pilot443/avad-s0/sim/physical-data-v26-k1.md

Стадия: **концепция (FEL-1), уровень У6 «Симулятор» — подготовка**. Физические данные для MuJoCo по модели деталей v2; не рабочая документация.

# Краб S-0 v2: физические данные тел для симулятора (30.10.2026)

Таблица строится инструментом `инструменты/универсал_сим_модель.py` (команда `всё`) из тех же деталей, по которым посчитаны масса, центр масс и У5. Метки: [Р] — расчёт по модели, [Д] — допущение, [И] — источник. Система координат — как в модели: X вперёд, Y влево, Z вверх, земля Z = 0, мм; оси тел параллельны мировым; инерция — относительно центра масс тела, в осях мира, кг·м².

## 1. Тела

Тело — это группа деталей, которые движутся вместе. Масса детали взята из модели вместе с крепежом (серво +5,6 г, листовые и печатные детали +5 %), поэтому сумма равна массе модели 6664 г [Р]. Центр масс и тензор инерции каждой детали — по настоящей форме (объём и момент инерции тела в CadQuery при постоянной плотности внутри детали), складываются по теореме Штейнера [Р]: это точнее, чем «брусок той же массы».

| Тело | Родитель | Сустав | Серво | Масса, г | Центр масс x; y; z, мм | Ixx | Iyy | Izz | Ixy | Ixz | Iyz |
|---|---|---|---:|---:|---|---:|---:|---:|---:|---:|---:|
| trunk | — | свободный (7) | 0 | 3774.1 | -3.2; -0.2; 132.6 | 4.035e-02 | 4.021e-02 | 3.028e-02 | -4.905e-05 | 3.270e-03 | 2.838e-06 |
| head_pan | trunk | head_pan | 1 | 90.1 | 146.0; -0.0; 200.8 | 2.119e-05 | 2.693e-05 | 2.363e-05 | -2.343e-08 | 1.786e-08 | 1.480e-08 |
| head_tilt | head_pan | head_tilt | 1 | 172.5 | 156.0; 3.2; 211.7 | 5.920e-04 | 1.913e-04 | 5.935e-04 | 1.217e-05 | 1.330e-05 | -4.383e-05 |
| leg1_yaw | trunk | leg1_yaw | 1 | 202.8 | 109.0; 62.9; 128.8 | 1.189e-04 | 7.754e-05 | 1.114e-04 | 3.580e-05 | 6.906e-07 | 3.987e-07 |
| leg1_hip | leg1_yaw | leg1_hip | 2 | 140.5 | 159.9; 82.3; 117.7 | 1.047e-04 | 1.062e-04 | 1.661e-04 | -3.659e-06 | 2.477e-05 | 1.942e-05 |
| leg1_knee | leg1_hip | leg1_knee | 1 | 42.3 | 173.6; 117.5; 49.9 | 5.155e-05 | 5.090e-05 | 6.035e-06 | 1.699e-06 | 7.259e-06 | -6.629e-06 |
| leg2_yaw | trunk | leg2_yaw | 1 | 202.8 | 0.0; 125.8; 128.8 | 5.687e-05 | 1.396e-04 | 1.114e-04 | 3.361e-18 | -1.910e-19 | 7.974e-07 |
| leg2_hip | leg2_yaw | leg2_hip | 2 | 170.2 | 0.0; 179.4; 118.3 | 1.321e-04 | 1.676e-04 | 2.445e-04 | -6.731e-08 | 1.733e-08 | 3.753e-05 |
| leg2_knee | leg2_hip | leg2_knee | 1 | 42.3 | -15.0; 209.1; 49.9 | 4.959e-05 | 5.286e-05 | 6.035e-06 | -5.661e-07 | 9.371e-06 | 2.972e-06 |
| leg3_yaw | trunk | leg3_yaw | 1 | 202.8 | -109.0; 62.9; 128.8 | 1.189e-04 | 7.754e-05 | 1.114e-04 | -3.580e-05 | -6.906e-07 | 3.987e-07 |
| leg3_hip | leg3_yaw | leg3_hip | 2 | 170.2 | -155.4; 89.7; 118.3 | 1.588e-04 | 1.409e-04 | 2.445e-04 | -1.531e-05 | -3.250e-05 | 1.878e-05 |
| leg3_knee | leg3_hip | leg3_knee | 1 | 42.3 | -188.6; 91.5; 49.9 | 5.253e-05 | 4.992e-05 | 6.035e-06 | -1.133e-06 | 2.112e-06 | 9.602e-06 |
| leg4_yaw | trunk | leg4_yaw | 1 | 202.8 | -109.0; -62.9; 128.8 | 1.189e-04 | 7.754e-05 | 1.114e-04 | 3.580e-05 | -6.906e-07 | -3.987e-07 |
| leg4_hip | leg4_yaw | leg4_hip | 2 | 170.2 | -155.4; -89.7; 118.3 | 1.587e-04 | 1.411e-04 | 2.445e-04 | 1.538e-05 | -3.251e-05 | -1.875e-05 |
| leg4_knee | leg4_hip | leg4_knee | 1 | 42.3 | -173.6; -117.5; 49.9 | 5.155e-05 | 5.090e-05 | 6.035e-06 | 1.699e-06 | -7.259e-06 | 6.629e-06 |
| leg5_yaw | trunk | leg5_yaw | 1 | 202.8 | 0.0; -125.8; 128.8 | 5.687e-05 | 1.396e-04 | 1.114e-04 | -3.943e-18 | -2.756e-19 | -7.974e-07 |
| leg5_hip | leg5_yaw | leg5_hip | 2 | 170.2 | -0.0; -179.4; 118.3 | 1.321e-04 | 1.676e-04 | 2.445e-04 | -6.731e-08 | -1.733e-08 | -3.753e-05 |
| leg5_knee | leg5_hip | leg5_knee | 1 | 42.3 | 15.0; -209.1; 49.9 | 4.959e-05 | 5.286e-05 | 6.035e-06 | -5.661e-07 | -9.371e-06 | -2.972e-06 |
| leg6_yaw | trunk | leg6_yaw | 1 | 202.8 | 109.0; -62.9; 128.8 | 1.189e-04 | 7.754e-05 | 1.114e-04 | -3.580e-05 | 6.906e-07 | -3.987e-07 |
| leg6_hip | leg6_yaw | leg6_hip | 2 | 140.5 | 159.8; -82.3; 117.7 | 1.049e-04 | 1.062e-04 | 1.662e-04 | 3.685e-06 | 2.475e-05 | -1.945e-05 |
| leg6_knee | leg6_hip | leg6_knee | 1 | 42.3 | 188.6; -91.5; 49.9 | 5.253e-05 | 4.992e-05 | 6.035e-06 | -1.133e-06 | -2.112e-06 | -9.602e-06 |
| armL1 | trunk | armL_sh_yaw | 1 | 66.2 | 120.9; 119.8; 178.5 | 1.104e-05 | 1.873e-05 | 2.095e-05 | 1.002e-07 | -2.087e-06 | 6.629e-08 |
| armL2 | armL1 | armL_sh_pitch | 1 | 88.8 | 185.5; 128.6; 171.2 | 2.890e-05 | 8.737e-05 | 8.691e-05 | 1.784e-05 | 1.239e-05 | -4.119e-06 |
| armL3 | armL2 | armL_elbow | 1 | 89.0 | 284.6; 113.8; 189.2 | 2.663e-05 | 9.856e-05 | 9.572e-05 | -1.590e-05 | -1.315e-05 | -3.281e-06 |
| armL4 | armL3 | armL_wr_tilt | 1 | 74.9 | 339.9; 129.8; 169.0 | 1.807e-05 | 2.964e-05 | 2.193e-05 | 2.584e-06 | 3.051e-06 | -9.094e-07 |
| armL5 | armL4 | armL_wr_roll | 1 | 105.7 | 389.6; 126.8; 170.3 | 3.075e-05 | 5.011e-05 | 4.298e-05 | 6.339e-09 | 8.465e-06 | 5.903e-08 |
| gripL | armL5 | armL_grip | 1 | 27.2 | 409.0; 126.4; 182.0 | 9.430e-06 | 8.115e-06 | 1.585e-05 | -2.017e-08 | -2.120e-07 | 1.650e-08 |
| armR1 | trunk | armR_sh_yaw | 1 | 66.2 | 120.9; -119.8; 178.5 | 1.104e-05 | 1.873e-05 | 2.095e-05 | -1.002e-07 | -2.087e-06 | -6.629e-08 |
| armR2 | armR1 | armR_sh_pitch | 1 | 88.8 | 185.5; -128.6; 171.2 | 2.890e-05 | 8.737e-05 | 8.691e-05 | -1.784e-05 | 1.239e-05 | 4.119e-06 |
| armR3 | armR2 | armR_elbow | 1 | 89.0 | 284.6; -113.8; 189.2 | 2.663e-05 | 9.856e-05 | 9.572e-05 | 1.590e-05 | -1.315e-05 | 3.281e-06 |
| armR4 | armR3 | armR_wr_tilt | 1 | 74.9 | 339.9; -129.8; 169.0 | 1.807e-05 | 2.964e-05 | 2.193e-05 | -2.584e-06 | 3.051e-06 | 9.094e-07 |
| armR5 | armR4 | armR_wr_roll | 1 | 105.7 | 389.6; -126.8; 170.3 | 3.075e-05 | 5.011e-05 | 4.298e-05 | -6.339e-09 | 8.465e-06 | -5.903e-08 |
| gripR | armR5 | armR_grip | 1 | 27.2 | 409.0; -126.4; 182.0 | 9.430e-06 | 8.115e-06 | 1.585e-05 | 2.017e-08 | -2.120e-07 | -1.650e-08 |

Сумма масс тел: **7373.1 г** (модель У4-v2.6: 7264 г).

## 2. Суставы

Пределы ног — из `пределы_ноги_по_модели` v2 (подъём бедра вверх: передние ноги 40°, боковые 80°, задние 68°; колено вниз 48–49°, вверх 150°; поворот бедра ±17°), знак — правило правого винта относительно оси сустава [Р]. Пределы рук **программные**, шире записанных в У3 (`узлы-S-0.md`), чтобы вошли все позы У4–У5 (стойка рук: плечо вверх на 90°): реальные пределы по столкновениям звеньев в симуляторе не проверяются, самопересечения проверены в CadQuery для поз У4 и У5 [Д].

| Сустав | Тело | Точка оси x; y; z, мм | Ось | Предел, ° | Серво на оси |
|---|---|---|---|---|---:|
| head_pan | head_pan | 146.0; 0.0; 160.0 | (0.000; 0.000; 1.000) | -21 … 21 | 1 |
| head_tilt | head_tilt | 146.0; 0.0; 208.0 | (0.000; 1.000; 0.000) | -21 … 21 | 1 |
| leg1_yaw | leg1_yaw | 110.4; 63.7; 0.0 | (0.000; 0.000; 1.000) | -17 … 17 | 1 |
| leg1_hip | leg1_hip | 110.4; 63.7; 144.0 | (-0.500; 0.866; 0.000) | -45 … 31 | 2 |
| leg1_knee | leg1_knee | 177.5; 102.5; 112.0 | (-0.500; 0.866; 0.000) | -150 … 44 | 1 |
| leg2_yaw | leg2_yaw | 0.0; 127.5; 0.0 | (0.000; 0.000; 1.000) | -17 … 17 | 1 |
| leg2_hip | leg2_hip | 0.0; 127.5; 144.0 | (-1.000; 0.000; 0.000) | -88 … 31 | 2 |
| leg2_knee | leg2_knee | 0.0; 205.0; 112.0 | (-1.000; 0.000; 0.000) | -150 … 44 | 1 |
| leg3_yaw | leg3_yaw | -110.4; 63.7; 0.0 | (0.000; 0.000; 1.000) | -17 … 17 | 1 |
| leg3_hip | leg3_hip | -110.4; 63.7; 144.0 | (-0.500; -0.866; 0.000) | -71 … 31 | 2 |
| leg3_knee | leg3_knee | -177.5; 102.5; 112.0 | (-0.500; -0.866; 0.000) | -150 … 44 | 1 |
| leg4_yaw | leg4_yaw | -110.4; -63.8; 0.0 | (0.000; 0.000; 1.000) | -17 … 17 | 1 |
| leg4_hip | leg4_hip | -110.4; -63.8; 144.0 | (0.500; -0.866; 0.000) | -71 … 31 | 2 |
| leg4_knee | leg4_knee | -177.5; -102.5; 112.0 | (0.500; -0.866; 0.000) | -150 … 44 | 1 |
| leg5_yaw | leg5_yaw | -0.0; -127.5; 0.0 | (0.000; 0.000; 1.000) | -17 … 17 | 1 |
| leg5_hip | leg5_hip | -0.0; -127.5; 144.0 | (1.000; -0.000; 0.000) | -88 … 31 | 2 |
| leg5_knee | leg5_knee | -0.0; -205.0; 112.0 | (1.000; -0.000; 0.000) | -150 … 44 | 1 |
| leg6_yaw | leg6_yaw | 110.4; -63.8; 0.0 | (0.000; 0.000; 1.000) | -17 … 17 | 1 |
| leg6_hip | leg6_hip | 110.4; -63.8; 144.0 | (0.500; 0.866; 0.000) | -45 … 31 | 2 |
| leg6_knee | leg6_knee | 177.5; -102.5; 112.0 | (0.500; 0.866; 0.000) | -150 … 44 | 1 |
| armL_sh_yaw | armL1 | 111.0; 119.7; 0.0 | (0.000; 0.000; 1.000) | -30 … 130 | 1 |
| armL_sh_pitch | armL2 | 111.0; 119.7; 180.2 | (0.000; 1.000; 0.000) | -160 … 30 | 1 |
| armL_elbow | armL3 | 201.0; 119.7; 180.2 | (0.000; 1.000; 0.000) | -140 … 140 | 1 |
| armL_wr_tilt | armL4 | 301.0; 119.7; 180.2 | (0.000; 1.000; 0.000) | -100 … 100 | 1 |
| armL_wr_roll | armL5 | 301.0; 126.8; 180.2 | (1.000; 0.000; 0.000) | -150 … 150 | 1 |
| armL_grip | gripL | 394.5; 145.3; 180.2 | (0.000; -1.000; 0.000) | 0 … 45 | 1 |
| armR_sh_yaw | armR1 | 111.0; -119.7; 0.0 | (0.000; 0.000; -1.000) | -30 … 130 | 1 |
| armR_sh_pitch | armR2 | 111.0; -119.7; 180.2 | (0.000; 1.000; 0.000) | -160 … 30 | 1 |
| armR_elbow | armR3 | 201.0; -119.7; 180.2 | (0.000; 1.000; 0.000) | -140 … 140 | 1 |
| armR_wr_tilt | armR4 | 301.0; -119.7; 180.2 | (0.000; 1.000; 0.000) | -100 … 100 | 1 |
| armR_wr_roll | armR5 | 301.0; -126.8; 180.2 | (-1.000; 0.000; 0.000) | -150 … 150 | 1 |
| armR_grip | gripR | 394.5; -145.3; 180.2 | (0.000; -1.000; 0.000) | 0 … 45 | 1 |

Шарнирных суставов **32** (6 ног × 3, 2 руки × 5, 2 пальца захвата, 2 сустава головы) плюс свободный сустав корпуса; серво — **38** (38 по модели: двойное бедро — по два на ось).

**Двойное бедро.** Два серво стоят спина к спине на одной оси и держат одну щёку-раму: в симуляторе — **один сустав с двойным моментом** (предел 5,88 Н·м, номинал 1,96 Н·м) [Д]. Причина: два серво на одной оси жёстко связаны через раму, и в MuJoCo пришлось бы вводить связь «равенство углов», а она делает расчёт жёстче и хуже сходится; а делить нагрузку между двумя серво можно при разборе результатов (параметр «доля нагруженного серво», по умолчанию 0,5; для худшего случая 0,6). Что теряем: рассогласование двух серво (одно «ленивое», второе берёт больше) — оно оценивается отдельным опытом после замеров образца.

## 3. Контакт, пол, шаг времени, привод

| Параметр | Значение | Метка и основание |
|---|---|---|
| Контакт | только подошва — пол (шар радиусом 9 мм, низ в точке опоры) | [Р] из модели v2.1: стопа PETG + полусфера TPU R9 (v2 — плоская накладка 18 × 18 × 3 мм); остальные звенья не сталкиваются (проверено в CadQuery для поз У4–У5) |
| Трение подошвы о пол | 0.5 (опыт E3: 0,3–1,0) | [Д] резина или TPU по сухому полу 0,5–1,0 |
| Пол | плоскость, неровность и порог — вариантами опытов | [Д] |
| Шаг времени | 1 мс (частота управления 100 Гц, задержка команды 10 мс) | [Д] |
| Привод | позиционный регулятор PD на стороне Python; момент ограничен 2,94 Н·м (бедро: 5,88), на скорости — по линейной кривой «момент — скорость» от 2,94 Н·м при 0 до 0 при 4,72 рад/с; 0,98 Н·м — порог перегрева | [И] STS3215 (данные продавцов); кривая — [Д] |
| Разрешение датчика угла | 4096 шагов на оборот (0,088°) | [И] |
| Трение и вязкость в суставе | 0.03 Н·м и 0.02 Н·м·с/рад | [Д] до измерений на образце |
| Инерция ротора, приведённая к валу | 0.005 кг·м² | [Д] до измерений на образце |
| Падение напряжения батареи | не моделируется | [Д] |
