pilot443/avad-s0/electrical/EL-01_electronics-layout.png

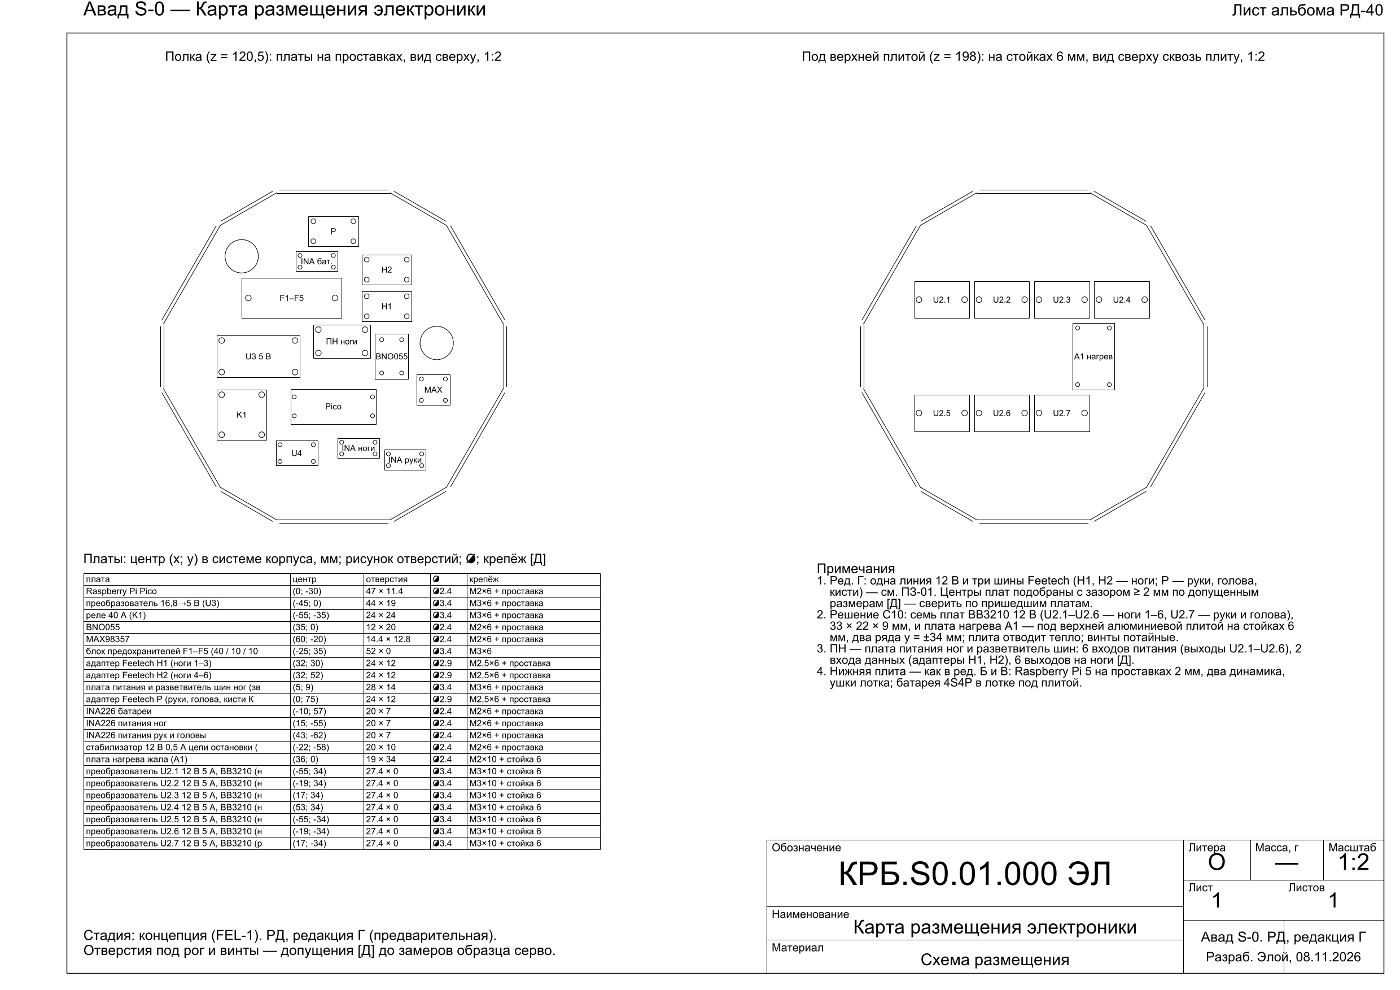
electrical/EL-01_electronics-layout.png
