pilot443/avad-s0/electrical/PZ-01_schematic.png

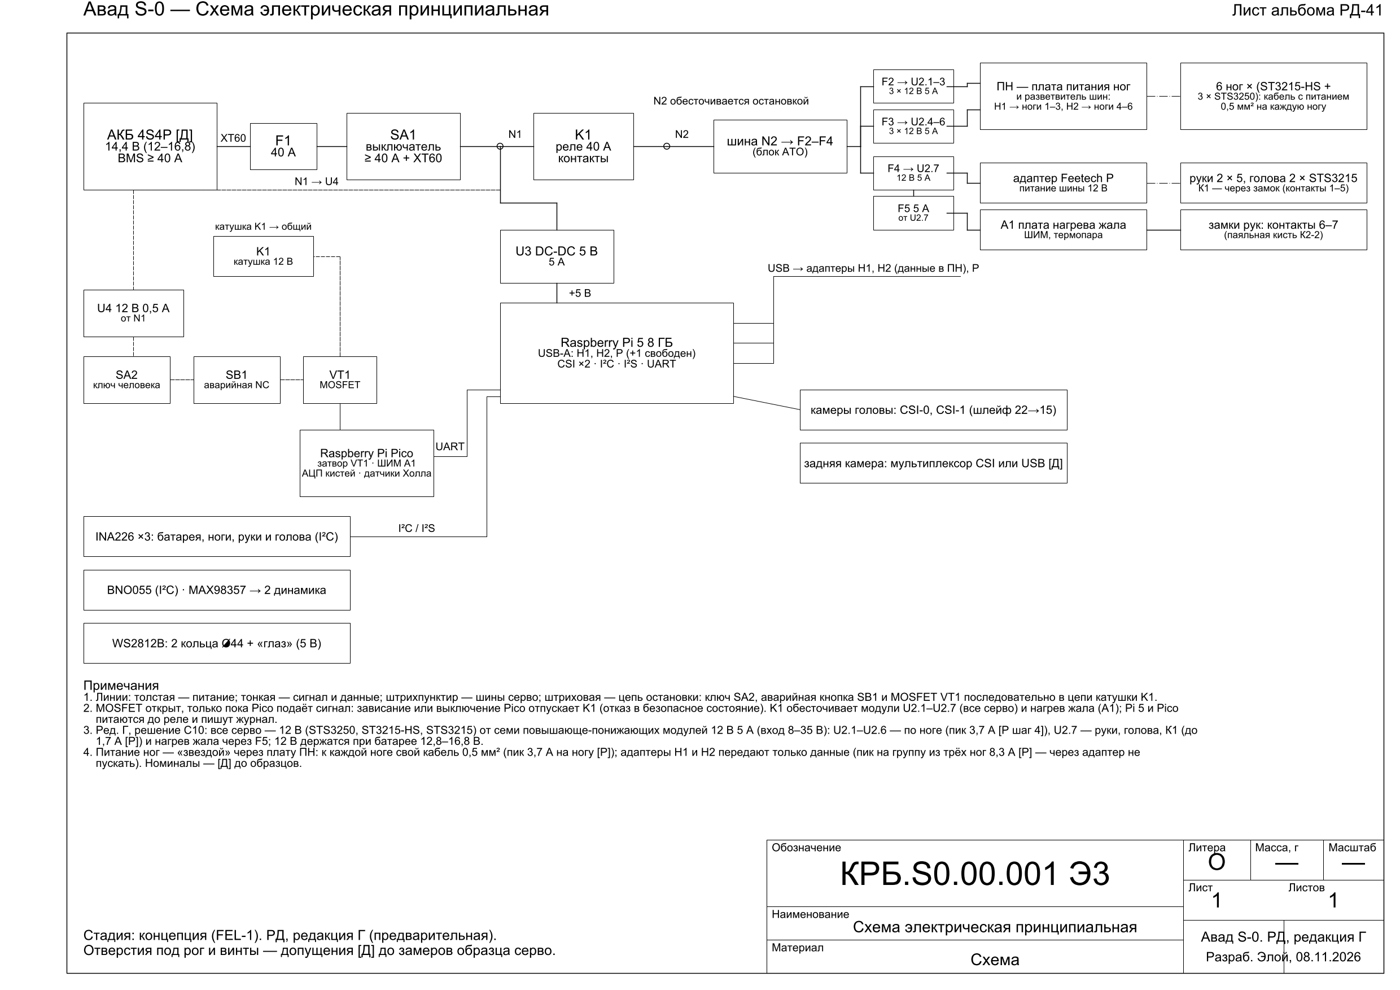
electrical/PZ-01_schematic.png
