pilot443/avad-s0/electrical/TB-01_servo-ids-and-buses.png

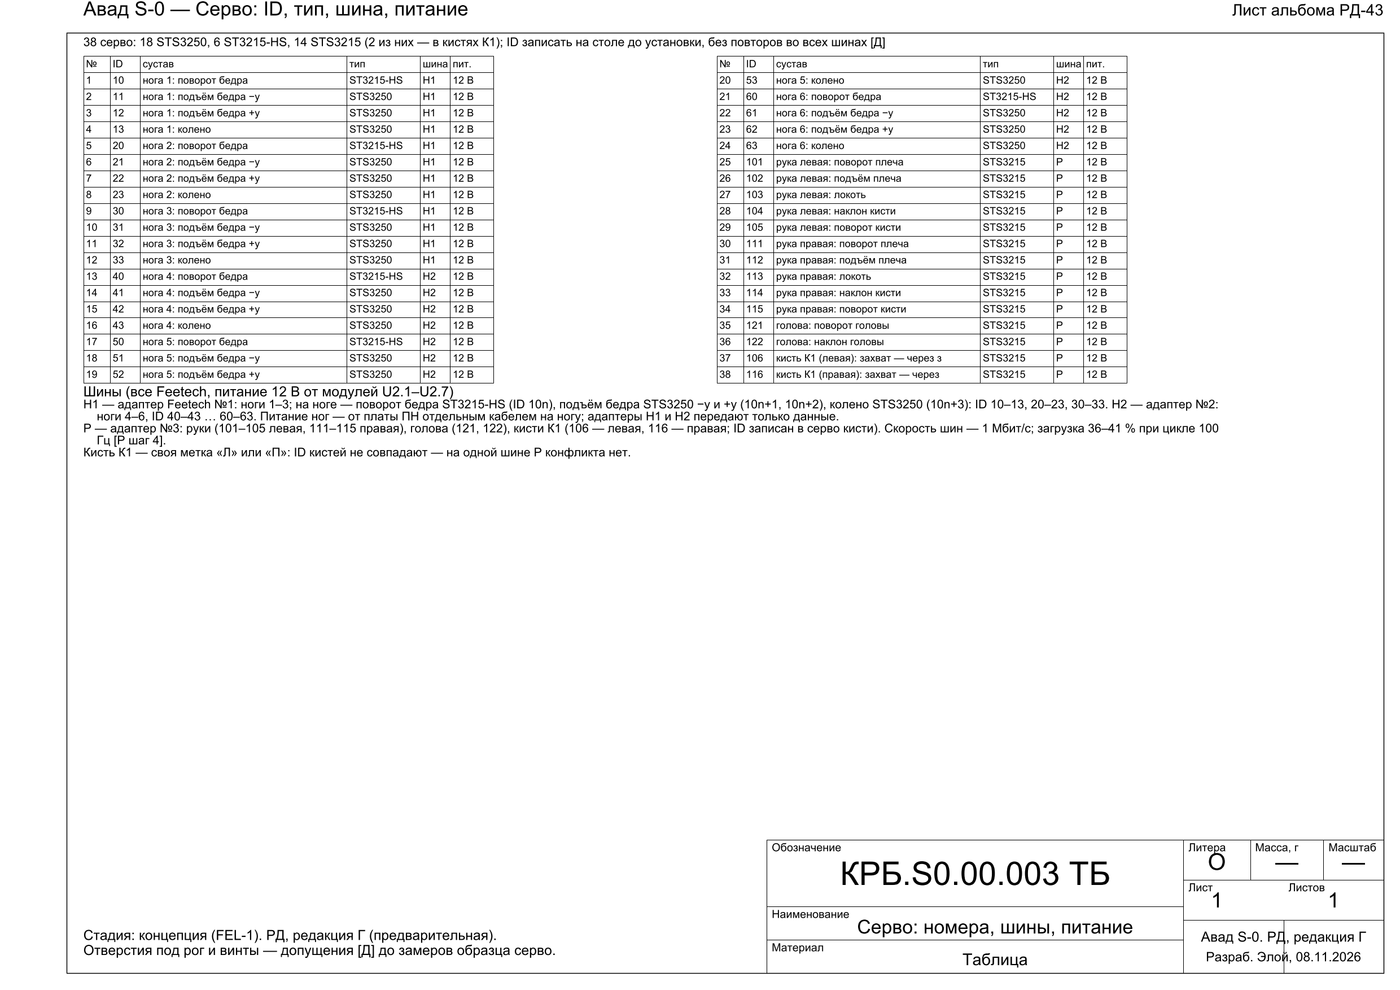
electrical/TB-01_servo-ids-and-buses.png
