pilot443/avad-s0/electrical/TB-02_harnesses.png

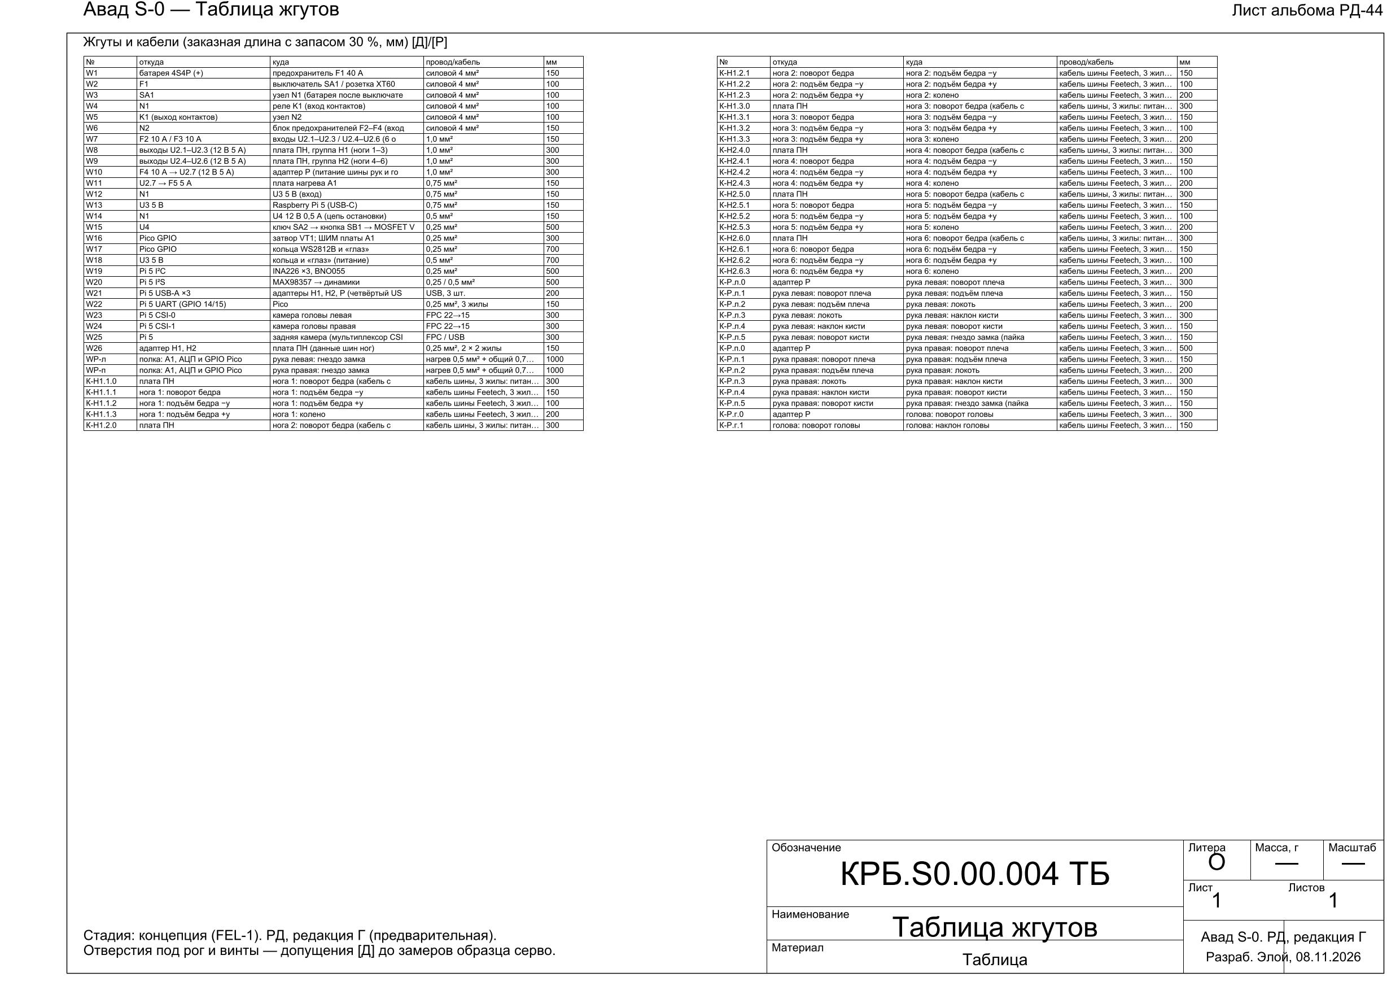
electrical/TB-02_harnesses.png
