pilot443/avad-s0/electrical/TB-03_wrist-lock-contacts.png

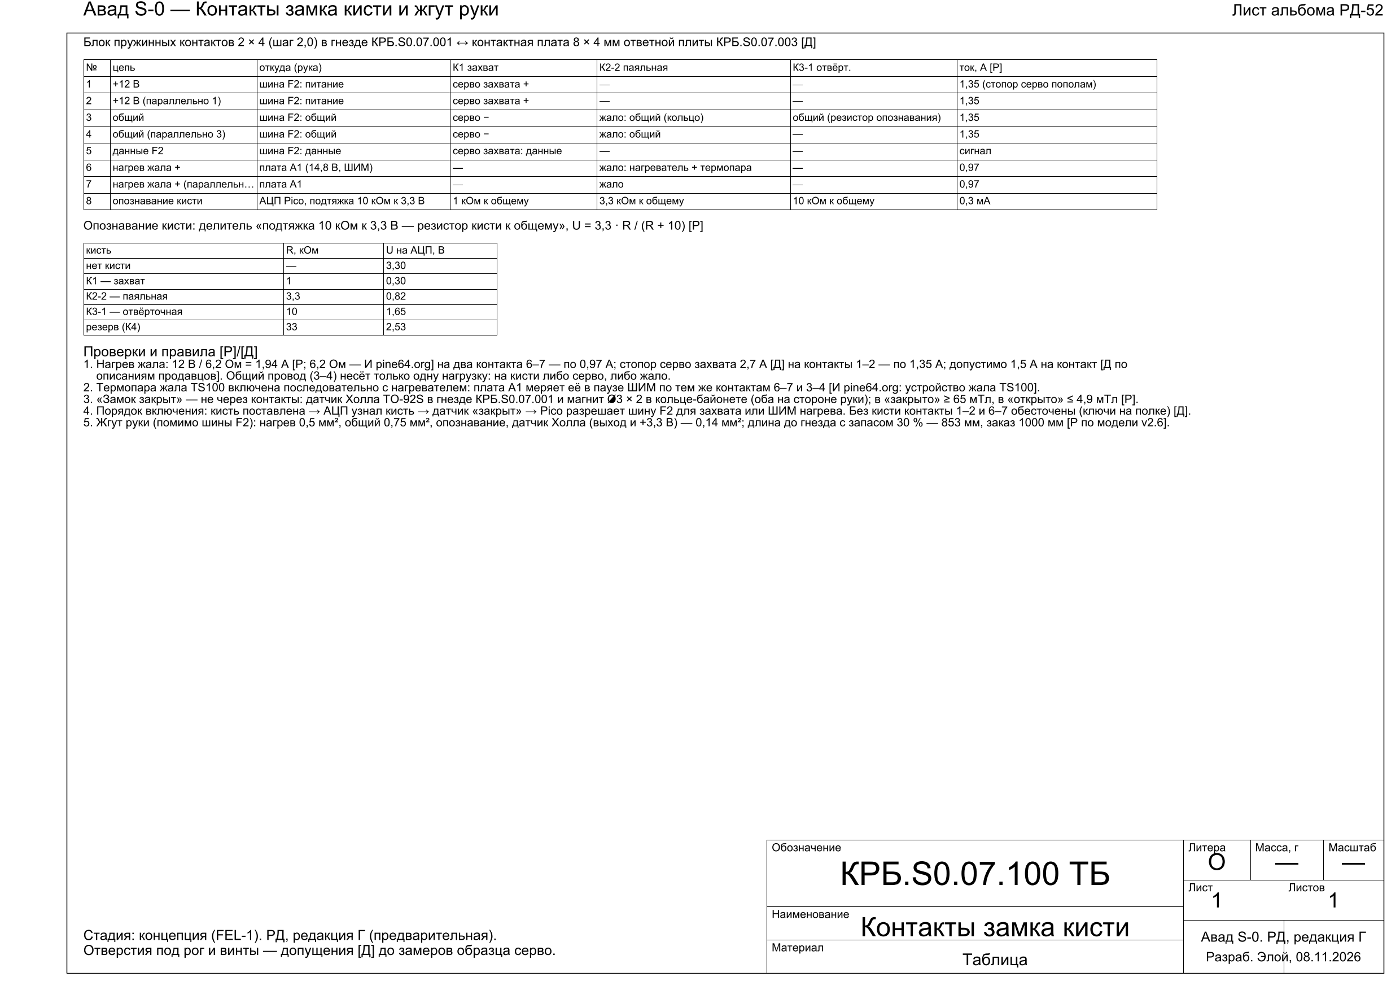
electrical/TB-03_wrist-lock-contacts.png
