pilot443/avad-s0/media/general-arrangement-drawing.png

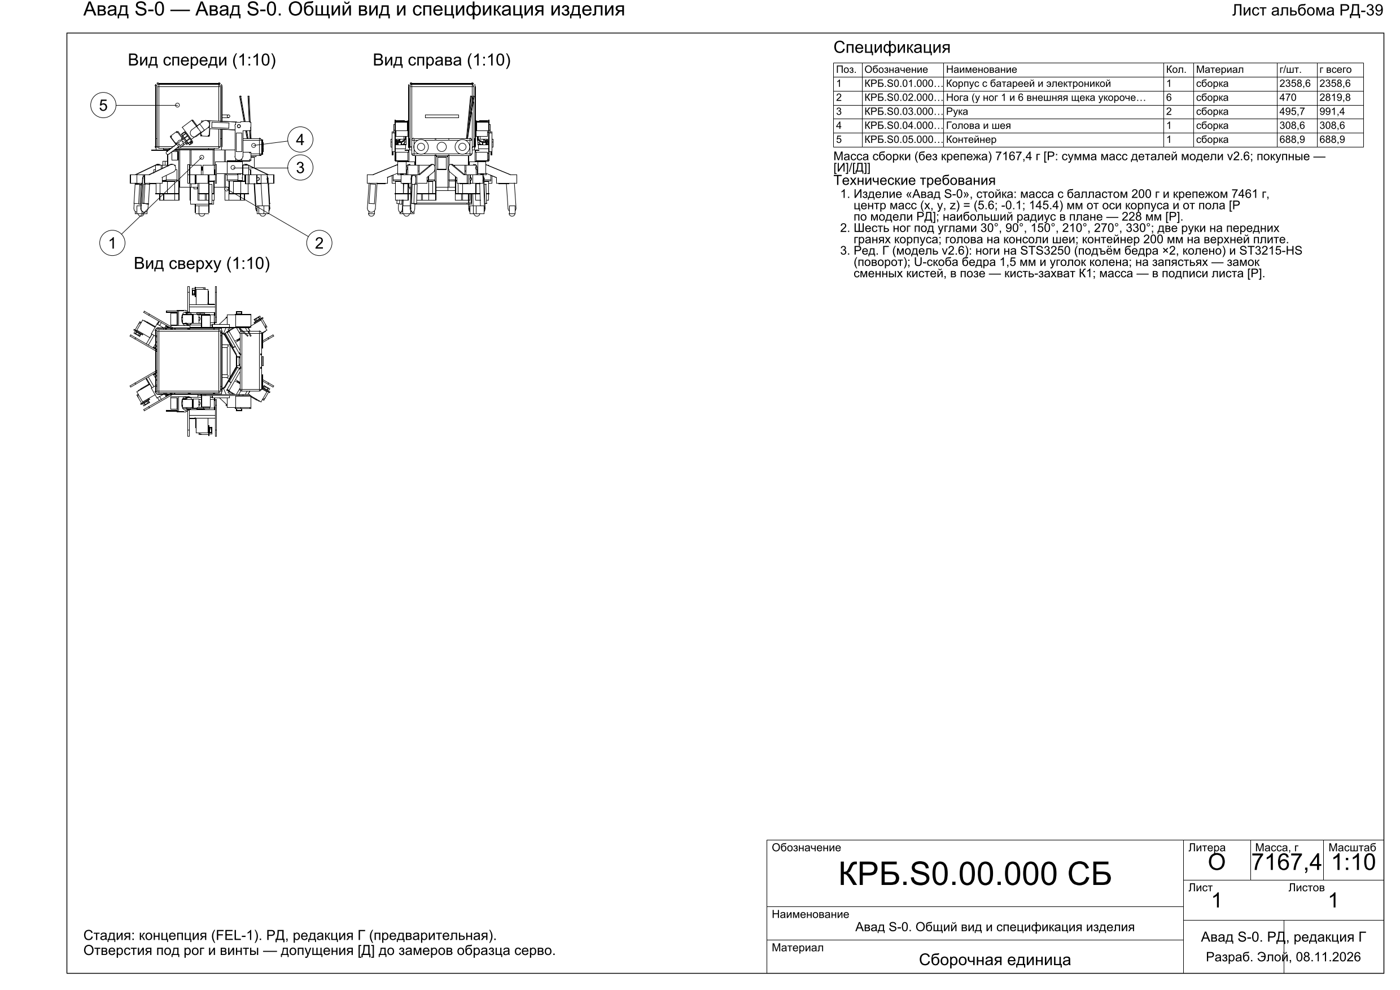
media/general-arrangement-drawing.png
