pilot443/avad-s0/media/sim-arms-lift-container.gif

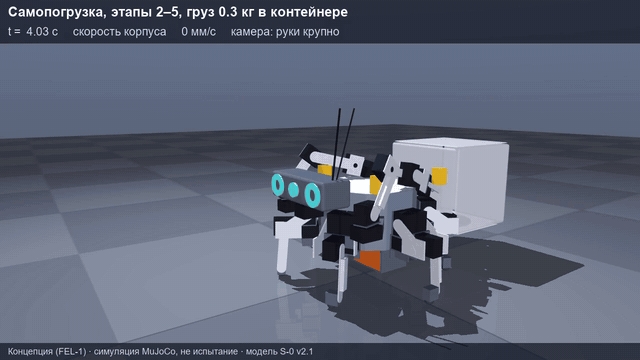
media/sim-arms-lift-container.gif
