pilot443/avad-s0/media/sim-arms.png

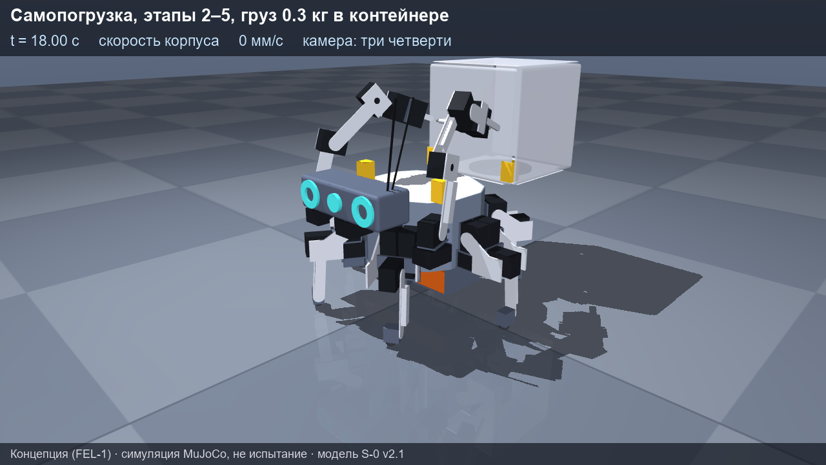
media/sim-arms.png
