pilot443/avad-s0/media/sim-emergency-stop.gif

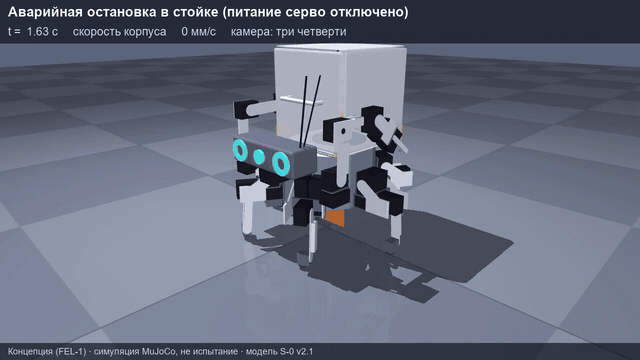
media/sim-emergency-stop.gif
