pilot443/avad-s0/media/sim-emergency-stop.png

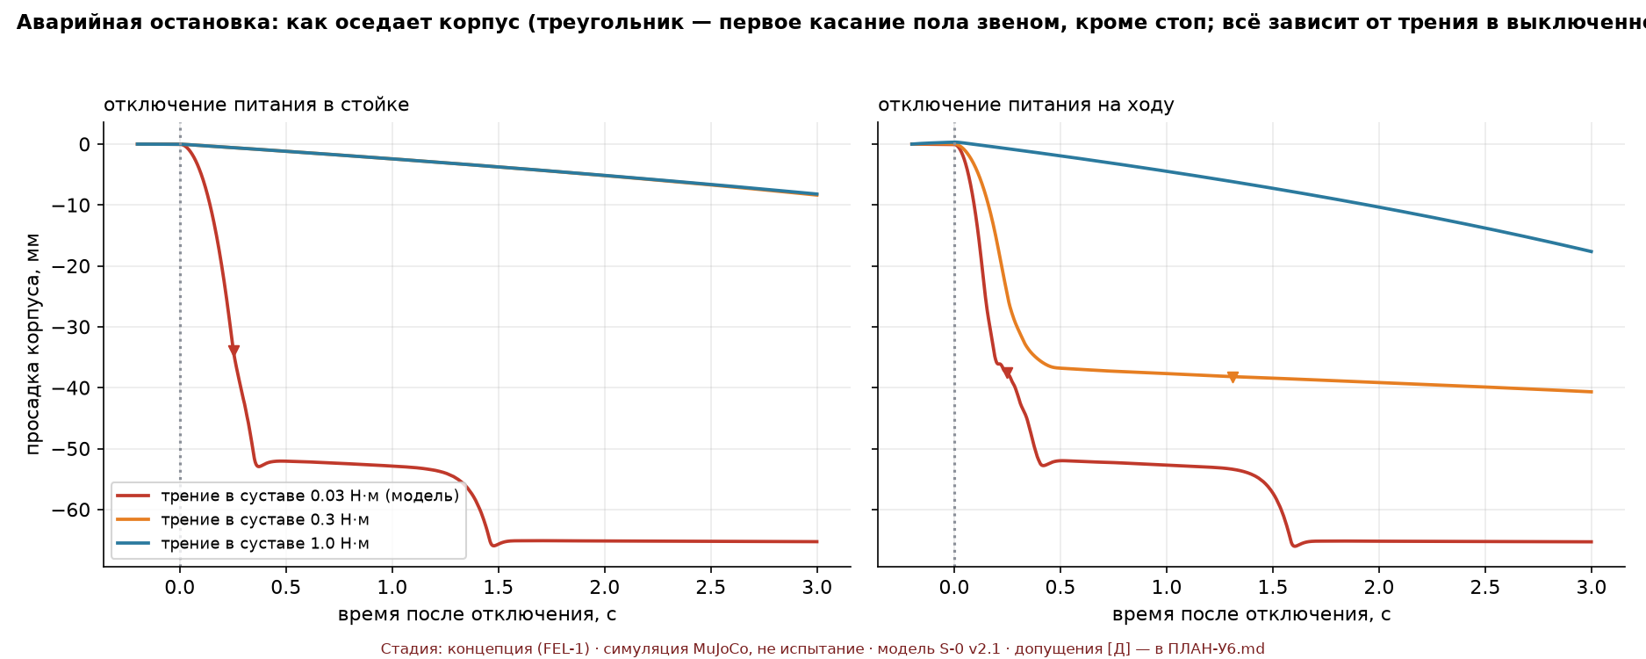
media/sim-emergency-stop.png
