pilot443/avad-s0/wrist-tools/KRB.S0.07.001_gnezdo-zamka.png

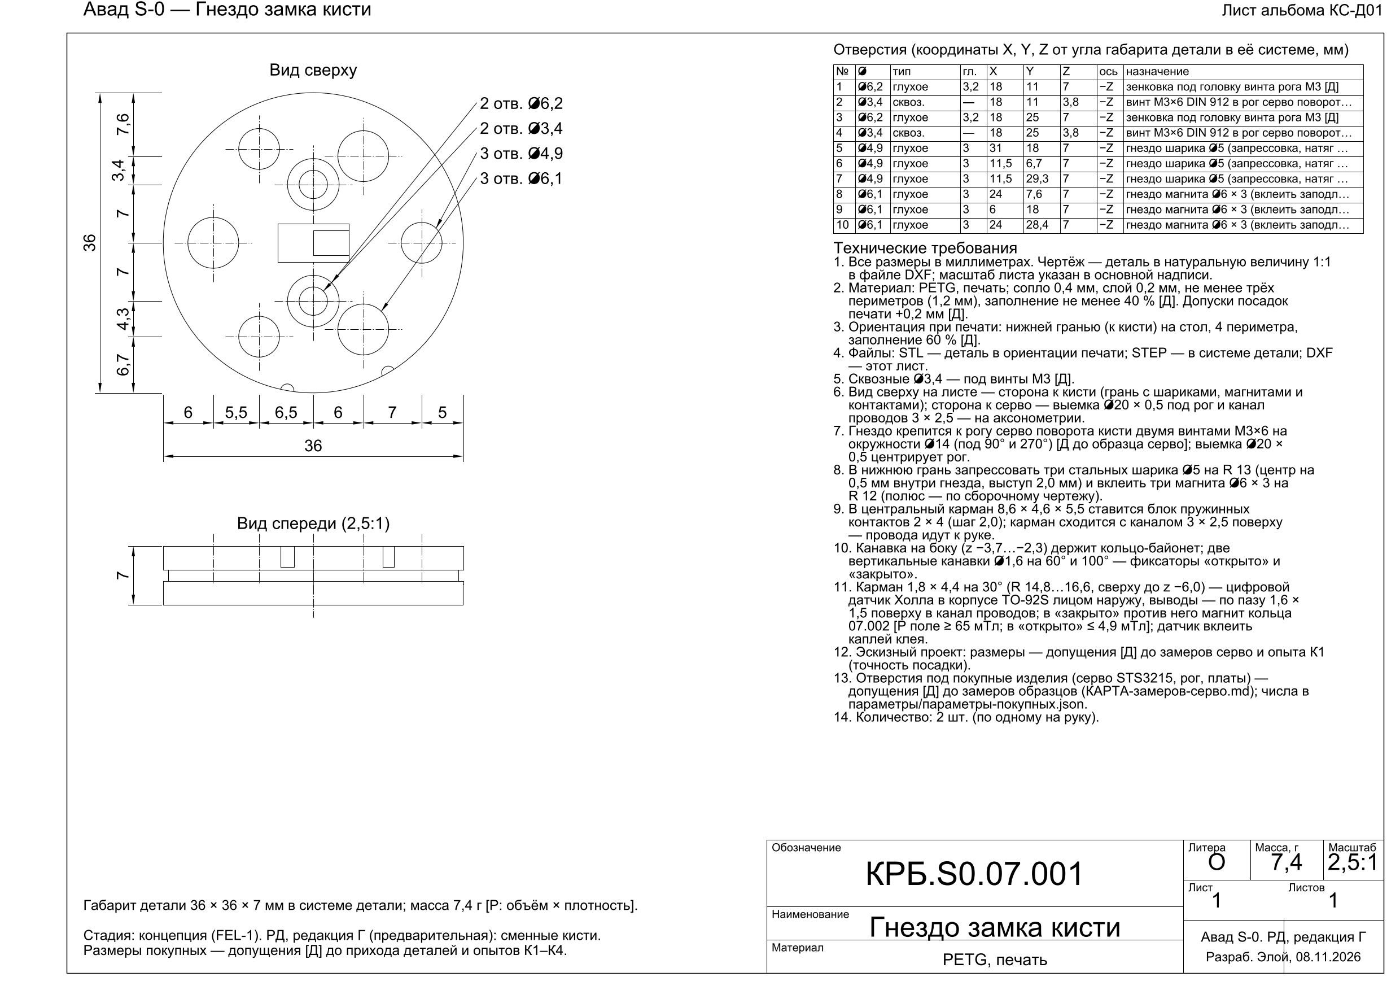
wrist-tools/KRB.S0.07.001_gnezdo-zamka.png
