pilot443/avad-s0/wrist-tools/KRB.S0.07.002_koltso-baioneta.png

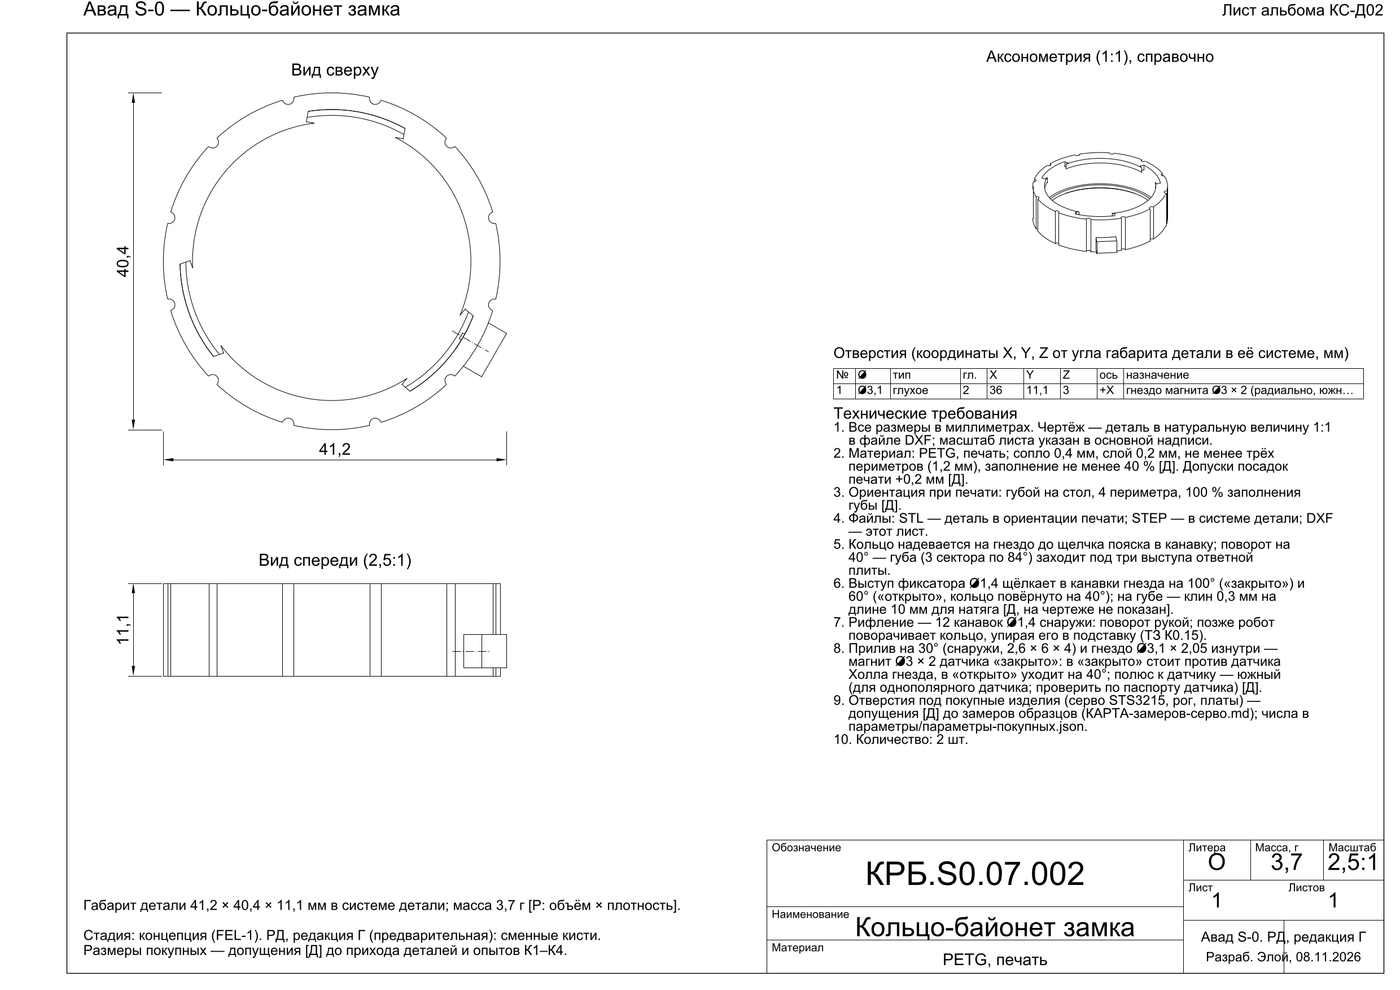
wrist-tools/KRB.S0.07.002_koltso-baioneta.png
