pilot443/avad-s0/wrist-tools/KRB.S0.07.003_otvetnaya-plita.png

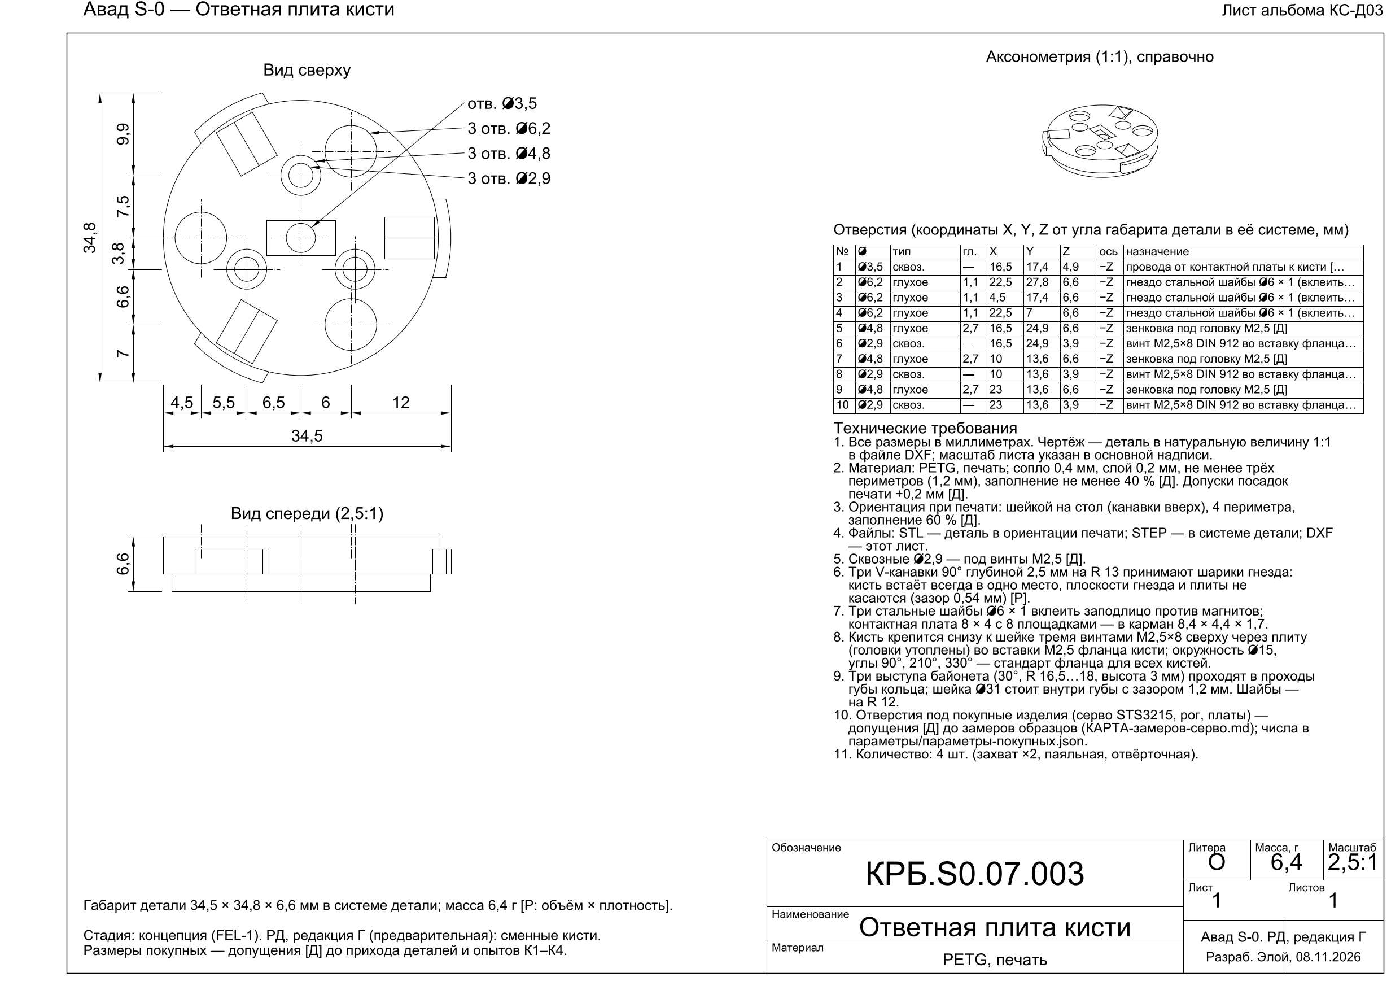
wrist-tools/KRB.S0.07.003_otvetnaya-plita.png
