pilot443/avad-s0/wrist-tools/KRB.S0.07.011_osnovanie-zahvata.png

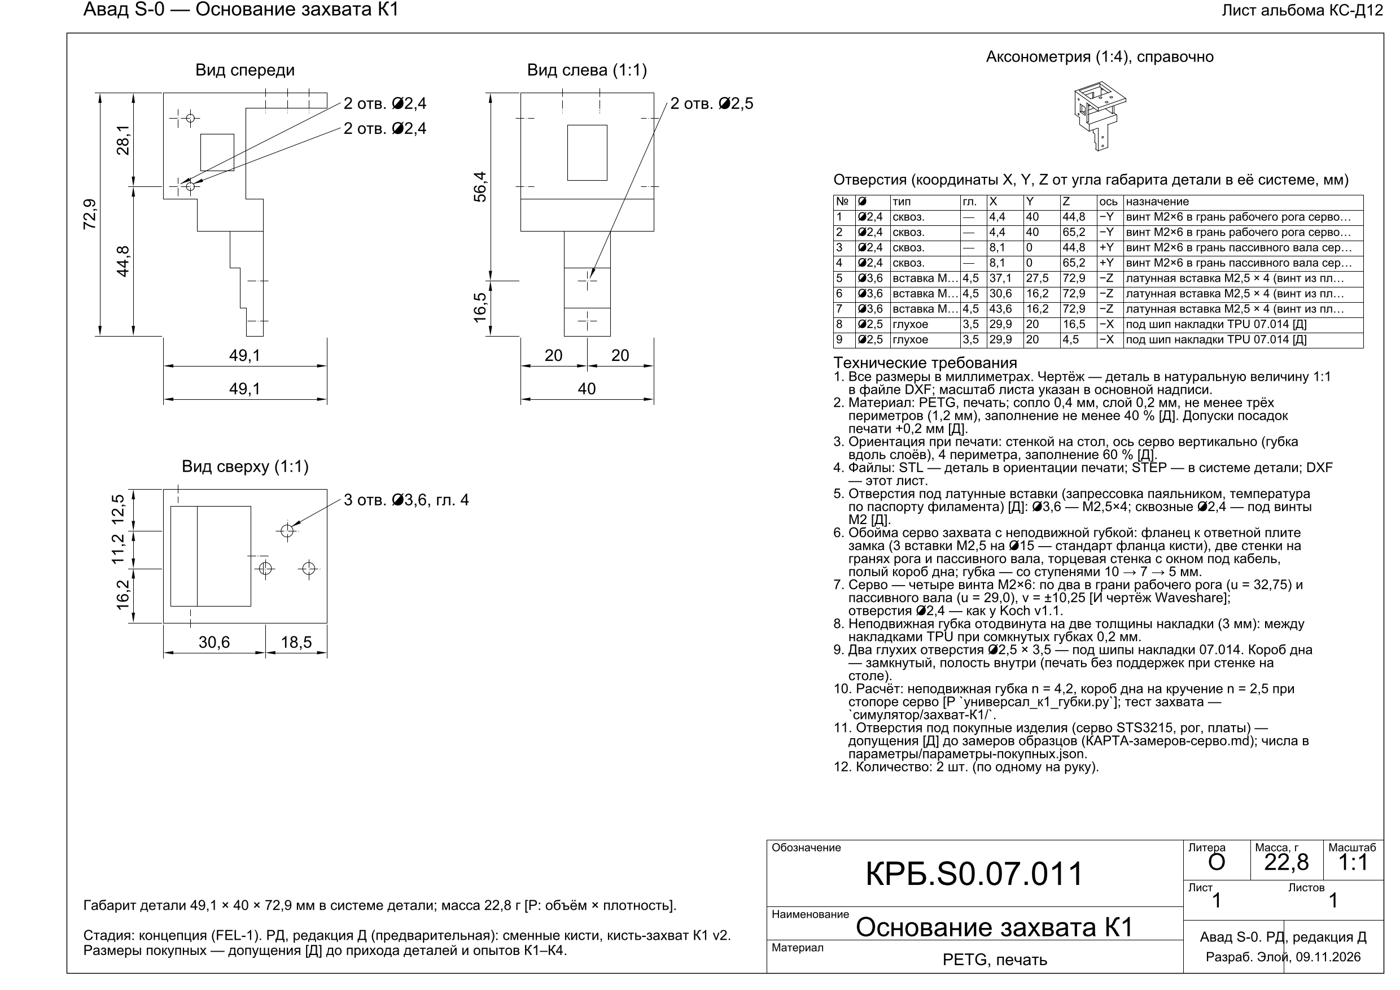
wrist-tools/KRB.S0.07.011_osnovanie-zahvata.png
