pilot443/avad-s0/wrist-tools/KRB.S0.07.012_gubka-podvizhnaya.png

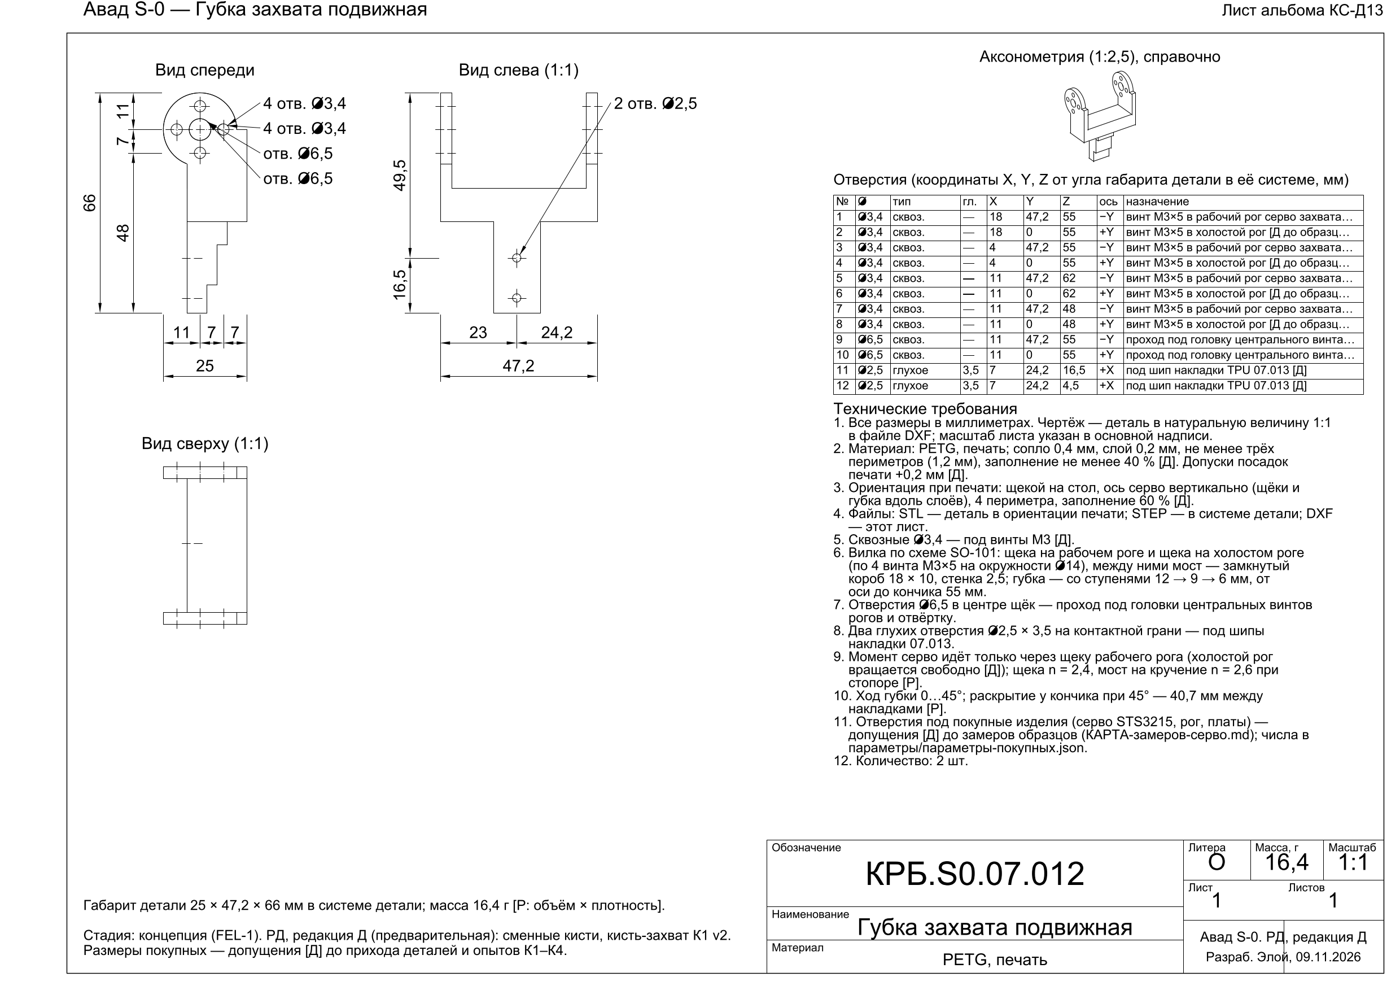
wrist-tools/KRB.S0.07.012_gubka-podvizhnaya.png
