pilot443/avad-s0/wrist-tools/KRB.S0.07.013_nakladka-podvizhnoi.png

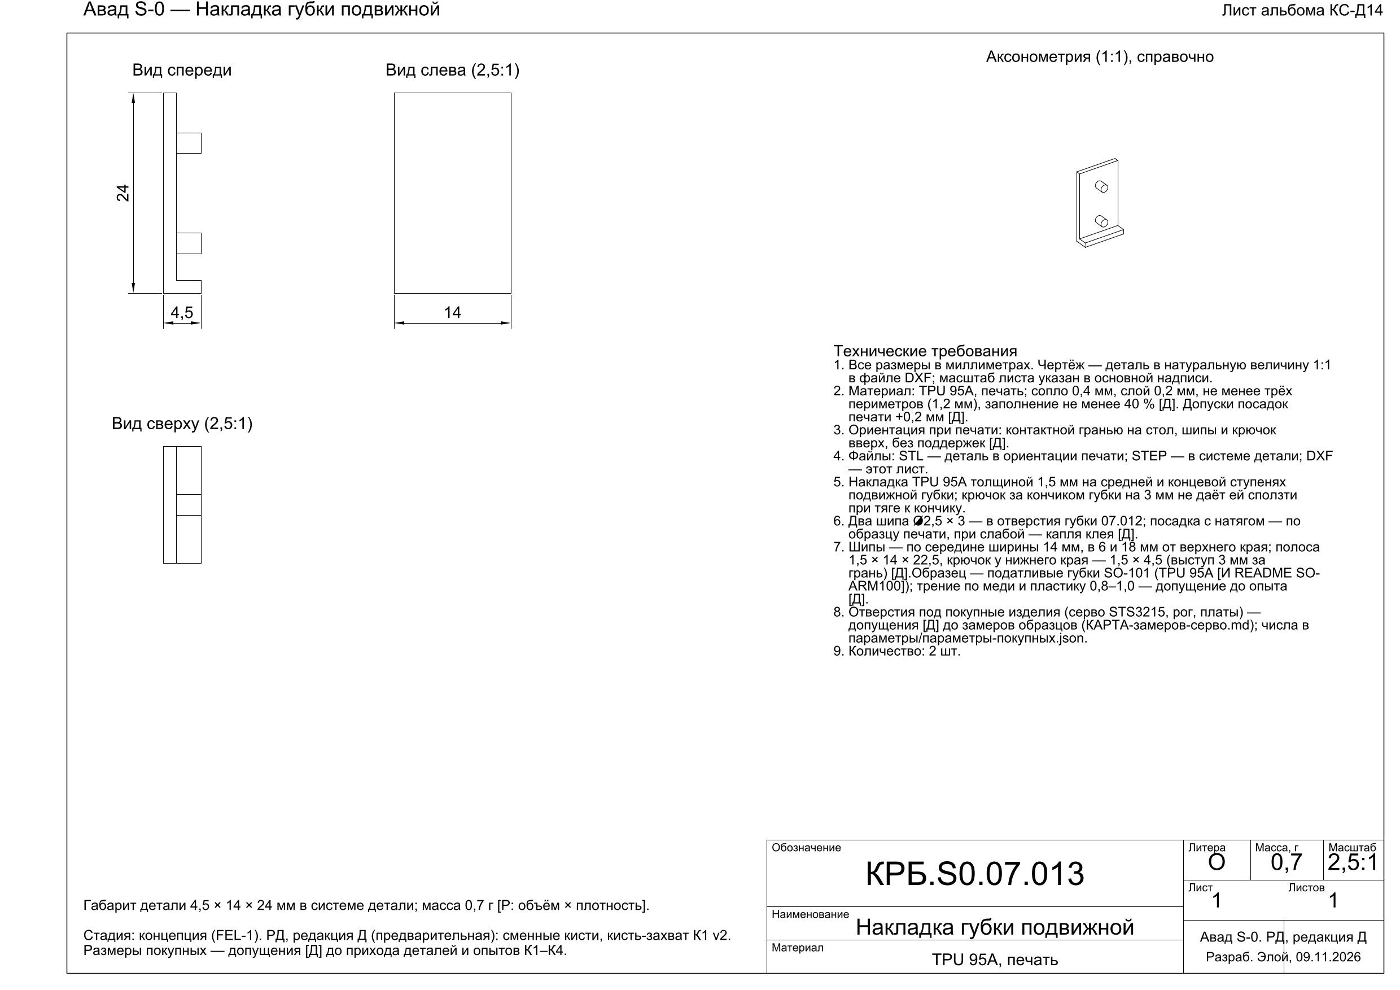
wrist-tools/KRB.S0.07.013_nakladka-podvizhnoi.png
