pilot443/avad-s0/wrist-tools/KRB.S0.07.014_nakladka-nepodvizhnoi.png

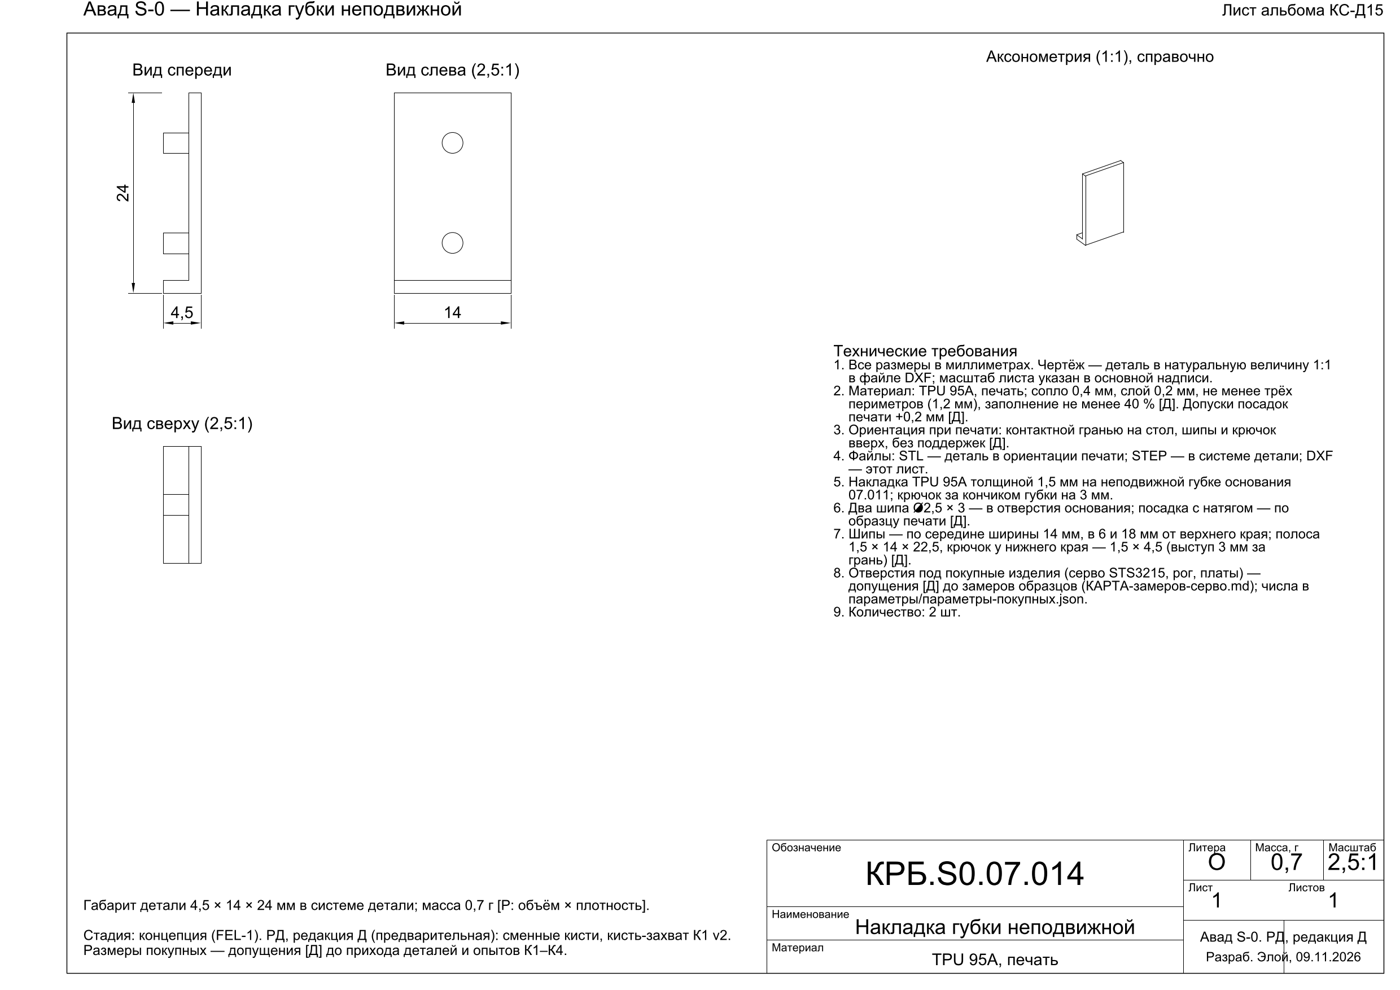
wrist-tools/KRB.S0.07.014_nakladka-nepodvizhnoi.png
