pilot443/avad-s0/wrist-tools/KRB.S0.07.020_derzhatel-zhala.png

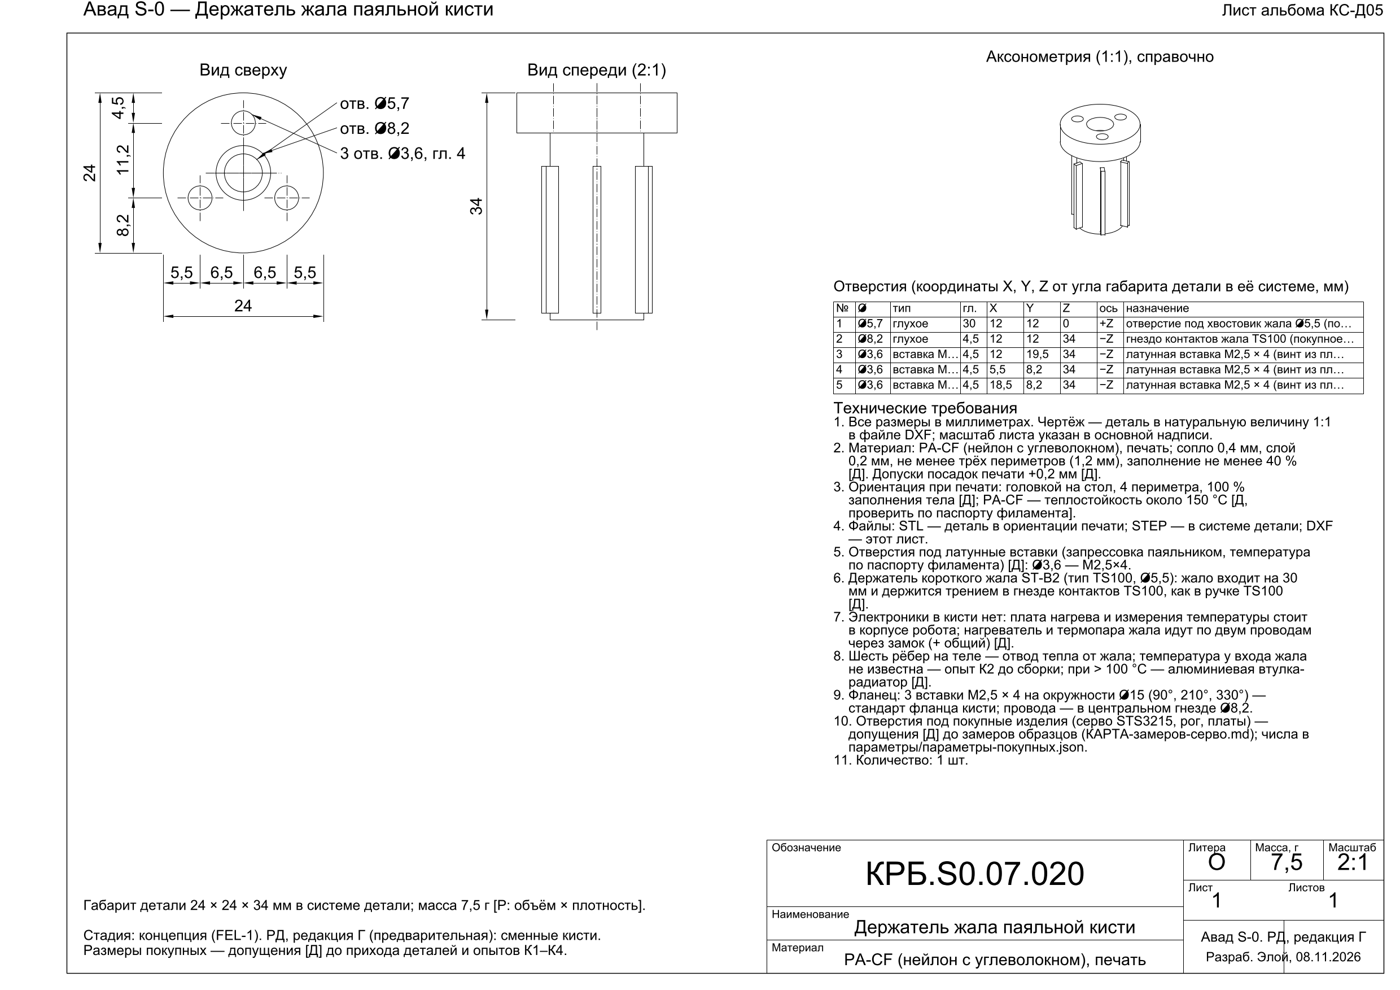
wrist-tools/KRB.S0.07.020_derzhatel-zhala.png
