pilot443/avad-s0/wrist-tools/KRB.S0.07.031_val-treshchotki.png

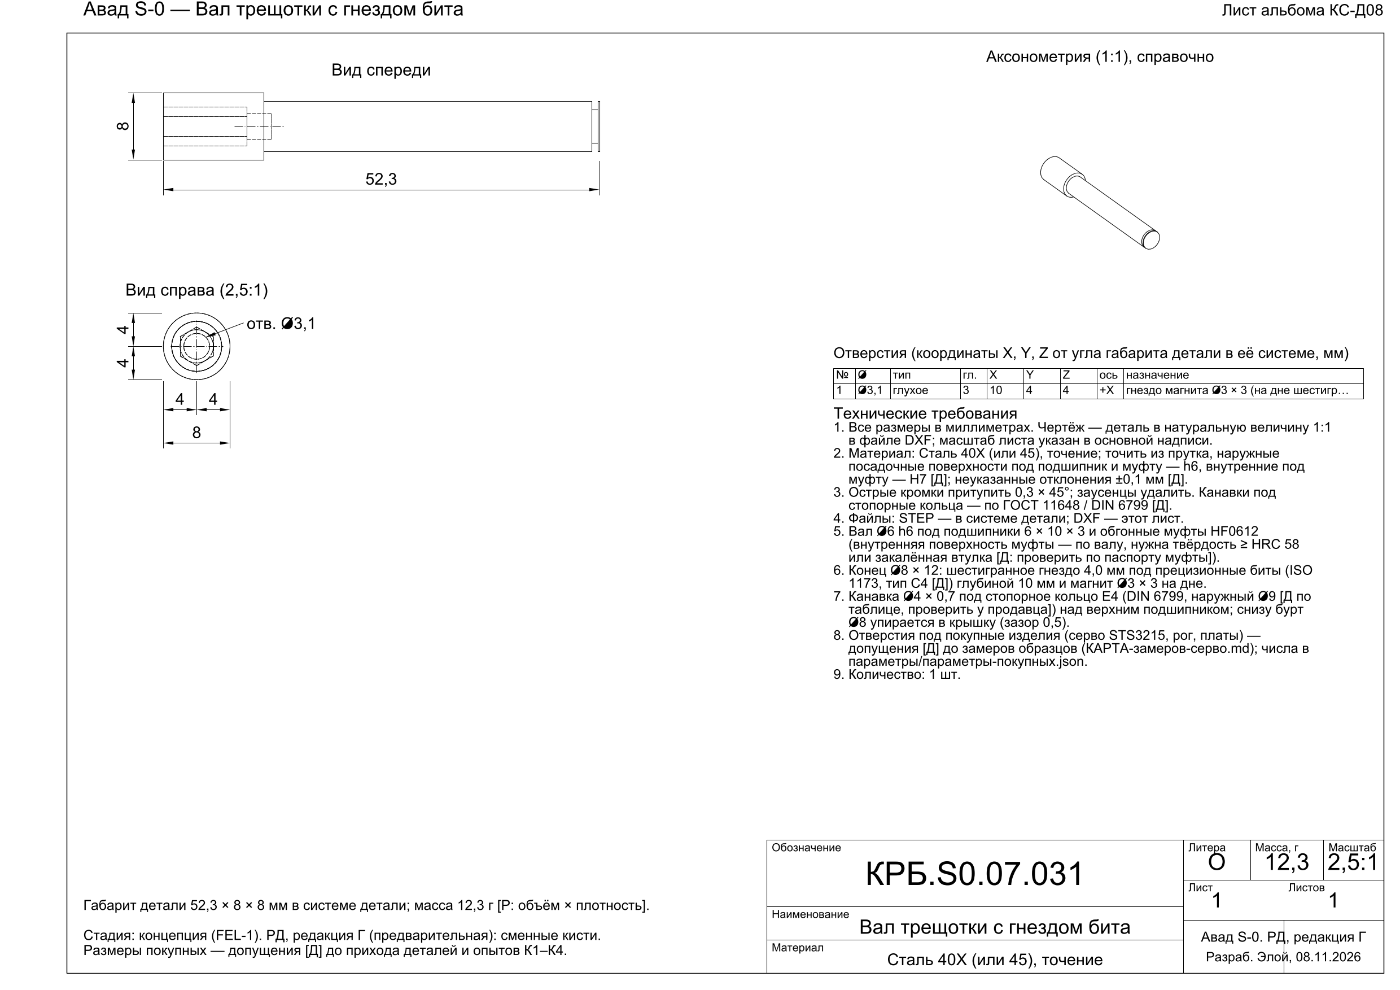
wrist-tools/KRB.S0.07.031_val-treshchotki.png
