pilot443/avad-s0/wrist-tools/KRB.S0.07.032_vtulka-mufty.png

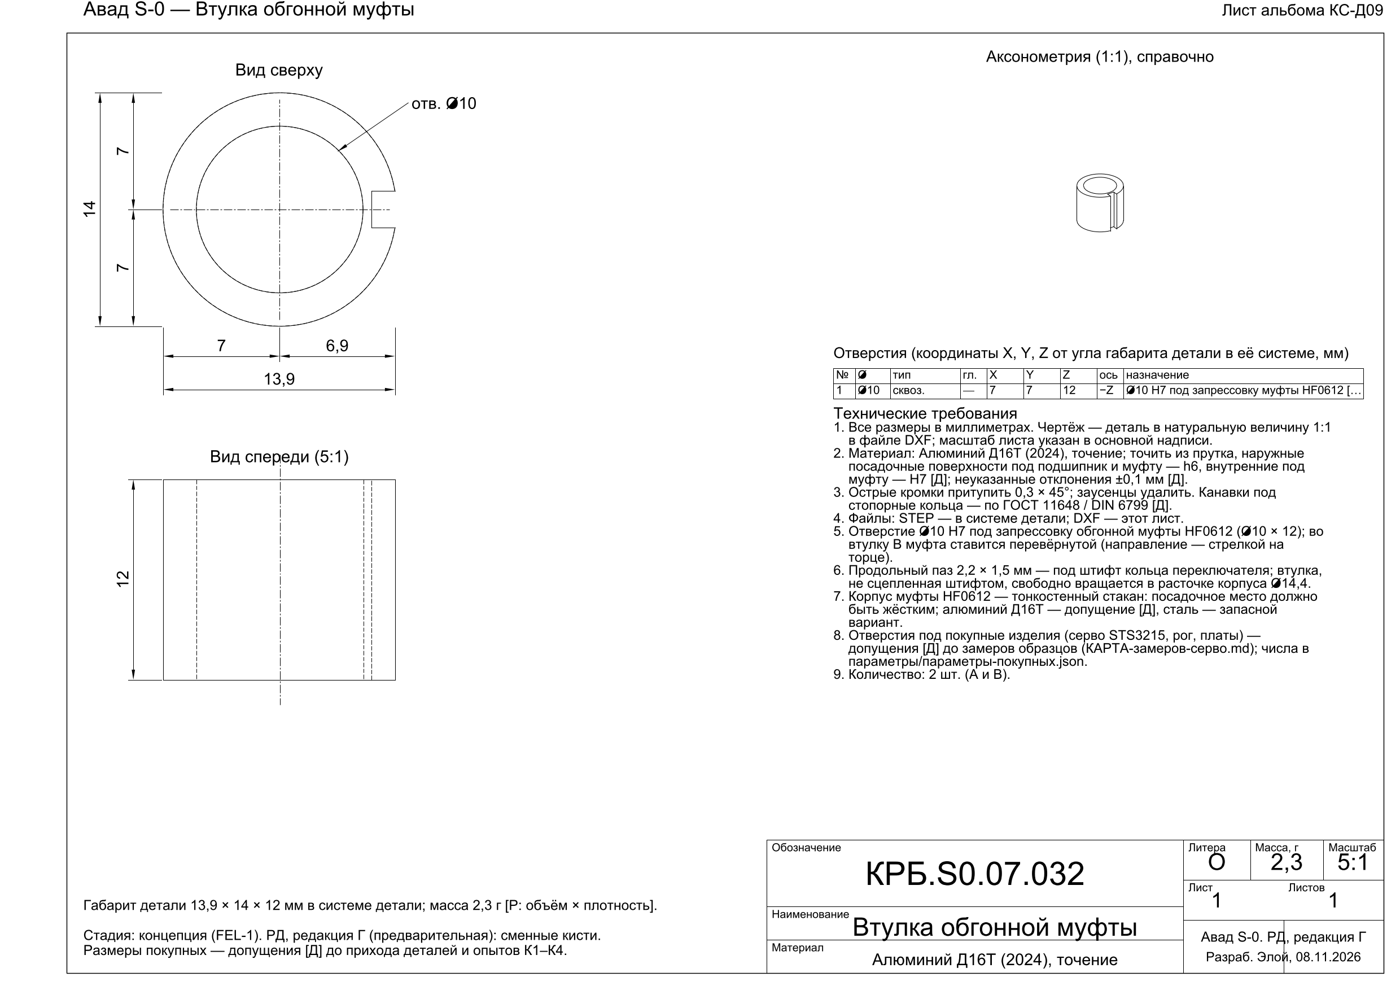
wrist-tools/KRB.S0.07.032_vtulka-mufty.png
