pilot443/avad-s0/wrist-tools/KRB.S0.07.033_koltso-pereklyuchatelya.png

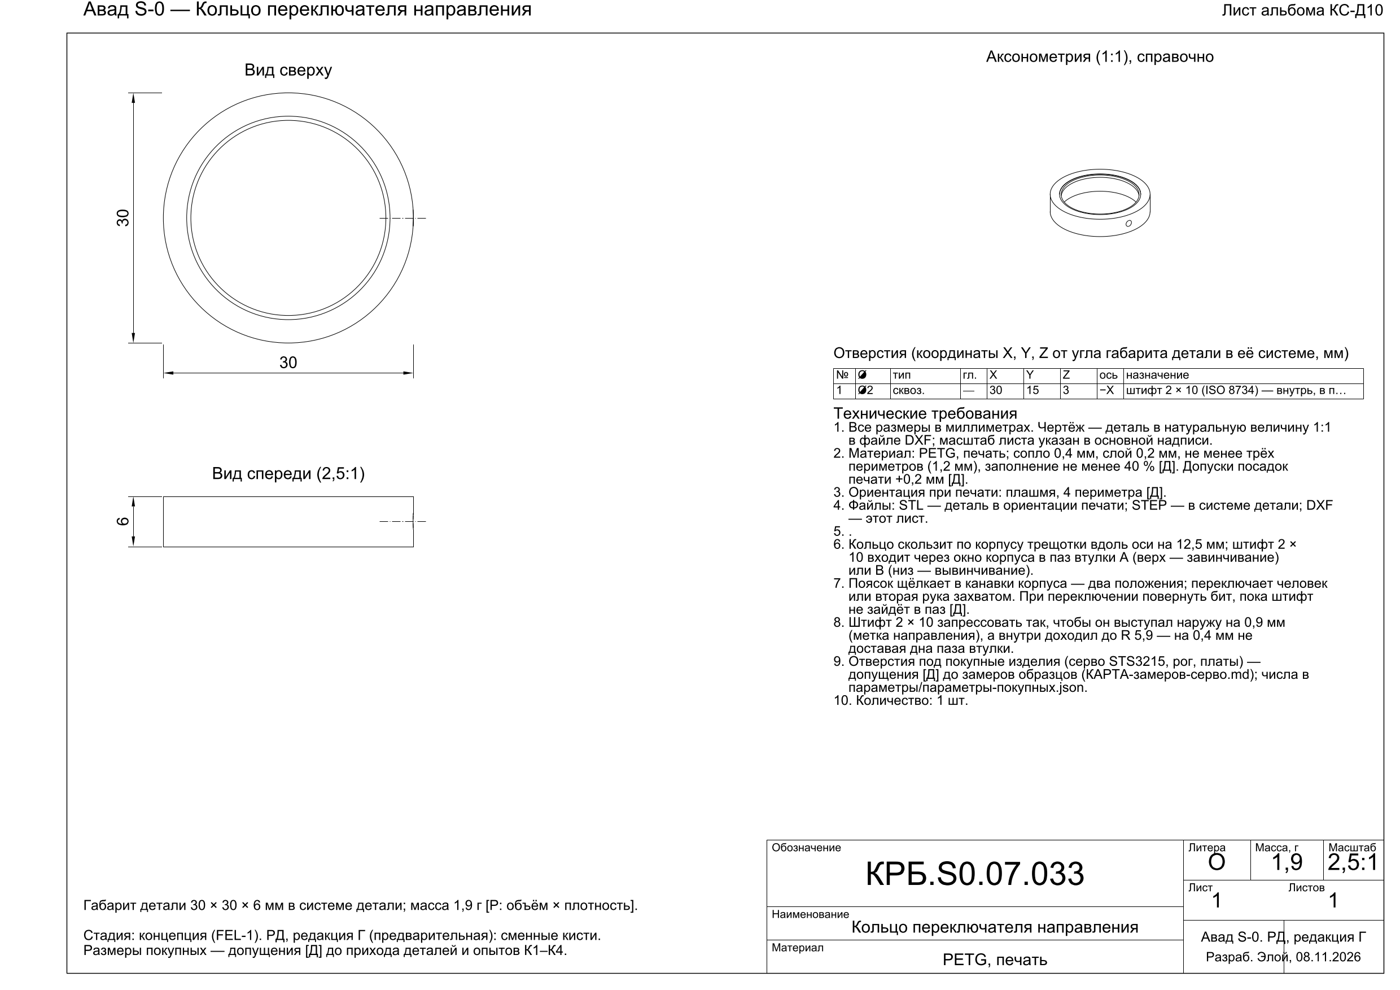
wrist-tools/KRB.S0.07.033_koltso-pereklyuchatelya.png
