pilot443/avad-s0/wrist-tools/KRB.S0.07.034_kryshka-treshchotki.png

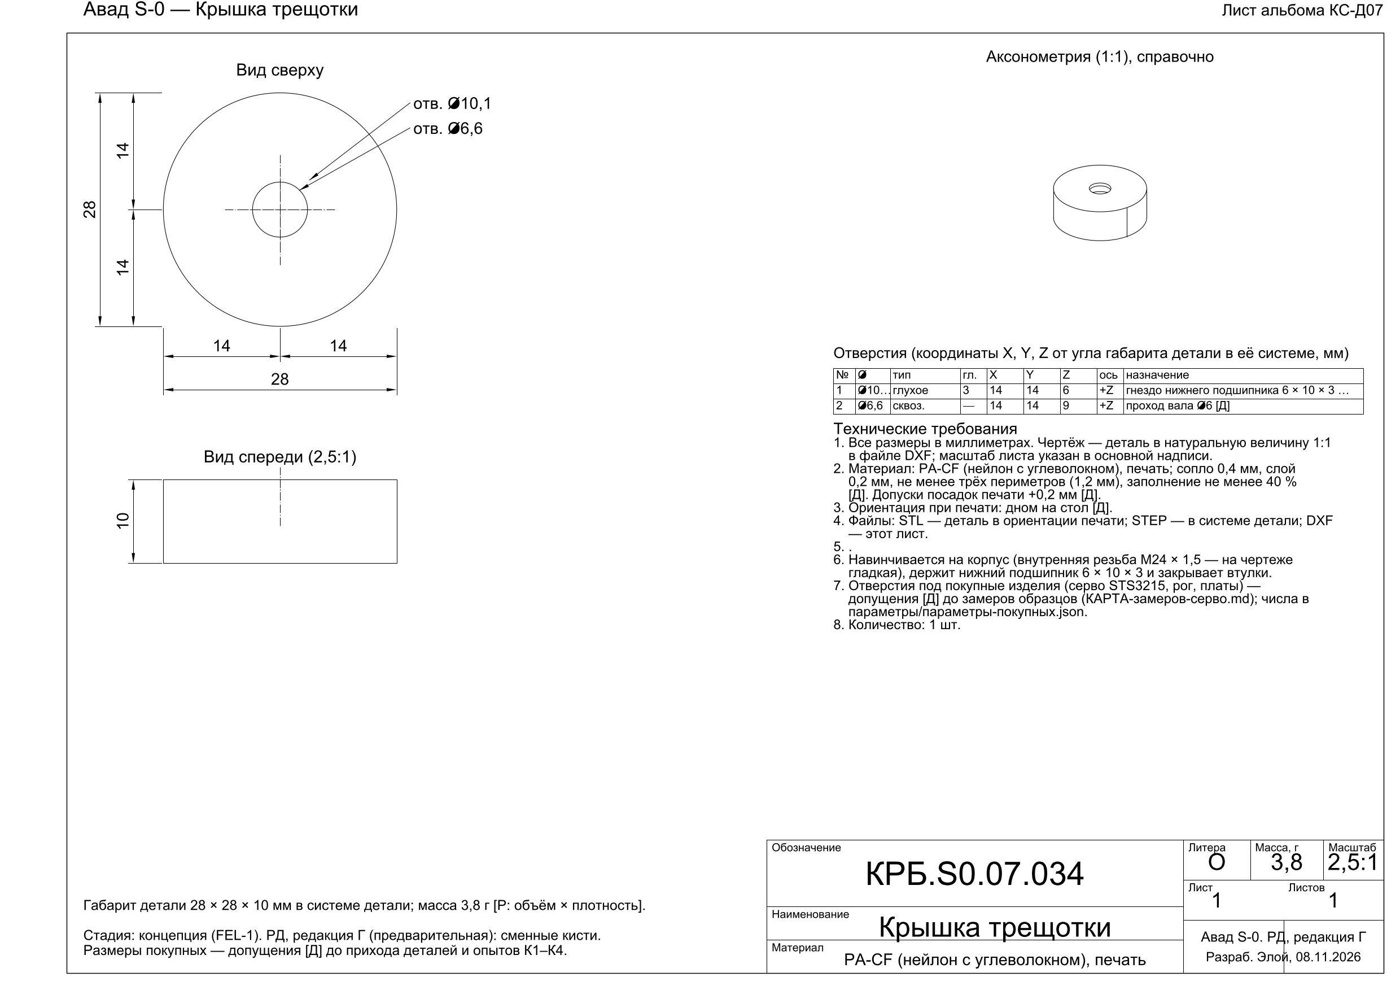
wrist-tools/KRB.S0.07.034_kryshka-treshchotki.png
