pilot443/avad-s0/wrist-tools/KRB.S0.07.035_raspornaya-vtulka.png

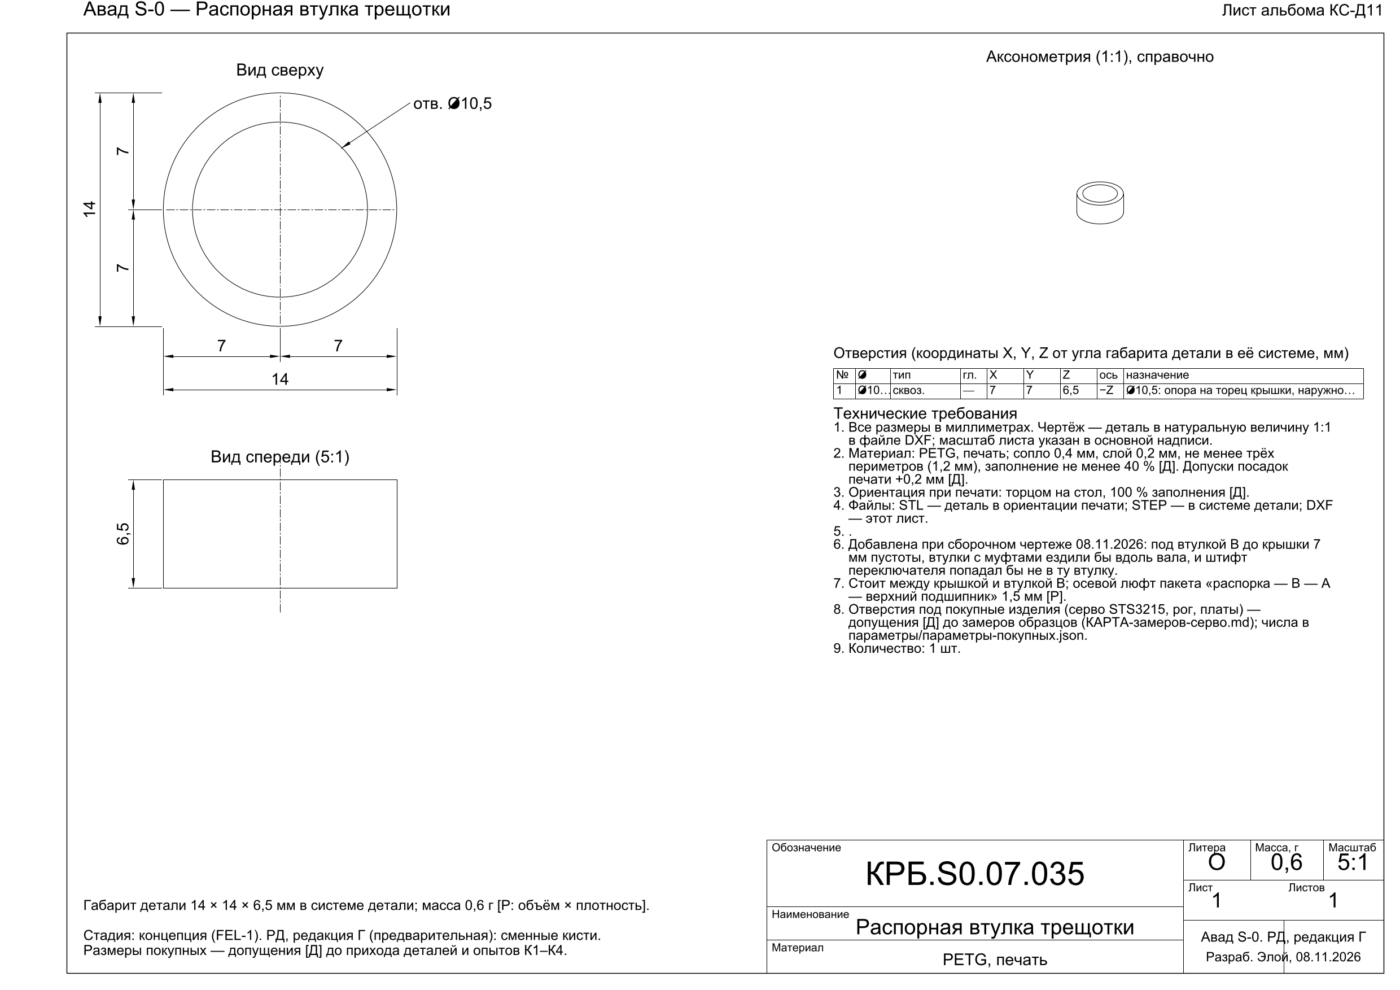
wrist-tools/KRB.S0.07.035_raspornaya-vtulka.png
