pilot443/avad-s0/docs/bom/purchase-list.md

Стадия: **концепция (FEL-1), РД ред. В (предварительная) и эскиз кистей (литера «Э»)**. Учебный прототип S-0, не опытный образец. Сгенерировано `инструменты/универсал_рд_закупки_в.py`, 08.11.2026. Цены не обсуждаются (том 15) — только состав и количество.

# Авад S-0: ведомость закупки (редакция Г)

**Что входит:** робот по модели v2.6 (ноги на STS3250 и ST3215-HS, одна линия 12 В, три шины Feetech, питание ног «звездой»), замок кисти на обеих руках, две кисти-захвата К1, паяльная К2-2 и отвёрточная К3-1. Источники чисел — файлы РД и кистей; ведомость пересобирается одной командой после любой правки чертежей.

**Два заказа** (порядок Ивана: ведомость → проверка в симуляторе → инструкция → закупка → опыты К1–К4 → правка чертежей → сборка):

- **Заказ 1 — покупные** (разделы 1–7, 9): после инструкции сборки (шаг 5). **Литий — только после проверки у карго.**
- **Заказ 2 — изготовление по чертежам** (резка листа, гибка, точение; раздел 8 и таблица «Изготовление»): после замеров пришедших серво и правки чертежей — отверстия под XM430 сейчас допущения [Д]. Печать — тоже на заказ по STL (принтера нет — решение Ивана 08.11.2026), после правки.

**Главные числа [Р]:** серво 18 STS3250 + 6 ST3215-HS + 14 STS3215 (с запасом 20 % — 47 шт.); видов крепежа — 31, всего 783 шт. без запаса; видов деталей своего изготовления — 44, всего 116 шт.

Запас: серво, разъёмы и кабели шин +20 % [И `../../S0-ведомость-узлов-v0.md`, правило покупки]; крепёж +10 %; материалы +30 %; дорогие модули — без запаса [Д: решает Иван]. Метки: [И] источник, [Р] расчёт, [Д] допущение.

**Ссылки Pinduoduo.** В колонке Pinduoduo — поиск по точному китайскому запросу (Pinduoduo показывает выдачу только после входа в аккаунт). Ссылки на проверенные карточки появятся в колонке, когда карточки будут сверены с требованиями. Страница для телефона с теми же ссылками и отметками «куплено» — `закупка-S0-В.html` (собирает `инструменты/универсал_рд_закупки_страница.py`).

## 1. Приводы и шины

| № | Позиция | На робота | Запас | Заказать | Назначение — откуда число | Pinduoduo (поиск по запросу; англ. — для других площадок) | Замена | Проверить в карточке и при получении | Заказ |
|---|---|---|---|---|---|---|---|---|---|
| 1 | Серво Feetech STS3250 (12 В, 50 кг·см) [И] | 18 шт. | 4 | **22** | подъём бедра ×2 и колено на каждой ноге (модель v2.6, решение С9) — таблица-серво.csv: 18 строк | **[карточка](https://mobile.yangkeduo.com/goods.html?goods_id=927358986228)** — ST-3250-C002 (без кронштейна, 12V 50KG), ¥320 в карточке; поиск: [飞特 STS3250 12V 50KG 总线舵机](https://mobile.yangkeduo.com/search_result.html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) · Feetech STS3250 12V 50kg serial bus servo | STS3235 (30 кг·см — пересчёт нагрузки) | вариант ST-3250-C002 (без кронштейна) или C001; 12 В; корпус 45,22 × 24,72 × 35 мм как у STS3215 (замер); магнитный энкодер, двойной вал; рог и винты в комплекте | 1 |
| 2 | Серво Feetech ST3215-HS (12 В) [И] | 6 шт. | 2 | **8** | поворот бедра на каждой ноге — таблица-серво.csv: 6 строк | **[карточка](https://mobile.yangkeduo.com/goods.html?goods_id=953674639171)** — ST3215-HS Servo Motor (единственный), ¥110 в карточке; поиск: [飞特 ST3215-HS 高速 总线舵机 12V](https://mobile.yangkeduo.com/search_result.html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) · Feetech ST3215-HS high speed serial bus servo 12V | STS3215 12 В — медленнее: ходьба до 14,9 см/с только с HS (опыт E2 v2.2) | 12 В, габарит 45,2 × 24,7 × 35 мм как у STS3215, двойной вал, рог и винты в комплекте; ID по умолчанию 1 | 1 |
| 3 | Серво Feetech STS3215 (12 В) [И] | 14 шт. | 3 | **17** | руки 2 × 5, голова 2, захваты кистей К1 2 — таблица-серво.csv: 14 строк | **[карточка](https://mobile.yangkeduo.com/goods.html?goods_id=982575404315)** — ST-3215-C018 (1:345, 12V, 30KG), ¥110 в карточке; поиск: [总线舵机 12V 30KG 磁编码 飞特 STS3215 ST-3215-C018](https://mobile.yangkeduo.com/search_result.html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) · Feetech STS3215 12V serial bus servo 30kg magnetic encoder | Feetech ST3215 того же габарита 45,2 × 24,7 × 35 мм | напряжение 12 В (не 6–7,4 В), двойной вал, комплект рогов и винтов; резьба M2 на гранях рога и пассивного вала (замер) | 1 |
| 4 | Адаптер шины Feetech (USB) [Д] | 3 шт. | 1 | **4** | шины Н1 (ноги 1–3), Н2 (ноги 4–6), Р (руки, голова, К1) — ПЗ-01, раскладка: Н1, Н2, Р | **[карточка](https://mobile.yangkeduo.com/goods.html?goods_id=601036887735)** — URT-2 debugging board (with Type-C data cable), ¥50 в карточке; поиск: [总线舵机 USB 调试板 FE-URT-1 / 微雪 总线舵机驱动板](https://mobile.yangkeduo.com/search_result.html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) · Feetech FE-URT-1 USB bus servo adapter / Waveshare bus servo adapter | Waveshare Bus Servo Adapter (A) | 3-контактный порт, питание 6–12 В, размеры и отверстия (замер) | 1 |
| 5 | Плата питания и разветвитель шин ног (ПН) [Д] | 1 шт. | 0 | **1** | питание ног «звездой»: 6 выходов (кабель с питанием 0,5 мм² на ногу), данные от Н1 и Н2 — ПЗ-01, раскладка: ПН; шаг 4 | [总线舵机 分线板 6路 带电源输入](https://mobile.yangkeduo.com/search_result.html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) · bus servo hub board with power input, 6 ports 3-pin | своя плата на макетке: клеммы питания + 2 × 3 разъёма | ток на выход ≥ 4 А (пик ноги 3,7 А [Р]), вход питания отдельно от адаптера, две группы данных (Н1, Н2) или две платы | 1 |
| 6 | Кабель USB к адаптеру шины, 20 см [Д] | 3 шт. | 0 | **3** | Pi 5 USB-A ×3 → Н1, Н2, Р (четвёртый USB свободен) — таблица-жгутов: W21 | [短 USB 数据线 20cm](https://mobile.yangkeduo.com/search_result.html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) · short USB cable 20cm (USB-A to micro-USB / USB-C) | кабель из комплекта адаптера | разъём со стороны адаптера (micro-USB или USB-C — по пришедшему адаптеру) | 1 |

## 2. Вычислитель, камеры и связь

| № | Позиция | На робота | Запас | Заказать | Назначение — откуда число | Pinduoduo (поиск по запросу; англ. — для других площадок) | Замена | Проверить в карточке и при получении | Заказ |
|---|---|---|---|---|---|---|---|---|---|
| 7 | Raspberry Pi 5 8 ГБ + активное охлаждение [И] | 1 шт. | 0 | **1** | бортовой компьютер — ЭЛ-01 | **[карточка](https://mobile.yangkeduo.com/goods.html?goods_id=697484512180)** — Motherboard (только плата) + 8G, ¥1519 в карточке; поиск: [树莓派5 8G 主动散热器](https://mobile.yangkeduo.com/search_result.html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) · Raspberry Pi 5 8GB + official Active Cooler | Orange Pi 5 (другие отверстия — пересчёт) | версия 8 ГБ, отверстия 58 × 49 мм, высота кулера; без питания 5 В 5 А по PD Pi 5 ограничивает ток USB — в config.txt параметр usb_max_current_enable [Д: сверить с документацией Raspberry Pi] | 1 |
| 8 | microSD 64 ГБ A2 [Д] | 1 шт. | 1 | **2** | система + запасная с копией — — | [存储卡 A2 64G](https://mobile.yangkeduo.com/search_result.html?search_key=%E5%AD%98%E5%82%A8%E5%8D%A1%20A2%2064G) · microSD 64GB A2 | 128 ГБ A2 | скорость A2, подлинность | 1 |
| 9 | Raspberry Pi Pico [И] | 1 шт. | 1 | **2** | плата ввода-вывода: цепь остановки, ШИМ нагрева, АЦП опознавания кистей, датчики Холла — раскладка: Pico | **[карточка](https://mobile.yangkeduo.com/goods.html?goods_id=1011355278811)** — RP2040 development board (или с впаянными штырями — ¥50), ¥38 в карточке; поиск: [树莓派 Pico](https://mobile.yangkeduo.com/search_result.html?search_key=%E6%A0%91%E8%8E%93%E6%B4%BE%20Pico) · Raspberry Pi Pico (RP2040) | Pico H / Pico 2 | размеры 51 × 21 мм, отверстия 47 × 11,4 мм; три входа АЦП (опознавание двух кистей) | 1 |
| 10 | Камера Raspberry Pi Camera Module 3 Wide [И] | 3 шт. | 0 | **3** | две на голове, одна сзади — ПЗ-01: W23–W25 | **[карточка](https://mobile.yangkeduo.com/goods.html?goods_id=493013940854)** — Module 3 wide, ¥269 в карточке; поиск: [树莓派 摄像头 Module 3 广角](https://mobile.yangkeduo.com/search_result.html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) · Raspberry Pi Camera Module 3 Wide | Module 3 стандартная (другой угол) | вариант Wide, отверстия 21 × 12,5 | 1 |
| 11 | Шлейф-переходник 22→15 контактов, 300 мм [И] | 3 шт. | 0 | **3** | Pi 5 — 22 контакта 0,5 мм, камера — 15 контактов 1 мм — таблица-жгутов: W23–W25 | **[карточка](https://mobile.yangkeduo.com/goods.html?goods_id=846031170691)** — 300mm, ¥22 в карточке; поиск: [树莓派5 摄像头 转接线 22转15 300mm](https://mobile.yangkeduo.com/search_result.html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) · Raspberry Pi 5 camera adapter cable 22-pin to 15-pin 300mm | 200 мм (если трасса короче) | 22 контакта 0,5 мм со стороны Pi, 15 контактов 1 мм со стороны камеры | 1 |
| 12 | Мультиплексор камер CSI для Pi 5 [Д] | 1 шт. | 0 | **1** | третья (задняя) камера при двух разъёмах CSI — W25 [Д: вопрос Ивану с ред. А] | [Arducam 多路 摄像头 扩展板 树莓派5](https://mobile.yangkeduo.com/search_result.html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) · Arducam camera multiplexer CSI Raspberry Pi 5 | USB-камера сзади (другая посадка) | совместимость с Pi 5 (22 контакта), питание, размер платы | 1 |
| 13 | Антенна 2,4 ГГц SMA [Д] | 2 шт. | 0 | **2** | на голове — ред. А | [2.4G 天线 SMA 全向](https://mobile.yangkeduo.com/search_result.html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) · 2.4GHz antenna SMA 2dBi | любая 2,4 ГГц | разъём совпадает с радиомодулем | 1 |
| 14 | Радиомодуль mesh 2,4 ГГц [Д] | 1 шт. | 0 | **1** | к антеннам на голове — модуль не выбран — находка ред. А | [2.4G mesh 无线 模块 双天线](https://mobile.yangkeduo.com/search_result.html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) · 2.4GHz mesh radio module dual antenna (ESP32/nRF) | Wi-Fi Pi 5 (без mesh) | модуль не выбран (находка ред. А): до решения Ивана можно не брать | 1 |

## 3. Питание и безопасность

| № | Позиция | На робота | Запас | Заказать | Назначение — откуда число | Pinduoduo (поиск по запросу; англ. — для других площадок) | Замена | Проверить в карточке и при получении | Заказ |
|---|---|---|---|---|---|---|---|---|---|
| 15 | Батарея Li-ion 4S4P 18650 с BMS 40 А и XT60 [Д] | 1 шт. | 0 | **1** | ≈ 164 Вт·ч [Р], 68 × 160 × 38 мм; ЛИТИЙ — только после проверки у карго — параметры: батарея_4S4P | [14.8V 18650 锂电池组 4串4并 带保护板 40A XT60](https://mobile.yangkeduo.com/search_result.html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) · 4S4P 18650 Li-ion battery pack 14.8V with BMS 40A XT60 | собрать из 16 ячеек 18650 + BMS 4S 40 А (только с точечной сваркой) | ЗАКАЗ ТОЛЬКО ПОСЛЕ ПРОВЕРКИ У КАРГО; габарит ≤ 68 × 160 × 38 мм (лоток 06.001); ток BMS ≥ 40 А; балансировочный разъём; ёмкость по факту | 1 |
| 16 | Зарядное устройство 4S 16,8 В 2 А [Д] | 1 шт. | 0 | **1** | заряд под присмотром, в мешке — — | **[карточка](https://mobile.yangkeduo.com/goods.html?goods_id=1004903975829)** — 16.8V2A [5.5mm interface, 1-meter cable], ¥26.8 в карточке; поиск: [16.8V 锂电池 充电器 4串 2A XT60](https://mobile.yangkeduo.com/search_result.html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) · 4S Li-ion 16.8V 2A charger XT60 | балансное зарядное (B6 и подобные) | 16,8 В (не 12,6 В!), заряд только под присмотром | 1 |
| 17 | Огнеупорный мешок для литиевых батарей [Д] | 1 шт. | 0 | **1** | хранение и заряд — — | [锂电池 防火防爆袋](https://mobile.yangkeduo.com/search_result.html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) · LiPo fireproof bag | металлический ящик | размер под пакет 68 × 160 × 38 | 1 |
| 18 | Преобразователи U2.1–U2.7: 12 В 5 А, повышающе-понижающие [Р] | 7 шт. | 1 | **8** | питание серво: U2.1–U2.6 — по ноге (пик 3,7 А), U2.7 — руки, голова, К1 (до 1,7 А) [Р шаг 4] — решение С10; раскладка: U2.1, U2.2, U2.3, U2.4, U2.5, U2.6, U2.7 — платы BB3210 33 × 22 × 9 мм под верхней плитой | **[карточка](https://mobile.yangkeduo.com/goods.html?goods_id=1027174841859)** — 黑BB3210升降压8A 5-26V转【12V】 (чёрная BB3210, вход 5–26 В → 12 В), ¥59.4 в карточке; поиск: [BB3210 升降压 8A 5-26V转12V 模块](https://mobile.yangkeduo.com/search_result.html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) · BB3210 buck-boost module 8A, 5-26V to 12V | повышающе-понижающий 12 В | вход 5–26 В (батарея 12,8–16,8 В), выход 12 В, до 8 А (без радиатора — до 6 А); плата 33 × 22 × 9 мм, 2 отв. Ø3 через 27,4 мм [И карточка BB3210] | 1 |
| 19 | Преобразователь U3: 5 В 5 А с USB-C (Pi 5) [Д] | 1 шт. | 0 | **1** | преобразователь 16,8→5 В (U3) — раскладка: U3 (50 × 25 мм) | **[карточка](https://mobile.yangkeduo.com/goods.html?goods_id=974154056910)** — 5V5A output step-down power module, ¥46 в карточке; поиск: [12V转5V 5A 降压模块 树莓派5 USB-C](https://mobile.yangkeduo.com/search_result.html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) · 12V-24V to 5V 5A buck converter USB-C for Raspberry Pi 5 | любой DC-DC 5 В ≥ 5 А | 5,1 В на выходе под нагрузкой, вход до 17 В, размеры 50 × 25 мм | 1 |
| 20 | Преобразователь U4: 12 В 0,5 А (цепь остановки) [Д] | 1 шт. | 0 | **1** | стабилизатор 12 В 0,5 А цепи остановки (U4) — раскладка: U4 (25 × 15 мм) | **[карточка](https://mobile.yangkeduo.com/goods.html?goods_id=989083061766)** — 6-35V to 12V2A, white shell, ¥25.88 в карточке; поиск: [迷你 降压模块 12V 1A](https://mobile.yangkeduo.com/search_result.html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) · mini buck converter 12V 1A | линейный стабилизатор 7812 на радиаторе | катушка реле 12 В срабатывает и при 9–10 В [Д: паспорт реле], поэтому подходит любой мини-модуль | 1 |
| 21 | Реле 12 В 40 А с колодкой (K1) [Д] | 1 шт. | 0 | **1** | силовой разрыв обеих линий серво и нагрева при остановке — раскладка: K1 | **[карточка](https://mobile.yangkeduo.com/goods.html?goods_id=983237928761)** — 40A12V 4-pin relay + base with cable, ¥27 в карточке; поиск: [汽车继电器 12V 40A 带底座](https://mobile.yangkeduo.com/search_result.html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) · automotive relay 12V 40A with socket | твердотельное реле ≥ 40 А DC | катушка 12 В, ток контактов ≥ 40 А | 1 |
| 22 | Блок предохранителей ATO на 6 мест [Д] | 1 шт. | 0 | **1** | F1–F5 — раскладка: предохранители | [6路 汽车 保险丝盒 ATO](https://mobile.yangkeduo.com/search_result.html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) · 6-way ATO/ATC blade fuse block | отдельные держатели | 5 мест заняты (F1–F5), 1 — резерв | 1 |
| 23 | Предохранители ATO: 40 А ×1, 10 А ×3, 5 А ×1 [Р] | 5 шт. | 5 | **10** | F1 батарея, F2 ноги 1–3, F3 ноги 4–6, F4 руки и голова, F5 нагрев жала — ПЗ-01, таблица-жгутов: W1, W8–W11; шаг 4 | [汽车 插片 保险丝 40A 20A 10A 5A](https://mobile.yangkeduo.com/search_result.html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) · ATO blade fuses 40A 20A 10A 5A | мини-ножевые | номиналы по схеме ПЗ-01 | 1 |
| 24 | Выключатель SA1 ≥ 40 А + розетка XT60 на панель [Д] | 1 компл. | 0 | **1** | главный выключатель и зарядный разъём — W2–W3 | [大电流 开关 40A 直流 · XT60 母座 面板](https://mobile.yangkeduo.com/search_result.html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) · panel switch 40A DC + XT60 female panel mount | выключатель батареи (кнопка-ключ) | ток не меньше предохранителя F1 40 А [Р]; отверстие под панель | 1 |
| 25 | Ключ-выключатель SA2 Ø19 [Д] | 1 шт. | 0 | **1** | ключ у человека: замыкает цепь катушки K1 — ПЗ-01 | [钥匙开关 19mm 两档](https://mobile.yangkeduo.com/search_result.html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) · key switch 19mm panel mount 2 position | тумблер с фиксатором (хуже) | ключ вынимается в положении «выкл» | 1 |
| 26 | Аварийная кнопка-гриб SB1 Ø22, NC, с фиксацией [Д] | 1 шт. | 0 | **1** | рвёт цепь катушки K1 независимо от компьютера — ПЗ-01 | **[карточка](https://mobile.yangkeduo.com/goods.html?goods_id=1023586860024)** — 1 normally open, 1 normally closed (используется NC), ¥28.38 в карточке; поиск: [急停开关 蘑菇头 22mm 自锁 常闭](https://mobile.yangkeduo.com/search_result.html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) · emergency stop mushroom button 22mm latching NC | любая NC 22 мм | нормально замкнутая цепь, шляпка Ø30 | 1 |
| 27 | Модуль MOSFET-ключа VT1 для катушки реле [Д] | 1 шт. | 1 | **2** | программный разрыв по сигналу Pico (сам включить цепь не может) — ПЗ-01 | **[карточка](https://mobile.yangkeduo.com/goods.html?goods_id=999275542071)** — YYNMOS-1 Single-channel 3-5V signal trigger, ¥18 в карточке; поиск: [MOS 管 驱动 模块 3.3V 逻辑](https://mobile.yangkeduo.com/search_result.html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) · MOSFET switch module logic level 3.3V | оптопара + транзистор | ключ разрывает цепь катушки при пропадании сигнала Pico (отказ в безопасное состояние) | 1 |
| 28 | Модуль INA226 [Д] | 3 шт. | 1 | **4** | батарея, ноги, руки и голова — раскладка: INA1–INA3 | **[карточка](https://mobile.yangkeduo.com/goods.html?goods_id=882129380400)** — INA226 module with straight-pin terminals already soldered, ¥19.18 в карточке; поиск: [INA226 电流电压功率监测模块](https://mobile.yangkeduo.com/search_result.html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) · INA226 current voltage power monitor module | INA228 | шунт на плате обычно 10 мОм — до 8 А; для линий до 40 А — внешний шунт (строка ниже) | 1 |
| 29 | Шунт 75 мВ 50 А [Р] | 3 шт. | 0 | **3** | к INA226: токи линий до 40 А (шунт платы 10 мОм — только до 8 А) — находка шага 3 [Р] | [分流器 75mV 50A](https://mobile.yangkeduo.com/search_result.html?search_key=%E5%88%86%E6%B5%81%E5%99%A8%2075mV%2050A) · DC shunt 75mV 50A | шунт 2 мОм 3 Вт | 75 мВ / 50 А = 1,5 мОм: при 50 А на входе INA226 75 мВ — в пределах 81,9 мВ [Р] | 1 |
| 30 | Плата нагрева жала A1 (MOSFET + усилитель термопары) [Д] | 1 шт. | 0 | **1** | паяльная кисть К2-2; питание 12 В через F5 (23 Вт) — раскладка: A1 | [TS100 烙铁头 驱动板 热电偶 放大](https://mobile.yangkeduo.com/search_result.html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) · TS100 tip driver board MOSFET + thermocouple amplifier | своя на макетке: MOSFET logic-level ≥ 5 А + ОУ | питание 12 В (ред. Г), ШИМ 3,3 В от Pico; нагреватель и термопара жала на одних проводах — мерить в паузе ШИМ [Д] | 1 |
| 31 | Набор резисторов 0,25 Вт [Р] | 1 компл. | 0 | **1** | опознавание кистей 1 / 3,3 / 10 кОм, подтяжки 10 кОм (АЦП, датчики Холла) — ТБ-03 | [1/4W 电阻 套装](https://mobile.yangkeduo.com/search_result.html?search_key=1/4W%20%E7%94%B5%E9%98%BB%20%E5%A5%97%E8%A3%85) · 1/4W resistor kit | SMD 0805 | есть 1 кОм, 3,3 кОм, 10 кОм, 33 кОм (опознавание кистей, подтяжки) | 1 |

## 4. Датчики, индикация, звук

| № | Позиция | На робота | Запас | Заказать | Назначение — откуда число | Pinduoduo (поиск по запросу; англ. — для других площадок) | Замена | Проверить в карточке и при получении | Заказ |
|---|---|---|---|---|---|---|---|---|---|
| 32 | Инерциальный датчик BNO055 [И] | 1 шт. | 0 | **1** | ориентация корпуса — раскладка: BNO | **[карточка](https://mobile.yangkeduo.com/goods.html?goods_id=952718708433)** — Adafruit ID 2472, ¥358 в карточке; поиск: [BNO055 九轴 姿态传感器](https://mobile.yangkeduo.com/search_result.html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) · Adafruit BNO055 9-DOF orientation sensor | BNO085 | 20 × 27 мм, отверстия 20 × 12 мм | 1 |
| 33 | Светодиодное кольцо WS2812B Ø44 (16 LED) [Д] | 2 шт. | 0 | **2** | вокруг камер головы — ред. А | **[карточка](https://mobile.yangkeduo.com/goods.html?goods_id=822989556007)** — 16-bit (white round), ¥12.35 в карточке; поиск: [WS2812B 灯环 16位 外径44mm](https://mobile.yangkeduo.com/search_result.html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) · WS2812B 16 LED ring 44mm | кольцо 12 LED | наружный диаметр 44 мм, 5 В | 1 |
| 34 | Центральный «глаз» Ø28 (RGB-модуль) [Д] | 1 шт. | 0 | **1** | по решению Ивана Б5 — ред. А | [WS2812B 圆形 灯板 28mm](https://mobile.yangkeduo.com/search_result.html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) · 28mm round RGB LED module WS2812B | кольцо 24 LED | диаметр, 5 В — состав модуля не утверждён (вопрос Ивану Б5) | 1 |
| 35 | Усилитель MAX98357A [И] | 1 шт. | 0 | **1** | звук — раскладка: усилитель | **[карточка](https://mobile.yangkeduo.com/goods.html?goods_id=1027332218929)** — MAX98357（焊接好排针）— с впаянными штырями, ¥26.31 в карточке; поиск: [MAX98357 功放 模块](https://mobile.yangkeduo.com/search_result.html?search_key=MAX98357%20%E5%8A%9F%E6%94%BE%20%E6%A8%A1%E5%9D%97) · Adafruit MAX98357A I2S class-D amp | аналог на том же чипе | 19,4 × 17,8 мм | 1 |
| 36 | Динамик 3 Вт 4 Ом 30 × 30 × 10 [Д] | 2 шт. | 0 | **2** | на нижней плите, звук вниз — ред. А | **[карточка](https://mobile.yangkeduo.com/goods.html?goods_id=1015465630540)** — 30MM-4Ω 3W-1.25 plug, ¥6.8 в карточке; поиск: [3W 4欧 扬声器 30mm 方形](https://mobile.yangkeduo.com/search_result.html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) · 3W 4 ohm speaker 30mm | любой 3 Вт 4 Ом ≤ 30 × 30 × 10 мм | размеры, крепёжные отверстия | 1 |

## 5. Замок и сменные кисти (покупные)

| № | Позиция | На робота | Запас | Заказать | Назначение — откуда число | Pinduoduo (поиск по запросу; англ. — для других площадок) | Замена | Проверить в карточке и при получении | Заказ |
|---|---|---|---|---|---|---|---|---|---|
| 37 | Шарик стальной Ø5 (подшипниковый) [Д] | 6 шт. | 2 | **8** | К0: кинематическая посадка, 3 на гнездо — ведомость-кисти-S0.json | [5mm 钢珠 轴承钢](https://mobile.yangkeduo.com/search_result.html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) · 5mm steel bearing balls G10 | — | размеры по чертежам кистей (РД ред. Г); опыты К1–К4 до сборки | 1 |
| 38 | Магнит NdFeB Ø6 × 3, N42 [Д] | 6 шт. | 2 | **8** | К0: прижим кисти, 3 на гнездо — ведомость-кисти-S0.json | [钕铁硼 强磁 圆片 6x3 N42](https://mobile.yangkeduo.com/search_result.html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) · neodymium magnet 6x3mm N42 | — | размеры по чертежам кистей (РД ред. Г); опыты К1–К4 до сборки | 1 |
| 39 | Шайба стальная Ø6 × 1 (или вырубка из листа 1 мм) [Д] | 12 шт. | 3 | **15** | К0: против магнитов, 3 на плиту — ведомость-кисти-S0.json | [铁片 圆片 6x1mm](https://mobile.yangkeduo.com/search_result.html?search_key=%E9%93%81%E7%89%87%20%E5%9C%86%E7%89%87%206x1mm) · steel disc 6x1mm | — | размеры по чертежам кистей (РД ред. Г); опыты К1–К4 до сборки | 1 |
| 40 | Пружинный контакт (pogo) Ø1,0, ход 1 мм, шаг 2,0 — блок 2 × 4 на плате [Д] | 2 шт. | 1 | **3** | К0: 8 контактов на гнездо — ведомость-кисти-S0.json | **[карточка](https://mobile.yangkeduo.com/goods.html?goods_id=958319293280)** — SW03874C-8P-Double row-2.0-10.0MM (5 шт. в упаковке), ¥19.6 в карточке; поиск: [弹簧顶针 连接器 2x4 2.0mm 间距](https://mobile.yangkeduo.com/search_result.html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) · pogo pin connector 2x4 2.0mm pitch | — | размеры по чертежам кистей (РД ред. Г); опыты К1–К4 до сборки | 1 |
| 41 | Контактная плата 8 × 4 мм, 8 площадок (своя, FR4 0,8–1,0) [Д] | 4 шт. | 0 | **4** | К0: на каждую ответную плиту — ведомость-кисти-S0.json | [双面 覆铜板 1.0mm / PCB 打样](https://mobile.yangkeduo.com/search_result.html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) · double sided FR4 copper clad 1.0mm / PCB order | — | размеры по чертежам кистей (РД ред. Г); опыты К1–К4 до сборки | 1 |
| 42 | Датчик Холла цифровой, 3,3 В, TO-92S (порог 7–40 мТл) [Р]/[Д] | 2 шт. | 1 | **3** | К0: «замок закрыт», 1 на гнездо; поле в «закрыто» ≥ 65 мТл, в «открыто» ≤ 4,9 мТл — ведомость-кисти-S0.json | [霍尔开关 3.3V TO-92 单极 DRV5023](https://mobile.yangkeduo.com/search_result.html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) · digital Hall effect switch 3.3V TO-92 unipolar (e.g. TI DRV5023) | всеполярный (omnipolar) — тогда полюс магнита не важен | питание от 3,3 В (A3144 и SS441 требуют 4,5 В — не подходят); порог 7–40 мТл [Р: в «закрыто» ≥ 65, в «открыто» ≤ 4,9 мТл]; выход открытый сток — подтяжка 10 кОм | 1 |
| 43 | Магнит NdFeB Ø3 × 2, намагничен по оси [Д] | 2 шт. | 1 | **3** | К0: в кольцо-байонет против датчика Холла — ведомость-кисти-S0.json | [钕铁硼 强磁 圆片 3x2mm](https://mobile.yangkeduo.com/search_result.html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) · neodymium magnet 3x2mm axially magnetized | Ø3 × 3 (гнездо углубить) | диаметр 3,0 ± 0,1 (гнездо Ø3,1) | 1 |
| 44 | Жало короткое TS100/Pinecil ST-B2 (≈ 6,2 Ом) [И pine64.org Tips] | 1 шт. | 0 | **1** | К2-2: нагреватель с термопарой — ведомость-кисти-S0.json | **[карточка](https://mobile.yangkeduo.com/goods.html?goods_id=1024003519696)** — TS-B2, ¥50 в карточке; поиск: [TS100 烙铁头 短 ST-B2](https://mobile.yangkeduo.com/search_result.html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) · TS100 / Pinecil short tip ST-B2 | — | размеры по чертежам кистей (РД ред. Г); опыты К1–К4 до сборки | 1 |
| 45 | Гнездо контактов жала TS100 (запчасть ручки, 3 контакта) [Д] | 1 шт. | 0 | **1** | К2-2: в держатель жала — ведомость-кисти-S0.json | [TS100 烙铁头 插座 配件](https://mobile.yangkeduo.com/search_result.html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) · TS100 tip socket connector spare | — | размеры по чертежам кистей (РД ред. Г); опыты К1–К4 до сборки | 1 |
| 46 | Обгонная игольчатая муфта HF0612 (6 × 10 × 12) [И rs-online] | 2 шт. | 1 | **3** | К3-1: трещотка, два направления — ведомость-кисти-S0.json | **[карточка](https://mobile.yangkeduo.com/goods.html?goods_id=478939385402)** — HF0612 Inner 6 Outer 10 Thick 12, ¥10.8 в карточке; поиск: [单向 滚针 轴承 HF0612](https://mobile.yangkeduo.com/search_result.html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) · HF0612 one-way needle bearing clutch 6x10x12 | — | размеры по чертежам кистей (РД ред. Г); опыты К1–К4 до сборки | 1 |
| 47 | Подшипник 6 × 10 × 3 (MR106ZZ) [Д] | 2 шт. | 1 | **3** | К3-1: вал трещотки — ведомость-кисти-S0.json | [MR106ZZ 轴承 6x10x3](https://mobile.yangkeduo.com/search_result.html?search_key=MR106ZZ%20%E8%BD%B4%E6%89%BF%206x10x3) · MR106ZZ bearing 6x10x3 | — | размеры по чертежам кистей (РД ред. Г); опыты К1–К4 до сборки | 1 |
| 48 | Кольцо стопорное E4 (DIN 6799, канавка Ø4, наружный Ø9) [Д] | 1 шт. | 1 | **2** | К3-1: вал — ведомость-кисти-S0.json | [E型 卡簧 E4 DIN6799](https://mobile.yangkeduo.com/search_result.html?search_key=E%E5%9E%8B%20%E5%8D%A1%E7%B0%A7%20E4%20DIN6799) · E-clip DIN 6799 E4 (for 4mm groove) | — | размеры по чертежам кистей (РД ред. Г); опыты К1–К4 до сборки | 1 |
| 49 | Магнит Ø3 × 3 [Д] | 1 шт. | 1 | **2** | К3-1: держит бит — ведомость-кисти-S0.json | [钕铁硼 强磁 圆片 3x3](https://mobile.yangkeduo.com/search_result.html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) · neodymium magnet 3x3mm | — | размеры по чертежам кистей (РД ред. Г); опыты К1–К4 до сборки | 1 |
| 50 | Набор прецизионных бит 4 мм (шлиц, PH0–PH1, шестигранник 1,5–2,5) [Д] | 1 шт. | 0 | **1** | К3-1: сменные биты — ведомость-кисти-S0.json | [4mm 精密 螺丝刀 批头 套装](https://mobile.yangkeduo.com/search_result.html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) · 4mm precision screwdriver bit set C4 | — | размеры по чертежам кистей (РД ред. Г); опыты К1–К4 до сборки | 1 |
| 51 | Рог холостой STS3215 (Ø19,2 × 2, 4 × M3 на Ø14) — проверить, есть ли в комплекте серво [Д] | 2 шт. | 1 | **3** | К1: вторая опора губки-вилки, 1 на кисть — ведомость-кисти-S0.json | — | — | размеры по чертежам кистей (РД ред. Г); опыты К1–К4 до сборки | 1 |

## 6. Контейнер

| № | Позиция | На робота | Запас | Заказать | Назначение — откуда число | Pinduoduo (поиск по запросу; англ. — для других площадок) | Замена | Проверить в карточке и при получении | Заказ |
|---|---|---|---|---|---|---|---|---|---|
| 52 | Магнит неодимовый Ø8 × 3 N35 [Д] | 4 шт. | 4 | **8** | по одному в торец держателя 05.003 — ред. А (замок контейнера вчерне) | [钕铁硼 强磁 圆片 8x3](https://mobile.yangkeduo.com/search_result.html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) · neodymium magnet 8x3mm N35 | Ø10 × 3 (другая лунка) | диаметр 8,0 ± 0,1, лунка Ø8,2 | 1 |
| 53 | Балласт — стальные шайбы [Д] | 1 компл. | 0 | **1** | в расчёте массы 200 г — модель РД ред. В | [钢垫片 M10](https://mobile.yangkeduo.com/search_result.html?search_key=%E9%92%A2%E5%9E%AB%E7%89%87%20M10) · steel washers M10 | свинцовые пластины в оболочке | 100, 200, 300 г шагами; в расчёте 200 г | 1 |

## 7. Крепёж (по таблицам отверстий деталей робота и кистей, +10 %)

| № | Позиция | На робота | Запас | Заказать | Назначение — откуда число | Pinduoduo (поиск по запросу; англ. — для других площадок) | Замена | Проверить в карточке и при получении | Заказ |
|---|---|---|---|---|---|---|---|---|---|
| 54 | Винт M2×5 DIN 7991 (потайной) [Р] | 48 шт. | 5 | **53** | детали: 02.002 — таблицы отверстий × количество деталей | [M2*5 沉头内六角螺丝 DIN7991](https://mobile.yangkeduo.com/search_result.html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) · M2x5 DIN7991 countersunk socket screw | эквивалент ISO/ГОСТ той же длины | стандарт и длина; нержавеющая сталь A2 (304) или сталь 8.8–12.9 — по наличию; продают пакетами по 50–100 шт. — брать пакет не меньше «Заказать» | 1 |
| 55 | Винт M2×5 DIN 912 (цилиндрическая головка) [Р] | 32 шт. | 4 | **36** | детали: 01.003, 01.004 — таблицы отверстий × количество деталей | [M2*5 内六角圆柱头螺丝 DIN912](https://mobile.yangkeduo.com/search_result.html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) · M2x5 DIN912 socket head cap screw | эквивалент ISO/ГОСТ той же длины | стандарт и длина; нержавеющая сталь A2 (304) или сталь 8.8–12.9 — по наличию; продают пакетами по 50–100 шт. — брать пакет не меньше «Заказать» | 1 |
| 56 | Винт M2×6 DIN 912 (цилиндрическая головка) [Р] | 132 шт. | 14 | **146** | детали: 01.004, 02.001, 02.010, 03.001, 03.002, 03.004, 03.010, 03.011, 04.002, 04.003, 07.011 — таблицы отверстий × количество деталей | [M2*6 内六角圆柱头螺丝 DIN912](https://mobile.yangkeduo.com/search_result.html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) · M2x6 DIN912 socket head cap screw | эквивалент ISO/ГОСТ той же длины | стандарт и длина; нержавеющая сталь A2 (304) или сталь 8.8–12.9 — по наличию; продают пакетами по 50–100 шт. — брать пакет не меньше «Заказать» | 1 |
| 57 | Винт M2×8 ISO 7380 (полукруглая головка) [Р] | 12 шт. | 2 | **14** | детали: 01.001, 04.001 — таблицы отверстий × количество деталей | [M2*8 半圆头内六角螺丝 ISO7380](https://mobile.yangkeduo.com/search_result.html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) · M2x8 ISO7380 button head socket screw | эквивалент ISO/ГОСТ той же длины | стандарт и длина; нержавеющая сталь A2 (304) или сталь 8.8–12.9 — по наличию; продают пакетами по 50–100 шт. — брать пакет не меньше «Заказать» | 1 |
| 58 | Винт M2×10 DIN 912 (цилиндрическая головка) [Р] | 4 шт. | 1 | **5** | детали: 01.003 — таблицы отверстий × количество деталей | [M2*10 内六角圆柱头螺丝 DIN912](https://mobile.yangkeduo.com/search_result.html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) · M2x10 DIN912 socket head cap screw | эквивалент ISO/ГОСТ той же длины | стандарт и длина; нержавеющая сталь A2 (304) или сталь 8.8–12.9 — по наличию; продают пакетами по 50–100 шт. — брать пакет не меньше «Заказать» | 1 |
| 59 | Винт M2,5×5 DIN 912 (цилиндрическая головка) [Р] | 12 шт. | 2 | **14** | детали: 01.004 — таблицы отверстий × количество деталей | [M2.5*5 内六角圆柱头螺丝 DIN912](https://mobile.yangkeduo.com/search_result.html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) · M2.5x5 DIN912 socket head cap screw | эквивалент ISO/ГОСТ той же длины | стандарт и длина; нержавеющая сталь A2 (304) или сталь 8.8–12.9 — по наличию; продают пакетами по 50–100 шт. — брать пакет не меньше «Заказать» | 1 |
| 60 | Винт M2,5×6 DIN 912 (цилиндрическая головка) [Р] | 16 шт. | 2 | **18** | детали: 01.002, 01.004 — таблицы отверстий × количество деталей | [M2.5*6 内六角圆柱头螺丝 DIN912](https://mobile.yangkeduo.com/search_result.html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) · M2.5x6 DIN912 socket head cap screw | эквивалент ISO/ГОСТ той же длины | стандарт и длина; нержавеющая сталь A2 (304) или сталь 8.8–12.9 — по наличию; продают пакетами по 50–100 шт. — брать пакет не меньше «Заказать» | 1 |
| 61 | Винт M2,5×8 DIN 912 (цилиндрическая головка) [Р] | 20 шт. | 2 | **22** | детали: 01.002, 07.003 — таблицы отверстий × количество деталей | [M2.5*8 内六角圆柱头螺丝 DIN912](https://mobile.yangkeduo.com/search_result.html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) · M2.5x8 DIN912 socket head cap screw | эквивалент ISO/ГОСТ той же длины | стандарт и длина; нержавеющая сталь A2 (304) или сталь 8.8–12.9 — по наличию; продают пакетами по 50–100 шт. — брать пакет не меньше «Заказать» | 1 |
| 62 | Винт M2,5×10 DIN 912 (цилиндрическая головка) [Р] | 20 шт. | 2 | **22** | детали: 02.003 — таблицы отверстий × количество деталей | [M2.5*10 内六角圆柱头螺丝 DIN912](https://mobile.yangkeduo.com/search_result.html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) · M2.5x10 DIN912 socket head cap screw | эквивалент ISO/ГОСТ той же длины | стандарт и длина; нержавеющая сталь A2 (304) или сталь 8.8–12.9 — по наличию; продают пакетами по 50–100 шт. — брать пакет не меньше «Заказать» | 1 |
| 63 | Винт M3×4 DIN 912 (цилиндрическая головка) [Р] | 48 шт. | 5 | **53** | детали: 02.002, 02.006 — таблицы отверстий × количество деталей | [M3*4 内六角圆柱头螺丝 DIN912](https://mobile.yangkeduo.com/search_result.html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) · M3x4 DIN912 socket head cap screw | эквивалент ISO/ГОСТ той же длины | стандарт и длина; нержавеющая сталь A2 (304) или сталь 8.8–12.9 — по наличию; продают пакетами по 50–100 шт. — брать пакет не меньше «Заказать» | 1 |
| 64 | Винт M3×5 DIN 912 (цилиндрическая головка) [Р] | 66 шт. | 7 | **73** | детали: 01.003, 01.004, 03.002, 03.004, 03.006, 07.012 — таблицы отверстий × количество деталей | [M3*5 内六角圆柱头螺丝 DIN912](https://mobile.yangkeduo.com/search_result.html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) · M3x5 DIN912 socket head cap screw | эквивалент ISO/ГОСТ той же длины | стандарт и длина; нержавеющая сталь A2 (304) или сталь 8.8–12.9 — по наличию; продают пакетами по 50–100 шт. — брать пакет не меньше «Заказать» | 1 |
| 65 | Винт M3×5 ISO 7380 (полукруглая головка) [Р] | 4 шт. | 1 | **5** | детали: 03.011 — таблицы отверстий × количество деталей | [M3*5 半圆头内六角螺丝 ISO7380](https://mobile.yangkeduo.com/search_result.html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) · M3x5 ISO7380 button head socket screw | эквивалент ISO/ГОСТ той же длины | стандарт и длина; нержавеющая сталь A2 (304) или сталь 8.8–12.9 — по наличию; продают пакетами по 50–100 шт. — брать пакет не меньше «Заказать» | 1 |
| 66 | Винт M3×6 DIN 7991 (потайной) [Р] | 3 шт. | 1 | **4** | детали: 01.003 — таблицы отверстий × количество деталей | [M3*6 沉头内六角螺丝 DIN7991](https://mobile.yangkeduo.com/search_result.html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) · M3x6 DIN7991 countersunk socket screw | эквивалент ISO/ГОСТ той же длины | стандарт и длина; нержавеющая сталь A2 (304) или сталь 8.8–12.9 — по наличию; продают пакетами по 50–100 шт. — брать пакет не меньше «Заказать» | 1 |
| 67 | Винт M3×6 DIN 912 (цилиндрическая головка) [Р] | 94 шт. | 10 | **104** | детали: 01.004, 02.003, 02.004, 02.010, 03.001, 04.001, 04.002, 07.001 — таблицы отверстий × количество деталей | [M3*6 内六角圆柱头螺丝 DIN912](https://mobile.yangkeduo.com/search_result.html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) · M3x6 DIN912 socket head cap screw | эквивалент ISO/ГОСТ той же длины | стандарт и длина; нержавеющая сталь A2 (304) или сталь 8.8–12.9 — по наличию; продают пакетами по 50–100 шт. — брать пакет не меньше «Заказать» | 1 |
| 68 | Винт M3×6 ISO 7380 (полукруглая головка) [Р] | 14 шт. | 2 | **16** | детали: 01.002, 01.004 — таблицы отверстий × количество деталей | [M3*6 半圆头内六角螺丝 ISO7380](https://mobile.yangkeduo.com/search_result.html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) · M3x6 ISO7380 button head socket screw | эквивалент ISO/ГОСТ той же длины | стандарт и длина; нержавеющая сталь A2 (304) или сталь 8.8–12.9 — по наличию; продают пакетами по 50–100 шт. — брать пакет не меньше «Заказать» | 1 |
| 69 | Винт M3×8 DIN 912 (цилиндрическая головка) [Р] | 14 шт. | 2 | **16** | детали: 02.006, 07.012 — таблицы отверстий × количество деталей | [M3*8 内六角圆柱头螺丝 DIN912](https://mobile.yangkeduo.com/search_result.html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) · M3x8 DIN912 socket head cap screw | эквивалент ISO/ГОСТ той же длины | стандарт и длина; нержавеющая сталь A2 (304) или сталь 8.8–12.9 — по наличию; продают пакетами по 50–100 шт. — брать пакет не меньше «Заказать» | 1 |
| 70 | Винт M3×8 ISO 7380 (полукруглая головка) [Р] | 8 шт. | 1 | **9** | детали: 01.003, 01.005 — таблицы отверстий × количество деталей | [M3*8 半圆头内六角螺丝 ISO7380](https://mobile.yangkeduo.com/search_result.html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) · M3x8 ISO7380 button head socket screw | эквивалент ISO/ГОСТ той же длины | стандарт и длина; нержавеющая сталь A2 (304) или сталь 8.8–12.9 — по наличию; продают пакетами по 50–100 шт. — брать пакет не меньше «Заказать» | 1 |
| 71 | Винт M3×10 DIN 912 (цилиндрическая головка) [Р] | 22 шт. | 3 | **25** | детали: 01.003, 01.005 — таблицы отверстий × количество деталей | [M3*10 内六角圆柱头螺丝 DIN912](https://mobile.yangkeduo.com/search_result.html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) · M3x10 DIN912 socket head cap screw | эквивалент ISO/ГОСТ той же длины | стандарт и длина; нержавеющая сталь A2 (304) или сталь 8.8–12.9 — по наличию; продают пакетами по 50–100 шт. — брать пакет не меньше «Заказать» | 1 |
| 72 | Винт M3×12 DIN 912 (цилиндрическая головка) [Р] | 10 шт. | 1 | **11** | детали: 01.001 — таблицы отверстий × количество деталей | [M3*12 内六角圆柱头螺丝 DIN912](https://mobile.yangkeduo.com/search_result.html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) · M3x12 DIN912 socket head cap screw | эквивалент ISO/ГОСТ той же длины | стандарт и длина; нержавеющая сталь A2 (304) или сталь 8.8–12.9 — по наличию; продают пакетами по 50–100 шт. — брать пакет не меньше «Заказать» | 1 |
| 73 | Гайка M2 DIN 985 (самоконтрящаяся, с нейлоновым кольцом) [Р] | 12 шт. | 2 | **14** | детали: 01.001, 04.001 — таблицы отверстий × количество деталей | [M2 尼龙防松螺母 DIN985](https://mobile.yangkeduo.com/search_result.html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) · M2 DIN985 nylon lock nut | эквивалент ISO/ГОСТ той же длины | стандарт и длина; нержавеющая сталь A2 (304) или сталь 8.8–12.9 — по наличию; продают пакетами по 50–100 шт. — брать пакет не меньше «Заказать» | 1 |
| 74 | Гайка M2,5 DIN 934 [Р] | 12 шт. | 2 | **14** | детали: 01.002 — таблицы отверстий × количество деталей | [M2.5 六角螺母 DIN934](https://mobile.yangkeduo.com/search_result.html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) · M2.5 DIN934 hex nut | эквивалент ISO/ГОСТ той же длины | стандарт и длина; нержавеющая сталь A2 (304) или сталь 8.8–12.9 — по наличию; продают пакетами по 50–100 шт. — брать пакет не меньше «Заказать» | 1 |
| 75 | Гайка M3 DIN 985 (самоконтрящаяся, с нейлоновым кольцом) [Р] | 8 шт. | 1 | **9** | детали: 01.005 — таблицы отверстий × количество деталей | [M3 尼龙防松螺母 DIN985](https://mobile.yangkeduo.com/search_result.html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) · M3 DIN985 nylon lock nut | эквивалент ISO/ГОСТ той же длины | стандарт и длина; нержавеющая сталь A2 (304) или сталь 8.8–12.9 — по наличию; продают пакетами по 50–100 шт. — брать пакет не меньше «Заказать» | 1 |
| 76 | Шайба M3 DIN 9021 (увеличенная) [Р] | 18 шт. | 2 | **20** | детали: 01.001, 01.005 — таблицы отверстий × количество деталей | [M3 加大平垫片 DIN9021](https://mobile.yangkeduo.com/search_result.html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) · M3 DIN9021 large flat washer | эквивалент ISO/ГОСТ той же длины | стандарт и длина; нержавеющая сталь A2 (304) или сталь 8.8–12.9 — по наличию; продают пакетами по 50–100 шт. — брать пакет не меньше «Заказать» | 1 |
| 77 | Стойка латунная M2 × 6 мм, мама–мама [Р] | 32 шт. | 4 | **36** | детали: 01.003, 01.004 — таблицы отверстий × количество деталей | [M2*6 双通铜柱 内内 六角铜柱](https://mobile.yangkeduo.com/search_result.html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) · M2x6 brass standoff female-female | эквивалент ISO/ГОСТ той же длины | мама–мама (双通, резьба с обеих сторон), высота 6 мм; проще — набор латунных стоек M2/M2,5/M3 с винтами | 1 |
| 78 | Втулка-проставка M2,5 × 2 мм (нейлон или латунь, гладкая) [Р] | 4 шт. | 1 | **5** | детали: 01.002 — таблицы отверстий × количество деталей | [M2.5*2 尼龙垫柱 光孔 隔离柱](https://mobile.yangkeduo.com/search_result.html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) · M2.5 2mm nylon spacer round unthreaded | эквивалент ISO/ГОСТ той же длины | гладкая (光孔), внутренний Ø под винт, высота 2 мм | 1 |
| 79 | Стойка латунная M2,5 × 6 мм, мама–мама [Р] | 12 шт. | 2 | **14** | детали: 01.004 — таблицы отверстий × количество деталей | [M2.5*6 双通铜柱 内内 六角铜柱](https://mobile.yangkeduo.com/search_result.html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) · M2.5x6 brass standoff female-female | эквивалент ISO/ГОСТ той же длины | мама–мама (双通, резьба с обеих сторон), высота 6 мм; проще — набор латунных стоек M2/M2,5/M3 с винтами | 1 |
| 80 | Стойка латунная M3 × 6 мм, мама–мама [Р] | 26 шт. | 3 | **29** | детали: 01.003, 01.004 — таблицы отверстий × количество деталей | [M3*6 双通铜柱 内内 六角铜柱](https://mobile.yangkeduo.com/search_result.html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) · M3x6 brass standoff female-female | эквивалент ISO/ГОСТ той же длины | мама–мама (双通, резьба с обеих сторон), высота 6 мм; проще — набор латунных стоек M2/M2,5/M3 с винтами | 1 |
| 81 | Вставка латунная резьбовая (вплавляемая) M2,5×4 [Р] | 12 шт. | 2 | **14** | детали: 07.011, 07.020, 07.030 — таблицы отверстий × количество деталей | [M2.5*4 热熔铜螺母 滚花 注塑](https://mobile.yangkeduo.com/search_result.html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) · M2.5x4 heat set threaded insert brass | эквивалент ISO/ГОСТ той же длины | наружный диаметр и длина: M3×5,7 — Ø4,6 под отверстие Ø4,2 в печати [Д параметры-покупных.json]; M2,5×4 — под отверстие Ø3,6; латунь, накатка | 1 |
| 82 | Вставка латунная резьбовая (вплавляемая) M3×5,7 [Р] | 47 шт. | 5 | **52** | детали: 01.001, 02.008, 03.010, 04.003, 05.003, 06.001 — таблицы отверстий × количество деталей | [M3*5.7 热熔铜螺母 滚花 注塑](https://mobile.yangkeduo.com/search_result.html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) · M3x5.7 heat set threaded insert brass | эквивалент ISO/ГОСТ той же длины | наружный диаметр и длина: M3×5,7 — Ø4,6 под отверстие Ø4,2 в печати [Д параметры-покупных.json]; M2,5×4 — под отверстие Ø3,6; латунь, накатка | 1 |
| 83 | Заклёпка вытяжная алюминиевая 3×8 [Р] | 20 шт. | 2 | **22** | детали: 02.006, 03.002, 03.004 — таблицы отверстий × количество деталей | [铝抽芯铆钉 3*8 开口型](https://mobile.yangkeduo.com/search_result.html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) · aluminum blind rivet 3x8 | эквивалент ISO/ГОСТ той же длины | стандарт и длина; нержавеющая сталь A2 (304) или сталь 8.8–12.9 — по наличию; продают пакетами по 50–100 шт. — брать пакет не меньше «Заказать» | 1 |
| 84 | Штифт цилиндрический 2×10 ISO 8734 [Р] | 1 шт. | 1 | **2** | детали: 07.033 — таблицы отверстий × количество деталей | [圆柱销 2*10 定位销 不锈钢](https://mobile.yangkeduo.com/search_result.html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) · dowel pin 2x10 ISO8734 | эквивалент ISO/ГОСТ той же длины | стандарт и длина; нержавеющая сталь A2 (304) или сталь 8.8–12.9 — по наличию; продают пакетами по 50–100 шт. — брать пакет не меньше «Заказать» | 1 |

## 8. Материалы и печать на заказ (заказ 2)

| № | Позиция | На робота | Запас | Заказать | Назначение — откуда число | Pinduoduo (поиск по запросу; англ. — для других площадок) | Замена | Проверить в карточке и при получении | Заказ |
|---|---|---|---|---|---|---|---|---|---|
| 85 | Лист алюминиевый 5052-H32 (АМг3), 1,5 мм [Р] | 0,03 м² | 0,009 | **0,039** | площадь деталей 300 см² (02.002); резка по «_раскрой.dxf» — вместе с заказом резки — масса деталей ÷ (ρ·t) | [5052 铝板 1.5mm 激光切割 定制 DXF](https://mobile.yangkeduo.com/search_result.html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) · 5052-H32 aluminum sheet 1.5mm laser cutting service from DXF | АМг3/АМг2 той же толщины | толщина ±0,15 мм, марка | 2 |
| 86 | Лист алюминиевый 5052-H32 (АМг3), 2 мм [Р] | 0,132 м² | 0,04 | **0,171** | площадь деталей 1319 см² (01.002, 01.003, 01.004, 02.006, 02.010, 03.002, 03.004, 03.006); резка по «_раскрой.dxf» — вместе с заказом резки — масса деталей ÷ (ρ·t) | [5052 铝板 2mm 激光切割 定制 DXF](https://mobile.yangkeduo.com/search_result.html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) · 5052-H32 aluminum sheet 2mm laser cutting service from DXF | АМг3/АМг2 той же толщины | толщина ±0,15 мм, марка | 2 |
| 87 | Лист алюминиевый 5052-H32 (АМг3), 2,5 мм [Р] | 0,006 м² | 0,002 | **0,009** | площадь деталей 65 см² (01.005); резка по «_раскрой.dxf» — вместе с заказом резки — масса деталей ÷ (ρ·t) | [5052 铝板 2.5mm 激光切割 定制 DXF](https://mobile.yangkeduo.com/search_result.html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) · 5052-H32 aluminum sheet 2.5mm laser cutting service from DXF | АМг3/АМг2 той же толщины | толщина ±0,15 мм, марка | 2 |
| 88 | Лист алюминиевый 5052-H32 (АМг3), 4 мм [Р] | 0,03 м² | 0,009 | **0,039** | площадь деталей 303 см² (02.003, 02.004); резка по «_раскрой.dxf» — вместе с заказом резки — масса деталей ÷ (ρ·t) | [5052 铝板 4mm 激光切割 定制 DXF](https://mobile.yangkeduo.com/search_result.html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) · 5052-H32 aluminum sheet 4mm laser cutting service from DXF | АМг3/АМг2 той же толщины | толщина ±0,15 мм, марка | 2 |
| 89 | Плита алюминиевая 5052/6061, 7 мм [Р] | 0,008 м² | 0,002 | **0,01** | площадь деталей 80 см² (02.005); резка по «_раскрой.dxf» — вместе с заказом резки — масса деталей ÷ (ρ·t) | [5052 铝板 7mm 激光切割 定制 DXF](https://mobile.yangkeduo.com/search_result.html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) · 5052-H32 aluminum sheet 7mm laser cutting service from DXF | АМг3/АМг2 той же толщины | толщина ±0,15 мм, марка | 2 |
| 90 | Труба алюминиевая 16 × 8 × 1,5 (6063) [Р] | 0,565 м | 0,057 | **0,622** | рёбра ног и рук 02.007, 03.003, 03.005 — габарит × количество | [铝方管 16x8x1.5](https://mobile.yangkeduo.com/search_result.html?search_key=%E9%93%9D%E6%96%B9%E7%AE%A1%2016x8x1.5) · aluminum rectangular tube 16x8x1.5 | 16 × 10 × 1,5 | наружный 16 × 8 мм, стенка 1,5 мм | 2 |
| 91 | Печать на заказ: PETG, деталей — 43 [Р] | 1311 г | 0 | **1311** | печатные детали робота и кистей; масса сплошным телом — с заполнением выйдет меньше — масса деталей × количество | [3D打印服务 PETG 定制 打印](https://mobile.yangkeduo.com/search_result.html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) · 3D printing service PETG custom STL | своя печать (если появится принтер) | печать по STL из папок деталей; PETG, стенки 4 периметра, заполнение 40–60 % [Д]; цена обычно за грамм или за деталь — прислать продавцу STL и таблицу «Изготовление» | 2 |
| 92 | Печать на заказ: PA-CF, деталей — 3 [Р] | 26 г | 0 | **26** | держатель жала, корпус и крышка трещотки (кисти); масса сплошным телом — с заполнением выйдет меньше — масса деталей × количество | [3D打印 碳纤维尼龙 PA-CF 定制](https://mobile.yangkeduo.com/search_result.html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) · 3D printing service PA-CF nylon carbon fiber | своя печать (если появится принтер) | PA-CF или PA12-CF; держатель жала греется — теплостойкость ≥ 150 °C [Д] | 2 |
| 93 | Печать на заказ: TPU 95A, деталей — 10 [Р] | 14 г | 0 | **14** | подошвы стоп 02.009; масса сплошным телом — с заполнением выйдет меньше — масса деталей × количество | [3D打印 TPU 软胶 定制 打印](https://mobile.yangkeduo.com/search_result.html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) · 3D printing service TPU 95A | своя печать (если появится принтер) | твёрдость 95A (или 90A) | 2 |
| 94 | Пруток стальной 40Х (или 45) Ø10 × 100 мм [Р] | 1 шт. | 0 | **1** | вал трещотки 07.031 (длина 52 мм + зажим) — чертёж 07.031 | [40Cr 圆钢 10mm](https://mobile.yangkeduo.com/search_result.html?search_key=40Cr%20%E5%9C%86%E9%92%A2%2010mm) · steel rod 40Cr / C45 10mm | заказать вал у токаря целиком | закалка до HRC ≥ 58 под муфты или закалённая втулка [Д] | 2 |
| 95 | Пруток алюминиевый Д16Т (2024) Ø16 × 60 мм [Р] | 1 шт. | 0 | **1** | втулки муфт 07.032 ×2 — чертёж 07.032 | [2024 铝棒 16mm](https://mobile.yangkeduo.com/search_result.html?search_key=2024%20%E9%93%9D%E6%A3%92%2016mm) · 2024 aluminum round bar 16mm | сталь | марка, диаметр | 2 |

## 9. Провода, кабели шин, разъёмы и расходники

| № | Позиция | На робота | Запас | Заказать | Назначение — откуда число | Pinduoduo (поиск по запросу; англ. — для других площадок) | Замена | Проверить в карточке и при получении | Заказ |
|---|---|---|---|---|---|---|---|---|---|
| 96 | Провод силиконовый 4 мм² (11–12 AWG) [Р] | 1,4 м | 0,6 | **2** | по таблице жгутов; у силовых — с обратным проводом «−» [Д] — таблица-жгутов.csv | [耐高温 硅胶线 4平方](https://mobile.yangkeduo.com/search_result.html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) · silicone wire 11–12 AWG | ПВА/МГТФ того же сечения | сечение по меди (в карточке «平方» — мм²), силикон, лужёная медь; продают метрами — выбрать длину | 1 |
| 97 | Провод силиконовый 1,0 мм² (17–18 AWG) [Р] | 2,1 м | 0,9 | **3** | по таблице жгутов; у силовых — с обратным проводом «−» [Д] — таблица-жгутов.csv | [耐高温 硅胶线 1平方](https://mobile.yangkeduo.com/search_result.html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) · silicone wire 17–18 AWG | ПВА/МГТФ того же сечения | сечение по меди (в карточке «平方» — мм²), силикон, лужёная медь; продают метрами — выбрать длину | 1 |
| 98 | Провод силиконовый 0,75 мм² (18 AWG) [Р] | 2,9 м | 1,1 | **4** | по таблице жгутов; у силовых — с обратным проводом «−» [Д] — таблица-жгутов.csv | [耐高温 硅胶线 0.75平方](https://mobile.yangkeduo.com/search_result.html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) · silicone wire 18 AWG | ПВА/МГТФ того же сечения | сечение по меди (в карточке «平方» — мм²), силикон, лужёная медь; продают метрами — выбрать длину | 1 |
| 99 | Провод силиконовый 0,5 мм² (20 AWG) [Р] | 4,2 м | 1,3 | **5,5** | по таблице жгутов; у силовых — с обратным проводом «−» [Д] — таблица-жгутов.csv | [耐高温 硅胶线 0.5平方](https://mobile.yangkeduo.com/search_result.html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) · silicone wire 20 AWG | ПВА/МГТФ того же сечения | сечение по меди (в карточке «平方» — мм²), силикон, лужёная медь; продают метрами — выбрать длину | 1 |
| 100 | Провод силиконовый 0,25 мм² (23–24 AWG) [Р] | 3,25 м | 1,25 | **4,5** | по таблице жгутов; у силовых — с обратным проводом «−» [Д] — таблица-жгутов.csv | [硅胶线 24AWG](https://mobile.yangkeduo.com/search_result.html?search_key=%E7%A1%85%E8%83%B6%E7%BA%BF%2024AWG) · silicone wire 23–24 AWG | ПВА/МГТФ того же сечения | сечение по меди (в карточке «平方» — мм²), силикон, лужёная медь; продают метрами — выбрать длину | 1 |
| 101 | Провод силиконовый 0,14 мм² (26 AWG) [Р] | 6 м | 2 | **8** | по таблице жгутов; у силовых — с обратным проводом «−» [Д] — таблица-жгутов.csv | [硅胶线 26AWG](https://mobile.yangkeduo.com/search_result.html?search_key=%E7%A1%85%E8%83%B6%E7%BA%BF%2026AWG) · silicone wire 26 AWG | ПВА/МГТФ того же сечения | сечение по меди (в карточке «平方» — мм²), силикон, лужёная медь; продают метрами — выбрать длину | 1 |
| 102 | Кабель шины Feetech, 3 жилы, 100 мм [Р] | 6 шт. | 2 | **8** | сегменты шин по таблице жгутов (К-…) — таблица-жгутов.csv | [总线舵机 3P 连接线 100mm](https://mobile.yangkeduo.com/search_result.html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) · Feetech bus servo cable 3pin 100mm | самому: провод 0,25 мм² + корпуса и контакты | разъём как у серво STS3215 (замер); у каждого серво в коробке кабель [Д] | 1 |
| 103 | Кабель шины Feetech, 3 жилы, 150 мм [Р] | 13 шт. | 3 | **16** | сегменты шин по таблице жгутов (К-…) — таблица-жгутов.csv | [总线舵机 3P 连接线 150mm](https://mobile.yangkeduo.com/search_result.html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) · Feetech bus servo cable 3pin 150mm | самому: провод 0,25 мм² + корпуса и контакты | разъём как у серво STS3215 (замер); у каждого серво в коробке кабель [Д] | 1 |
| 104 | Кабель шины Feetech, 3 жилы, 200 мм [Р] | 8 шт. | 2 | **10** | сегменты шин по таблице жгутов (К-…) — таблица-жгутов.csv | [总线舵机 3P 连接线 200mm](https://mobile.yangkeduo.com/search_result.html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) · Feetech bus servo cable 3pin 200mm | самому: провод 0,25 мм² + корпуса и контакты | разъём как у серво STS3215 (замер); у каждого серво в коробке кабель [Д] | 1 |
| 105 | Кабель шины Feetech, 3 жилы, 300 мм [Р] | 10 шт. | 2 | **12** | сегменты шин по таблице жгутов (К-…) — таблица-жгутов.csv | [总线舵机 3P 连接线 300mm](https://mobile.yangkeduo.com/search_result.html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) · Feetech bus servo cable 3pin 300mm | самому: провод 0,25 мм² + корпуса и контакты | разъём как у серво STS3215 (замер); у каждого серво в коробке кабель [Д] | 1 |
| 106 | Кабель шины Feetech, 3 жилы, 500 мм [Р] | 1 шт. | 1 | **2** | сегменты шин по таблице жгутов (К-…) — таблица-жгутов.csv | [总线舵机 3P 连接线 500mm](https://mobile.yangkeduo.com/search_result.html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) · Feetech bus servo cable 3pin 500mm | самому: провод 0,25 мм² + корпуса и контакты | разъём как у серво STS3215 (замер); у каждого серво в коробке кабель [Д] | 1 |
| 107 | Разъём XT60 (пара «папа–мама») [Д] | 3 пар | 1 | **4** | батарея, зарядка, вход силовой цепи — таблица-жгутов, детали | [XT60 插头 公母](https://mobile.yangkeduo.com/search_result.html?search_key=XT60%20%E6%8F%92%E5%A4%B4%20%E5%85%AC%E6%AF%8D) · XT60 connector pair | аналог | размер и количество | 1 |
| 108 | Клемма ножевая 6,3 мм изолированная (мама) [Д] | 10 шт. | 4 | **14** | реле K1, выключатель SA1 (W2, W4, W5 и обратные) — таблица-жгутов, детали | [6.3mm 插簧 绝缘](https://mobile.yangkeduo.com/search_result.html?search_key=6.3mm%20%E6%8F%92%E7%B0%A7%20%E7%BB%9D%E7%BC%98) · 6.3mm female spade terminal insulated | аналог | размер и количество | 1 |
| 109 | Набор разъёмов Dupont 2,54 с контактами [Д] | 1 компл. | 0 | **1** | W16, W19, W20, W22 — таблица-жгутов, детали | [杜邦 端子 套装 2.54](https://mobile.yangkeduo.com/search_result.html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) · Dupont connector kit 2.54mm | аналог | размер и количество | 1 |
| 110 | Набор разъёмов JST PH/XH 3 pin с проводами [Д] | 1 компл. | 0 | **1** | кольца и «глаз» (W17, W18), датчики — таблица-жгутов, детали | [JST XH 3P 带线 端子](https://mobile.yangkeduo.com/search_result.html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) · JST XH 3pin connector with wire kit | аналог | размер и количество | 1 |
| 111 | Корпуса JST EH 3 pin + контакты (на замену кабелям Dynamixel) [Д] | 20 шт. | 0 | **20** | если кабели X3P делать самому — таблица-жгутов, детали | [JST EH 3P 胶壳 端子](https://mobile.yangkeduo.com/search_result.html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) · JST EHR-03 housing + SEH crimp contacts | аналог | размер и количество | 1 |
| 112 | Припой с флюсом 0,8 мм + флюс [Д] | 1 компл. | 0 | **1** | пайка жгутов, блока контактов замка — таблица-жгутов, детали | [焊锡丝 0.8mm](https://mobile.yangkeduo.com/search_result.html?search_key=%E7%84%8A%E9%94%A1%E4%B8%9D%200.8mm) · solder wire 0.8mm rosin core | аналог | размер и количество | 1 |
| 113 | Эпоксидный клей двухкомпонентный [Д] | 1 шт. | 0 | **1** | рёбра, магниты, шарики, датчики Холла, балласт — таблица-жгутов, детали | [环氧树脂 AB胶](https://mobile.yangkeduo.com/search_result.html?search_key=%E7%8E%AF%E6%B0%A7%E6%A0%91%E8%84%82%20AB%E8%83%B6) · 2-part epoxy 5 min | аналог | размер и количество | 1 |
| 114 | Фиксатор резьбы средней прочности [Д] | 1 шт. | 0 | **1** | винты рогов и корпусов серво — таблица-жгутов, детали | [螺纹胶 中强度 蓝色](https://mobile.yangkeduo.com/search_result.html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) · threadlocker medium (blue) | аналог | размер и количество | 1 |
| 115 | Стяжки нейлоновые 2,5 × 100 [Д] | 100 шт. | 0 | **100** | кабели ног и рук — таблица-жгутов, детали | [尼龙扎带 2.5x100](https://mobile.yangkeduo.com/search_result.html?search_key=%E5%B0%BC%E9%BE%99%E6%89%8E%E5%B8%A6%202.5x100) · cable ties 2.5x100 | аналог | размер и количество | 1 |
| 116 | Термоусадка, набор [Д] | 1 компл. | 0 | **1** | разъёмы, пайка — таблица-жгутов, детали | [热缩管 套装](https://mobile.yangkeduo.com/search_result.html?search_key=%E7%83%AD%E7%BC%A9%E7%AE%A1%20%E5%A5%97%E8%A3%85) · heat shrink tubing kit | аналог | размер и количество | 1 |
| 117 | Липучка-ремень 20 мм × 300 мм [Д] | 2 шт. | 0 | **2** | фиксация батареи в лотке — таблица-жгутов, детали | [魔术贴 绑带 20mm](https://mobile.yangkeduo.com/search_result.html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) · velcro strap 20mm | аналог | размер и количество | 1 |
| 118 | Пенорезина самоклеящаяся 3 мм [Д] | 1 лист | 0 | **1** | прокладки, виброизоляция плат — таблица-жгутов, детали | [自粘 泡棉 3mm](https://mobile.yangkeduo.com/search_result.html?search_key=%E8%87%AA%E7%B2%98%20%E6%B3%A1%E6%A3%89%203mm) · adhesive foam 3mm | аналог | размер и количество | 1 |
| 119 | Защитная гофра / кромочная лента для кабельных проходов [Д] | 1 компл. | 0 | **1** | 9 кабельных проходов оболочки (таблица отверстий 01.001) — таблица-жгутов, детали | [波纹管 开口 保护](https://mobile.yangkeduo.com/search_result.html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) · split loom tubing / edge grommet | аналог | размер и количество | 1 |

## Изготовление по чертежам (заказ 2)

Файлы для заказа резки — `«_раскрой.dxf»` (1:1, слои КОНТУР и ОТВЕРСТИЯ), для печати — `.stl` в ориентации печати; папки: робот — `рабочая-документация/детали/`, кисти — `модули/чертежи/`.

| Обозначение | Деталь | Процесс | Материал | Шт. на робота | Масса 1 шт., г [Р] | Файл для заказа |
|---|---|---|---|---|---|---|
| КРБ.S0.01.001 | Боковая оболочка корпуса | печать | PETG, печать | 1 | 191,4 | `KRB.S0.01.001_obolochka.stl` |
| КРБ.S0.01.002 | Нижняя плита корпуса | лист | Лист алюминиевый 2 мм (S2) | 1 | 171 | `KRB.S0.01.002_plita-nizhnyaya_раскрой.dxf` |
| КРБ.S0.01.003 | Верхняя плита корпуса | лист | Лист алюминиевый 2 мм (S2) | 1 | 171,4 | `KRB.S0.01.003_plita-verhnyaya_раскрой.dxf` |
| КРБ.S0.01.004 | Полка электроники | лист | Лист алюминиевый 2 мм (S2) | 1 | 155,4 | `KRB.S0.01.004_polka-elektroniki_раскрой.dxf` |
| КРБ.S0.01.005 | Кронштейн заднего держателя контейнера (гнутый) | гнутая | Лист алюминиевый 2,5 мм, гнутый | 2 | 22,1 | `KRB.S0.01.005_razvertka_раскрой.dxf + гиб по чертежу` |
| КРБ.S0.02.001 | Уголок поворота бедра | печать | PETG, печать | 6 | 19,1 | `KRB.S0.02.001_ugolok-povorota-bedra.stl` |
| КРБ.S0.02.002 | Скоба бедра (гнутая, U) | гнутая | Лист алюминиевый 1,5 мм, гнутый | 6 | 20,2 | `KRB.S0.02.002_razvertka_раскрой.dxf + гиб по чертежу` |
| КРБ.S0.02.003 | Щека бедра | лист | Лист алюминиевый 4 мм (S4) | 10 | 32 | `KRB.S0.02.003_shcheka-bedra_раскрой.dxf` |
| КРБ.S0.02.004 | Щека бедра укороченная (передние ноги) | лист | Лист алюминиевый 4 мм (S4) | 2 | 3,6 | `KRB.S0.02.004_shcheka-bedra-korotkaya_раскрой.dxf` |
| КРБ.S0.02.005 | Перемычка колена | плита | Плита алюминиевая 7 мм (S7) | 6 | 25,1 | `KRB.S0.02.005_peremychka-kolena_раскрой.dxf` |
| КРБ.S0.02.006 | Голень | лист | Лист алюминиевый 2 мм (S2) | 6 | 13,3 | `KRB.S0.02.006_golen_раскрой.dxf` |
| КРБ.S0.02.007 | Ребро жёсткости голени (труба 16×8×1,5) | труба | Труба алюминиевая 16×8×1,5 | 6 | 9,8 | `KRB.S0.02.007_rebro-goleni.pdf (резать в размер, сверлить)` |
| КРБ.S0.02.008 | Стопа | печать | PETG, печать | 6 | 14,8 | `KRB.S0.02.008_stopa.stl` |
| КРБ.S0.02.009 | Подошва стопы (полусфера R9) | печать-TPU | TPU 95A, печать | 6 | 1,8 | `KRB.S0.02.009_podoshva.stl` |
| КРБ.S0.02.010 | Уголок колена (гнутый) | гнутая | Лист алюминиевый 2 мм, гнутый | 6 | 6,4 | `KRB.S0.02.010_razvertka_раскрой.dxf + гиб по чертежу` |
| КРБ.S0.03.001 | Площадка плеча | печать | PETG, печать | 2 | 10,1 | `KRB.S0.03.001_ploshchadka-plecha.stl` |
| КРБ.S0.03.002 | Звено плеча | лист | Лист алюминиевый 2 мм (S2) | 2 | 16,9 | `KRB.S0.03.002_zveno-plecha_раскрой.dxf` |
| КРБ.S0.03.003 | Ребро жёсткости звена плеча (труба 16×8×1,5) | труба | Труба алюминиевая 16×8×1,5 | 2 | 9,6 | `KRB.S0.03.003_rebro-plecha.pdf (резать в размер, сверлить)` |
| КРБ.S0.03.004 | Звено предплечья | лист | Лист алюминиевый 2 мм (S2) | 2 | 18,2 | `KRB.S0.03.004_zveno-predplechya_раскрой.dxf` |
| КРБ.S0.03.005 | Ребро жёсткости звена предплечья (труба 16×8×1,5) | труба | Труба алюминиевая 16×8×1,5 | 2 | 8,6 | `KRB.S0.03.005_rebro-predplechya.pdf (резать в размер, сверлить)` |
| КРБ.S0.03.006 | Пластина кисти | лист | Лист алюминиевый 2 мм (S2) | 2 | 12,9 | `KRB.S0.03.006_plastina-kisti_раскрой.dxf` |
| КРБ.S0.03.010 | Стойка плеча (кронштейн к корпусу) | печать | PETG, печать | 2 | 40,6 | `KRB.S0.03.010_stoika-plecha.stl` |
| КРБ.S0.03.011 | Уголок поворота кисти | печать | PETG, печать | 2 | 3,3 | `KRB.S0.03.011_ugolok-povorota-kisti.stl` |
| КРБ.S0.04.001 | Кожух головы | печать | PETG, печать | 1 | 89,5 | `KRB.S0.04.001_kozhuh-golovy.stl` |
| КРБ.S0.04.002 | Стойка шеи | печать | PETG, печать | 1 | 30,9 | `KRB.S0.04.002_stoika-shei.stl` |
| КРБ.S0.04.003 | Консоль шеи | печать | PETG, печать | 1 | 9,8 | `KRB.S0.04.003_konsol-shei.stl` |
| КРБ.S0.05.001 | Сменный контейнер (куб 200 мм) | печать | PETG, печать | 1 | 397,6 | `KRB.S0.05.001_konteiner.stl` |
| КРБ.S0.05.002 | Ручка-перекладина контейнера | печать | PETG, печать | 1 | 8,5 | `KRB.S0.05.002_ruchka.stl` |
| КРБ.S0.05.003 | Угловой держатель контейнера (замок вчерне) | печать | PETG, печать | 4 | 20,3 | `KRB.S0.05.003_derzhatel.stl` |
| КРБ.S0.06.001 | Лоток батареи | печать | PETG, печать | 1 | 62,9 | `KRB.S0.06.001_lotok-batarei.stl` |
| КРБ.S0.07.001 | Гнездо замка кисти | печать | PETG, печать | 2 | 7,4 | `KRB.S0.07.001_gnezdo-zamka.stl` |
| КРБ.S0.07.002 | Кольцо-байонет замка | печать | PETG, печать | 2 | 3,7 | `KRB.S0.07.002_koltso-baioneta.stl` |
| КРБ.S0.07.003 | Ответная плита кисти | печать | PETG, печать | 4 | 6,4 | `KRB.S0.07.003_otvetnaya-plita.stl` |
| КРБ.S0.07.020 | Держатель жала паяльной кисти | печать | PA-CF (нейлон с углеволокном), печать | 1 | 7,5 | `KRB.S0.07.020_derzhatel-zhala.stl` |
| КРБ.S0.07.030 | Корпус трещотки отвёрточной кисти | печать | PA-CF (нейлон с углеволокном), печать | 1 | 14,6 | `KRB.S0.07.030_korpus-treshchotki.stl` |
| КРБ.S0.07.034 | Крышка трещотки | печать | PA-CF (нейлон с углеволокном), печать | 1 | 3,8 | `KRB.S0.07.034_kryshka-treshchotki.stl` |
| КРБ.S0.07.031 | Вал трещотки с гнездом бита | точение | Сталь 40Х (или 45), точение | 1 | 12,3 | `KRB.S0.07.031_val-treshchotki.step + .pdf` |
| КРБ.S0.07.032 | Втулка обгонной муфты | точение | Алюминий Д16Т (2024), точение | 2 | 2,3 | `KRB.S0.07.032_vtulka-mufty.step + .pdf` |
| КРБ.S0.07.033 | Кольцо переключателя направления | печать | PETG, печать | 1 | 1,9 | `KRB.S0.07.033_koltso-pereklyuchatelya.stl` |
| КРБ.S0.07.035 | Распорная втулка трещотки | печать | PETG, печать | 1 | 0,6 | `KRB.S0.07.035_raspornaya-vtulka.stl` |
| КРБ.S0.07.011 | Основание захвата К1 | печать | PETG, печать | 2 | 22,8 | `KRB.S0.07.011_osnovanie-zahvata.stl` |
| КРБ.S0.07.012 | Губка захвата подвижная | печать | PETG, печать | 2 | 16,4 | `KRB.S0.07.012_gubka-podvizhnaya.stl` |
| КРБ.S0.07.013 | Накладка губки подвижной | печать-TPU | TPU 95A, печать | 2 | 0,7 | `KRB.S0.07.013_nakladka-podvizhnoi.stl` |
| КРБ.S0.07.014 | Накладка губки неподвижной | печать-TPU | TPU 95A, печать | 2 | 0,7 | `KRB.S0.07.014_nakladka-nepodvizhnoi.stl` |

## Как раскрыты строки крепежа плат [Д]

В таблицах отверстий плат записано «винт + проставка» или «винт + стойка 6». В ведомости это стойка латунная мама–мама 6 мм и второй винт M…×5 с другой стороны; «+ проставка 2 мм» — гладкая втулка 2 мм и гайка. Проще всего купить набор латунных стоек M2 / M2,5 / M3 с винтами и гайками — счёт выше показывает, сколько нужно.

## Что нашлось при сборке ведомости

1. **U2 (12 В) при разряженной батарее.** У 4S при 3,2 В на ячейку остаётся 12,8 В [Р]: понижающему преобразователю на 12 В остаётся 0,8 В. Многие модули теряют 1–2 В — тогда серво рук и поворотов бедра увидят меньше 12 В. Нужен модуль с малым падением или повышающе-понижающий (как U1). Записала в «Проверить» строки U2.
2. **INA226 с шунтом платы меряют только до 8 А** (10 мОм, предел входа 81,9 мВ), а батарея и линии серво — до 40 А. Добавлены три шунта 75 мВ / 50 А [Р].
3. **Выключатель SA1** в ред. А и Б был на 20 А при предохранителе F1 40 А: взят не меньше 40 А [Р].
4. **Датчики Холла** питаются от 3,3 В: распространённые A3144 и SS441 требуют не меньше 4,5 В и не подходят [Д: по паспортам]; выбран класс 2,5–38 В (например, DRV5023).
5. **Кисть К1 и неподвижный палец** (исправлено в этом шаге): серво захвата держалось за гладкий бок, палец 03.009 ничем не крепился — теперь лапка 4 × M2×6 и полка с 2 потайными M3×8 и гайками.
6. **Raspberry Pi 5:** все четыре USB заняты адаптерами шин (находка ред. В); если U3 не договаривается с Pi о 5 А, Pi ограничивает ток USB — проверить настройку в config.txt [Д].

## Чего нет в ведомости и что остаётся допущением

- цены и продавцы — том 15; все модули питания, батарея и разъёмы — допущения [Д] до шага 4 (токи и нагрев в симуляторе): **после шага 4 ведомость пересобрать**;
- радиомодуль mesh и задняя камера (мультиплексор или USB) — не выбраны (вопросы с ред. А); можно не брать до решения;
- комплект поставки XM430-W210-T (кабель, рог, винты) — сверить по коробке; рог и винты рогов STS3215 и ST3215-HS — в коробке серво [Д];
- инструмент — `../../S0-ведомость-узлов-v0.md`, раздел 2; дополнительно: обжимка JST EH, зенковка 90° под M3 (пальцы 03.009), ключи-шестигранники 1,5 и 2,0 мм (M2, M2,5), жало для вплавления вставок, метчики M2,5 и M3 (перемычка колена, пластина кисти), заклёпочник Ø3.
