pilot443/avad-s0/docs/bom/fasteners-and-materials.csv

раздел | позиция | на_робота | запас | заказать | ед | назначение | откуда | метка | запрос_ru | запрос_en | запрос_zh | pdd_поиск | pdd_карточка | pdd_вариант | pdd_цена | pdd_сверено | замена | проверить | заказ
7. Крепёж (по таблицам отверстий деталей робота и кистей, +10 %) | Винт M2×5 DIN 7991 (потайной) | 48 | 5 | 53 | шт. | детали: 02.002 | таблицы отверстий × количество деталей | [Р] | винт потайной DIN 7991 M2x5 | M2x5 DIN7991 countersunk socket screw | M2*5 沉头内六角螺丝 DIN7991 | https://mobile.yangkeduo.com/search_result.html |  |  |  |  | эквивалент ISO/ГОСТ той же длины | стандарт и длина; нержавеющая сталь A2 (304) или сталь 8.8–12.9 — по наличию; продают пакетами по 50–100 шт. — брать пакет не меньше «Заказать» | 1
7. Крепёж (по таблицам отверстий деталей робота и кистей, +10 %) | Винт M2×5 DIN 912 (цилиндрическая головка) | 32 | 4 | 36 | шт. | детали: 01.003, 01.004 | таблицы отверстий × количество деталей | [Р] | винт DIN 912 M2x5 | M2x5 DIN912 socket head cap screw | M2*5 内六角圆柱头螺丝 DIN912 | https://mobile.yangkeduo.com/search_result.html |  |  |  |  | эквивалент ISO/ГОСТ той же длины | стандарт и длина; нержавеющая сталь A2 (304) или сталь 8.8–12.9 — по наличию; продают пакетами по 50–100 шт. — брать пакет не меньше «Заказать» | 1
7. Крепёж (по таблицам отверстий деталей робота и кистей, +10 %) | Винт M2×6 DIN 912 (цилиндрическая головка) | 132 | 14 | 146 | шт. | детали: 01.004, 02.001, 02.010, 03.001, 03.002, 03.004, 03.010, 03.011, 04.002, 04.003, 07.011 | таблицы отверстий × количество деталей | [Р] | винт DIN 912 M2x6 | M2x6 DIN912 socket head cap screw | M2*6 内六角圆柱头螺丝 DIN912 | https://mobile.yangkeduo.com/search_result.html |  |  |  |  | эквивалент ISO/ГОСТ той же длины | стандарт и длина; нержавеющая сталь A2 (304) или сталь 8.8–12.9 — по наличию; продают пакетами по 50–100 шт. — брать пакет не меньше «Заказать» | 1
7. Крепёж (по таблицам отверстий деталей робота и кистей, +10 %) | Винт M2×8 ISO 7380 (полукруглая головка) | 12 | 2 | 14 | шт. | детали: 01.001, 04.001 | таблицы отверстий × количество деталей | [Р] | винт ISO 7380 M2x8 | M2x8 ISO7380 button head socket screw | M2*8 半圆头内六角螺丝 ISO7380 | https://mobile.yangkeduo.com/search_result.html |  |  |  |  | эквивалент ISO/ГОСТ той же длины | стандарт и длина; нержавеющая сталь A2 (304) или сталь 8.8–12.9 — по наличию; продают пакетами по 50–100 шт. — брать пакет не меньше «Заказать» | 1
7. Крепёж (по таблицам отверстий деталей робота и кистей, +10 %) | Винт M2×10 DIN 912 (цилиндрическая головка) | 4 | 1 | 5 | шт. | детали: 01.003 | таблицы отверстий × количество деталей | [Р] | винт DIN 912 M2x10 | M2x10 DIN912 socket head cap screw | M2*10 内六角圆柱头螺丝 DIN912 | https://mobile.yangkeduo.com/search_result.html |  |  |  |  | эквивалент ISO/ГОСТ той же длины | стандарт и длина; нержавеющая сталь A2 (304) или сталь 8.8–12.9 — по наличию; продают пакетами по 50–100 шт. — брать пакет не меньше «Заказать» | 1
7. Крепёж (по таблицам отверстий деталей робота и кистей, +10 %) | Винт M2,5×5 DIN 912 (цилиндрическая головка) | 12 | 2 | 14 | шт. | детали: 01.004 | таблицы отверстий × количество деталей | [Р] | винт DIN 912 M2.5x5 | M2.5x5 DIN912 socket head cap screw | M2.5*5 内六角圆柱头螺丝 DIN912 | https://mobile.yangkeduo.com/search_result.html |  |  |  |  | эквивалент ISO/ГОСТ той же длины | стандарт и длина; нержавеющая сталь A2 (304) или сталь 8.8–12.9 — по наличию; продают пакетами по 50–100 шт. — брать пакет не меньше «Заказать» | 1
7. Крепёж (по таблицам отверстий деталей робота и кистей, +10 %) | Винт M2,5×6 DIN 912 (цилиндрическая головка) | 16 | 2 | 18 | шт. | детали: 01.002, 01.004 | таблицы отверстий × количество деталей | [Р] | винт DIN 912 M2.5x6 | M2.5x6 DIN912 socket head cap screw | M2.5*6 内六角圆柱头螺丝 DIN912 | https://mobile.yangkeduo.com/search_result.html |  |  |  |  | эквивалент ISO/ГОСТ той же длины | стандарт и длина; нержавеющая сталь A2 (304) или сталь 8.8–12.9 — по наличию; продают пакетами по 50–100 шт. — брать пакет не меньше «Заказать» | 1
7. Крепёж (по таблицам отверстий деталей робота и кистей, +10 %) | Винт M2,5×8 DIN 912 (цилиндрическая головка) | 20 | 2 | 22 | шт. | детали: 01.002, 07.003 | таблицы отверстий × количество деталей | [Р] | винт DIN 912 M2.5x8 | M2.5x8 DIN912 socket head cap screw | M2.5*8 内六角圆柱头螺丝 DIN912 | https://mobile.yangkeduo.com/search_result.html |  |  |  |  | эквивалент ISO/ГОСТ той же длины | стандарт и длина; нержавеющая сталь A2 (304) или сталь 8.8–12.9 — по наличию; продают пакетами по 50–100 шт. — брать пакет не меньше «Заказать» | 1
7. Крепёж (по таблицам отверстий деталей робота и кистей, +10 %) | Винт M2,5×10 DIN 912 (цилиндрическая головка) | 20 | 2 | 22 | шт. | детали: 02.003 | таблицы отверстий × количество деталей | [Р] | винт DIN 912 M2.5x10 | M2.5x10 DIN912 socket head cap screw | M2.5*10 内六角圆柱头螺丝 DIN912 | https://mobile.yangkeduo.com/search_result.html |  |  |  |  | эквивалент ISO/ГОСТ той же длины | стандарт и длина; нержавеющая сталь A2 (304) или сталь 8.8–12.9 — по наличию; продают пакетами по 50–100 шт. — брать пакет не меньше «Заказать» | 1
7. Крепёж (по таблицам отверстий деталей робота и кистей, +10 %) | Винт M3×4 DIN 912 (цилиндрическая головка) | 48 | 5 | 53 | шт. | детали: 02.002, 02.006 | таблицы отверстий × количество деталей | [Р] | винт DIN 912 M3x4 | M3x4 DIN912 socket head cap screw | M3*4 内六角圆柱头螺丝 DIN912 | https://mobile.yangkeduo.com/search_result.html |  |  |  |  | эквивалент ISO/ГОСТ той же длины | стандарт и длина; нержавеющая сталь A2 (304) или сталь 8.8–12.9 — по наличию; продают пакетами по 50–100 шт. — брать пакет не меньше «Заказать» | 1
7. Крепёж (по таблицам отверстий деталей робота и кистей, +10 %) | Винт M3×5 DIN 912 (цилиндрическая головка) | 66 | 7 | 73 | шт. | детали: 01.003, 01.004, 03.002, 03.004, 03.006, 07.012 | таблицы отверстий × количество деталей | [Р] | винт DIN 912 M3x5 | M3x5 DIN912 socket head cap screw | M3*5 内六角圆柱头螺丝 DIN912 | https://mobile.yangkeduo.com/search_result.html |  |  |  |  | эквивалент ISO/ГОСТ той же длины | стандарт и длина; нержавеющая сталь A2 (304) или сталь 8.8–12.9 — по наличию; продают пакетами по 50–100 шт. — брать пакет не меньше «Заказать» | 1
7. Крепёж (по таблицам отверстий деталей робота и кистей, +10 %) | Винт M3×5 ISO 7380 (полукруглая головка) | 4 | 1 | 5 | шт. | детали: 03.011 | таблицы отверстий × количество деталей | [Р] | винт ISO 7380 M3x5 | M3x5 ISO7380 button head socket screw | M3*5 半圆头内六角螺丝 ISO7380 | https://mobile.yangkeduo.com/search_result.html |  |  |  |  | эквивалент ISO/ГОСТ той же длины | стандарт и длина; нержавеющая сталь A2 (304) или сталь 8.8–12.9 — по наличию; продают пакетами по 50–100 шт. — брать пакет не меньше «Заказать» | 1
7. Крепёж (по таблицам отверстий деталей робота и кистей, +10 %) | Винт M3×6 DIN 7991 (потайной) | 3 | 1 | 4 | шт. | детали: 01.003 | таблицы отверстий × количество деталей | [Р] | винт потайной DIN 7991 M3x6 | M3x6 DIN7991 countersunk socket screw | M3*6 沉头内六角螺丝 DIN7991 | https://mobile.yangkeduo.com/search_result.html |  |  |  |  | эквивалент ISO/ГОСТ той же длины | стандарт и длина; нержавеющая сталь A2 (304) или сталь 8.8–12.9 — по наличию; продают пакетами по 50–100 шт. — брать пакет не меньше «Заказать» | 1
7. Крепёж (по таблицам отверстий деталей робота и кистей, +10 %) | Винт M3×6 DIN 912 (цилиндрическая головка) | 94 | 10 | 104 | шт. | детали: 01.004, 02.003, 02.004, 02.010, 03.001, 04.001, 04.002, 07.001 | таблицы отверстий × количество деталей | [Р] | винт DIN 912 M3x6 | M3x6 DIN912 socket head cap screw | M3*6 内六角圆柱头螺丝 DIN912 | https://mobile.yangkeduo.com/search_result.html |  |  |  |  | эквивалент ISO/ГОСТ той же длины | стандарт и длина; нержавеющая сталь A2 (304) или сталь 8.8–12.9 — по наличию; продают пакетами по 50–100 шт. — брать пакет не меньше «Заказать» | 1
7. Крепёж (по таблицам отверстий деталей робота и кистей, +10 %) | Винт M3×6 ISO 7380 (полукруглая головка) | 14 | 2 | 16 | шт. | детали: 01.002, 01.004 | таблицы отверстий × количество деталей | [Р] | винт ISO 7380 M3x6 | M3x6 ISO7380 button head socket screw | M3*6 半圆头内六角螺丝 ISO7380 | https://mobile.yangkeduo.com/search_result.html |  |  |  |  | эквивалент ISO/ГОСТ той же длины | стандарт и длина; нержавеющая сталь A2 (304) или сталь 8.8–12.9 — по наличию; продают пакетами по 50–100 шт. — брать пакет не меньше «Заказать» | 1
7. Крепёж (по таблицам отверстий деталей робота и кистей, +10 %) | Винт M3×8 DIN 912 (цилиндрическая головка) | 14 | 2 | 16 | шт. | детали: 02.006, 07.012 | таблицы отверстий × количество деталей | [Р] | винт DIN 912 M3x8 | M3x8 DIN912 socket head cap screw | M3*8 内六角圆柱头螺丝 DIN912 | https://mobile.yangkeduo.com/search_result.html |  |  |  |  | эквивалент ISO/ГОСТ той же длины | стандарт и длина; нержавеющая сталь A2 (304) или сталь 8.8–12.9 — по наличию; продают пакетами по 50–100 шт. — брать пакет не меньше «Заказать» | 1
7. Крепёж (по таблицам отверстий деталей робота и кистей, +10 %) | Винт M3×8 ISO 7380 (полукруглая головка) | 8 | 1 | 9 | шт. | детали: 01.003, 01.005 | таблицы отверстий × количество деталей | [Р] | винт ISO 7380 M3x8 | M3x8 ISO7380 button head socket screw | M3*8 半圆头内六角螺丝 ISO7380 | https://mobile.yangkeduo.com/search_result.html |  |  |  |  | эквивалент ISO/ГОСТ той же длины | стандарт и длина; нержавеющая сталь A2 (304) или сталь 8.8–12.9 — по наличию; продают пакетами по 50–100 шт. — брать пакет не меньше «Заказать» | 1
7. Крепёж (по таблицам отверстий деталей робота и кистей, +10 %) | Винт M3×10 DIN 912 (цилиндрическая головка) | 22 | 3 | 25 | шт. | детали: 01.003, 01.005 | таблицы отверстий × количество деталей | [Р] | винт DIN 912 M3x10 | M3x10 DIN912 socket head cap screw | M3*10 内六角圆柱头螺丝 DIN912 | https://mobile.yangkeduo.com/search_result.html |  |  |  |  | эквивалент ISO/ГОСТ той же длины | стандарт и длина; нержавеющая сталь A2 (304) или сталь 8.8–12.9 — по наличию; продают пакетами по 50–100 шт. — брать пакет не меньше «Заказать» | 1
7. Крепёж (по таблицам отверстий деталей робота и кистей, +10 %) | Винт M3×12 DIN 912 (цилиндрическая головка) | 10 | 1 | 11 | шт. | детали: 01.001 | таблицы отверстий × количество деталей | [Р] | винт DIN 912 M3x12 | M3x12 DIN912 socket head cap screw | M3*12 内六角圆柱头螺丝 DIN912 | https://mobile.yangkeduo.com/search_result.html |  |  |  |  | эквивалент ISO/ГОСТ той же длины | стандарт и длина; нержавеющая сталь A2 (304) или сталь 8.8–12.9 — по наличию; продают пакетами по 50–100 шт. — брать пакет не меньше «Заказать» | 1
7. Крепёж (по таблицам отверстий деталей робота и кистей, +10 %) | Гайка M2 DIN 985 (самоконтрящаяся, с нейлоновым кольцом) | 12 | 2 | 14 | шт. | детали: 01.001, 04.001 | таблицы отверстий × количество деталей | [Р] | гайка самоконтрящаяся DIN 985 M2 | M2 DIN985 nylon lock nut | M2 尼龙防松螺母 DIN985 | https://mobile.yangkeduo.com/search_result.html |  |  |  |  | эквивалент ISO/ГОСТ той же длины | стандарт и длина; нержавеющая сталь A2 (304) или сталь 8.8–12.9 — по наличию; продают пакетами по 50–100 шт. — брать пакет не меньше «Заказать» | 1
7. Крепёж (по таблицам отверстий деталей робота и кистей, +10 %) | Гайка M2,5 DIN 934 | 12 | 2 | 14 | шт. | детали: 01.002 | таблицы отверстий × количество деталей | [Р] | гайка DIN 934 M2.5 | M2.5 DIN934 hex nut | M2.5 六角螺母 DIN934 | https://mobile.yangkeduo.com/search_result.html |  |  |  |  | эквивалент ISO/ГОСТ той же длины | стандарт и длина; нержавеющая сталь A2 (304) или сталь 8.8–12.9 — по наличию; продают пакетами по 50–100 шт. — брать пакет не меньше «Заказать» | 1
7. Крепёж (по таблицам отверстий деталей робота и кистей, +10 %) | Гайка M3 DIN 985 (самоконтрящаяся, с нейлоновым кольцом) | 8 | 1 | 9 | шт. | детали: 01.005 | таблицы отверстий × количество деталей | [Р] | гайка самоконтрящаяся DIN 985 M3 | M3 DIN985 nylon lock nut | M3 尼龙防松螺母 DIN985 | https://mobile.yangkeduo.com/search_result.html |  |  |  |  | эквивалент ISO/ГОСТ той же длины | стандарт и длина; нержавеющая сталь A2 (304) или сталь 8.8–12.9 — по наличию; продают пакетами по 50–100 шт. — брать пакет не меньше «Заказать» | 1
7. Крепёж (по таблицам отверстий деталей робота и кистей, +10 %) | Шайба M3 DIN 9021 (увеличенная) | 18 | 2 | 20 | шт. | детали: 01.001, 01.005 | таблицы отверстий × количество деталей | [Р] | шайба увеличенная DIN 9021 M3 | M3 DIN9021 large flat washer | M3 加大平垫片 DIN9021 | https://mobile.yangkeduo.com/search_result.html |  |  |  |  | эквивалент ISO/ГОСТ той же длины | стандарт и длина; нержавеющая сталь A2 (304) или сталь 8.8–12.9 — по наличию; продают пакетами по 50–100 шт. — брать пакет не меньше «Заказать» | 1
7. Крепёж (по таблицам отверстий деталей робота и кистей, +10 %) | Стойка латунная M2 × 6 мм, мама–мама | 32 | 4 | 36 | шт. | детали: 01.003, 01.004 | таблицы отверстий × количество деталей | [Р] | стойка латунная мама-мама M2x6 | M2x6 brass standoff female-female | M2*6 双通铜柱 内内 六角铜柱 | https://mobile.yangkeduo.com/search_result.html |  |  |  |  | эквивалент ISO/ГОСТ той же длины | мама–мама (双通, резьба с обеих сторон), высота 6 мм; проще — набор латунных стоек M2/M2,5/M3 с винтами | 1
7. Крепёж (по таблицам отверстий деталей робота и кистей, +10 %) | Втулка-проставка M2,5 × 2 мм (нейлон или латунь, гладкая) | 4 | 1 | 5 | шт. | детали: 01.002 | таблицы отверстий × количество деталей | [Р] | проставка нейлоновая M2.5x2 гладкая | M2.5 2mm nylon spacer round unthreaded | M2.5*2 尼龙垫柱 光孔 隔离柱 | https://mobile.yangkeduo.com/search_result.html |  |  |  |  | эквивалент ISO/ГОСТ той же длины | гладкая (光孔), внутренний Ø под винт, высота 2 мм | 1
7. Крепёж (по таблицам отверстий деталей робота и кистей, +10 %) | Стойка латунная M2,5 × 6 мм, мама–мама | 12 | 2 | 14 | шт. | детали: 01.004 | таблицы отверстий × количество деталей | [Р] | стойка латунная мама-мама M2.5x6 | M2.5x6 brass standoff female-female | M2.5*6 双通铜柱 内内 六角铜柱 | https://mobile.yangkeduo.com/search_result.html |  |  |  |  | эквивалент ISO/ГОСТ той же длины | мама–мама (双通, резьба с обеих сторон), высота 6 мм; проще — набор латунных стоек M2/M2,5/M3 с винтами | 1
7. Крепёж (по таблицам отверстий деталей робота и кистей, +10 %) | Стойка латунная M3 × 6 мм, мама–мама | 26 | 3 | 29 | шт. | детали: 01.003, 01.004 | таблицы отверстий × количество деталей | [Р] | стойка латунная мама-мама M3x6 | M3x6 brass standoff female-female | M3*6 双通铜柱 内内 六角铜柱 | https://mobile.yangkeduo.com/search_result.html |  |  |  |  | эквивалент ISO/ГОСТ той же длины | мама–мама (双通, резьба с обеих сторон), высота 6 мм; проще — набор латунных стоек M2/M2,5/M3 с винтами | 1
7. Крепёж (по таблицам отверстий деталей робота и кистей, +10 %) | Вставка латунная резьбовая (вплавляемая) M2,5×4 | 12 | 2 | 14 | шт. | детали: 07.011, 07.020, 07.030 | таблицы отверстий × количество деталей | [Р] | вставка латунная вплавляемая M2.5x4 | M2.5x4 heat set threaded insert brass | M2.5*4 热熔铜螺母 滚花 注塑 | https://mobile.yangkeduo.com/search_result.html |  |  |  |  | эквивалент ISO/ГОСТ той же длины | наружный диаметр и длина: M3×5,7 — Ø4,6 под отверстие Ø4,2 в печати [Д параметры-покупных.json]; M2,5×4 — под отверстие Ø3,6; латунь, накатка | 1
7. Крепёж (по таблицам отверстий деталей робота и кистей, +10 %) | Вставка латунная резьбовая (вплавляемая) M3×5,7 | 47 | 5 | 52 | шт. | детали: 01.001, 02.008, 03.010, 04.003, 05.003, 06.001 | таблицы отверстий × количество деталей | [Р] | вставка латунная вплавляемая M3x5.7 | M3x5.7 heat set threaded insert brass | M3*5.7 热熔铜螺母 滚花 注塑 | https://mobile.yangkeduo.com/search_result.html |  |  |  |  | эквивалент ISO/ГОСТ той же длины | наружный диаметр и длина: M3×5,7 — Ø4,6 под отверстие Ø4,2 в печати [Д параметры-покупных.json]; M2,5×4 — под отверстие Ø3,6; латунь, накатка | 1
7. Крепёж (по таблицам отверстий деталей робота и кистей, +10 %) | Заклёпка вытяжная алюминиевая 3×8 | 20 | 2 | 22 | шт. | детали: 02.006, 03.002, 03.004 | таблицы отверстий × количество деталей | [Р] | заклёпка вытяжная алюминиевая 3x8 | aluminum blind rivet 3x8 | 铝抽芯铆钉 3*8 开口型 | https://mobile.yangkeduo.com/search_result.html |  |  |  |  | эквивалент ISO/ГОСТ той же длины | стандарт и длина; нержавеющая сталь A2 (304) или сталь 8.8–12.9 — по наличию; продают пакетами по 50–100 шт. — брать пакет не меньше «Заказать» | 1
7. Крепёж (по таблицам отверстий деталей робота и кистей, +10 %) | Штифт цилиндрический 2×10 ISO 8734 | 1 | 1 | 2 | шт. | детали: 07.033 | таблицы отверстий × количество деталей | [Р] | штифт цилиндрический 2x10 ISO 8734 | dowel pin 2x10 ISO8734 | 圆柱销 2*10 定位销 不锈钢 | https://mobile.yangkeduo.com/search_result.html |  |  |  |  | эквивалент ISO/ГОСТ той же длины | стандарт и длина; нержавеющая сталь A2 (304) или сталь 8.8–12.9 — по наличию; продают пакетами по 50–100 шт. — брать пакет не меньше «Заказать» | 1
8. Материалы и печать на заказ (заказ 2) | Лист алюминиевый 5052-H32 (АМг3), 1,5 мм | 0,03 | 0,009 | 0,039 | м² | площадь деталей 300 см² (02.002); резка по «_раскрой.dxf» — вместе с заказом резки | масса деталей ÷ (ρ·t) | [Р] | лист алюминий 5052 1,5 мм лазерная резка по DXF | 5052-H32 aluminum sheet 1.5mm laser cutting service from DXF | 5052 铝板 1.5mm 激光切割 定制 DXF | https://mobile.yangkeduo.com/search_result.html |  |  |  |  | АМг3/АМг2 той же толщины | толщина ±0,15 мм, марка | 2
8. Материалы и печать на заказ (заказ 2) | Лист алюминиевый 5052-H32 (АМг3), 2 мм | 0,1319 | 0,0396 | 0,1715 | м² | площадь деталей 1319 см² (01.002, 01.003, 01.004, 02.006, 02.010, 03.002, 03.004, 03.006); резка по «_раскрой.dxf» — вместе с заказом резки | масса деталей ÷ (ρ·t) | [Р] | лист алюминий 5052 2 мм лазерная резка по DXF | 5052-H32 aluminum sheet 2mm laser cutting service from DXF | 5052 铝板 2mm 激光切割 定制 DXF | https://mobile.yangkeduo.com/search_result.html |  |  |  |  | АМг3/АМг2 той же толщины | толщина ±0,15 мм, марка | 2
8. Материалы и печать на заказ (заказ 2) | Лист алюминиевый 5052-H32 (АМг3), 2,5 мм | 0,0065 | 0,002 | 0,0085 | м² | площадь деталей 65 см² (01.005); резка по «_раскрой.dxf» — вместе с заказом резки | масса деталей ÷ (ρ·t) | [Р] | лист алюминий 5052 2,5 мм лазерная резка по DXF | 5052-H32 aluminum sheet 2.5mm laser cutting service from DXF | 5052 铝板 2.5mm 激光切割 定制 DXF | https://mobile.yangkeduo.com/search_result.html |  |  |  |  | АМг3/АМг2 той же толщины | толщина ±0,15 мм, марка | 2
8. Материалы и печать на заказ (заказ 2) | Лист алюминиевый 5052-H32 (АМг3), 4 мм | 0,0303 | 0,0091 | 0,0394 | м² | площадь деталей 303 см² (02.003, 02.004); резка по «_раскрой.dxf» — вместе с заказом резки | масса деталей ÷ (ρ·t) | [Р] | лист алюминий 5052 4 мм лазерная резка по DXF | 5052-H32 aluminum sheet 4mm laser cutting service from DXF | 5052 铝板 4mm 激光切割 定制 DXF | https://mobile.yangkeduo.com/search_result.html |  |  |  |  | АМг3/АМг2 той же толщины | толщина ±0,15 мм, марка | 2
8. Материалы и печать на заказ (заказ 2) | Плита алюминиевая 5052/6061, 7 мм | 0,008 | 0,0024 | 0,0104 | м² | площадь деталей 80 см² (02.005); резка по «_раскрой.dxf» — вместе с заказом резки | масса деталей ÷ (ρ·t) | [Р] | лист алюминий 5052 7 мм лазерная резка по DXF | 5052-H32 aluminum sheet 7mm laser cutting service from DXF | 5052 铝板 7mm 激光切割 定制 DXF | https://mobile.yangkeduo.com/search_result.html |  |  |  |  | АМг3/АМг2 той же толщины | толщина ±0,15 мм, марка | 2
8. Материалы и печать на заказ (заказ 2) | Труба алюминиевая 16 × 8 × 1,5 (6063) | 0,565 | 0,057 | 0,622 | м | рёбра ног и рук 02.007, 03.003, 03.005 | габарит × количество | [Р] | труба алюминиевая прямоугольная 16х8х1,5 | aluminum rectangular tube 16x8x1.5 | 铝方管 16x8x1.5 | https://mobile.yangkeduo.com/search_result.html?search_key=%E9%93%9D%E6%96%B9%E7%AE%A1%2016x8x1.5 |  |  |  |  | 16 × 10 × 1,5 | наружный 16 × 8 мм, стенка 1,5 мм | 2
8. Материалы и печать на заказ (заказ 2) | Печать на заказ: PETG, деталей — 43 | 1311 | 0 | 1311 | г | печатные детали робота и кистей; масса сплошным телом — с заполнением выйдет меньше | масса деталей × количество | [Р] | 3D печать на заказ PETG по STL | 3D printing service PETG custom STL | 3D打印服务 PETG 定制 打印 | https://mobile.yangkeduo.com/search_result.html |  |  |  |  | своя печать (если появится принтер) | печать по STL из папок деталей; PETG, стенки 4 периметра, заполнение 40–60 % [Д]; цена обычно за грамм или за деталь — прислать продавцу STL и таблицу «Изготовление» | 2
8. Материалы и печать на заказ (заказ 2) | Печать на заказ: PA-CF, деталей — 3 | 26 | 0 | 26 | г | держатель жала, корпус и крышка трещотки (кисти); масса сплошным телом — с заполнением выйдет меньше | масса деталей × количество | [Р] | 3D печать на заказ PA-CF нейлон углеволокно | 3D printing service PA-CF nylon carbon fiber | 3D打印 碳纤维尼龙 PA-CF 定制 | https://mobile.yangkeduo.com/search_result.html |  |  |  |  | своя печать (если появится принтер) | PA-CF или PA12-CF; держатель жала греется — теплостойкость ≥ 150 °C [Д] | 2
8. Материалы и печать на заказ (заказ 2) | Печать на заказ: TPU 95A, деталей — 10 | 14 | 0 | 14 | г | подошвы стоп 02.009; масса сплошным телом — с заполнением выйдет меньше | масса деталей × количество | [Р] | 3D печать на заказ TPU | 3D printing service TPU 95A | 3D打印 TPU 软胶 定制 打印 | https://mobile.yangkeduo.com/search_result.html |  |  |  |  | своя печать (если появится принтер) | твёрдость 95A (или 90A) | 2
8. Материалы и печать на заказ (заказ 2) | Пруток стальной 40Х (или 45) Ø10 × 100 мм | 1 | 0 | 1 | шт. | вал трещотки 07.031 (длина 52 мм + зажим) | чертёж 07.031 | [Р] | пруток сталь 40Х 10 мм | steel rod 40Cr / C45 10mm | 40Cr 圆钢 10mm | https://mobile.yangkeduo.com/search_result.html?search_key=40Cr%20%E5%9C%86%E9%92%A2%2010mm |  |  |  |  | заказать вал у токаря целиком | закалка до HRC ≥ 58 под муфты или закалённая втулка [Д] | 2
8. Материалы и печать на заказ (заказ 2) | Пруток алюминиевый Д16Т (2024) Ø16 × 60 мм | 1 | 0 | 1 | шт. | втулки муфт 07.032 ×2 | чертёж 07.032 | [Р] | пруток Д16Т 16 мм | 2024 aluminum round bar 16mm | 2024 铝棒 16mm | https://mobile.yangkeduo.com/search_result.html?search_key=2024%20%E9%93%9D%E6%A3%92%2016mm |  |  |  |  | сталь | марка, диаметр | 2
9. Провода, кабели шин, разъёмы и расходники | Провод силиконовый 4 мм² (11–12 AWG) | 1,4 | 0,6 | 2 | м | по таблице жгутов; у силовых — с обратным проводом «−» [Д] | таблица-жгутов.csv | [Р] | провод силиконовый 4 мм² | silicone wire 11–12 AWG | 耐高温 硅胶线 4平方 | https://mobile.yangkeduo.com/search_result.html |  |  |  |  | ПВА/МГТФ того же сечения | сечение по меди (в карточке «平方» — мм²), силикон, лужёная медь; продают метрами — выбрать длину | 1
9. Провода, кабели шин, разъёмы и расходники | Провод силиконовый 1,0 мм² (17–18 AWG) | 2,1 | 0,9 | 3 | м | по таблице жгутов; у силовых — с обратным проводом «−» [Д] | таблица-жгутов.csv | [Р] | провод силиконовый 1,0 мм² | silicone wire 17–18 AWG | 耐高温 硅胶线 1平方 | https://mobile.yangkeduo.com/search_result.html |  |  |  |  | ПВА/МГТФ того же сечения | сечение по меди (в карточке «平方» — мм²), силикон, лужёная медь; продают метрами — выбрать длину | 1
9. Провода, кабели шин, разъёмы и расходники | Провод силиконовый 0,75 мм² (18 AWG) | 2,9 | 1,1 | 4 | м | по таблице жгутов; у силовых — с обратным проводом «−» [Д] | таблица-жгутов.csv | [Р] | провод силиконовый 0,75 мм² | silicone wire 18 AWG | 耐高温 硅胶线 0.75平方 | https://mobile.yangkeduo.com/search_result.html |  |  |  |  | ПВА/МГТФ того же сечения | сечение по меди (в карточке «平方» — мм²), силикон, лужёная медь; продают метрами — выбрать длину | 1
9. Провода, кабели шин, разъёмы и расходники | Провод силиконовый 0,5 мм² (20 AWG) | 4,2 | 1,3 | 5,5 | м | по таблице жгутов; у силовых — с обратным проводом «−» [Д] | таблица-жгутов.csv | [Р] | провод силиконовый 0,5 мм² | silicone wire 20 AWG | 耐高温 硅胶线 0.5平方 | https://mobile.yangkeduo.com/search_result.html |  |  |  |  | ПВА/МГТФ того же сечения | сечение по меди (в карточке «平方» — мм²), силикон, лужёная медь; продают метрами — выбрать длину | 1
9. Провода, кабели шин, разъёмы и расходники | Провод силиконовый 0,25 мм² (23–24 AWG) | 3,25 | 1,25 | 4,5 | м | по таблице жгутов; у силовых — с обратным проводом «−» [Д] | таблица-жгутов.csv | [Р] | провод силиконовый 0,25 мм² | silicone wire 23–24 AWG | 硅胶线 24AWG | https://mobile.yangkeduo.com/search_result.html?search_key=%E7%A1%85%E8%83%B6%E7%BA%BF%2024AWG |  |  |  |  | ПВА/МГТФ того же сечения | сечение по меди (в карточке «平方» — мм²), силикон, лужёная медь; продают метрами — выбрать длину | 1
9. Провода, кабели шин, разъёмы и расходники | Провод силиконовый 0,14 мм² (26 AWG) | 6 | 2 | 8 | м | по таблице жгутов; у силовых — с обратным проводом «−» [Д] | таблица-жгутов.csv | [Р] | провод силиконовый 0,14 мм² | silicone wire 26 AWG | 硅胶线 26AWG | https://mobile.yangkeduo.com/search_result.html?search_key=%E7%A1%85%E8%83%B6%E7%BA%BF%2026AWG |  |  |  |  | ПВА/МГТФ того же сечения | сечение по меди (в карточке «平方» — мм²), силикон, лужёная медь; продают метрами — выбрать длину | 1
9. Провода, кабели шин, разъёмы и расходники | Кабель шины Feetech, 3 жилы, 100 мм | 6 | 2 | 8 | шт. | сегменты шин по таблице жгутов (К-…) | таблица-жгутов.csv | [Р] | кабель шины Feetech 3 pin 100 мм | Feetech bus servo cable 3pin 100mm | 总线舵机 3P 连接线 100mm | https://mobile.yangkeduo.com/search_result.html |  |  |  |  | самому: провод 0,25 мм² + корпуса и контакты | разъём как у серво STS3215 (замер); у каждого серво в коробке кабель [Д] | 1
9. Провода, кабели шин, разъёмы и расходники | Кабель шины Feetech, 3 жилы, 150 мм | 13 | 3 | 16 | шт. | сегменты шин по таблице жгутов (К-…) | таблица-жгутов.csv | [Р] | кабель шины Feetech 3 pin 150 мм | Feetech bus servo cable 3pin 150mm | 总线舵机 3P 连接线 150mm | https://mobile.yangkeduo.com/search_result.html |  |  |  |  | самому: провод 0,25 мм² + корпуса и контакты | разъём как у серво STS3215 (замер); у каждого серво в коробке кабель [Д] | 1
9. Провода, кабели шин, разъёмы и расходники | Кабель шины Feetech, 3 жилы, 200 мм | 8 | 2 | 10 | шт. | сегменты шин по таблице жгутов (К-…) | таблица-жгутов.csv | [Р] | кабель шины Feetech 3 pin 200 мм | Feetech bus servo cable 3pin 200mm | 总线舵机 3P 连接线 200mm | https://mobile.yangkeduo.com/search_result.html |  |  |  |  | самому: провод 0,25 мм² + корпуса и контакты | разъём как у серво STS3215 (замер); у каждого серво в коробке кабель [Д] | 1
9. Провода, кабели шин, разъёмы и расходники | Кабель шины Feetech, 3 жилы, 300 мм | 10 | 2 | 12 | шт. | сегменты шин по таблице жгутов (К-…) | таблица-жгутов.csv | [Р] | кабель шины Feetech 3 pin 300 мм | Feetech bus servo cable 3pin 300mm | 总线舵机 3P 连接线 300mm | https://mobile.yangkeduo.com/search_result.html |  |  |  |  | самому: провод 0,25 мм² + корпуса и контакты | разъём как у серво STS3215 (замер); у каждого серво в коробке кабель [Д] | 1
9. Провода, кабели шин, разъёмы и расходники | Кабель шины Feetech, 3 жилы, 500 мм | 1 | 1 | 2 | шт. | сегменты шин по таблице жгутов (К-…) | таблица-жгутов.csv | [Р] | кабель шины Feetech 3 pin 500 мм | Feetech bus servo cable 3pin 500mm | 总线舵机 3P 连接线 500mm | https://mobile.yangkeduo.com/search_result.html |  |  |  |  | самому: провод 0,25 мм² + корпуса и контакты | разъём как у серво STS3215 (замер); у каждого серво в коробке кабель [Д] | 1
9. Провода, кабели шин, разъёмы и расходники | Разъём XT60 (пара «папа–мама») | 3 | 1 | 4 | пар | батарея, зарядка, вход силовой цепи | таблица-жгутов, детали | [Д] | разъём XT60 пара | XT60 connector pair | XT60 插头 公母 | https://mobile.yangkeduo.com/search_result.html |  |  |  |  | аналог | размер и количество | 1
9. Провода, кабели шин, разъёмы и расходники | Клемма ножевая 6,3 мм изолированная (мама) | 10 | 4 | 14 | шт. | реле K1, выключатель SA1 (W2, W4, W5 и обратные) | таблица-жгутов, детали | [Д] | клемма ножевая 6,3 мм | 6.3mm female spade terminal insulated | 6.3mm 插簧 绝缘 | https://mobile.yangkeduo.com/search_result.html |  |  |  |  | аналог | размер и количество | 1
9. Провода, кабели шин, разъёмы и расходники | Набор разъёмов Dupont 2,54 с контактами | 1 | 0 | 1 | компл. | W16, W19, W20, W22 | таблица-жгутов, детали | [Д] | набор Dupont разъёмов | Dupont connector kit 2.54mm | 杜邦 端子 套装 2.54 | https://mobile.yangkeduo.com/search_result.html |  |  |  |  | аналог | размер и количество | 1
9. Провода, кабели шин, разъёмы и расходники | Набор разъёмов JST PH/XH 3 pin с проводами | 1 | 0 | 1 | компл. | кольца и «глаз» (W17, W18), датчики | таблица-жгутов, детали | [Д] | разъёмы JST XH 3 pin с проводом | JST XH 3pin connector with wire kit | JST XH 3P 带线 端子 | https://mobile.yangkeduo.com/search_result.html |  |  |  |  | аналог | размер и количество | 1
9. Провода, кабели шин, разъёмы и расходники | Корпуса JST EH 3 pin + контакты (на замену кабелям Dynamixel) | 20 | 0 | 20 | шт. | если кабели X3P делать самому | таблица-жгутов, детали | [Д] | разъём JST EH 3 pin корпус и контакты | JST EHR-03 housing + SEH crimp contacts | JST EH 3P 胶壳 端子 | https://mobile.yangkeduo.com/search_result.html |  |  |  |  | аналог | размер и количество | 1
9. Провода, кабели шин, разъёмы и расходники | Припой с флюсом 0,8 мм + флюс | 1 | 0 | 1 | компл. | пайка жгутов, блока контактов замка | таблица-жгутов, детали | [Д] | припой 0,8 мм с флюсом | solder wire 0.8mm rosin core | 焊锡丝 0.8mm | https://mobile.yangkeduo.com/search_result.html?search_key=%E7%84%8A%E9%94%A1%E4%B8%9D%200.8mm |  |  |  |  | аналог | размер и количество | 1
9. Провода, кабели шин, разъёмы и расходники | Эпоксидный клей двухкомпонентный | 1 | 0 | 1 | шт. | рёбра, магниты, шарики, датчики Холла, балласт | таблица-жгутов, детали | [Д] | эпоксидный клей 5 мин | 2-part epoxy 5 min | 环氧树脂 AB胶 | https://mobile.yangkeduo.com/search_result.html |  |  |  |  | аналог | размер и количество | 1
9. Провода, кабели шин, разъёмы и расходники | Фиксатор резьбы средней прочности | 1 | 0 | 1 | шт. | винты рогов и корпусов серво | таблица-жгутов, детали | [Д] | фиксатор резьбы средней прочности | threadlocker medium (blue) | 螺纹胶 中强度 蓝色 | https://mobile.yangkeduo.com/search_result.html |  |  |  |  | аналог | размер и количество | 1
9. Провода, кабели шин, разъёмы и расходники | Стяжки нейлоновые 2,5 × 100 | 100 | 0 | 100 | шт. | кабели ног и рук | таблица-жгутов, детали | [Д] | стяжки 2,5х100 | cable ties 2.5x100 | 尼龙扎带 2.5x100 | https://mobile.yangkeduo.com/search_result.html |  |  |  |  | аналог | размер и количество | 1
9. Провода, кабели шин, разъёмы и расходники | Термоусадка, набор | 1 | 0 | 1 | компл. | разъёмы, пайка | таблица-жгутов, детали | [Д] | термоусадка набор | heat shrink tubing kit | 热缩管 套装 | https://mobile.yangkeduo.com/search_result.html |  |  |  |  | аналог | размер и количество | 1
9. Провода, кабели шин, разъёмы и расходники | Липучка-ремень 20 мм × 300 мм | 2 | 0 | 2 | шт. | фиксация батареи в лотке | таблица-жгутов, детали | [Д] | липучка ремень 20 мм | velcro strap 20mm | 魔术贴 绑带 20mm | https://mobile.yangkeduo.com/search_result.html |  |  |  |  | аналог | размер и количество | 1
9. Провода, кабели шин, разъёмы и расходники | Пенорезина самоклеящаяся 3 мм | 1 | 0 | 1 | лист | прокладки, виброизоляция плат | таблица-жгутов, детали | [Д] | резина самоклеящаяся 3 мм | adhesive foam 3mm | 自粘 泡棉 3mm | https://mobile.yangkeduo.com/search_result.html |  |  |  |  | аналог | размер и количество | 1
9. Провода, кабели шин, разъёмы и расходники | Защитная гофра / кромочная лента для кабельных проходов | 1 | 0 | 1 | компл. | 9 кабельных проходов оболочки (таблица отверстий 01.001) | таблица-жгутов, детали | [Д] | гофра для кабеля | split loom tubing / edge grommet | 波纹管 开口 保护 | https://mobile.yangkeduo.com/search_result.html |  |  |  |  | аналог | размер и количество | 1
