pilot443/avad-s0/docs/bom/purchase-list.csv

раздел | позиция | на_робота | запас | заказать | ед | назначение | откуда | метка | запрос_ru | запрос_en | запрос_zh | pdd_поиск | pdd_карточка | pdd_вариант | pdd_цена | pdd_сверено | замена | проверить | заказ
1. Приводы и шины | Серво Feetech STS3250 (12 В, 50 кг·см) | 18 | 4 | 22 | шт. | подъём бедра ×2 и колено на каждой ноге (модель v2.6, решение С9) | таблица-серво.csv: 18 строк | [И] | серво Feetech STS3250 12 В 50 кг·см | Feetech STS3250 12V 50kg serial bus servo | 飞特 STS3250 12V 50KG 总线舵机 | https://mobile.yangkeduo.com/search_result.html | https://mobile.yangkeduo.com/goods.html?goods_id=927358986228 | ST-3250-C002 (без кронштейна, 12V 50KG) | 320 | 鸿翊电子飞特舵机工厂店 (заводской магазин Feetech); 12 В, 50 кг·см, вариант без кронштейна; цена — за серво, не за аксессуар (варианты карточки) (08.11.2026) | STS3235 (30 кг·см — пересчёт нагрузки) | вариант ST-3250-C002 (без кронштейна) или C001; 12 В; корпус 45,22 × 24,72 × 35 мм как у STS3215 (замер); магнитный энкодер, двойной вал; рог и винты в комплекте | 1
1. Приводы и шины | Серво Feetech ST3215-HS (12 В) | 6 | 2 | 8 | шт. | поворот бедра на каждой ноге | таблица-серво.csv: 6 строк | [И] | сервопривод Feetech ST3215-HS высокоскоростной 12 В | Feetech ST3215-HS high speed serial bus servo 12V | 飞特 ST3215-HS 高速 总线舵机 12V | https://mobile.yangkeduo.com/search_result.html | https://mobile.yangkeduo.com/goods.html?goods_id=953674639171 | ST3215-HS Servo Motor (единственный) | 110 | 漳州李记护具 (перепродавец Waveshare, не профильный магазин); окно вариантов в приложении: один вариант «ST3215-HS Servo Motor», ¥110 со скидкой магазина 8 ¥, «почти распродано» — нужно 8 шт., остаток проверить при заказе; запасная карточка 843868789563 — ¥121, осталось 10 шт. (09.11.2026) | STS3215 12 В — медленнее: ходьба до 14,9 см/с только с HS (опыт E2 v2.2) | 12 В, габарит 45,2 × 24,7 × 35 мм как у STS3215, двойной вал, рог и винты в комплекте; ID по умолчанию 1 | 1
1. Приводы и шины | Серво Feetech STS3215 (12 В) | 14 | 3 | 17 | шт. | руки 2 × 5, голова 2, захваты кистей К1 2 | таблица-серво.csv: 14 строк | [И] | серво шинное Feetech STS3215 12 В 30 кг·см | Feetech STS3215 12V serial bus servo 30kg magnetic encoder | 总线舵机 12V 30KG 磁编码 飞特 STS3215 ST-3215-C018 | https://mobile.yangkeduo.com/search_result.html | https://mobile.yangkeduo.com/goods.html?goods_id=982575404315 | ST-3215-C018 (1:345, 12V, 30KG) | 110 | 云驱者飞特舵机工厂店 (заводской магазин Feetech); окно вариантов в приложении: C018 12 В 30 кг — ¥110; 7,4-вольтовые C001/C044/C046 — ¥99; ¥50 на витрине — «virtual servo» (муляж), НЕ брать. Две другие карточки (1023129336070, 1024778022095) — C018 по ¥220 (09.11.2026) | Feetech ST3215 того же габарита 45,2 × 24,7 × 35 мм | напряжение 12 В (не 6–7,4 В), двойной вал, комплект рогов и винтов; резьба M2 на гранях рога и пассивного вала (замер) | 1
1. Приводы и шины | Адаптер шины Feetech (USB) | 3 | 1 | 4 | шт. | шины Н1 (ноги 1–3), Н2 (ноги 4–6), Р (руки, голова, К1) | ПЗ-01, раскладка: Н1, Н2, Р | [Д] | адаптер шины серво USB Feetech FE-URT-1 | Feetech FE-URT-1 USB bus servo adapter / Waveshare bus servo adapter | 总线舵机 USB 调试板 FE-URT-1 / 微雪 总线舵机驱动板 | https://mobile.yangkeduo.com/search_result.html | https://mobile.yangkeduo.com/goods.html?goods_id=601036887735 | URT-2 debugging board (with Type-C data cable) | 50 | 鸿翊电子商行 (магазин Feetech); окно вариантов в приложении: нужный вариант — плата URT-2 с кабелем Type-C, ¥50; второй вариант — с лишним кабелем DC5521; доставка в Казахстан бесплатная; URT-1 снят с производства (09.11.2026) | Waveshare Bus Servo Adapter (A) | 3-контактный порт, питание 6–12 В, размеры и отверстия (замер) | 1
1. Приводы и шины | Плата питания и разветвитель шин ног (ПН) | 1 | 0 | 1 | шт. | питание ног «звездой»: 6 выходов (кабель с питанием 0,5 мм² на ногу), данные от Н1 и Н2 | ПЗ-01, раскладка: ПН; шаг 4 | [Д] | плата распределения питания и разветвитель шины серво: вход 12 В, 6 выходов 3 pin | bus servo hub board with power input, 6 ports 3-pin | 总线舵机 分线板 6路 带电源输入 | https://mobile.yangkeduo.com/search_result.html |  |  |  |  | своя плата на макетке: клеммы питания + 2 × 3 разъёма | ток на выход ≥ 4 А (пик ноги 3,7 А [Р]), вход питания отдельно от адаптера, две группы данных (Н1, Н2) или две платы | 1
1. Приводы и шины | Кабель USB к адаптеру шины, 20 см | 3 | 0 | 3 | шт. | Pi 5 USB-A ×3 → Н1, Н2, Р (четвёртый USB свободен) | таблица-жгутов: W21 | [Д] | кабель USB-A на разъём адаптера, 20 см | short USB cable 20cm (USB-A to micro-USB / USB-C) | 短 USB 数据线 20cm | https://mobile.yangkeduo.com/search_result.html |  |  |  |  | кабель из комплекта адаптера | разъём со стороны адаптера (micro-USB или USB-C — по пришедшему адаптеру) | 1
2. Вычислитель, камеры и связь | Raspberry Pi 5 8 ГБ + активное охлаждение | 1 | 0 | 1 | шт. | бортовой компьютер | ЭЛ-01 | [И] | Raspberry Pi 5 8 ГБ с активным охлаждением | Raspberry Pi 5 8GB + official Active Cooler | 树莓派5 8G 主动散热器 | https://mobile.yangkeduo.com/search_result.html | https://mobile.yangkeduo.com/goods.html?goods_id=697484512180 | Motherboard (только плата) + 8G | 1519 | продавец с 830 продажами (имя магазина не считано); окно вариантов в приложении: плата 8 ГБ — ¥1519, осталось 3 шт.; в карточке 567534895316 «Pi5/8GB Motherboard only» — ¥1739. Кулер (Active Cooler) в вариант не входит — отдельной позицией. Цены Pi 5 в 2026 г. высокие [Д: рост цен на память]; 4 ГБ — от ¥1289 (567534895316) (09.11.2026) | Orange Pi 5 (другие отверстия — пересчёт) | версия 8 ГБ, отверстия 58 × 49 мм, высота кулера; без питания 5 В 5 А по PD Pi 5 ограничивает ток USB — в config.txt параметр usb_max_current_enable [Д: сверить с документацией Raspberry Pi] | 1
2. Вычислитель, камеры и связь | microSD 64 ГБ A2 | 1 | 1 | 2 | шт. | система + запасная с копией | — | [Д] | microSD 64 ГБ A2 | microSD 64GB A2 | 存储卡 A2 64G | https://mobile.yangkeduo.com/search_result.html?search_key=%E5%AD%98%E5%82%A8%E5%8D%A1%20A2%2064G |  |  |  |  | 128 ГБ A2 | скорость A2, подлинность | 1
2. Вычислитель, камеры и связь | Raspberry Pi Pico | 1 | 1 | 2 | шт. | плата ввода-вывода: цепь остановки, ШИМ нагрева, АЦП опознавания кистей, датчики Холла | раскладка: Pico | [И] | Raspberry Pi Pico | Raspberry Pi Pico (RP2040) | 树莓派 Pico | https://mobile.yangkeduo.com/search_result.html?search_key=%E6%A0%91%E8%8E%93%E6%B4%BE%20Pico | https://mobile.yangkeduo.com/goods.html?goods_id=1011355278811 | RP2040 development board (или с впаянными штырями — ¥50) | 38 | —; Raspberry Pi Pico с оригинальным RP2040, без Type-C (не клон Pico2040); по фото сверить micro-USB и размер 51 × 21 мм; нужно 2 шт. [окно вариантов в приложении, пакет 4, 09.11.2026] (09.11.2026) | Pico H / Pico 2 | размеры 51 × 21 мм, отверстия 47 × 11,4 мм; три входа АЦП (опознавание двух кистей) | 1
2. Вычислитель, камеры и связь | Камера Raspberry Pi Camera Module 3 Wide | 3 | 0 | 3 | шт. | две на голове, одна сзади | ПЗ-01: W23–W25 | [И] | камера Raspberry Pi Camera Module 3 Wide | Raspberry Pi Camera Module 3 Wide | 树莓派 摄像头 Module 3 广角 | https://mobile.yangkeduo.com/search_result.html | https://mobile.yangkeduo.com/goods.html?goods_id=493013940854 | Module 3 wide | 269 | —; окно вариантов: Camera Module 3 / NoIR / wide / NoIR wide — у всех ¥269; брать «Module 3 wide» (не NoIR); нужно 3 шт.; «почти распродано» [окно вариантов в приложении, пакет 09.11.2026] (09.11.2026) | Module 3 стандартная (другой угол) | вариант Wide, отверстия 21 × 12,5 | 1
2. Вычислитель, камеры и связь | Шлейф-переходник 22→15 контактов, 300 мм | 3 | 0 | 3 | шт. | Pi 5 — 22 контакта 0,5 мм, камера — 15 контактов 1 мм | таблица-жгутов: W23–W25 | [И] | шлейф-переходник 22→15 контактов для Raspberry Pi 5 (300 мм) | Raspberry Pi 5 camera adapter cable 22-pin to 15-pin 300mm | 树莓派5 摄像头 转接线 22转15 300mm | https://mobile.yangkeduo.com/search_result.html | https://mobile.yangkeduo.com/goods.html?goods_id=846031170691 | 300mm | 22 | —; 22 → 15 контактов для Pi 5, варианты 200/300/500 мм по ¥22; в заголовке «DSI» — по фото проверить, что шлейф для камеры (CSI), контакты как у штатного камерного [окно вариантов в приложении, пакет 2, 09.11.2026] (09.11.2026) | 200 мм (если трасса короче) | 22 контакта 0,5 мм со стороны Pi, 15 контактов 1 мм со стороны камеры | 1
2. Вычислитель, камеры и связь | Мультиплексор камер CSI для Pi 5 | 1 | 0 | 1 | шт. | третья (задняя) камера при двух разъёмах CSI | W25 [Д: вопрос Ивану с ред. А] | [Д] | мультиплексор камер CSI для Raspberry Pi 5 (Arducam) | Arducam camera multiplexer CSI Raspberry Pi 5 | Arducam 多路 摄像头 扩展板 树莓派5 | https://mobile.yangkeduo.com/search_result.html |  |  |  |  | USB-камера сзади (другая посадка) | совместимость с Pi 5 (22 контакта), питание, размер платы | 1
2. Вычислитель, камеры и связь | Антенна 2,4 ГГц SMA | 2 | 0 | 2 | шт. | на голове | ред. А | [Д] | антенна 2,4 ГГц SMA/IPEX хлыст | 2.4GHz antenna SMA 2dBi | 2.4G 天线 SMA 全向 | https://mobile.yangkeduo.com/search_result.html |  |  |  |  | любая 2,4 ГГц | разъём совпадает с радиомодулем | 1
2. Вычислитель, камеры и связь | Радиомодуль mesh 2,4 ГГц | 1 | 0 | 1 | шт. | к антеннам на голове — модуль не выбран | находка ред. А | [Д] | радиомодуль 2,4 ГГц для mesh-связи с двумя антеннами | 2.4GHz mesh radio module dual antenna (ESP32/nRF) | 2.4G mesh 无线 模块 双天线 | https://mobile.yangkeduo.com/search_result.html |  |  |  |  | Wi-Fi Pi 5 (без mesh) | модуль не выбран (находка ред. А): до решения Ивана можно не брать | 1
3. Питание и безопасность | Батарея Li-ion 4S4P 18650 с BMS 40 А и XT60 | 1 | 0 | 1 | шт. | ≈ 164 Вт·ч [Р], 68 × 160 × 38 мм; ЛИТИЙ — только после проверки у карго | параметры: батарея_4S4P | [Д] | аккумуляторная сборка Li-ion 4S4P 18650 14,8 В с BMS 40 А и XT60 | 4S4P 18650 Li-ion battery pack 14.8V with BMS 40A XT60 | 14.8V 18650 锂电池组 4串4并 带保护板 40A XT60 | https://mobile.yangkeduo.com/search_result.html |  |  |  |  | собрать из 16 ячеек 18650 + BMS 4S 40 А (только с точечной сваркой) | ЗАКАЗ ТОЛЬКО ПОСЛЕ ПРОВЕРКИ У КАРГО; габарит ≤ 68 × 160 × 38 мм (лоток 06.001); ток BMS ≥ 40 А; балансировочный разъём; ёмкость по факту | 1
3. Питание и безопасность | Зарядное устройство 4S 16,8 В 2 А | 1 | 0 | 1 | шт. | заряд под присмотром, в мешке | — | [Д] | зарядное устройство Li-ion 4S 16,8 В 2 А с XT60 | 4S Li-ion 16.8V 2A charger XT60 | 16.8V 锂电池 充电器 4串 2A XT60 | https://mobile.yangkeduo.com/search_result.html | https://mobile.yangkeduo.com/goods.html?goods_id=1004903975829 | 16.8V2A [5.5mm interface, 1-meter cable] | 26,8 | —; 16,8 В 2 А (не 12,6 В); выход — штекер 5,5 мм: нужен переходник на разъём зарядки батареи (XT60) [Д] [окно вариантов в приложении, пакет 2, 09.11.2026] (09.11.2026) | балансное зарядное (B6 и подобные) | 16,8 В (не 12,6 В!), заряд только под присмотром | 1
3. Питание и безопасность | Огнеупорный мешок для литиевых батарей | 1 | 0 | 1 | шт. | хранение и заряд | — | [Д] | огнеупорный мешок для литиевых батарей | LiPo fireproof bag | 锂电池 防火防爆袋 | https://mobile.yangkeduo.com/search_result.html |  |  |  |  | металлический ящик | размер под пакет 68 × 160 × 38 | 1
3. Питание и безопасность | Преобразователи U2.1–U2.7: 12 В 5 А, повышающе-понижающие | 7 | 1 | 8 | шт. | питание серво: U2.1–U2.6 — по ноге (пик 3,7 А), U2.7 — руки, голова, К1 (до 1,7 А) [Р шаг 4] | решение С10; раскладка: U2.1, U2.2, U2.3, U2.4, U2.5, U2.6, U2.7 — платы BB3210 33 × 22 × 9 мм под верхней плитой | [Р] | повышающе-понижающая плата BB3210, 12 В, до 8 А | BB3210 buck-boost module 8A, 5-26V to 12V | BB3210 升降压 8A 5-26V转12V 模块 | https://mobile.yangkeduo.com/search_result.html | https://mobile.yangkeduo.com/goods.html?goods_id=1027174841859 | 黑BB3210升降压8A 5-26V转【12V】 (чёрная BB3210, вход 5–26 В → 12 В) | 59,4 | —; окно вариантов в приложении: плата BB3210 без корпуса, автоматический повышающе-понижающий, вход 5–26 В (батарея 12,8–16,8 В — в пределах), выход фиксированный 12 В, до 8 А (нужно 3,7 А пик на ногу [Р шаг 4]) — ¥59,4 за шт., нужно 7 + 1. Размер платы в карточке не прочитан [Д] — нужен для раскладки. Запасной: ZK-5KX 891252918281 ¥63,8 (с дисплеем, крупнее); модуль в алюминиевом корпусе 995827236394 ¥78 — отвергнут по размеру (09.11.2026) | повышающе-понижающий 12 В | вход 5–26 В (батарея 12,8–16,8 В), выход 12 В, до 8 А (без радиатора — до 6 А); плата 33 × 22 × 9 мм, 2 отв. Ø3 через 27,4 мм [И карточка BB3210] | 1
3. Питание и безопасность | Преобразователь U3: 5 В 5 А с USB-C (Pi 5) | 1 | 0 | 1 | шт. | преобразователь 16,8→5 В (U3) | раскладка: U3 (50 × 25 мм) | [Д] | понижающий DC-DC 5 В 5 А с USB-C для Raspberry Pi 5 (вход до 17 В) | 12V-24V to 5V 5A buck converter USB-C for Raspberry Pi 5 | 12V转5V 5A 降压模块 树莓派5 USB-C | https://mobile.yangkeduo.com/search_result.html | https://mobile.yangkeduo.com/goods.html?goods_id=974154056910 | 5V5A output step-down power module | 46 | —; понижающий 5 В 5 А, вход широкий (до 60 В) — подходит под 12,8–16,8 В; выхода USB-C нет — питание Pi 5 через контакты 5V GPIO или короткий провод с USB-C [Д] [окно вариантов в приложении, пакет 2, 09.11.2026] (09.11.2026) | любой DC-DC 5 В ≥ 5 А | 5,1 В на выходе под нагрузкой, вход до 17 В, размеры 50 × 25 мм | 1
3. Питание и безопасность | Преобразователь U4: 12 В 0,5 А (цепь остановки) | 1 | 0 | 1 | шт. | стабилизатор 12 В 0,5 А цепи остановки (U4) | раскладка: U4 (25 × 15 мм) | [Д] | понижающий модуль 12 В 0,5–1 А (мини) | mini buck converter 12V 1A | 迷你 降压模块 12V 1A | https://mobile.yangkeduo.com/search_result.html | https://mobile.yangkeduo.com/goods.html?goods_id=989083061766 | 6-35V to 12V2A, white shell | 25,88 | —; стабилизатор «12 В → 12 В»: вход 6–35 В, выход 12 В 2 А — держит 12 В и при 12,8 В батареи, и при 16,8 В; ток с запасом (нужно 0,5 А) [окно вариантов в приложении, пакет 3, 09.11.2026] (09.11.2026) | линейный стабилизатор 7812 на радиаторе | катушка реле 12 В срабатывает и при 9–10 В [Д: паспорт реле], поэтому подходит любой мини-модуль | 1
3. Питание и безопасность | Реле 12 В 40 А с колодкой (K1) | 1 | 0 | 1 | шт. | силовой разрыв обеих линий серво и нагрева при остановке | раскладка: K1 | [Д] | автомобильное реле 12 В 40 А с колодкой | automotive relay 12V 40A with socket | 汽车继电器 12V 40A 带底座 | https://mobile.yangkeduo.com/search_result.html | https://mobile.yangkeduo.com/goods.html?goods_id=983237928761 | 40A12V 4-pin relay + base with cable | 27 | —; окно вариантов: 12 В 40 А, 4 вывода, с колодкой и проводами — ¥27; не путать с 24 В и 80 А [окно вариантов в приложении, пакет 09.11.2026] (09.11.2026) | твердотельное реле ≥ 40 А DC | катушка 12 В, ток контактов ≥ 40 А | 1
3. Питание и безопасность | Блок предохранителей ATO на 6 мест | 1 | 0 | 1 | шт. | F1–F5 | раскладка: предохранители | [Д] | блок предохранителей на 6 мест ATO/ATC | 6-way ATO/ATC blade fuse block | 6路 汽车 保险丝盒 ATO | https://mobile.yangkeduo.com/search_result.html |  |  |  |  | отдельные держатели | 5 мест заняты (F1–F5), 1 — резерв | 1
3. Питание и безопасность | Предохранители ATO: 40 А ×1, 10 А ×3, 5 А ×1 | 5 | 5 | 10 | шт. | F1 батарея, F2 ноги 1–3, F3 ноги 4–6, F4 руки и голова, F5 нагрев жала | ПЗ-01, таблица-жгутов: W1, W8–W11; шаг 4 | [Р] | предохранители ATO 40, 20, 10, 5 А | ATO blade fuses 40A 20A 10A 5A | 汽车 插片 保险丝 40A 20A 10A 5A | https://mobile.yangkeduo.com/search_result.html |  |  |  |  | мини-ножевые | номиналы по схеме ПЗ-01 | 1
3. Питание и безопасность | Выключатель SA1 ≥ 40 А + розетка XT60 на панель | 1 | 0 | 1 | компл. | главный выключатель и зарядный разъём | W2–W3 | [Д] | выключатель 40 А на панель + розетка XT60 на панель | panel switch 40A DC + XT60 female panel mount | 大电流 开关 40A 直流 · XT60 母座 面板 | https://mobile.yangkeduo.com/search_result.html |  |  |  |  | выключатель батареи (кнопка-ключ) | ток не меньше предохранителя F1 40 А [Р]; отверстие под панель | 1
3. Питание и безопасность | Ключ-выключатель SA2 Ø19 | 1 | 0 | 1 | шт. | ключ у человека: замыкает цепь катушки K1 | ПЗ-01 | [Д] | ключ-выключатель Ø19 (замок) | key switch 19mm panel mount 2 position | 钥匙开关 19mm 两档 | https://mobile.yangkeduo.com/search_result.html |  |  |  |  | тумблер с фиксатором (хуже) | ключ вынимается в положении «выкл» | 1
3. Питание и безопасность | Аварийная кнопка-гриб SB1 Ø22, NC, с фиксацией | 1 | 0 | 1 | шт. | рвёт цепь катушки K1 независимо от компьютера | ПЗ-01 | [Д] | кнопка аварийной остановки грибок Ø22 с фиксацией NC | emergency stop mushroom button 22mm latching NC | 急停开关 蘑菇头 22mm 自锁 常闭 | https://mobile.yangkeduo.com/search_result.html | https://mobile.yangkeduo.com/goods.html?goods_id=1023586860024 | 1 normally open, 1 normally closed (используется NC) | 28,38 | —; LA38, металл, отверстие 22 мм, 10 А; варианты контактов: 1NO+1NC или 2NC — подходят оба (в схеме нужен NC); фиксация — проверить на фото карточки [окно вариантов в приложении, пакет 09.11.2026] (09.11.2026) | любая NC 22 мм | нормально замкнутая цепь, шляпка Ø30 | 1
3. Питание и безопасность | Модуль MOSFET-ключа VT1 для катушки реле | 1 | 1 | 2 | шт. | программный разрыв по сигналу Pico (сам включить цепь не может) | ПЗ-01 | [Д] | модуль MOSFET-ключа для катушки реле (логика 3,3 В) | MOSFET switch module logic level 3.3V | MOS 管 驱动 模块 3.3V 逻辑 | https://mobile.yangkeduo.com/search_result.html | https://mobile.yangkeduo.com/goods.html?goods_id=999275542071 | YYNMOS-1 Single-channel 3-5V signal trigger | 18 | —; одноканальный, управление 3–5 В — подходит к 3,3 В Pico; ¥18 [окно вариантов в приложении, пакет 2, 09.11.2026] (09.11.2026) | оптопара + транзистор | ключ разрывает цепь катушки при пропадании сигнала Pico (отказ в безопасное состояние) | 1
3. Питание и безопасность | Модуль INA226 | 3 | 1 | 4 | шт. | батарея, ноги, руки и голова | раскладка: INA1–INA3 | [Д] | модуль INA226 ток/напряжение (I²C) | INA226 current voltage power monitor module | INA226 电流电压功率监测模块 | https://mobile.yangkeduo.com/search_result.html | https://mobile.yangkeduo.com/goods.html?goods_id=882129380400 | INA226 module with straight-pin terminals already soldered | 19,18 | —; окно вариантов: INA226 (не INA228), с впаянными штырями — ¥19,18; нужно 4 шт.; шунт платы — проверить номинал (внешний шунт 75 мВ — отдельной позицией) [окно вариантов в приложении, пакет 09.11.2026] (09.11.2026) | INA228 | шунт на плате обычно 10 мОм — до 8 А; для линий до 40 А — внешний шунт (строка ниже) | 1
3. Питание и безопасность | Шунт 75 мВ 50 А | 3 | 0 | 3 | шт. | к INA226: токи линий до 40 А (шунт платы 10 мОм — только до 8 А) | находка шага 3 [Р] | [Р] | шунт 75 мВ 50 А | DC shunt 75mV 50A | 分流器 75mV 50A | https://mobile.yangkeduo.com/search_result.html?search_key=%E5%88%86%E6%B5%81%E5%99%A8%2075mV%2050A |  |  |  |  | шунт 2 мОм 3 Вт | 75 мВ / 50 А = 1,5 мОм: при 50 А на входе INA226 75 мВ — в пределах 81,9 мВ [Р] | 1
3. Питание и безопасность | Плата нагрева жала A1 (MOSFET + усилитель термопары) | 1 | 0 | 1 | шт. | паяльная кисть К2-2; питание 12 В через F5 (23 Вт) | раскладка: A1 | [Д] | плата управления жалом TS100 (MOSFET + усилитель термопары), своя или готовая | TS100 tip driver board MOSFET + thermocouple amplifier | TS100 烙铁头 驱动板 热电偶 放大 | https://mobile.yangkeduo.com/search_result.html |  |  |  |  | своя на макетке: MOSFET logic-level ≥ 5 А + ОУ | питание 12 В (ред. Г), ШИМ 3,3 В от Pico; нагреватель и термопара жала на одних проводах — мерить в паузе ШИМ [Д] | 1
3. Питание и безопасность | Набор резисторов 0,25 Вт | 1 | 0 | 1 | компл. | опознавание кистей 1 / 3,3 / 10 кОм, подтяжки 10 кОм (АЦП, датчики Холла) | ТБ-03 | [Р] | набор резисторов 0,25 Вт | 1/4W resistor kit | 1/4W 电阻 套装 | https://mobile.yangkeduo.com/search_result.html |  |  |  |  | SMD 0805 | есть 1 кОм, 3,3 кОм, 10 кОм, 33 кОм (опознавание кистей, подтяжки) | 1
4. Датчики, индикация, звук | Инерциальный датчик BNO055 | 1 | 0 | 1 | шт. | ориентация корпуса | раскладка: BNO | [И] | датчик BNO055 | Adafruit BNO055 9-DOF orientation sensor | BNO055 九轴 姿态传感器 | https://mobile.yangkeduo.com/search_result.html | https://mobile.yangkeduo.com/goods.html?goods_id=952718708433 | Adafruit ID 2472 | 358 | —; оригинал Adafruit 2472 — плата 20 × 27 мм, как в чертеже; дорого и осталась 1 шт.; дешёвые клоны другого размера — не проверены [окно вариантов в приложении, пакет 2, 09.11.2026] (09.11.2026) | BNO085 | 20 × 27 мм, отверстия 20 × 12 мм | 1
4. Датчики, индикация, звук | Светодиодное кольцо WS2812B Ø44 (16 LED) | 2 | 0 | 2 | шт. | вокруг камер головы | ред. А | [Д] | светодиодное кольцо WS2812B 16 диодов Ø44 | WS2812B 16 LED ring 44mm | WS2812B 灯环 16位 外径44mm | https://mobile.yangkeduo.com/search_result.html | https://mobile.yangkeduo.com/goods.html?goods_id=822989556007 | 16-bit (white round) | 12,35 | —; окно вариантов: кольцо 16 светодиодов WS2812B 5050 — ¥12,35; наружный диаметр в карточке не указан — стандарт для 16 LED ≈ 44 мм [Д], проверить на фото [окно вариантов в приложении, пакет 09.11.2026] (09.11.2026) | кольцо 12 LED | наружный диаметр 44 мм, 5 В | 1
4. Датчики, индикация, звук | Центральный «глаз» Ø28 (RGB-модуль) | 1 | 0 | 1 | шт. | по решению Ивана Б5 | ред. А | [Д] | круглая LED-матрица Ø28 (центральный «глаз») | 28mm round RGB LED module WS2812B | WS2812B 圆形 灯板 28mm | https://mobile.yangkeduo.com/search_result.html |  |  |  |  | кольцо 24 LED | диаметр, 5 В — состав модуля не утверждён (вопрос Ивану Б5) | 1
4. Датчики, индикация, звук | Усилитель MAX98357A | 1 | 0 | 1 | шт. | звук | раскладка: усилитель | [И] | усилитель I2S MAX98357A | Adafruit MAX98357A I2S class-D amp | MAX98357 功放 模块 | https://mobile.yangkeduo.com/search_result.html | https://mobile.yangkeduo.com/goods.html?goods_id=1027332218929 | MAX98357（焊接好排针）— с впаянными штырями | 26,31 | —; окно вариантов: модуль MAX98357 I2S — ¥26,31; осталось 2 шт. (нужен 1) [окно вариантов в приложении, пакет 09.11.2026] (09.11.2026) | аналог на том же чипе | 19,4 × 17,8 мм | 1
4. Датчики, индикация, звук | Динамик 3 Вт 4 Ом 30 × 30 × 10 | 2 | 0 | 2 | шт. | на нижней плите, звук вниз | ред. А | [Д] | динамик 3 Вт 4 Ом квадратный 30 мм | 3W 4 ohm speaker 30mm | 3W 4欧 扬声器 30mm 方形 | https://mobile.yangkeduo.com/search_result.html | https://mobile.yangkeduo.com/goods.html?goods_id=1015465630540 | 30MM-4Ω 3W-1.25 plug | 6,8 | —; круглый динамик в корпусе Ø30 мм, 4 Ом 3 Вт, разъём 1,25 мм; ¥6,8 со скидкой 3,2 ¥; крепления 24 × 24 в чертеже нет — крепить на клей или скобу [Д] [окно вариантов в приложении, пакет 4, 09.11.2026] (09.11.2026) | любой 3 Вт 4 Ом ≤ 30 × 30 × 10 мм | размеры, крепёжные отверстия | 1
5. Замок и сменные кисти (покупные) | Шарик стальной Ø5 (подшипниковый) | 6 | 2 | 8 | шт. | К0: кинематическая посадка, 3 на гнездо | ведомость-кисти-S0.json | [Д] | шарик стальной Ø5 (подшипниковый, G10) | 5mm steel bearing balls G10 | 5mm 钢珠 轴承钢 | https://mobile.yangkeduo.com/search_result.html |  |  |  |  | — | размеры по чертежам кистей (РД ред. Г); опыты К1–К4 до сборки | 1
5. Замок и сменные кисти (покупные) | Магнит NdFeB Ø6 × 3, N42 | 6 | 2 | 8 | шт. | К0: прижим кисти, 3 на гнездо | ведомость-кисти-S0.json | [Д] | магнит неодимовый Ø6 × 3 N42 | neodymium magnet 6x3mm N42 | 钕铁硼 强磁 圆片 6x3 N42 | https://mobile.yangkeduo.com/search_result.html |  |  |  |  | — | размеры по чертежам кистей (РД ред. Г); опыты К1–К4 до сборки | 1
5. Замок и сменные кисти (покупные) | Шайба стальная Ø6 × 1 (или вырубка из листа 1 мм) | 12 | 3 | 15 | шт. | К0: против магнитов, 3 на плиту | ведомость-кисти-S0.json | [Д] | шайба стальная Ø6 × 1 (или вырубка из листа 1 мм) | steel disc 6x1mm | 铁片 圆片 6x1mm | https://mobile.yangkeduo.com/search_result.html |  |  |  |  | — | размеры по чертежам кистей (РД ред. Г); опыты К1–К4 до сборки | 1
5. Замок и сменные кисти (покупные) | Пружинный контакт (pogo) Ø1,0, ход 1 мм, шаг 2,0 — блок 2 × 4 на плате | 2 | 1 | 3 | шт. | К0: 8 контактов на гнездо | ведомость-кисти-S0.json | [Д] | пружинные контакты pogo 2 × 4, шаг 2,0 мм | pogo pin connector 2x4 2.0mm pitch | 弹簧顶针 连接器 2x4 2.0mm 间距 | https://mobile.yangkeduo.com/search_result.html | https://mobile.yangkeduo.com/goods.html?goods_id=958319293280 | SW03874C-8P-Double row-2.0-10.0MM (5 шт. в упаковке) | 19,6 | —; двухрядный блок 8 контактов, шаг 2,0 мм — как в чертеже замка; высота 10 мм и ход — сверить с гнездом 07.001 по фото карточки [Д]; ¥19,6 за 5 блоков (нужно 3) [окно вариантов в приложении, пакет 3, 09.11.2026] (09.11.2026) | — | размеры по чертежам кистей (РД ред. Г); опыты К1–К4 до сборки | 1
5. Замок и сменные кисти (покупные) | Контактная плата 8 × 4 мм, 8 площадок (своя, FR4 0,8–1,0) | 4 | 0 | 4 | шт. | К0: на каждую ответную плиту | ведомость-кисти-S0.json | [Д] | стеклотекстолит двусторонний 1,0 мм (или заказ платы 8 × 4 мм) | double sided FR4 copper clad 1.0mm / PCB order | 双面 覆铜板 1.0mm / PCB 打样 | https://mobile.yangkeduo.com/search_result.html |  |  |  |  | — | размеры по чертежам кистей (РД ред. Г); опыты К1–К4 до сборки | 1
5. Замок и сменные кисти (покупные) | Датчик Холла цифровой, 3,3 В, TO-92S (порог 7–40 мТл) | 2 | 1 | 3 | шт. | К0: «замок закрыт», 1 на гнездо; поле в «закрыто» ≥ 65 мТл, в «открыто» ≤ 4,9 мТл | ведомость-кисти-S0.json | [Р]/[Д] | датчик Холла цифровой 3,3 В TO-92 однополярный (например, TI DRV5023) | digital Hall effect switch 3.3V TO-92 unipolar (e.g. TI DRV5023) | 霍尔开关 3.3V TO-92 单极 DRV5023 | https://mobile.yangkeduo.com/search_result.html |  |  |  |  | всеполярный (omnipolar) — тогда полюс магнита не важен | питание от 3,3 В (A3144 и SS441 требуют 4,5 В — не подходят); порог 7–40 мТл [Р: в «закрыто» ≥ 65, в «открыто» ≤ 4,9 мТл]; выход открытый сток — подтяжка 10 кОм | 1
5. Замок и сменные кисти (покупные) | Магнит NdFeB Ø3 × 2, намагничен по оси | 2 | 1 | 3 | шт. | К0: в кольцо-байонет против датчика Холла | ведомость-кисти-S0.json | [Д] | магнит неодимовый Ø3 × 2 мм, намагничен по оси | neodymium magnet 3x2mm axially magnetized | 钕铁硼 强磁 圆片 3x2mm | https://mobile.yangkeduo.com/search_result.html |  |  |  |  | Ø3 × 3 (гнездо углубить) | диаметр 3,0 ± 0,1 (гнездо Ø3,1) | 1
5. Замок и сменные кисти (покупные) | Жало короткое TS100/Pinecil ST-B2 (≈ 6,2 Ом) | 1 | 0 | 1 | шт. | К2-2: нагреватель с термопарой | ведомость-кисти-S0.json | [И pine64.org Tips] | жало TS100 ST-B2 короткое | TS100 / Pinecil short tip ST-B2 | TS100 烙铁头 短 ST-B2 | https://mobile.yangkeduo.com/search_result.html | https://mobile.yangkeduo.com/goods.html?goods_id=1024003519696 | TS-B2 | 50 | —; оригинальное жало TS100 с нагревателем, вариант TS-B2 — ¥50; сопротивление в карточке не указано (≈ 6,2 Ом [Д]) [окно вариантов в приложении, пакет 3, 09.11.2026] (09.11.2026) | — | размеры по чертежам кистей (РД ред. Г); опыты К1–К4 до сборки | 1
5. Замок и сменные кисти (покупные) | Гнездо контактов жала TS100 (запчасть ручки, 3 контакта) | 1 | 0 | 1 | шт. | К2-2: в держатель жала | ведомость-кисти-S0.json | [Д] | гнездо (разъём) жала TS100, запчасть ручки | TS100 tip socket connector spare | TS100 烙铁头 插座 配件 | https://mobile.yangkeduo.com/search_result.html |  |  |  |  | — | размеры по чертежам кистей (РД ред. Г); опыты К1–К4 до сборки | 1
5. Замок и сменные кисти (покупные) | Обгонная игольчатая муфта HF0612 (6 × 10 × 12) | 2 | 1 | 3 | шт. | К3-1: трещотка, два направления | ведомость-кисти-S0.json | [И rs-online] | обгонная игольчатая муфта HF0612 | HF0612 one-way needle bearing clutch 6x10x12 | 单向 滚针 轴承 HF0612 | https://mobile.yangkeduo.com/search_result.html | https://mobile.yangkeduo.com/goods.html?goods_id=478939385402 | HF0612 Inner 6 Outer 10 Thick 12 | 10,8 | —; размер 6 × 10 × 12 — как в чертеже трещотки; «German INA» в названии — скорее всего не оригинал INA [Д]; нужно 3 шт. [окно вариантов в приложении, пакет 3, 09.11.2026] (09.11.2026) | — | размеры по чертежам кистей (РД ред. Г); опыты К1–К4 до сборки | 1
5. Замок и сменные кисти (покупные) | Подшипник 6 × 10 × 3 (MR106ZZ) | 2 | 1 | 3 | шт. | К3-1: вал трещотки | ведомость-кисти-S0.json | [Д] | подшипник 6 × 10 × 3 MR106ZZ | MR106ZZ bearing 6x10x3 | MR106ZZ 轴承 6x10x3 | https://mobile.yangkeduo.com/search_result.html?search_key=MR106ZZ%20%E8%BD%B4%E6%89%BF%206x10x3 |  |  |  |  | — | размеры по чертежам кистей (РД ред. Г); опыты К1–К4 до сборки | 1
5. Замок и сменные кисти (покупные) | Кольцо стопорное E4 (DIN 6799, канавка Ø4, наружный Ø9) | 1 | 1 | 2 | шт. | К3-1: вал | ведомость-кисти-S0.json | [Д] | кольцо стопорное E4 DIN 6799 | E-clip DIN 6799 E4 (for 4mm groove) | E型 卡簧 E4 DIN6799 | https://mobile.yangkeduo.com/search_result.html |  |  |  |  | — | размеры по чертежам кистей (РД ред. Г); опыты К1–К4 до сборки | 1
5. Замок и сменные кисти (покупные) | Магнит Ø3 × 3 | 1 | 1 | 2 | шт. | К3-1: держит бит | ведомость-кисти-S0.json | [Д] | магнит неодимовый Ø3 × 3 | neodymium magnet 3x3mm | 钕铁硼 强磁 圆片 3x3 | https://mobile.yangkeduo.com/search_result.html |  |  |  |  | — | размеры по чертежам кистей (РД ред. Г); опыты К1–К4 до сборки | 1
5. Замок и сменные кисти (покупные) | Набор прецизионных бит 4 мм (шлиц, PH0–PH1, шестигранник 1,5–2,5) | 1 | 0 | 1 | шт. | К3-1: сменные биты | ведомость-кисти-S0.json | [Д] | набор прецизионных бит 4 мм (шлиц, PH0–PH1, шестигранник 1,5–2,5) | 4mm precision screwdriver bit set C4 | 4mm 精密 螺丝刀 批头 套装 | https://mobile.yangkeduo.com/search_result.html |  |  |  |  | — | размеры по чертежам кистей (РД ред. Г); опыты К1–К4 до сборки | 1
5. Замок и сменные кисти (покупные) | Рог холостой STS3215 (Ø19,2 × 2, 4 × M3 на Ø14) — проверить, есть ли в комплекте серво | 2 | 1 | 3 | шт. | К1: вторая опора губки-вилки, 1 на кисть | ведомость-кисти-S0.json | [Д] |  |  |  |  |  |  |  |  | — | размеры по чертежам кистей (РД ред. Г); опыты К1–К4 до сборки | 1
6. Контейнер | Магнит неодимовый Ø8 × 3 N35 | 4 | 4 | 8 | шт. | по одному в торец держателя 05.003 | ред. А (замок контейнера вчерне) | [Д] | магнит неодимовый Ø8 × 3 N35 | neodymium magnet 8x3mm N35 | 钕铁硼 强磁 圆片 8x3 | https://mobile.yangkeduo.com/search_result.html |  |  |  |  | Ø10 × 3 (другая лунка) | диаметр 8,0 ± 0,1, лунка Ø8,2 | 1
6. Контейнер | Балласт — стальные шайбы | 1 | 0 | 1 | компл. | в расчёте массы 200 г | модель РД ред. В | [Д] | стальные шайбы M10 (балласт) | steel washers M10 | 钢垫片 M10 | https://mobile.yangkeduo.com/search_result.html?search_key=%E9%92%A2%E5%9E%AB%E7%89%87%20M10 |  |  |  |  | свинцовые пластины в оболочке | 100, 200, 300 г шагами; в расчёте 200 г | 1
7. Крепёж (по таблицам отверстий деталей робота и кистей, +10 %) | Винт M2×5 DIN 7991 (потайной) | 48 | 5 | 53 | шт. | детали: 02.002 | таблицы отверстий × количество деталей | [Р] | винт потайной DIN 7991 M2x5 | M2x5 DIN7991 countersunk socket screw | M2*5 沉头内六角螺丝 DIN7991 | https://mobile.yangkeduo.com/search_result.html |  |  |  |  | эквивалент ISO/ГОСТ той же длины | стандарт и длина; нержавеющая сталь A2 (304) или сталь 8.8–12.9 — по наличию; продают пакетами по 50–100 шт. — брать пакет не меньше «Заказать» | 1
7. Крепёж (по таблицам отверстий деталей робота и кистей, +10 %) | Винт M2×5 DIN 912 (цилиндрическая головка) | 32 | 4 | 36 | шт. | детали: 01.003, 01.004 | таблицы отверстий × количество деталей | [Р] | винт DIN 912 M2x5 | M2x5 DIN912 socket head cap screw | M2*5 内六角圆柱头螺丝 DIN912 | https://mobile.yangkeduo.com/search_result.html |  |  |  |  | эквивалент ISO/ГОСТ той же длины | стандарт и длина; нержавеющая сталь A2 (304) или сталь 8.8–12.9 — по наличию; продают пакетами по 50–100 шт. — брать пакет не меньше «Заказать» | 1
7. Крепёж (по таблицам отверстий деталей робота и кистей, +10 %) | Винт M2×6 DIN 912 (цилиндрическая головка) | 132 | 14 | 146 | шт. | детали: 01.004, 02.001, 02.010, 03.001, 03.002, 03.004, 03.010, 03.011, 04.002, 04.003, 07.011 | таблицы отверстий × количество деталей | [Р] | винт DIN 912 M2x6 | M2x6 DIN912 socket head cap screw | M2*6 内六角圆柱头螺丝 DIN912 | https://mobile.yangkeduo.com/search_result.html |  |  |  |  | эквивалент ISO/ГОСТ той же длины | стандарт и длина; нержавеющая сталь A2 (304) или сталь 8.8–12.9 — по наличию; продают пакетами по 50–100 шт. — брать пакет не меньше «Заказать» | 1
7. Крепёж (по таблицам отверстий деталей робота и кистей, +10 %) | Винт M2×8 ISO 7380 (полукруглая головка) | 12 | 2 | 14 | шт. | детали: 01.001, 04.001 | таблицы отверстий × количество деталей | [Р] | винт ISO 7380 M2x8 | M2x8 ISO7380 button head socket screw | M2*8 半圆头内六角螺丝 ISO7380 | https://mobile.yangkeduo.com/search_result.html |  |  |  |  | эквивалент ISO/ГОСТ той же длины | стандарт и длина; нержавеющая сталь A2 (304) или сталь 8.8–12.9 — по наличию; продают пакетами по 50–100 шт. — брать пакет не меньше «Заказать» | 1
7. Крепёж (по таблицам отверстий деталей робота и кистей, +10 %) | Винт M2×10 DIN 912 (цилиндрическая головка) | 4 | 1 | 5 | шт. | детали: 01.003 | таблицы отверстий × количество деталей | [Р] | винт DIN 912 M2x10 | M2x10 DIN912 socket head cap screw | M2*10 内六角圆柱头螺丝 DIN912 | https://mobile.yangkeduo.com/search_result.html |  |  |  |  | эквивалент ISO/ГОСТ той же длины | стандарт и длина; нержавеющая сталь A2 (304) или сталь 8.8–12.9 — по наличию; продают пакетами по 50–100 шт. — брать пакет не меньше «Заказать» | 1
7. Крепёж (по таблицам отверстий деталей робота и кистей, +10 %) | Винт M2,5×5 DIN 912 (цилиндрическая головка) | 12 | 2 | 14 | шт. | детали: 01.004 | таблицы отверстий × количество деталей | [Р] | винт DIN 912 M2.5x5 | M2.5x5 DIN912 socket head cap screw | M2.5*5 内六角圆柱头螺丝 DIN912 | https://mobile.yangkeduo.com/search_result.html |  |  |  |  | эквивалент ISO/ГОСТ той же длины | стандарт и длина; нержавеющая сталь A2 (304) или сталь 8.8–12.9 — по наличию; продают пакетами по 50–100 шт. — брать пакет не меньше «Заказать» | 1
7. Крепёж (по таблицам отверстий деталей робота и кистей, +10 %) | Винт M2,5×6 DIN 912 (цилиндрическая головка) | 16 | 2 | 18 | шт. | детали: 01.002, 01.004 | таблицы отверстий × количество деталей | [Р] | винт DIN 912 M2.5x6 | M2.5x6 DIN912 socket head cap screw | M2.5*6 内六角圆柱头螺丝 DIN912 | https://mobile.yangkeduo.com/search_result.html |  |  |  |  | эквивалент ISO/ГОСТ той же длины | стандарт и длина; нержавеющая сталь A2 (304) или сталь 8.8–12.9 — по наличию; продают пакетами по 50–100 шт. — брать пакет не меньше «Заказать» | 1
7. Крепёж (по таблицам отверстий деталей робота и кистей, +10 %) | Винт M2,5×8 DIN 912 (цилиндрическая головка) | 20 | 2 | 22 | шт. | детали: 01.002, 07.003 | таблицы отверстий × количество деталей | [Р] | винт DIN 912 M2.5x8 | M2.5x8 DIN912 socket head cap screw | M2.5*8 内六角圆柱头螺丝 DIN912 | https://mobile.yangkeduo.com/search_result.html |  |  |  |  | эквивалент ISO/ГОСТ той же длины | стандарт и длина; нержавеющая сталь A2 (304) или сталь 8.8–12.9 — по наличию; продают пакетами по 50–100 шт. — брать пакет не меньше «Заказать» | 1
7. Крепёж (по таблицам отверстий деталей робота и кистей, +10 %) | Винт M2,5×10 DIN 912 (цилиндрическая головка) | 20 | 2 | 22 | шт. | детали: 02.003 | таблицы отверстий × количество деталей | [Р] | винт DIN 912 M2.5x10 | M2.5x10 DIN912 socket head cap screw | M2.5*10 内六角圆柱头螺丝 DIN912 | https://mobile.yangkeduo.com/search_result.html |  |  |  |  | эквивалент ISO/ГОСТ той же длины | стандарт и длина; нержавеющая сталь A2 (304) или сталь 8.8–12.9 — по наличию; продают пакетами по 50–100 шт. — брать пакет не меньше «Заказать» | 1
7. Крепёж (по таблицам отверстий деталей робота и кистей, +10 %) | Винт M3×4 DIN 912 (цилиндрическая головка) | 48 | 5 | 53 | шт. | детали: 02.002, 02.006 | таблицы отверстий × количество деталей | [Р] | винт DIN 912 M3x4 | M3x4 DIN912 socket head cap screw | M3*4 内六角圆柱头螺丝 DIN912 | https://mobile.yangkeduo.com/search_result.html |  |  |  |  | эквивалент ISO/ГОСТ той же длины | стандарт и длина; нержавеющая сталь A2 (304) или сталь 8.8–12.9 — по наличию; продают пакетами по 50–100 шт. — брать пакет не меньше «Заказать» | 1
7. Крепёж (по таблицам отверстий деталей робота и кистей, +10 %) | Винт M3×5 DIN 912 (цилиндрическая головка) | 66 | 7 | 73 | шт. | детали: 01.003, 01.004, 03.002, 03.004, 03.006, 07.012 | таблицы отверстий × количество деталей | [Р] | винт DIN 912 M3x5 | M3x5 DIN912 socket head cap screw | M3*5 内六角圆柱头螺丝 DIN912 | https://mobile.yangkeduo.com/search_result.html |  |  |  |  | эквивалент ISO/ГОСТ той же длины | стандарт и длина; нержавеющая сталь A2 (304) или сталь 8.8–12.9 — по наличию; продают пакетами по 50–100 шт. — брать пакет не меньше «Заказать» | 1
7. Крепёж (по таблицам отверстий деталей робота и кистей, +10 %) | Винт M3×5 ISO 7380 (полукруглая головка) | 4 | 1 | 5 | шт. | детали: 03.011 | таблицы отверстий × количество деталей | [Р] | винт ISO 7380 M3x5 | M3x5 ISO7380 button head socket screw | M3*5 半圆头内六角螺丝 ISO7380 | https://mobile.yangkeduo.com/search_result.html |  |  |  |  | эквивалент ISO/ГОСТ той же длины | стандарт и длина; нержавеющая сталь A2 (304) или сталь 8.8–12.9 — по наличию; продают пакетами по 50–100 шт. — брать пакет не меньше «Заказать» | 1
7. Крепёж (по таблицам отверстий деталей робота и кистей, +10 %) | Винт M3×6 DIN 7991 (потайной) | 3 | 1 | 4 | шт. | детали: 01.003 | таблицы отверстий × количество деталей | [Р] | винт потайной DIN 7991 M3x6 | M3x6 DIN7991 countersunk socket screw | M3*6 沉头内六角螺丝 DIN7991 | https://mobile.yangkeduo.com/search_result.html |  |  |  |  | эквивалент ISO/ГОСТ той же длины | стандарт и длина; нержавеющая сталь A2 (304) или сталь 8.8–12.9 — по наличию; продают пакетами по 50–100 шт. — брать пакет не меньше «Заказать» | 1
7. Крепёж (по таблицам отверстий деталей робота и кистей, +10 %) | Винт M3×6 DIN 912 (цилиндрическая головка) | 94 | 10 | 104 | шт. | детали: 01.004, 02.003, 02.004, 02.010, 03.001, 04.001, 04.002, 07.001 | таблицы отверстий × количество деталей | [Р] | винт DIN 912 M3x6 | M3x6 DIN912 socket head cap screw | M3*6 内六角圆柱头螺丝 DIN912 | https://mobile.yangkeduo.com/search_result.html |  |  |  |  | эквивалент ISO/ГОСТ той же длины | стандарт и длина; нержавеющая сталь A2 (304) или сталь 8.8–12.9 — по наличию; продают пакетами по 50–100 шт. — брать пакет не меньше «Заказать» | 1
7. Крепёж (по таблицам отверстий деталей робота и кистей, +10 %) | Винт M3×6 ISO 7380 (полукруглая головка) | 14 | 2 | 16 | шт. | детали: 01.002, 01.004 | таблицы отверстий × количество деталей | [Р] | винт ISO 7380 M3x6 | M3x6 ISO7380 button head socket screw | M3*6 半圆头内六角螺丝 ISO7380 | https://mobile.yangkeduo.com/search_result.html |  |  |  |  | эквивалент ISO/ГОСТ той же длины | стандарт и длина; нержавеющая сталь A2 (304) или сталь 8.8–12.9 — по наличию; продают пакетами по 50–100 шт. — брать пакет не меньше «Заказать» | 1
7. Крепёж (по таблицам отверстий деталей робота и кистей, +10 %) | Винт M3×8 DIN 912 (цилиндрическая головка) | 14 | 2 | 16 | шт. | детали: 02.006, 07.012 | таблицы отверстий × количество деталей | [Р] | винт DIN 912 M3x8 | M3x8 DIN912 socket head cap screw | M3*8 内六角圆柱头螺丝 DIN912 | https://mobile.yangkeduo.com/search_result.html |  |  |  |  | эквивалент ISO/ГОСТ той же длины | стандарт и длина; нержавеющая сталь A2 (304) или сталь 8.8–12.9 — по наличию; продают пакетами по 50–100 шт. — брать пакет не меньше «Заказать» | 1
7. Крепёж (по таблицам отверстий деталей робота и кистей, +10 %) | Винт M3×8 ISO 7380 (полукруглая головка) | 8 | 1 | 9 | шт. | детали: 01.003, 01.005 | таблицы отверстий × количество деталей | [Р] | винт ISO 7380 M3x8 | M3x8 ISO7380 button head socket screw | M3*8 半圆头内六角螺丝 ISO7380 | https://mobile.yangkeduo.com/search_result.html |  |  |  |  | эквивалент ISO/ГОСТ той же длины | стандарт и длина; нержавеющая сталь A2 (304) или сталь 8.8–12.9 — по наличию; продают пакетами по 50–100 шт. — брать пакет не меньше «Заказать» | 1
7. Крепёж (по таблицам отверстий деталей робота и кистей, +10 %) | Винт M3×10 DIN 912 (цилиндрическая головка) | 22 | 3 | 25 | шт. | детали: 01.003, 01.005 | таблицы отверстий × количество деталей | [Р] | винт DIN 912 M3x10 | M3x10 DIN912 socket head cap screw | M3*10 内六角圆柱头螺丝 DIN912 | https://mobile.yangkeduo.com/search_result.html |  |  |  |  | эквивалент ISO/ГОСТ той же длины | стандарт и длина; нержавеющая сталь A2 (304) или сталь 8.8–12.9 — по наличию; продают пакетами по 50–100 шт. — брать пакет не меньше «Заказать» | 1
7. Крепёж (по таблицам отверстий деталей робота и кистей, +10 %) | Винт M3×12 DIN 912 (цилиндрическая головка) | 10 | 1 | 11 | шт. | детали: 01.001 | таблицы отверстий × количество деталей | [Р] | винт DIN 912 M3x12 | M3x12 DIN912 socket head cap screw | M3*12 内六角圆柱头螺丝 DIN912 | https://mobile.yangkeduo.com/search_result.html |  |  |  |  | эквивалент ISO/ГОСТ той же длины | стандарт и длина; нержавеющая сталь A2 (304) или сталь 8.8–12.9 — по наличию; продают пакетами по 50–100 шт. — брать пакет не меньше «Заказать» | 1
7. Крепёж (по таблицам отверстий деталей робота и кистей, +10 %) | Гайка M2 DIN 985 (самоконтрящаяся, с нейлоновым кольцом) | 12 | 2 | 14 | шт. | детали: 01.001, 04.001 | таблицы отверстий × количество деталей | [Р] | гайка самоконтрящаяся DIN 985 M2 | M2 DIN985 nylon lock nut | M2 尼龙防松螺母 DIN985 | https://mobile.yangkeduo.com/search_result.html |  |  |  |  | эквивалент ISO/ГОСТ той же длины | стандарт и длина; нержавеющая сталь A2 (304) или сталь 8.8–12.9 — по наличию; продают пакетами по 50–100 шт. — брать пакет не меньше «Заказать» | 1
7. Крепёж (по таблицам отверстий деталей робота и кистей, +10 %) | Гайка M2,5 DIN 934 | 12 | 2 | 14 | шт. | детали: 01.002 | таблицы отверстий × количество деталей | [Р] | гайка DIN 934 M2.5 | M2.5 DIN934 hex nut | M2.5 六角螺母 DIN934 | https://mobile.yangkeduo.com/search_result.html |  |  |  |  | эквивалент ISO/ГОСТ той же длины | стандарт и длина; нержавеющая сталь A2 (304) или сталь 8.8–12.9 — по наличию; продают пакетами по 50–100 шт. — брать пакет не меньше «Заказать» | 1
7. Крепёж (по таблицам отверстий деталей робота и кистей, +10 %) | Гайка M3 DIN 985 (самоконтрящаяся, с нейлоновым кольцом) | 8 | 1 | 9 | шт. | детали: 01.005 | таблицы отверстий × количество деталей | [Р] | гайка самоконтрящаяся DIN 985 M3 | M3 DIN985 nylon lock nut | M3 尼龙防松螺母 DIN985 | https://mobile.yangkeduo.com/search_result.html |  |  |  |  | эквивалент ISO/ГОСТ той же длины | стандарт и длина; нержавеющая сталь A2 (304) или сталь 8.8–12.9 — по наличию; продают пакетами по 50–100 шт. — брать пакет не меньше «Заказать» | 1
7. Крепёж (по таблицам отверстий деталей робота и кистей, +10 %) | Шайба M3 DIN 9021 (увеличенная) | 18 | 2 | 20 | шт. | детали: 01.001, 01.005 | таблицы отверстий × количество деталей | [Р] | шайба увеличенная DIN 9021 M3 | M3 DIN9021 large flat washer | M3 加大平垫片 DIN9021 | https://mobile.yangkeduo.com/search_result.html |  |  |  |  | эквивалент ISO/ГОСТ той же длины | стандарт и длина; нержавеющая сталь A2 (304) или сталь 8.8–12.9 — по наличию; продают пакетами по 50–100 шт. — брать пакет не меньше «Заказать» | 1
7. Крепёж (по таблицам отверстий деталей робота и кистей, +10 %) | Стойка латунная M2 × 6 мм, мама–мама | 32 | 4 | 36 | шт. | детали: 01.003, 01.004 | таблицы отверстий × количество деталей | [Р] | стойка латунная мама-мама M2x6 | M2x6 brass standoff female-female | M2*6 双通铜柱 内内 六角铜柱 | https://mobile.yangkeduo.com/search_result.html |  |  |  |  | эквивалент ISO/ГОСТ той же длины | мама–мама (双通, резьба с обеих сторон), высота 6 мм; проще — набор латунных стоек M2/M2,5/M3 с винтами | 1
7. Крепёж (по таблицам отверстий деталей робота и кистей, +10 %) | Втулка-проставка M2,5 × 2 мм (нейлон или латунь, гладкая) | 4 | 1 | 5 | шт. | детали: 01.002 | таблицы отверстий × количество деталей | [Р] | проставка нейлоновая M2.5x2 гладкая | M2.5 2mm nylon spacer round unthreaded | M2.5*2 尼龙垫柱 光孔 隔离柱 | https://mobile.yangkeduo.com/search_result.html |  |  |  |  | эквивалент ISO/ГОСТ той же длины | гладкая (光孔), внутренний Ø под винт, высота 2 мм | 1
7. Крепёж (по таблицам отверстий деталей робота и кистей, +10 %) | Стойка латунная M2,5 × 6 мм, мама–мама | 12 | 2 | 14 | шт. | детали: 01.004 | таблицы отверстий × количество деталей | [Р] | стойка латунная мама-мама M2.5x6 | M2.5x6 brass standoff female-female | M2.5*6 双通铜柱 内内 六角铜柱 | https://mobile.yangkeduo.com/search_result.html |  |  |  |  | эквивалент ISO/ГОСТ той же длины | мама–мама (双通, резьба с обеих сторон), высота 6 мм; проще — набор латунных стоек M2/M2,5/M3 с винтами | 1
7. Крепёж (по таблицам отверстий деталей робота и кистей, +10 %) | Стойка латунная M3 × 6 мм, мама–мама | 26 | 3 | 29 | шт. | детали: 01.003, 01.004 | таблицы отверстий × количество деталей | [Р] | стойка латунная мама-мама M3x6 | M3x6 brass standoff female-female | M3*6 双通铜柱 内内 六角铜柱 | https://mobile.yangkeduo.com/search_result.html |  |  |  |  | эквивалент ISO/ГОСТ той же длины | мама–мама (双通, резьба с обеих сторон), высота 6 мм; проще — набор латунных стоек M2/M2,5/M3 с винтами | 1
7. Крепёж (по таблицам отверстий деталей робота и кистей, +10 %) | Вставка латунная резьбовая (вплавляемая) M2,5×4 | 12 | 2 | 14 | шт. | детали: 07.011, 07.020, 07.030 | таблицы отверстий × количество деталей | [Р] | вставка латунная вплавляемая M2.5x4 | M2.5x4 heat set threaded insert brass | M2.5*4 热熔铜螺母 滚花 注塑 | https://mobile.yangkeduo.com/search_result.html |  |  |  |  | эквивалент ISO/ГОСТ той же длины | наружный диаметр и длина: M3×5,7 — Ø4,6 под отверстие Ø4,2 в печати [Д параметры-покупных.json]; M2,5×4 — под отверстие Ø3,6; латунь, накатка | 1
7. Крепёж (по таблицам отверстий деталей робота и кистей, +10 %) | Вставка латунная резьбовая (вплавляемая) M3×5,7 | 47 | 5 | 52 | шт. | детали: 01.001, 02.008, 03.010, 04.003, 05.003, 06.001 | таблицы отверстий × количество деталей | [Р] | вставка латунная вплавляемая M3x5.7 | M3x5.7 heat set threaded insert brass | M3*5.7 热熔铜螺母 滚花 注塑 | https://mobile.yangkeduo.com/search_result.html |  |  |  |  | эквивалент ISO/ГОСТ той же длины | наружный диаметр и длина: M3×5,7 — Ø4,6 под отверстие Ø4,2 в печати [Д параметры-покупных.json]; M2,5×4 — под отверстие Ø3,6; латунь, накатка | 1
7. Крепёж (по таблицам отверстий деталей робота и кистей, +10 %) | Заклёпка вытяжная алюминиевая 3×8 | 20 | 2 | 22 | шт. | детали: 02.006, 03.002, 03.004 | таблицы отверстий × количество деталей | [Р] | заклёпка вытяжная алюминиевая 3x8 | aluminum blind rivet 3x8 | 铝抽芯铆钉 3*8 开口型 | https://mobile.yangkeduo.com/search_result.html |  |  |  |  | эквивалент ISO/ГОСТ той же длины | стандарт и длина; нержавеющая сталь A2 (304) или сталь 8.8–12.9 — по наличию; продают пакетами по 50–100 шт. — брать пакет не меньше «Заказать» | 1
7. Крепёж (по таблицам отверстий деталей робота и кистей, +10 %) | Штифт цилиндрический 2×10 ISO 8734 | 1 | 1 | 2 | шт. | детали: 07.033 | таблицы отверстий × количество деталей | [Р] | штифт цилиндрический 2x10 ISO 8734 | dowel pin 2x10 ISO8734 | 圆柱销 2*10 定位销 不锈钢 | https://mobile.yangkeduo.com/search_result.html |  |  |  |  | эквивалент ISO/ГОСТ той же длины | стандарт и длина; нержавеющая сталь A2 (304) или сталь 8.8–12.9 — по наличию; продают пакетами по 50–100 шт. — брать пакет не меньше «Заказать» | 1
8. Материалы и печать на заказ (заказ 2) | Лист алюминиевый 5052-H32 (АМг3), 1,5 мм | 0,03 | 0,009 | 0,039 | м² | площадь деталей 300 см² (02.002); резка по «_раскрой.dxf» — вместе с заказом резки | масса деталей ÷ (ρ·t) | [Р] | лист алюминий 5052 1,5 мм лазерная резка по DXF | 5052-H32 aluminum sheet 1.5mm laser cutting service from DXF | 5052 铝板 1.5mm 激光切割 定制 DXF | https://mobile.yangkeduo.com/search_result.html |  |  |  |  | АМг3/АМг2 той же толщины | толщина ±0,15 мм, марка | 2
8. Материалы и печать на заказ (заказ 2) | Лист алюминиевый 5052-H32 (АМг3), 2 мм | 0,1319 | 0,0396 | 0,1715 | м² | площадь деталей 1319 см² (01.002, 01.003, 01.004, 02.006, 02.010, 03.002, 03.004, 03.006); резка по «_раскрой.dxf» — вместе с заказом резки | масса деталей ÷ (ρ·t) | [Р] | лист алюминий 5052 2 мм лазерная резка по DXF | 5052-H32 aluminum sheet 2mm laser cutting service from DXF | 5052 铝板 2mm 激光切割 定制 DXF | https://mobile.yangkeduo.com/search_result.html |  |  |  |  | АМг3/АМг2 той же толщины | толщина ±0,15 мм, марка | 2
8. Материалы и печать на заказ (заказ 2) | Лист алюминиевый 5052-H32 (АМг3), 2,5 мм | 0,0065 | 0,002 | 0,0085 | м² | площадь деталей 65 см² (01.005); резка по «_раскрой.dxf» — вместе с заказом резки | масса деталей ÷ (ρ·t) | [Р] | лист алюминий 5052 2,5 мм лазерная резка по DXF | 5052-H32 aluminum sheet 2.5mm laser cutting service from DXF | 5052 铝板 2.5mm 激光切割 定制 DXF | https://mobile.yangkeduo.com/search_result.html |  |  |  |  | АМг3/АМг2 той же толщины | толщина ±0,15 мм, марка | 2
8. Материалы и печать на заказ (заказ 2) | Лист алюминиевый 5052-H32 (АМг3), 4 мм | 0,0303 | 0,0091 | 0,0394 | м² | площадь деталей 303 см² (02.003, 02.004); резка по «_раскрой.dxf» — вместе с заказом резки | масса деталей ÷ (ρ·t) | [Р] | лист алюминий 5052 4 мм лазерная резка по DXF | 5052-H32 aluminum sheet 4mm laser cutting service from DXF | 5052 铝板 4mm 激光切割 定制 DXF | https://mobile.yangkeduo.com/search_result.html |  |  |  |  | АМг3/АМг2 той же толщины | толщина ±0,15 мм, марка | 2
8. Материалы и печать на заказ (заказ 2) | Плита алюминиевая 5052/6061, 7 мм | 0,008 | 0,0024 | 0,0104 | м² | площадь деталей 80 см² (02.005); резка по «_раскрой.dxf» — вместе с заказом резки | масса деталей ÷ (ρ·t) | [Р] | лист алюминий 5052 7 мм лазерная резка по DXF | 5052-H32 aluminum sheet 7mm laser cutting service from DXF | 5052 铝板 7mm 激光切割 定制 DXF | https://mobile.yangkeduo.com/search_result.html |  |  |  |  | АМг3/АМг2 той же толщины | толщина ±0,15 мм, марка | 2
8. Материалы и печать на заказ (заказ 2) | Труба алюминиевая 16 × 8 × 1,5 (6063) | 0,565 | 0,057 | 0,622 | м | рёбра ног и рук 02.007, 03.003, 03.005 | габарит × количество | [Р] | труба алюминиевая прямоугольная 16х8х1,5 | aluminum rectangular tube 16x8x1.5 | 铝方管 16x8x1.5 | https://mobile.yangkeduo.com/search_result.html?search_key=%E9%93%9D%E6%96%B9%E7%AE%A1%2016x8x1.5 |  |  |  |  | 16 × 10 × 1,5 | наружный 16 × 8 мм, стенка 1,5 мм | 2
8. Материалы и печать на заказ (заказ 2) | Печать на заказ: PETG, деталей — 43 | 1311 | 0 | 1311 | г | печатные детали робота и кистей; масса сплошным телом — с заполнением выйдет меньше | масса деталей × количество | [Р] | 3D печать на заказ PETG по STL | 3D printing service PETG custom STL | 3D打印服务 PETG 定制 打印 | https://mobile.yangkeduo.com/search_result.html |  |  |  |  | своя печать (если появится принтер) | печать по STL из папок деталей; PETG, стенки 4 периметра, заполнение 40–60 % [Д]; цена обычно за грамм или за деталь — прислать продавцу STL и таблицу «Изготовление» | 2
8. Материалы и печать на заказ (заказ 2) | Печать на заказ: PA-CF, деталей — 3 | 26 | 0 | 26 | г | держатель жала, корпус и крышка трещотки (кисти); масса сплошным телом — с заполнением выйдет меньше | масса деталей × количество | [Р] | 3D печать на заказ PA-CF нейлон углеволокно | 3D printing service PA-CF nylon carbon fiber | 3D打印 碳纤维尼龙 PA-CF 定制 | https://mobile.yangkeduo.com/search_result.html |  |  |  |  | своя печать (если появится принтер) | PA-CF или PA12-CF; держатель жала греется — теплостойкость ≥ 150 °C [Д] | 2
8. Материалы и печать на заказ (заказ 2) | Печать на заказ: TPU 95A, деталей — 10 | 14 | 0 | 14 | г | подошвы стоп 02.009; масса сплошным телом — с заполнением выйдет меньше | масса деталей × количество | [Р] | 3D печать на заказ TPU | 3D printing service TPU 95A | 3D打印 TPU 软胶 定制 打印 | https://mobile.yangkeduo.com/search_result.html |  |  |  |  | своя печать (если появится принтер) | твёрдость 95A (или 90A) | 2
8. Материалы и печать на заказ (заказ 2) | Пруток стальной 40Х (или 45) Ø10 × 100 мм | 1 | 0 | 1 | шт. | вал трещотки 07.031 (длина 52 мм + зажим) | чертёж 07.031 | [Р] | пруток сталь 40Х 10 мм | steel rod 40Cr / C45 10mm | 40Cr 圆钢 10mm | https://mobile.yangkeduo.com/search_result.html?search_key=40Cr%20%E5%9C%86%E9%92%A2%2010mm |  |  |  |  | заказать вал у токаря целиком | закалка до HRC ≥ 58 под муфты или закалённая втулка [Д] | 2
8. Материалы и печать на заказ (заказ 2) | Пруток алюминиевый Д16Т (2024) Ø16 × 60 мм | 1 | 0 | 1 | шт. | втулки муфт 07.032 ×2 | чертёж 07.032 | [Р] | пруток Д16Т 16 мм | 2024 aluminum round bar 16mm | 2024 铝棒 16mm | https://mobile.yangkeduo.com/search_result.html?search_key=2024%20%E9%93%9D%E6%A3%92%2016mm |  |  |  |  | сталь | марка, диаметр | 2
9. Провода, кабели шин, разъёмы и расходники | Провод силиконовый 4 мм² (11–12 AWG) | 1,4 | 0,6 | 2 | м | по таблице жгутов; у силовых — с обратным проводом «−» [Д] | таблица-жгутов.csv | [Р] | провод силиконовый 4 мм² | silicone wire 11–12 AWG | 耐高温 硅胶线 4平方 | https://mobile.yangkeduo.com/search_result.html |  |  |  |  | ПВА/МГТФ того же сечения | сечение по меди (в карточке «平方» — мм²), силикон, лужёная медь; продают метрами — выбрать длину | 1
9. Провода, кабели шин, разъёмы и расходники | Провод силиконовый 1,0 мм² (17–18 AWG) | 2,1 | 0,9 | 3 | м | по таблице жгутов; у силовых — с обратным проводом «−» [Д] | таблица-жгутов.csv | [Р] | провод силиконовый 1,0 мм² | silicone wire 17–18 AWG | 耐高温 硅胶线 1平方 | https://mobile.yangkeduo.com/search_result.html |  |  |  |  | ПВА/МГТФ того же сечения | сечение по меди (в карточке «平方» — мм²), силикон, лужёная медь; продают метрами — выбрать длину | 1
9. Провода, кабели шин, разъёмы и расходники | Провод силиконовый 0,75 мм² (18 AWG) | 2,9 | 1,1 | 4 | м | по таблице жгутов; у силовых — с обратным проводом «−» [Д] | таблица-жгутов.csv | [Р] | провод силиконовый 0,75 мм² | silicone wire 18 AWG | 耐高温 硅胶线 0.75平方 | https://mobile.yangkeduo.com/search_result.html |  |  |  |  | ПВА/МГТФ того же сечения | сечение по меди (в карточке «平方» — мм²), силикон, лужёная медь; продают метрами — выбрать длину | 1
9. Провода, кабели шин, разъёмы и расходники | Провод силиконовый 0,5 мм² (20 AWG) | 4,2 | 1,3 | 5,5 | м | по таблице жгутов; у силовых — с обратным проводом «−» [Д] | таблица-жгутов.csv | [Р] | провод силиконовый 0,5 мм² | silicone wire 20 AWG | 耐高温 硅胶线 0.5平方 | https://mobile.yangkeduo.com/search_result.html |  |  |  |  | ПВА/МГТФ того же сечения | сечение по меди (в карточке «平方» — мм²), силикон, лужёная медь; продают метрами — выбрать длину | 1
9. Провода, кабели шин, разъёмы и расходники | Провод силиконовый 0,25 мм² (23–24 AWG) | 3,25 | 1,25 | 4,5 | м | по таблице жгутов; у силовых — с обратным проводом «−» [Д] | таблица-жгутов.csv | [Р] | провод силиконовый 0,25 мм² | silicone wire 23–24 AWG | 硅胶线 24AWG | https://mobile.yangkeduo.com/search_result.html?search_key=%E7%A1%85%E8%83%B6%E7%BA%BF%2024AWG |  |  |  |  | ПВА/МГТФ того же сечения | сечение по меди (в карточке «平方» — мм²), силикон, лужёная медь; продают метрами — выбрать длину | 1
9. Провода, кабели шин, разъёмы и расходники | Провод силиконовый 0,14 мм² (26 AWG) | 6 | 2 | 8 | м | по таблице жгутов; у силовых — с обратным проводом «−» [Д] | таблица-жгутов.csv | [Р] | провод силиконовый 0,14 мм² | silicone wire 26 AWG | 硅胶线 26AWG | https://mobile.yangkeduo.com/search_result.html?search_key=%E7%A1%85%E8%83%B6%E7%BA%BF%2026AWG |  |  |  |  | ПВА/МГТФ того же сечения | сечение по меди (в карточке «平方» — мм²), силикон, лужёная медь; продают метрами — выбрать длину | 1
9. Провода, кабели шин, разъёмы и расходники | Кабель шины Feetech, 3 жилы, 100 мм | 6 | 2 | 8 | шт. | сегменты шин по таблице жгутов (К-…) | таблица-жгутов.csv | [Р] | кабель шины Feetech 3 pin 100 мм | Feetech bus servo cable 3pin 100mm | 总线舵机 3P 连接线 100mm | https://mobile.yangkeduo.com/search_result.html |  |  |  |  | самому: провод 0,25 мм² + корпуса и контакты | разъём как у серво STS3215 (замер); у каждого серво в коробке кабель [Д] | 1
9. Провода, кабели шин, разъёмы и расходники | Кабель шины Feetech, 3 жилы, 150 мм | 13 | 3 | 16 | шт. | сегменты шин по таблице жгутов (К-…) | таблица-жгутов.csv | [Р] | кабель шины Feetech 3 pin 150 мм | Feetech bus servo cable 3pin 150mm | 总线舵机 3P 连接线 150mm | https://mobile.yangkeduo.com/search_result.html |  |  |  |  | самому: провод 0,25 мм² + корпуса и контакты | разъём как у серво STS3215 (замер); у каждого серво в коробке кабель [Д] | 1
9. Провода, кабели шин, разъёмы и расходники | Кабель шины Feetech, 3 жилы, 200 мм | 8 | 2 | 10 | шт. | сегменты шин по таблице жгутов (К-…) | таблица-жгутов.csv | [Р] | кабель шины Feetech 3 pin 200 мм | Feetech bus servo cable 3pin 200mm | 总线舵机 3P 连接线 200mm | https://mobile.yangkeduo.com/search_result.html |  |  |  |  | самому: провод 0,25 мм² + корпуса и контакты | разъём как у серво STS3215 (замер); у каждого серво в коробке кабель [Д] | 1
9. Провода, кабели шин, разъёмы и расходники | Кабель шины Feetech, 3 жилы, 300 мм | 10 | 2 | 12 | шт. | сегменты шин по таблице жгутов (К-…) | таблица-жгутов.csv | [Р] | кабель шины Feetech 3 pin 300 мм | Feetech bus servo cable 3pin 300mm | 总线舵机 3P 连接线 300mm | https://mobile.yangkeduo.com/search_result.html |  |  |  |  | самому: провод 0,25 мм² + корпуса и контакты | разъём как у серво STS3215 (замер); у каждого серво в коробке кабель [Д] | 1
9. Провода, кабели шин, разъёмы и расходники | Кабель шины Feetech, 3 жилы, 500 мм | 1 | 1 | 2 | шт. | сегменты шин по таблице жгутов (К-…) | таблица-жгутов.csv | [Р] | кабель шины Feetech 3 pin 500 мм | Feetech bus servo cable 3pin 500mm | 总线舵机 3P 连接线 500mm | https://mobile.yangkeduo.com/search_result.html |  |  |  |  | самому: провод 0,25 мм² + корпуса и контакты | разъём как у серво STS3215 (замер); у каждого серво в коробке кабель [Д] | 1
9. Провода, кабели шин, разъёмы и расходники | Разъём XT60 (пара «папа–мама») | 3 | 1 | 4 | пар | батарея, зарядка, вход силовой цепи | таблица-жгутов, детали | [Д] | разъём XT60 пара | XT60 connector pair | XT60 插头 公母 | https://mobile.yangkeduo.com/search_result.html |  |  |  |  | аналог | размер и количество | 1
9. Провода, кабели шин, разъёмы и расходники | Клемма ножевая 6,3 мм изолированная (мама) | 10 | 4 | 14 | шт. | реле K1, выключатель SA1 (W2, W4, W5 и обратные) | таблица-жгутов, детали | [Д] | клемма ножевая 6,3 мм | 6.3mm female spade terminal insulated | 6.3mm 插簧 绝缘 | https://mobile.yangkeduo.com/search_result.html |  |  |  |  | аналог | размер и количество | 1
9. Провода, кабели шин, разъёмы и расходники | Набор разъёмов Dupont 2,54 с контактами | 1 | 0 | 1 | компл. | W16, W19, W20, W22 | таблица-жгутов, детали | [Д] | набор Dupont разъёмов | Dupont connector kit 2.54mm | 杜邦 端子 套装 2.54 | https://mobile.yangkeduo.com/search_result.html |  |  |  |  | аналог | размер и количество | 1
9. Провода, кабели шин, разъёмы и расходники | Набор разъёмов JST PH/XH 3 pin с проводами | 1 | 0 | 1 | компл. | кольца и «глаз» (W17, W18), датчики | таблица-жгутов, детали | [Д] | разъёмы JST XH 3 pin с проводом | JST XH 3pin connector with wire kit | JST XH 3P 带线 端子 | https://mobile.yangkeduo.com/search_result.html |  |  |  |  | аналог | размер и количество | 1
9. Провода, кабели шин, разъёмы и расходники | Корпуса JST EH 3 pin + контакты (на замену кабелям Dynamixel) | 20 | 0 | 20 | шт. | если кабели X3P делать самому | таблица-жгутов, детали | [Д] | разъём JST EH 3 pin корпус и контакты | JST EHR-03 housing + SEH crimp contacts | JST EH 3P 胶壳 端子 | https://mobile.yangkeduo.com/search_result.html |  |  |  |  | аналог | размер и количество | 1
9. Провода, кабели шин, разъёмы и расходники | Припой с флюсом 0,8 мм + флюс | 1 | 0 | 1 | компл. | пайка жгутов, блока контактов замка | таблица-жгутов, детали | [Д] | припой 0,8 мм с флюсом | solder wire 0.8mm rosin core | 焊锡丝 0.8mm | https://mobile.yangkeduo.com/search_result.html?search_key=%E7%84%8A%E9%94%A1%E4%B8%9D%200.8mm |  |  |  |  | аналог | размер и количество | 1
9. Провода, кабели шин, разъёмы и расходники | Эпоксидный клей двухкомпонентный | 1 | 0 | 1 | шт. | рёбра, магниты, шарики, датчики Холла, балласт | таблица-жгутов, детали | [Д] | эпоксидный клей 5 мин | 2-part epoxy 5 min | 环氧树脂 AB胶 | https://mobile.yangkeduo.com/search_result.html |  |  |  |  | аналог | размер и количество | 1
9. Провода, кабели шин, разъёмы и расходники | Фиксатор резьбы средней прочности | 1 | 0 | 1 | шт. | винты рогов и корпусов серво | таблица-жгутов, детали | [Д] | фиксатор резьбы средней прочности | threadlocker medium (blue) | 螺纹胶 中强度 蓝色 | https://mobile.yangkeduo.com/search_result.html |  |  |  |  | аналог | размер и количество | 1
9. Провода, кабели шин, разъёмы и расходники | Стяжки нейлоновые 2,5 × 100 | 100 | 0 | 100 | шт. | кабели ног и рук | таблица-жгутов, детали | [Д] | стяжки 2,5х100 | cable ties 2.5x100 | 尼龙扎带 2.5x100 | https://mobile.yangkeduo.com/search_result.html |  |  |  |  | аналог | размер и количество | 1
9. Провода, кабели шин, разъёмы и расходники | Термоусадка, набор | 1 | 0 | 1 | компл. | разъёмы, пайка | таблица-жгутов, детали | [Д] | термоусадка набор | heat shrink tubing kit | 热缩管 套装 | https://mobile.yangkeduo.com/search_result.html |  |  |  |  | аналог | размер и количество | 1
9. Провода, кабели шин, разъёмы и расходники | Липучка-ремень 20 мм × 300 мм | 2 | 0 | 2 | шт. | фиксация батареи в лотке | таблица-жгутов, детали | [Д] | липучка ремень 20 мм | velcro strap 20mm | 魔术贴 绑带 20mm | https://mobile.yangkeduo.com/search_result.html |  |  |  |  | аналог | размер и количество | 1
9. Провода, кабели шин, разъёмы и расходники | Пенорезина самоклеящаяся 3 мм | 1 | 0 | 1 | лист | прокладки, виброизоляция плат | таблица-жгутов, детали | [Д] | резина самоклеящаяся 3 мм | adhesive foam 3mm | 自粘 泡棉 3mm | https://mobile.yangkeduo.com/search_result.html |  |  |  |  | аналог | размер и количество | 1
9. Провода, кабели шин, разъёмы и расходники | Защитная гофра / кромочная лента для кабельных проходов | 1 | 0 | 1 | компл. | 9 кабельных проходов оболочки (таблица отверстий 01.001) | таблица-жгутов, детали | [Д] | гофра для кабеля | split loom tubing / edge grommet | 波纹管 开口 保护 | https://mobile.yangkeduo.com/search_result.html |  |  |  |  | аналог | размер и количество | 1
