pilot443/avad-s0/parts/KRB.S0.01.001_obolochka.png

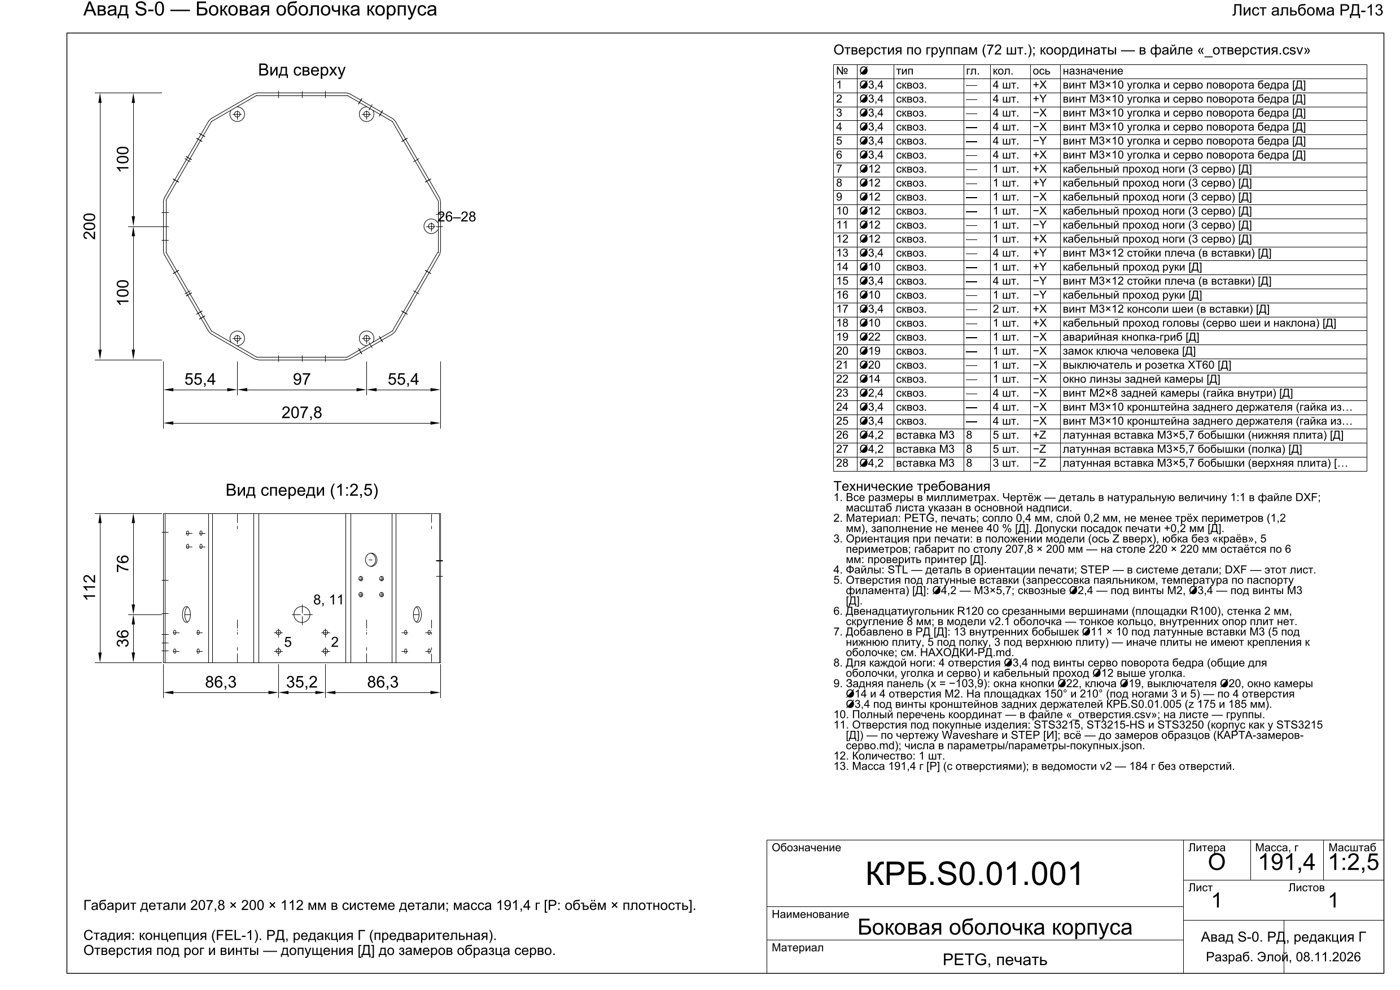
parts/KRB.S0.01.001_obolochka.png
