pilot443/avad-s0/parts/KRB.S0.01.002_plita-nizhnyaya.png

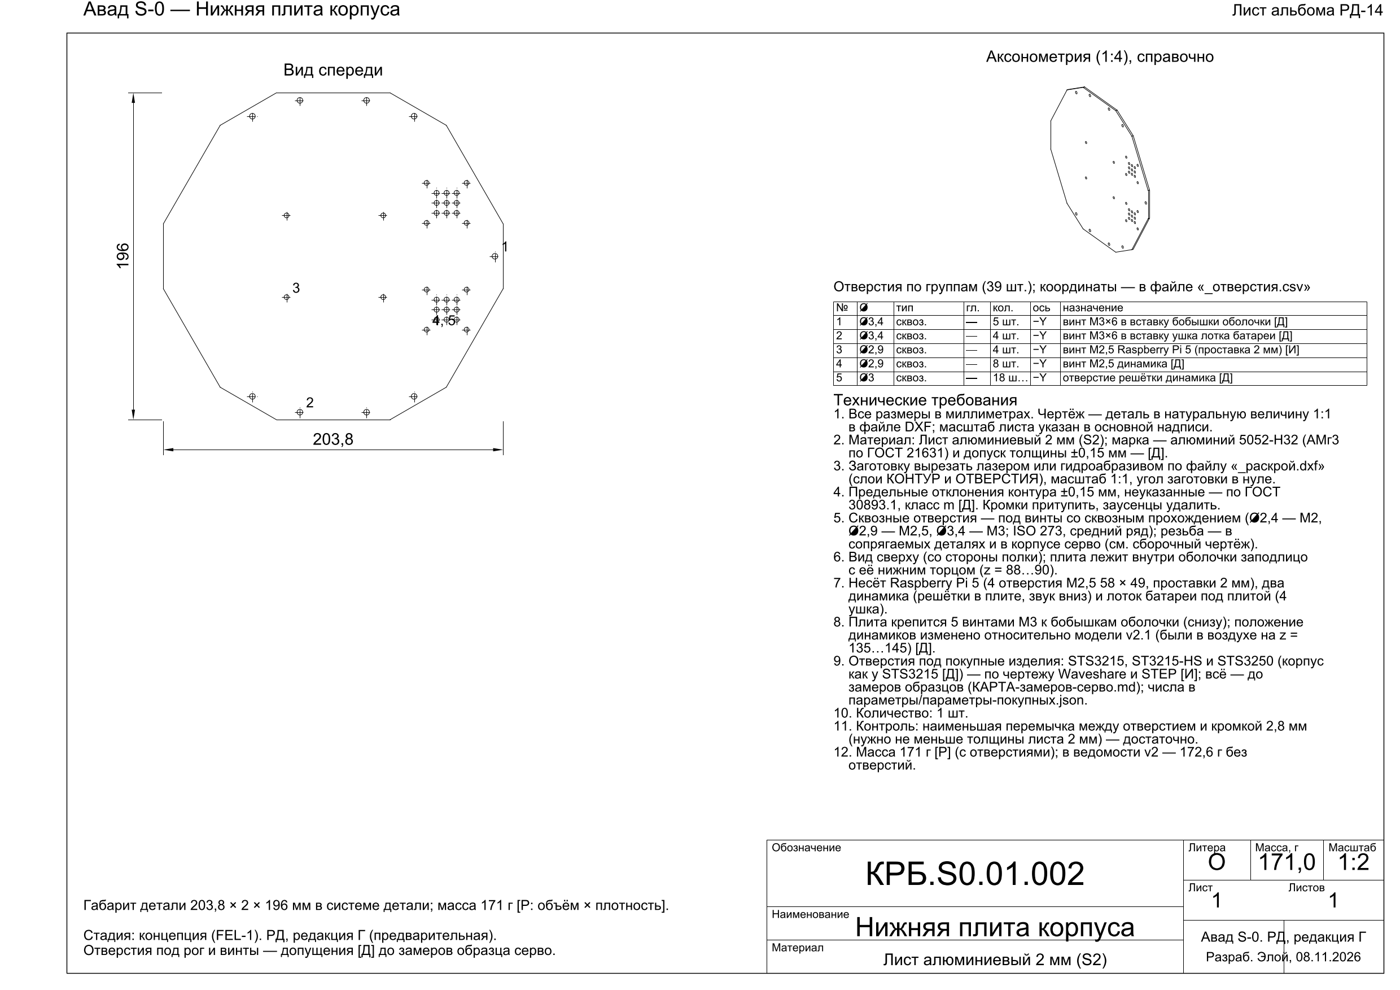
parts/KRB.S0.01.002_plita-nizhnyaya.png
