pilot443/avad-s0/parts/KRB.S0.01.003_plita-verhnyaya.png

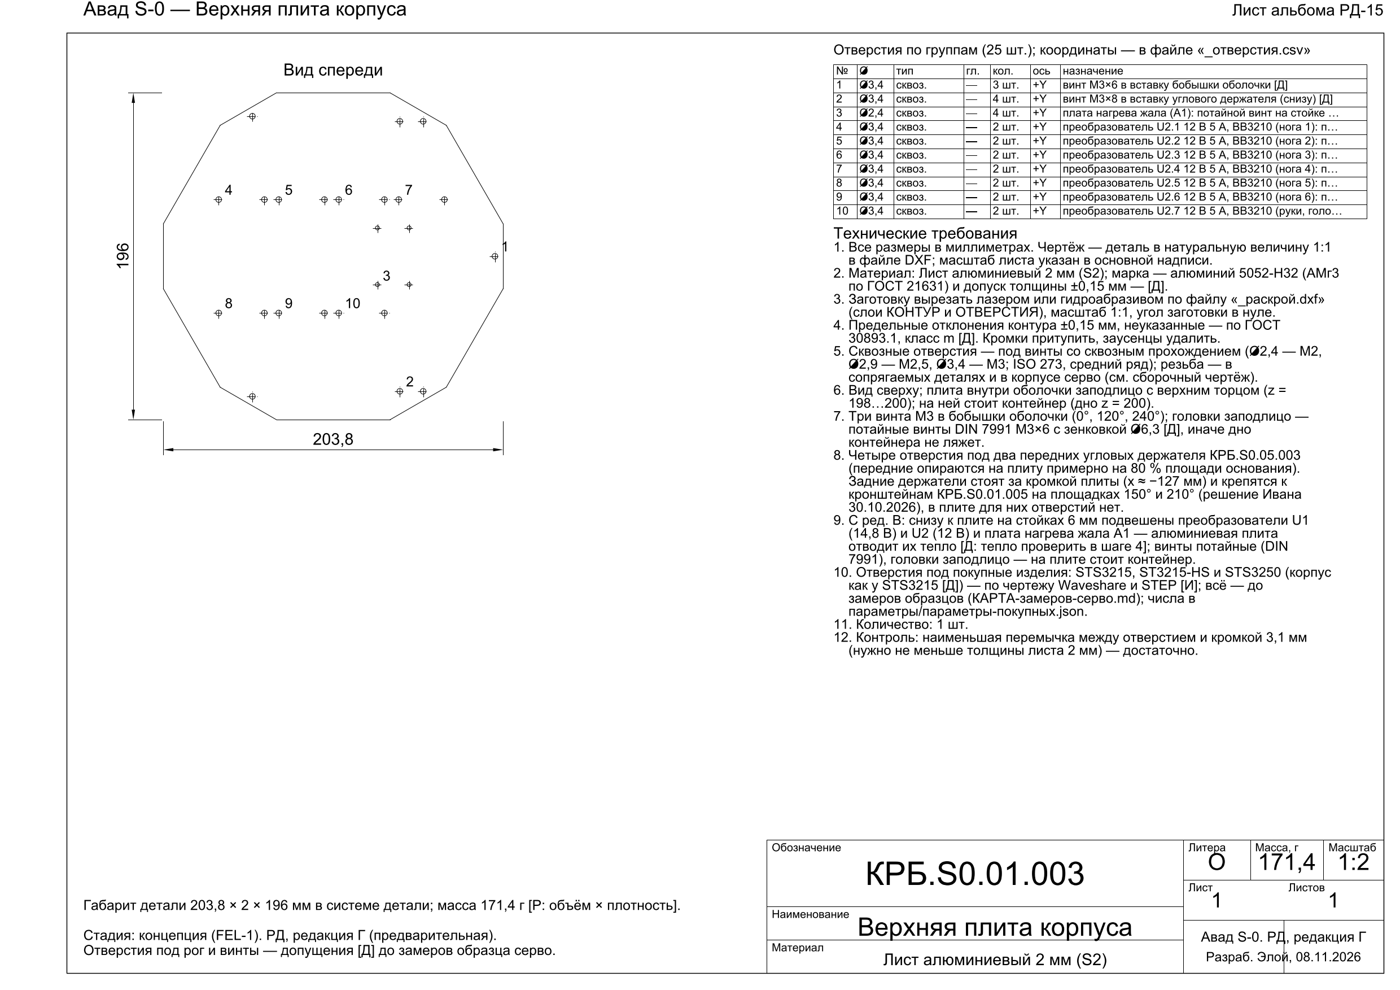
parts/KRB.S0.01.003_plita-verhnyaya.png
