pilot443/avad-s0/parts/KRB.S0.01.005_kronshtein-derzhatelya.png

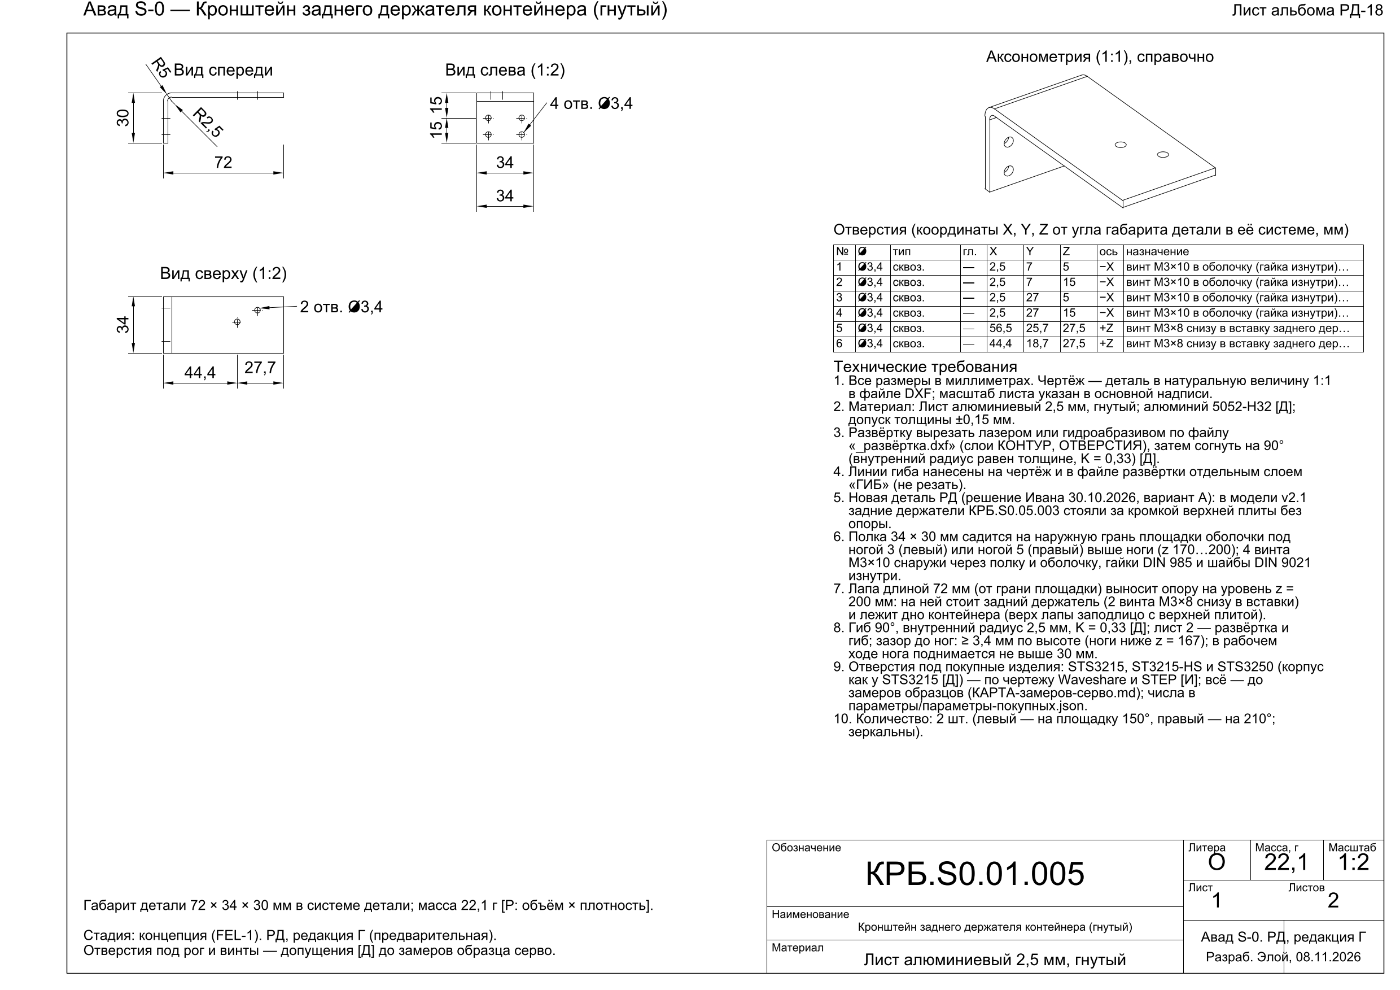
parts/KRB.S0.01.005_kronshtein-derzhatelya.png
