pilot443/avad-s0/parts/KRB.S0.01.005_razvertka.png

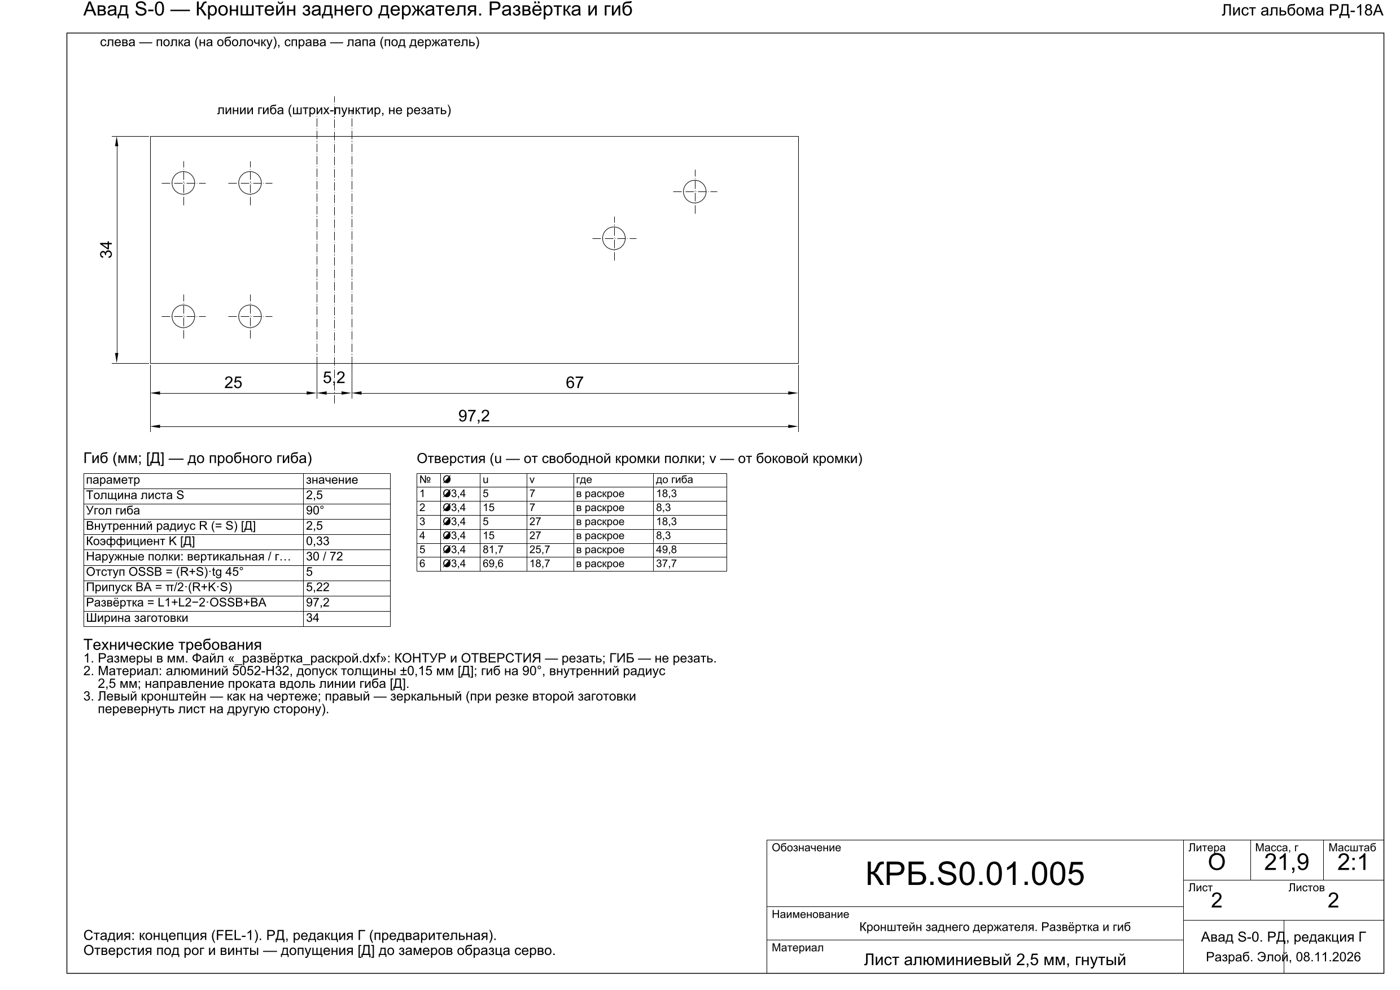
parts/KRB.S0.01.005_razvertka.png
