pilot443/avad-s0/parts/KRB.S0.02.001_ugolok-povorota-bedra.png

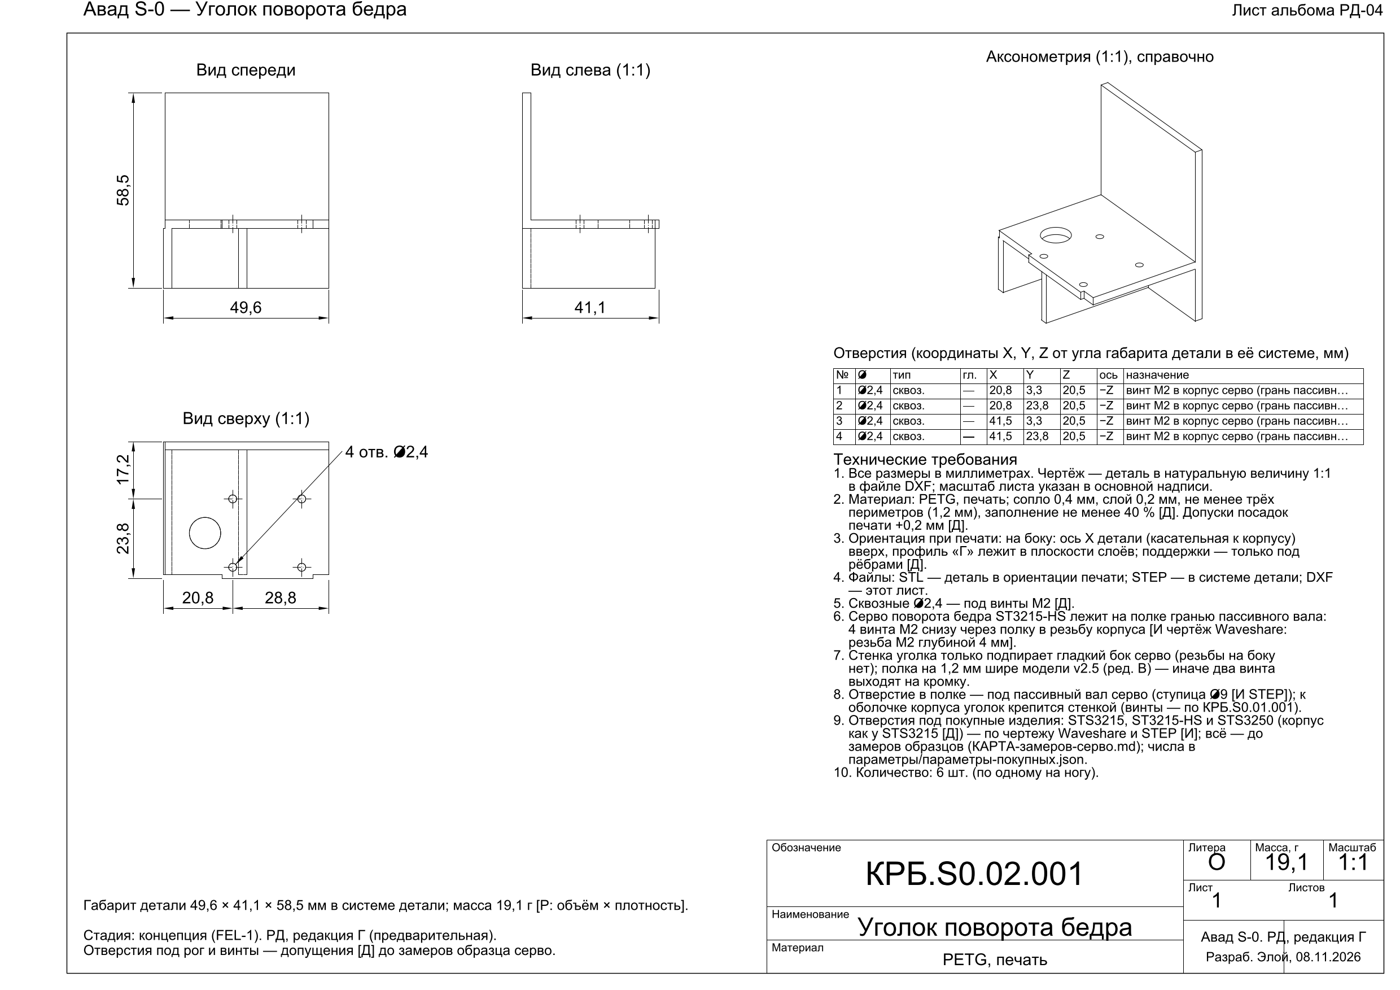
parts/KRB.S0.02.001_ugolok-povorota-bedra.png
