pilot443/avad-s0/parts/KRB.S0.02.002_razvertka.png

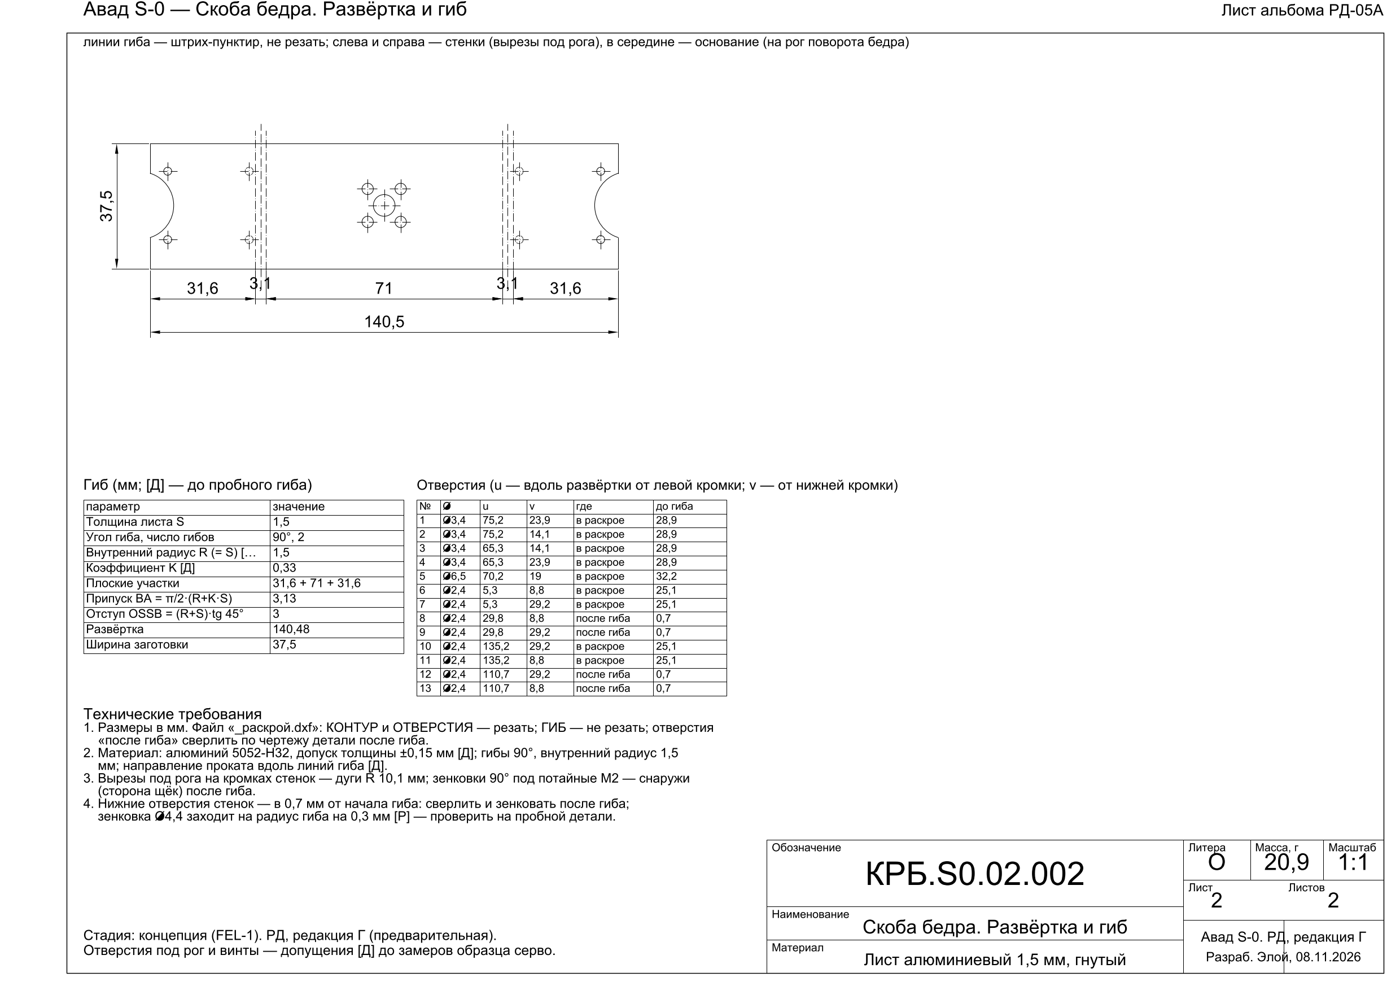
parts/KRB.S0.02.002_razvertka.png
