pilot443/avad-s0/parts/KRB.S0.02.002_skoba-bedra.png

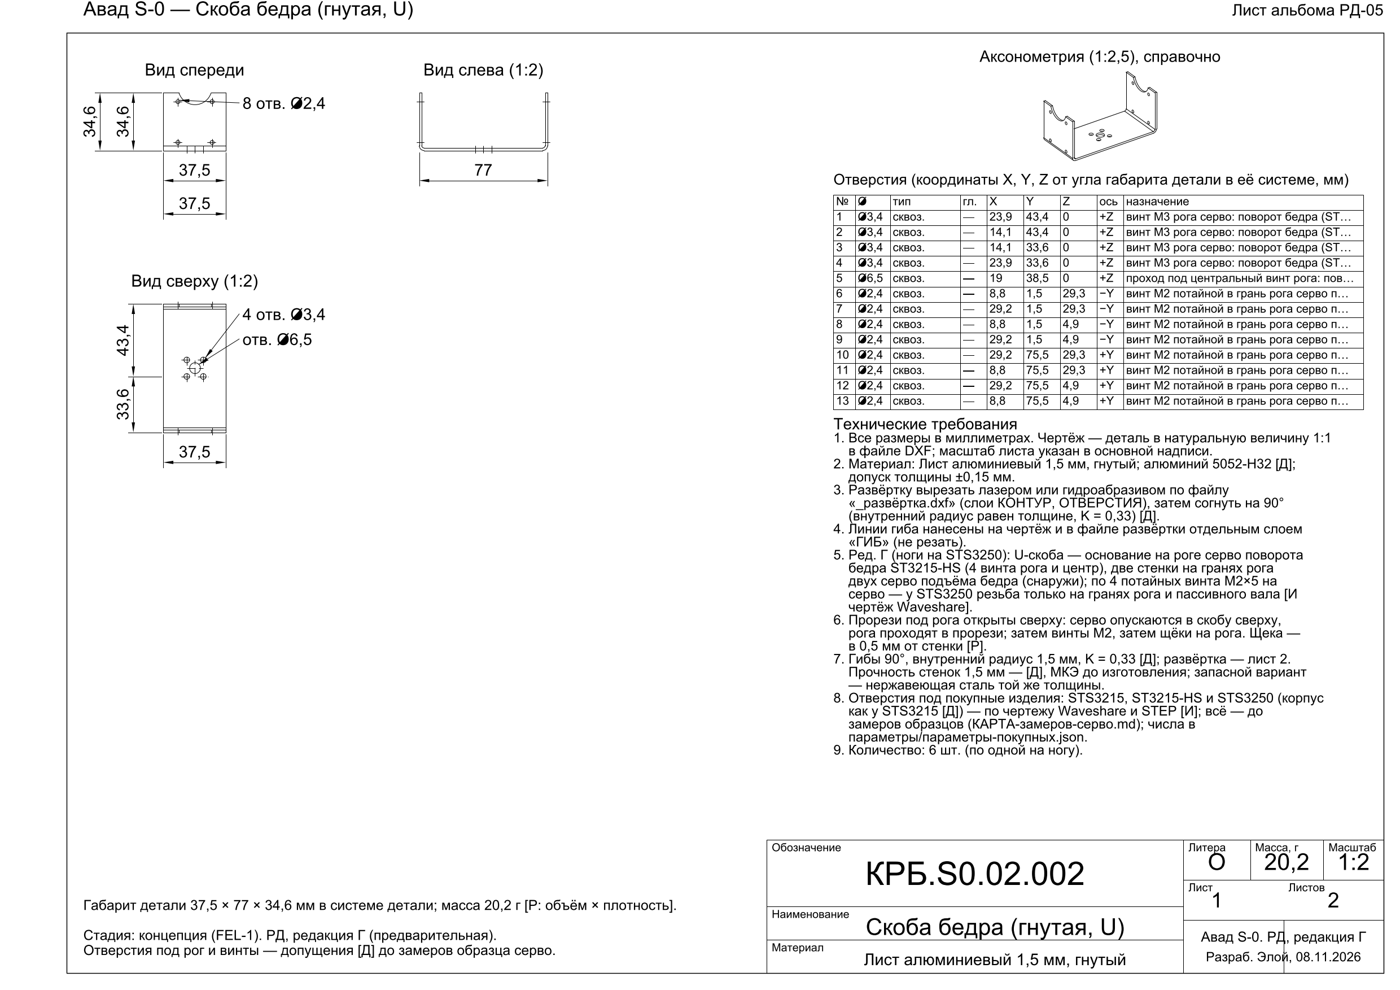
parts/KRB.S0.02.002_skoba-bedra.png
