pilot443/avad-s0/parts/KRB.S0.02.006_golen.png

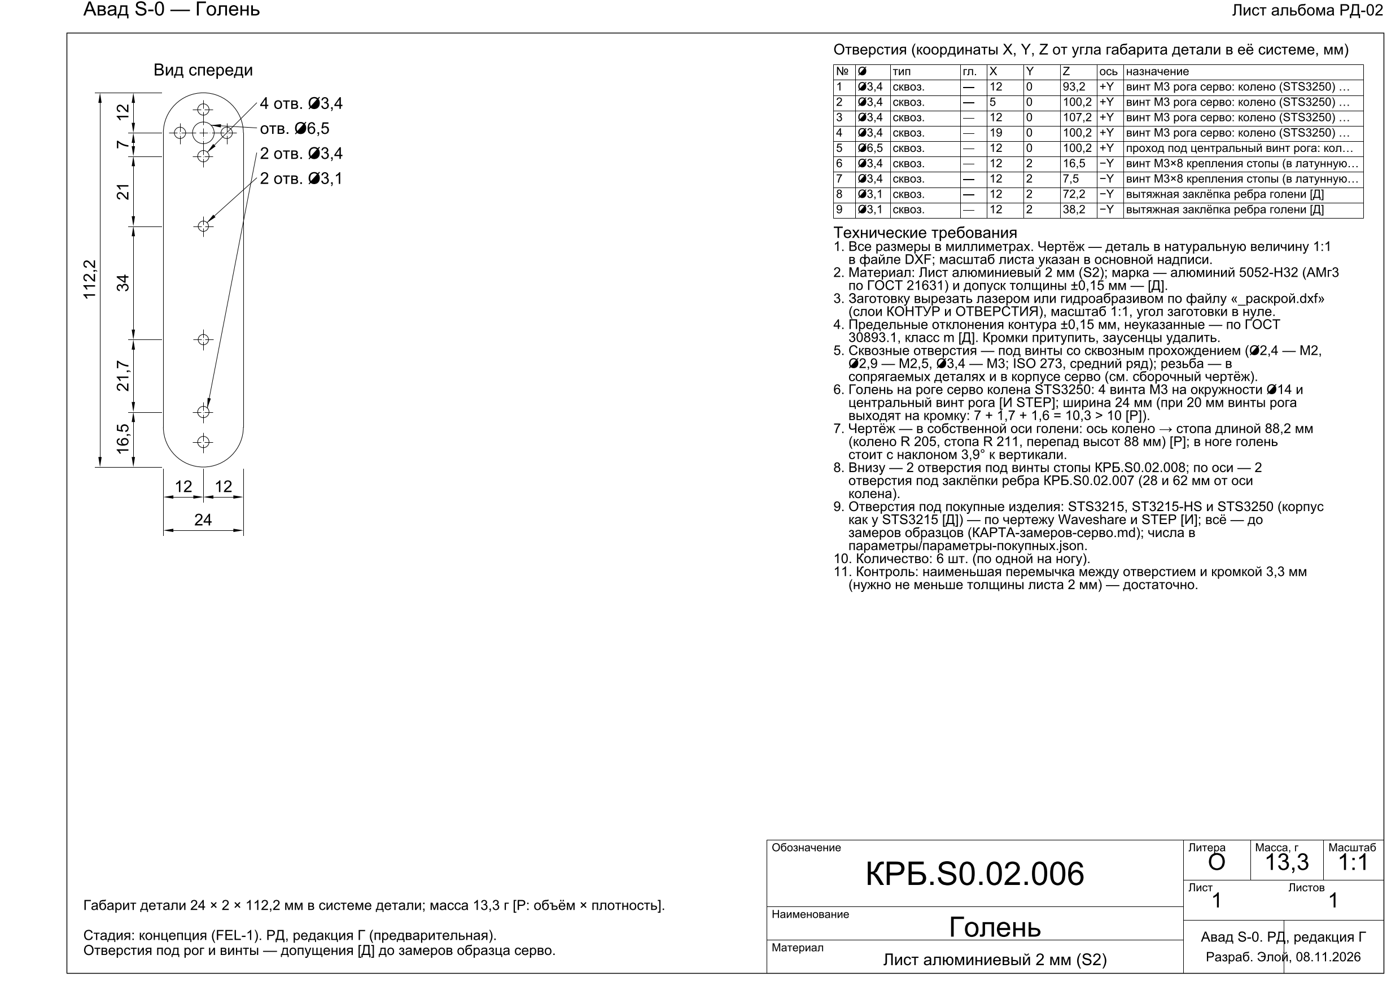
parts/KRB.S0.02.006_golen.png
