pilot443/avad-s0/parts/KRB.S0.02.008_stopa.png

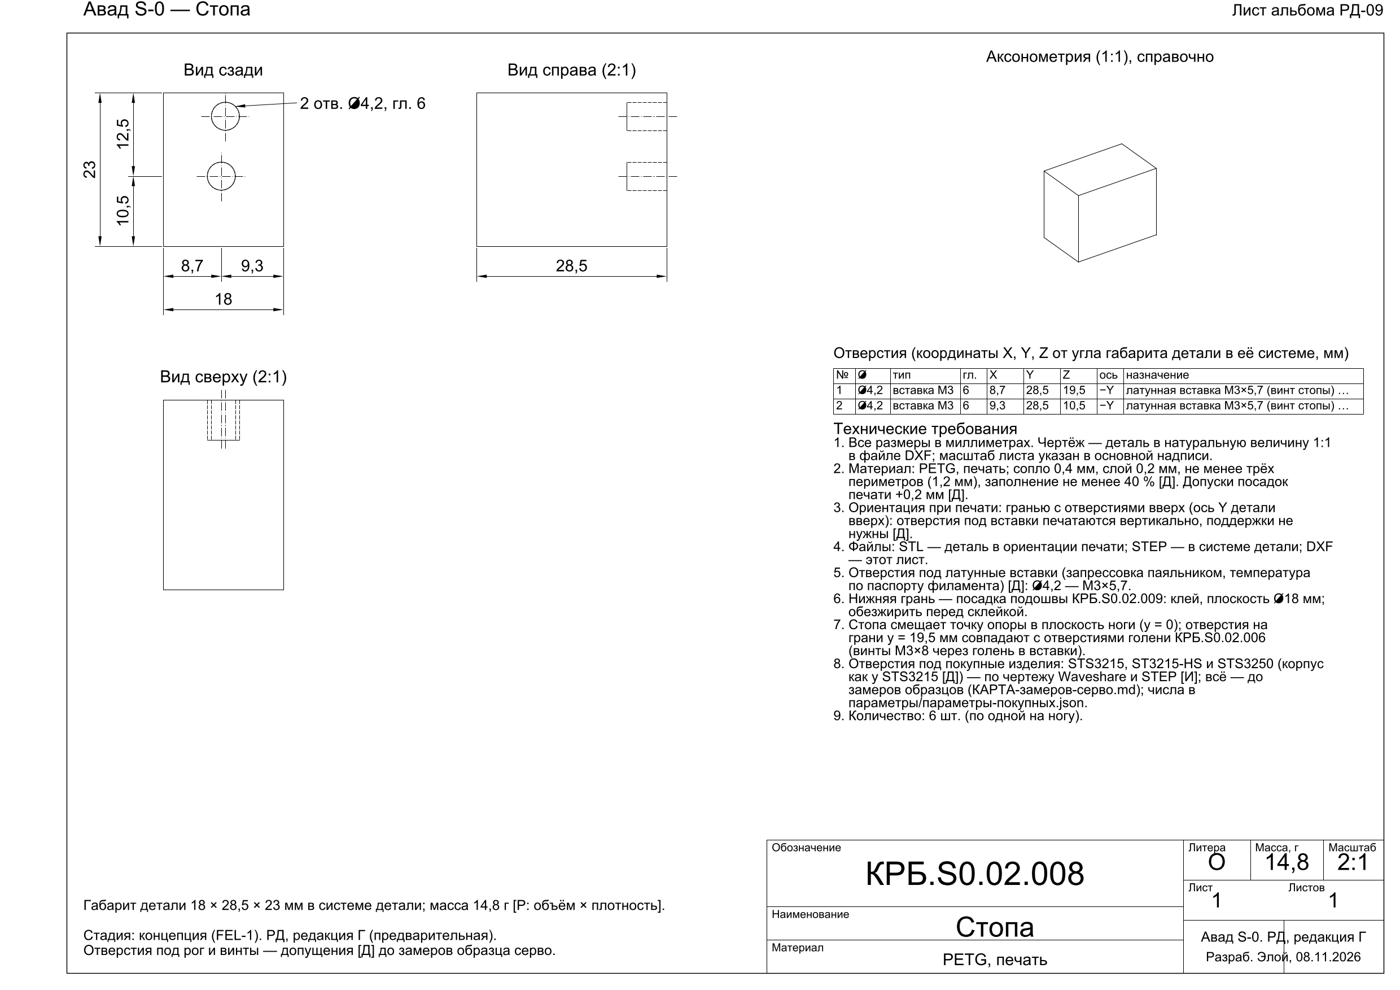
parts/KRB.S0.02.008_stopa.png
