pilot443/avad-s0/parts/KRB.S0.02.009_podoshva.png

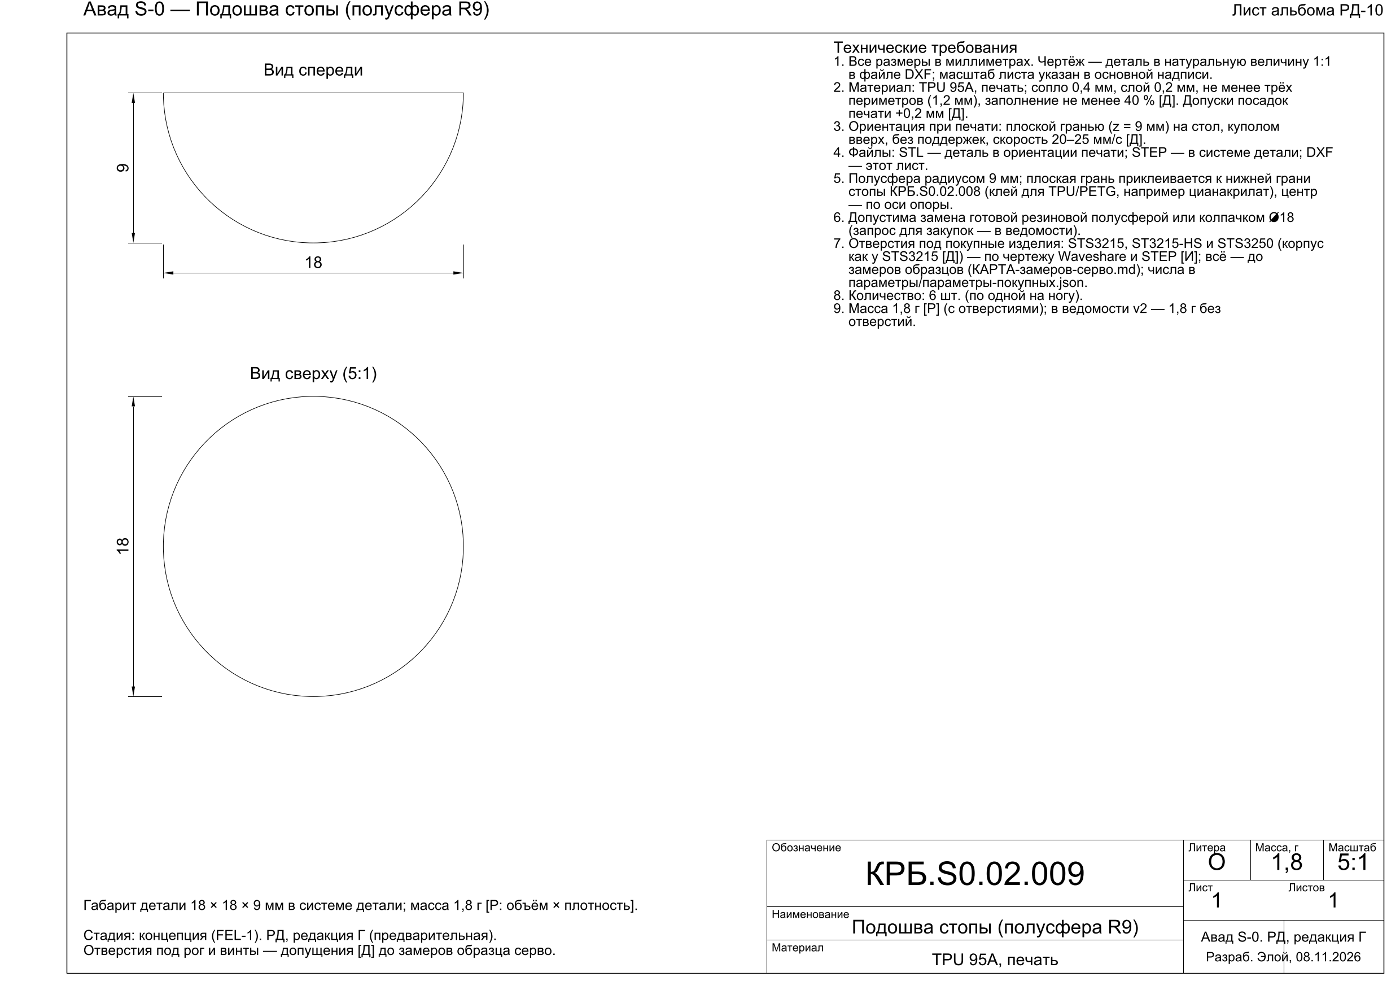
parts/KRB.S0.02.009_podoshva.png
