pilot443/avad-s0/parts/KRB.S0.02.010_ugolok-kolena.png

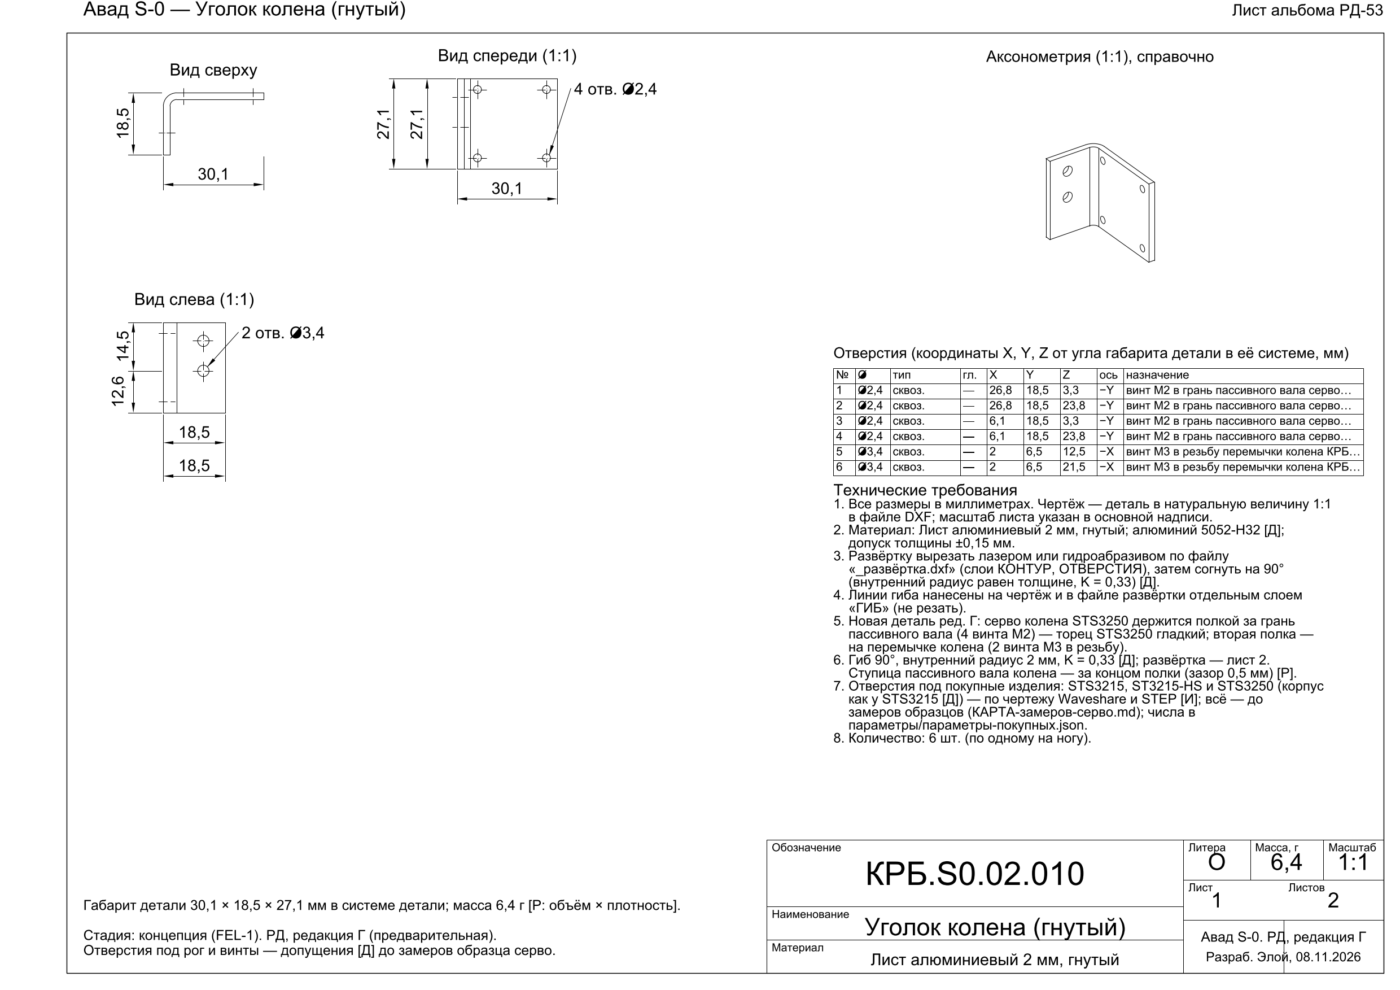
parts/KRB.S0.02.010_ugolok-kolena.png
