pilot443/avad-s0/parts/KRB.S0.03.001_ploshchadka-plecha.png

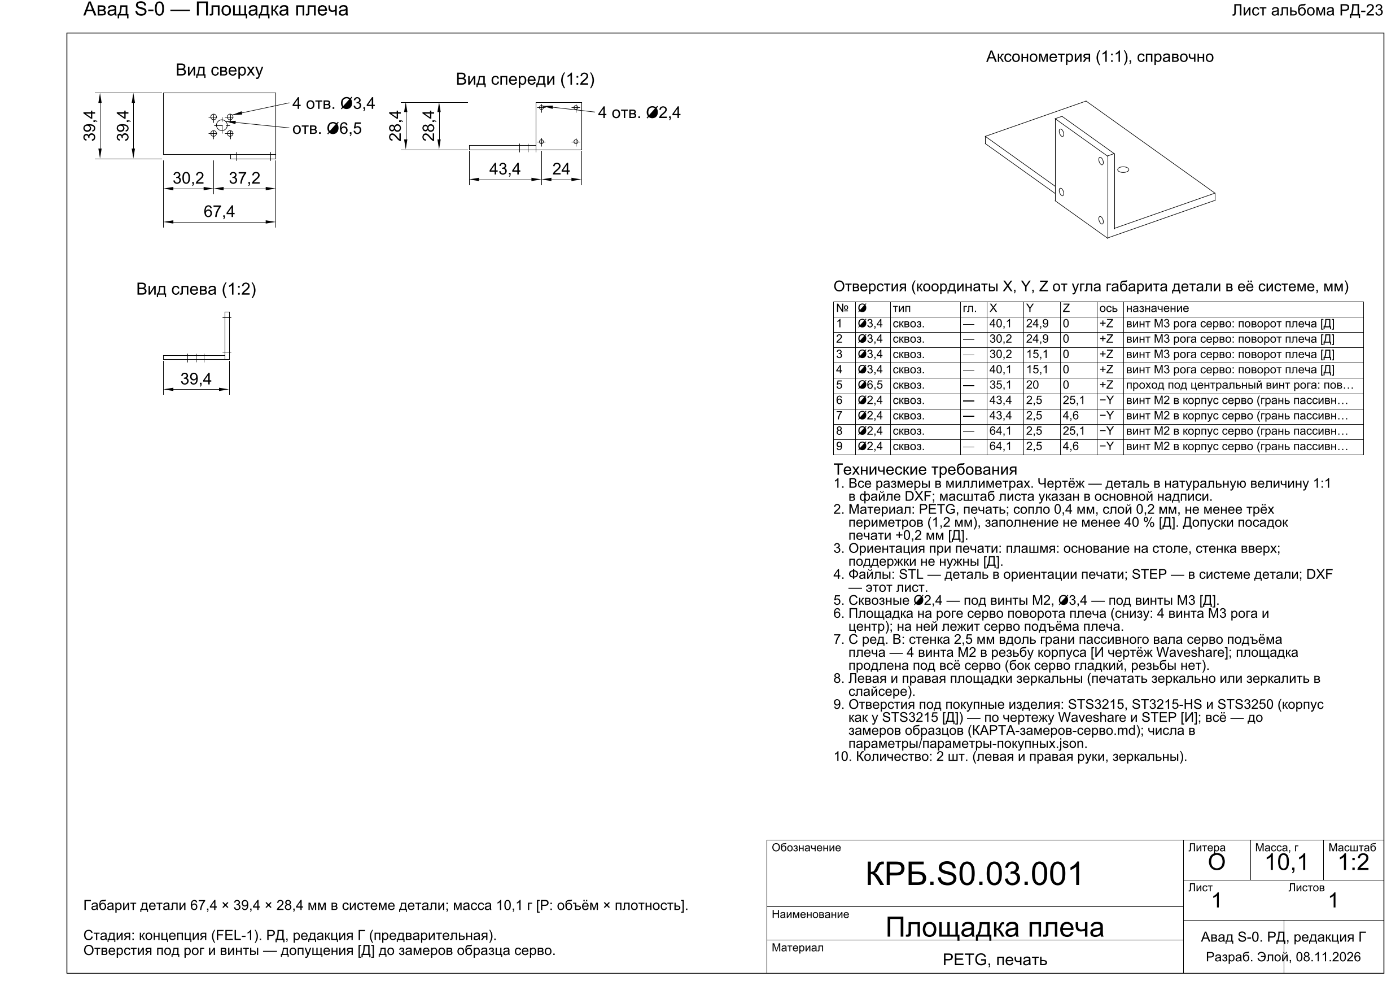
parts/KRB.S0.03.001_ploshchadka-plecha.png
