pilot443/avad-s0/parts/KRB.S0.03.004_zveno-predplechya.png

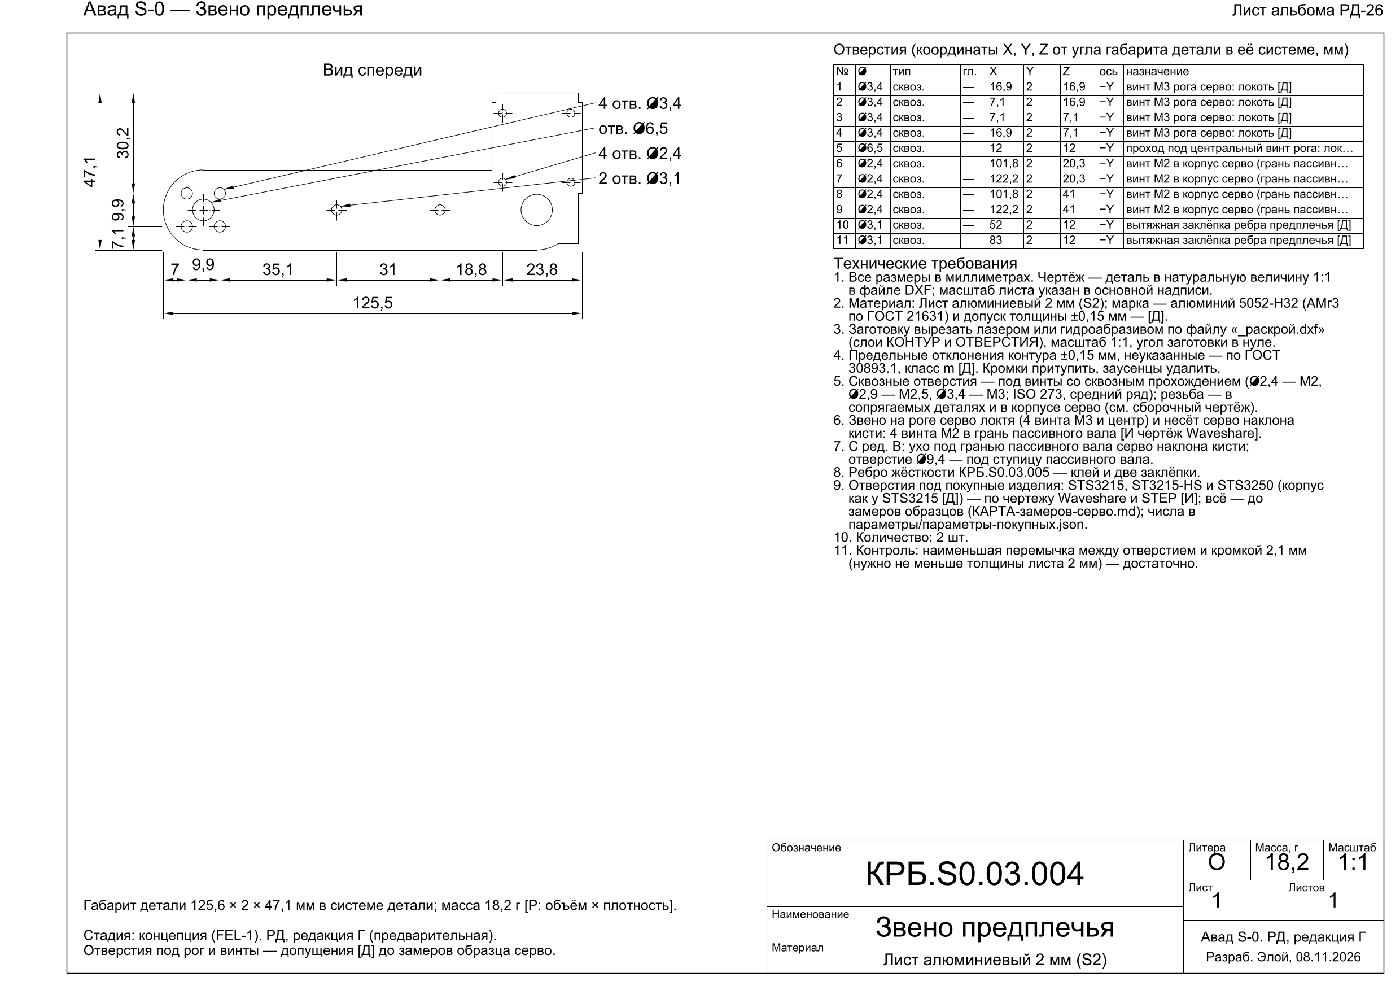
parts/KRB.S0.03.004_zveno-predplechya.png
