pilot443/avad-s0/parts/KRB.S0.03.005_rebro-predplechya.png

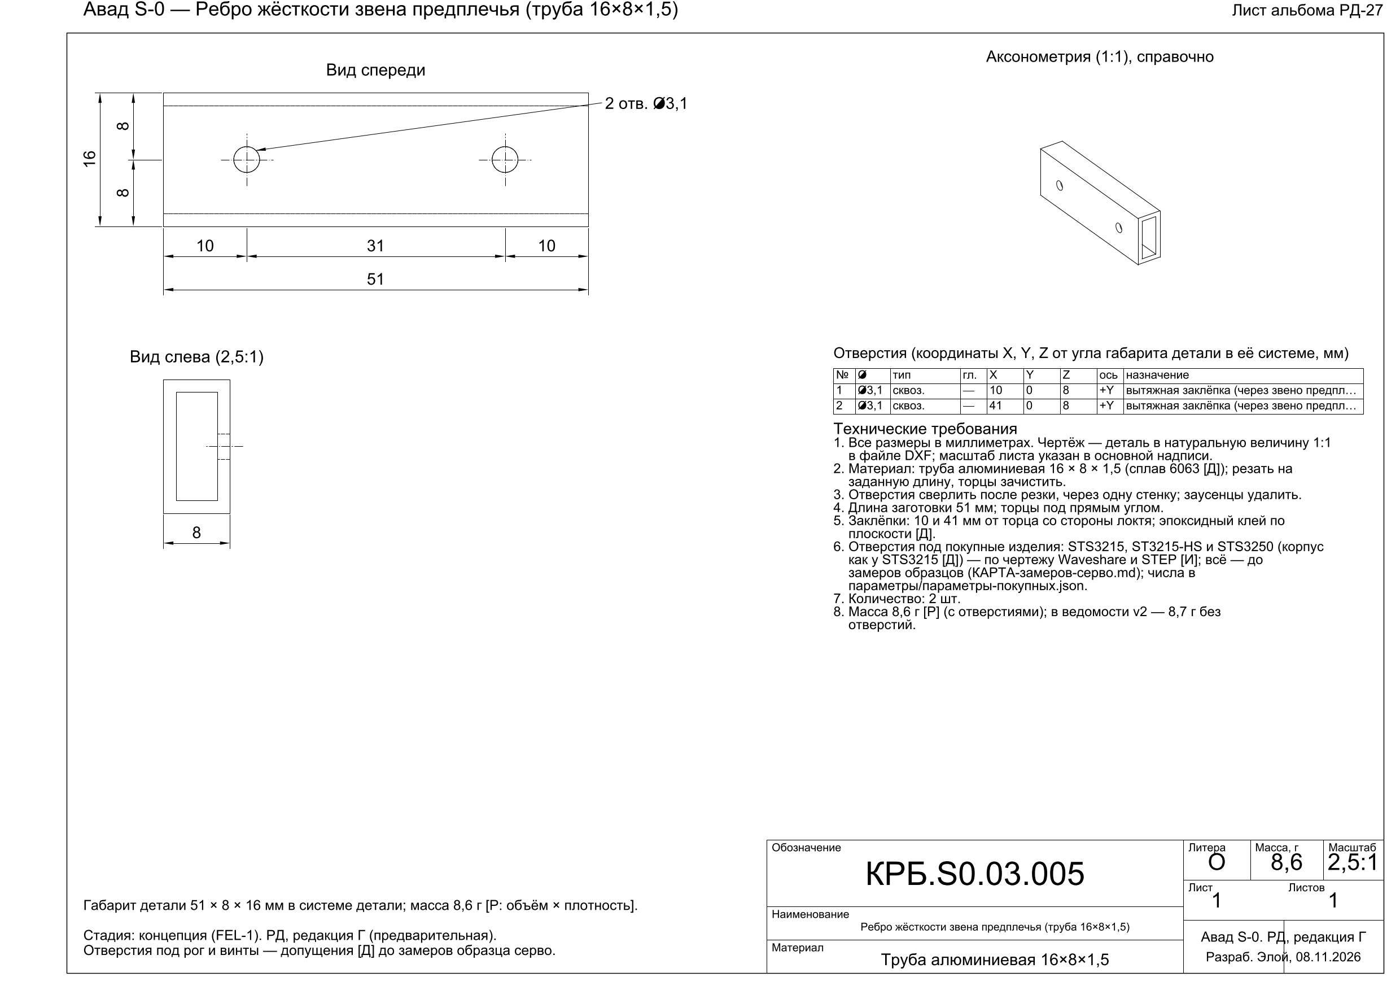
parts/KRB.S0.03.005_rebro-predplechya.png
