pilot443/avad-s0/parts/KRB.S0.03.006_plastina-kisti.png

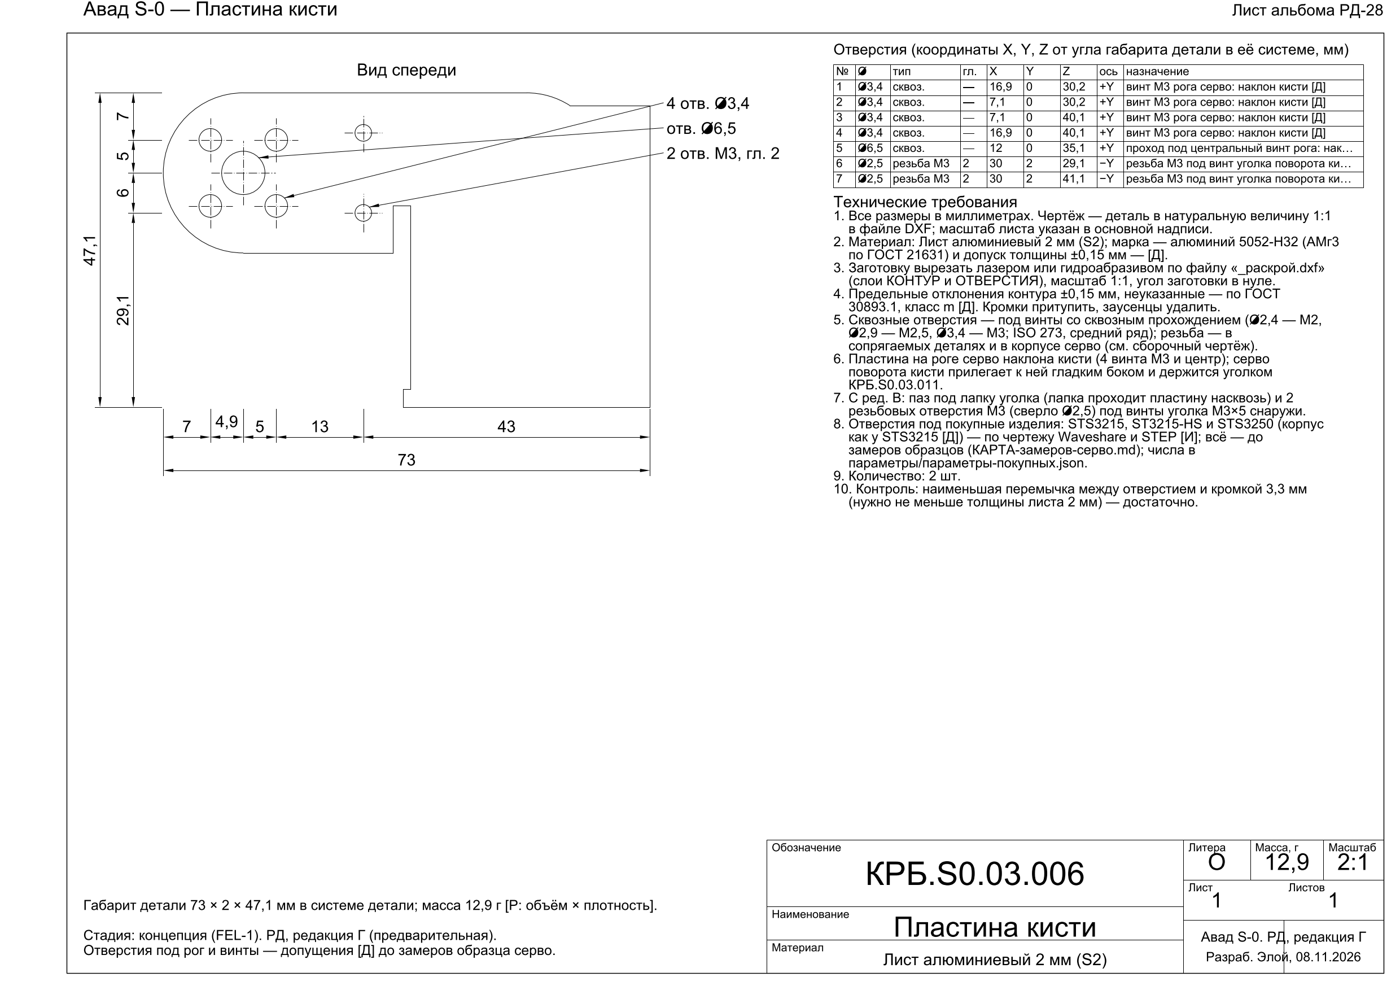
parts/KRB.S0.03.006_plastina-kisti.png
