pilot443/avad-s0/parts/KRB.S0.03.010_stoika-plecha.png

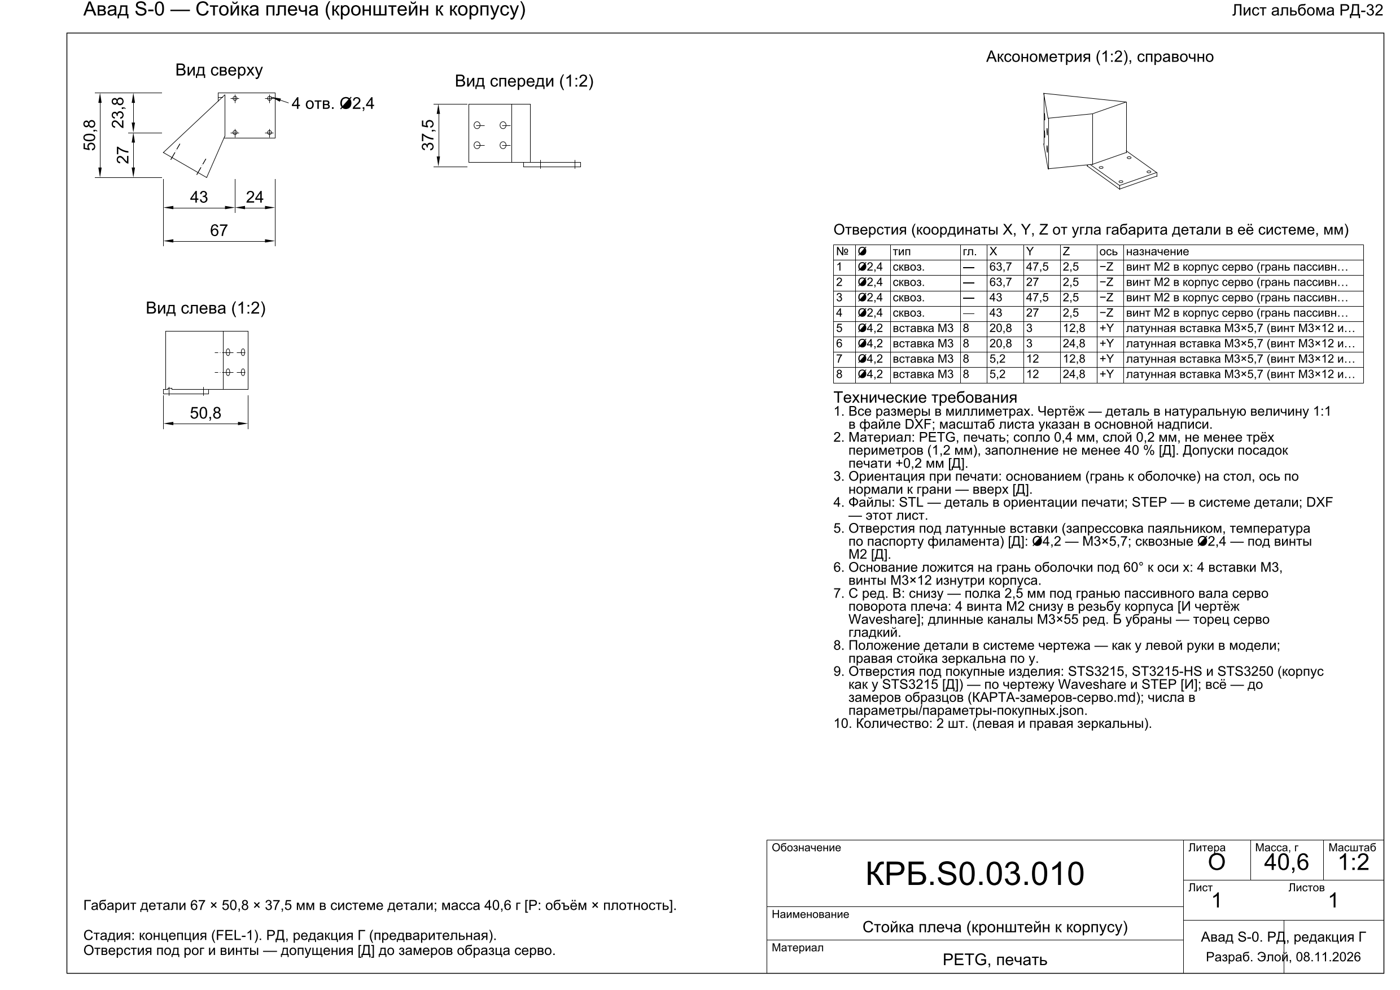
parts/KRB.S0.03.010_stoika-plecha.png
