pilot443/avad-s0/parts/KRB.S0.03.011_ugolok-povorota-kisti.png

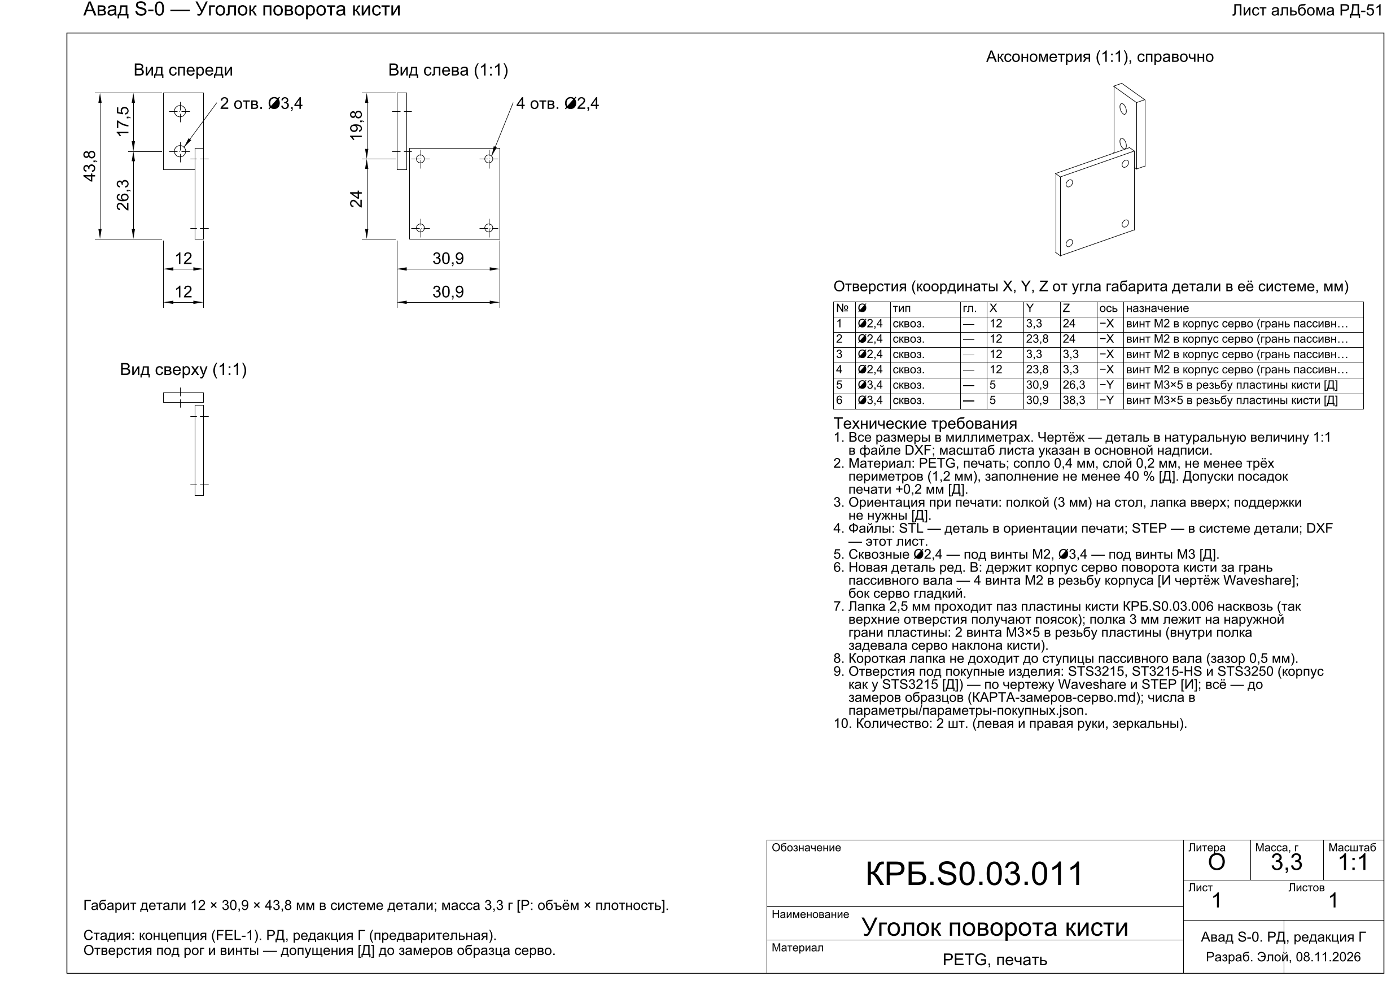
parts/KRB.S0.03.011_ugolok-povorota-kisti.png
