pilot443/avad-s0/parts/KRB.S0.04.003_konsol-shei.png

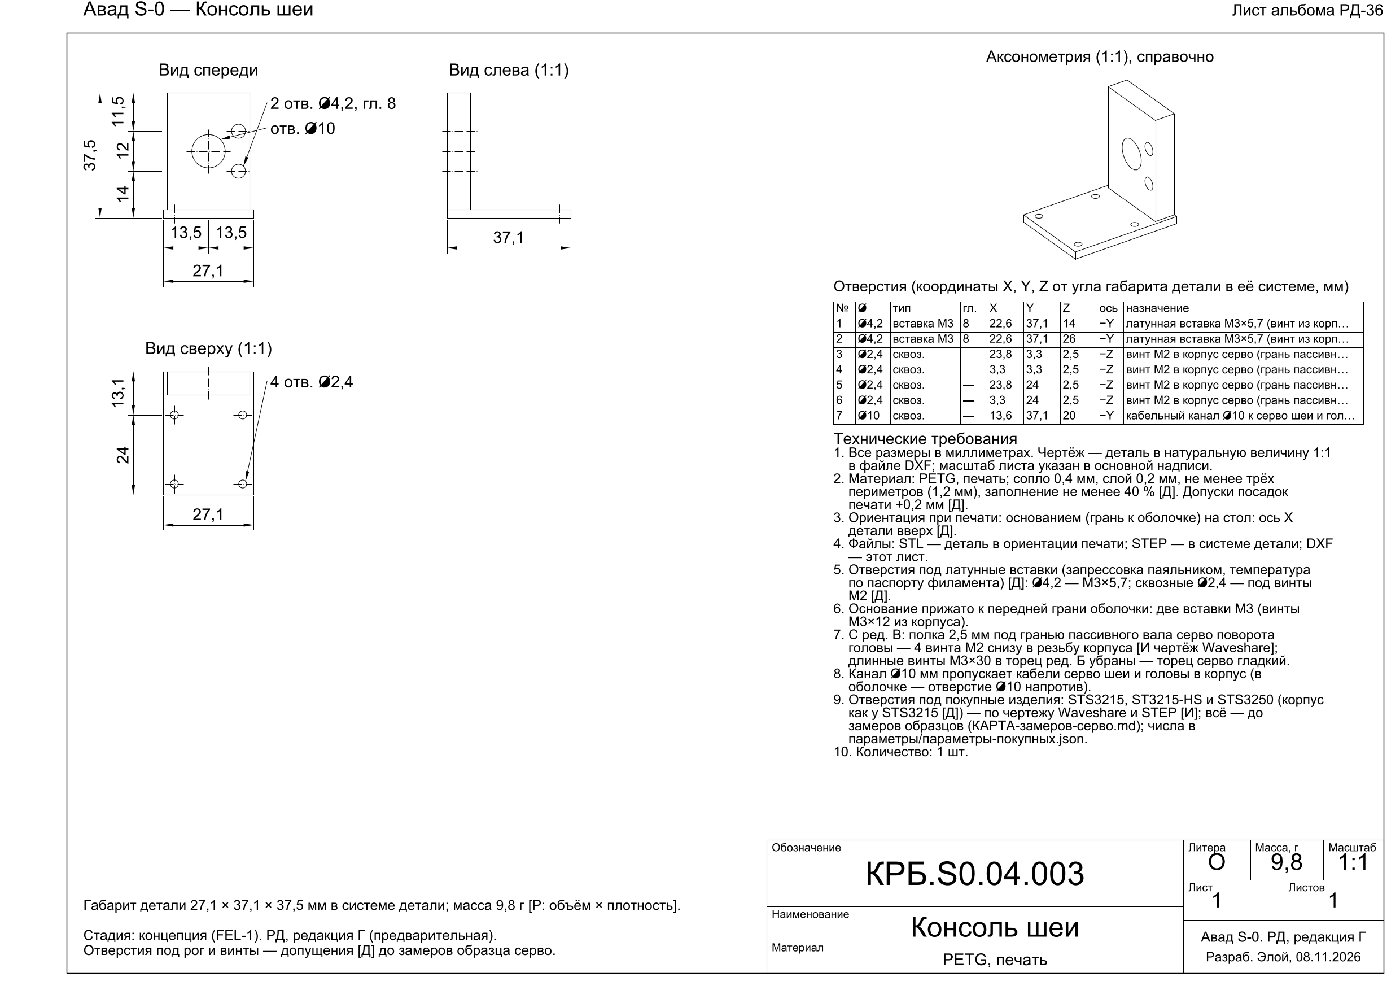
parts/KRB.S0.04.003_konsol-shei.png
