pilot443/avad-s0/parts/KRB.S0.05.001_konteiner.png

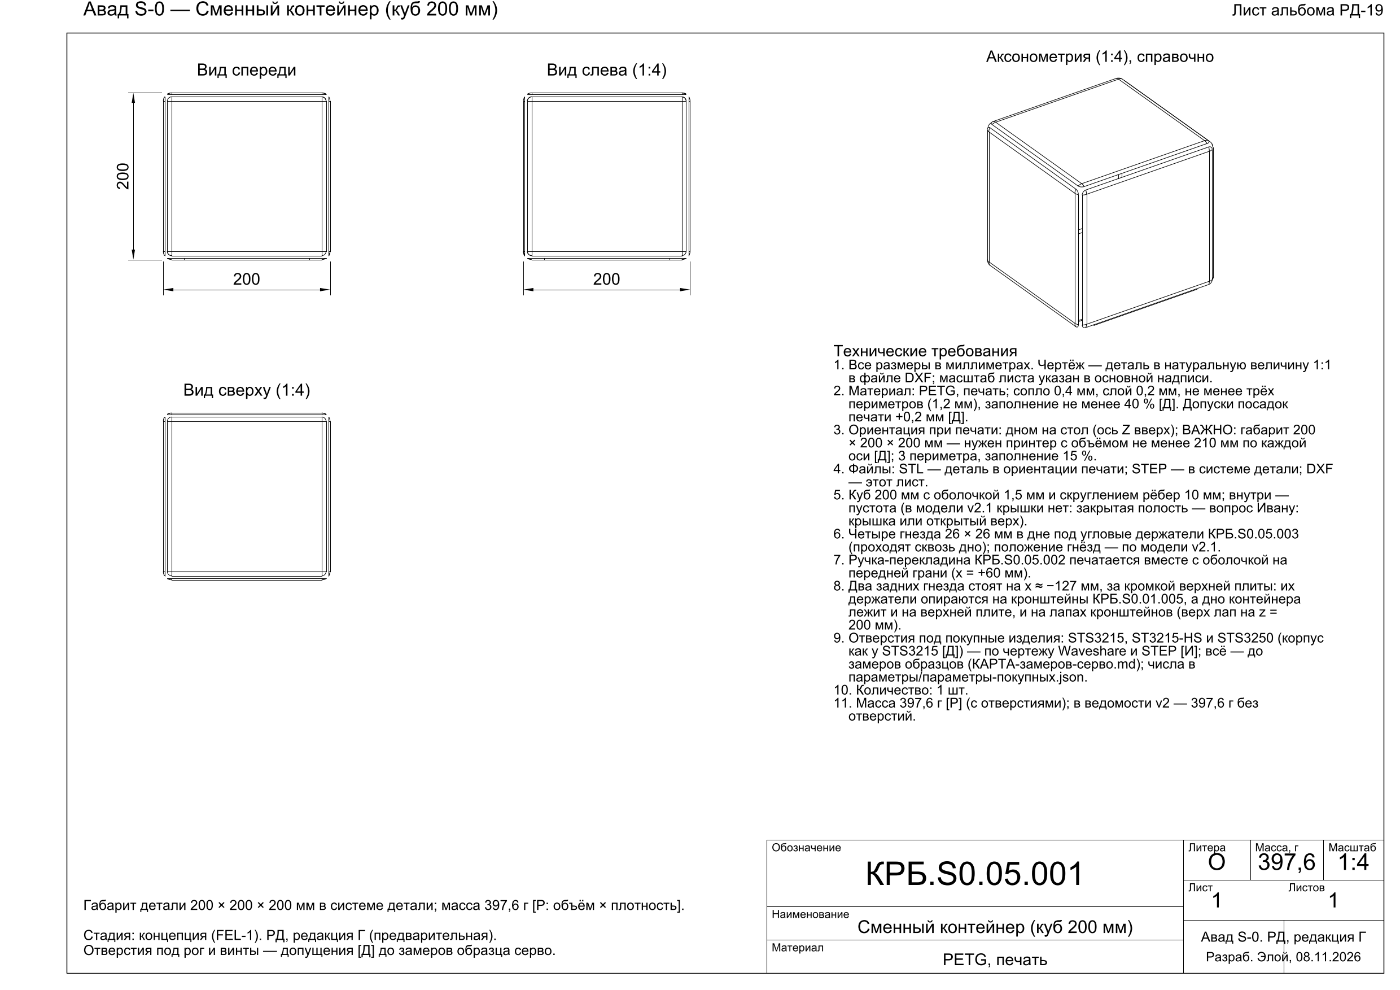
parts/KRB.S0.05.001_konteiner.png
