pilot443/avad-s0/parts/KRB.S0.05.002_ruchka.png

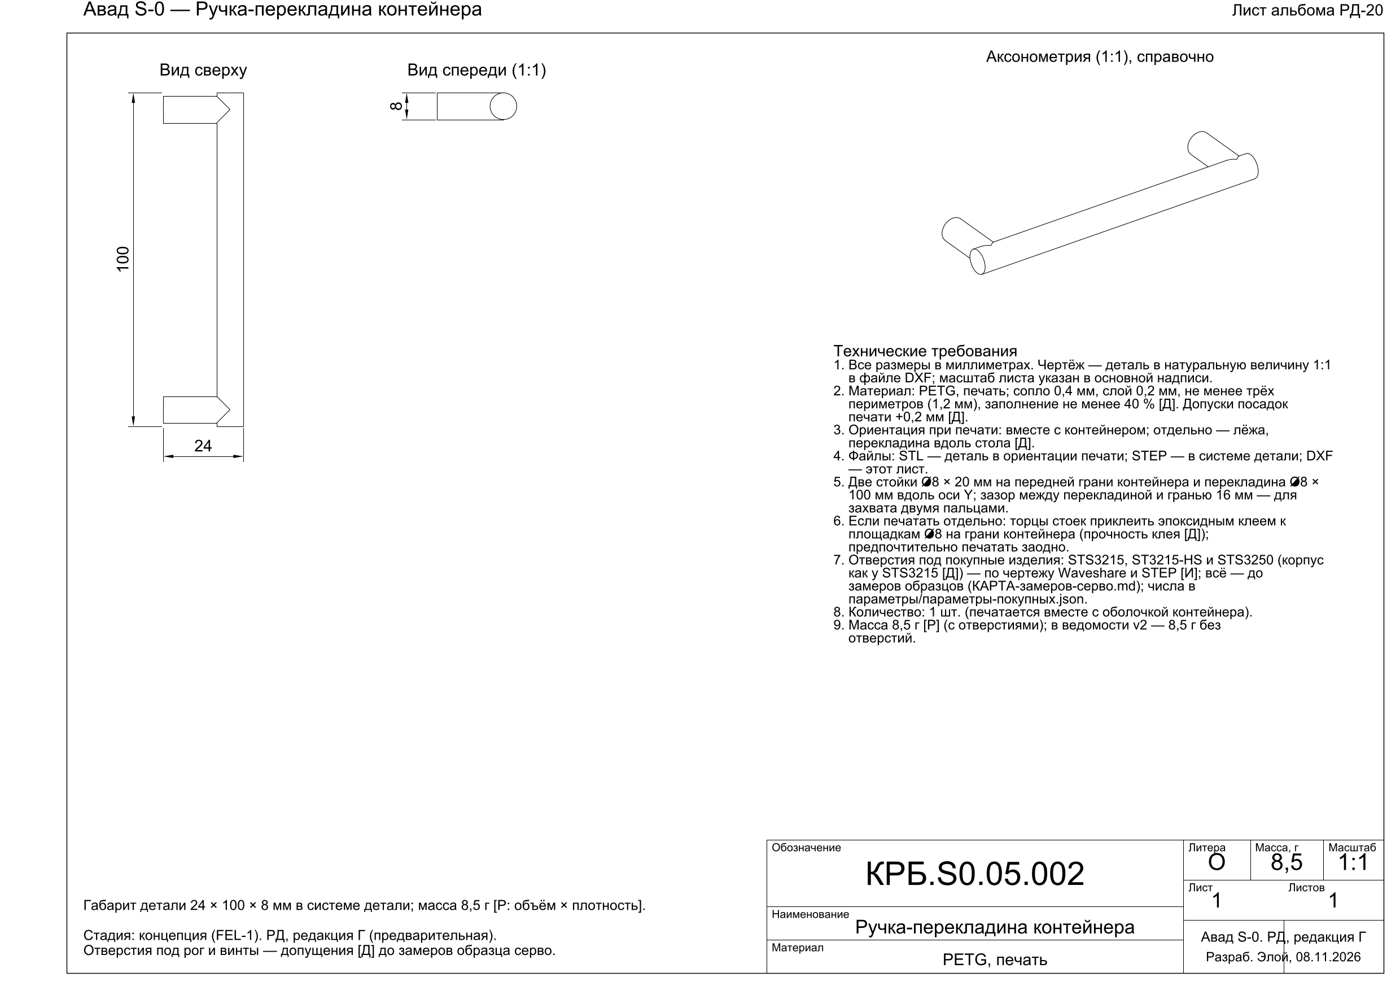
parts/KRB.S0.05.002_ruchka.png
