pilot443/avad-s0/parts/KRB.S0.05.003_derzhatel.png

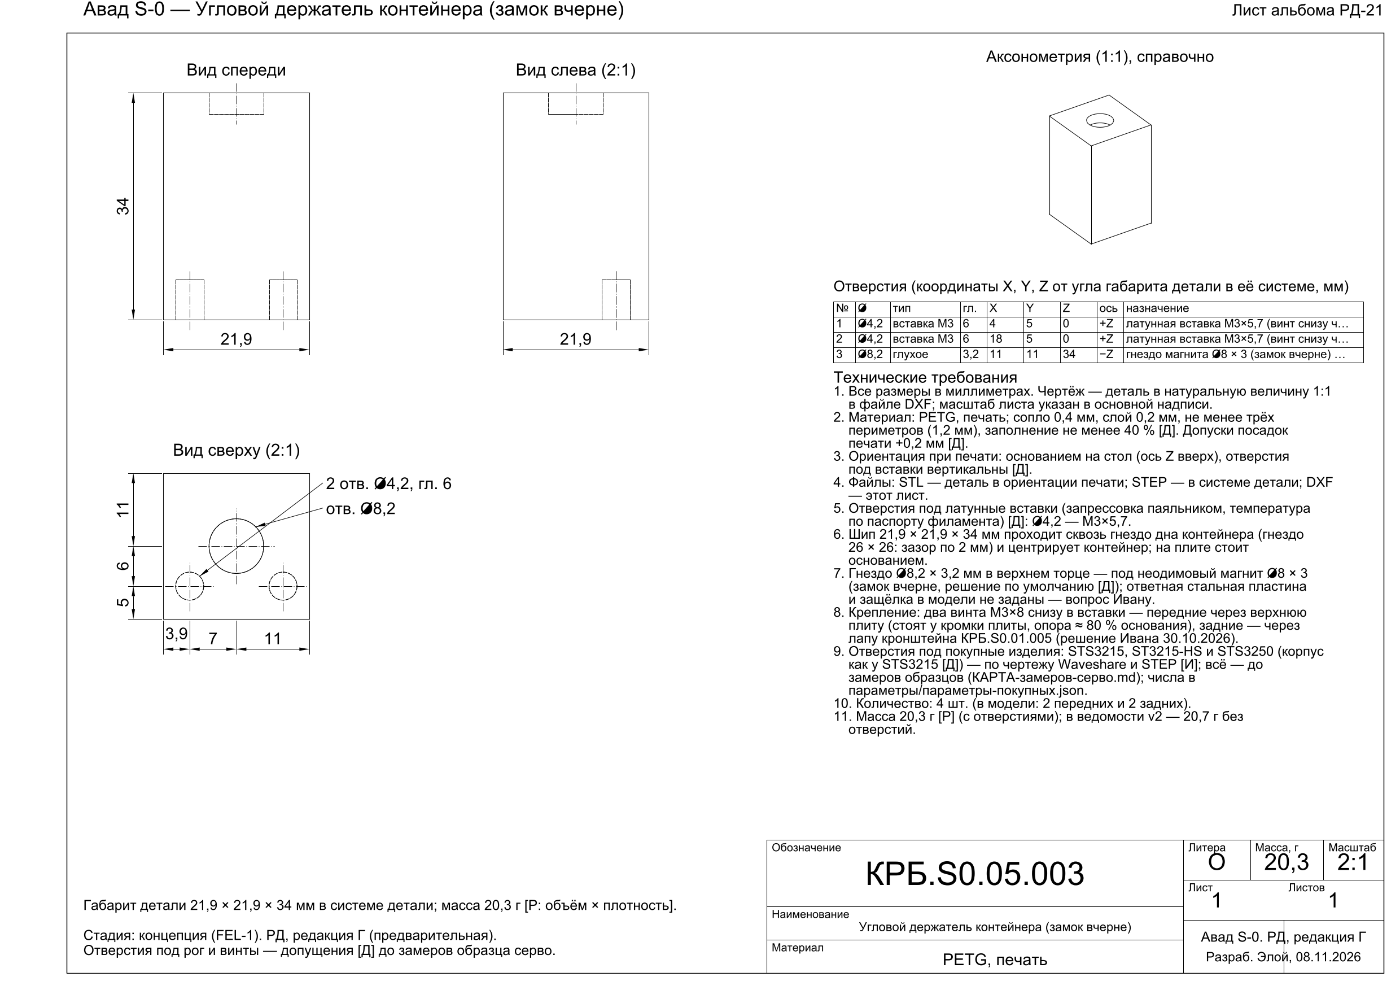
parts/KRB.S0.05.003_derzhatel.png
