pilot443/avad-s0/parts/KRB.S0.06.001_lotok-batarei.png

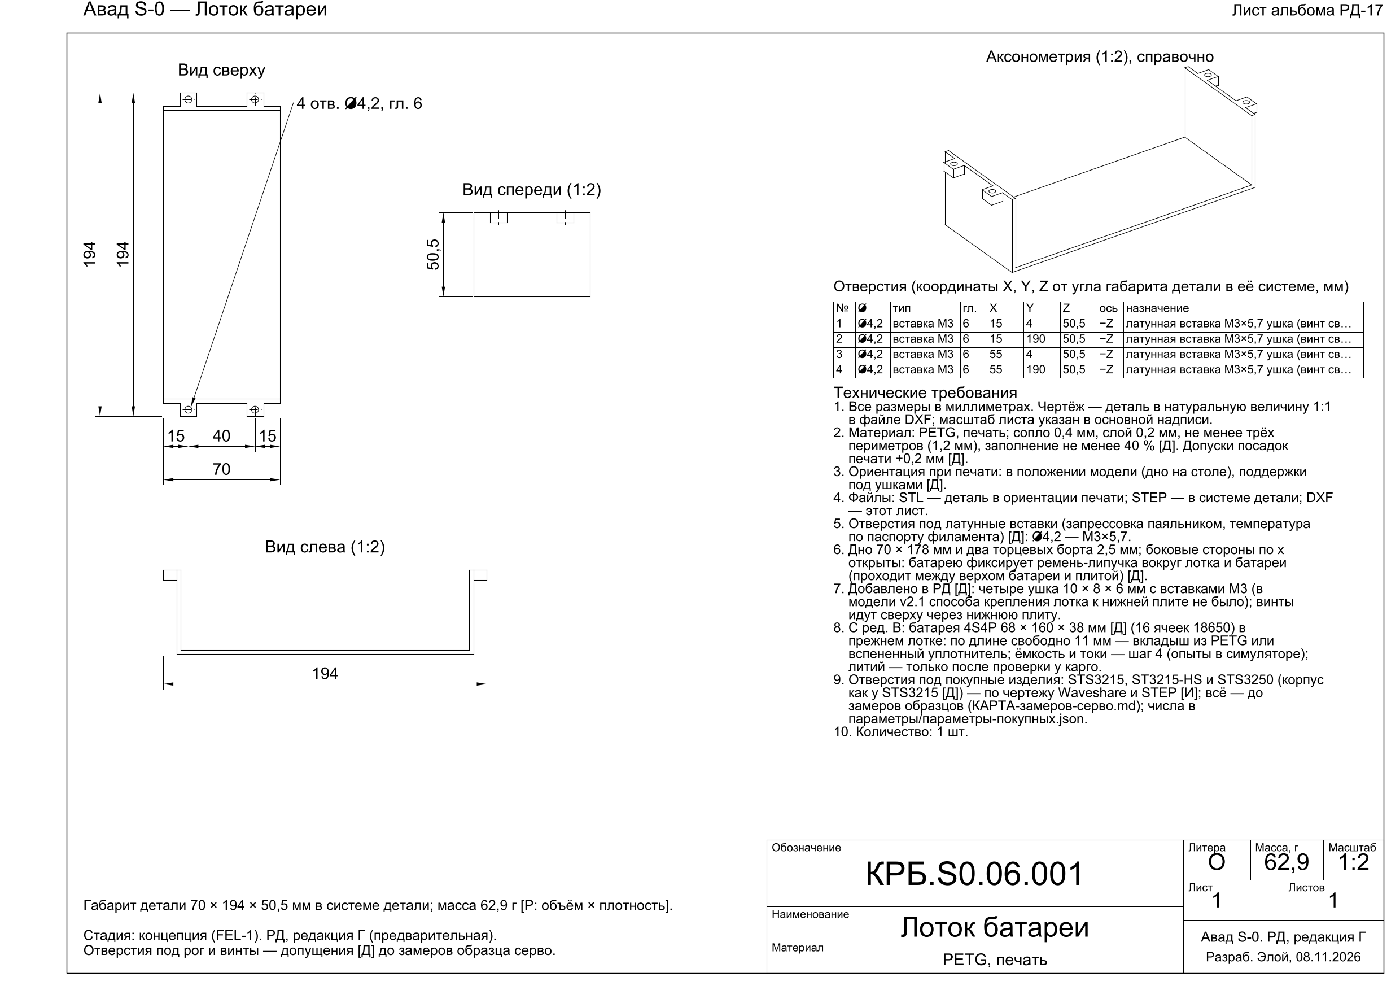
parts/KRB.S0.06.001_lotok-batarei.png
