pilot443/avad-s0/purchased-parts/KRB.S0.90.002_batareya-lotok.png

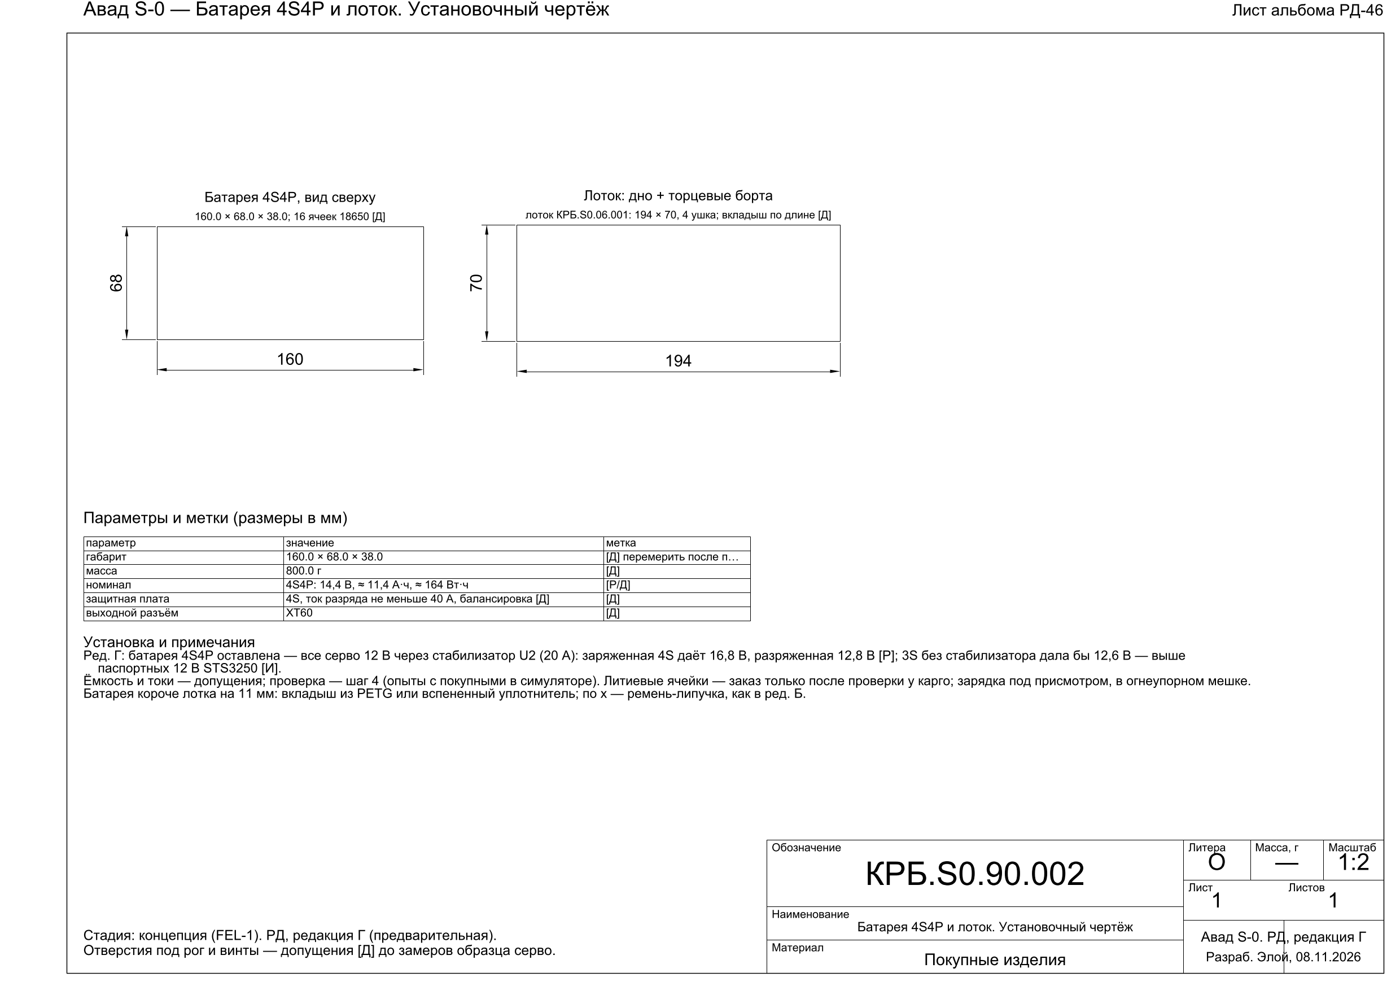
purchased-parts/KRB.S0.90.002_batareya-lotok.png
