pilot443/avad-s0/purchased-parts/KRB.S0.90.003_pi5-pico.png

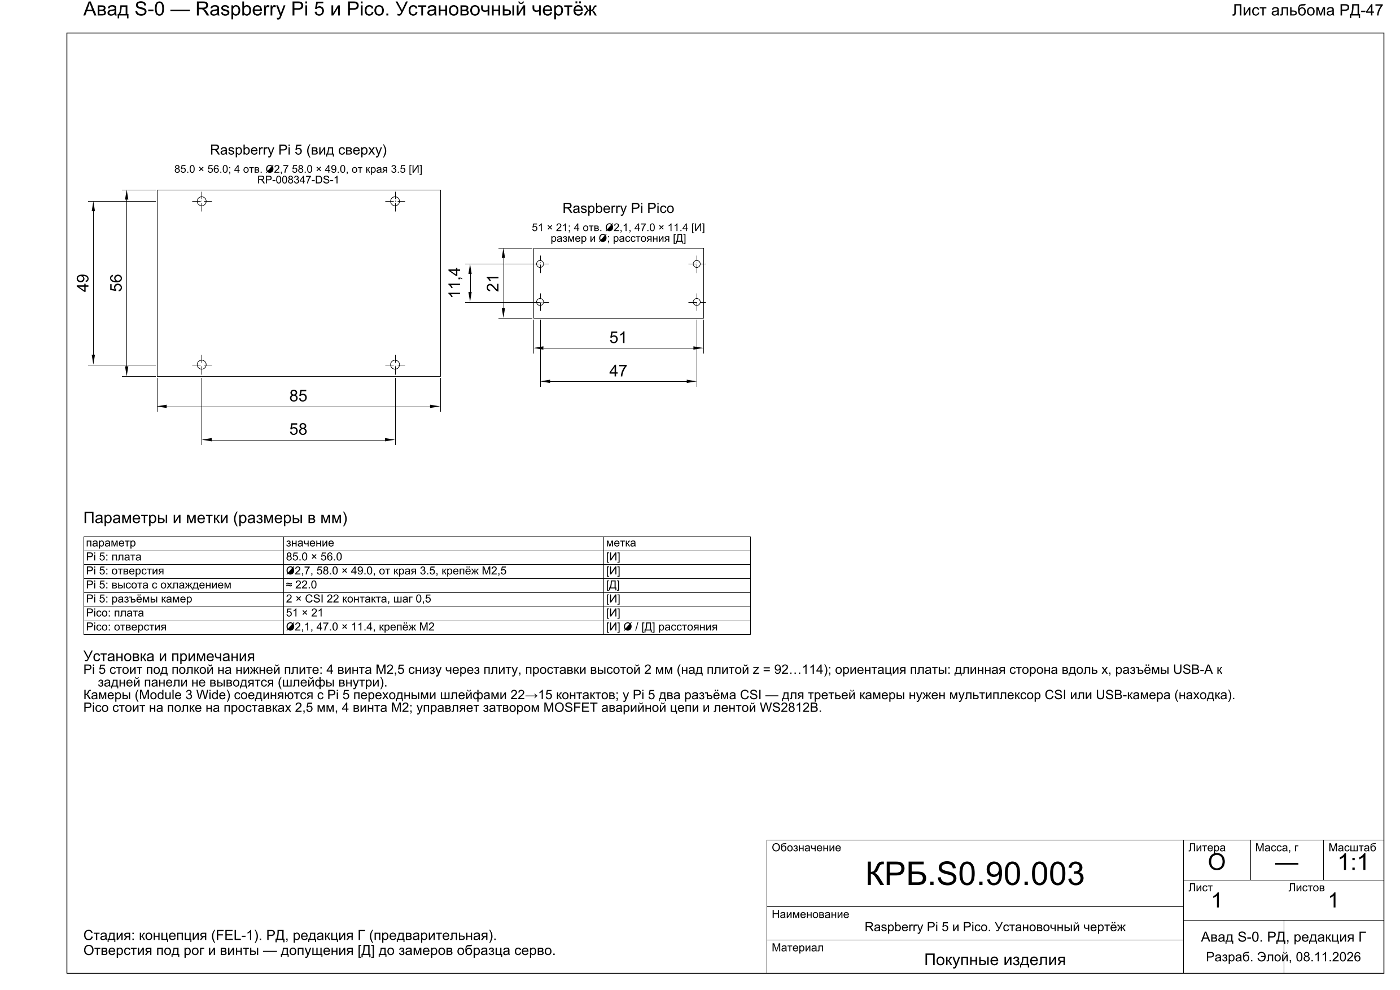
purchased-parts/KRB.S0.90.003_pi5-pico.png
