pilot443/avad-s0/purchased-parts/KRB.S0.90.004_kamera-koltsa.png

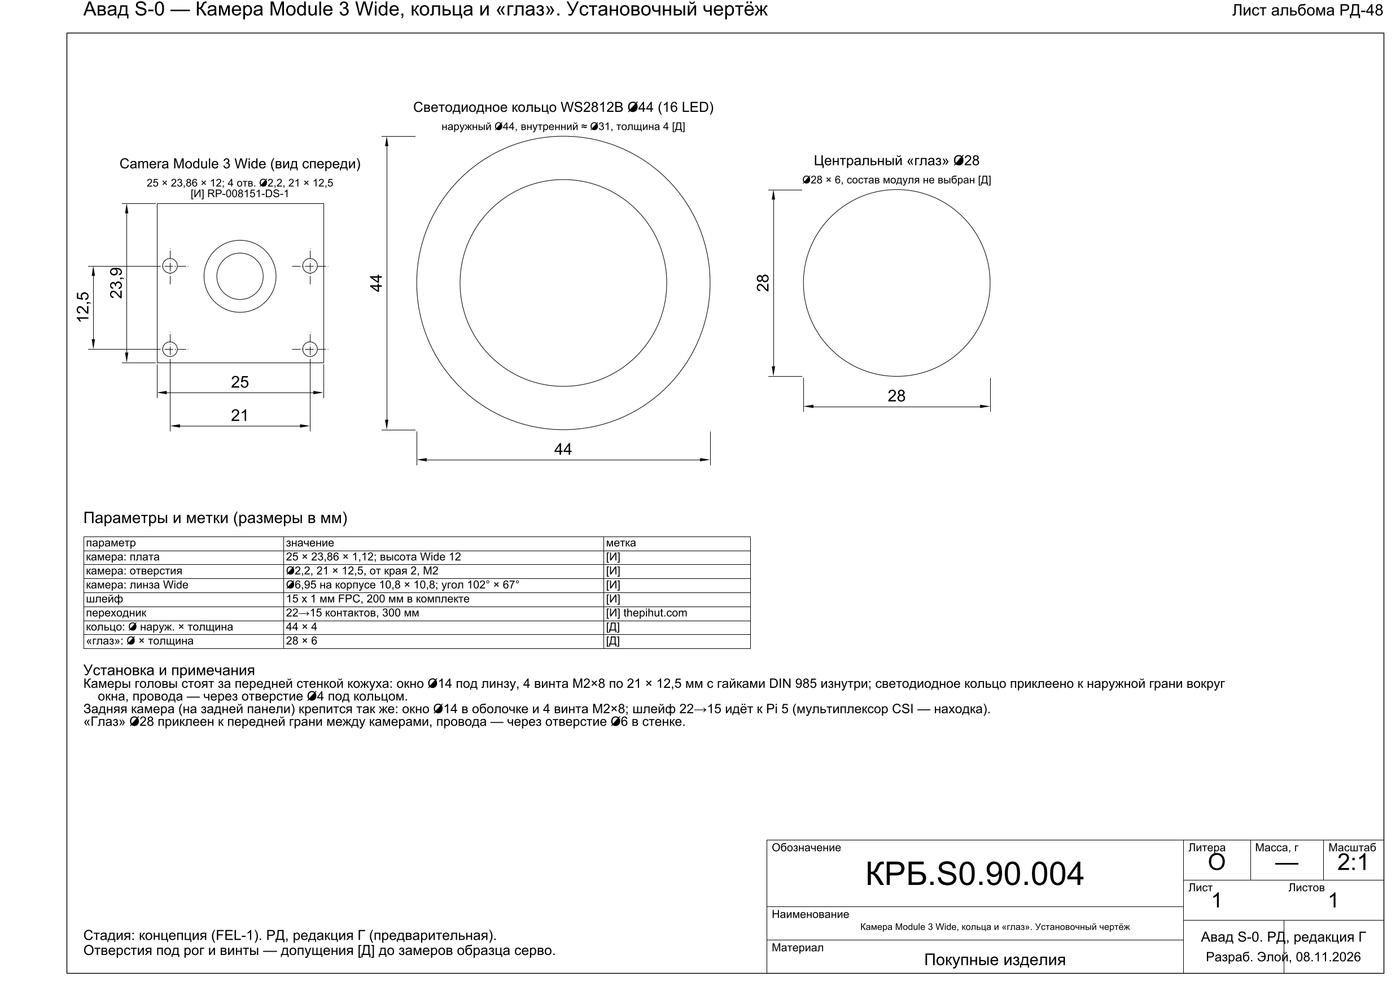
purchased-parts/KRB.S0.90.004_kamera-koltsa.png
