pilot443/avad-s0/assemblies/KRB.S0.03.000_SB.step

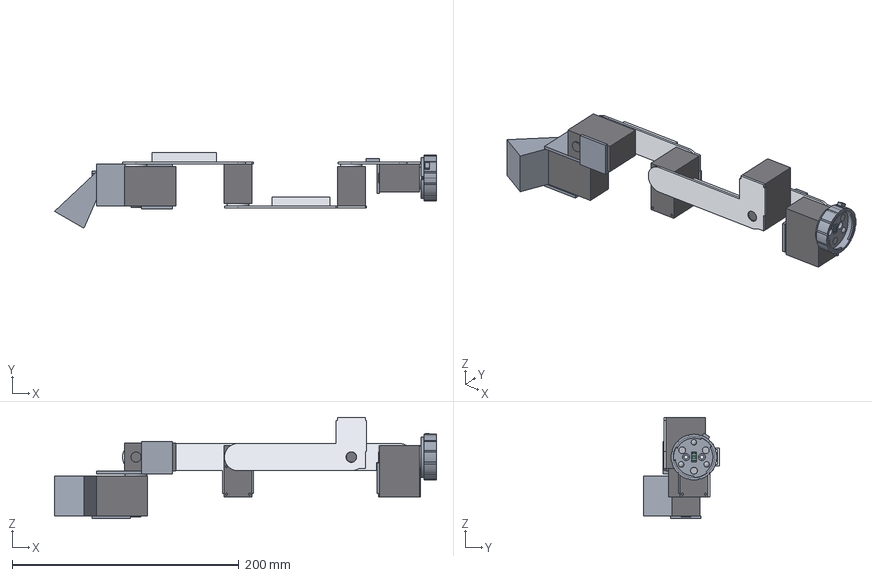
[picture p61: CAD file, 2026-11-09]
assemblies/KRB.S0.03.000_SB.step
337.1 x 66.7 x 89.5 mm
01-Ð¿Ð»Ð¾ÑÐ°Ð´ÐºÐ°-1
02-Ð¿Ð»ÐµÑÐ¾-1
03-ÑÐµÐ±ÑÐ¾_Ð¿Ð»ÐµÑÐ°-1
04-Ð¿ÑÐµÐ´Ð¿Ð»ÐµÑÑÐµ-1
05-ÑÐµÐ±ÑÐ¾_Ð¿ÑÐµÐ´Ð¿Ð»ÐµÑÑÑ-1
06-ÐºÐ¸ÑÑÑ-1
07-ÑÐ³Ð¾Ð»Ð¾Ðº_ÐºÐ¸ÑÑÐ¸-1
08-ÑÑÐ¾Ð¹ÐºÐ°-1
09-Ð³Ð½ÐµÐ·Ð´Ð¾-1
10-ÐºÐ¾Ð»ÑÑÐ¾-1
11-ÑÐµÑÐ²Ð¾-1
11-ÑÐµÑÐ²Ð¾-2
11-ÑÐµÑÐ²Ð¾-3
11-ÑÐµÑÐ²Ð¾-4
11-ÑÐµÑÐ²Ð¾-5
12-ÑÐ¾Ð³-1
12-ÑÐ¾Ð³-2
12-ÑÐ¾Ð³-3
12-ÑÐ¾Ð³-4
12-ÑÐ¾Ð³-5
13-ÑÐ°ÑÐ¸Ðº-1
13-ÑÐ°ÑÐ¸Ðº-2
13-ÑÐ°ÑÐ¸Ðº-3
14-Ð¼Ð°Ð³Ð½Ð¸Ñ-1
14-Ð¼Ð°Ð³Ð½Ð¸Ñ-2
14-Ð¼Ð°Ð³Ð½Ð¸Ñ-3
15-Ð±Ð»Ð¾Ðº-1
