pilot443/avad-s0/parts/KRB.S0.03.004_zveno-predplechya_cut.dxf

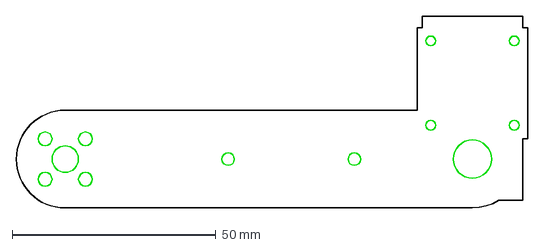
[picture p62: CAD file, 2026-11-09]
parts/KRB.S0.03.004_zveno-predplechya_cut.dxf
125.6 x 47.1 mm
