pilot443/avad-s0/purchased-parts/KRB.S0.90.005_datchiki-zvuk.dxf

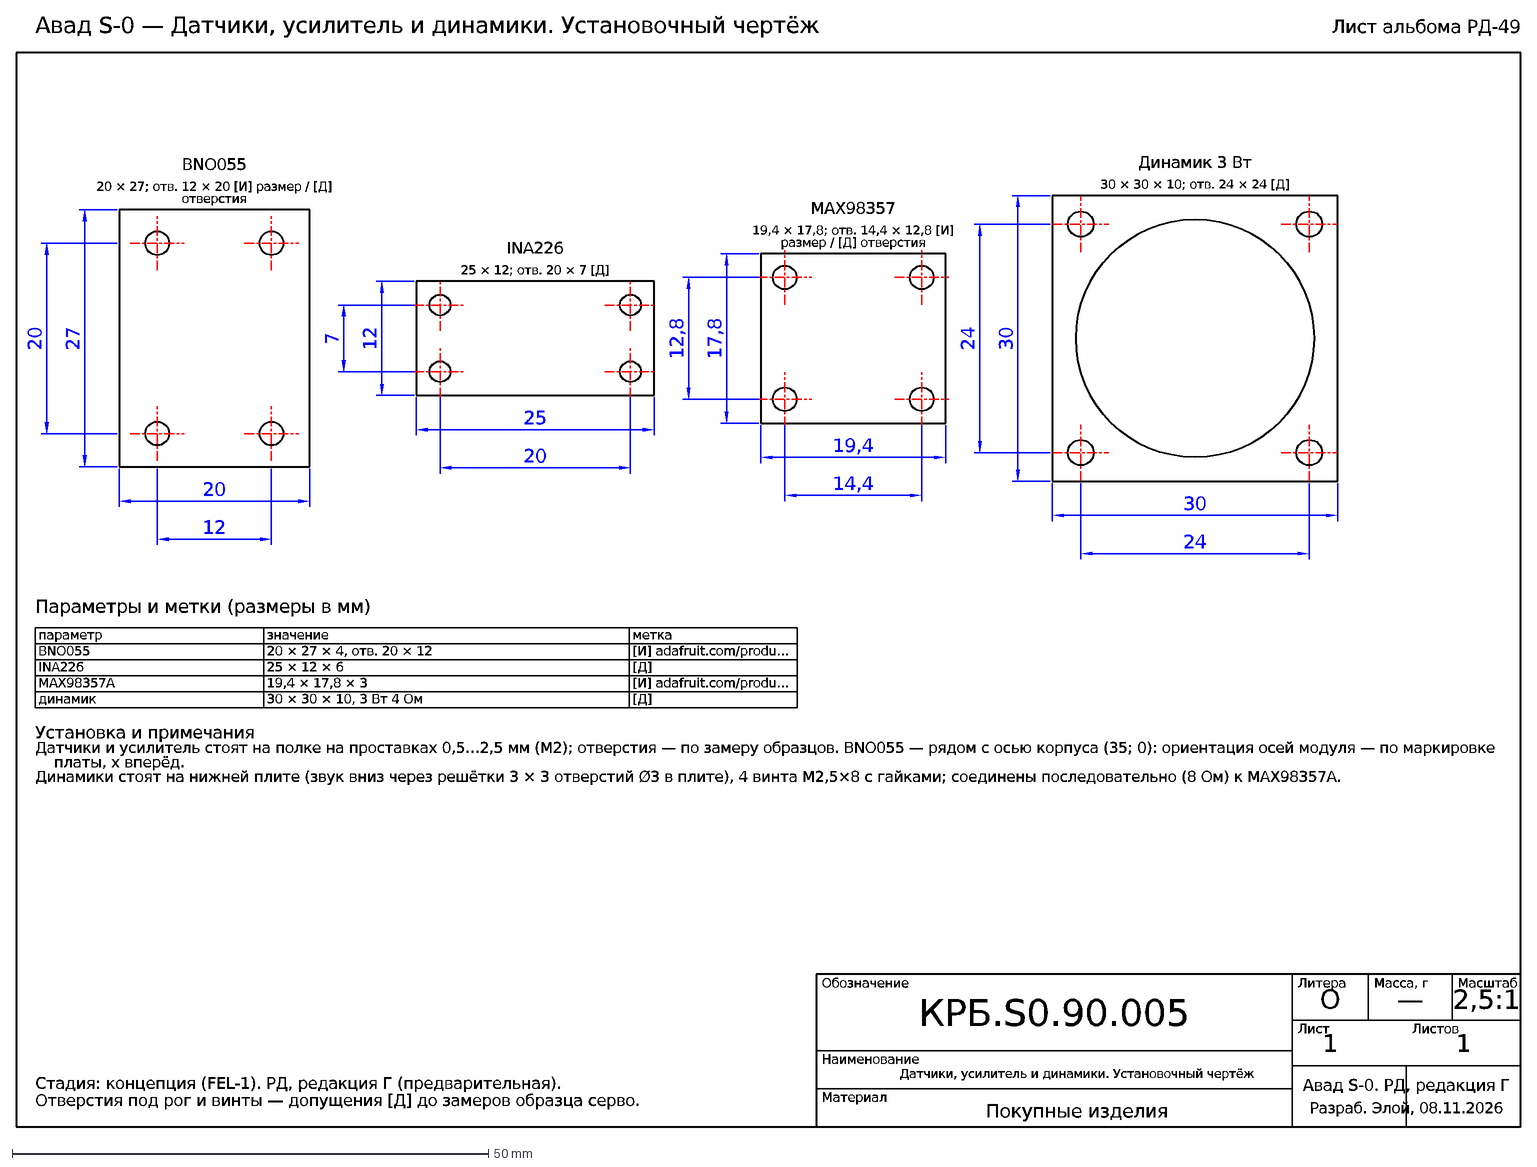
[picture p63: CAD file, 2026-11-09]
purchased-parts/KRB.S0.90.005_datchiki-zvuk.dxf
Стадия: концепция (FEL-1). РД, редакция Г (предварительная).
Отверстия под рог и винты — допущения [Д] до замеров образца серво.
Обозначение
Наименование
Материал
Литера
Масса, г
Масштаб
Лист
Листов
КРБ.S0.90.005
О
—
2,5:1
1
Авад S-0. РД, редакция Г
Разраб. Элой, 08.11.2026
Датчики, усилитель и динамики. Установочный чертёж
Покупные изделия
Авад S-0 — Датчики, усилитель и динамики. Установочный чертёж
Лист альбома РД-49
20
27
12
20 × 27; отв. 12 × 20 [И] размер / [Д]
отверстия
BNO055
25
7
25 × 12; отв. 20 × 7 [Д]
INA226
19,4
17,8
14,4
12,8
19,4 × 17,8; отв. 14,4 × 12,8 [И]
размер / [Д] отверстия
MAX98357
30
24
30 × 30 × 10; отв. 24 × 24 [Д]
Динамик 3 Вт
Параметры и метки (размеры в мм)
параметр
значение
метка
20 × 27 × 4, отв. 20 × 12
[И] adafruit.com/produ…
25 × 12 × 6
[Д]
MAX98357A
19,4 × 17,8 × 3
динамик
30 × 30 × 10, 3 Вт 4 Ом
Установка и примечания
Датчики и усилитель стоят на полке на проставках 0,5…2,5 мм (М2); отверстия — по замеру образцов. BNO055 — рядом с осью корпуса (35; 0): ориентация осей модуля 
платы, x вперёд.
Динамики стоят на нижней плите (звук вниз через решётки 3 × 3 отверстий Ø3 в плите), 4 винта M2,5×8 с гайками; соединены последовательно (8 Ом) к MAX98357A.
