pilot443/avad-s0/sim/meshes-v26-k1/m232.stl

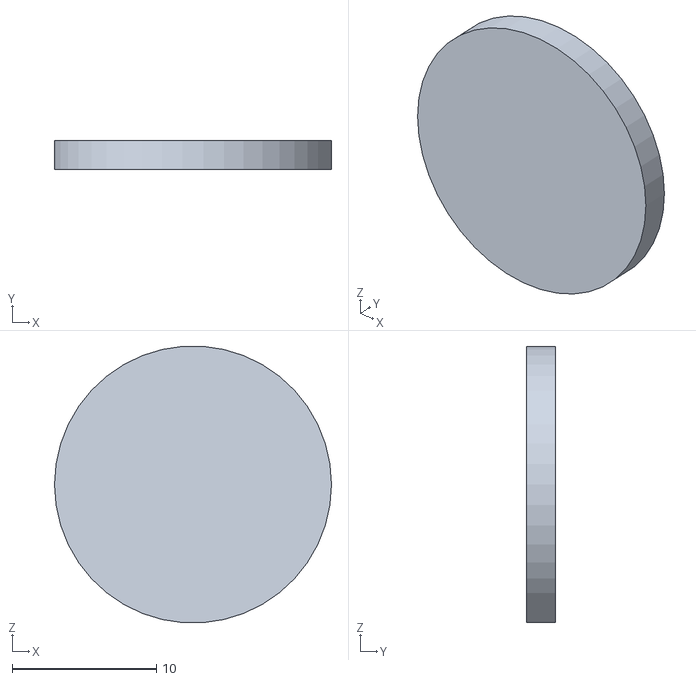
[picture p64: CAD file, 2026-11-09]
sim/meshes-v26-k1/m232.stl
19.2 x 2.00 x 19.1
