pilot443/avad-s0/wrist-tools/assemblies/KRB.S0.07.100_SB.step

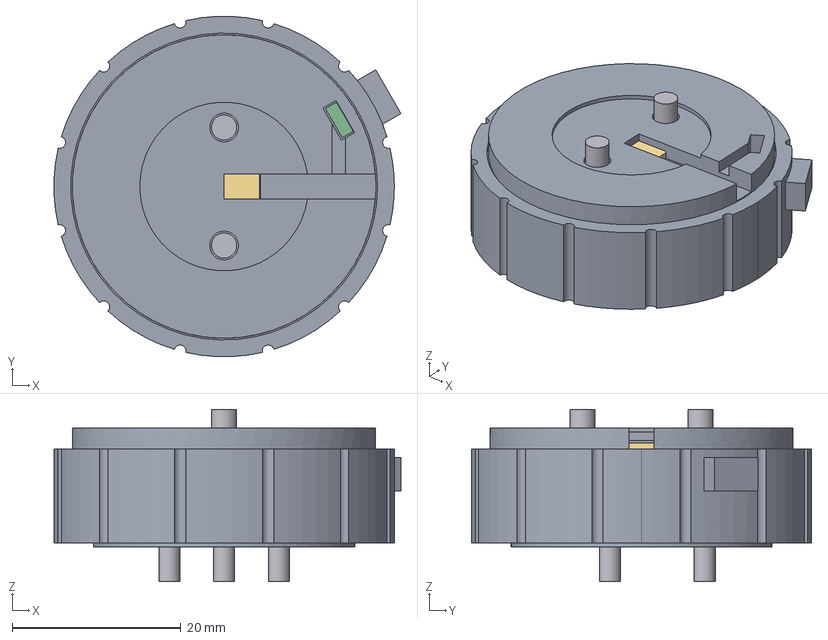
[picture p65: CAD file, 2026-11-09]
wrist-tools/assemblies/KRB.S0.07.100_SB.step
41.2 x 40.4 x 20.4 mm
01-Ð³Ð½ÐµÐ·Ð´Ð¾-1
02-ÐºÐ¾Ð»ÑÑÐ¾-1
03-ÑÐ°ÑÐ¸Ðº-1
03-ÑÐ°ÑÐ¸Ðº-2
03-ÑÐ°ÑÐ¸Ðº-3
04-Ð¼Ð°Ð³Ð½Ð¸Ñ-1
04-Ð¼Ð°Ð³Ð½Ð¸Ñ-2
04-Ð¼Ð°Ð³Ð½Ð¸Ñ-3
05-Ð±Ð»Ð¾Ðº-1
06-Ð²Ð¸Ð½Ñ3-1
06-Ð²Ð¸Ð½Ñ3-2
07-Ð¿Ð»Ð¸ÑÐ°-1
08-ÑÐ°Ð¹Ð±Ð°-1
08-ÑÐ°Ð¹Ð±Ð°-2
08-ÑÐ°Ð¹Ð±Ð°-3
09-Ð¿Ð»Ð°ÑÐ°-1
10-Ð²Ð¸Ð½Ñ25-1
10-Ð²Ð¸Ð½Ñ25-2
10-Ð²Ð¸Ð½Ñ25-3
11-Ñ Ð¾Ð»Ð»-1
12-Ð¼Ð°Ð³Ð½Ð¸Ñ_Ðº-1
