pilot443/avad-s0/wrist-tools/KRB.S0.07.020_derzhatel-zhala.step

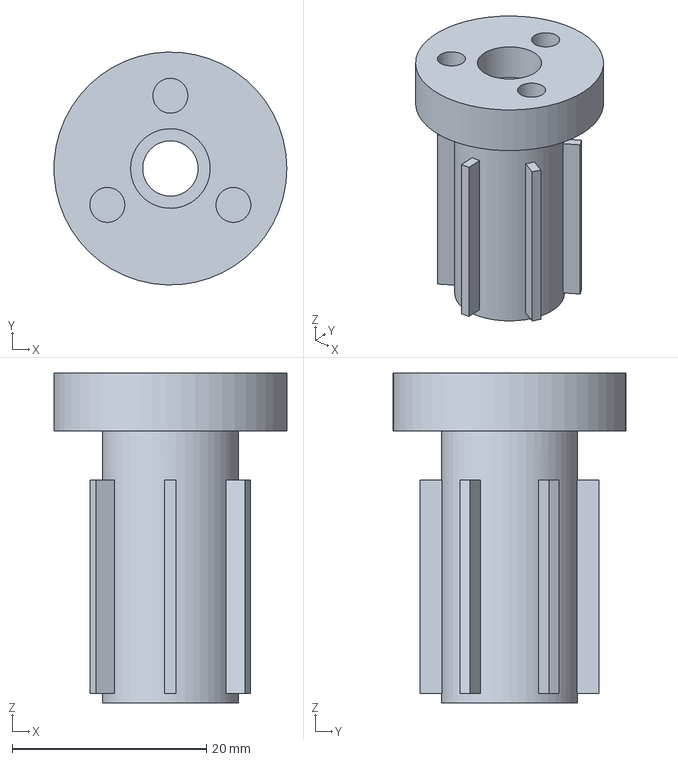
[picture p66: CAD file, 2026-11-09]
wrist-tools/KRB.S0.07.020_derzhatel-zhala.step
24.0 x 24.0 x 34.0 mm
