pilot443/avad-s0/assemblies/KRB.S0.02.000_SB.step

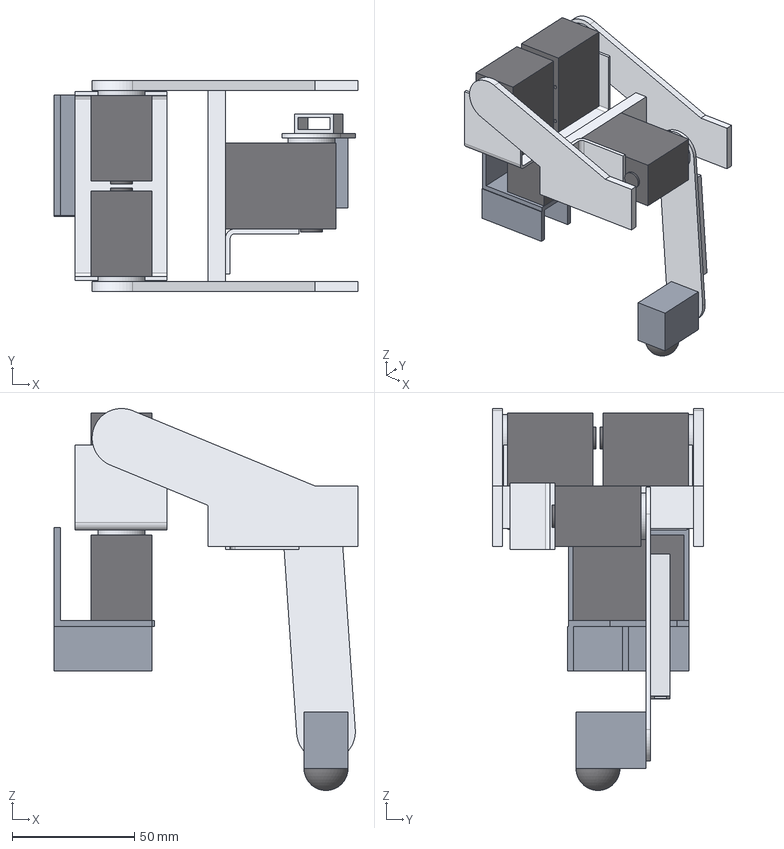
[picture p67: CAD file, 2026-11-09]
assemblies/KRB.S0.02.000_SB.step
124.0 x 86.0 x 156.0 mm
01-ÑÐ³Ð¾Ð»Ð¾Ðº-1
02-ÑÐºÐ¾Ð±Ð°-1
03-ÑÐµÐºÐ°-1
03-ÑÐµÐºÐ°-2
04-Ð¿ÐµÑÐµÐ¼ÑÑÐºÐ°-1
05-Ð³Ð¾Ð»ÐµÐ½Ñ-1
06-ÑÐµÐ±ÑÐ¾-1
07-ÑÑÐ¾Ð¿Ð°-1
08-Ð¿Ð¾Ð´Ð¾ÑÐ²Ð°-1
09-ÑÐµÑÐ²Ð¾_hs-1
10-ÑÐµÑÐ²Ð¾_xm-1
10-ÑÐµÑÐ²Ð¾_xm-2
10-ÑÐµÑÐ²Ð¾_xm-3
11-ÑÐ¾Ð³-1
12-ÑÐ¾Ð³_xm-1
12-ÑÐ¾Ð³_xm-2
12-ÑÐ¾Ð³_xm-3
13-ÑÐ³Ð¾Ð»Ð¾Ðº_ÐºÐ¾Ð»ÐµÐ½Ð°-1
