pilot443/avad-s0/electrical/EL-01_electronics-layout.dxf

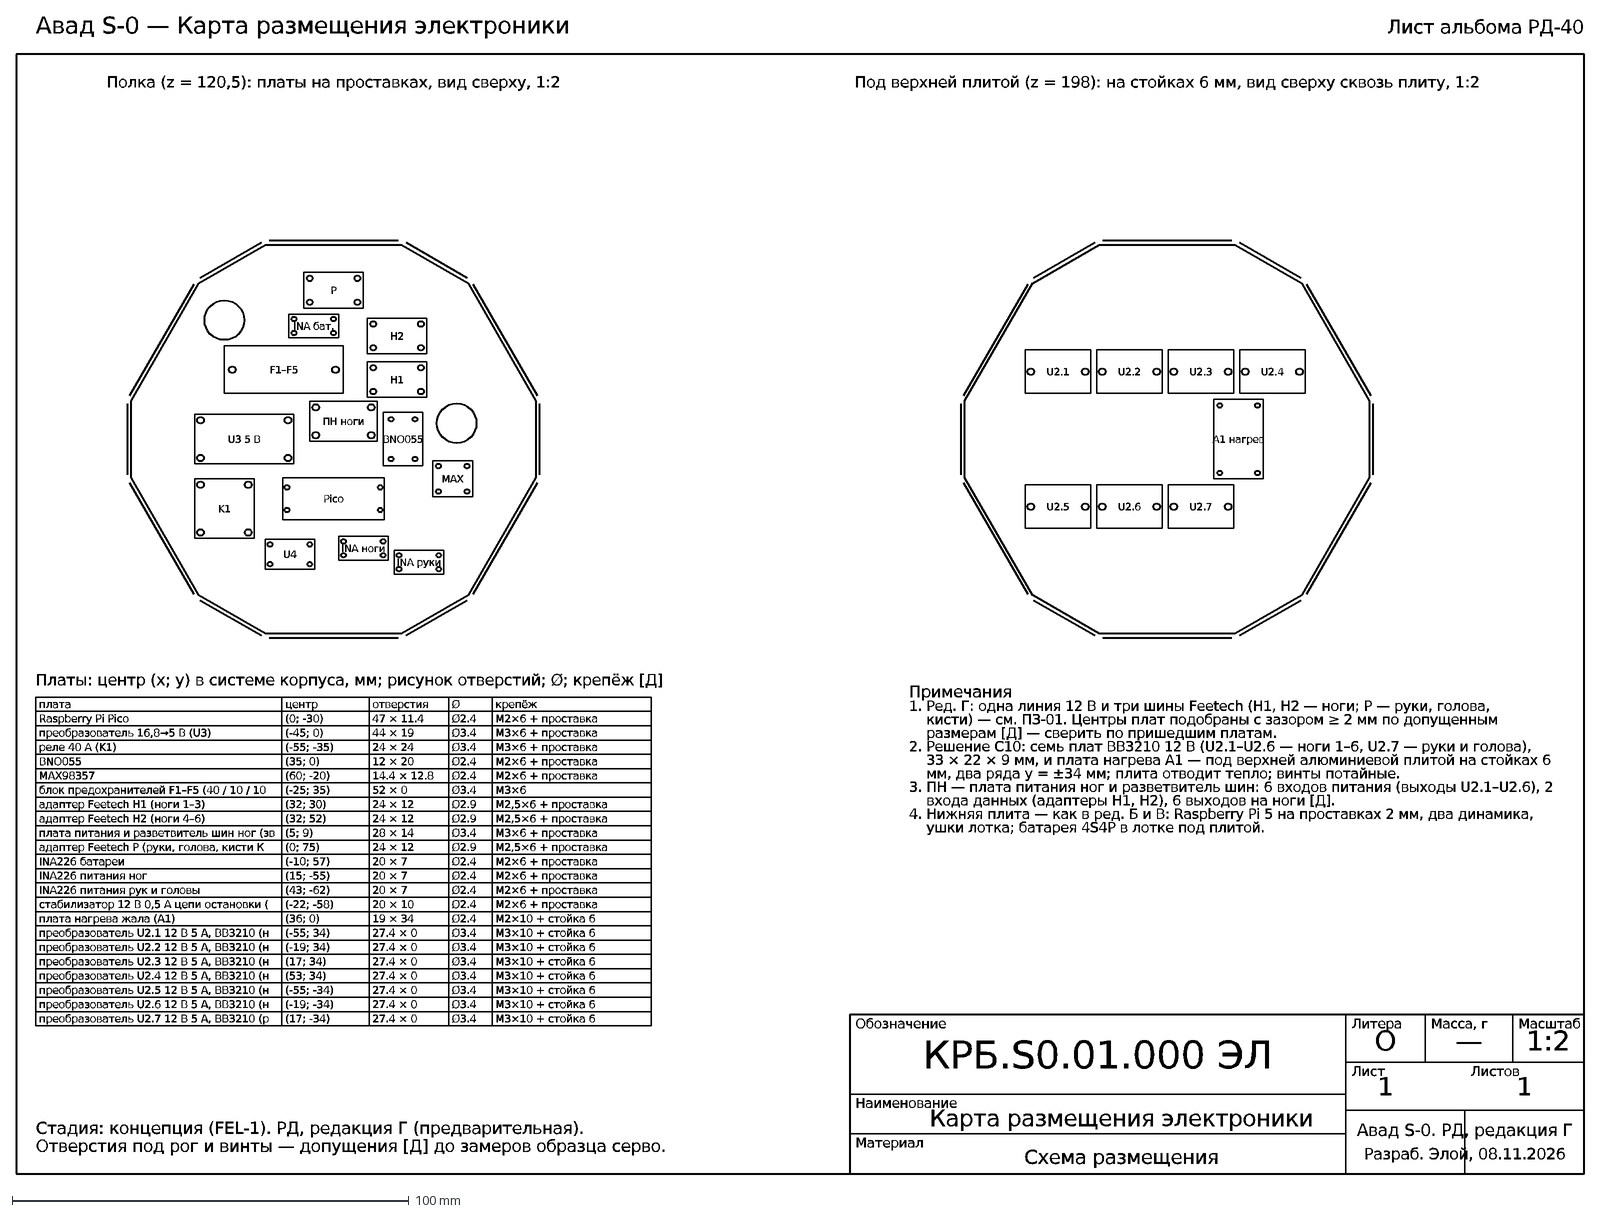
[picture p68: CAD file, 2026-11-09]
electrical/EL-01_electronics-layout.dxf
Стадия: концепция (FEL-1). РД, редакция Г (предварительная).
Отверстия под рог и винты — допущения [Д] до замеров образца серво.
Обозначение
Наименование
Материал
Литера
Масса, г
Масштаб
Лист
Листов
КРБ.S0.01.000 ЭЛ
О
—
1:2
1
Авад S-0. РД, редакция Г
Разраб. Элой, 08.11.2026
Карта размещения электроники
Схема размещения
Авад S-0 — Карта размещения электроники
Лист альбома РД-40
Полка (z = 120,5): платы на проставках, вид сверху, 1:2
Pico
U3 5 В
K1
BNO055
MAX
F1–F5
Н1
Н2
ПН ноги
Р
INA бат.
INA ноги
INA руки
U4
Под верхней плитой (z = 198): на стойках 6 мм, вид сверху сквозь плиту, 1:2
A1 нагрев
U2.1
U2.2
U2.3
U2.4
U2.5
U2.6
U2.7
Платы: центр (x; y) в системе корпуса, мм; рисунок отверстий; Ø; крепёж [Д]
плата
центр
отверстия
Ø
крепёж
Raspberry Pi Pico
(0; -30)
47 × 11.4
Ø2.4
M2×6 + проставка
преобразователь 16,8→5 В (U3)
(-45; 0)
44 × 19
Ø3.4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
