pilot443/avad-s0/parts/KRB.S0.05.002_ruchka.step

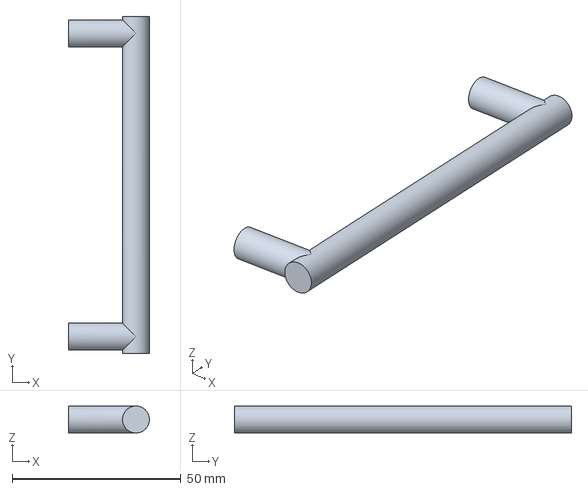
[picture p69: CAD file, 2026-11-09]
parts/KRB.S0.05.002_ruchka.step
24.0 x 100.0 x 8.00 mm
