pilot443/avad-s0/purchased-parts/KRB.S0.90.003_pi5-pico.dxf

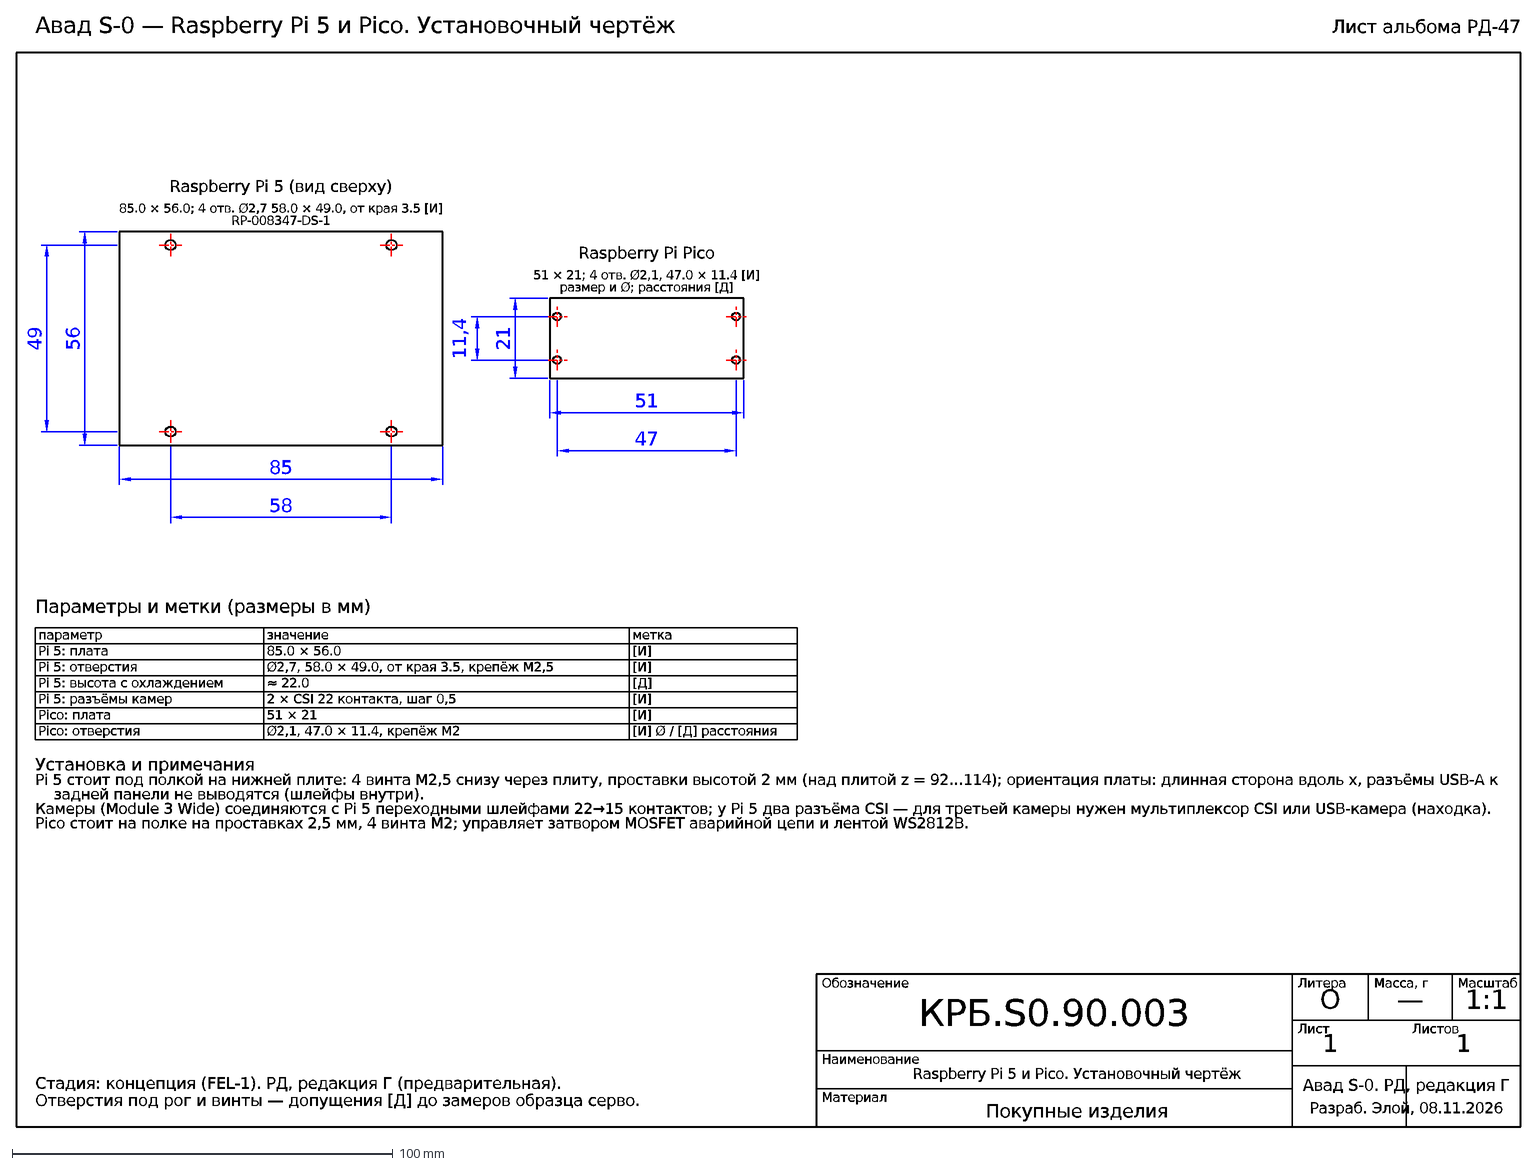
[picture p70: CAD file, 2026-11-09]
purchased-parts/KRB.S0.90.003_pi5-pico.dxf
Стадия: концепция (FEL-1). РД, редакция Г (предварительная).
Отверстия под рог и винты — допущения [Д] до замеров образца серво.
Обозначение
Наименование
Материал
Литера
Масса, г
Масштаб
Лист
Листов
КРБ.S0.90.003
О
—
1:1
1
Авад S-0. РД, редакция Г
Разраб. Элой, 08.11.2026
Raspberry Pi 5 и Pico. Установочный чертёж
Покупные изделия
Авад S-0 — Raspberry Pi 5 и Pico. Установочный чертёж
Лист альбома РД-47
85
56
58
49
85.0 × 56.0; 4 отв. Ø2,7 58.0 × 49.0, от края 3.5 [И]
RP-008347-DS-1
Raspberry Pi 5 (вид сверху)
51
21
47
11,4
51 × 21; 4 отв. Ø2,1, 47.0 × 11.4 [И]
размер и Ø; расстояния [Д]
Raspberry Pi Pico
Параметры и метки (размеры в мм)
параметр
значение
метка
Pi 5: плата
85.0 × 56.0
[И]
Pi 5: отверстия
Ø2,7, 58.0 × 49.0, от края 3.5, крепёж M2,5
Pi 5: высота с охлаждением
≈ 22.0
[Д]
Pi 5: разъёмы камер
2 × CSI 22 контакта, шаг 0,5
Pico: плата
51 × 21
Pico: отверстия
Ø2,1, 47.0 × 11.4, крепёж M2
[И] Ø / [Д] расстояния
Установка и примечания
Pi 5 стоит под полкой на нижней плите: 4 винта M2,5 снизу через плиту, проставки высотой 2 мм (над плитой z = 92…114); ориентация платы: длинная сторона вдоль x
задней панели не выводятся (шлейфы внутри).
Камеры (Module 3 Wide) соединяются с Pi 5 переходными шлейфами 22→15 контактов; у Pi 5 два разъёма CSI — для третьей камеры нужен мультиплексор CSI или USB-каме
Pico стоит на полке на проставках 2,5 мм, 4 винта M2; управляет затвором MOSFET аварийной цепи и лентой WS2812B.
