pilot443/avad-s0/sim/meshes-v26-k1/m253.stl

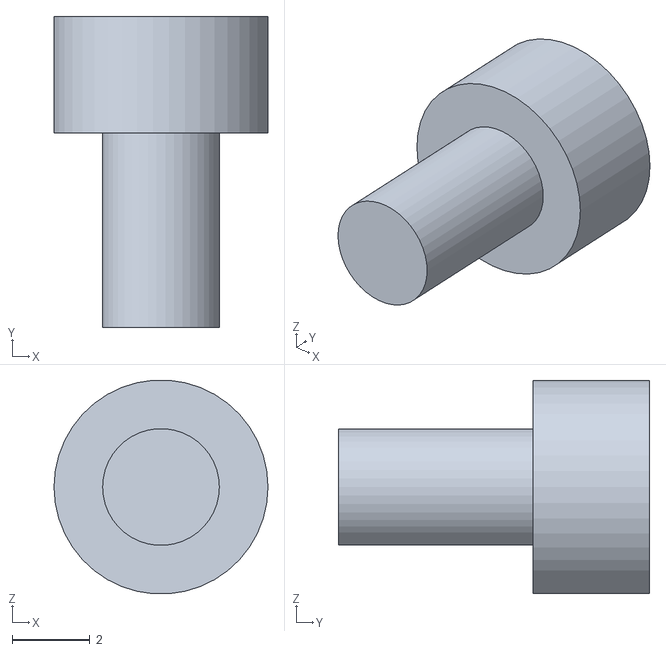
[picture p71: CAD file, 2026-11-09]
sim/meshes-v26-k1/m253.stl
5.50 x 8.00 x 5.48
