pilot443/avad-s0/wrist-tools/assemblies/KRB.S0.07.300_SB.step

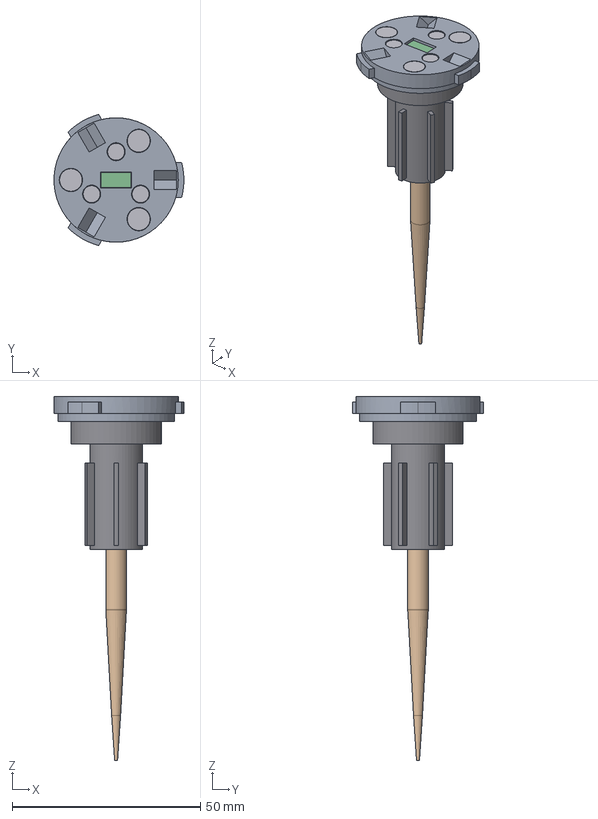
[picture p72: CAD file, 2026-11-09]
wrist-tools/assemblies/KRB.S0.07.300_SB.step
34.5 x 34.8 x 96.6 mm
01-Ð¿Ð»Ð¸ÑÐ°-1
02-ÑÐ°Ð¹Ð±Ð°-1
02-ÑÐ°Ð¹Ð±Ð°-2
02-ÑÐ°Ð¹Ð±Ð°-3
03-Ð¿Ð»Ð°ÑÐ°-1
04-Ð²Ð¸Ð½Ñ25-1
04-Ð²Ð¸Ð½Ñ25-2
04-Ð²Ð¸Ð½Ñ25-3
05-Ð´ÐµÑÐ¶Ð°ÑÐµÐ»Ñ-1
06-Ð²ÑÑÐ°Ð²ÐºÐ°-1
06-Ð²ÑÑÐ°Ð²ÐºÐ°-2
06-Ð²ÑÑÐ°Ð²ÐºÐ°-3
07-Ð³Ð½ÐµÐ·Ð´Ð¾_ts-1
08-Ð¶Ð°Ð»Ð¾-1
