pilot443/avad-s0/wrist-tools/KRB.S0.07.032_vtulka-mufty.step

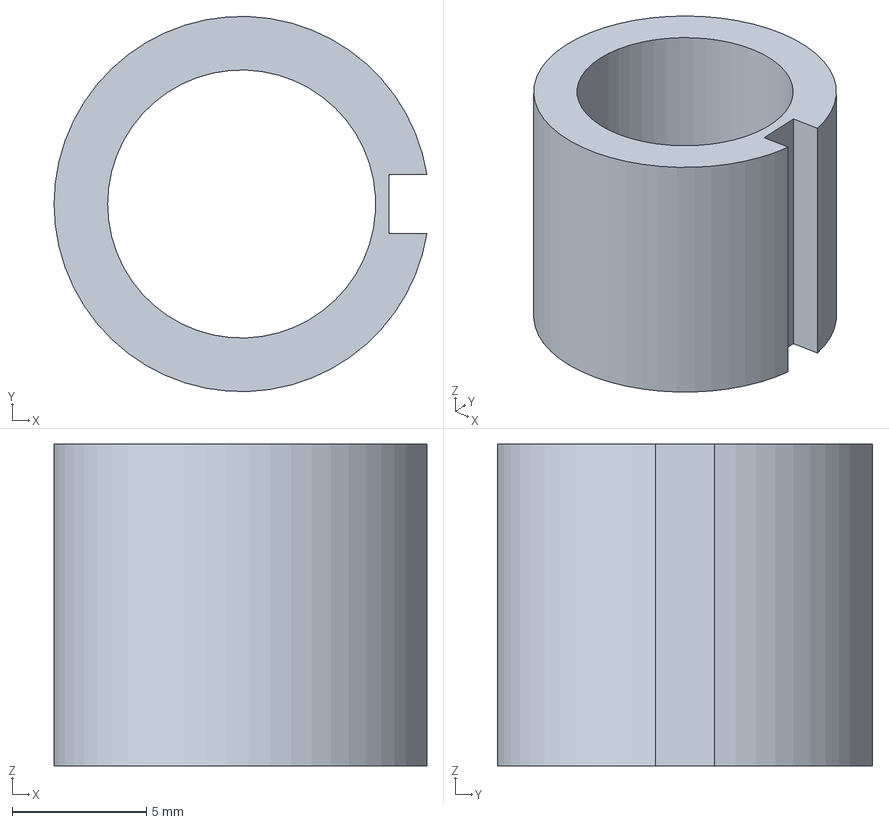
[picture p73: CAD file, 2026-11-09]
wrist-tools/KRB.S0.07.032_vtulka-mufty.step
13.9 x 14.0 x 12.0 mm
