pilot443/avad-s0/assemblies/KRB.S0.00.000_SB.step

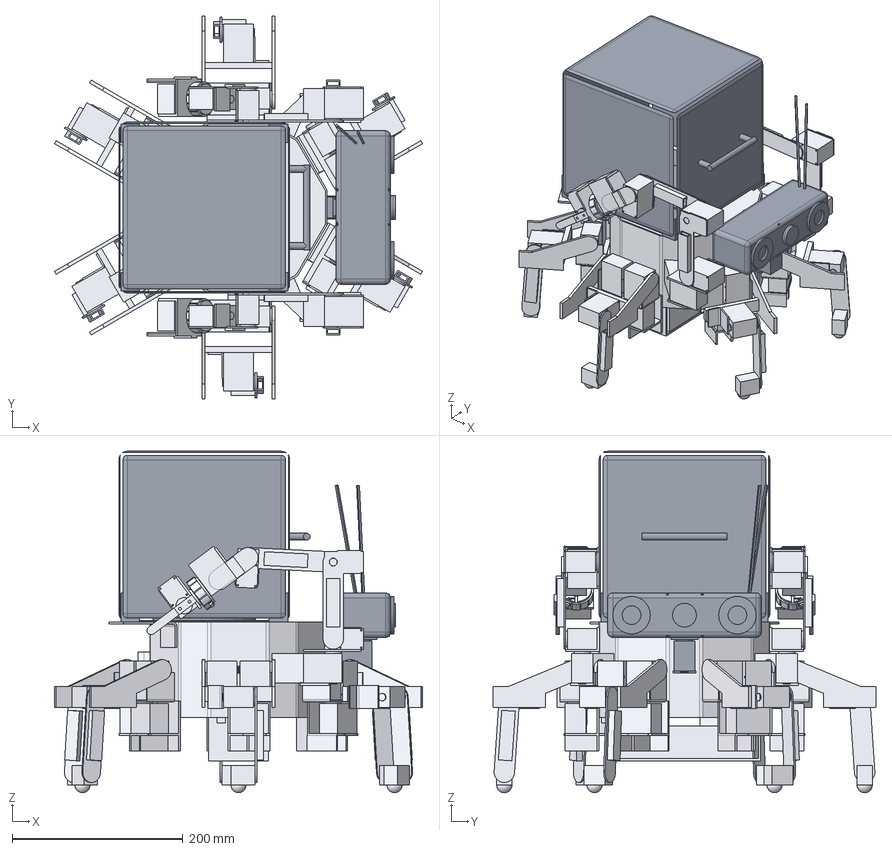
[picture p74: CAD file, 2026-11-09]
assemblies/KRB.S0.00.000_SB.step
431.0 x 448.0 x 400.0 mm
01-ÐºÐ¾ÑÐ¿ÑÑ-1
01-ÐºÐ¾ÑÐ¿ÑÑ-2
01-ÐºÐ¾ÑÐ¿ÑÑ-3
01-ÐºÐ¾ÑÐ¿ÑÑ-4
01-ÐºÐ¾ÑÐ¿ÑÑ-5
01-ÐºÐ¾ÑÐ¿ÑÑ-6
01-ÐºÐ¾ÑÐ¿ÑÑ-7
01-ÐºÐ¾ÑÐ¿ÑÑ-8
01-ÐºÐ¾ÑÐ¿ÑÑ-9
01-ÐºÐ¾ÑÐ¿ÑÑ-10
01-ÐºÐ¾ÑÐ¿ÑÑ-11
01-ÐºÐ¾ÑÐ¿ÑÑ-12
01-ÐºÐ¾ÑÐ¿ÑÑ-13
01-ÐºÐ¾ÑÐ¿ÑÑ-14
01-ÐºÐ¾ÑÐ¿ÑÑ-15
01-ÐºÐ¾ÑÐ¿ÑÑ-16
01-ÐºÐ¾ÑÐ¿ÑÑ-17
01-ÐºÐ¾ÑÐ¿ÑÑ-18
01-ÐºÐ¾ÑÐ¿ÑÑ-19
01-ÐºÐ¾ÑÐ¿ÑÑ-20
01-ÐºÐ¾ÑÐ¿ÑÑ-21
01-ÐºÐ¾ÑÐ¿ÑÑ-22
01-ÐºÐ¾ÑÐ¿ÑÑ-23
01-ÐºÐ¾ÑÐ¿ÑÑ-24
01-ÐºÐ¾ÑÐ¿ÑÑ-25
01-ÐºÐ¾ÑÐ¿ÑÑ-26
01-ÐºÐ¾ÑÐ¿ÑÑ-27
01-ÐºÐ¾ÑÐ¿ÑÑ-28
01-ÐºÐ¾ÑÐ¿ÑÑ-29
01-ÐºÐ¾ÑÐ¿ÑÑ-30
01-ÐºÐ¾ÑÐ¿ÑÑ-31
01-ÐºÐ¾ÑÐ¿ÑÑ-32
01-ÐºÐ¾ÑÐ¿ÑÑ-33
01-ÐºÐ¾ÑÐ¿ÑÑ-34
01-ÐºÐ¾ÑÐ¿ÑÑ-35
01-ÐºÐ¾ÑÐ¿ÑÑ-36
01-ÐºÐ¾ÑÐ¿ÑÑ-37
01-ÐºÐ¾ÑÐ¿ÑÑ-38
01-ÐºÐ¾ÑÐ¿ÑÑ-39
01-ÐºÐ¾ÑÐ¿ÑÑ-40
02-Ð½Ð¾Ð³Ð°-1
02-Ð½Ð¾Ð³Ð°-2
02-Ð½Ð¾Ð³Ð°-3
02-Ð½Ð¾Ð³Ð°-4
02-Ð½Ð¾Ð³Ð°-5
02-Ð½Ð¾Ð³Ð°-6
02-Ð½Ð¾Ð³Ð°-7
02-Ð½Ð¾Ð³Ð°-8
02-Ð½Ð¾Ð³Ð°-9
02-Ð½Ð¾Ð³Ð°-10
02-Ð½Ð¾Ð³Ð°-11
02-Ð½Ð¾Ð³Ð°-12
02-Ð½Ð¾Ð³Ð°-13
02-Ð½Ð¾Ð³Ð°-14
02-Ð½Ð¾Ð³Ð°-15
02-Ð½Ð¾Ð³Ð°-16
02-Ð½Ð¾Ð³Ð°-17
02-Ð½Ð¾Ð³Ð°-18
02-Ð½Ð¾Ð³Ð°-19
02-Ð½Ð¾Ð³Ð°-20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
