pilot443/avad-s0/electrical/TB-03_wrist-lock-contacts.dxf

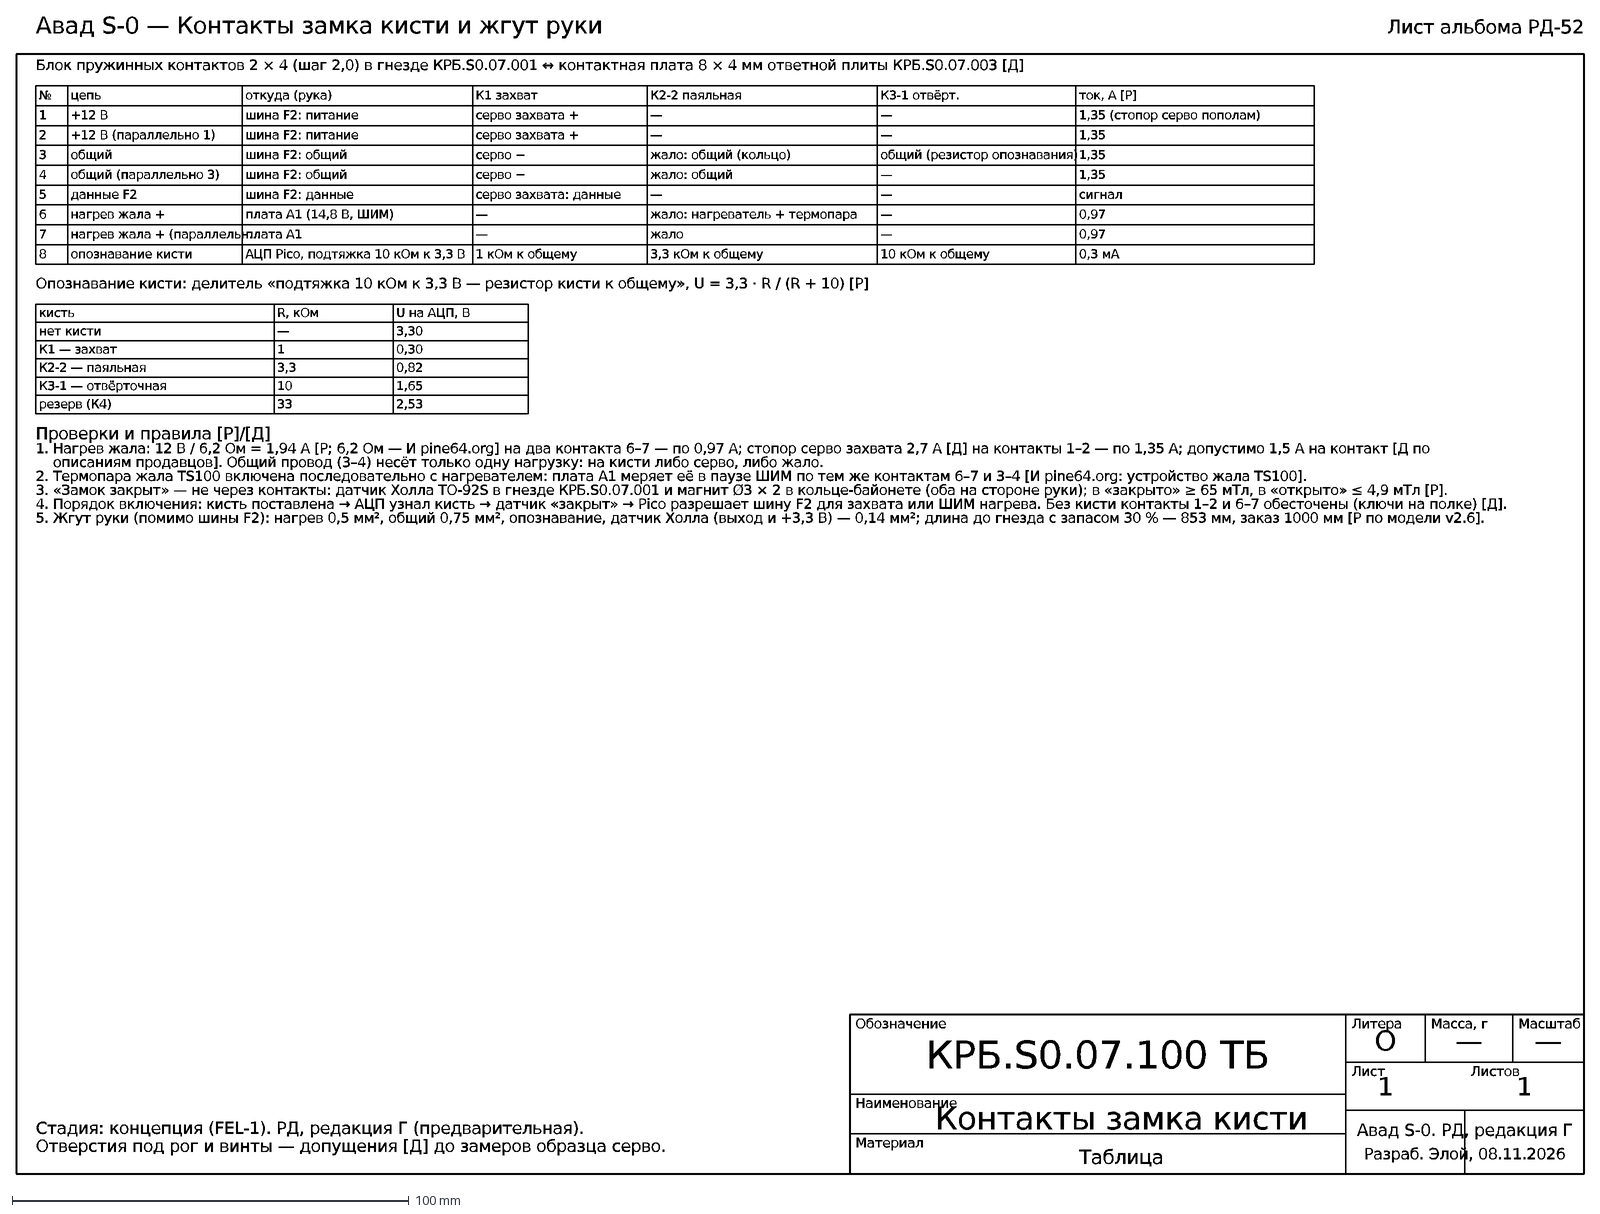
[picture p75: CAD file, 2026-11-09]
electrical/TB-03_wrist-lock-contacts.dxf
Стадия: концепция (FEL-1). РД, редакция Г (предварительная).
Отверстия под рог и винты — допущения [Д] до замеров образца серво.
Обозначение
Наименование
Материал
Литера
Масса, г
Масштаб
Лист
Листов
КРБ.S0.07.100 ТБ
О
—
1
Авад S-0. РД, редакция Г
Разраб. Элой, 08.11.2026
Контакты замка кисти
Таблица
Авад S-0 — Контакты замка кисти и жгут руки
Лист альбома РД-52
Блок пружинных контактов 2 × 4 (шаг 2,0) в гнезде КРБ.S0.07.001 ↔ контактная плата 8 × 4 мм ответной плиты КРБ.S0.07.003 [Д]
№
цепь
откуда (рука)
К1 захват
К2-2 паяльная
К3-1 отвёрт.
ток, А [Р]
+12 В
шина F2: питание
серво захвата +
1,35 (стопор серво пополам)
2
+12 В (параллельно 1)
1,35
3
общий
шина F2: общий
серво −
жало: общий (кольцо)
общий (резистор опознавания)
4
общий (параллельно 3)
жало: общий
5
данные F2
шина F2: данные
серво захвата: данные
сигнал
6
нагрев жала +
плата A1 (14,8 В, ШИМ)
жало: нагреватель + термопара
0,97
7
нагрев жала + (параллельн…
плата A1
жало
8
опознавание кисти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
