pilot443/avad-s0/parts/KRB.S0.02.010_razvertka.dxf

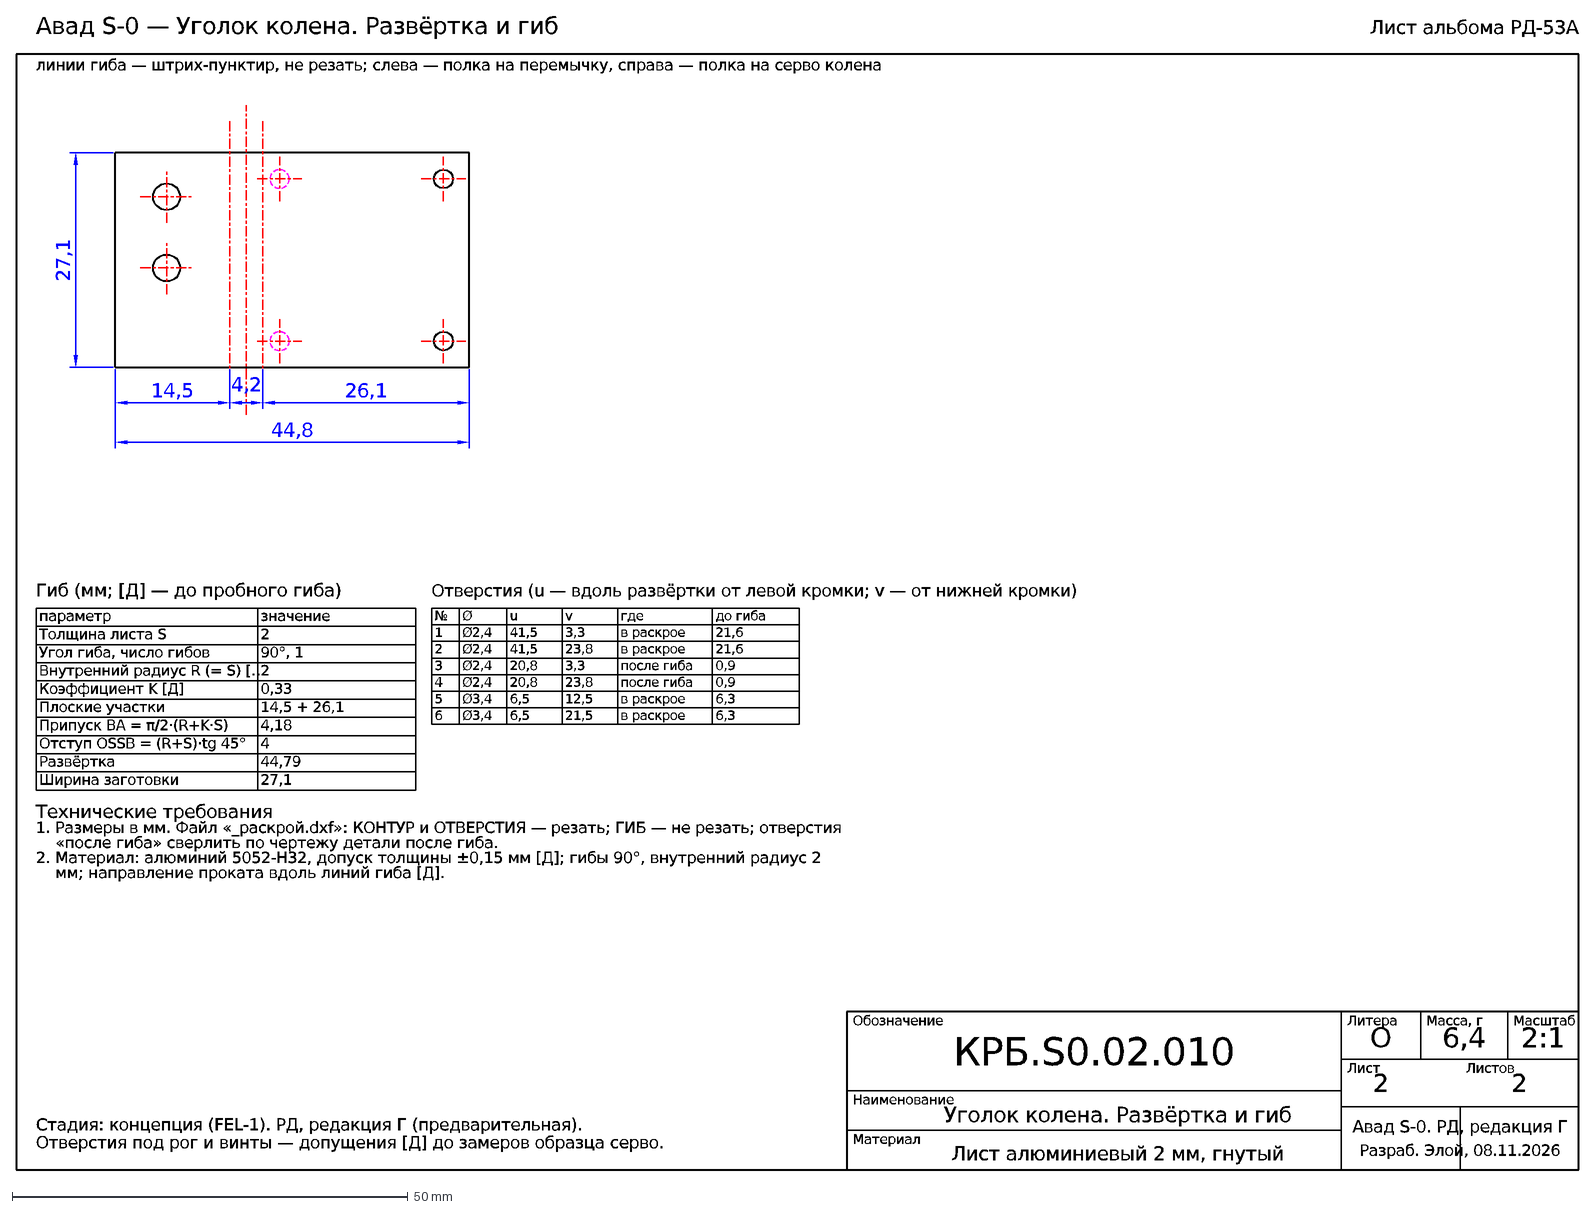
[picture p76: CAD file, 2026-11-09]
parts/KRB.S0.02.010_razvertka.dxf
Стадия: концепция (FEL-1). РД, редакция Г (предварительная).
Отверстия под рог и винты — допущения [Д] до замеров образца серво.
Обозначение
Наименование
Материал
Литера
Масса, г
Масштаб
Лист
Листов
КРБ.S0.02.010
О
6,4
2:1
2
Авад S-0. РД, редакция Г
Разраб. Элой, 08.11.2026
Уголок колена. Развёртка и гиб
Лист алюминиевый 2 мм, гнутый
Авад S-0 — Уголок колена. Развёртка и гиб
Лист альбома РД-53А
14,5
4,2
26,1
44,8
27,1
линии гиба — штрих-пунктир, не резать; слева — полка на перемычку, справа — полка на серво колена
Гиб (мм; [Д] — до пробного гиба)
параметр
значение
Толщина листа S
Угол гиба, число гибов
90°, 1
Внутренний радиус R (= S) […
Коэффициент K [Д]
0,33
Плоские участки
14,5 + 26,1
Припуск BA = π/2·(R+K·S)
4,18
Отступ OSSB = (R+S)·tg 45°
4
Развёртка
44,79
Ширина заготовки
Отверстия (u — вдоль развёртки от левой кромки; v — от нижней кромки)
№
Ø
u
v
где
до гиба
1
Ø2,4
41,5
3,3
в раскрое
21,6
23,8
3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
