pilot443/avad-s0/purchased-parts/KRB.S0.90.004_kamera-koltsa.dxf

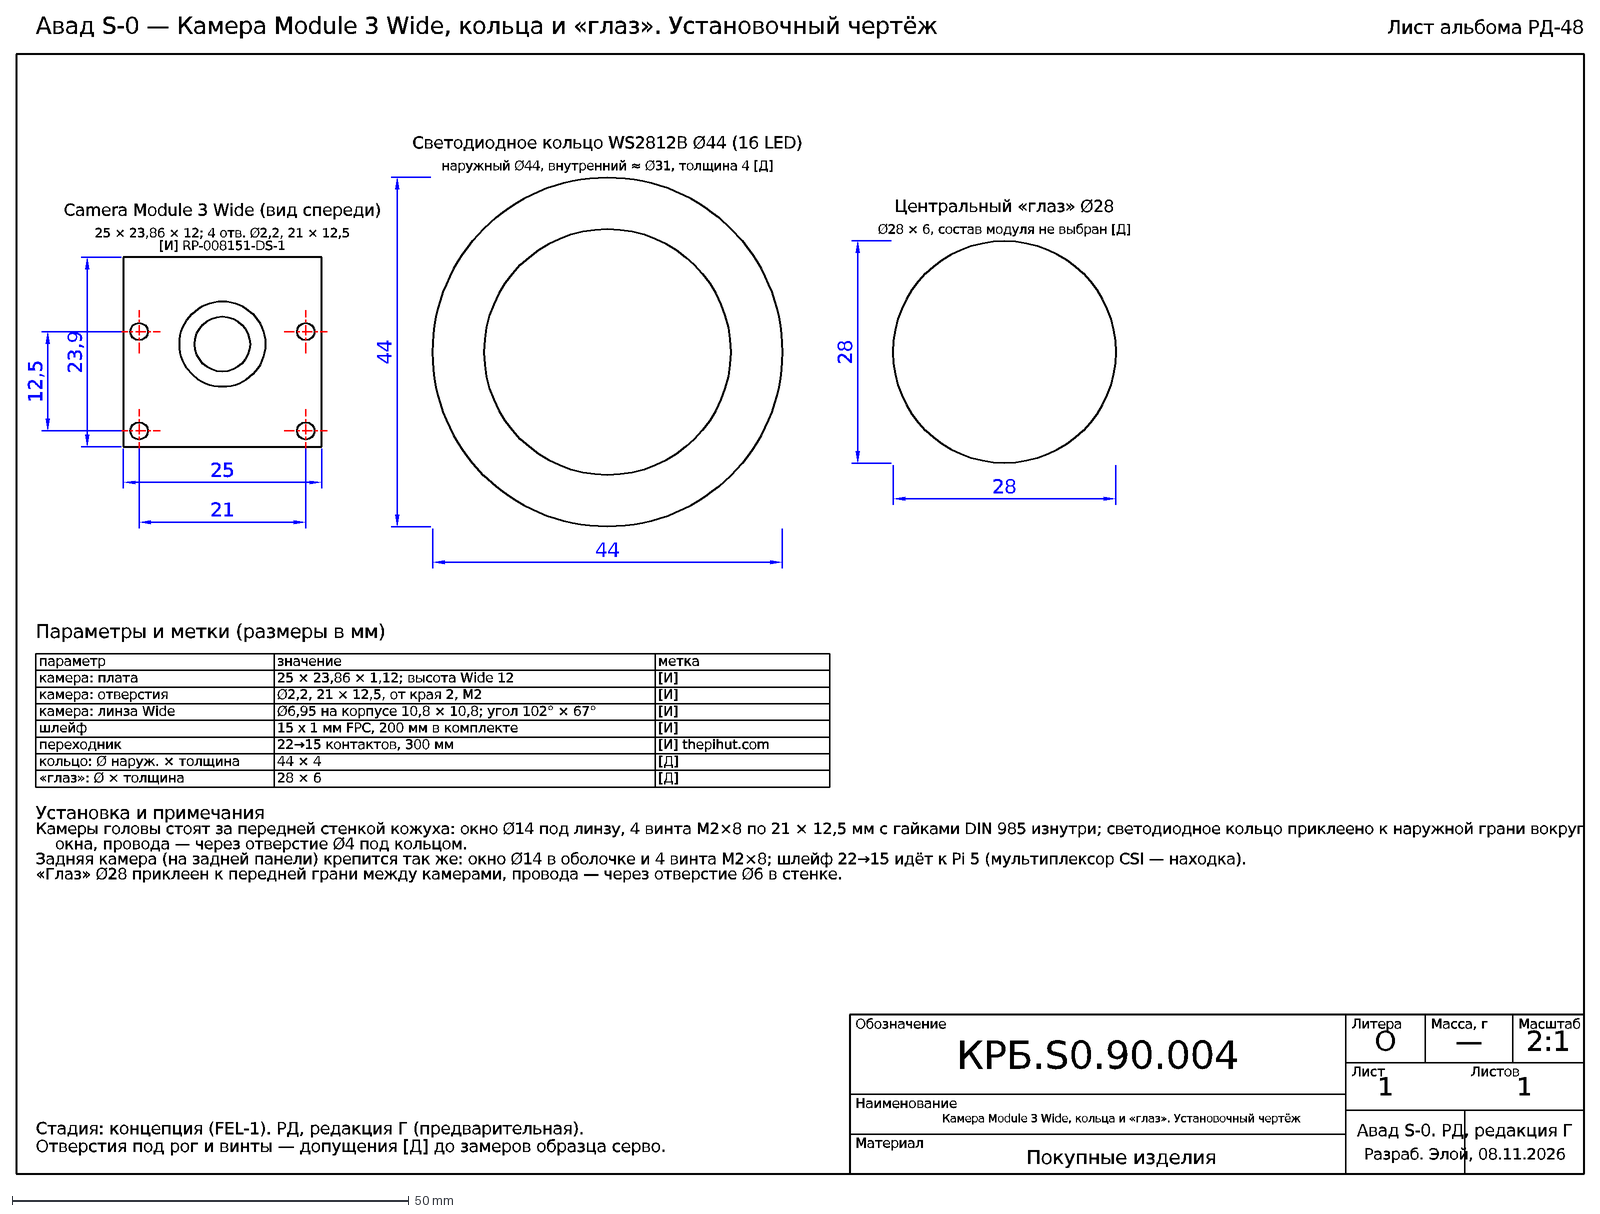
[picture p77: CAD file, 2026-11-09]
purchased-parts/KRB.S0.90.004_kamera-koltsa.dxf
Стадия: концепция (FEL-1). РД, редакция Г (предварительная).
Отверстия под рог и винты — допущения [Д] до замеров образца серво.
Обозначение
Наименование
Материал
Литера
Масса, г
Масштаб
Лист
Листов
КРБ.S0.90.004
О
—
2:1
1
Авад S-0. РД, редакция Г
Разраб. Элой, 08.11.2026
Камера Module 3 Wide, кольца и «глаз». Установочный чертёж
Покупные изделия
Авад S-0 — Камера Module 3 Wide, кольца и «глаз». Установочный чертёж
Лист альбома РД-48
25
23,9
21
12,5
25 × 23,86 × 12; 4 отв. Ø2,2, 21 × 12,5
[И] RP-008151-DS-1
Camera Module 3 Wide (вид спереди)
44
наружный Ø44, внутренний ≈ Ø31, толщина 4 [Д]
Светодиодное кольцо WS2812B Ø44 (16 LED)
28
Ø28 × 6, состав модуля не выбран [Д]
Центральный «глаз» Ø28
Параметры и метки (размеры в мм)
параметр
значение
метка
камера: плата
25 × 23,86 × 1,12; высота Wide 12
[И]
камера: отверстия
Ø2,2, 21 × 12,5, от края 2, M2
камера: линза Wide
Ø6,95 на корпусе 10,8 × 10,8; угол 102° × 67°
шлейф
15 x 1 мм FPC, 200 мм в комплекте
переходник
22→15 контактов, 300 мм
[И] thepihut.com
кольцо: Ø наруж. × толщина
44 × 4
[Д]
«глаз»: Ø × толщина
28 × 6
Установка и примечания
Камеры головы стоят за передней стенкой кожуха: окно Ø14 под линзу, 4 винта M2×8 по 21 × 12,5 мм с гайками DIN 985 изнутри; светодиодное кольцо приклеено к нару
окна, провода — через отверстие Ø4 под кольцом.
Задняя камера (на задней панели) крепится так же: окно Ø14 в оболочке и 4 винта M2×8; шлейф 22→15 идёт к Pi 5 (мультиплексор CSI — находка).
«Глаз» Ø28 приклеен к передней грани между камерами, провода — через отверстие Ø6 в стенке.
