pilot443/avad-s0/wrist-tools/assemblies/KRB.S0.07.200_SB.step

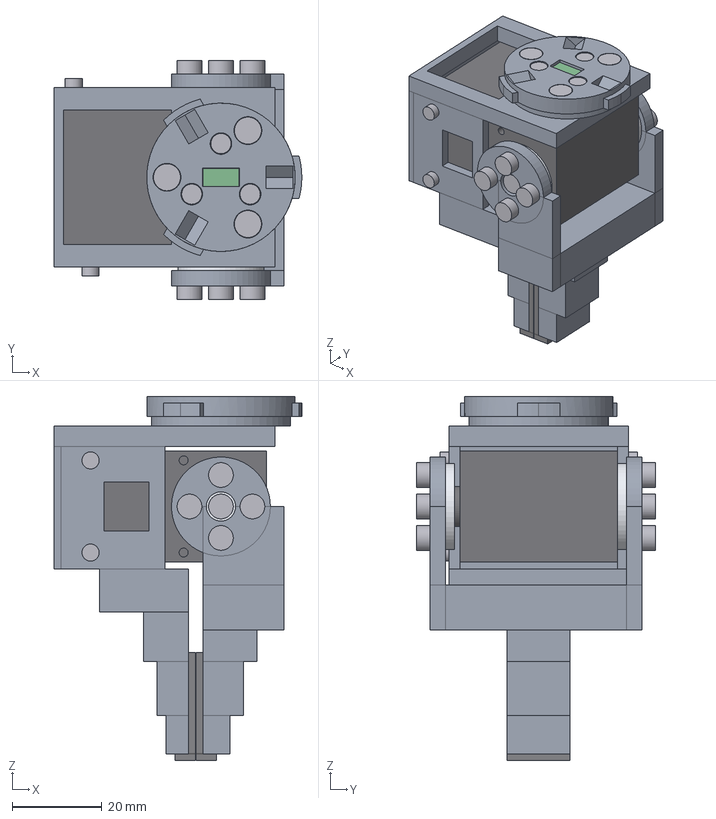
[picture p78: CAD file, 2026-11-09]
wrist-tools/assemblies/KRB.S0.07.200_SB.step
55.1 x 53.2 x 81.0 mm
01-Ð¿Ð»Ð¸ÑÐ°-1
02-ÑÐ°Ð¹Ð±Ð°-1
02-ÑÐ°Ð¹Ð±Ð°-2
02-ÑÐ°Ð¹Ð±Ð°-3
03-Ð¿Ð»Ð°ÑÐ°-1
04-Ð²Ð¸Ð½Ñ25-1
04-Ð²Ð¸Ð½Ñ25-2
04-Ð²Ð¸Ð½Ñ25-3
05-Ð¾ÑÐ½Ð¾Ð²Ð°Ð½Ð¸Ðµ-1
06-Ð²ÑÑÐ°Ð²ÐºÐ°-1
06-Ð²ÑÑÐ°Ð²ÐºÐ°-2
06-Ð²ÑÑÐ°Ð²ÐºÐ°-3
07-ÑÐµÑÐ²Ð¾-1
08-ÑÐ¾Ð³-1
09-ÑÐ¾Ð³_Ñ -1
10-Ð³ÑÐ±ÐºÐ°-1
11-Ð½Ð°ÐºÐ»_Ð¿-1
12-Ð½Ð°ÐºÐ»_Ð½-1
13-Ð²Ð¸Ð½Ñ3Ñ-1
13-Ð²Ð¸Ð½Ñ3Ñ-2
13-Ð²Ð¸Ð½Ñ3Ñ-3
13-Ð²Ð¸Ð½Ñ3Ñ-4
14-Ð²Ð¸Ð½Ñ3Ñ -1
14-Ð²Ð¸Ð½Ñ3Ñ -2
14-Ð²Ð¸Ð½Ñ3Ñ -3
14-Ð²Ð¸Ð½Ñ3Ñ -4
15-Ð²Ð¸Ð½Ñ3Ñ-1
16-Ð²Ð¸Ð½Ñ2Ñ-1
16-Ð²Ð¸Ð½Ñ2Ñ-2
17-Ð²Ð¸Ð½Ñ2Ð¿-1
17-Ð²Ð¸Ð½Ñ2Ð¿-2
