pilot443/avad-s0/wrist-tools/KRB.S0.07.014_nakladka-nepodvizhnoi.step

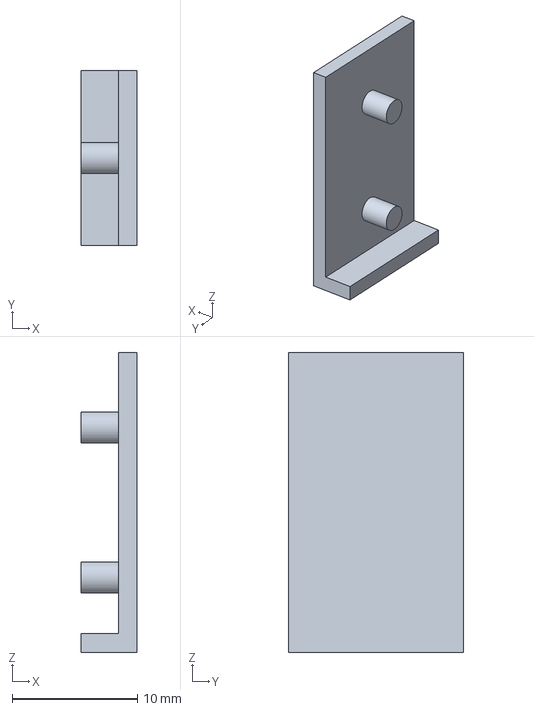
[picture p79: CAD file, 2026-11-09]
wrist-tools/KRB.S0.07.014_nakladka-nepodvizhnoi.step
4.50 x 14.0 x 24.0 mm
