pilot443/avad-s0/assemblies/KRB.S0.01.000_SB.step

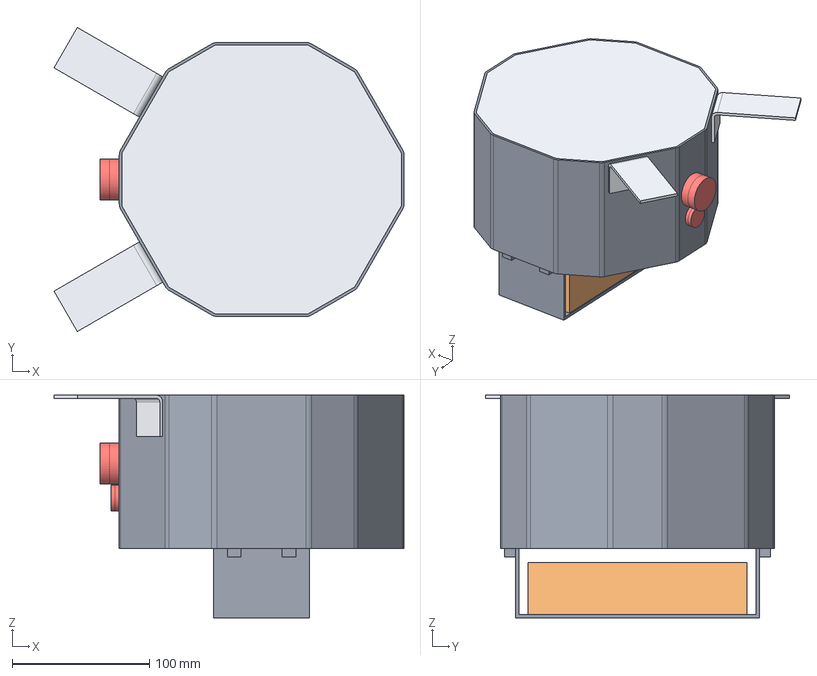
[picture p80: CAD file, 2026-11-09]
assemblies/KRB.S0.01.000_SB.step
255.5 x 221.9 x 162.5 mm
01-ÐºÐ¾ÑÐ¿ÑÑ_ÐºÐ¾Ð»ÑÑÐ¾-1
02-Ð¿Ð»Ð¸ÑÐ°_Ð½Ð¸Ð·-1
03-Ð¿Ð»Ð¸ÑÐ°_Ð²ÐµÑÑ -1
04-Ð¿Ð¾Ð»ÐºÐ°-1
05-Ð»Ð¾ÑÐ¾Ðº_Ð±Ð°ÑÐ°ÑÐµÐ¸-1
06-ÐºÑÐ¾Ð½ÑÑÐµÐ¹Ð½-1
06-ÐºÑÐ¾Ð½ÑÑÐµÐ¹Ð½-2
07-Ð±Ð°ÑÐ°ÑÐµÑ-1
08-rpi5-1
09-Ð¿Ð»Ð°ÑÐ°-1
09-Ð¿Ð»Ð°ÑÐ°-2
09-Ð¿Ð»Ð°ÑÐ°-3
09-Ð¿Ð»Ð°ÑÐ°-4
09-Ð¿Ð»Ð°ÑÐ°-5
09-Ð¿Ð»Ð°ÑÐ°-6
09-Ð¿Ð»Ð°ÑÐ°-7
09-Ð¿Ð»Ð°ÑÐ°-8
09-Ð¿Ð»Ð°ÑÐ°-9
09-Ð¿Ð»Ð°ÑÐ°-10
09-Ð¿Ð»Ð°ÑÐ°-11
09-Ð¿Ð»Ð°ÑÐ°-12
09-Ð¿Ð»Ð°ÑÐ°-13
09-Ð¿Ð»Ð°ÑÐ°-14
09-Ð¿Ð»Ð°ÑÐ°-15
09-Ð¿Ð»Ð°ÑÐ°-16
09-Ð¿Ð»Ð°ÑÐ°-17
09-Ð¿Ð»Ð°ÑÐ°-18
09-Ð¿Ð»Ð°ÑÐ°-19
09-Ð¿Ð»Ð°ÑÐ°-20
09-Ð¿Ð»Ð°ÑÐ°-21
09-Ð¿Ð»Ð°ÑÐ°-22
10-spk-1
10-spk-2
11-harness-1
12-estop-1
13-ÐºÐ»ÑÑ-1
14-Ð¿Ð¾ÑÑ-1
15-cam_Ð·Ð°Ð´-1
16-estop_ÑÐ»ÑÐ¿ÐºÐ°-1
17-ÐºÐ»ÑÑ_ÑÐ»ÑÐ¿ÐºÐ°-1
