pilot443/avad-s0/electrical/TB-01_servo-ids-and-buses.dxf

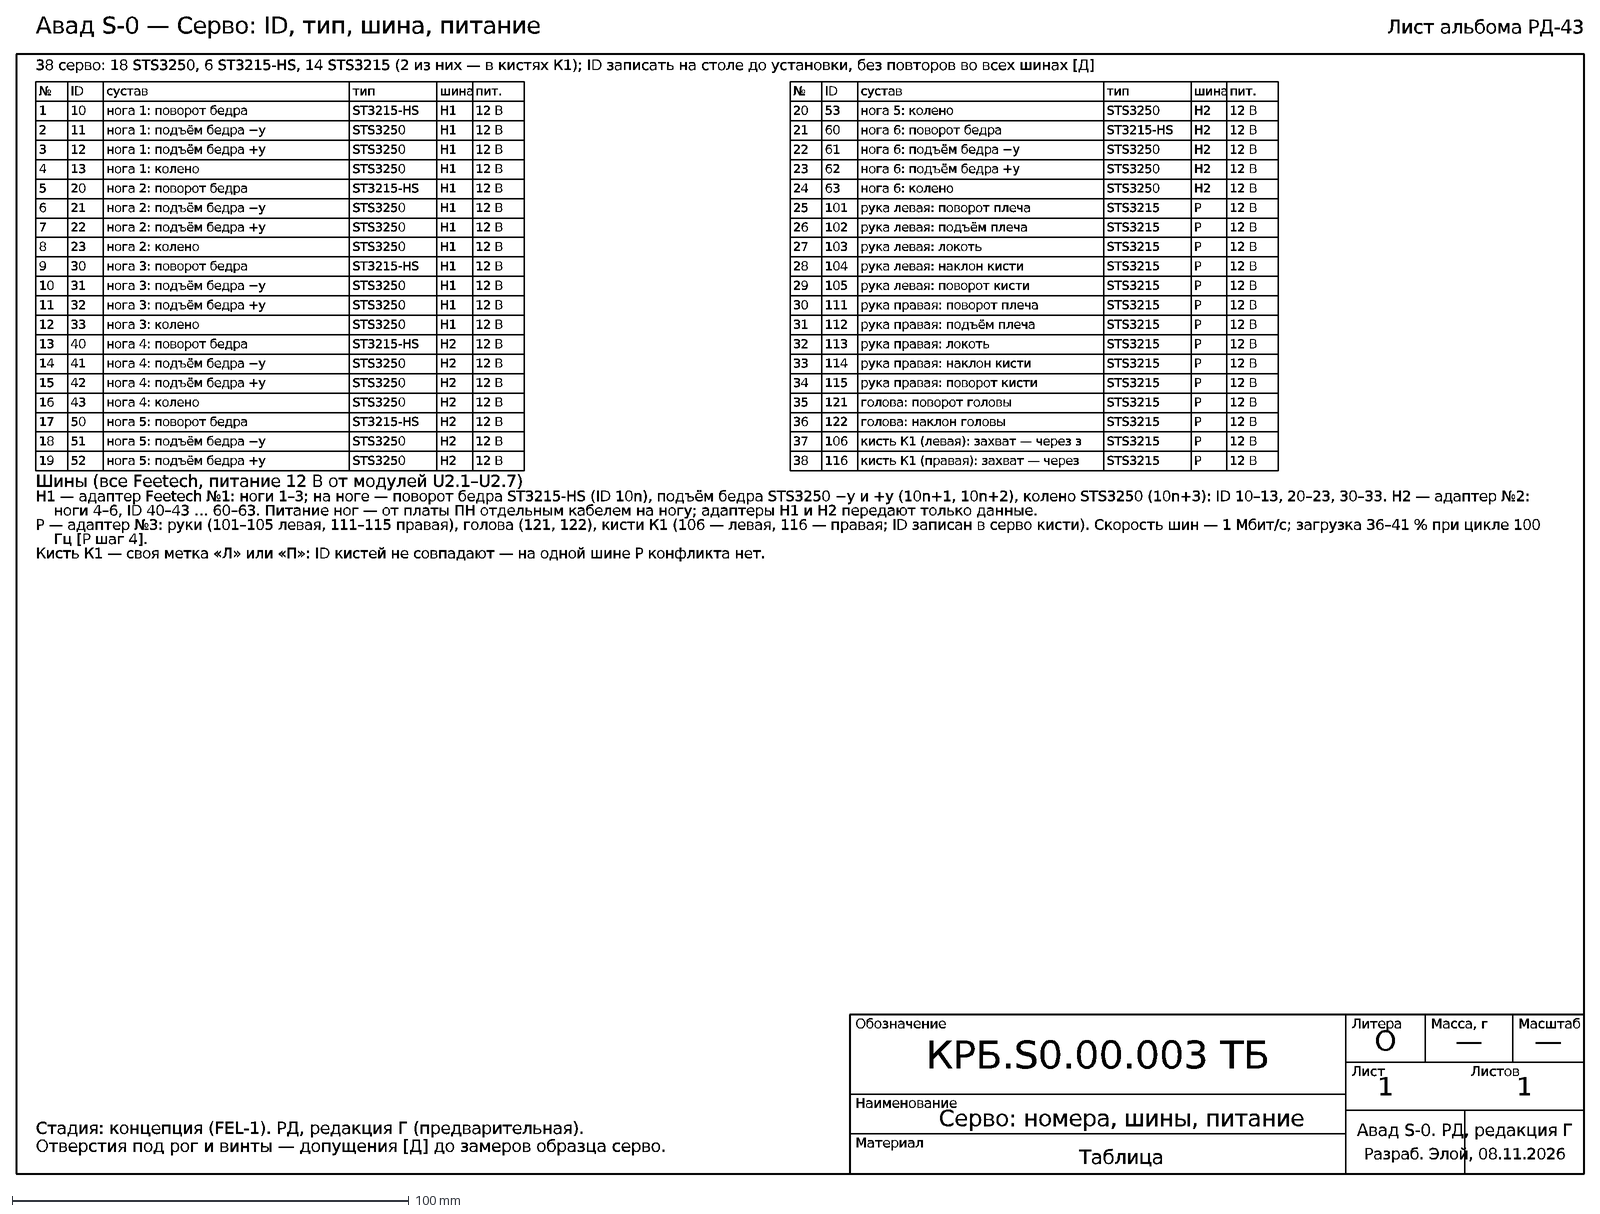
[picture p81: CAD file, 2026-11-09]
electrical/TB-01_servo-ids-and-buses.dxf
Стадия: концепция (FEL-1). РД, редакция Г (предварительная).
Отверстия под рог и винты — допущения [Д] до замеров образца серво.
Обозначение
Наименование
Материал
Литера
Масса, г
Масштаб
Лист
Листов
КРБ.S0.00.003 ТБ
О
—
1
Авад S-0. РД, редакция Г
Разраб. Элой, 08.11.2026
Серво: номера, шины, питание
Таблица
Авад S-0 — Серво: ID, тип, шина, питание
Лист альбома РД-43
38 серво: 18 STS3250, 6 ST3215-HS, 14 STS3215 (2 из них — в кистях К1); ID записать на столе до установки, без повторов во всех шинах [Д]
№
ID
сустав
тип
шина
пит.
10
нога 1: поворот бедра
ST3215-HS
Н1
12 В
2
11
нога 1: подъём бедра −y
STS3250
3
12
нога 1: подъём бедра +y
4
13
нога 1: колено
5
20
нога 2: поворот бедра
6
21
нога 2: подъём бедра −y
7
22
нога 2: подъём бедра +y
8
23
нога 2: колено
9
30
нога 3: поворот бедра
31
нога 3: подъём бедра −y
32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
