pilot443/avad-s0/parts/KRB.S0.02.001_ugolok-povorota-bedra.step

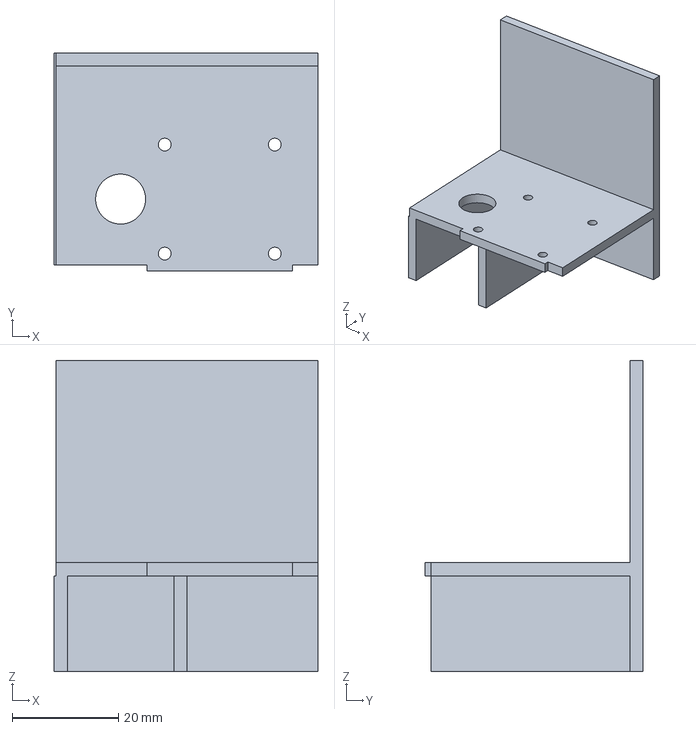
[picture p82: CAD file, 2026-11-09]
parts/KRB.S0.02.001_ugolok-povorota-bedra.step
49.6 x 41.0 x 58.5 mm
