pilot443/avad-s0/purchased-parts/KRB.S0.90.002_batareya-lotok.dxf

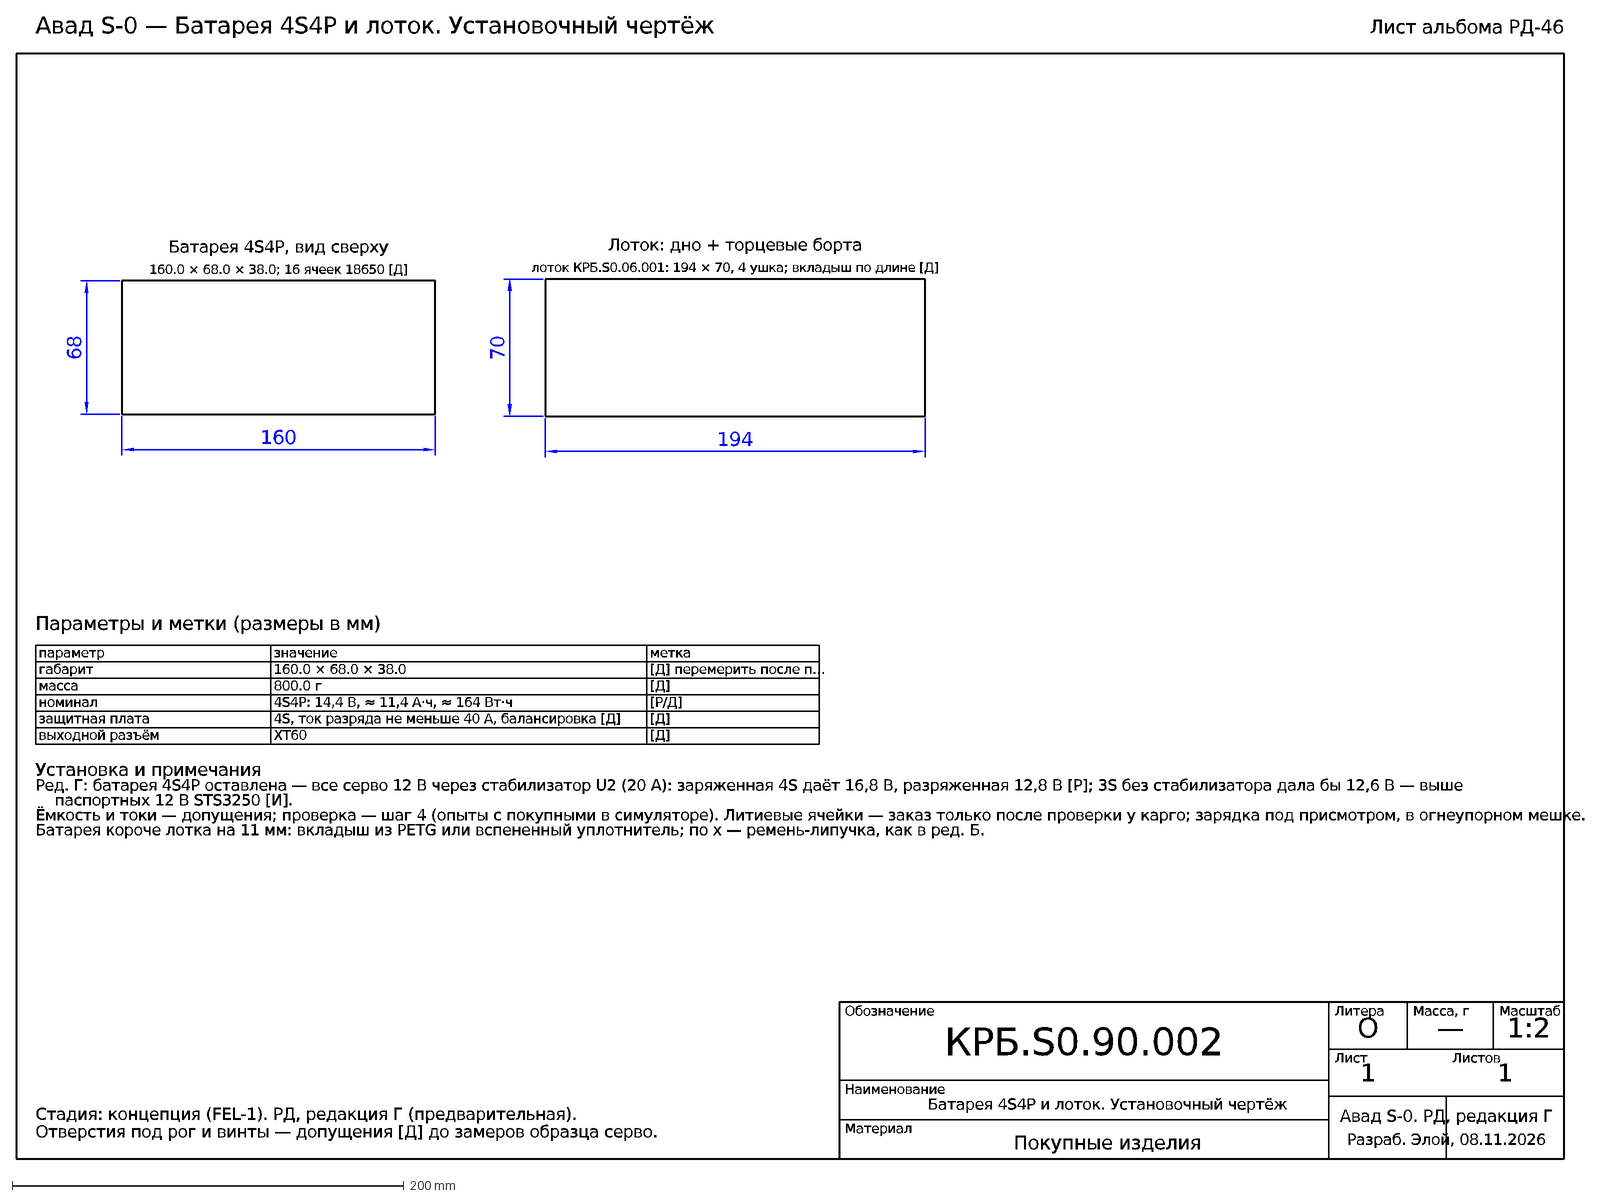
[picture p83: CAD file, 2026-11-09]
purchased-parts/KRB.S0.90.002_batareya-lotok.dxf
Стадия: концепция (FEL-1). РД, редакция Г (предварительная).
Отверстия под рог и винты — допущения [Д] до замеров образца серво.
Обозначение
Наименование
Материал
Литера
Масса, г
Масштаб
Лист
Листов
КРБ.S0.90.002
О
—
1:2
1
Авад S-0. РД, редакция Г
Разраб. Элой, 08.11.2026
Батарея 4S4P и лоток. Установочный чертёж
Покупные изделия
Авад S-0 — Батарея 4S4P и лоток. Установочный чертёж
Лист альбома РД-46
160
68
160.0 × 68.0 × 38.0; 16 ячеек 18650 [Д]
Батарея 4S4P, вид сверху
194
70
лоток КРБ.S0.06.001: 194 × 70, 4 ушка; вкладыш по длине [Д]
Лоток: дно + торцевые борта
Параметры и метки (размеры в мм)
параметр
значение
метка
габарит
160.0 × 68.0 × 38.0
[Д] перемерить после п…
масса
800.0 г
[Д]
номинал
4S4P: 14,4 В, ≈ 11,4 А·ч, ≈ 164 Вт·ч
[Р/Д]
защитная плата
4S, ток разряда не меньше 40 А, балансировка [Д]
выходной разъём
XT60
Установка и примечания
Ред. Г: батарея 4S4P оставлена — все серво 12 В через стабилизатор U2 (20 А): заряженная 4S даёт 16,8 В, разряженная 12,8 В [Р]; 3S без стабилизатора дала бы 12
паспортных 12 В STS3250 [И].
Ёмкость и токи — допущения; проверка — шаг 4 (опыты с покупными в симуляторе). Литиевые ячейки — заказ только после проверки у карго; зарядка под присмотром, в 
Батарея короче лотка на 11 мм: вкладыш из PETG или вспененный уплотнитель; по x — ремень-липучка, как в ред. Б.
