pilot443/avad-s0/sim/meshes-v26-k1/m263.stl

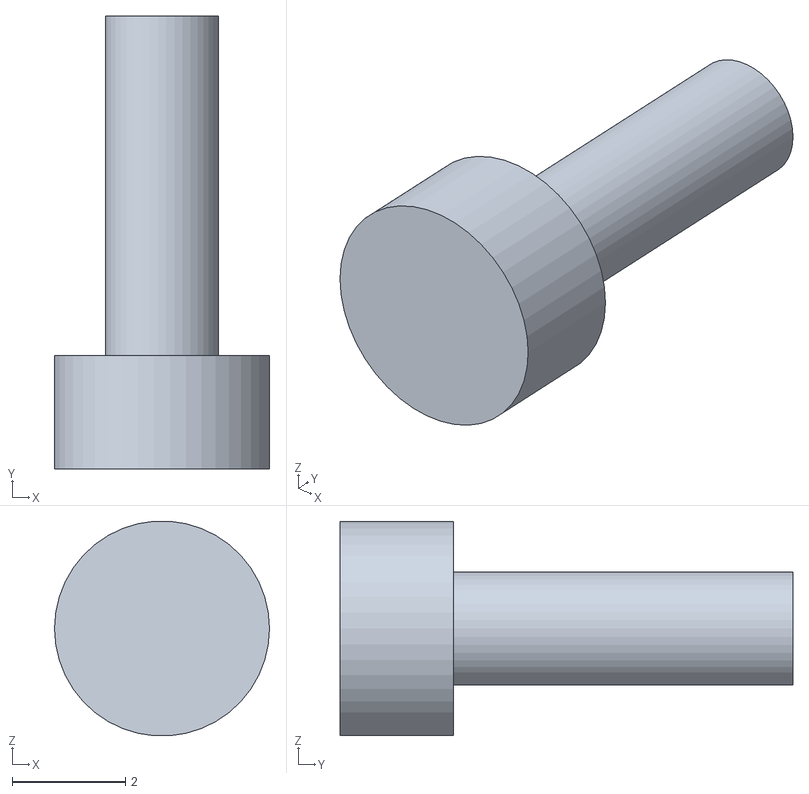
[picture p84: CAD file, 2026-11-09]
sim/meshes-v26-k1/m263.stl
3.80 x 8.00 x 3.79
