pilot443/avad-s0/wrist-tools/assemblies/KRB.S0.07.400_SB.step

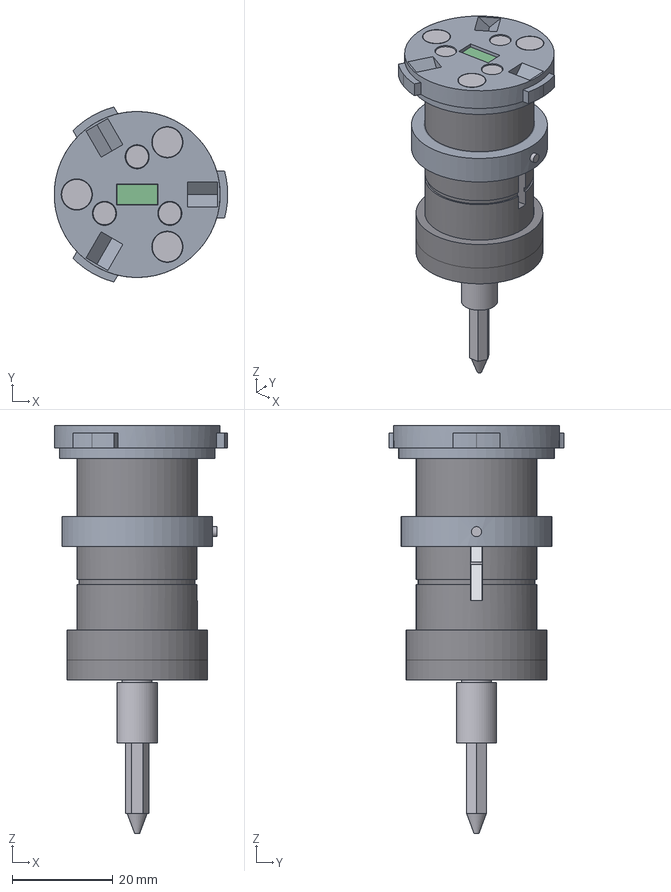
[picture p85: CAD file, 2026-11-09]
wrist-tools/assemblies/KRB.S0.07.400_SB.step
34.5 x 34.8 x 81.1 mm
01-Ð¿Ð»Ð¸ÑÐ°-1
02-ÑÐ°Ð¹Ð±Ð°-1
02-ÑÐ°Ð¹Ð±Ð°-2
02-ÑÐ°Ð¹Ð±Ð°-3
03-Ð¿Ð»Ð°ÑÐ°-1
04-Ð²Ð¸Ð½Ñ25-1
04-Ð²Ð¸Ð½Ñ25-2
04-Ð²Ð¸Ð½Ñ25-3
05-ÐºÐ¾ÑÐ¿ÑÑ-1
06-Ð²ÑÑÐ°Ð²ÐºÐ°-1
06-Ð²ÑÑÐ°Ð²ÐºÐ°-2
06-Ð²ÑÑÐ°Ð²ÐºÐ°-3
07-Ð¿Ð¾Ð´ÑÐ¸Ð¿Ð½Ð¸Ðº-1
07-Ð¿Ð¾Ð´ÑÐ¸Ð¿Ð½Ð¸Ðº-2
08-Ð²ÑÑÐ»ÐºÐ°-1
08-Ð²ÑÑÐ»ÐºÐ°-2
09-Ð¼ÑÑÑÐ°-1
09-Ð¼ÑÑÑÐ°-2
10-Ð²Ð°Ð»-1
11-e4-1
12-Ð¿ÐµÑÐµÐºÐ»ÑÑÐ°ÑÐµÐ»Ñ-1
13-ÑÑÐ¸ÑÑ-1
14-ÑÐ°ÑÐ¿Ð¾ÑÐºÐ°-1
15-ÐºÑÑÑÐºÐ°-1
16-Ð¼Ð°Ð³Ð½Ð¸Ñ3-1
17-Ð±Ð¸Ñ-1
