pilot443/avad-s0/wrist-tools/KRB.S0.07.034_kryshka-treshchotki.step

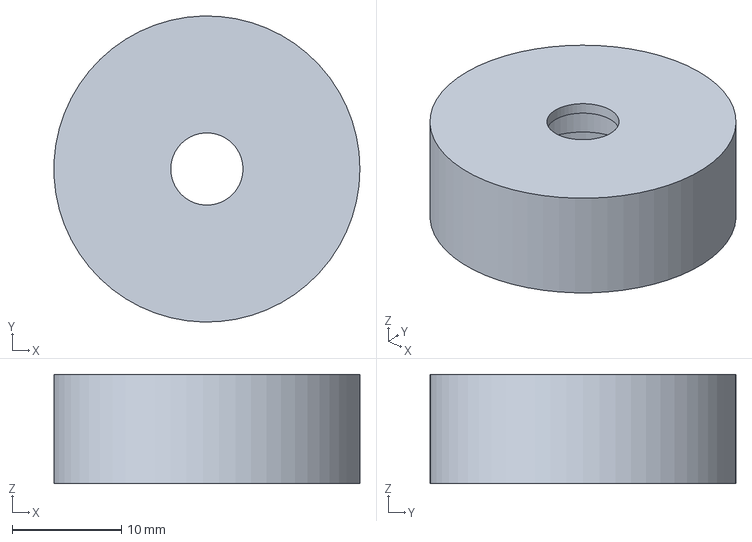
[picture p86: CAD file, 2026-11-09]
wrist-tools/KRB.S0.07.034_kryshka-treshchotki.step
28.0 x 28.0 x 10.0 mm
