pilot443/avad-s0/assemblies/KRB.S0.05.000_SB.step

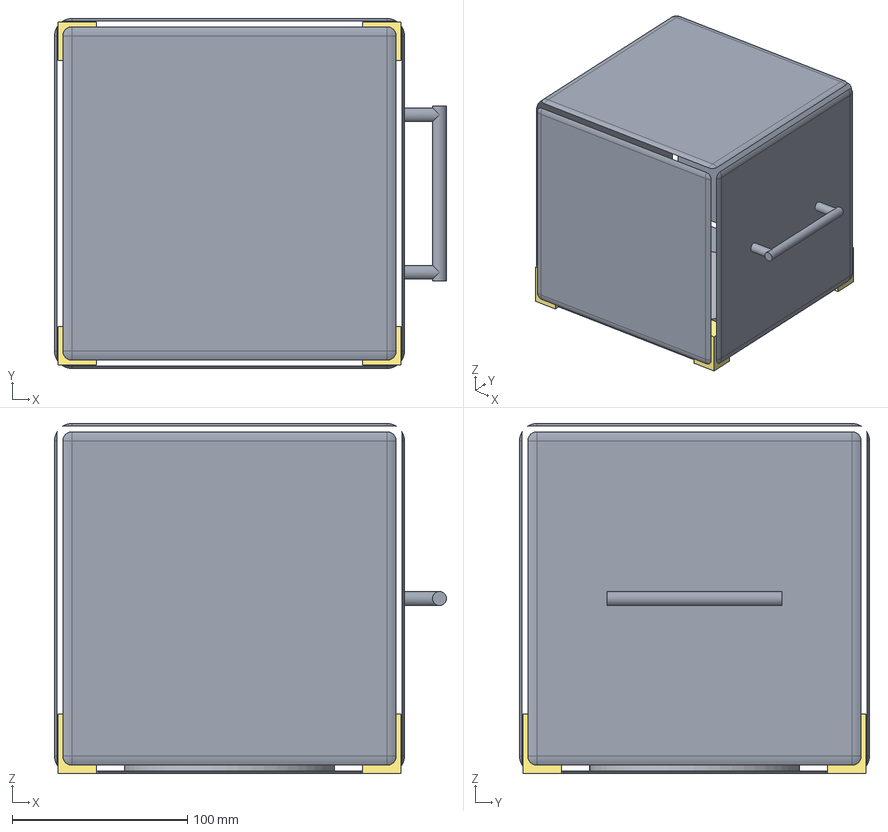
[picture p87: CAD file, 2026-11-09]
assemblies/KRB.S0.05.000_SB.step
224.0 x 200.0 x 200.0 mm
01-ÐºÐ¾Ð½ÑÐµÐ¹Ð½ÐµÑ-1
02-ÑÑÑÐºÐ°_ÐºÐ¾Ð½ÑÐµÐ¹Ð½ÐµÑÐ°-1
03-Ð´ÐµÑÐ¶Ð°ÑÐµÐ»Ñ-1
03-Ð´ÐµÑÐ¶Ð°ÑÐµÐ»Ñ-2
03-Ð´ÐµÑÐ¶Ð°ÑÐµÐ»Ñ-3
03-Ð´ÐµÑÐ¶Ð°ÑÐµÐ»Ñ-4
04-Ð±Ð°Ð»Ð»Ð°ÑÑ-1
