pilot443/avad-s0/electrical/MP-01_wiring-diagram.dxf

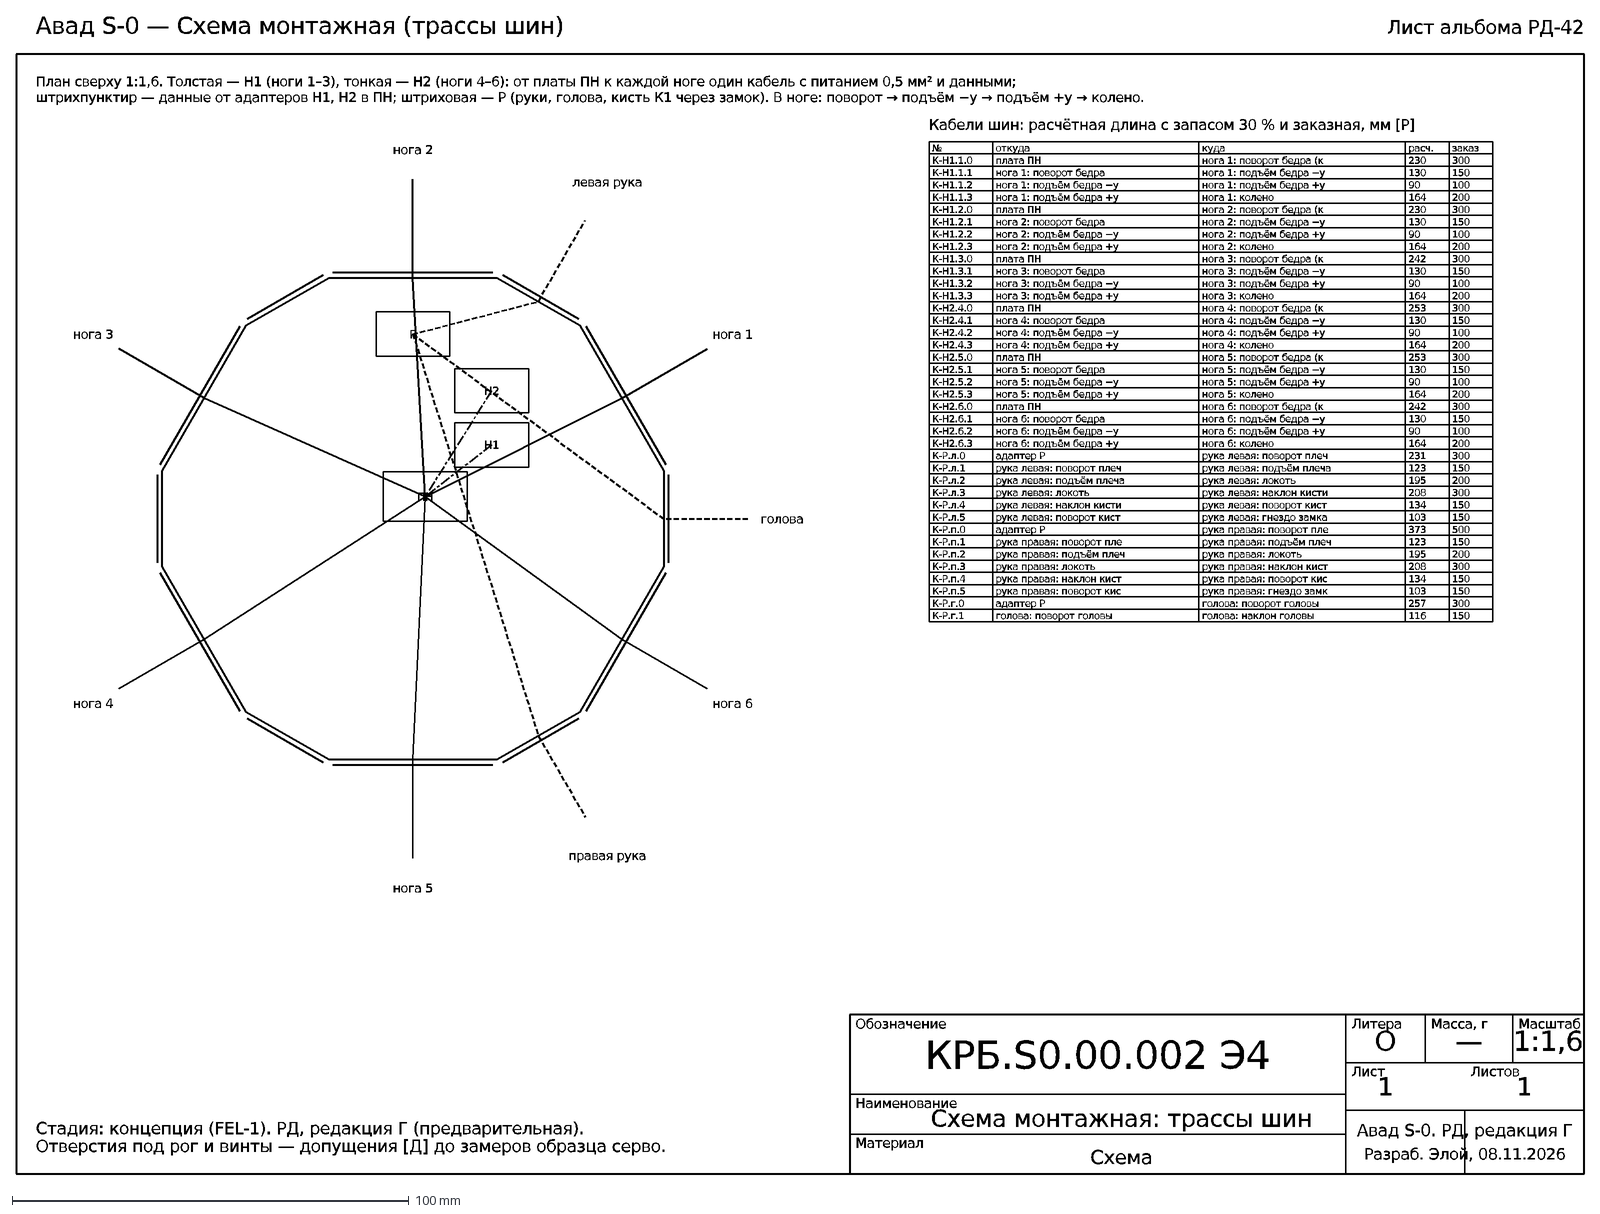
[picture p88: CAD file, 2026-11-09]
electrical/MP-01_wiring-diagram.dxf
Стадия: концепция (FEL-1). РД, редакция Г (предварительная).
Отверстия под рог и винты — допущения [Д] до замеров образца серво.
Обозначение
Наименование
Материал
Литера
Масса, г
Масштаб
Лист
Листов
КРБ.S0.00.002 Э4
О
—
1:1,6
1
Авад S-0. РД, редакция Г
Разраб. Элой, 08.11.2026
Схема монтажная: трассы шин
Схема
Авад S-0 — Схема монтажная (трассы шин)
Лист альбома РД-42
Н1
Н2
ПН
Р
нога 1
нога 2
нога 3
нога 4
нога 5
нога 6
левая рука
правая рука
голова
План сверху 1:1,6. Толстая — Н1 (ноги 1–3), тонкая — Н2 (ноги 4–6): от платы ПН к каждой ноге один кабель с питанием 0,5 мм² и данными;
штрихпунктир — данные от адаптеров Н1, Н2 в ПН; штриховая — Р (руки, голова, кисть К1 через замок). В ноге: поворот → подъём −y → подъём +y → колено.
Кабели шин: расчётная длина с запасом 30 % и заказная, мм [Р]
№
откуда
куда
расч.
заказ
К-Н1.1.0
плата ПН
нога 1: поворот бедра (к
230
300
К-Н1.1.1
нога 1: поворот бедра
нога 1: подъём бедра −y
130
150
К-Н1.1.2
нога 1: подъём бедра +y
90
100
К-Н1.1.3
нога 1: колено
164
200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
