pilot443/avad-s0/parts/KRB.S0.02.008_stopa.step

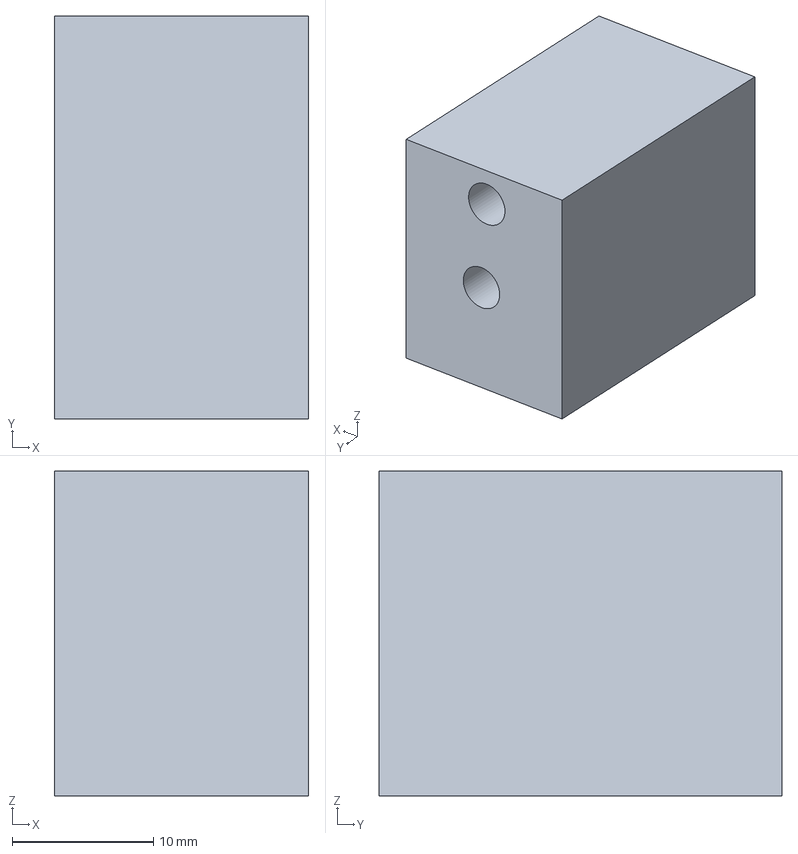
[picture p89: CAD file, 2026-11-09]
parts/KRB.S0.02.008_stopa.step
18.0 x 28.5 x 23.0 mm
