pilot443/avad-s0/purchased-parts/KRB.S0.90.001_servo-STS3215.dxf

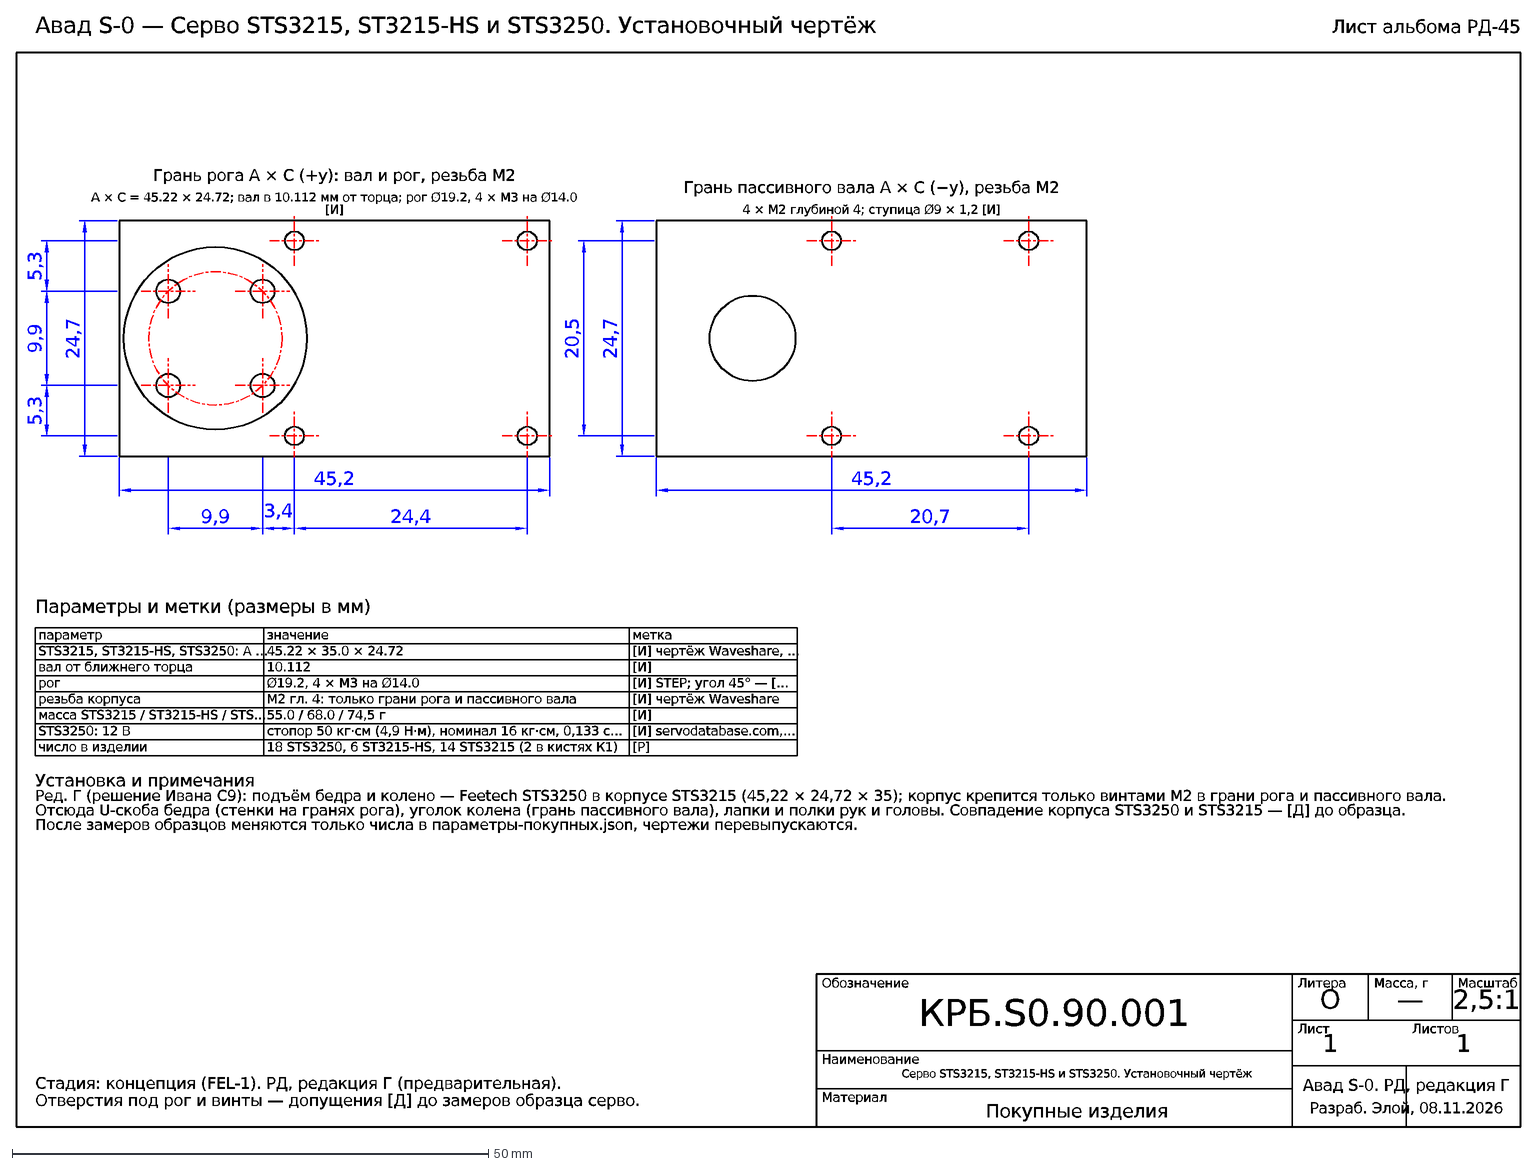
[picture p90: CAD file, 2026-11-09]
purchased-parts/KRB.S0.90.001_servo-STS3215.dxf
Стадия: концепция (FEL-1). РД, редакция Г (предварительная).
Отверстия под рог и винты — допущения [Д] до замеров образца серво.
Обозначение
Наименование
Материал
Литера
Масса, г
Масштаб
Лист
Листов
КРБ.S0.90.001
О
—
2,5:1
1
Авад S-0. РД, редакция Г
Разраб. Элой, 08.11.2026
Серво STS3215, ST3215-HS и STS3250. Установочный чертёж
Покупные изделия
Авад S-0 — Серво STS3215, ST3215-HS и STS3250. Установочный чертёж
Лист альбома РД-45
45,2
24,7
9,9
3,4
24,4
5,3
A × C = 45.22 × 24.72; вал в 10.112 мм от торца; рог Ø19.2, 4 × M3 на Ø14.0
[И]
Грань рога A × C (+y): вал и рог, резьба M2
20,7
20,5
4 × M2 глубиной 4; ступица Ø9 × 1,2 [И]
Грань пассивного вала A × C (−y), резьба M2
Параметры и метки (размеры в мм)
параметр
значение
метка
STS3215, ST3215-HS, STS3250: A …
45.22 × 35.0 × 24.72
[И] чертёж Waveshare, …
вал от ближнего торца
10.112
рог
Ø19.2, 4 × M3 на Ø14.0
[И] STEP; угол 45° — […
резьба корпуса
M2 гл. 4: только грани рога и пассивного вала
[И] чертёж Waveshare
масса STS3215 / ST3215-HS / STS…
55.0 / 68.0 / 74,5 г
STS3250: 12 В
стопор 50 кг·см (4,9 Н·м), номинал 16 кг·см, 0,133 с…
[И] servodatabase.com,…
число в изделии
18 STS3250, 6 ST3215-HS, 14 STS3215 (2 в кистях К1)
[Р]
Установка и примечания
Ред. Г (решение Ивана С9): подъём бедра и колено — Feetech STS3250 в корпусе STS3215 (45,22 × 24,72 × 35); корпус крепится только винтами M2 в грани рога и пасс
Отсюда U-скоба бедра (стенки на гранях рога), уголок колена (грань пассивного вала), лапки и полки рук и головы. Совпадение корпуса STS3250 и STS3215 — [Д] до о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
