pilot443/avad-s0/sim/meshes-v26-k1/m188.stl

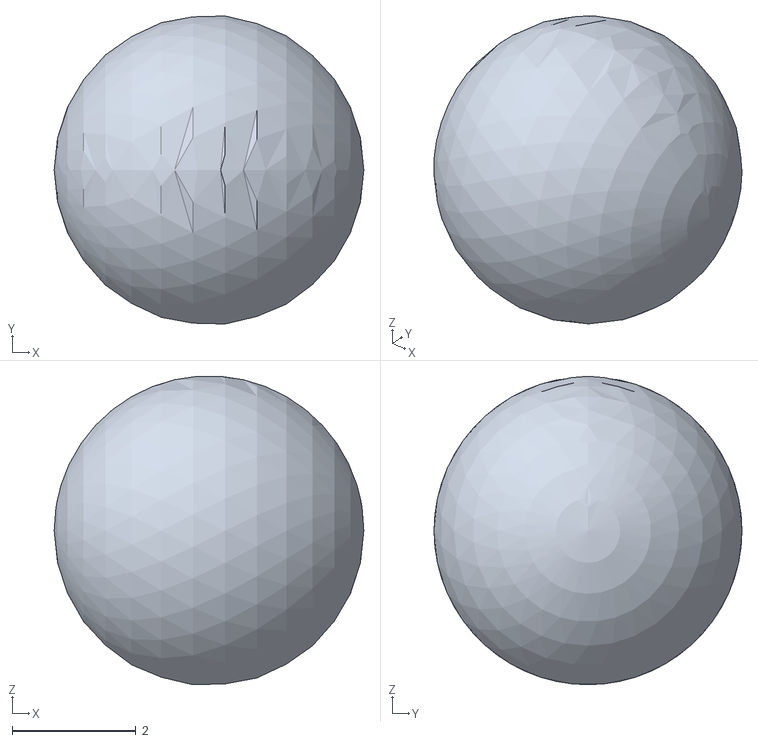
[picture p91: CAD file, 2026-11-09]
sim/meshes-v26-k1/m188.stl
5.00 x 4.97 x 4.98
