pilot443/avad-s0/wrist-tools/KRB.S0.07.012_gubka-podvizhnaya.step

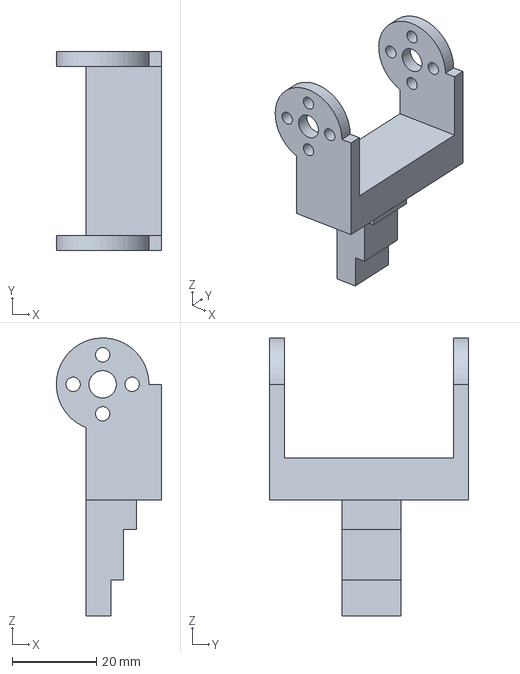
[picture p92: CAD file, 2026-11-09]
wrist-tools/KRB.S0.07.012_gubka-podvizhnaya.step
25.0 x 47.2 x 66.0 mm
