pilot443/avad-s0/assemblies/KRB.S0.04.000_SB.step

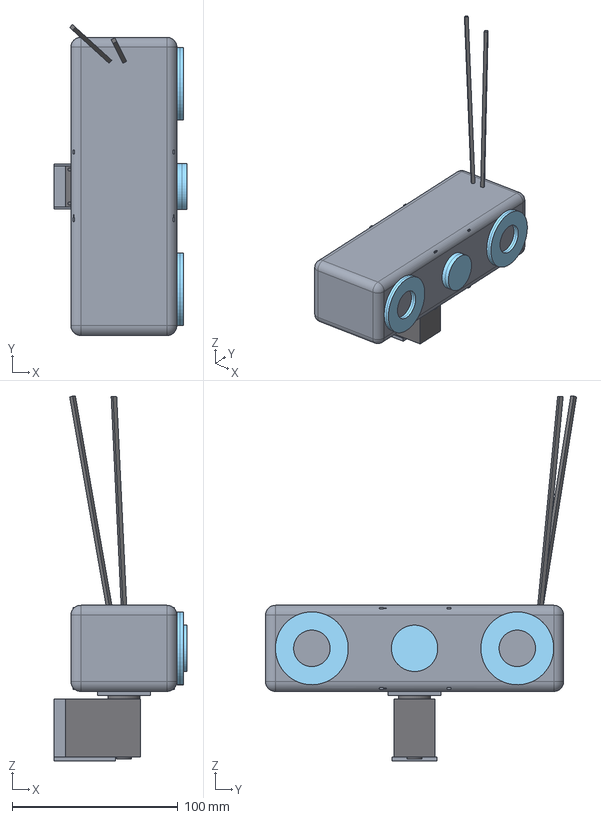
[picture p93: CAD file, 2026-11-09]
assemblies/KRB.S0.04.000_SB.step
80.1 x 187.7 x 220.3 mm
01-Ð³Ð¾Ð»Ð¾Ð²Ð°_ÐºÐ¾Ð¶ÑÑ -1
02-ÑÑÐ¾Ð¹ÐºÐ°_Ð³Ð¾Ð»Ð¾Ð²Ñ-1
03-ÐºÐ¾Ð½ÑÐ¾Ð»Ñ_ÑÐµÐ¸-1
04-ÑÐ¾Ð³-1
04-ÑÐ¾Ð³-2
05-cam-1
05-cam-2
06-ÐºÐ¾Ð»ÑÑÐ¾-1
06-ÐºÐ¾Ð»ÑÑÐ¾-2
07-Ð³Ð»Ð°Ð·-1
08-Ð°Ð½ÑÐµÐ½Ð½Ð°-1
08-Ð°Ð½ÑÐµÐ½Ð½Ð°-2
09-ÑÐµÑÐ²Ð¾-1
09-ÑÐµÑÐ²Ð¾-2
