pilot443/avad-s0/electrical/PZ-01_schematic.dxf

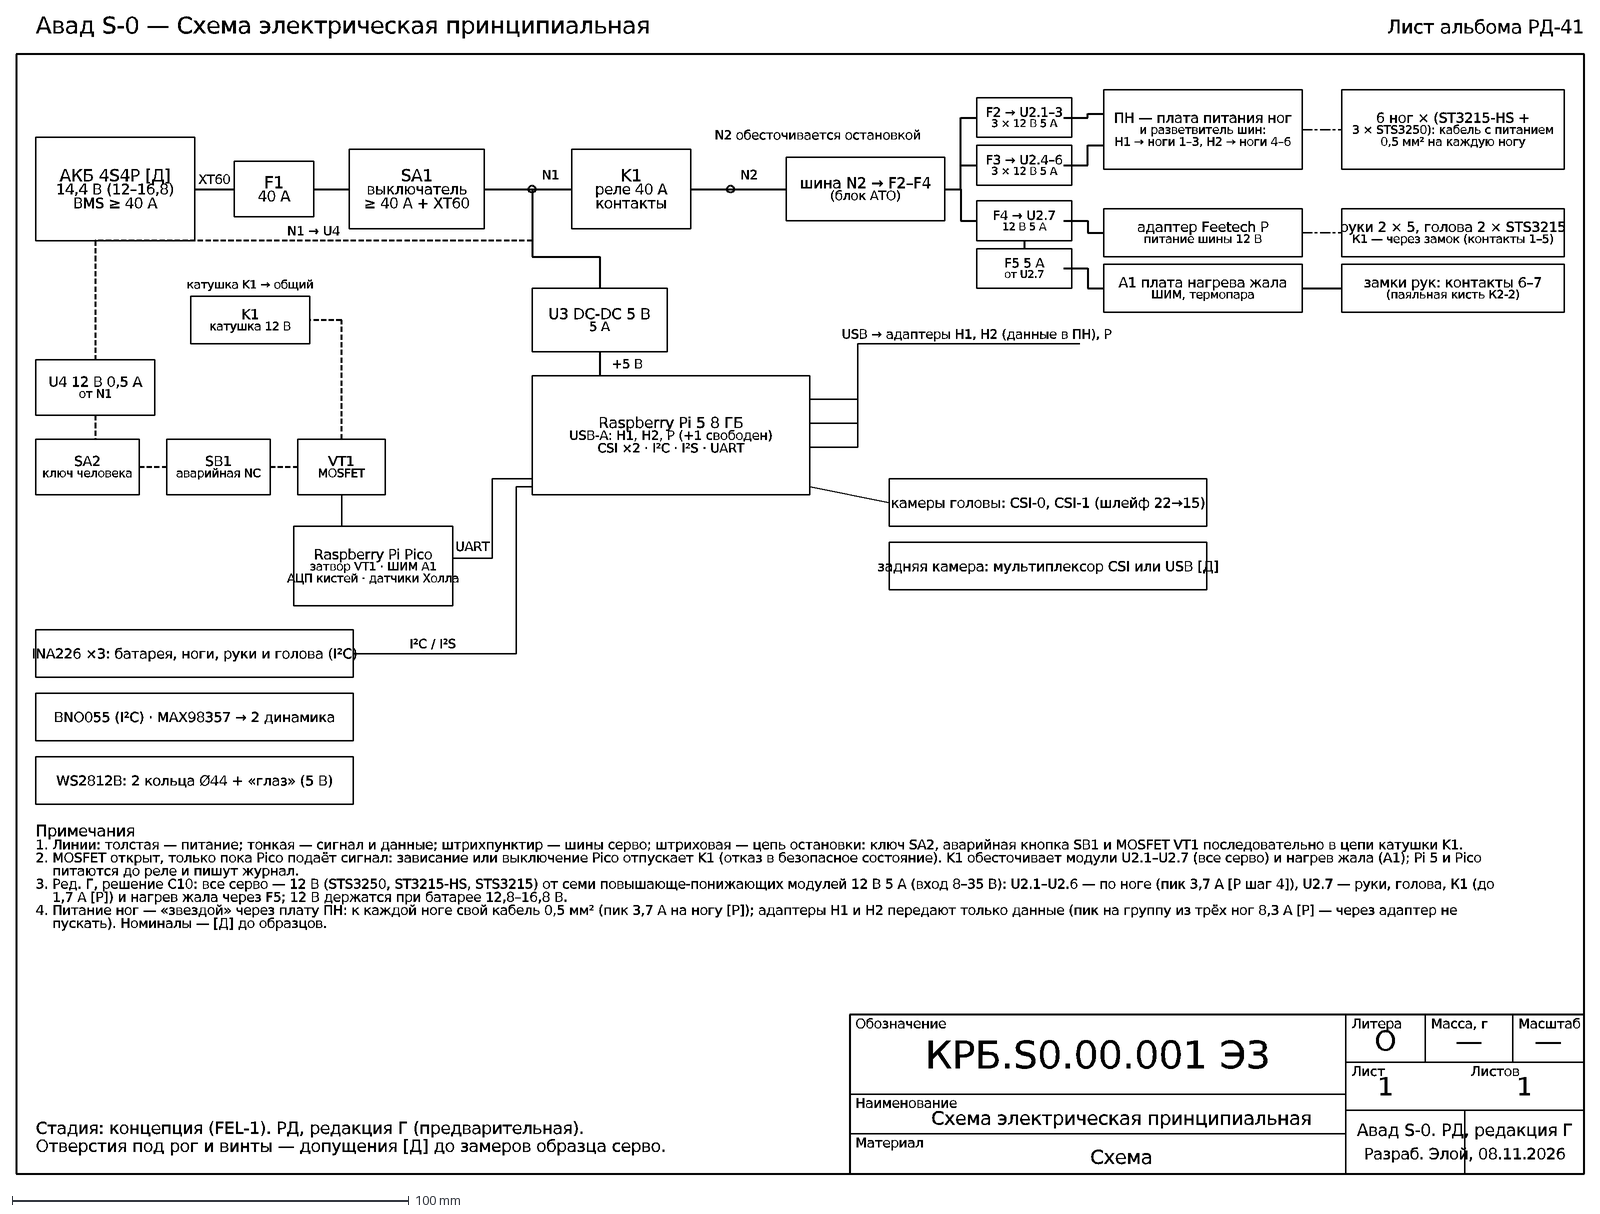
[picture p94: CAD file, 2026-11-09]
electrical/PZ-01_schematic.dxf
Стадия: концепция (FEL-1). РД, редакция Г (предварительная).
Отверстия под рог и винты — допущения [Д] до замеров образца серво.
Обозначение
Наименование
Материал
Литера
Масса, г
Масштаб
Лист
Листов
КРБ.S0.00.001 Э3
О
—
1
Авад S-0. РД, редакция Г
Разраб. Элой, 08.11.2026
Схема электрическая принципиальная
Схема
Авад S-0 — Схема электрическая принципиальная
Лист альбома РД-41
АКБ 4S4P [Д]
14,4 В (12–16,8)
BMS ≥ 40 А
F1
40 А
SA1
выключатель
≥ 40 А + XT60
XT60
N1
K1
реле 40 А
контакты
N2
N2 обесточивается остановкой
шина N2 → F2–F4
(блок ATO)
F2 → U2.1–3
3 × 12 В 5 А
F3 → U2.4–6
F4 → U2.7
12 В 5 А
F5 5 А
от U2.7
ПН — плата питания ног
и разветвитель шин:
Н1 → ноги 1–3, Н2 → ноги 4–6
адаптер Feetech Р
питание шины 12 В
A1 плата нагрева жала
ШИМ, термопара
6 ног × (ST3215-HS +
3 × STS3250): кабель с питанием
0,5 мм² на каждую ногу
руки 2 × 5, голова 2 × STS3215
К1 — через замок (контакты 1–5)
замки рук: контакты 6–7
(паяльная кисть К2-2)
U3 DC-DC 5 В
5 А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
