pilot443/avad-s0/parts/KRB.S0.01.002_plita-nizhnyaya.step

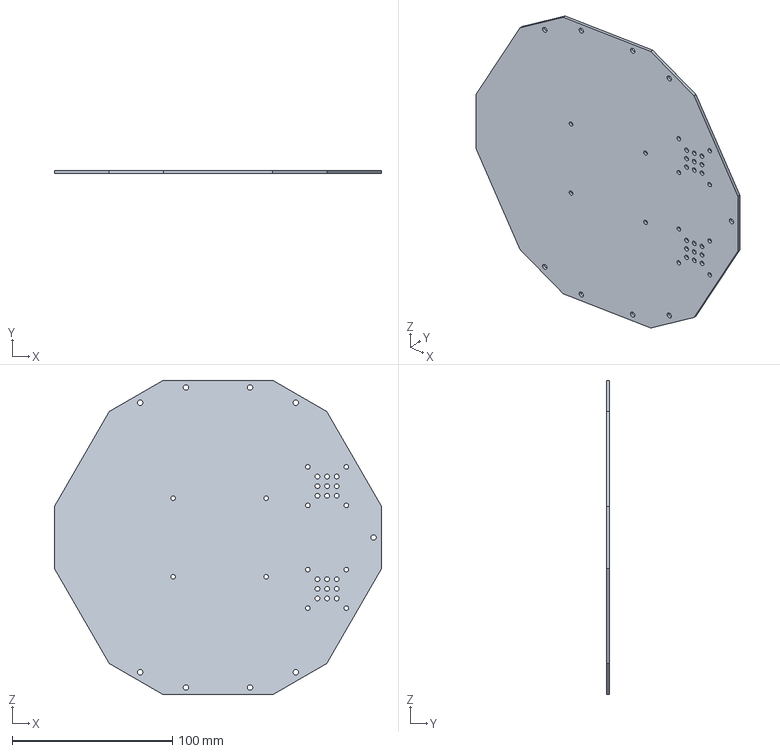
[picture p95: CAD file, 2026-11-09]
parts/KRB.S0.01.002_plita-nizhnyaya.step
203.8 x 2.00 x 196.0 mm
