pilot443/avad-s0/purchased-parts/KRB.S0.90.006_pitanie-bezopasnost.dxf

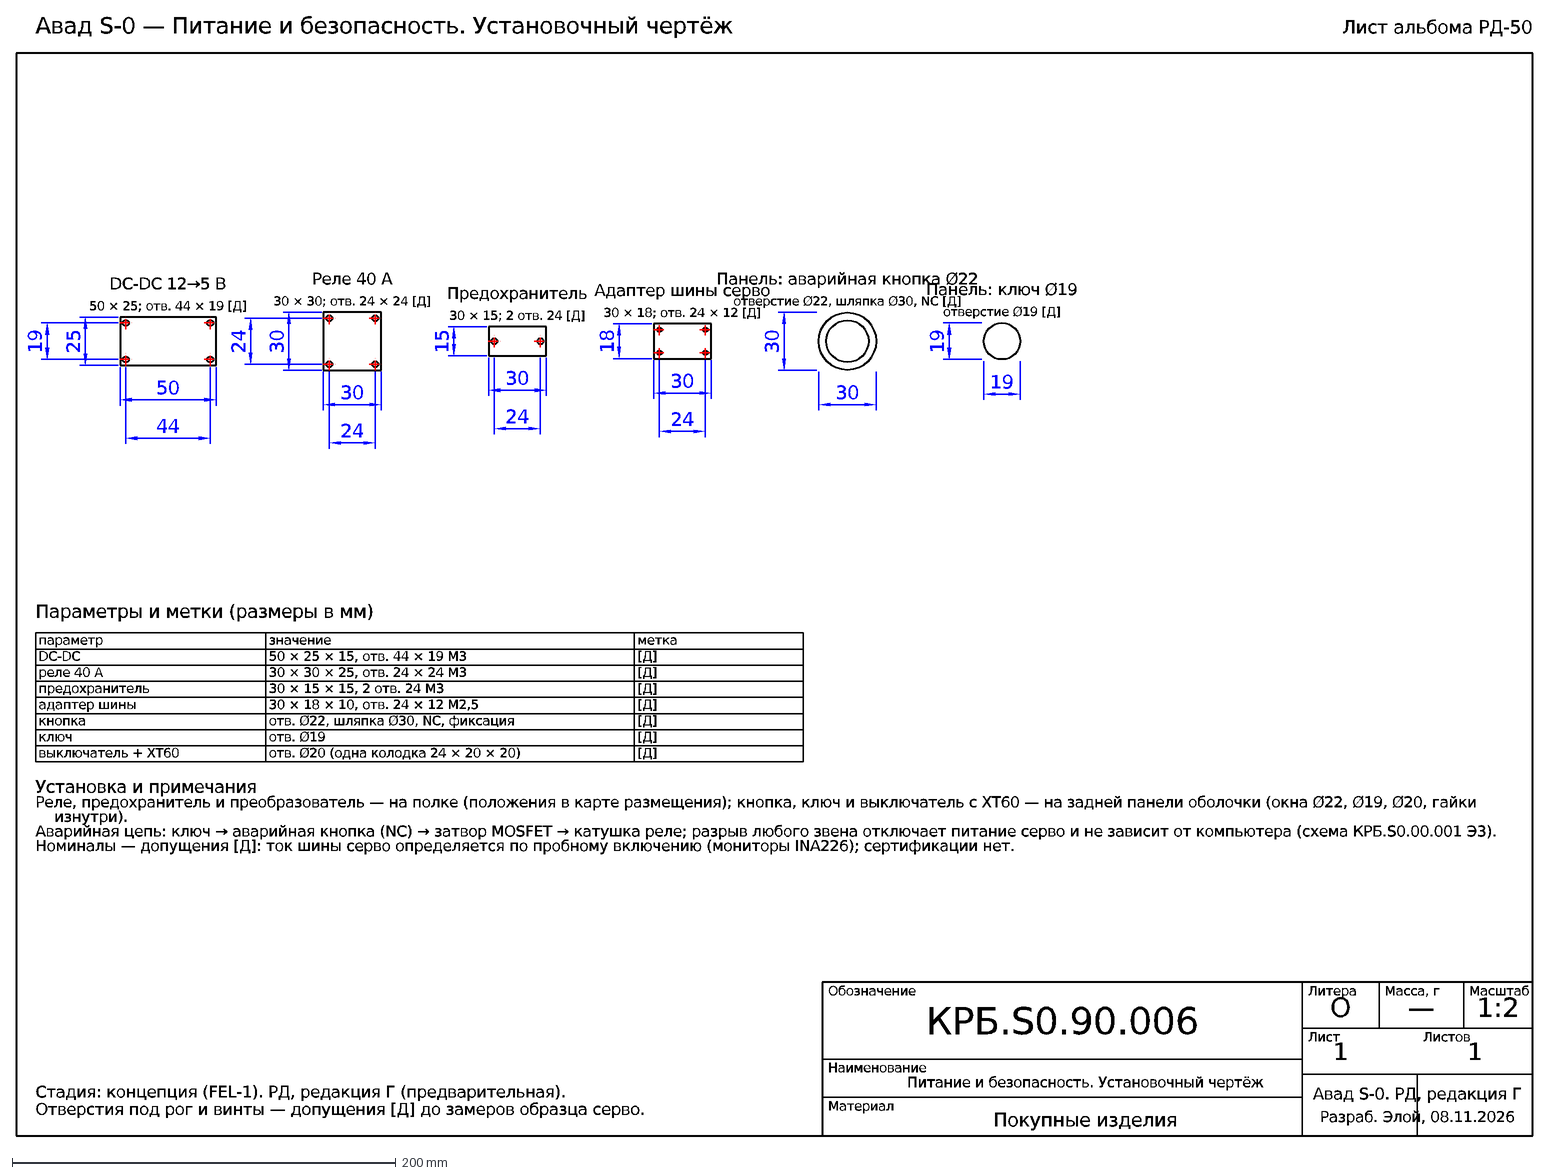
[picture p96: CAD file, 2026-11-09]
purchased-parts/KRB.S0.90.006_pitanie-bezopasnost.dxf
Стадия: концепция (FEL-1). РД, редакция Г (предварительная).
Отверстия под рог и винты — допущения [Д] до замеров образца серво.
Обозначение
Наименование
Материал
Литера
Масса, г
Масштаб
Лист
Листов
КРБ.S0.90.006
О
—
1:2
1
Авад S-0. РД, редакция Г
Разраб. Элой, 08.11.2026
Питание и безопасность. Установочный чертёж
Покупные изделия
Авад S-0 — Питание и безопасность. Установочный чертёж
Лист альбома РД-50
50
25
44
19
50 × 25; отв. 44 × 19 [Д]
DC-DC 12→5 В
30
24
30 × 30; отв. 24 × 24 [Д]
Реле 40 А
15
30 × 15; 2 отв. 24 [Д]
Предохранитель
18
30 × 18; отв. 24 × 12 [Д]
Адаптер шины серво
отверстие Ø22, шляпка Ø30, NC [Д]
Панель: аварийная кнопка Ø22
отверстие Ø19 [Д]
Панель: ключ Ø19
Параметры и метки (размеры в мм)
параметр
значение
метка
DC-DC
50 × 25 × 15, отв. 44 × 19 M3
[Д]
реле 40 А
30 × 30 × 25, отв. 24 × 24 M3
предохранитель
30 × 15 × 15, 2 отв. 24 M3
адаптер шины
30 × 18 × 10, отв. 24 × 12 M2,5
кнопка
отв. Ø22, шляпка Ø30, NC, фиксация
ключ
отв. Ø19
выключатель + XT60
отв. Ø20 (одна колодка 24 × 20 × 20)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
