pilot443/avad-s0/sim/meshes-v26-k1/m227.stl

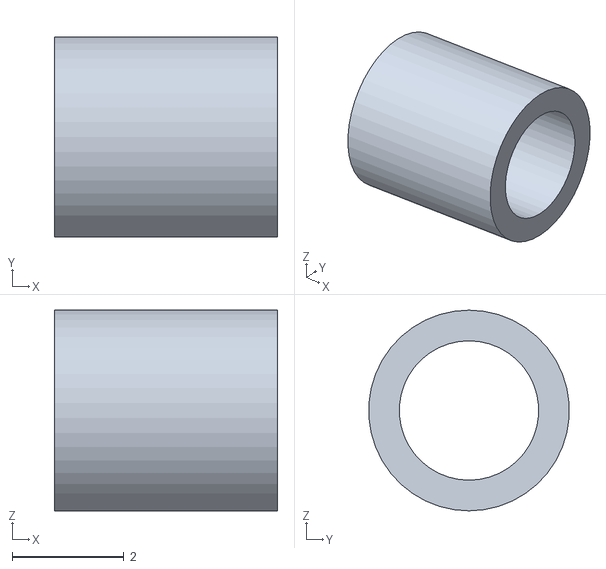
[picture p97: CAD file, 2026-11-09]
sim/meshes-v26-k1/m227.stl
4.00 x 3.59 x 3.60
