pilot443/avad-s0/assemblies/KRB.S0.02.100_SB.step

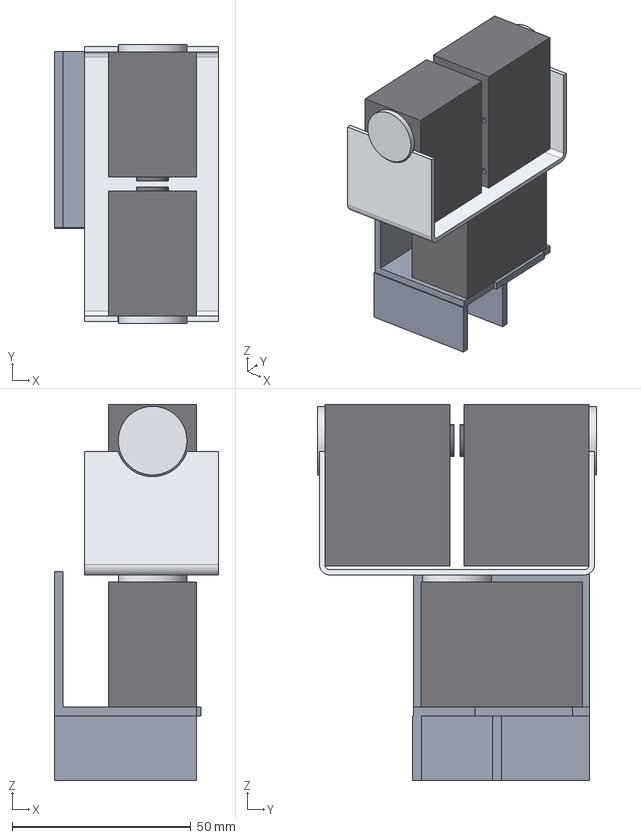
[picture p98: CAD file, 2026-11-09]
assemblies/KRB.S0.02.100_SB.step
46.0 x 78.0 x 105.2 mm
01-ÑÐ³Ð¾Ð»Ð¾Ðº-1
02-ÑÐºÐ¾Ð±Ð°-1
03-ÑÐµÑÐ²Ð¾_hs-1
04-ÑÐµÑÐ²Ð¾_xm-1
04-ÑÐµÑÐ²Ð¾_xm-2
05-ÑÐ¾Ð³-1
06-ÑÐ¾Ð³_xm-1
06-ÑÐ¾Ð³_xm-2
