pilot443/avad-s0/parts/KRB.S0.03.001_ploshchadka-plecha.step

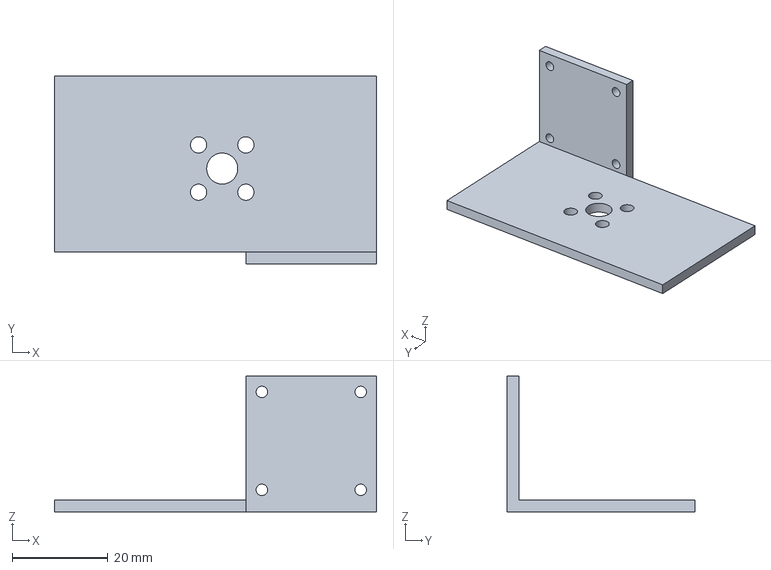
[picture p99: CAD file, 2026-11-09]
parts/KRB.S0.03.001_ploshchadka-plecha.step
67.4 x 39.4 x 28.4 mm
