pilot443/avad-s0/wrist-tools/KRB.S0.07.003_otvetnaya-plita.step

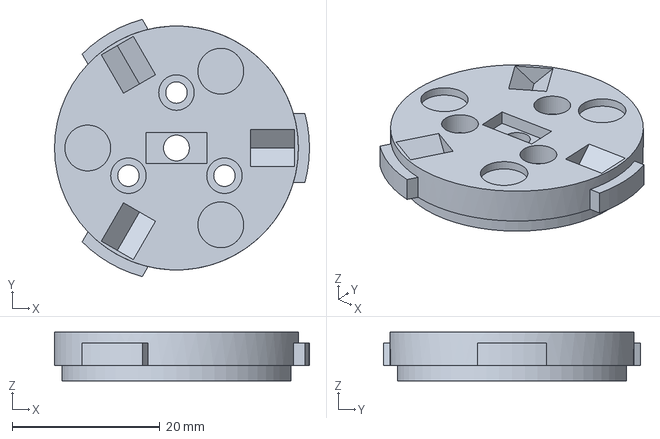
[picture p100: CAD file, 2026-11-09]
wrist-tools/KRB.S0.07.003_otvetnaya-plita.step
34.5 x 34.8 x 6.60 mm
