pilot443/avad-s0/parts/KRB.S0.02.005_peremychka-kolena.step

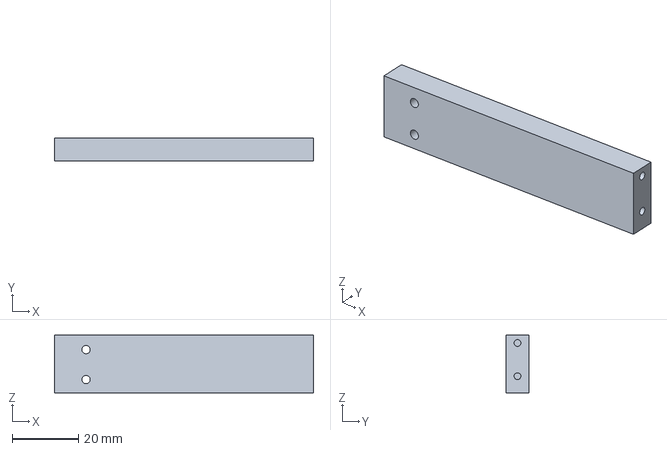
[picture p101: CAD file, 2026-11-09]
parts/KRB.S0.02.005_peremychka-kolena.step
78.0 x 7.00 x 17.4 mm
