pilot443/avad-s0/wrist-tools/KRB.S0.07.033_koltso-pereklyuchatelya.step

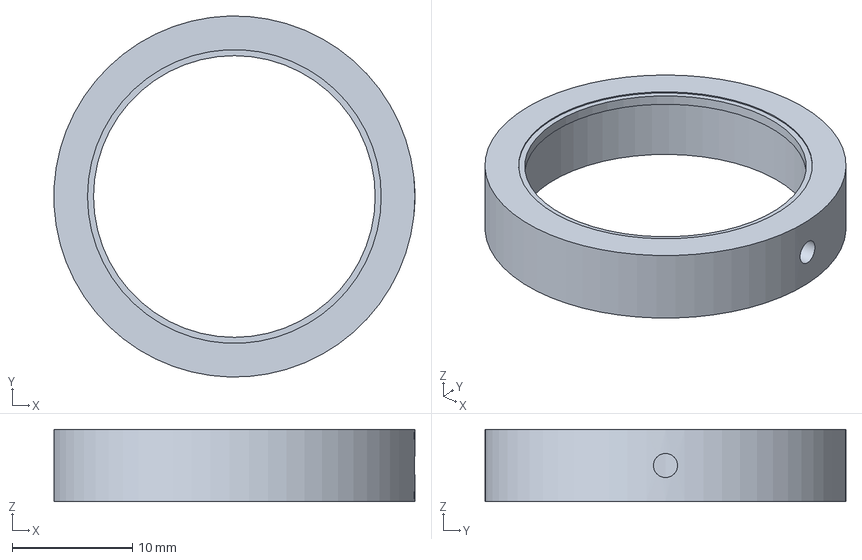
[picture p102: CAD file, 2026-11-09]
wrist-tools/KRB.S0.07.033_koltso-pereklyuchatelya.step
30.0 x 30.0 x 6.00 mm
