pilot443/avad-s0/parts/KRB.S0.01.003_plita-verhnyaya_cut.dxf

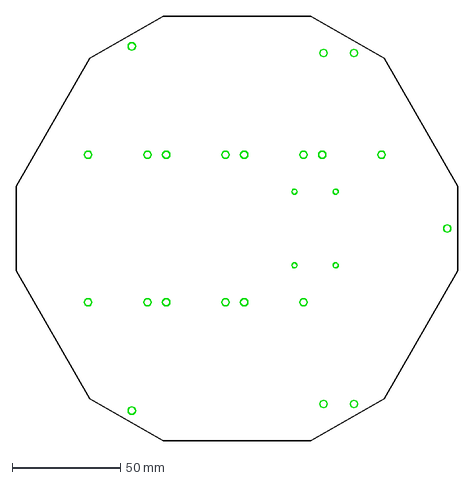
[picture p103: CAD file, 2026-11-09]
parts/KRB.S0.01.003_plita-verhnyaya_cut.dxf
203.8 x 196.0 mm
