pilot443/avad-s0/wrist-tools/KRB.S0.07.011_osnovanie-zahvata.step

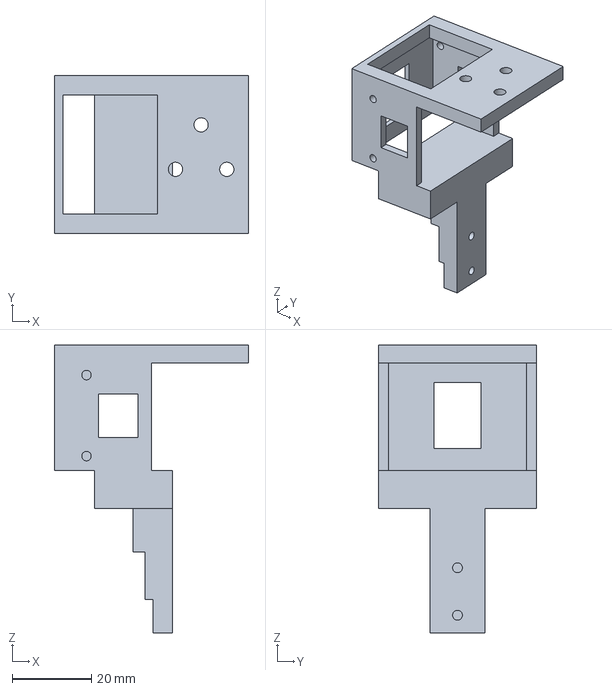
[picture p104: CAD file, 2026-11-09]
wrist-tools/KRB.S0.07.011_osnovanie-zahvata.step
49.1 x 40.0 x 72.9 mm
