pilot443/avad-s0/parts/KRB.S0.03.002_zveno-plecha_cut.dxf

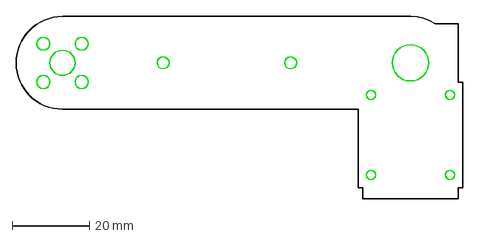
[picture p105: CAD file, 2026-11-09]
parts/KRB.S0.03.002_zveno-plecha_cut.dxf
115.6 x 47.1 mm
