pilot443/avad-s0/wrist-tools/KRB.S0.07.001_gnezdo-zamka.step

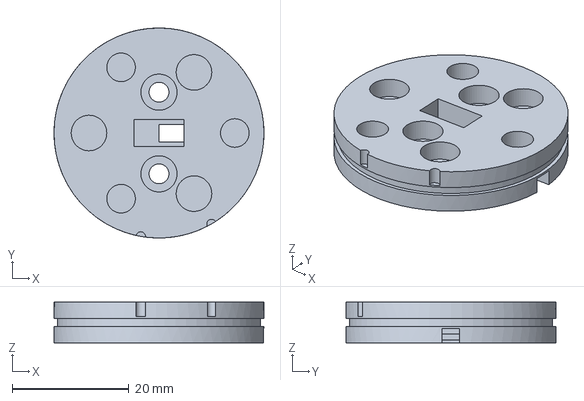
[picture p106: CAD file, 2026-11-09]
wrist-tools/KRB.S0.07.001_gnezdo-zamka.step
36.0 x 36.0 x 7.00 mm
