pilot443/avad-s0/parts/KRB.S0.02.009_podoshva.step

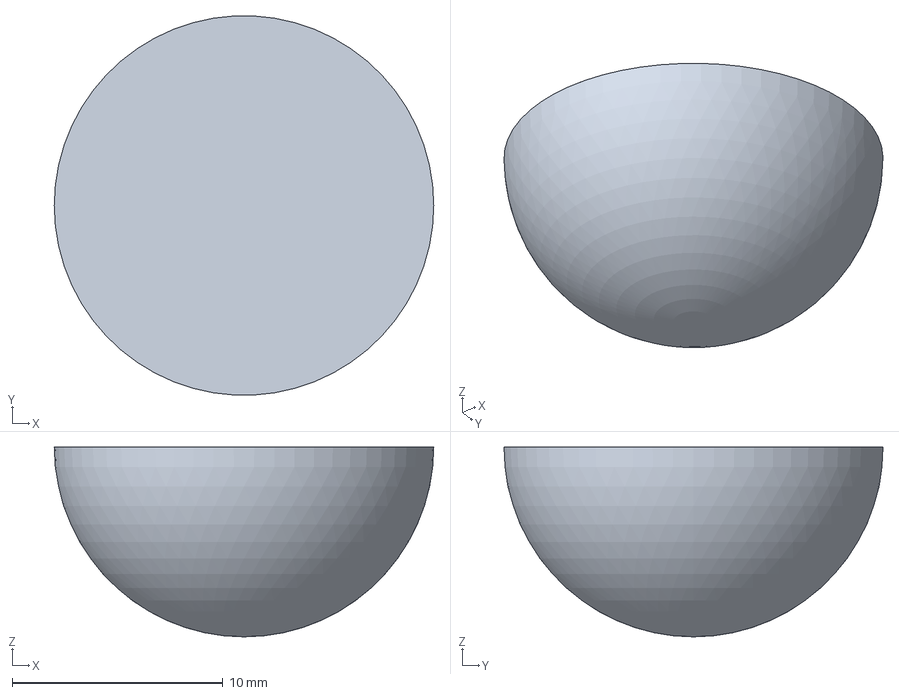
[picture p107: CAD file, 2026-11-09]
parts/KRB.S0.02.009_podoshva.step
18.0 x 18.0 x 9.00 mm
