pilot443/avad-s0/wrist-tools/KRB.S0.07.035_raspornaya-vtulka.step

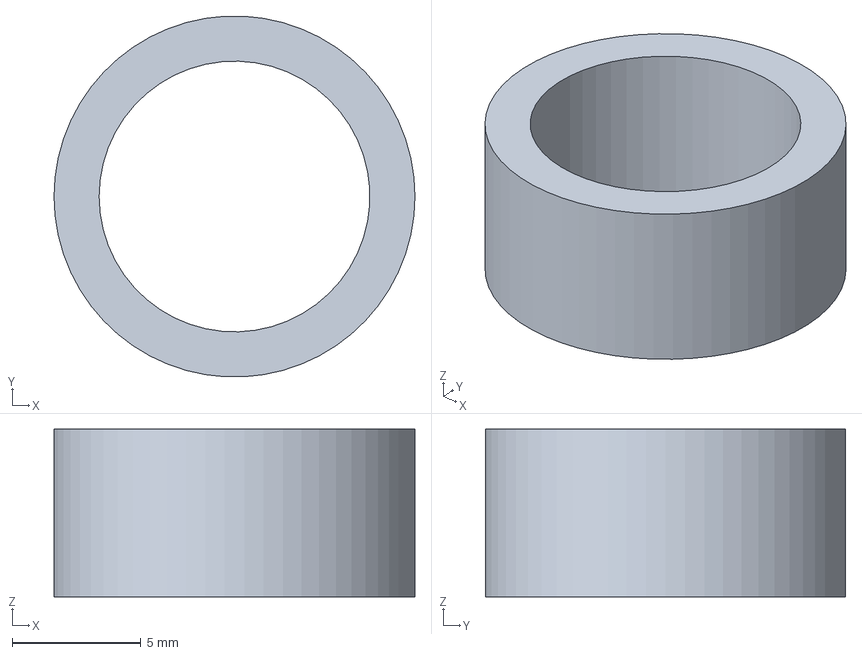
[picture p108: CAD file, 2026-11-09]
wrist-tools/KRB.S0.07.035_raspornaya-vtulka.step
14.0 x 14.0 x 6.50 mm
