pilot443/avad-s0/parts/KRB.S0.01.004_polka-elektroniki_cut.dxf

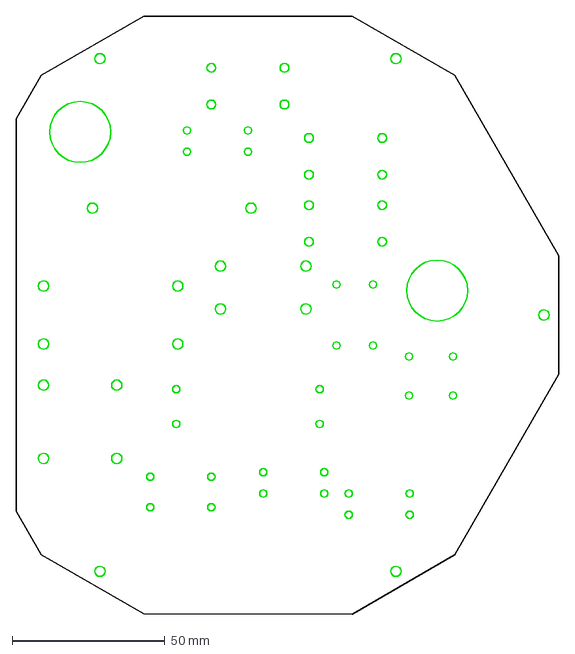
[picture p109: CAD file, 2026-11-09]
parts/KRB.S0.01.004_polka-elektroniki_cut.dxf
177.9 x 196.0 mm
