pilot443/avad-s0/sim/meshes-v26-k1/m221.stl

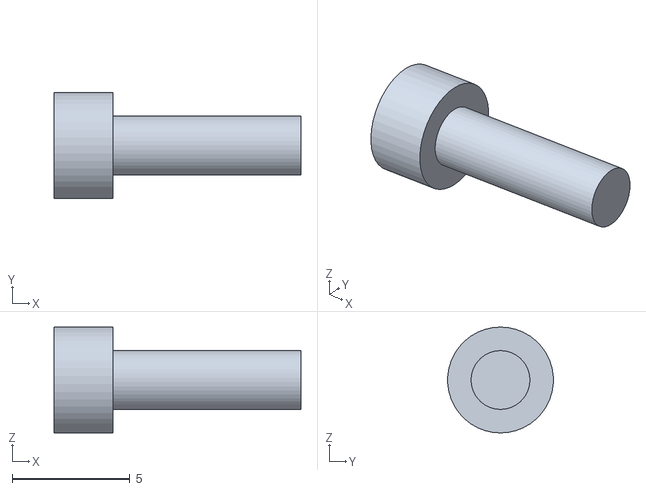
[picture p110: CAD file, 2026-11-09]
sim/meshes-v26-k1/m221.stl
10.5 x 4.49 x 4.50
