pilot443/avad-s0/wrist-tools/KRB.S0.07.030_korpus-treshchotki.step

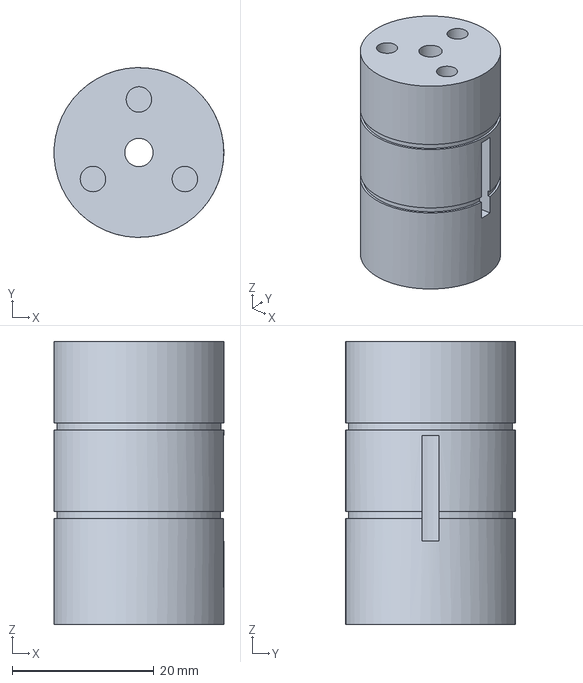
[picture p111: CAD file, 2026-11-09]
wrist-tools/KRB.S0.07.030_korpus-treshchotki.step
24.0 x 24.0 x 40.0 mm
