pilot443/avad-s0/parts/KRB.S0.03.005_rebro-predplechya.step

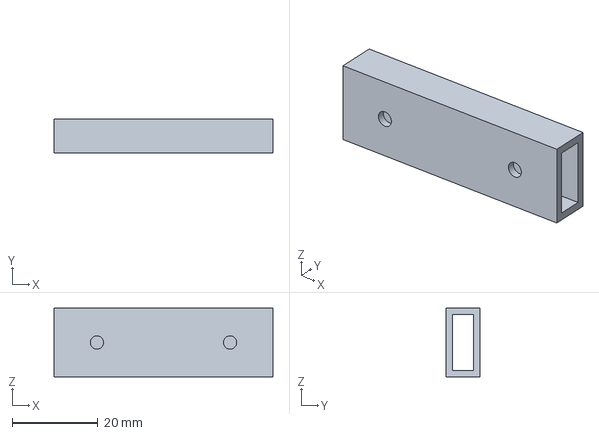
[picture p112: CAD file, 2026-11-09]
parts/KRB.S0.03.005_rebro-predplechya.step
51.0 x 8.00 x 16.0 mm
