pilot443/avad-s0/sim/meshes-v26-k1/m209.stl

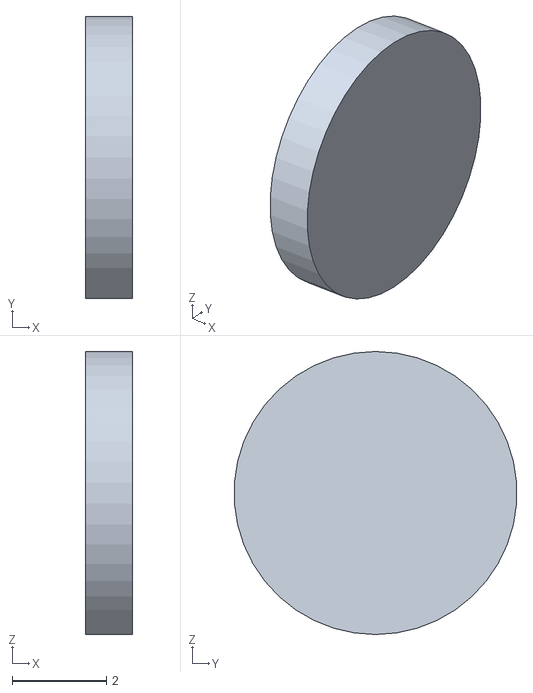
[picture p113: CAD file, 2026-11-09]
sim/meshes-v26-k1/m209.stl
1.00 x 5.98 x 6.00
