pilot443/avad-s0/wrist-tools/KRB.S0.07.002_koltso-baioneta.step

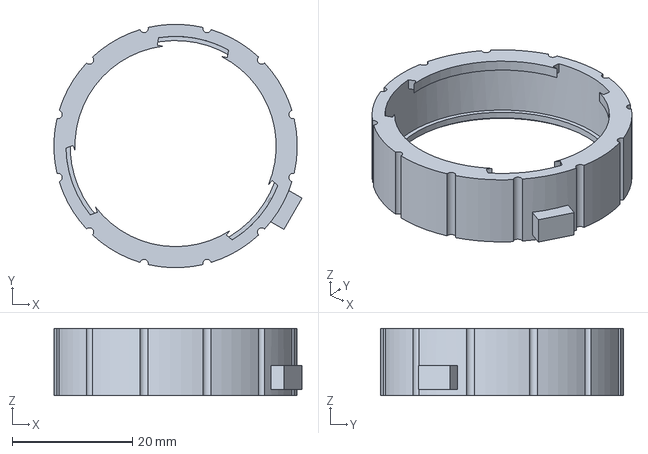
[picture p114: CAD file, 2026-11-09]
wrist-tools/KRB.S0.07.002_koltso-baioneta.step
41.2 x 40.4 x 11.1 mm
