pilot443/avad-s0/parts/KRB.S0.01.005_razvertka_cut.dxf

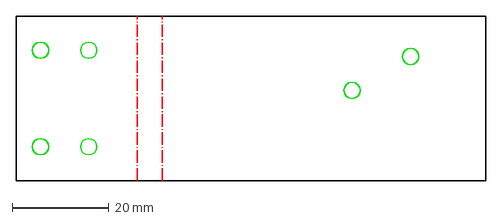
[picture p115: CAD file, 2026-11-09]
parts/KRB.S0.01.005_razvertka_cut.dxf
97.2 x 34.0 mm
