pilot443/avad-s0/wrist-tools/KRB.S0.07.031_val-treshchotki.step

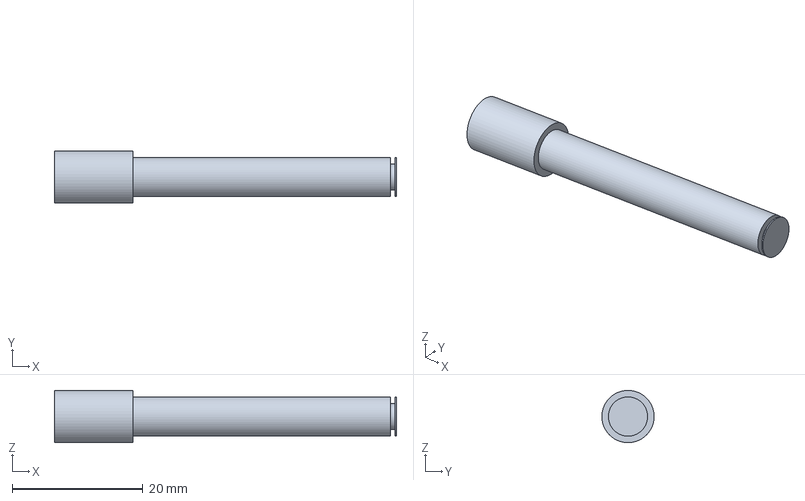
[picture p116: CAD file, 2026-11-09]
wrist-tools/KRB.S0.07.031_val-treshchotki.step
52.3 x 8.00 x 7.99 mm
