pilot443/avad-s0/parts/KRB.S0.03.004_zveno-predplechya.step

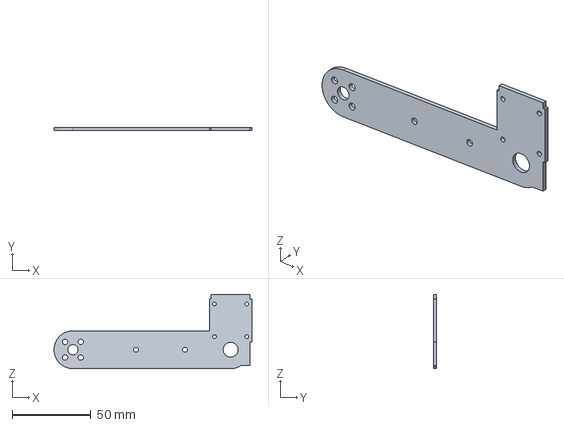
[picture p117: CAD file, 2026-11-09]
parts/KRB.S0.03.004_zveno-predplechya.step
125.5 x 2.00 x 47.1 mm
