pilot443/avad-s0/sim/meshes-v26-k1/m203.stl

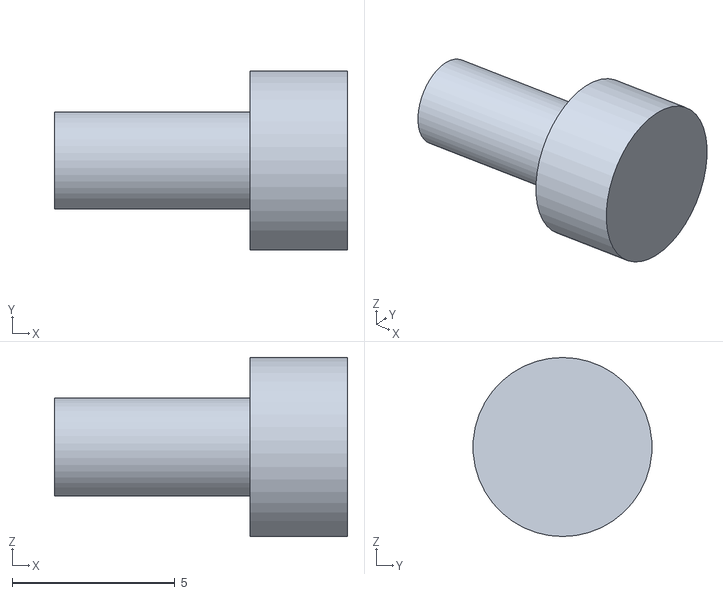
[picture p118: CAD file, 2026-11-09]
sim/meshes-v26-k1/m203.stl
9.00 x 5.48 x 5.50
