pilot443/avad-s0/parts/KRB.S0.04.003_konsol-shei.step

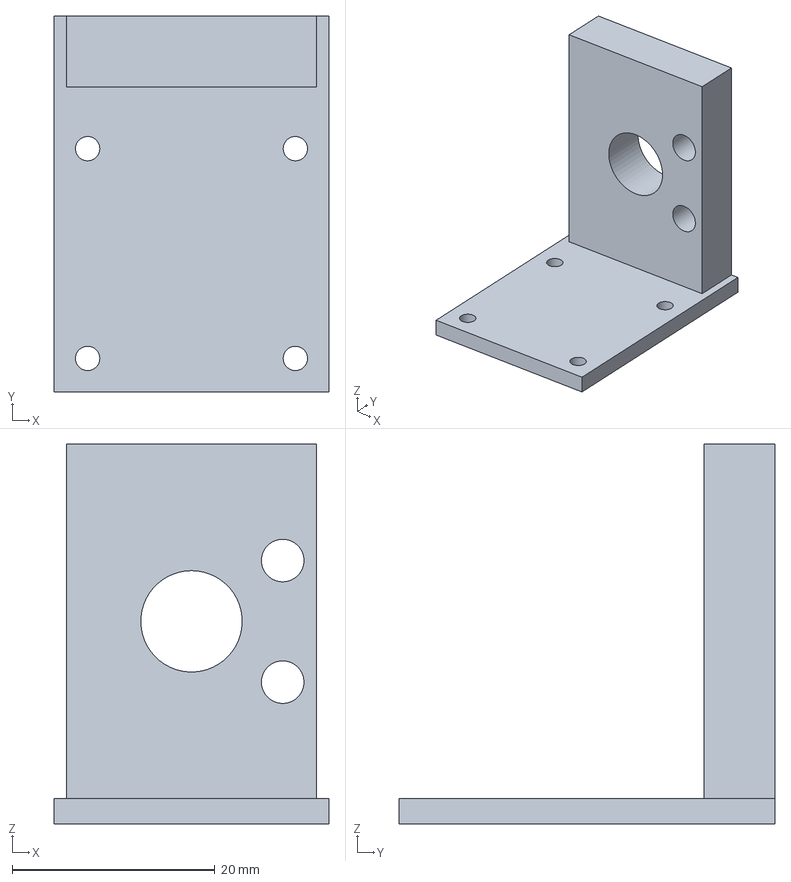
[picture p119: CAD file, 2026-11-09]
parts/KRB.S0.04.003_konsol-shei.step
27.1 x 37.1 x 37.5 mm
