pilot443/avad-s0/parts/KRB.S0.05.003_derzhatel.step

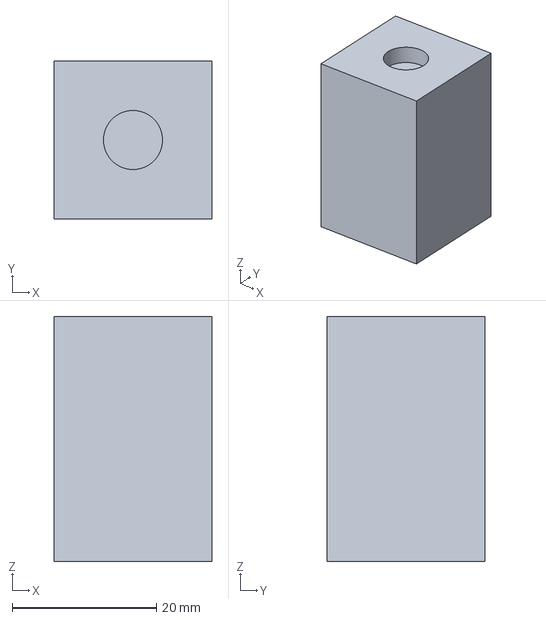
[picture p120: CAD file, 2026-11-09]
parts/KRB.S0.05.003_derzhatel.step
21.9 x 21.9 x 34.0 mm
