pilot443/avad-s0/parts/KRB.S0.02.004_shcheka-bedra-korotkaya.step

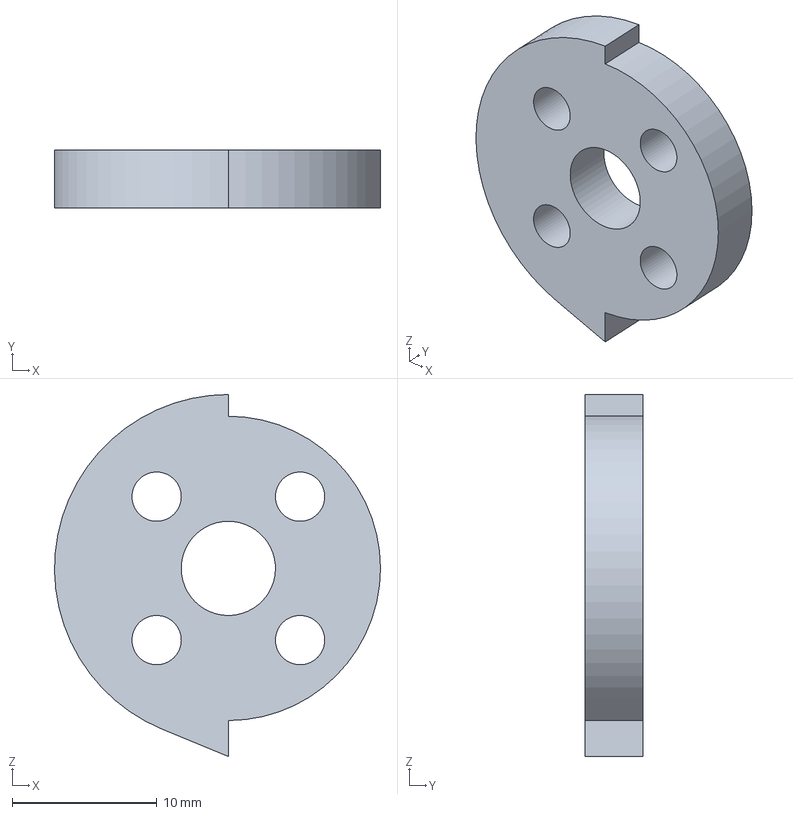
[picture p121: CAD file, 2026-11-09]
parts/KRB.S0.02.004_shcheka-bedra-korotkaya.step
22.5 x 4.00 x 25.0 mm
