pilot443/avad-s0/parts/KRB.S0.01.002_plita-nizhnyaya_cut.dxf

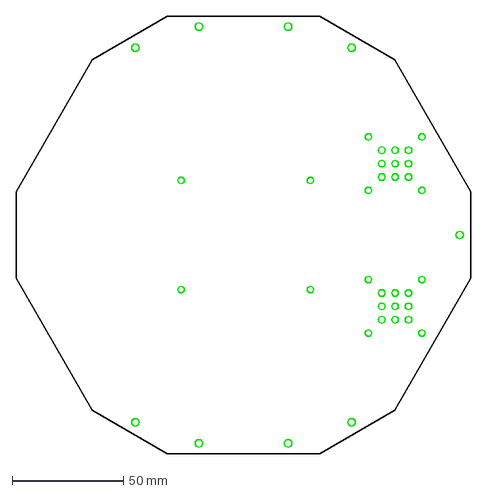
[picture p122: CAD file, 2026-11-09]
parts/KRB.S0.01.002_plita-nizhnyaya_cut.dxf
203.8 x 196.0 mm
