pilot443/avad-s0/parts/KRB.S0.01.004_polka-elektroniki.step

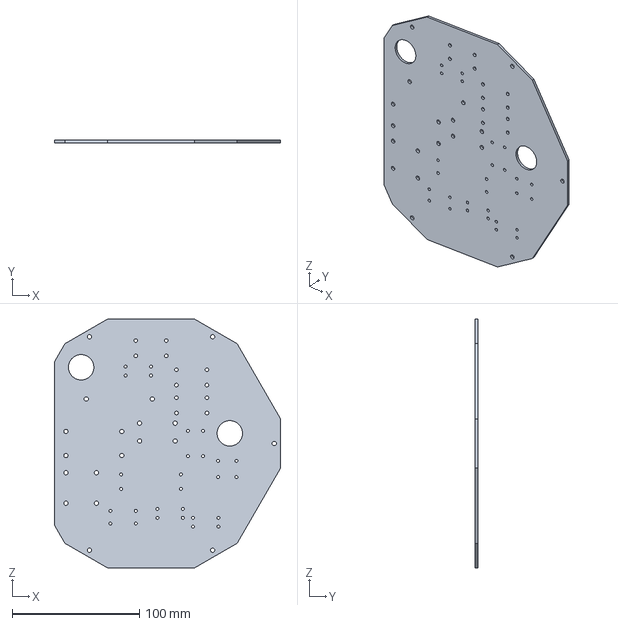
[picture p123: CAD file, 2026-11-09]
parts/KRB.S0.01.004_polka-elektroniki.step
177.9 x 2.00 x 196.0 mm
