pilot443/avad-s0/parts/KRB.S0.05.001_konteiner.step

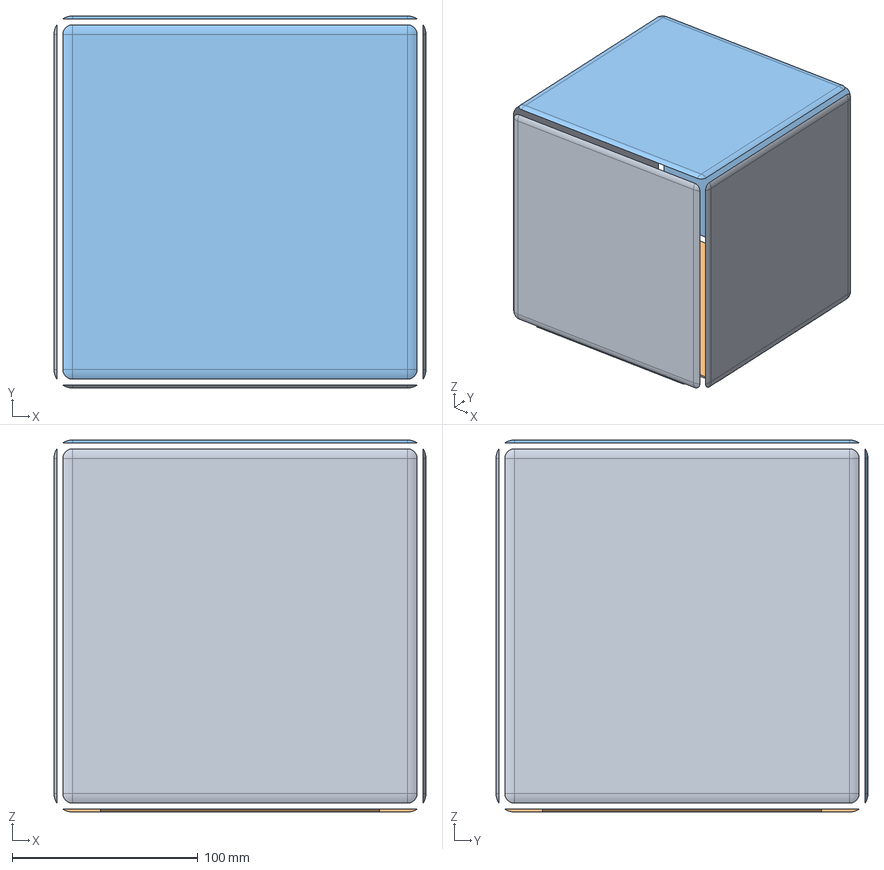
[picture p124: CAD file, 2026-11-09]
parts/KRB.S0.05.001_konteiner.step
200.0 x 200.0 x 200.0 mm
