pilot443/avad-s0/sim/meshes-v26-k1/m196.stl

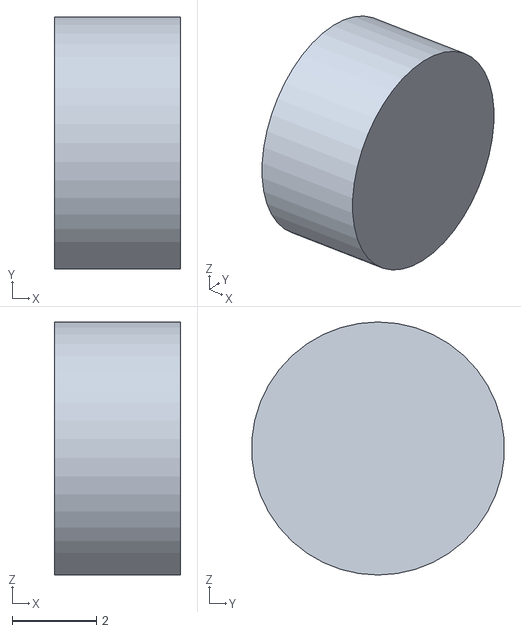
[picture p125: CAD file, 2026-11-09]
sim/meshes-v26-k1/m196.stl
3.00 x 5.98 x 6.00
