pilot443/avad-s0/parts/KRB.S0.03.010_stoika-plecha.step

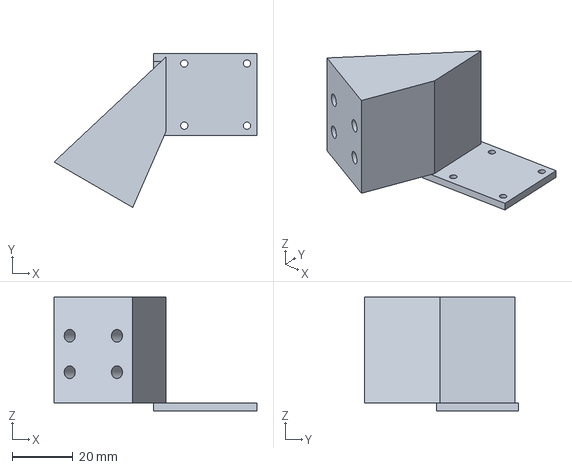
[picture p126: CAD file, 2026-11-09]
parts/KRB.S0.03.010_stoika-plecha.step
67.0 x 50.8 x 37.5 mm
