pilot443/avad-s0/parts/KRB.S0.03.006_plastina-kisti.step

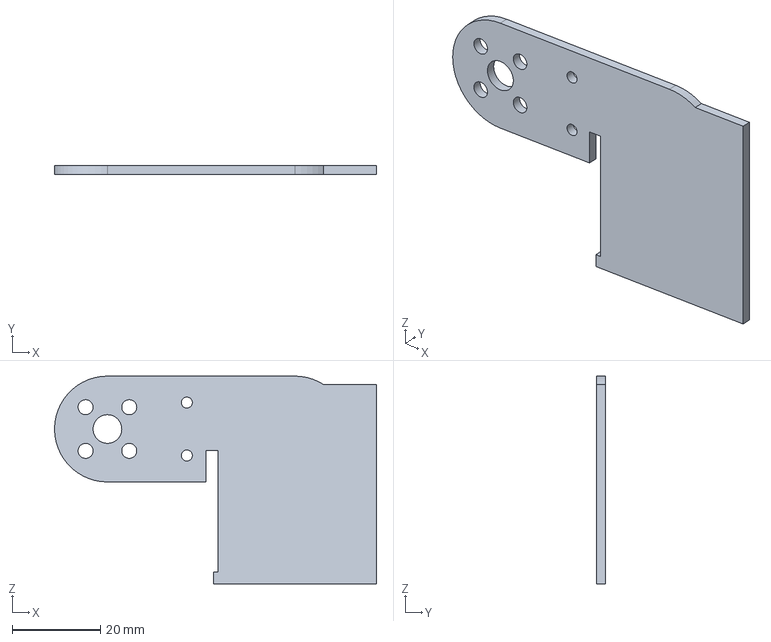
[picture p127: CAD file, 2026-11-09]
parts/KRB.S0.03.006_plastina-kisti.step
73.0 x 2.00 x 47.1 mm
