pilot443/avad-s0/parts/KRB.S0.02.002_skoba-bedra.step

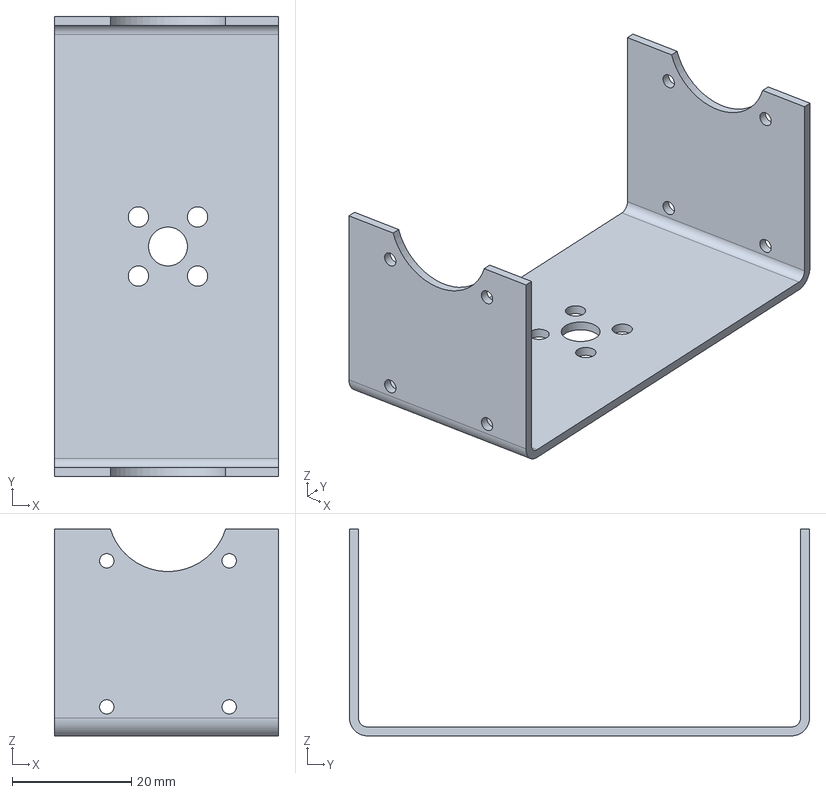
[picture p128: CAD file, 2026-11-09]
parts/KRB.S0.02.002_skoba-bedra.step
37.5 x 77.0 x 34.6 mm
