pilot443/avad-s0/parts/KRB.S0.03.011_ugolok-povorota-kisti.step

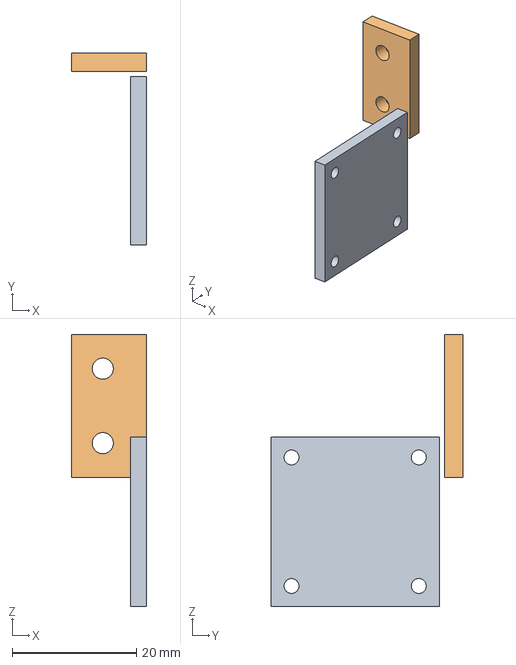
[picture p129: CAD file, 2026-11-09]
parts/KRB.S0.03.011_ugolok-povorota-kisti.step
12.0 x 30.9 x 43.8 mm
