pilot443/avad-s0/parts/KRB.S0.02.004_shcheka-bedra-korotkaya_cut.dxf

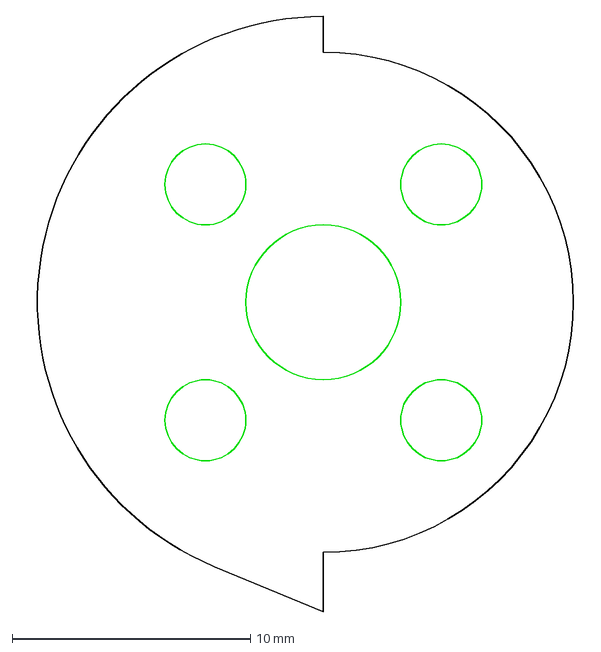
[picture p130: CAD file, 2026-11-09]
parts/KRB.S0.02.004_shcheka-bedra-korotkaya_cut.dxf
23.9 x 25.0 mm
