pilot443/avad-s0/parts/KRB.S0.01.001_obolochka.step

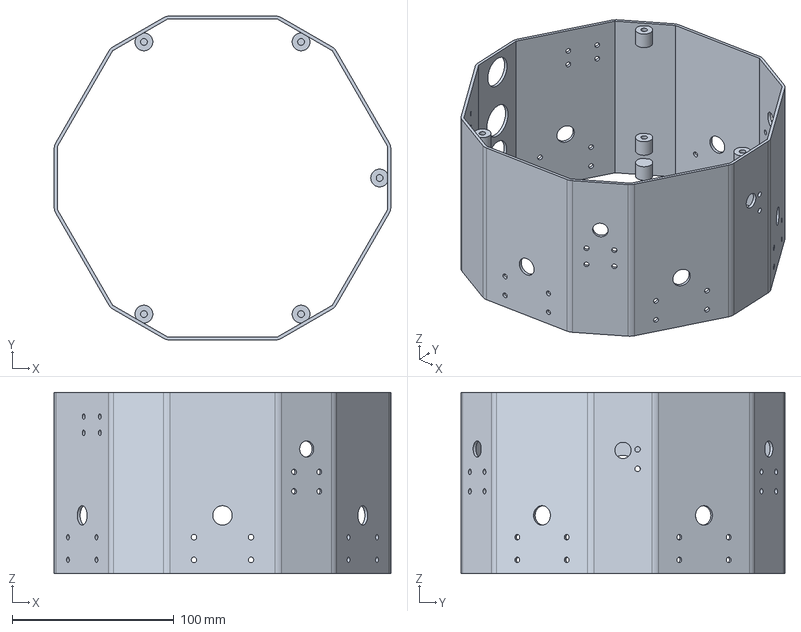
[picture p131: CAD file, 2026-11-09]
parts/KRB.S0.01.001_obolochka.step
207.8 x 200.0 x 112.0 mm
