pilot443/avad-s0/sim/meshes-v26-k1/m200.stl

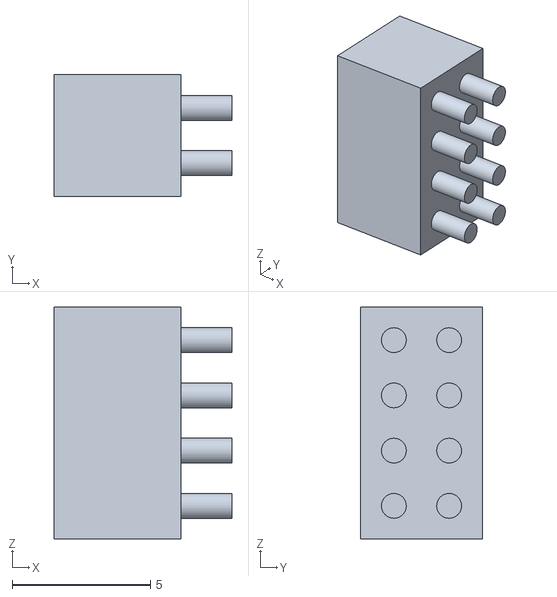
[picture p132: CAD file, 2026-11-09]
sim/meshes-v26-k1/m200.stl
6.44 x 4.40 x 8.40
