pilot443/avad-s0/parts/KRB.S0.02.002_razvertka.dxf

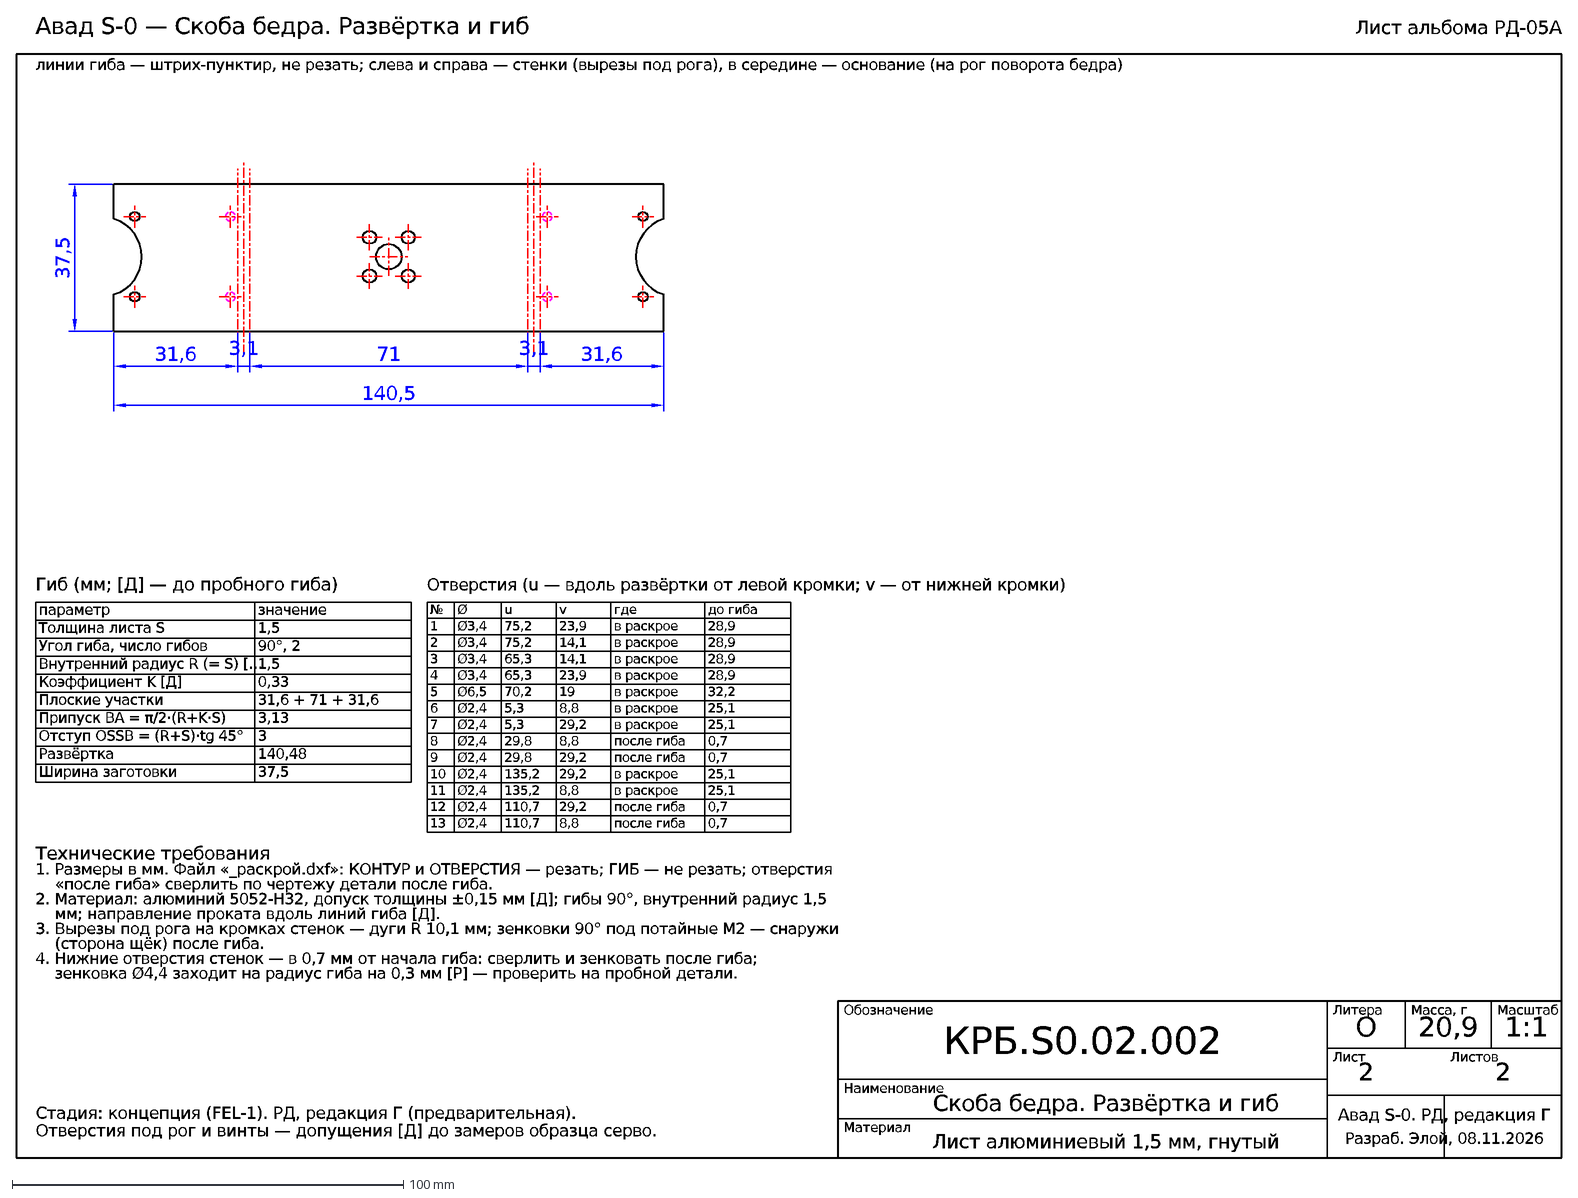
[picture p133: CAD file, 2026-11-09]
parts/KRB.S0.02.002_razvertka.dxf
Стадия: концепция (FEL-1). РД, редакция Г (предварительная).
Отверстия под рог и винты — допущения [Д] до замеров образца серво.
Обозначение
Наименование
Материал
Литера
Масса, г
Масштаб
Лист
Листов
КРБ.S0.02.002
О
20,9
1:1
2
Авад S-0. РД, редакция Г
Разраб. Элой, 08.11.2026
Скоба бедра. Развёртка и гиб
Лист алюминиевый 1,5 мм, гнутый
Авад S-0 — Скоба бедра. Развёртка и гиб
Лист альбома РД-05А
31,6
3,1
71
140,5
37,5
линии гиба — штрих-пунктир, не резать; слева и справа — стенки (вырезы под рога), в середине — основание (на рог поворота бедра)
Гиб (мм; [Д] — до пробного гиба)
параметр
значение
Толщина листа S
1,5
Угол гиба, число гибов
90°, 2
Внутренний радиус R (= S) […
Коэффициент K [Д]
0,33
Плоские участки
31,6 + 71 + 31,6
Припуск BA = π/2·(R+K·S)
3,13
Отступ OSSB = (R+S)·tg 45°
3
Развёртка
140,48
Ширина заготовки
Отверстия (u — вдоль развёртки от левой кромки; v — от нижней кромки)
№
Ø
u
v
где
до гиба
1
Ø3,4
75,2
23,9
в раскрое
28,9
14,1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
