pilot443/avad-s0/parts/KRB.S0.01.005_kronshtein-derzhatelya.step

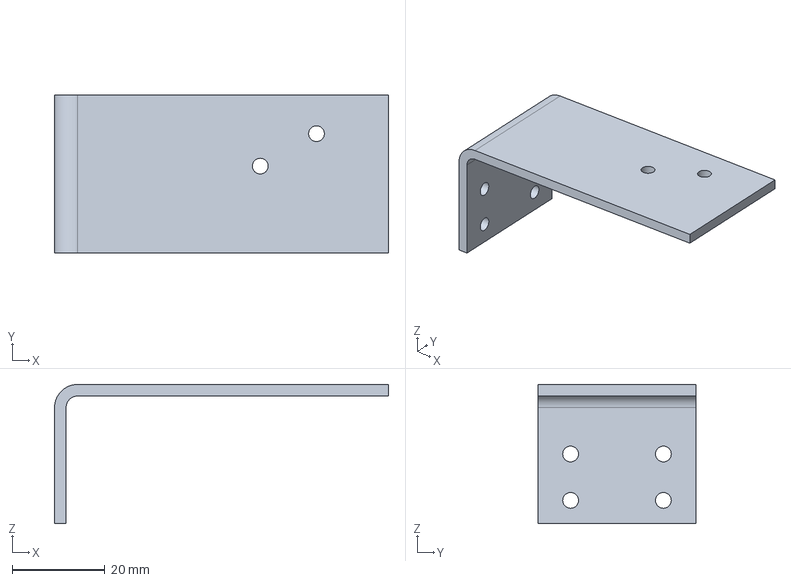
[picture p134: CAD file, 2026-11-09]
parts/KRB.S0.01.005_kronshtein-derzhatelya.step
72.0 x 34.0 x 30.0 mm
