pilot443/avad-s0/sim/meshes-v26-k1/m230.stl

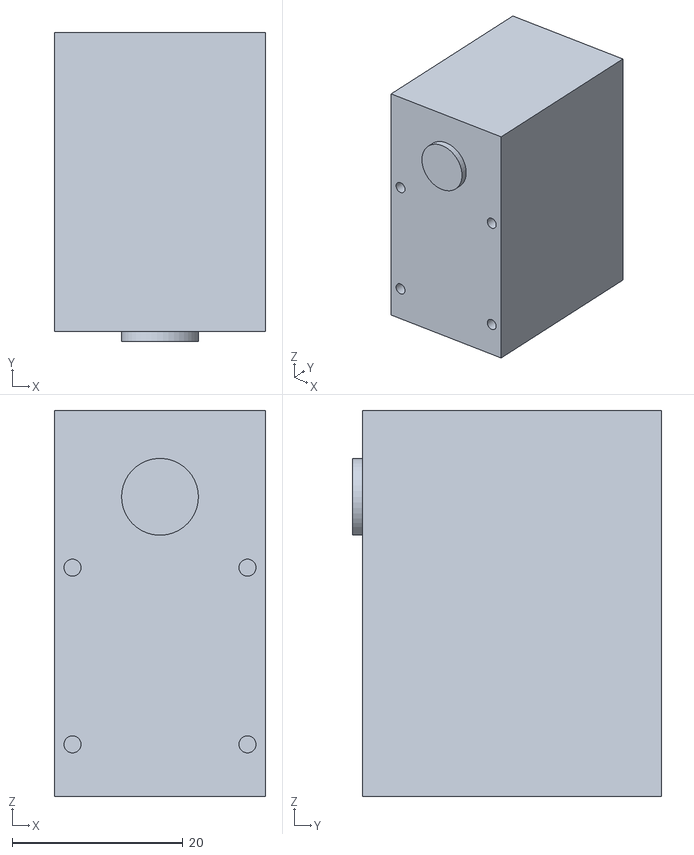
[picture p135: CAD file, 2026-11-09]
sim/meshes-v26-k1/m230.stl
24.7 x 36.2 x 45.2
