pilot443/avad-s0/parts/KRB.S0.04.002_stoika-shei.step

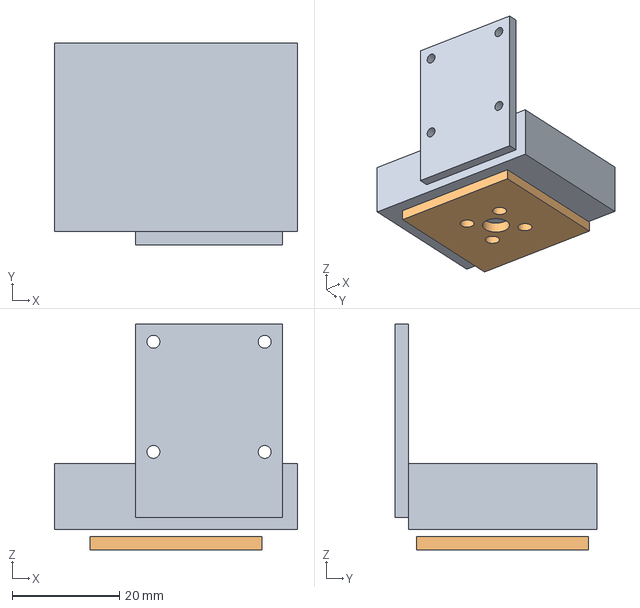
[picture p136: CAD file, 2026-11-09]
parts/KRB.S0.04.002_stoika-shei.step
45.2 x 37.5 x 42.0 mm
