pilot443/avad-s0/parts/KRB.S0.03.002_zveno-plecha.step

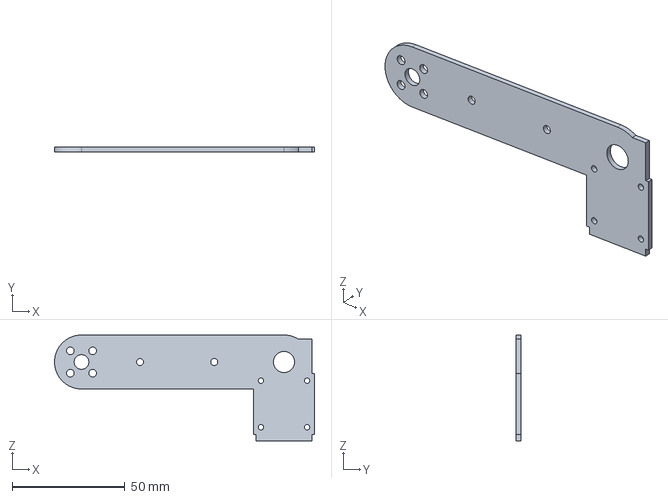
[picture p137: CAD file, 2026-11-09]
parts/KRB.S0.03.002_zveno-plecha.step
115.5 x 2.00 x 47.1 mm
