pilot443/avad-s0/parts/KRB.S0.02.006_golen.step

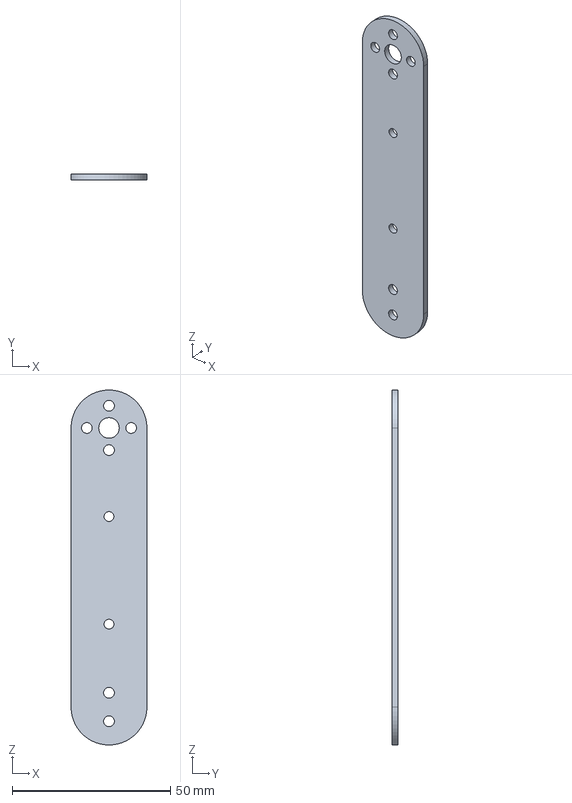
[picture p138: CAD file, 2026-11-09]
parts/KRB.S0.02.006_golen.step
24.0 x 2.00 x 112.2 mm
