pilot443/avad-s0/parts/KRB.S0.02.007_rebro-goleni.step

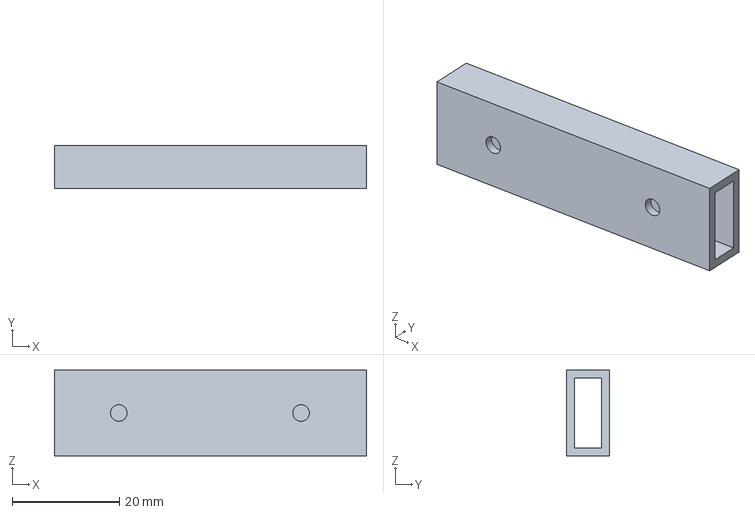
[picture p139: CAD file, 2026-11-09]
parts/KRB.S0.02.007_rebro-goleni.step
58.2 x 8.00 x 16.0 mm
