pilot443/avad-s0/parts/KRB.S0.01.005_razvertka.dxf

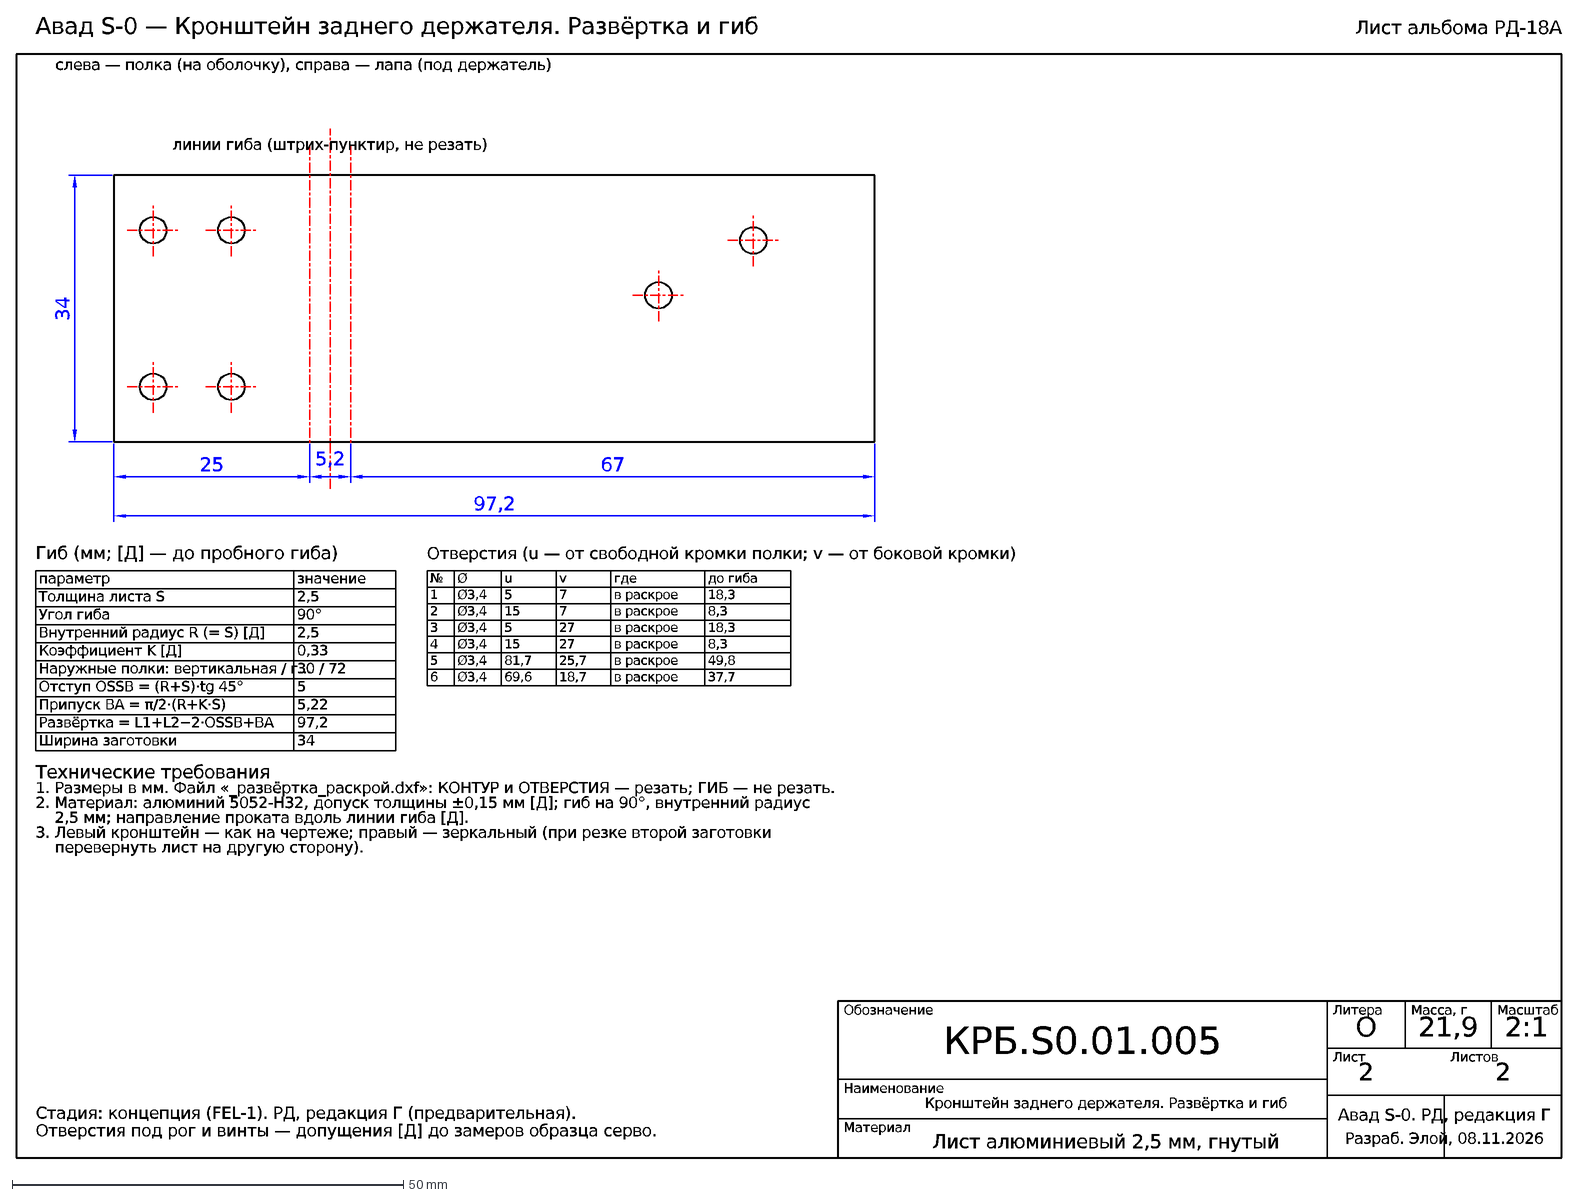
[picture p140: CAD file, 2026-11-09]
parts/KRB.S0.01.005_razvertka.dxf
Стадия: концепция (FEL-1). РД, редакция Г (предварительная).
Отверстия под рог и винты — допущения [Д] до замеров образца серво.
Обозначение
Наименование
Материал
Литера
Масса, г
Масштаб
Лист
Листов
КРБ.S0.01.005
О
21,9
2:1
2
Авад S-0. РД, редакция Г
Разраб. Элой, 08.11.2026
Кронштейн заднего держателя. Развёртка и гиб
Лист алюминиевый 2,5 мм, гнутый
Авад S-0 — Кронштейн заднего держателя. Развёртка и гиб
Лист альбома РД-18А
25
5,2
67
97,2
34
линии гиба (штрих-пунктир, не резать)
слева — полка (на оболочку), справа — лапа (под держатель)
Гиб (мм; [Д] — до пробного гиба)
параметр
значение
Толщина листа S
2,5
Угол гиба
90°
Внутренний радиус R (= S) [Д]
Коэффициент K [Д]
0,33
Наружные полки: вертикальная / г…
30 / 72
Отступ OSSB = (R+S)·tg 45°
5
Припуск BA = π/2·(R+K·S)
5,22
Развёртка = L1+L2−2·OSSB+BA
Ширина заготовки
Отверстия (u — от свободной кромки полки; v — от боковой кромки)
№
Ø
u
v
где
до гиба
1
Ø3,4
7
в раскрое
18,3
15
8,3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
