pilot443/avad-s0/parts/KRB.S0.02.003_shcheka-bedra.step

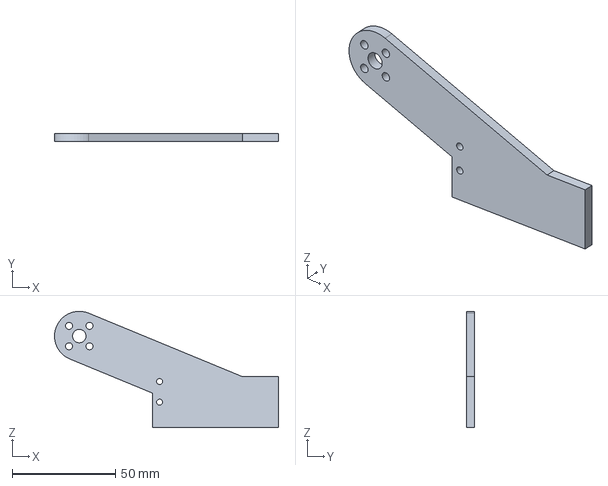
[picture p141: CAD file, 2026-11-09]
parts/KRB.S0.02.003_shcheka-bedra.step
108.5 x 4.00 x 56.4 mm
