pilot443/avad-s0/parts/KRB.S0.02.010_ugolok-kolena.step

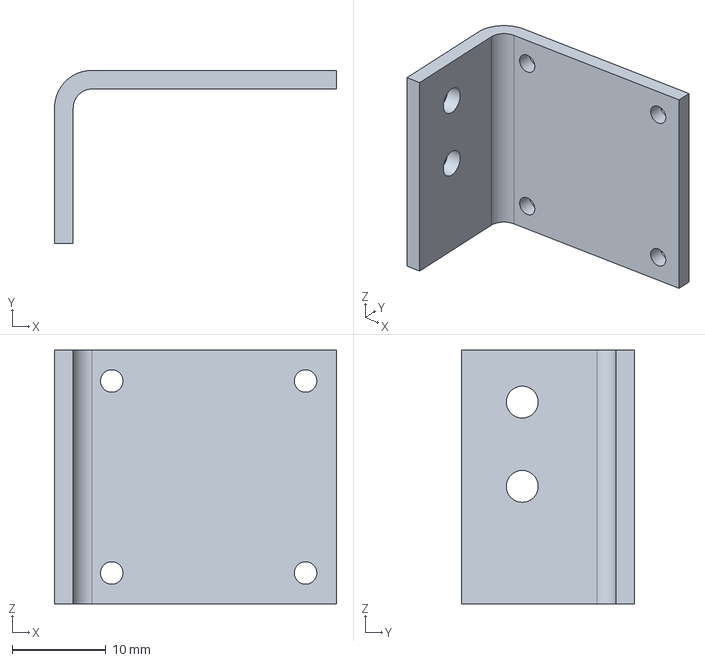
[picture p142: CAD file, 2026-11-09]
parts/KRB.S0.02.010_ugolok-kolena.step
30.1 x 18.5 x 27.1 mm
