pilot443/avad-s0/parts/KRB.S0.03.006_plastina-kisti_cut.dxf

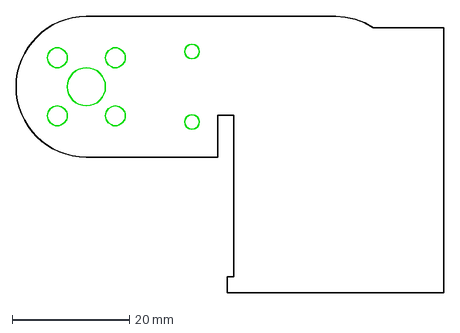
[picture p143: CAD file, 2026-11-09]
parts/KRB.S0.03.006_plastina-kisti_cut.dxf
73.0 x 47.1 mm
