pilot443/avad-s0/parts/KRB.S0.02.010_razvertka_cut.dxf

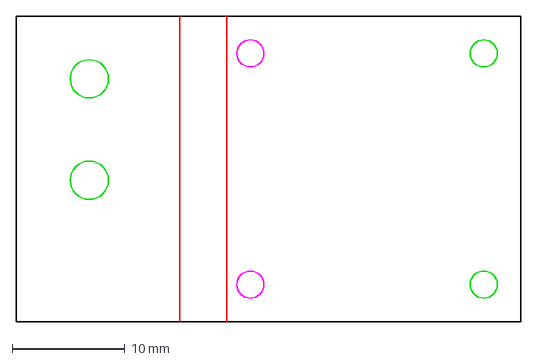
[picture p144: CAD file, 2026-11-09]
parts/KRB.S0.02.010_razvertka_cut.dxf
44.8 x 27.1 mm
