pilot443/avad-s0/parts/KRB.S0.02.002_razvertka_cut.dxf

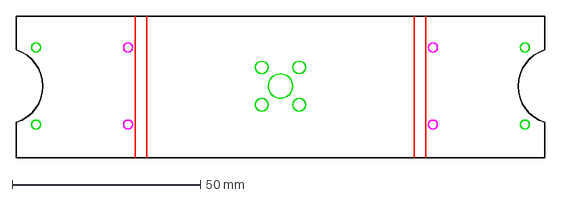
[picture p145: CAD file, 2026-11-09]
parts/KRB.S0.02.002_razvertka_cut.dxf
140.5 x 37.5 mm
