pilot443/avad-s0/sim/meshes-v26-k1/m215.stl

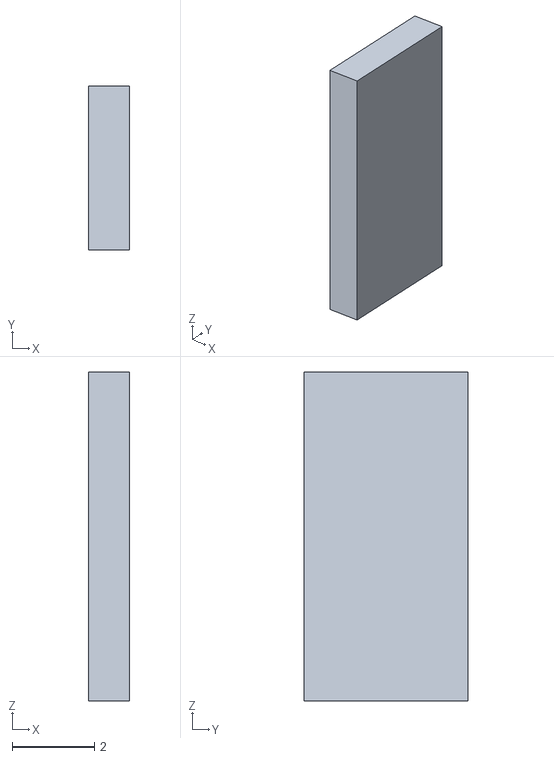
[picture p146: CAD file, 2026-11-09]
sim/meshes-v26-k1/m215.stl
1.00 x 4.00 x 8.00
