pilot443/avad-s0/parts/KRB.S0.02.003_shcheka-bedra_cut.dxf

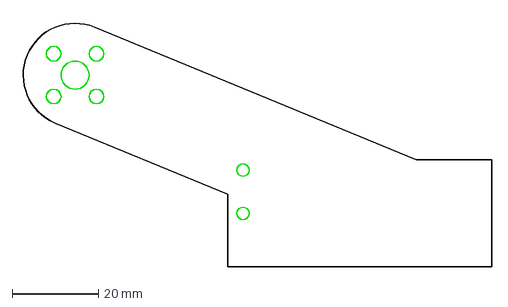
[picture p147: CAD file, 2026-11-09]
parts/KRB.S0.02.003_shcheka-bedra_cut.dxf
110.1 x 58.0 mm
