pilot443/avad-s0/parts/KRB.S0.02.005_peremychka-kolena_cut.dxf

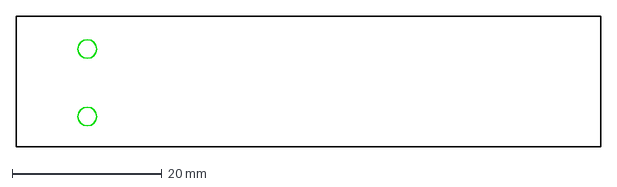
[picture p148: CAD file, 2026-11-09]
parts/KRB.S0.02.005_peremychka-kolena_cut.dxf
78.0 x 17.4 mm
