pilot443/avad-s0/sim/meshes-v26-k1/m259.stl

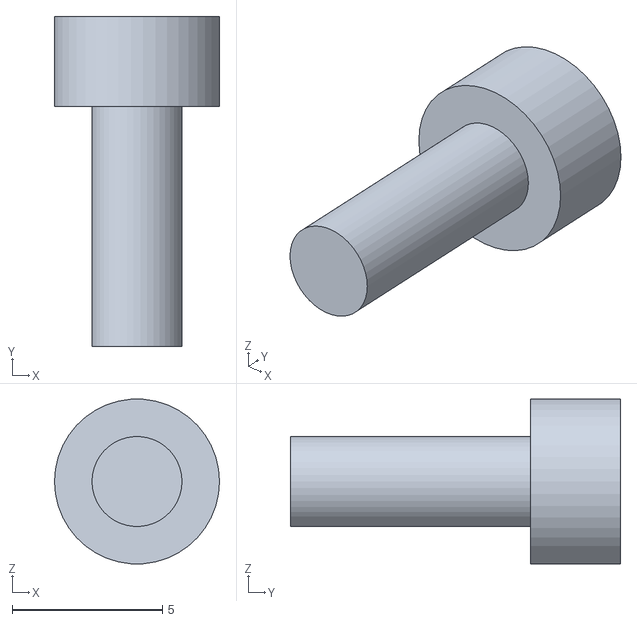
[picture p149: CAD file, 2026-11-09]
sim/meshes-v26-k1/m259.stl
5.50 x 11.0 x 5.48
