pilot443/avad-s0/parts/KRB.S0.02.006_golen_cut.dxf

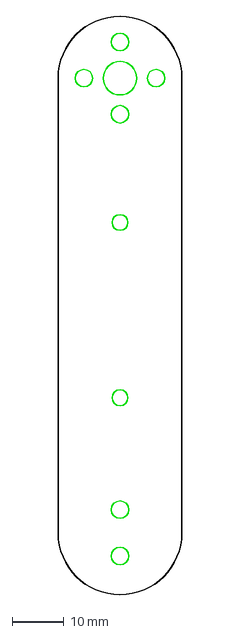
[picture p150: CAD file, 2026-11-09]
parts/KRB.S0.02.006_golen_cut.dxf
24.0 x 112.2 mm
