pilot443/avad-s0/parts/KRB.S0.06.001_lotok-batarei.step

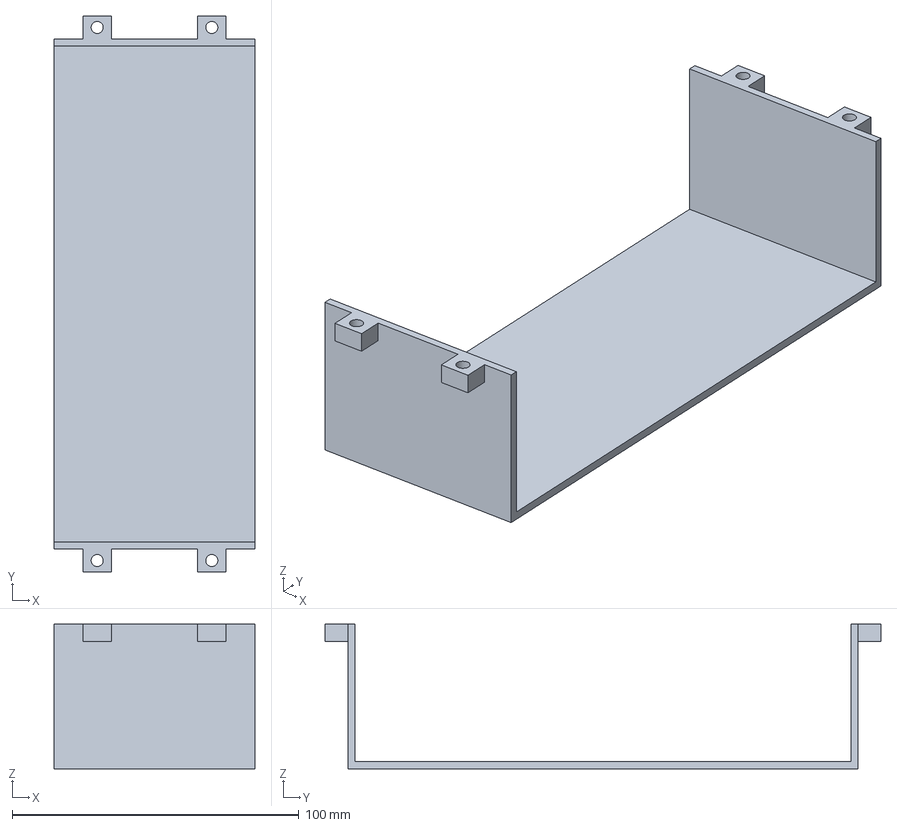
[picture p151: CAD file, 2026-11-09]
parts/KRB.S0.06.001_lotok-batarei.step
70.0 x 194.0 x 50.5 mm
