pilot443/avad-s0/parts/KRB.S0.03.003_rebro-plecha.step

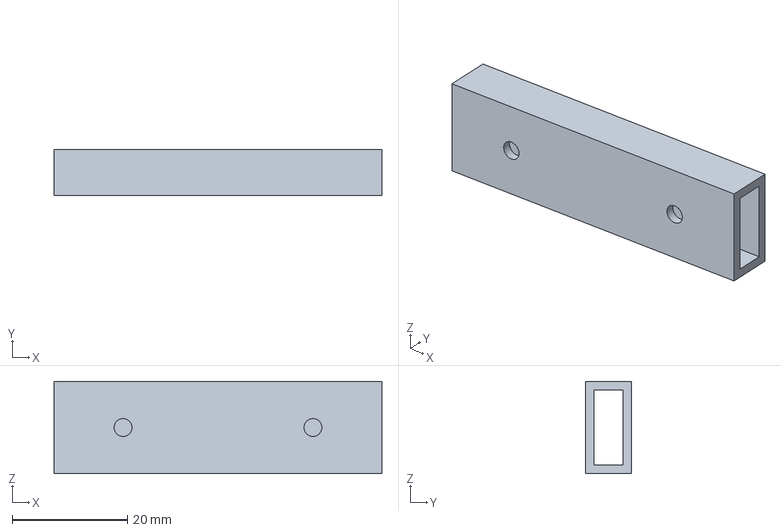
[picture p152: CAD file, 2026-11-09]
parts/KRB.S0.03.003_rebro-plecha.step
57.0 x 8.00 x 16.0 mm
