pilot443/avad-s0/parts/KRB.S0.04.001_kozhuh-golovy.step

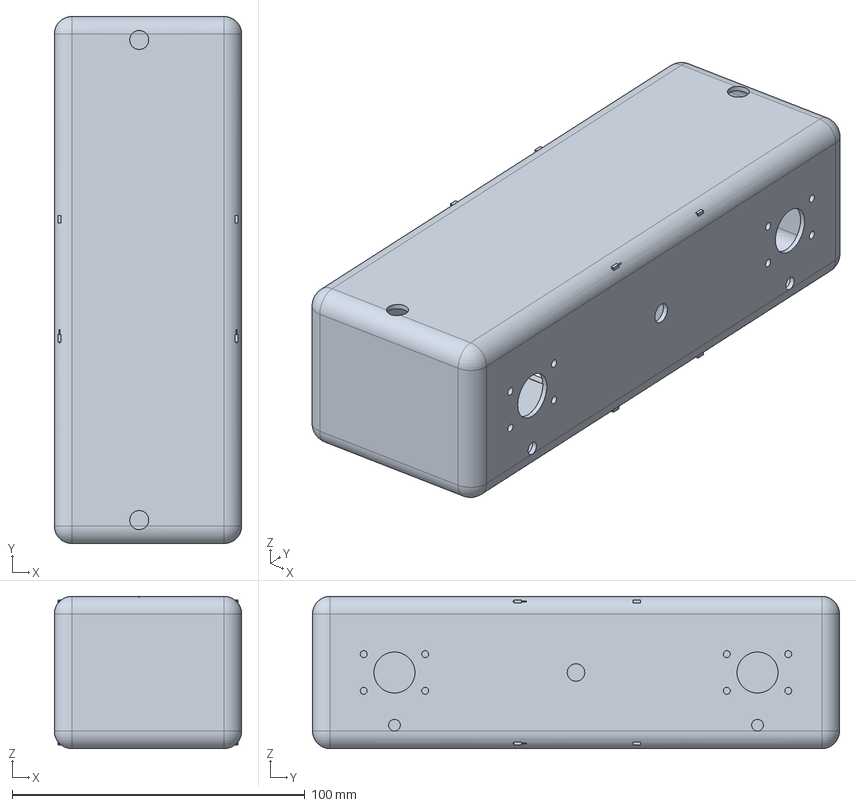
[picture p153: CAD file, 2026-11-09]
parts/KRB.S0.04.001_kozhuh-golovy.step
64.0 x 180.0 x 52.0 mm
