pilot443/avad-s0/(list of files, cad)

Other CAD files:
electrical/TB-02_harnesses.dxf
sim/meshes-v26-k1/m248.stl
wrist-tools/KRB.S0.07.013_nakladka-podvizhnoi.step
sim/meshes-v26-k1/m256.stl
sim/meshes-v26-k1/m255.stl
sim/meshes-v26-k1/m233.stl
sim/meshes-v26-k1/m249.stl
sim/meshes-v26-k1/m223.stl
sim/meshes-v26-k1/m210.stl
sim/meshes-v26-k1/m186.stl
sim/meshes-v26-k1/m204.stl
sim/meshes-v26-k1/m217.stl
sim/meshes-v26-k1/m254.stl
sim/meshes-v26-k1/m238.stl
sim/meshes-v26-k1/m198.stl
sim/meshes-v26-k1/m240.stl
sim/meshes-v26-k1/m195.stl
sim/meshes-v26-k1/m265.stl
sim/meshes-v26-k1/m262.stl
parts/KRB.S0.01.003_plita-verhnyaya.step
sim/meshes-v26-k1/m247.stl
sim/meshes-v26-k1/m257.stl
sim/meshes-v26-k1/m207.stl
sim/meshes-v26-k1/m225.stl
sim/meshes-v26-k1/m239.stl
sim/meshes-v26-k1/m202.stl
sim/meshes-v26-k1/m266.stl
sim/meshes-v26-k1/m224.stl
sim/meshes-v26-k1/m192.stl
sim/meshes-v26-k1/m211.stl
sim/meshes-v26-k1/m212.stl
sim/meshes-v26-k1/m235.stl
sim/meshes-v26-k1/m185.stl
sim/meshes-v26-k1/m229.stl
sim/meshes-v26-k1/m245.stl
sim/meshes-v26-k1/m194.stl
sim/meshes-v26-k1/m228.stl
sim/meshes-v26-k1/m243.stl
sim/meshes-v26-k1/m205.stl
sim/meshes-v26-k1/m187.stl
sim/meshes-v26-k1/m251.stl
sim/meshes-v26-k1/m252.stl
sim/meshes-v26-k1/m267.stl
sim/meshes-v26-k1/m199.stl
sim/meshes-v26-k1/m250.stl
sim/meshes-v26-k1/m242.stl
sim/meshes-v26-k1/m231.stl
sim/meshes-v26-k1/m191.stl
sim/meshes-v26-k1/m189.stl
sim/meshes-v26-k1/m201.stl
sim/meshes-v26-k1/m246.stl
sim/meshes-v26-k1/m213.stl
sim/meshes-v26-k1/m261.stl
sim/meshes-v26-k1/m258.stl
sim/meshes-v26-k1/m218.stl
sim/meshes-v26-k1/m222.stl
sim/meshes-v26-k1/m244.stl
assemblies/KRB.S0.00.000_SB.dxf
assemblies/KRB.S0.01.000_SB.dxf
assemblies/KRB.S0.02.000_SB.dxf
assemblies/KRB.S0.02.100_SB.dxf
assemblies/KRB.S0.03.000_SB.dxf
assemblies/KRB.S0.04.000_SB.dxf
assemblies/KRB.S0.05.000_SB.dxf
parts/KRB.S0.01.001_obolochka.dxf
parts/KRB.S0.01.001_obolochka.stl
parts/KRB.S0.01.002_plita-nizhnyaya.dxf
parts/KRB.S0.01.003_plita-verhnyaya.dxf
parts/KRB.S0.01.004_polka-elektroniki.dxf
parts/KRB.S0.01.005_kronshtein-derzhatelya.dxf
parts/KRB.S0.02.001_ugolok-povorota-bedra.dxf
parts/KRB.S0.02.001_ugolok-povorota-bedra.stl
parts/KRB.S0.02.002_skoba-bedra.dxf
parts/KRB.S0.02.003_shcheka-bedra.dxf
parts/KRB.S0.02.004_shcheka-bedra-korotkaya.dxf
parts/KRB.S0.02.005_peremychka-kolena.dxf
parts/KRB.S0.02.006_golen.dxf
parts/KRB.S0.02.007_rebro-goleni.dxf
parts/KRB.S0.02.008_stopa.dxf
parts/KRB.S0.02.008_stopa.stl
parts/KRB.S0.02.009_podoshva.dxf
parts/KRB.S0.02.009_podoshva.stl
parts/KRB.S0.02.010_ugolok-kolena.dxf
parts/KRB.S0.03.001_ploshchadka-plecha.dxf
parts/KRB.S0.03.001_ploshchadka-plecha.stl
parts/KRB.S0.03.002_zveno-plecha.dxf
parts/KRB.S0.03.003_rebro-plecha.dxf
parts/KRB.S0.03.004_zveno-predplechya.dxf
parts/KRB.S0.03.005_rebro-predplechya.dxf
parts/KRB.S0.03.006_plastina-kisti.dxf
parts/KRB.S0.03.010_stoika-plecha.dxf
parts/KRB.S0.03.010_stoika-plecha.stl
parts/KRB.S0.03.011_ugolok-povorota-kisti.dxf
parts/KRB.S0.03.011_ugolok-povorota-kisti.stl
parts/KRB.S0.04.001_kozhuh-golovy.dxf
parts/KRB.S0.04.001_kozhuh-golovy.stl
parts/KRB.S0.04.002_stoika-shei.dxf
parts/KRB.S0.04.002_stoika-shei.stl
parts/KRB.S0.04.003_konsol-shei.dxf
parts/KRB.S0.04.003_konsol-shei.stl
parts/KRB.S0.05.001_konteiner.dxf
parts/KRB.S0.05.001_konteiner.stl
parts/KRB.S0.05.002_ruchka.dxf
parts/KRB.S0.05.002_ruchka.stl
parts/KRB.S0.05.003_derzhatel.dxf
parts/KRB.S0.05.003_derzhatel.stl
parts/KRB.S0.06.001_lotok-batarei.dxf
parts/KRB.S0.06.001_lotok-batarei.stl
sim/meshes-v26-k1/m000.stl
sim/meshes-v26-k1/m001.stl
sim/meshes-v26-k1/m002.stl
sim/meshes-v26-k1/m003.stl
sim/meshes-v26-k1/m004.stl
sim/meshes-v26-k1/m005.stl
sim/meshes-v26-k1/m006.stl
sim/meshes-v26-k1/m007.stl
sim/meshes-v26-k1/m008.stl
sim/meshes-v26-k1/m009.stl
sim/meshes-v26-k1/m010.stl
sim/meshes-v26-k1/m011.stl
sim/meshes-v26-k1/m012.stl
sim/meshes-v26-k1/m013.stl
sim/meshes-v26-k1/m014.stl
sim/meshes-v26-k1/m015.stl
sim/meshes-v26-k1/m016.stl
sim/meshes-v26-k1/m017.stl
sim/meshes-v26-k1/m018.stl
sim/meshes-v26-k1/m019.stl
sim/meshes-v26-k1/m020.stl
sim/meshes-v26-k1/m021.stl
sim/meshes-v26-k1/m022.stl
sim/meshes-v26-k1/m023.stl
sim/meshes-v26-k1/m024.stl
sim/meshes-v26-k1/m025.stl
sim/meshes-v26-k1/m026.stl
sim/meshes-v26-k1/m027.stl
sim/meshes-v26-k1/m028.stl
sim/meshes-v26-k1/m029.stl
sim/meshes-v26-k1/m030.stl
sim/meshes-v26-k1/m031.stl
sim/meshes-v26-k1/m032.stl
sim/meshes-v26-k1/m033.stl
sim/meshes-v26-k1/m034.stl
sim/meshes-v26-k1/m035.stl
sim/meshes-v26-k1/m036.stl
sim/meshes-v26-k1/m037.stl
sim/meshes-v26-k1/m038.stl
sim/meshes-v26-k1/m039.stl
sim/meshes-v26-k1/m040.stl
sim/meshes-v26-k1/m041.stl
sim/meshes-v26-k1/m042.stl
sim/meshes-v26-k1/m043.stl
sim/meshes-v26-k1/m044.stl
sim/meshes-v26-k1/m045.stl
sim/meshes-v26-k1/m046.stl
sim/meshes-v26-k1/m047.stl
sim/meshes-v26-k1/m048.stl
sim/meshes-v26-k1/m049.stl
sim/meshes-v26-k1/m050.stl
sim/meshes-v26-k1/m051.stl
sim/meshes-v26-k1/m052.stl
sim/meshes-v26-k1/m053.stl
sim/meshes-v26-k1/m054.stl
sim/meshes-v26-k1/m055.stl
sim/meshes-v26-k1/m056.stl
sim/meshes-v26-k1/m057.stl
sim/meshes-v26-k1/m058.stl
sim/meshes-v26-k1/m059.stl
sim/meshes-v26-k1/m060.stl
sim/meshes-v26-k1/m061.stl
sim/meshes-v26-k1/m062.stl
sim/meshes-v26-k1/m063.stl
sim/meshes-v26-k1/m064.stl
sim/meshes-v26-k1/m065.stl
sim/meshes-v26-k1/m066.stl
sim/meshes-v26-k1/m067.stl
sim/meshes-v26-k1/m068.stl
sim/meshes-v26-k1/m069.stl
sim/meshes-v26-k1/m070.stl
sim/meshes-v26-k1/m071.stl
sim/meshes-v26-k1/m072.stl
sim/meshes-v26-k1/m073.stl
sim/meshes-v26-k1/m074.stl
sim/meshes-v26-k1/m075.stl
sim/meshes-v26-k1/m076.stl
sim/meshes-v26-k1/m077.stl
sim/meshes-v26-k1/m078.stl
sim/meshes-v26-k1/m079.stl
sim/meshes-v26-k1/m080.stl
sim/meshes-v26-k1/m081.stl
sim/meshes-v26-k1/m082.stl
sim/meshes-v26-k1/m083.stl
sim/meshes-v26-k1/m084.stl
sim/meshes-v26-k1/m085.stl
sim/meshes-v26-k1/m086.stl
sim/meshes-v26-k1/m087.stl
sim/meshes-v26-k1/m088.stl
sim/meshes-v26-k1/m089.stl
sim/meshes-v26-k1/m090.stl
sim/meshes-v26-k1/m091.stl
sim/meshes-v26-k1/m092.stl
sim/meshes-v26-k1/m093.stl
sim/meshes-v26-k1/m094.stl
sim/meshes-v26-k1/m095.stl
sim/meshes-v26-k1/m096.stl
sim/meshes-v26-k1/m097.stl
sim/meshes-v26-k1/m098.stl
sim/meshes-v26-k1/m099.stl
sim/meshes-v26-k1/m100.stl
sim/meshes-v26-k1/m101.stl
sim/meshes-v26-k1/m102.stl
sim/meshes-v26-k1/m103.stl
sim/meshes-v26-k1/m104.stl
sim/meshes-v26-k1/m105.stl
sim/meshes-v26-k1/m106.stl
sim/meshes-v26-k1/m107.stl
sim/meshes-v26-k1/m108.stl
sim/meshes-v26-k1/m109.stl
sim/meshes-v26-k1/m110.stl
sim/meshes-v26-k1/m111.stl
sim/meshes-v26-k1/m112.stl
sim/meshes-v26-k1/m113.stl
sim/meshes-v26-k1/m114.stl
sim/meshes-v26-k1/m115.stl
sim/meshes-v26-k1/m116.stl
sim/meshes-v26-k1/m117.stl
sim/meshes-v26-k1/m118.stl
sim/meshes-v26-k1/m119.stl
sim/meshes-v26-k1/m120.stl
sim/meshes-v26-k1/m121.stl
sim/meshes-v26-k1/m122.stl
sim/meshes-v26-k1/m123.stl
sim/meshes-v26-k1/m124.stl
sim/meshes-v26-k1/m125.stl
sim/meshes-v26-k1/m126.stl
sim/meshes-v26-k1/m127.stl
sim/meshes-v26-k1/m128.stl
sim/meshes-v26-k1/m129.stl
sim/meshes-v26-k1/m130.stl
sim/meshes-v26-k1/m131.stl
sim/meshes-v26-k1/m132.stl
sim/meshes-v26-k1/m133.stl
sim/meshes-v26-k1/m134.stl
sim/meshes-v26-k1/m135.stl
sim/meshes-v26-k1/m136.stl
sim/meshes-v26-k1/m137.stl
sim/meshes-v26-k1/m138.stl
sim/meshes-v26-k1/m139.stl
sim/meshes-v26-k1/m140.stl
sim/meshes-v26-k1/m141.stl
sim/meshes-v26-k1/m142.stl
sim/meshes-v26-k1/m143.stl
sim/meshes-v26-k1/m144.stl
sim/meshes-v26-k1/m145.stl
sim/meshes-v26-k1/m146.stl
sim/meshes-v26-k1/m147.stl
sim/meshes-v26-k1/m148.stl
sim/meshes-v26-k1/m149.stl
sim/meshes-v26-k1/m150.stl
sim/meshes-v26-k1/m151.stl
sim/meshes-v26-k1/m152.stl
sim/meshes-v26-k1/m153.stl
sim/meshes-v26-k1/m154.stl
sim/meshes-v26-k1/m155.stl
sim/meshes-v26-k1/m156.stl
sim/meshes-v26-k1/m157.stl
sim/meshes-v26-k1/m158.stl
sim/meshes-v26-k1/m159.stl
sim/meshes-v26-k1/m160.stl
sim/meshes-v26-k1/m161.stl
sim/meshes-v26-k1/m162.stl
sim/meshes-v26-k1/m163.stl
sim/meshes-v26-k1/m164.stl
sim/meshes-v26-k1/m165.stl
sim/meshes-v26-k1/m166.stl
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
