pilot443/avad-s0/docs/bom/manufacturing.csv

обозн | имя | процесс | материал | кол | масса_г | файл_для_заказа | папка | группа
КРБ.S0.01.001 | Боковая оболочка корпуса | печать | PETG, печать | 1 | 191,36 | KRB.S0.01.001_obolochka.stl | рабочая-документация/детали | робот
КРБ.S0.01.002 | Нижняя плита корпуса | лист | Лист алюминиевый 2 мм (S2) | 1 | 171,01 | KRB.S0.01.002_plita-nizhnyaya_раскрой.dxf | рабочая-документация/детали | робот
КРБ.S0.01.003 | Верхняя плита корпуса | лист | Лист алюминиевый 2 мм (S2) | 1 | 171,44 | KRB.S0.01.003_plita-verhnyaya_раскрой.dxf | рабочая-документация/детали | робот
КРБ.S0.01.004 | Полка электроники | лист | Лист алюминиевый 2 мм (S2) | 1 | 155,4 | KRB.S0.01.004_polka-elektroniki_раскрой.dxf | рабочая-документация/детали | робот
КРБ.S0.01.005 | Кронштейн заднего держателя контейнера (гнутый) | гнутая | Лист алюминиевый 2,5 мм, гнутый | 2 | 22,1 | KRB.S0.01.005_razvertka_раскрой.dxf + гиб по чертежу | рабочая-документация/детали | робот
КРБ.S0.02.001 | Уголок поворота бедра | печать | PETG, печать | 6 | 19,1 | KRB.S0.02.001_ugolok-povorota-bedra.stl | рабочая-документация/детали | робот
КРБ.S0.02.002 | Скоба бедра (гнутая, U) | гнутая | Лист алюминиевый 1,5 мм, гнутый | 6 | 20,22 | KRB.S0.02.002_razvertka_раскрой.dxf + гиб по чертежу | рабочая-документация/детали | робот
КРБ.S0.02.003 | Щека бедра | лист | Лист алюминиевый 4 мм (S4) | 10 | 32,03 | KRB.S0.02.003_shcheka-bedra_раскрой.dxf | рабочая-документация/детали | робот
КРБ.S0.02.004 | Щека бедра укороченная (передние ноги) | лист | Лист алюминиевый 4 мм (S4) | 2 | 3,58 | KRB.S0.02.004_shcheka-bedra-korotkaya_раскрой.dxf | рабочая-документация/детали | робот
КРБ.S0.02.005 | Перемычка колена | плита | Плита алюминиевая 7 мм (S7) | 6 | 25,12 | KRB.S0.02.005_peremychka-kolena_раскрой.dxf | рабочая-документация/детали | робот
КРБ.S0.02.006 | Голень | лист | Лист алюминиевый 2 мм (S2) | 6 | 13,32 | KRB.S0.02.006_golen_раскрой.dxf | рабочая-документация/детали | робот
КРБ.S0.02.007 | Ребро жёсткости голени (труба 16×8×1,5) | труба | Труба алюминиевая 16×8×1,5 | 6 | 9,84 | KRB.S0.02.007_rebro-goleni.pdf (резать в размер, сверлить) | рабочая-документация/детали | робот
КРБ.S0.02.008 | Стопа | печать | PETG, печать | 6 | 14,77 | KRB.S0.02.008_stopa.stl | рабочая-документация/детали | робот
КРБ.S0.02.009 | Подошва стопы (полусфера R9) | печать-TPU | TPU 95A, печать | 6 | 1,83 | KRB.S0.02.009_podoshva.stl | рабочая-документация/детали | робот
КРБ.S0.02.010 | Уголок колена (гнутый) | гнутая | Лист алюминиевый 2 мм, гнутый | 6 | 6,44 | KRB.S0.02.010_razvertka_раскрой.dxf + гиб по чертежу | рабочая-документация/детали | робот
КРБ.S0.03.001 | Площадка плеча | печать | PETG, печать | 2 | 10,08 | KRB.S0.03.001_ploshchadka-plecha.stl | рабочая-документация/детали | робот
КРБ.S0.03.002 | Звено плеча | лист | Лист алюминиевый 2 мм (S2) | 2 | 16,87 | KRB.S0.03.002_zveno-plecha_раскрой.dxf | рабочая-документация/детали | робот
КРБ.S0.03.003 | Ребро жёсткости звена плеча (труба 16×8×1,5) | труба | Труба алюминиевая 16×8×1,5 | 2 | 9,63 | KRB.S0.03.003_rebro-plecha.pdf (резать в размер, сверлить) | рабочая-документация/детали | робот
КРБ.S0.03.004 | Звено предплечья | лист | Лист алюминиевый 2 мм (S2) | 2 | 18,16 | KRB.S0.03.004_zveno-predplechya_раскрой.dxf | рабочая-документация/детали | робот
КРБ.S0.03.005 | Ребро жёсткости звена предплечья (труба 16×8×1,5) | труба | Труба алюминиевая 16×8×1,5 | 2 | 8,61 | KRB.S0.03.005_rebro-predplechya.pdf (резать в размер, сверлить) | рабочая-документация/детали | робот
КРБ.S0.03.006 | Пластина кисти | лист | Лист алюминиевый 2 мм (S2) | 2 | 12,95 | KRB.S0.03.006_plastina-kisti_раскрой.dxf | рабочая-документация/детали | робот
КРБ.S0.03.010 | Стойка плеча (кронштейн к корпусу) | печать | PETG, печать | 2 | 40,58 | KRB.S0.03.010_stoika-plecha.stl | рабочая-документация/детали | робот
КРБ.S0.03.011 | Уголок поворота кисти | печать | PETG, печать | 2 | 3,27 | KRB.S0.03.011_ugolok-povorota-kisti.stl | рабочая-документация/детали | робот
КРБ.S0.04.001 | Кожух головы | печать | PETG, печать | 1 | 89,51 | KRB.S0.04.001_kozhuh-golovy.stl | рабочая-документация/детали | робот
КРБ.S0.04.002 | Стойка шеи | печать | PETG, печать | 1 | 30,9 | KRB.S0.04.002_stoika-shei.stl | рабочая-документация/детали | робот
КРБ.S0.04.003 | Консоль шеи | печать | PETG, печать | 1 | 9,85 | KRB.S0.04.003_konsol-shei.stl | рабочая-документация/детали | робот
КРБ.S0.05.001 | Сменный контейнер (куб 200 мм) | печать | PETG, печать | 1 | 397,59 | KRB.S0.05.001_konteiner.stl | рабочая-документация/детали | робот
КРБ.S0.05.002 | Ручка-перекладина контейнера | печать | PETG, печать | 1 | 8,5 | KRB.S0.05.002_ruchka.stl | рабочая-документация/детали | робот
КРБ.S0.05.003 | Угловой держатель контейнера (замок вчерне) | печать | PETG, печать | 4 | 20,28 | KRB.S0.05.003_derzhatel.stl | рабочая-документация/детали | робот
КРБ.S0.06.001 | Лоток батареи | печать | PETG, печать | 1 | 62,91 | KRB.S0.06.001_lotok-batarei.stl | рабочая-документация/детали | робот
КРБ.S0.07.001 | Гнездо замка кисти | печать | PETG, печать | 2 | 7,36 | KRB.S0.07.001_gnezdo-zamka.stl | модули/чертежи | кисти
КРБ.S0.07.002 | Кольцо-байонет замка | печать | PETG, печать | 2 | 3,66 | KRB.S0.07.002_koltso-baioneta.stl | модули/чертежи | кисти
КРБ.S0.07.003 | Ответная плита кисти | печать | PETG, печать | 4 | 6,38 | KRB.S0.07.003_otvetnaya-plita.stl | модули/чертежи | кисти
КРБ.S0.07.020 | Держатель жала паяльной кисти | печать | PA-CF (нейлон с углеволокном), печать | 1 | 7,5 | KRB.S0.07.020_derzhatel-zhala.stl | модули/чертежи | кисти
КРБ.S0.07.030 | Корпус трещотки отвёрточной кисти | печать | PA-CF (нейлон с углеволокном), печать | 1 | 14,58 | KRB.S0.07.030_korpus-treshchotki.stl | модули/чертежи | кисти
КРБ.S0.07.034 | Крышка трещотки | печать | PA-CF (нейлон с углеволокном), печать | 1 | 3,78 | KRB.S0.07.034_kryshka-treshchotki.stl | модули/чертежи | кисти
КРБ.S0.07.031 | Вал трещотки с гнездом бита | точение | Сталь 40Х (или 45), точение | 1 | 12,33 | KRB.S0.07.031_val-treshchotki.step + .pdf | модули/чертежи | кисти
КРБ.S0.07.032 | Втулка обгонной муфты | точение | Алюминий Д16Т (2024), точение | 2 | 2,34 | KRB.S0.07.032_vtulka-mufty.step + .pdf | модули/чертежи | кисти
КРБ.S0.07.033 | Кольцо переключателя направления | печать | PETG, печать | 1 | 1,85 | KRB.S0.07.033_koltso-pereklyuchatelya.stl | модули/чертежи | кисти
КРБ.S0.07.035 | Распорная втулка трещотки | печать | PETG, печать | 1 | 0,56 | KRB.S0.07.035_raspornaya-vtulka.stl | модули/чертежи | кисти
КРБ.S0.07.011 | Основание захвата К1 | печать | PETG, печать | 2 | 22,76 | KRB.S0.07.011_osnovanie-zahvata.stl | модули/чертежи | кисти
КРБ.S0.07.012 | Губка захвата подвижная | печать | PETG, печать | 2 | 16,43 | KRB.S0.07.012_gubka-podvizhnaya.stl | модули/чертежи | кисти
КРБ.S0.07.013 | Накладка губки подвижной | печать-TPU | TPU 95A, печать | 2 | 0,72 | KRB.S0.07.013_nakladka-podvizhnoi.stl | модули/чертежи | кисти
КРБ.S0.07.014 | Накладка губки неподвижной | печать-TPU | TPU 95A, печать | 2 | 0,72 | KRB.S0.07.014_nakladka-nepodvizhnoi.stl | модули/чертежи | кисти
