pilot443/avad-s0/assemblies/KRB.S0.02.100_SB.png

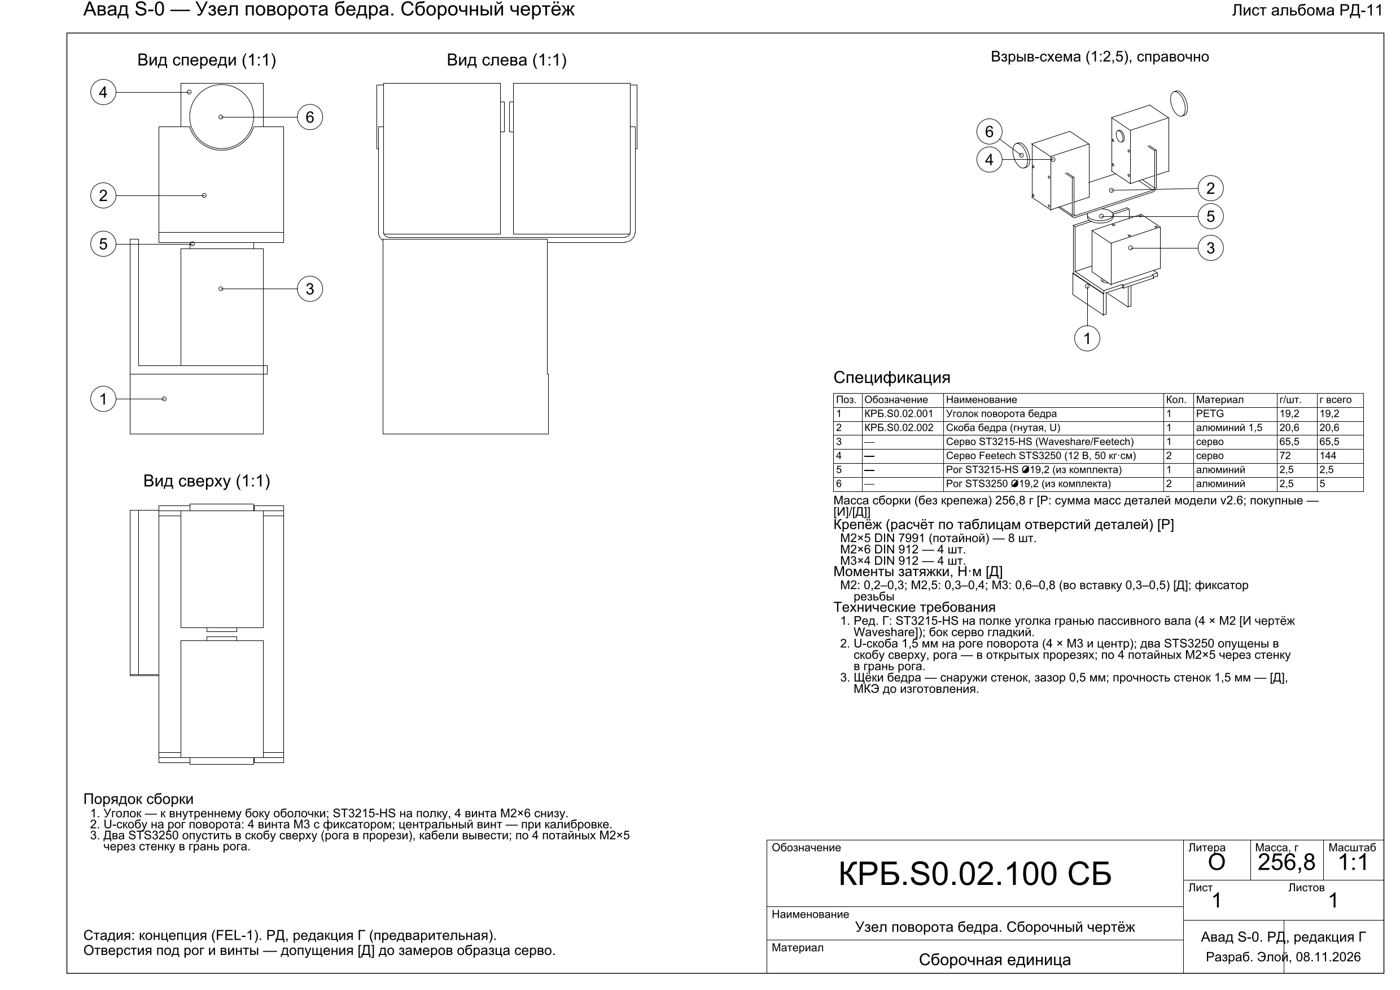
assemblies/KRB.S0.02.100_SB.png
