pilot443/avad-s0/electrical/MP-01_wiring-diagram.png

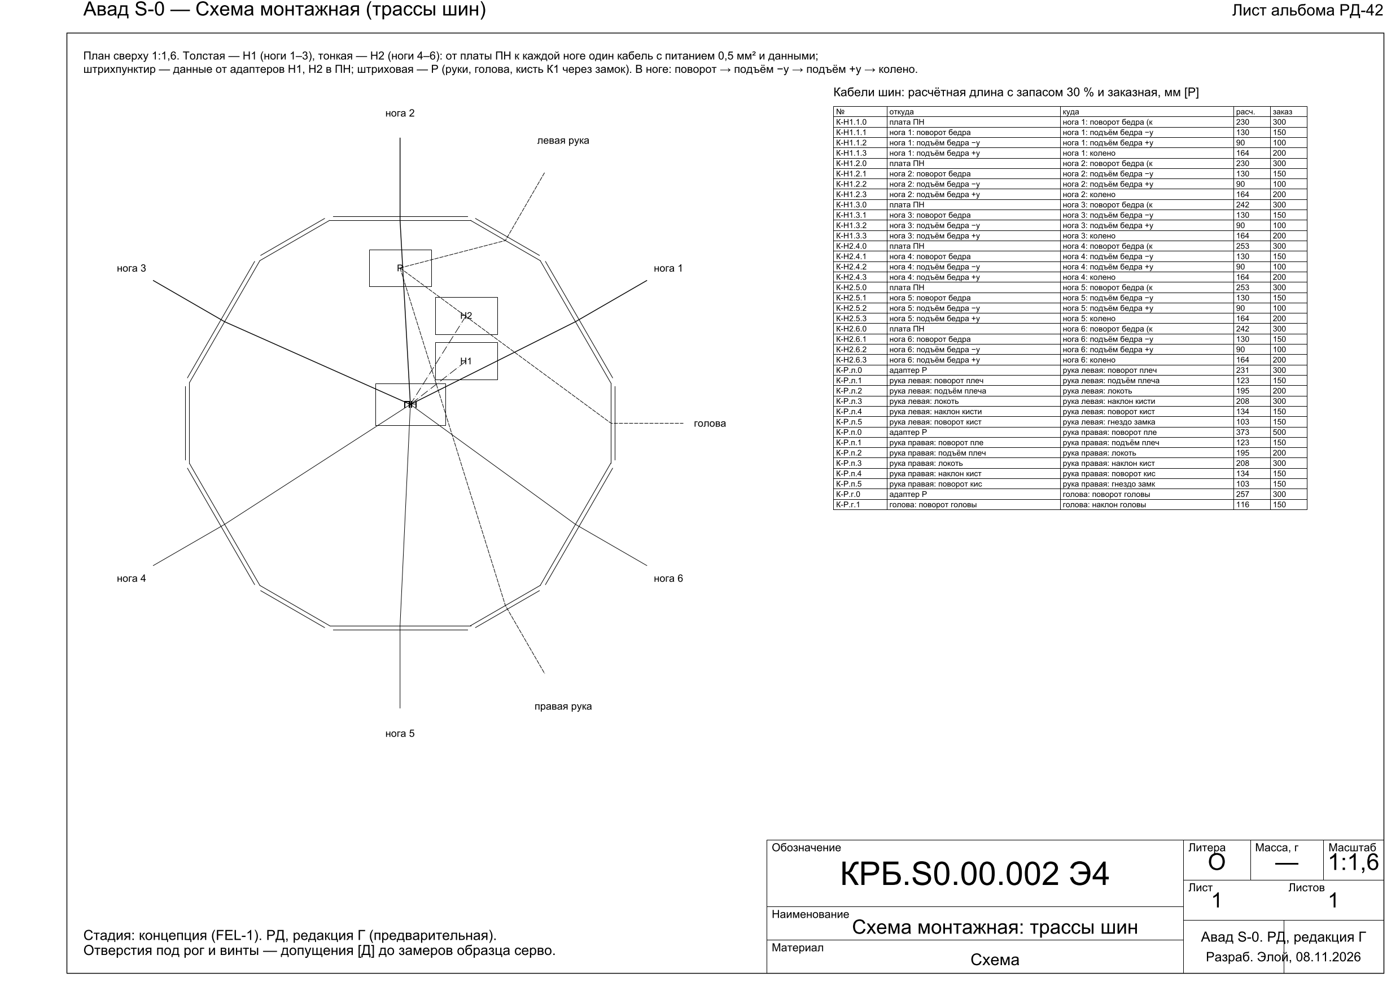
electrical/MP-01_wiring-diagram.png
