pilot443/avad-s0/wrist-tools/assemblies/KRB.S0.07.200_SB.png

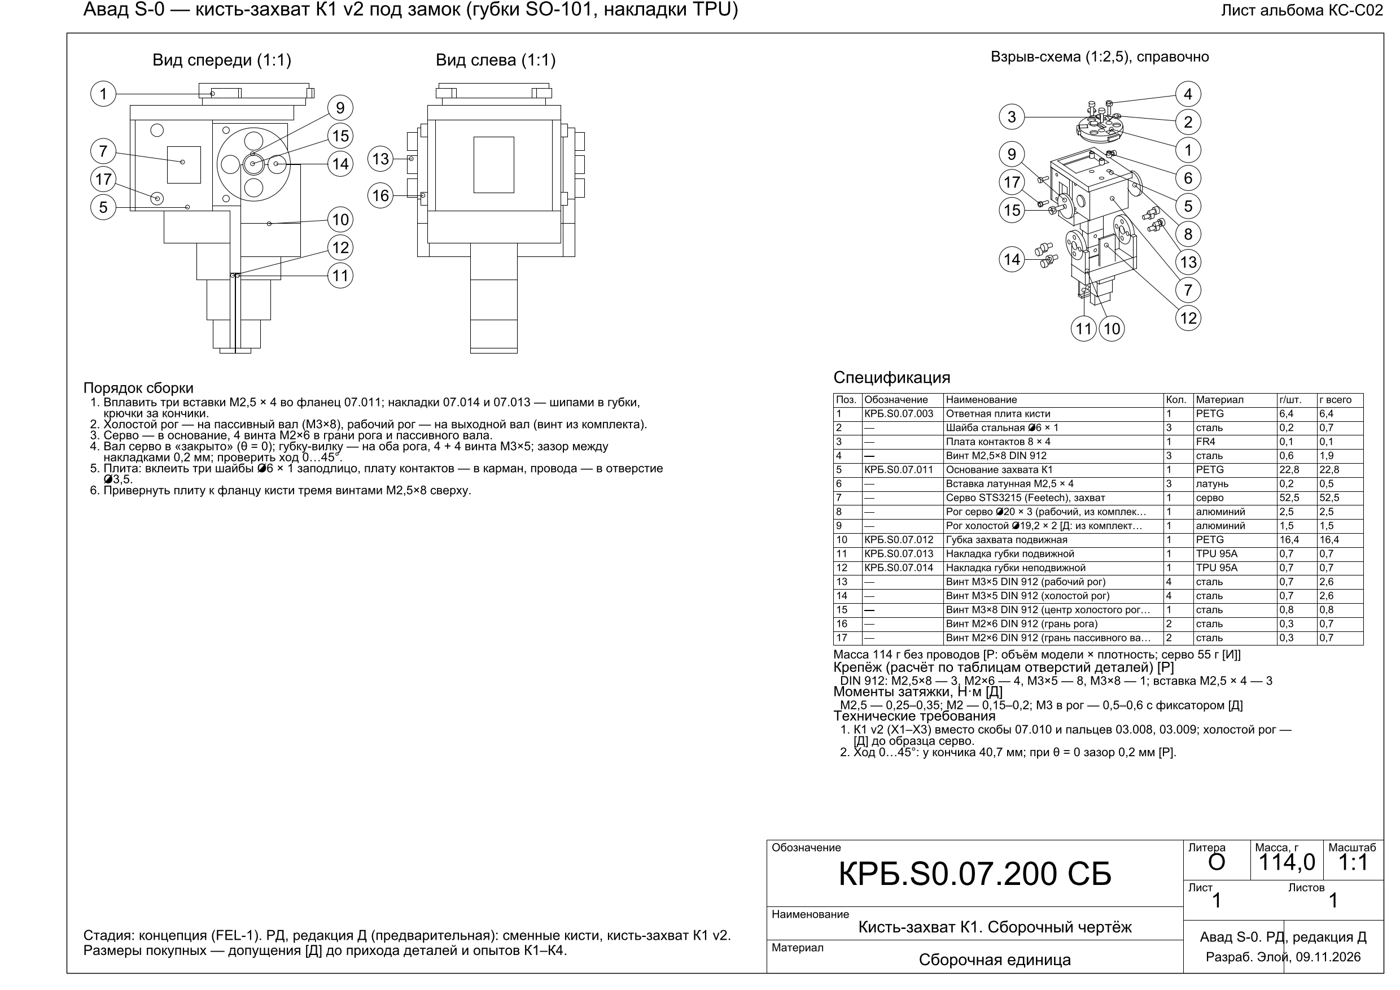
wrist-tools/assemblies/KRB.S0.07.200_SB.png
