pilot443/avad-s0/wrist-tools/assemblies/KRB.S0.07.300_SB.png

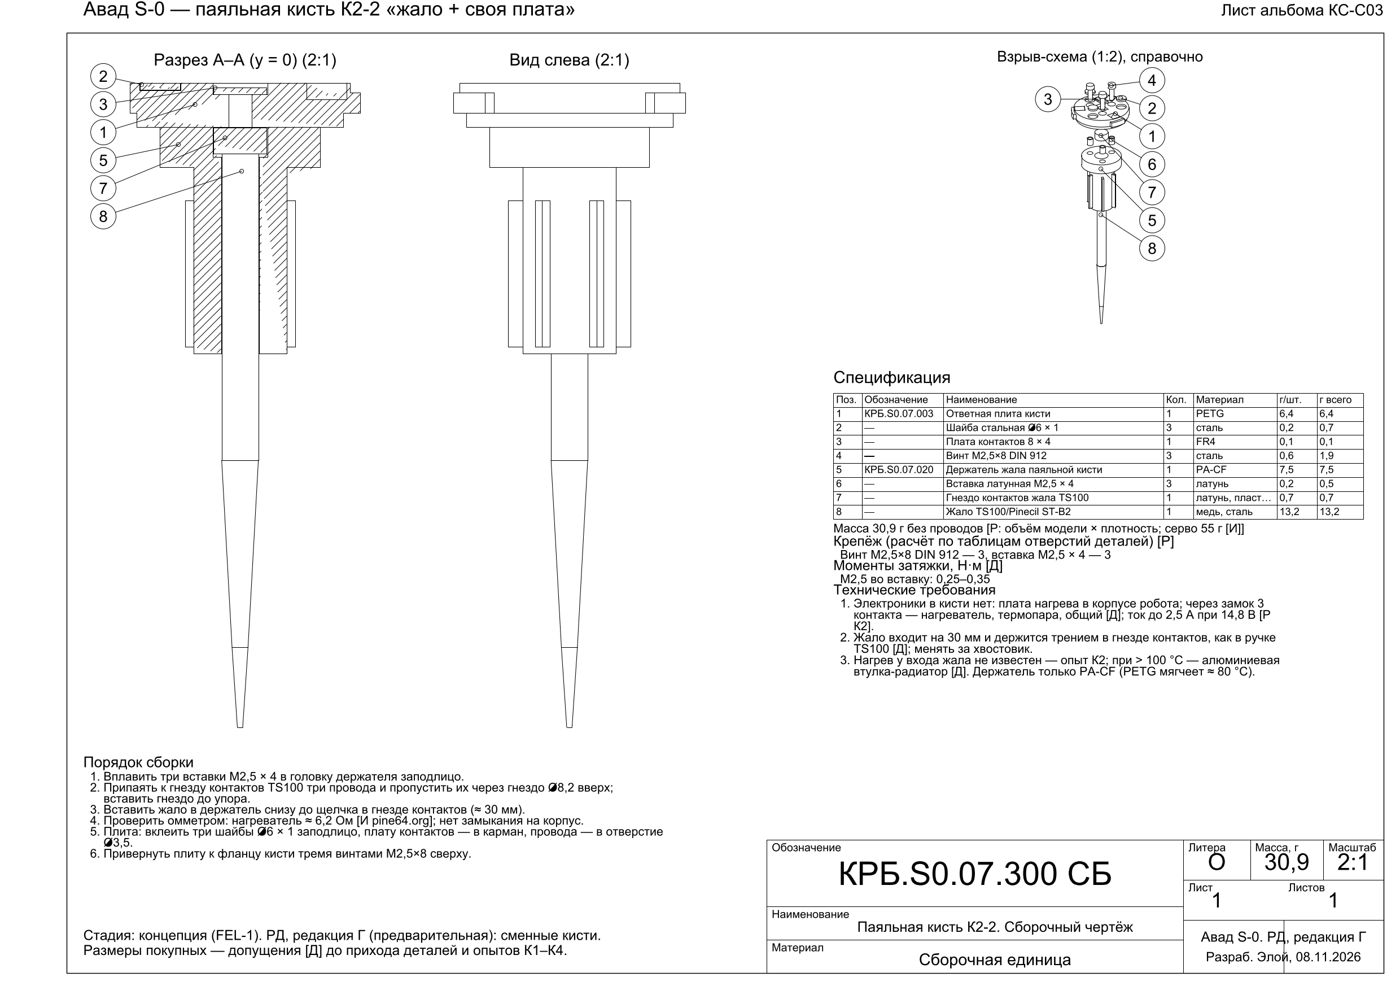
wrist-tools/assemblies/KRB.S0.07.300_SB.png
