pilot443/avad-s0/assemblies/KRB.S0.00.000_SB.pdf

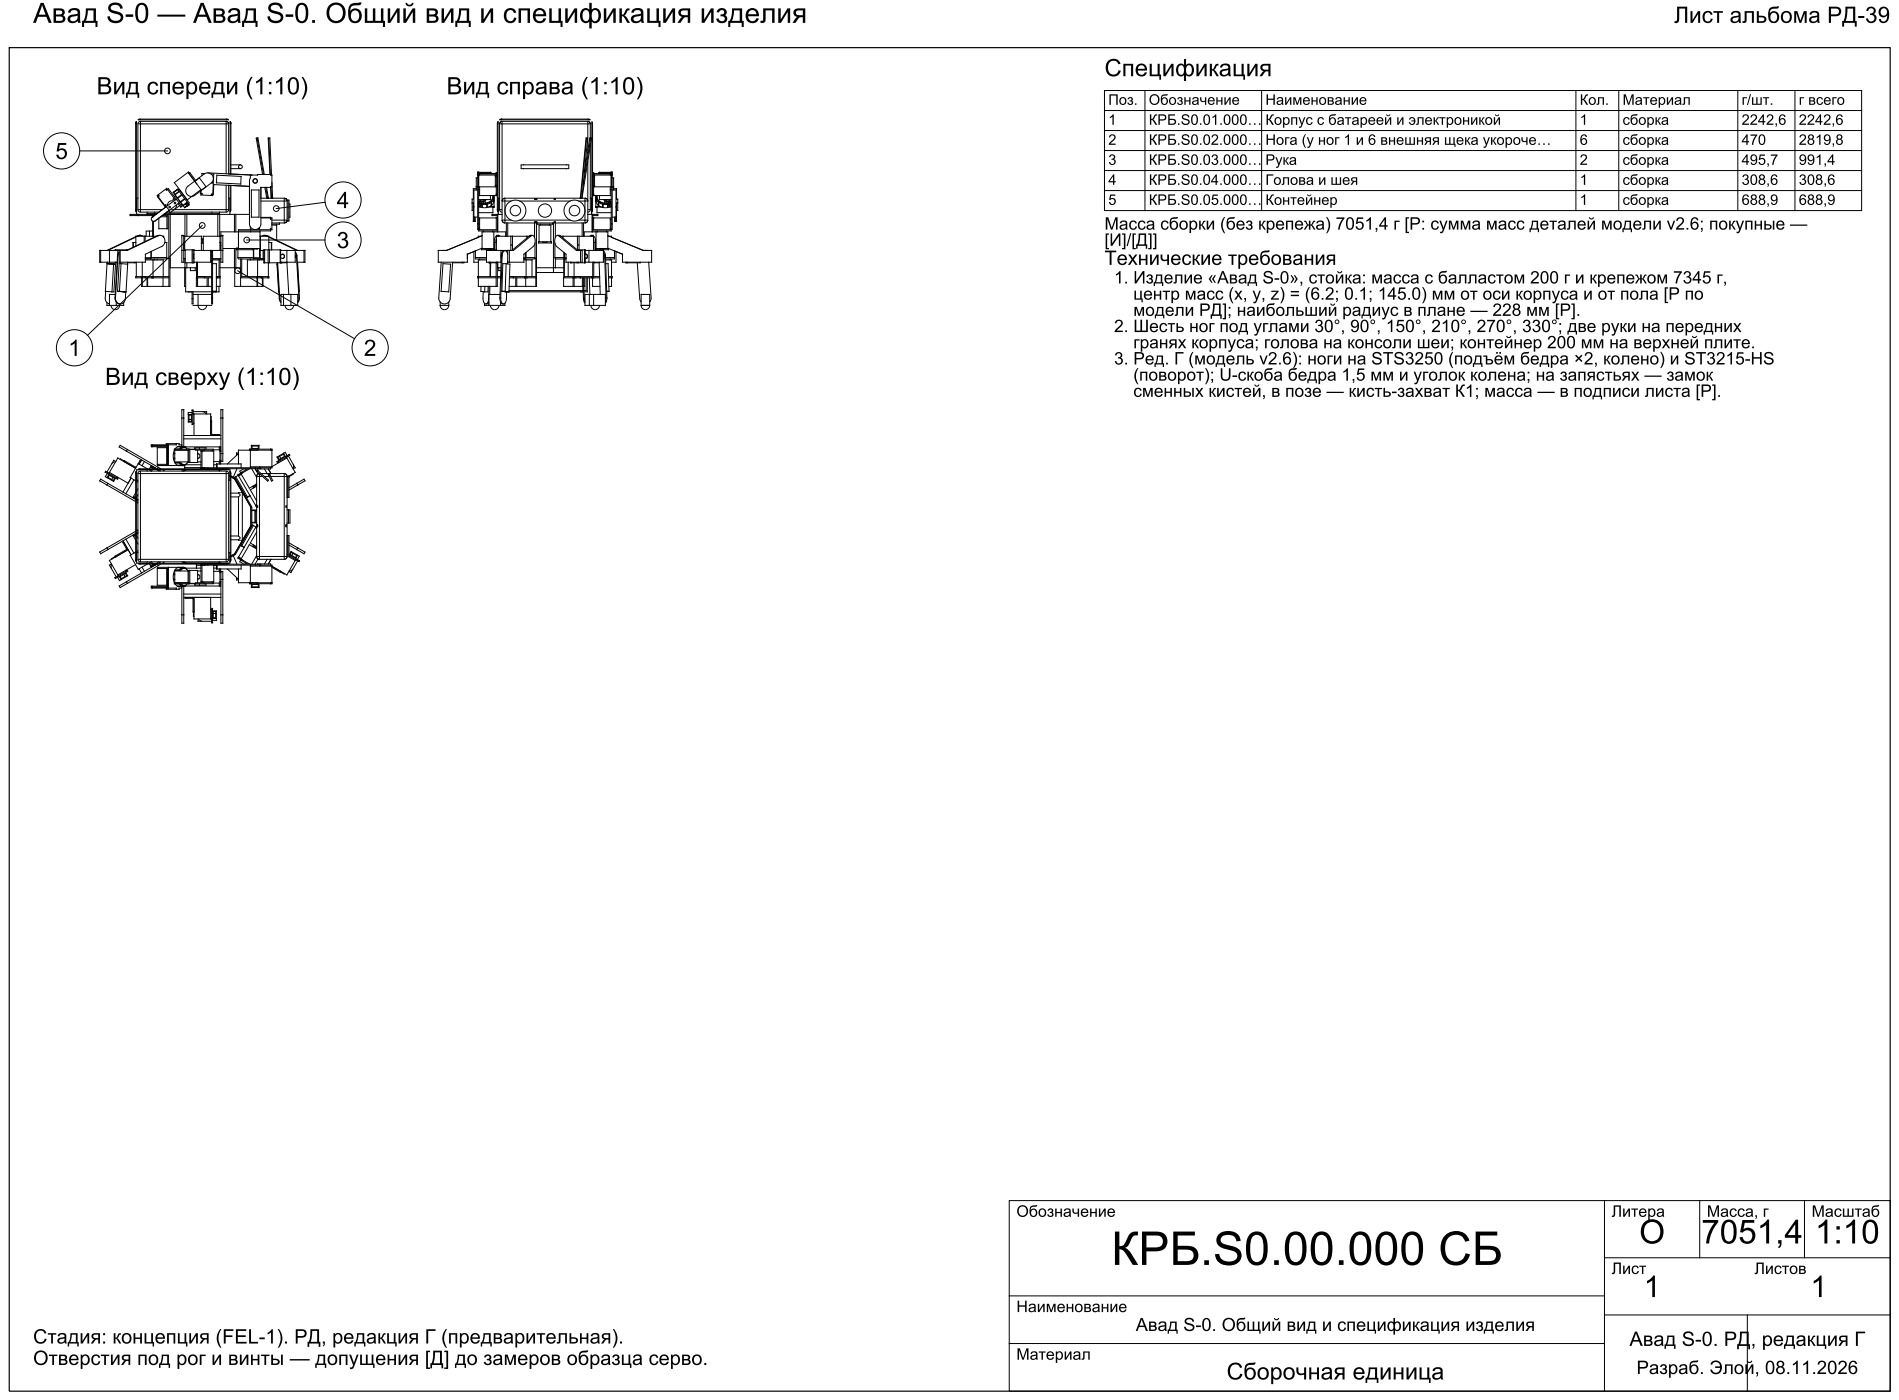
[picture p173: page 1]
