pilot443/avad-s0/assemblies/KRB.S0.01.000_SB.pdf

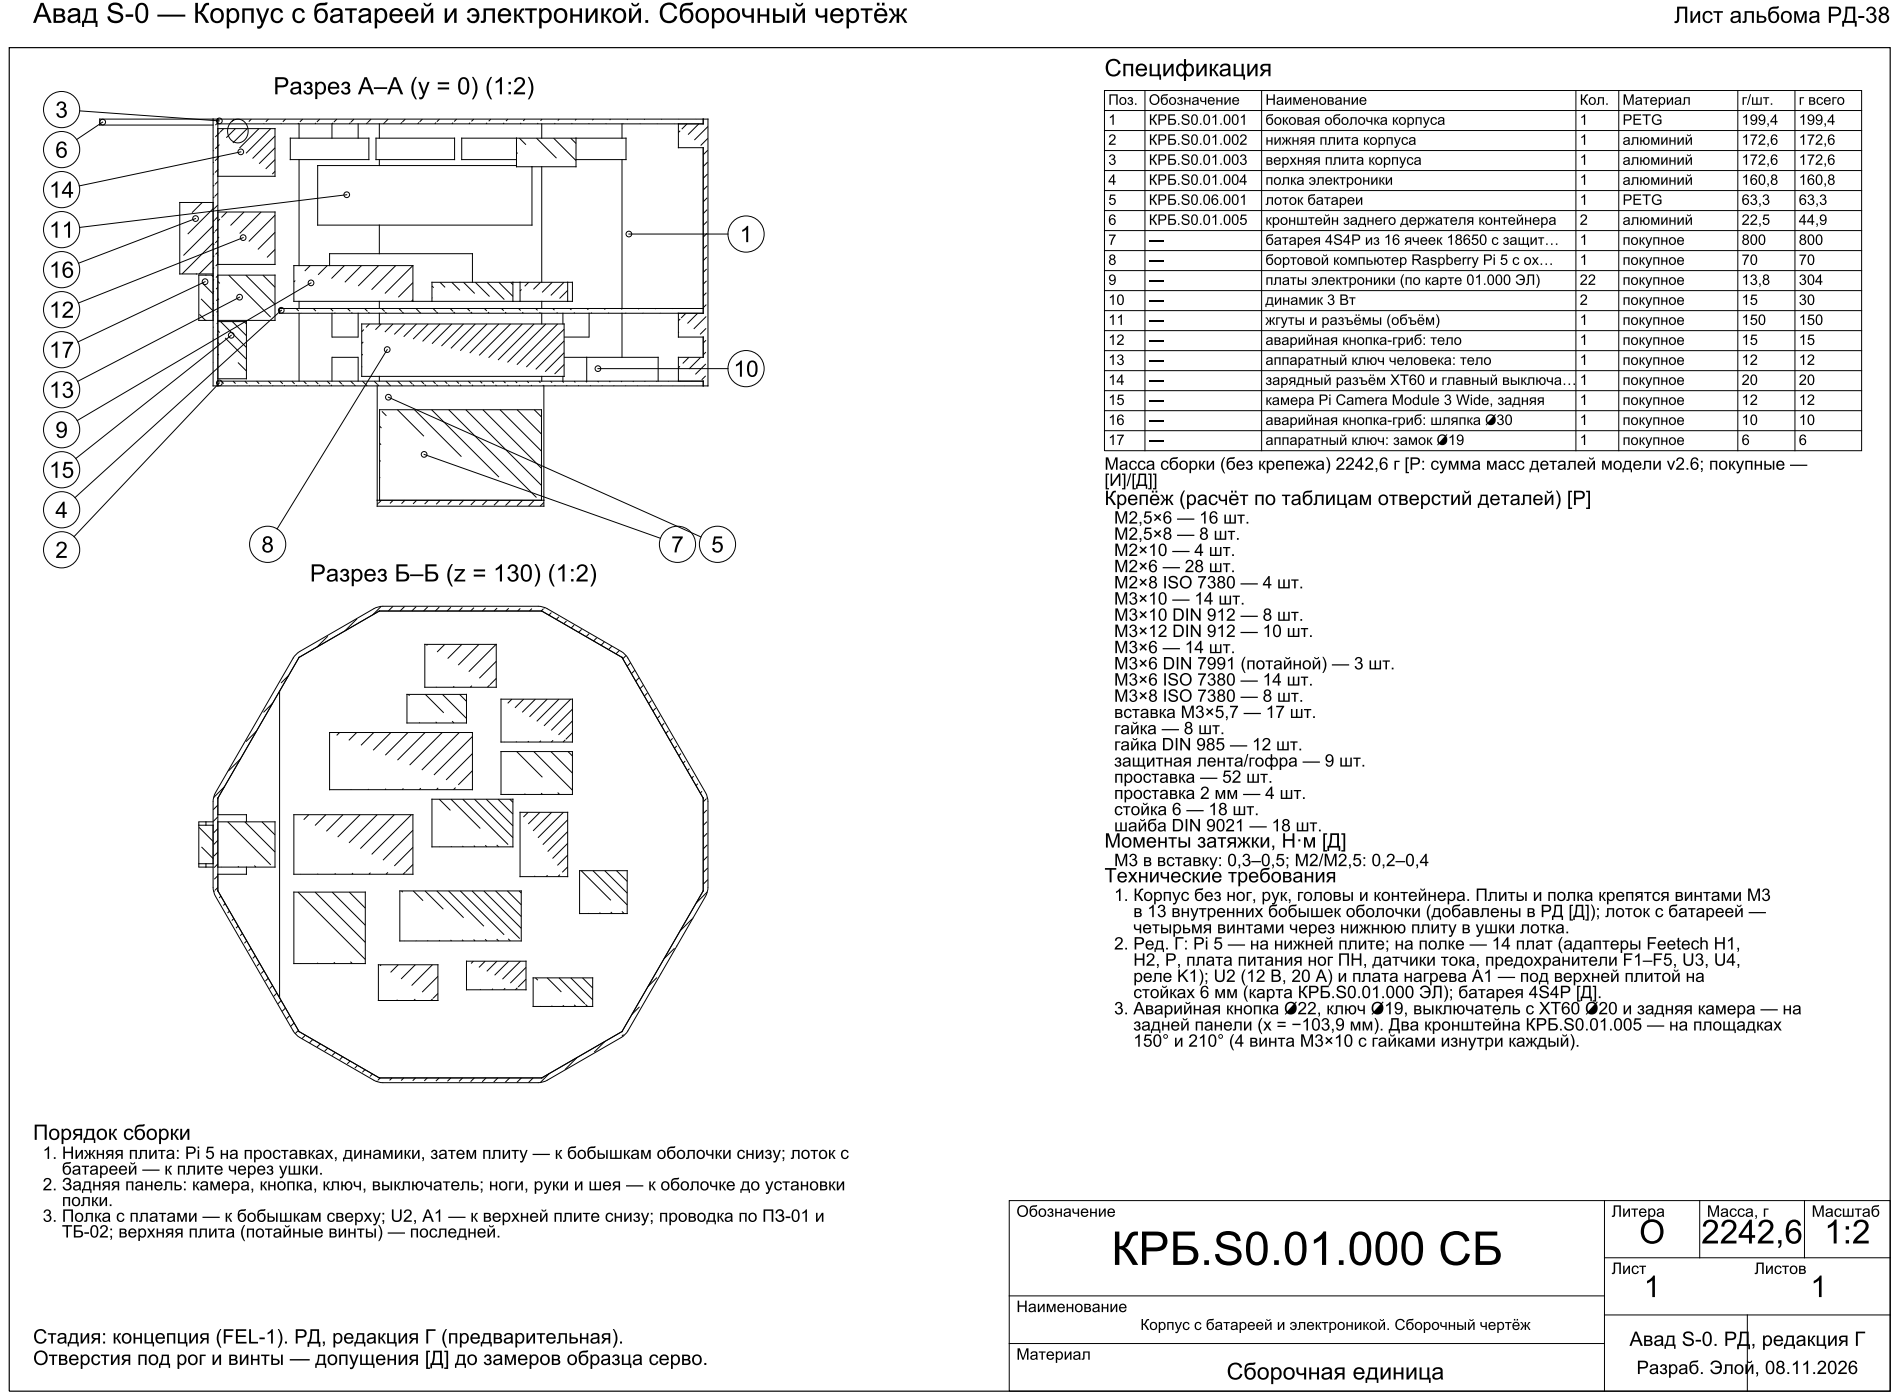
[picture p174: page 1]
