pilot443/avad-s0/assemblies/KRB.S0.02.000_SB.pdf

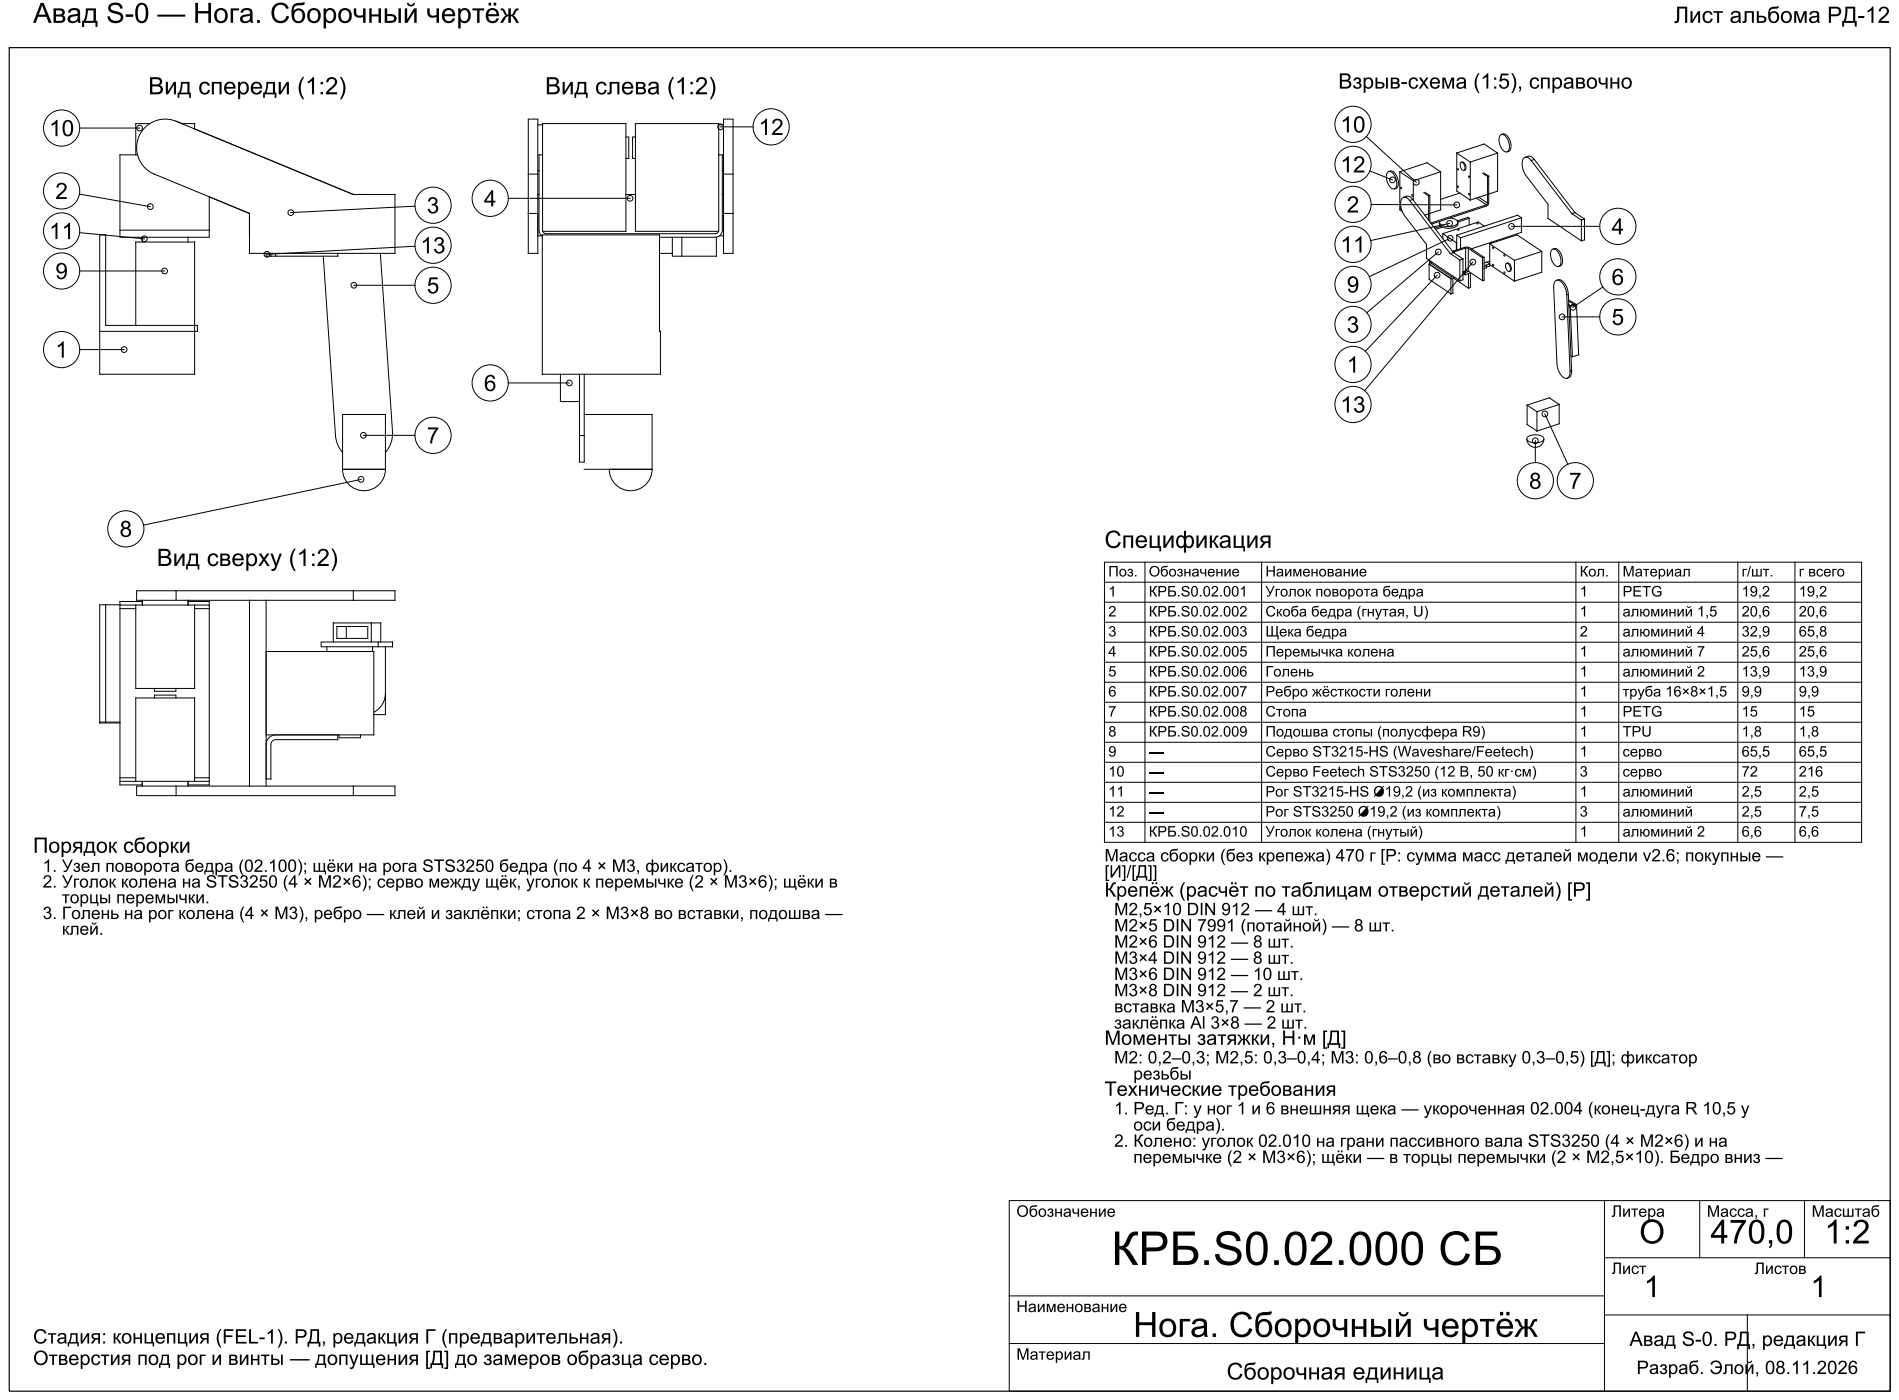
[picture p175: page 1]
