pilot443/avad-s0/assemblies/KRB.S0.02.100_SB.pdf

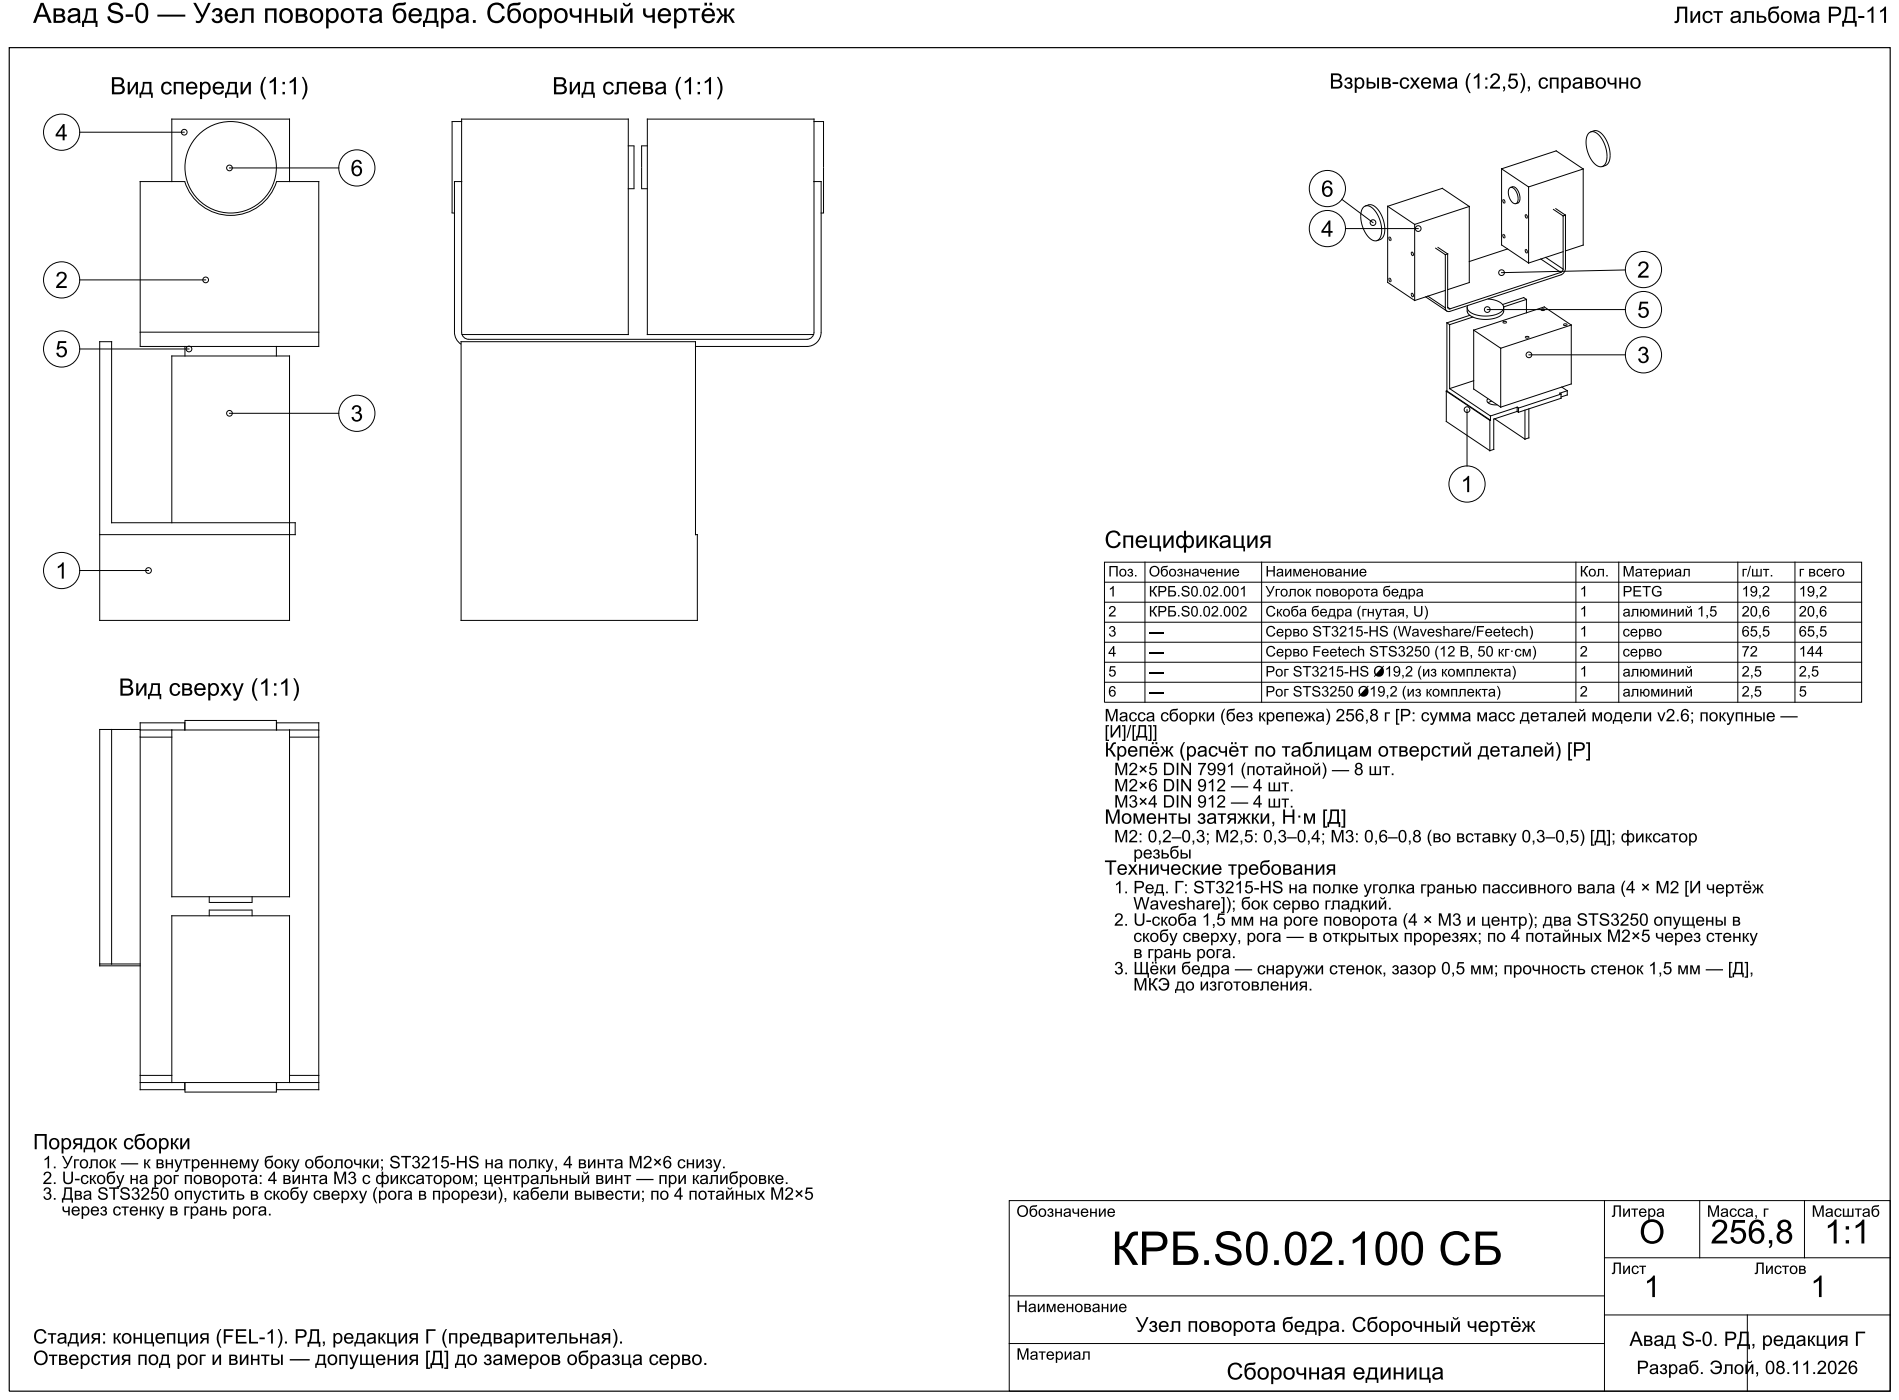
[picture p176: page 1]
