pilot443/avad-s0/assemblies/KRB.S0.03.000_SB.pdf

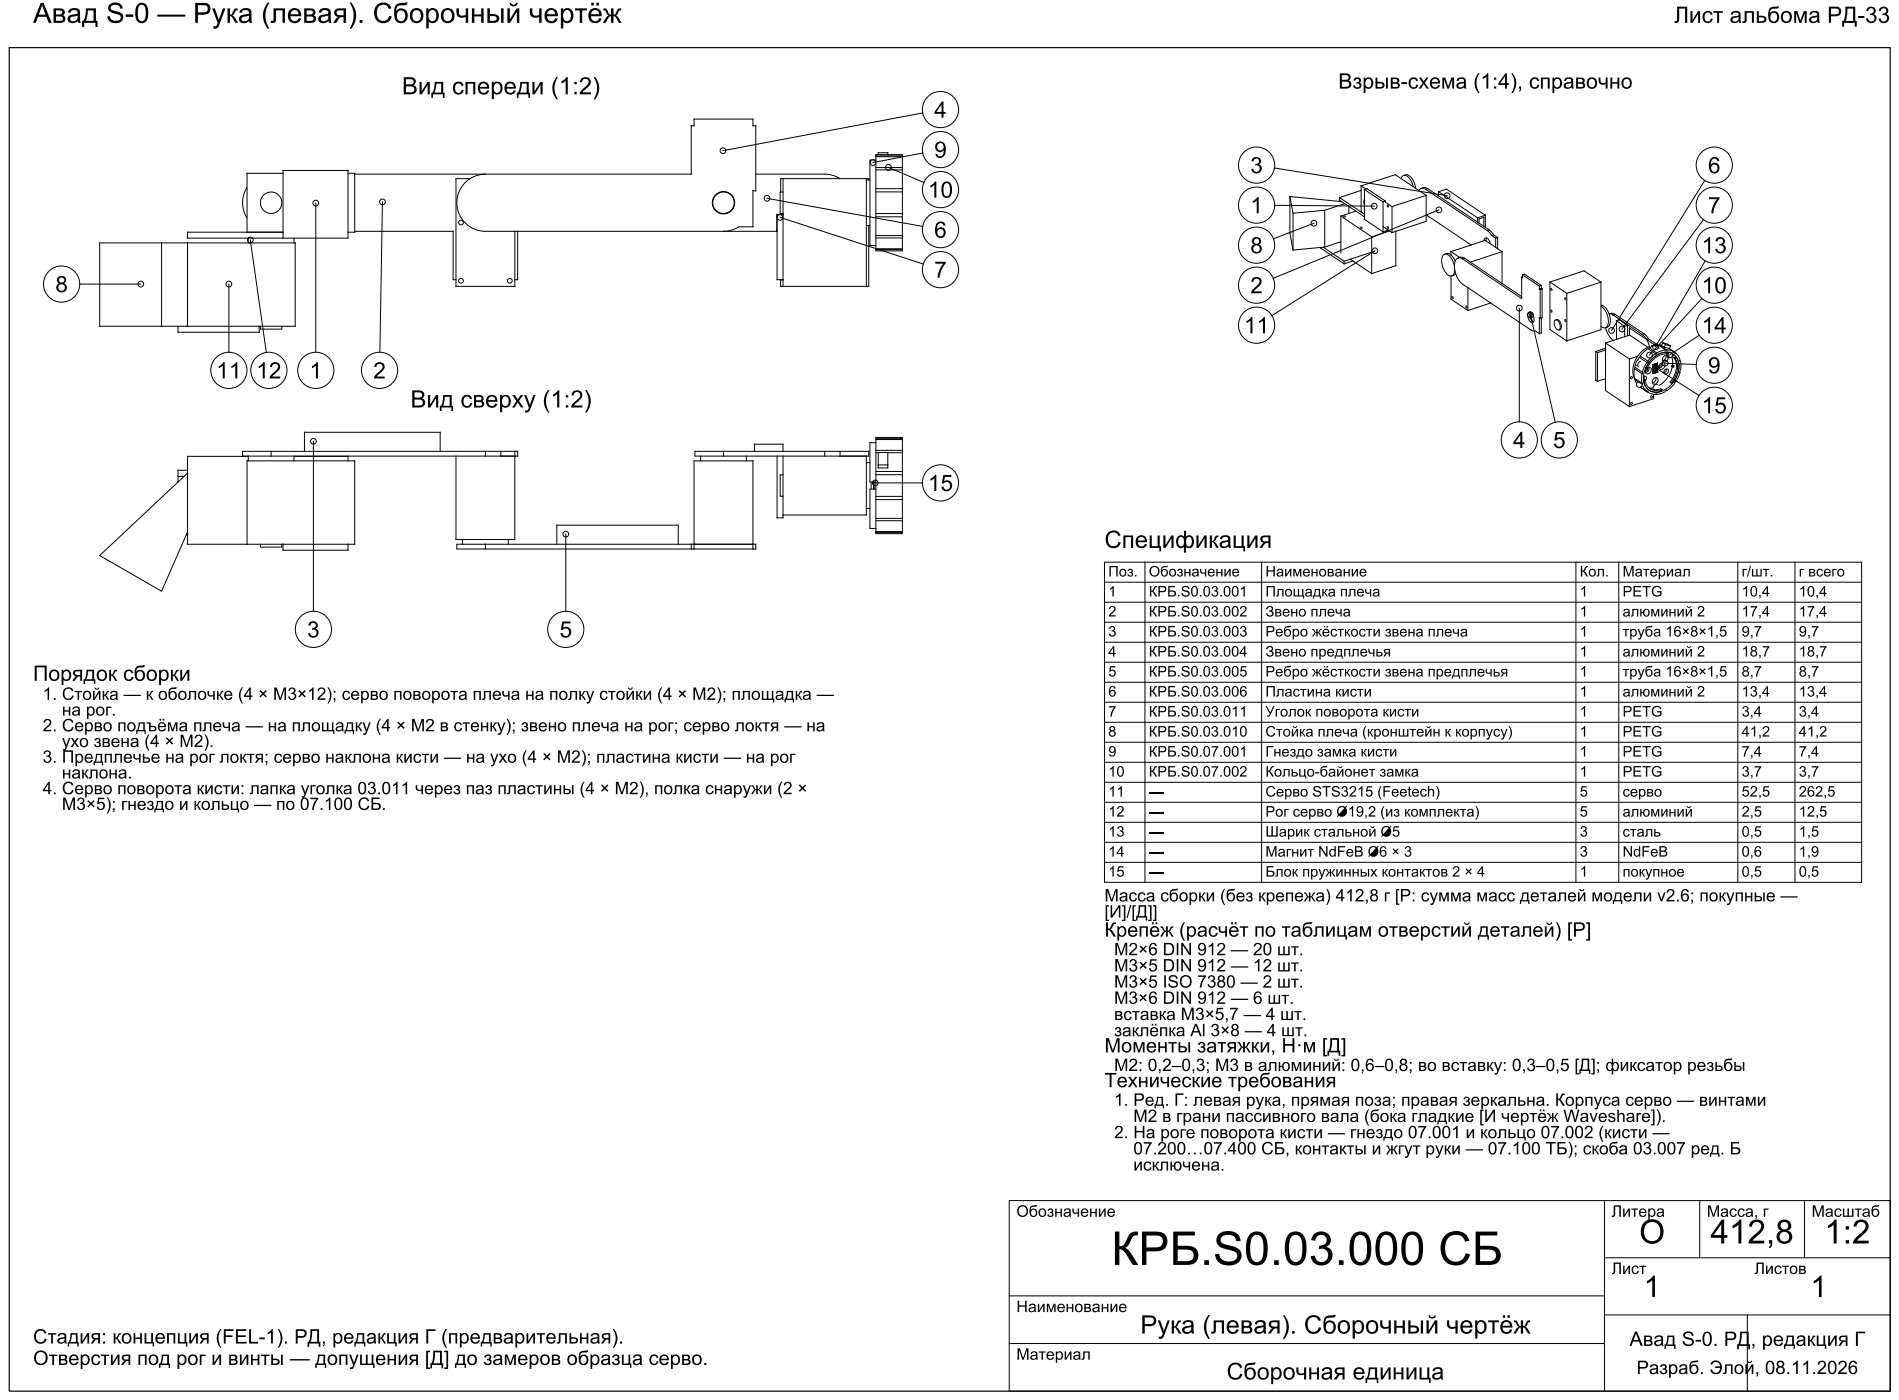
[picture p177: page 1]
