pilot443/avad-s0/assemblies/KRB.S0.04.000_SB.pdf

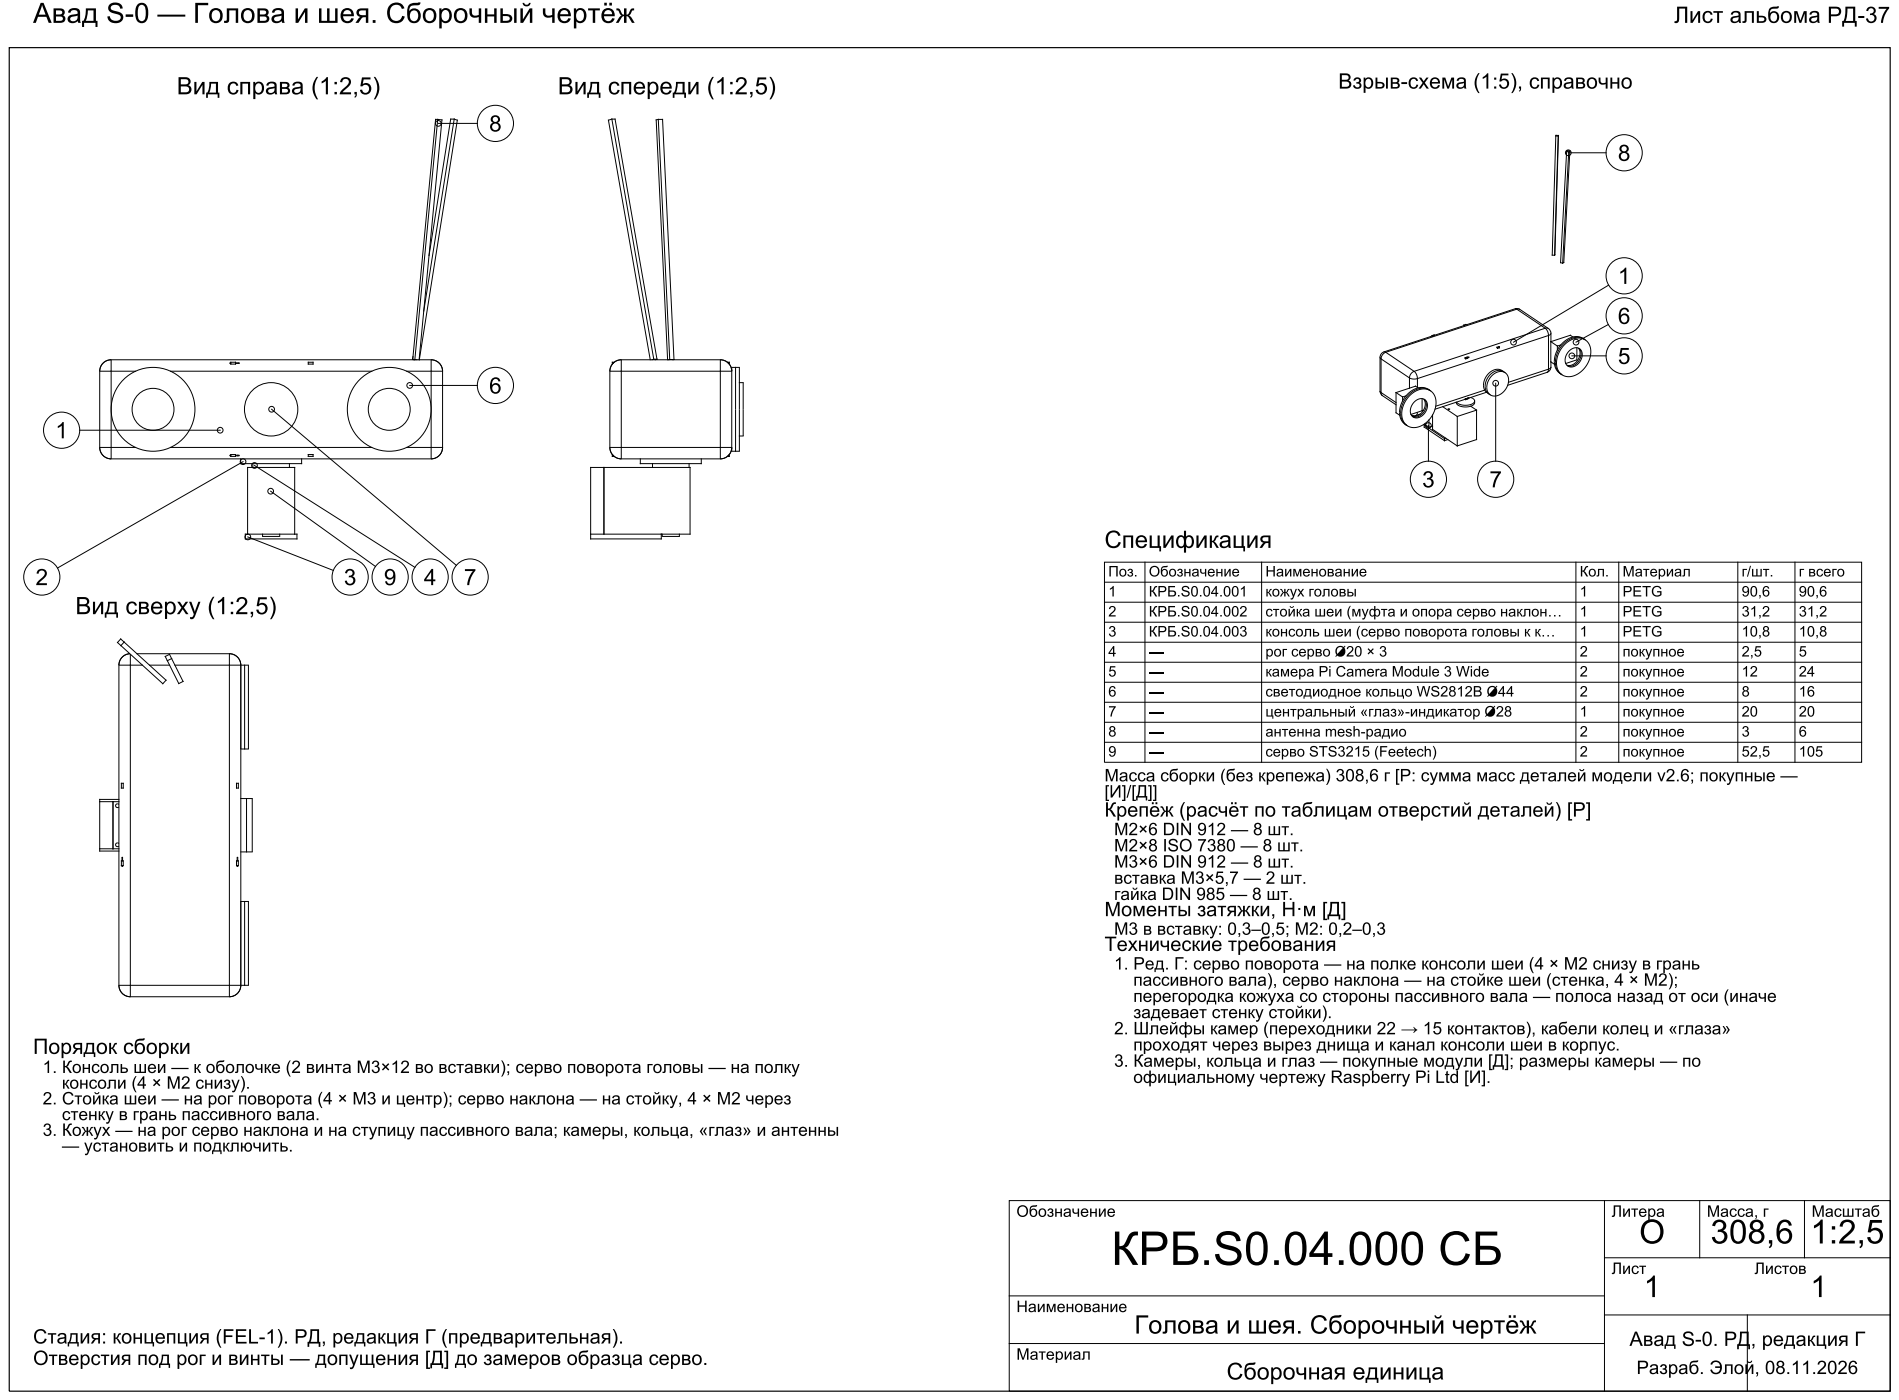
[picture p178: page 1]
