pilot443/avad-s0/assemblies/KRB.S0.05.000_SB.pdf

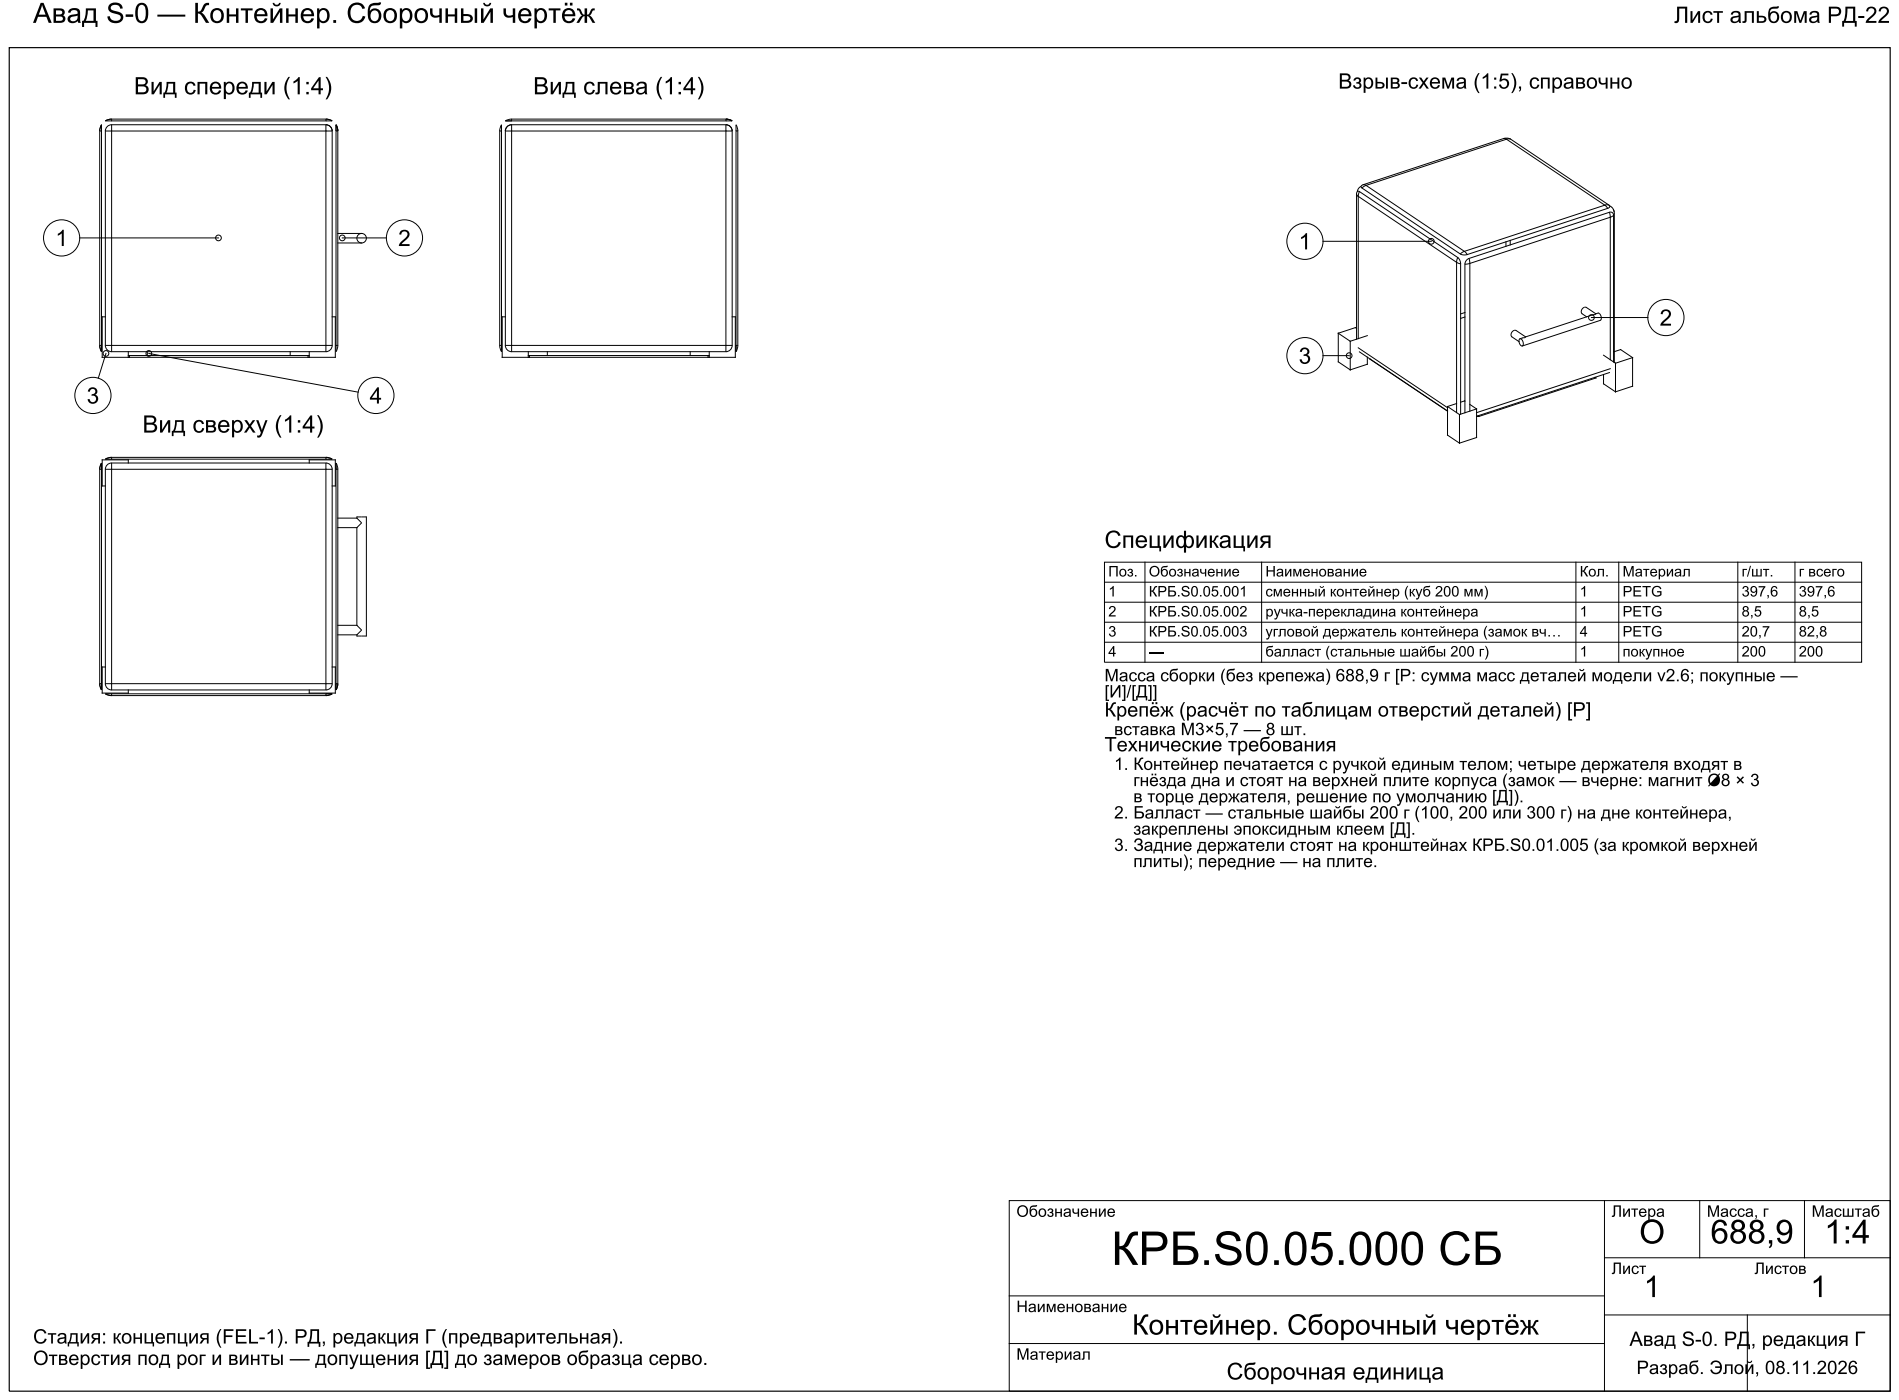
[picture p179: page 1]
