pilot443/avad-s0/electrical/EL-01_electronics-layout.pdf

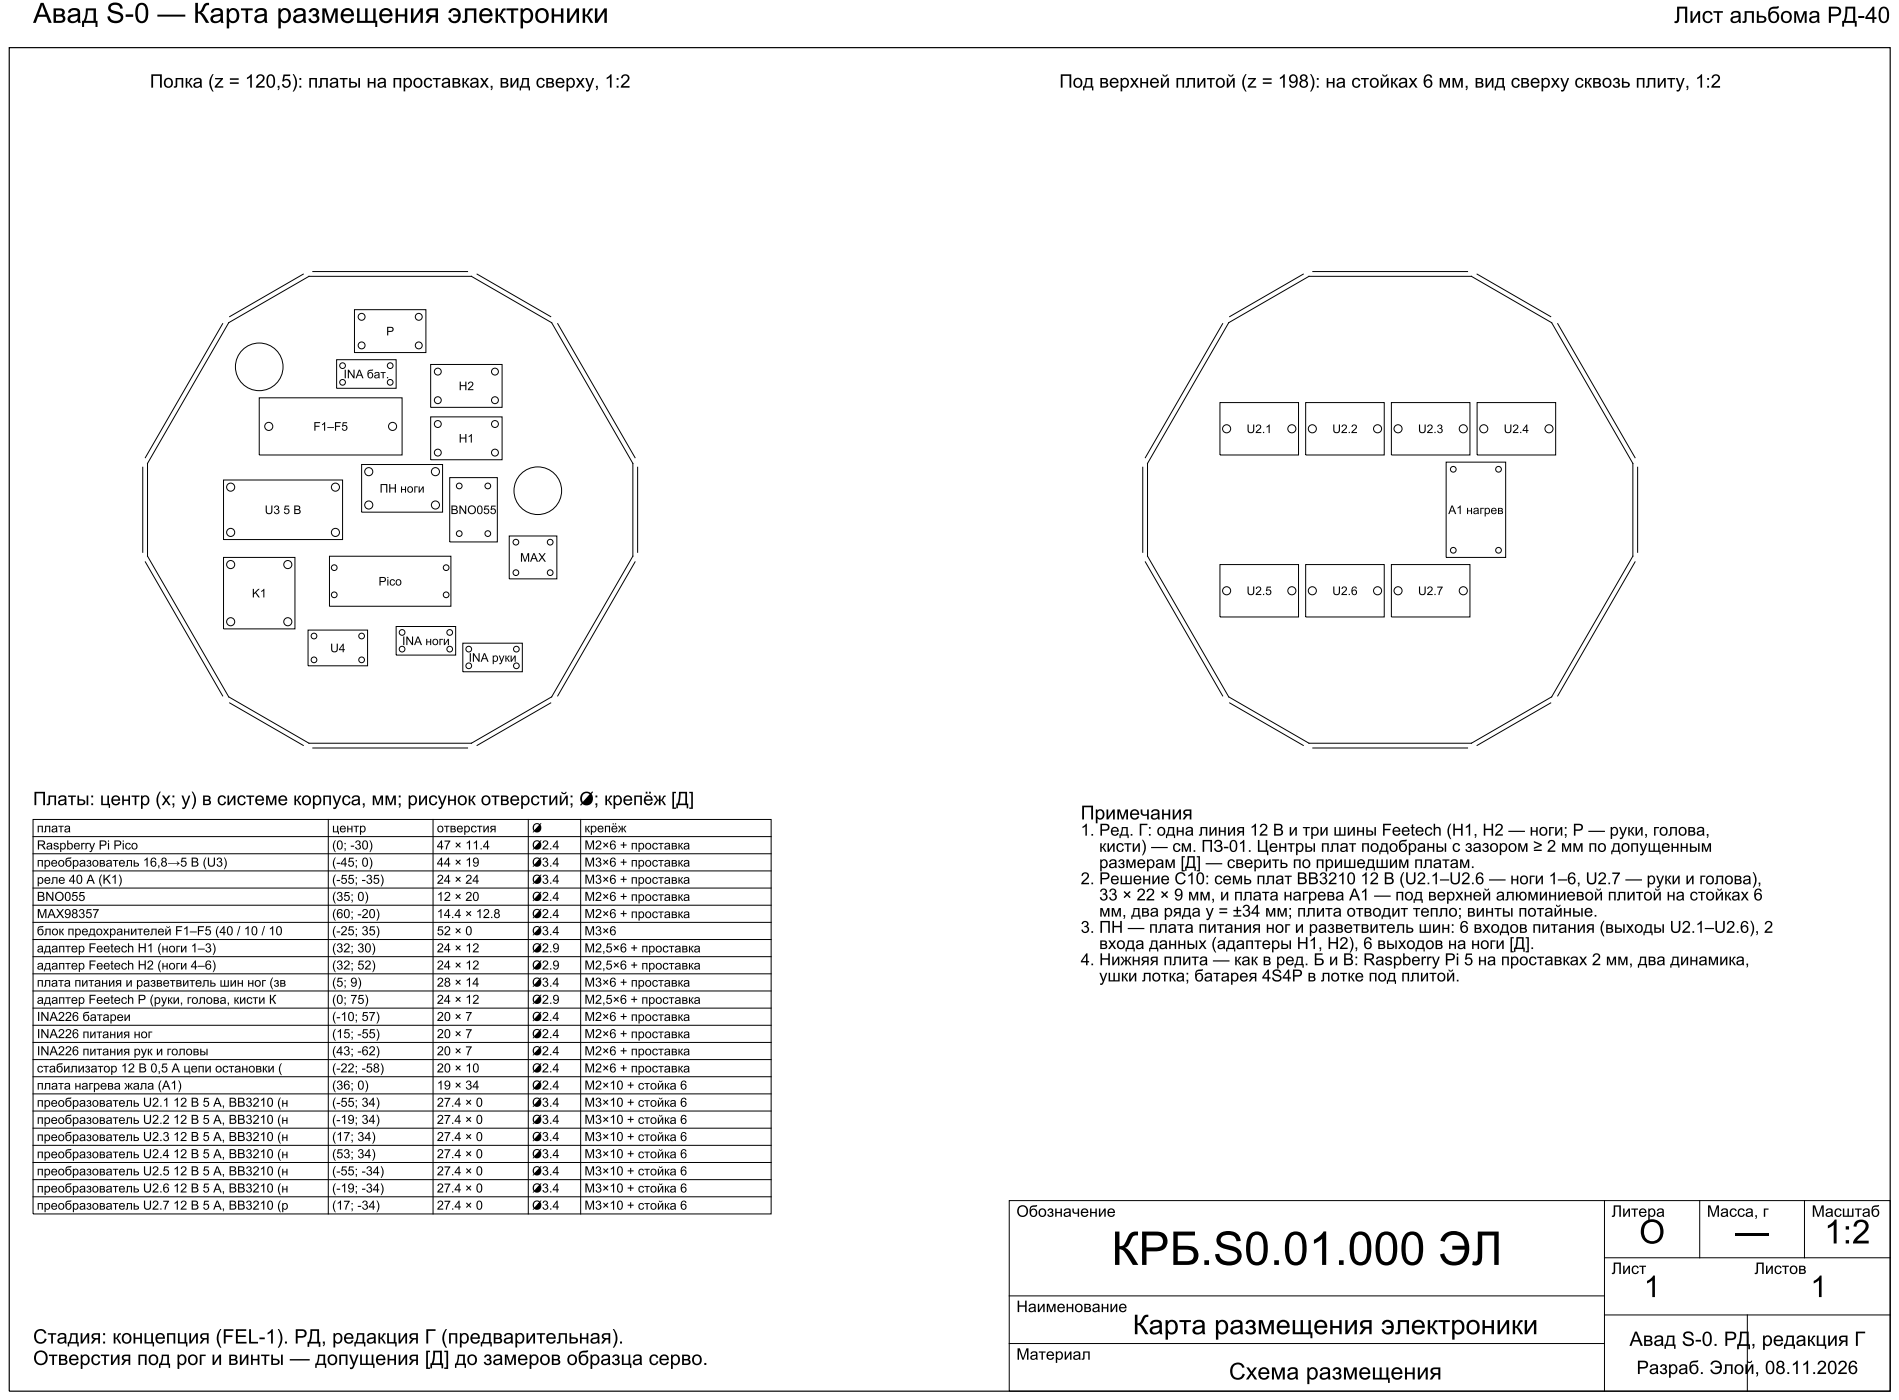
[picture p180: page 1]
