pilot443/avad-s0/electrical/MP-01_wiring-diagram.pdf

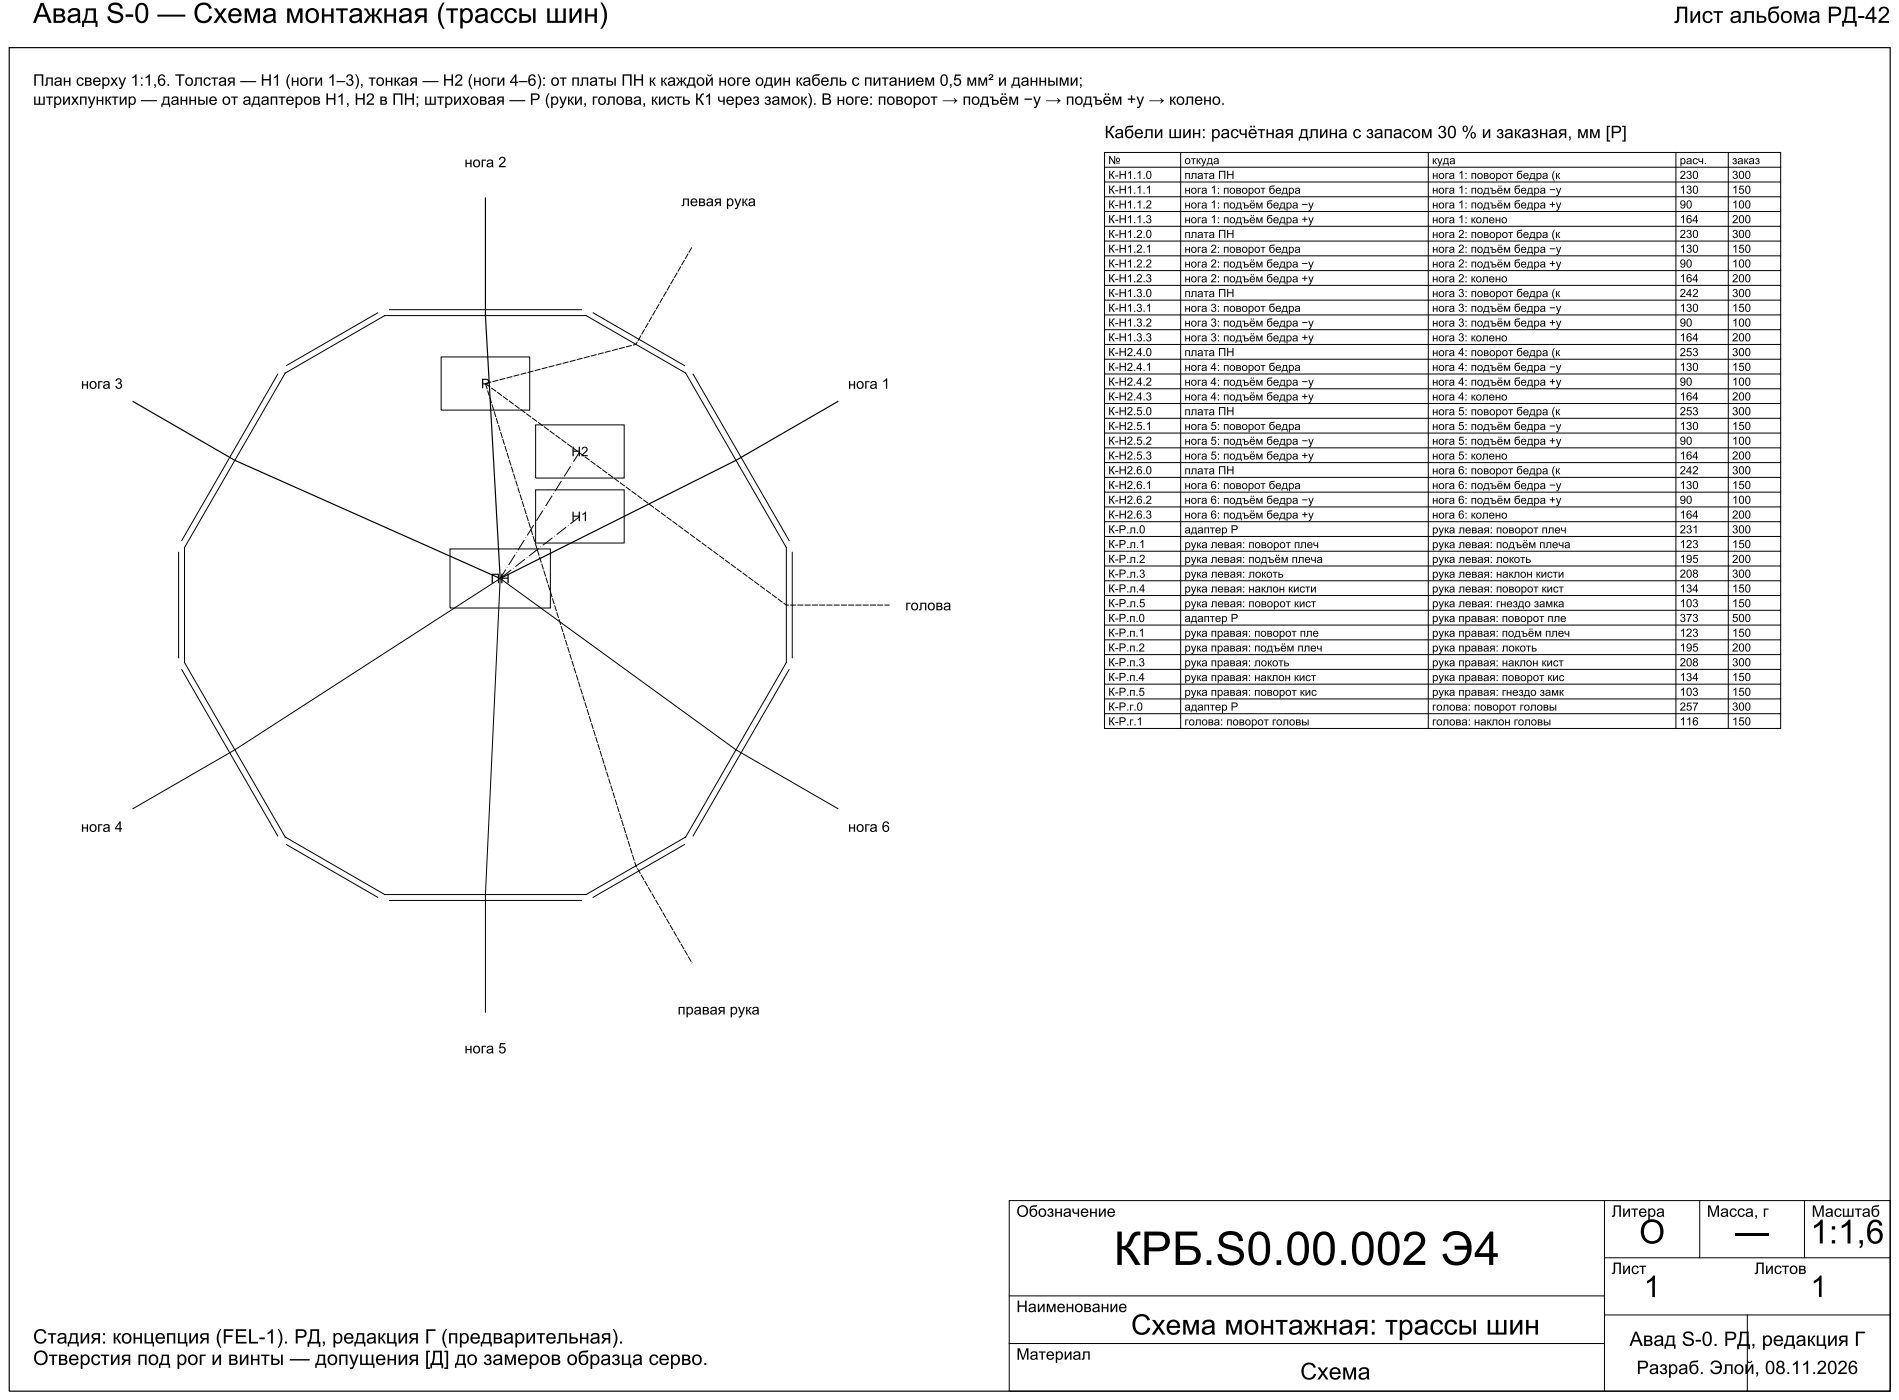
[picture p181: page 1]
