pilot443/avad-s0/electrical/PZ-01_schematic.pdf

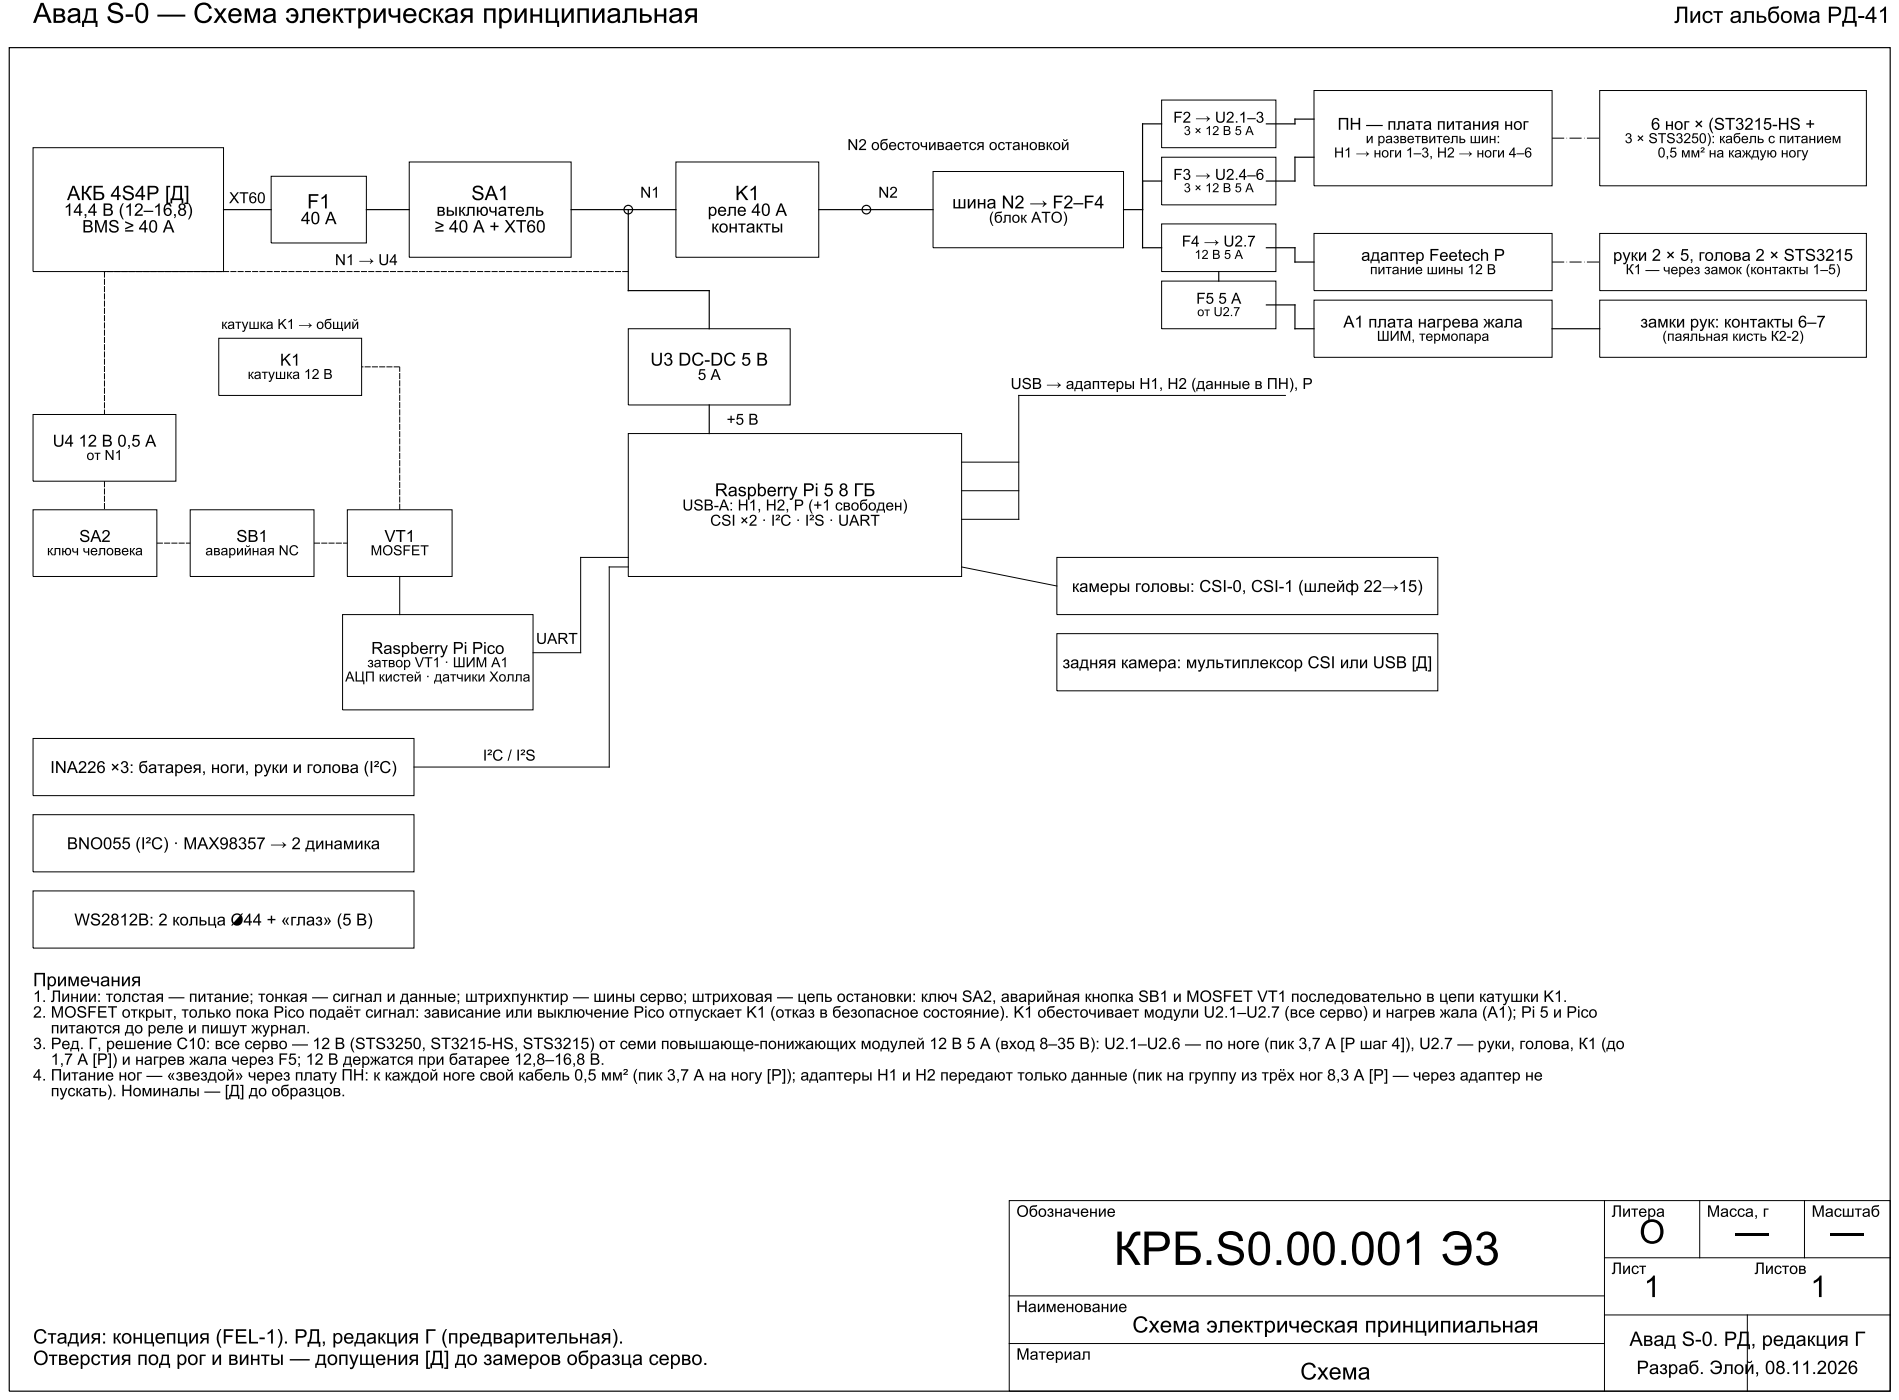
[picture p182: page 1]
