pilot443/avad-s0/parts/KRB.S0.01.001_obolochka.pdf

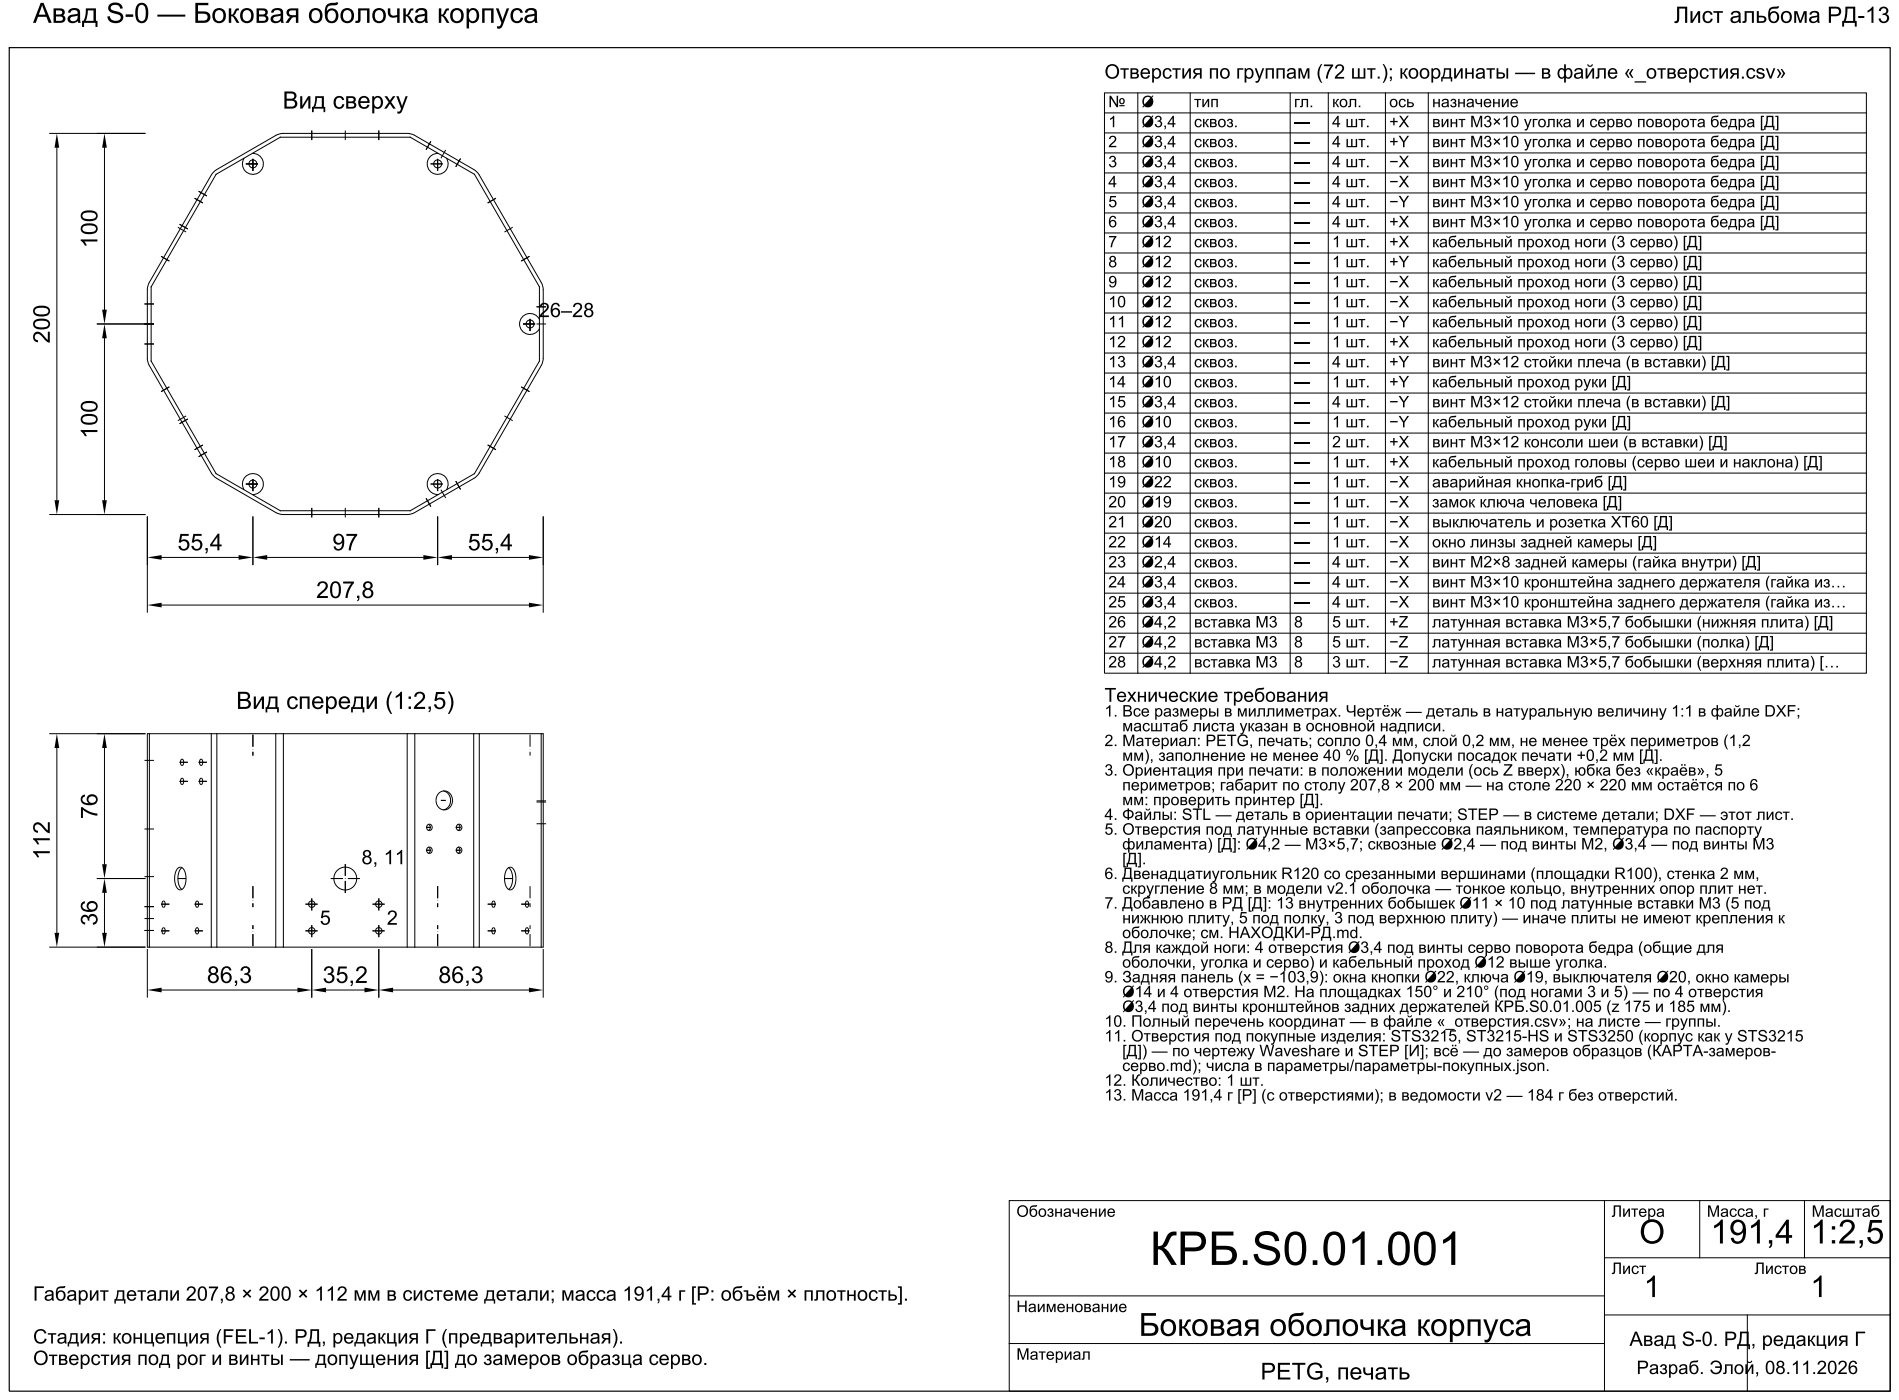
[picture p183: page 1]
