pilot443/avad-s0/parts/KRB.S0.01.003_plita-verhnyaya.pdf

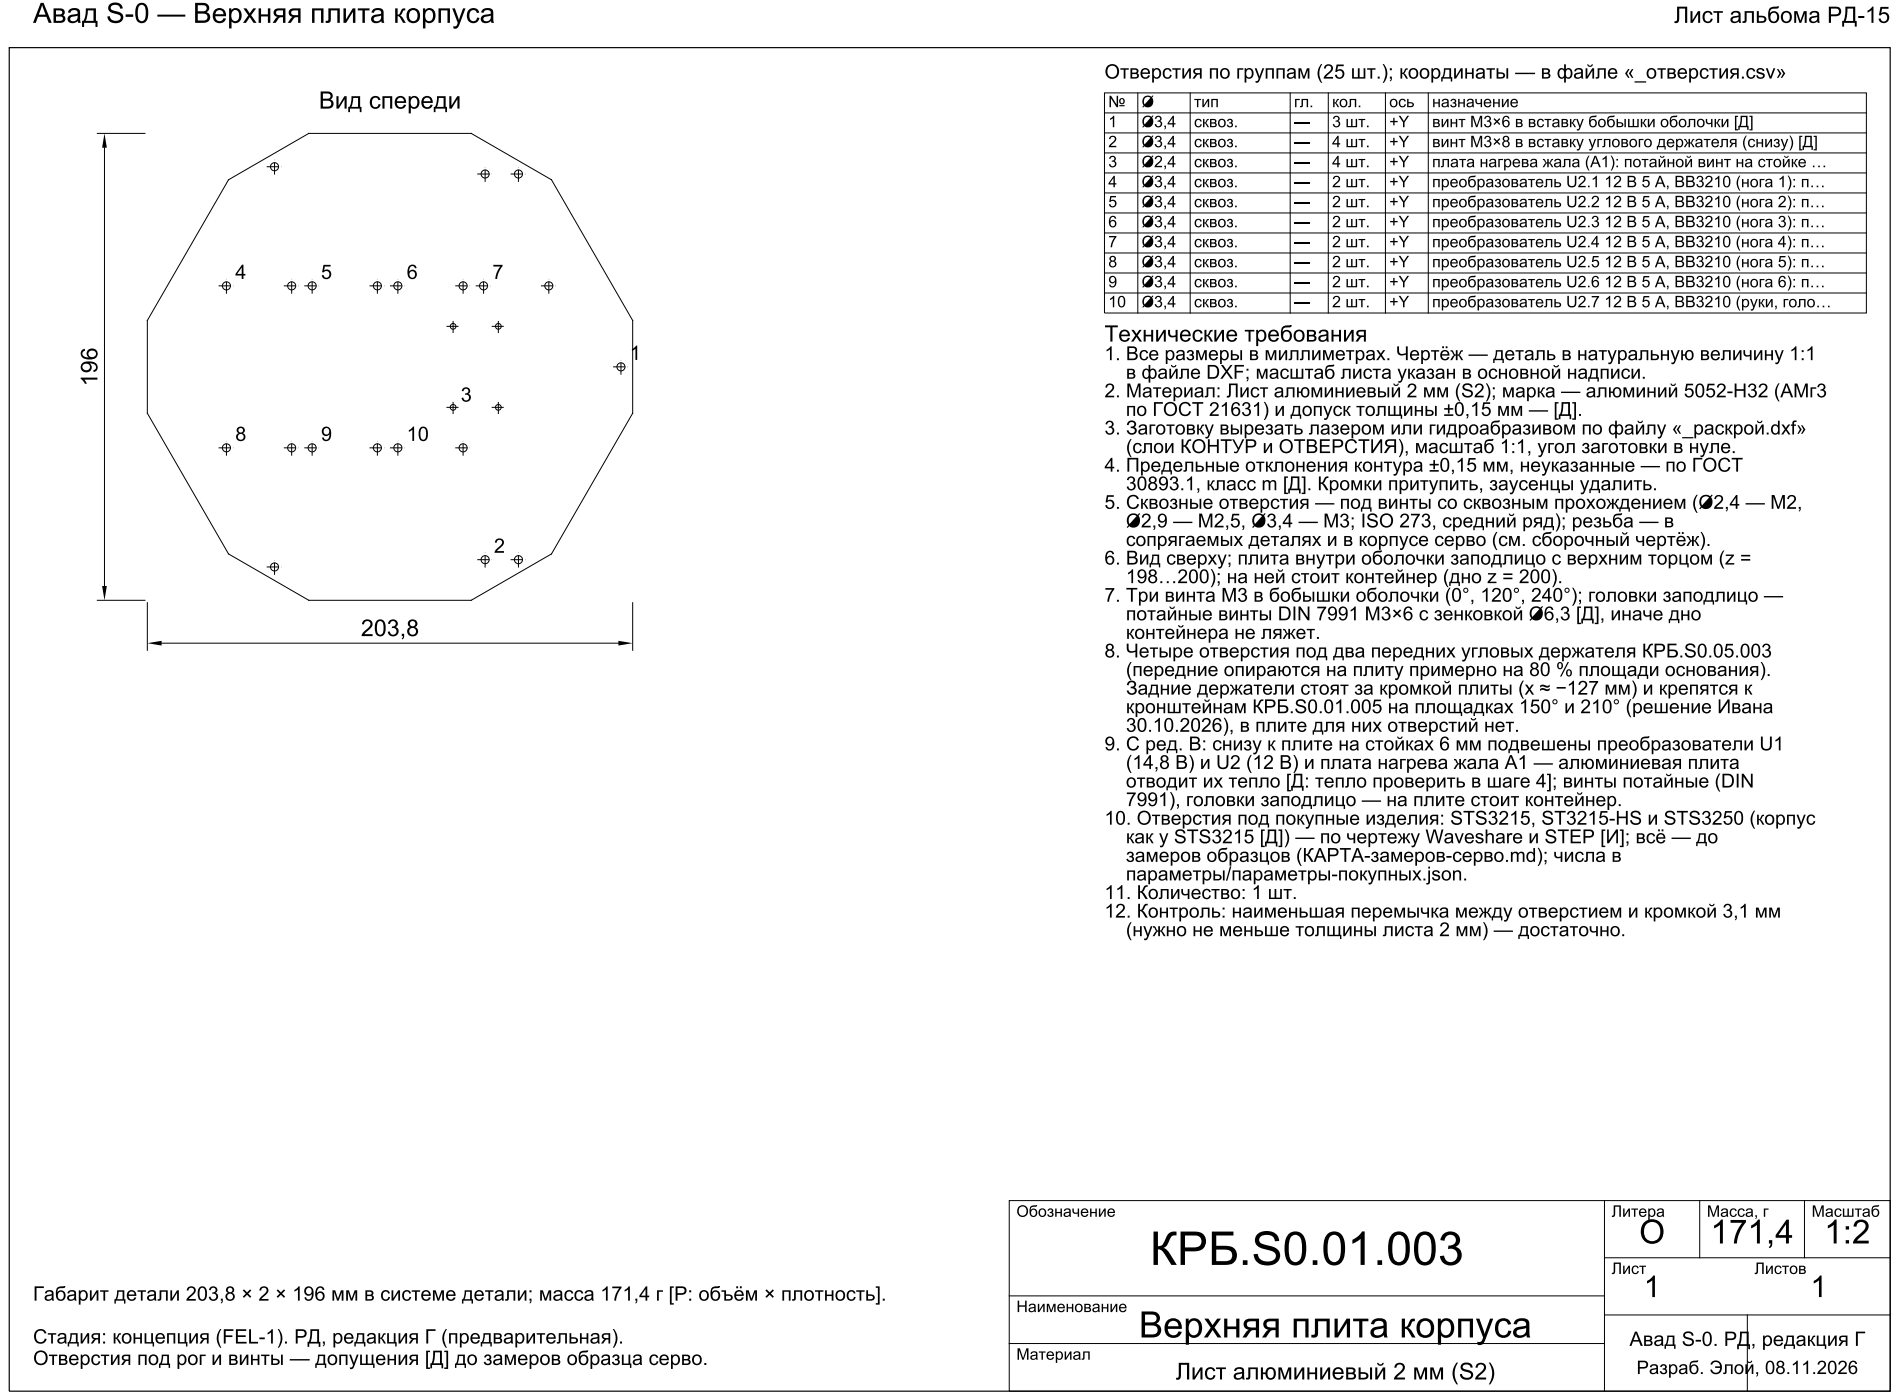
[picture p185: page 1]
