pilot443/avad-s0/parts/KRB.S0.01.004_polka-elektroniki.pdf

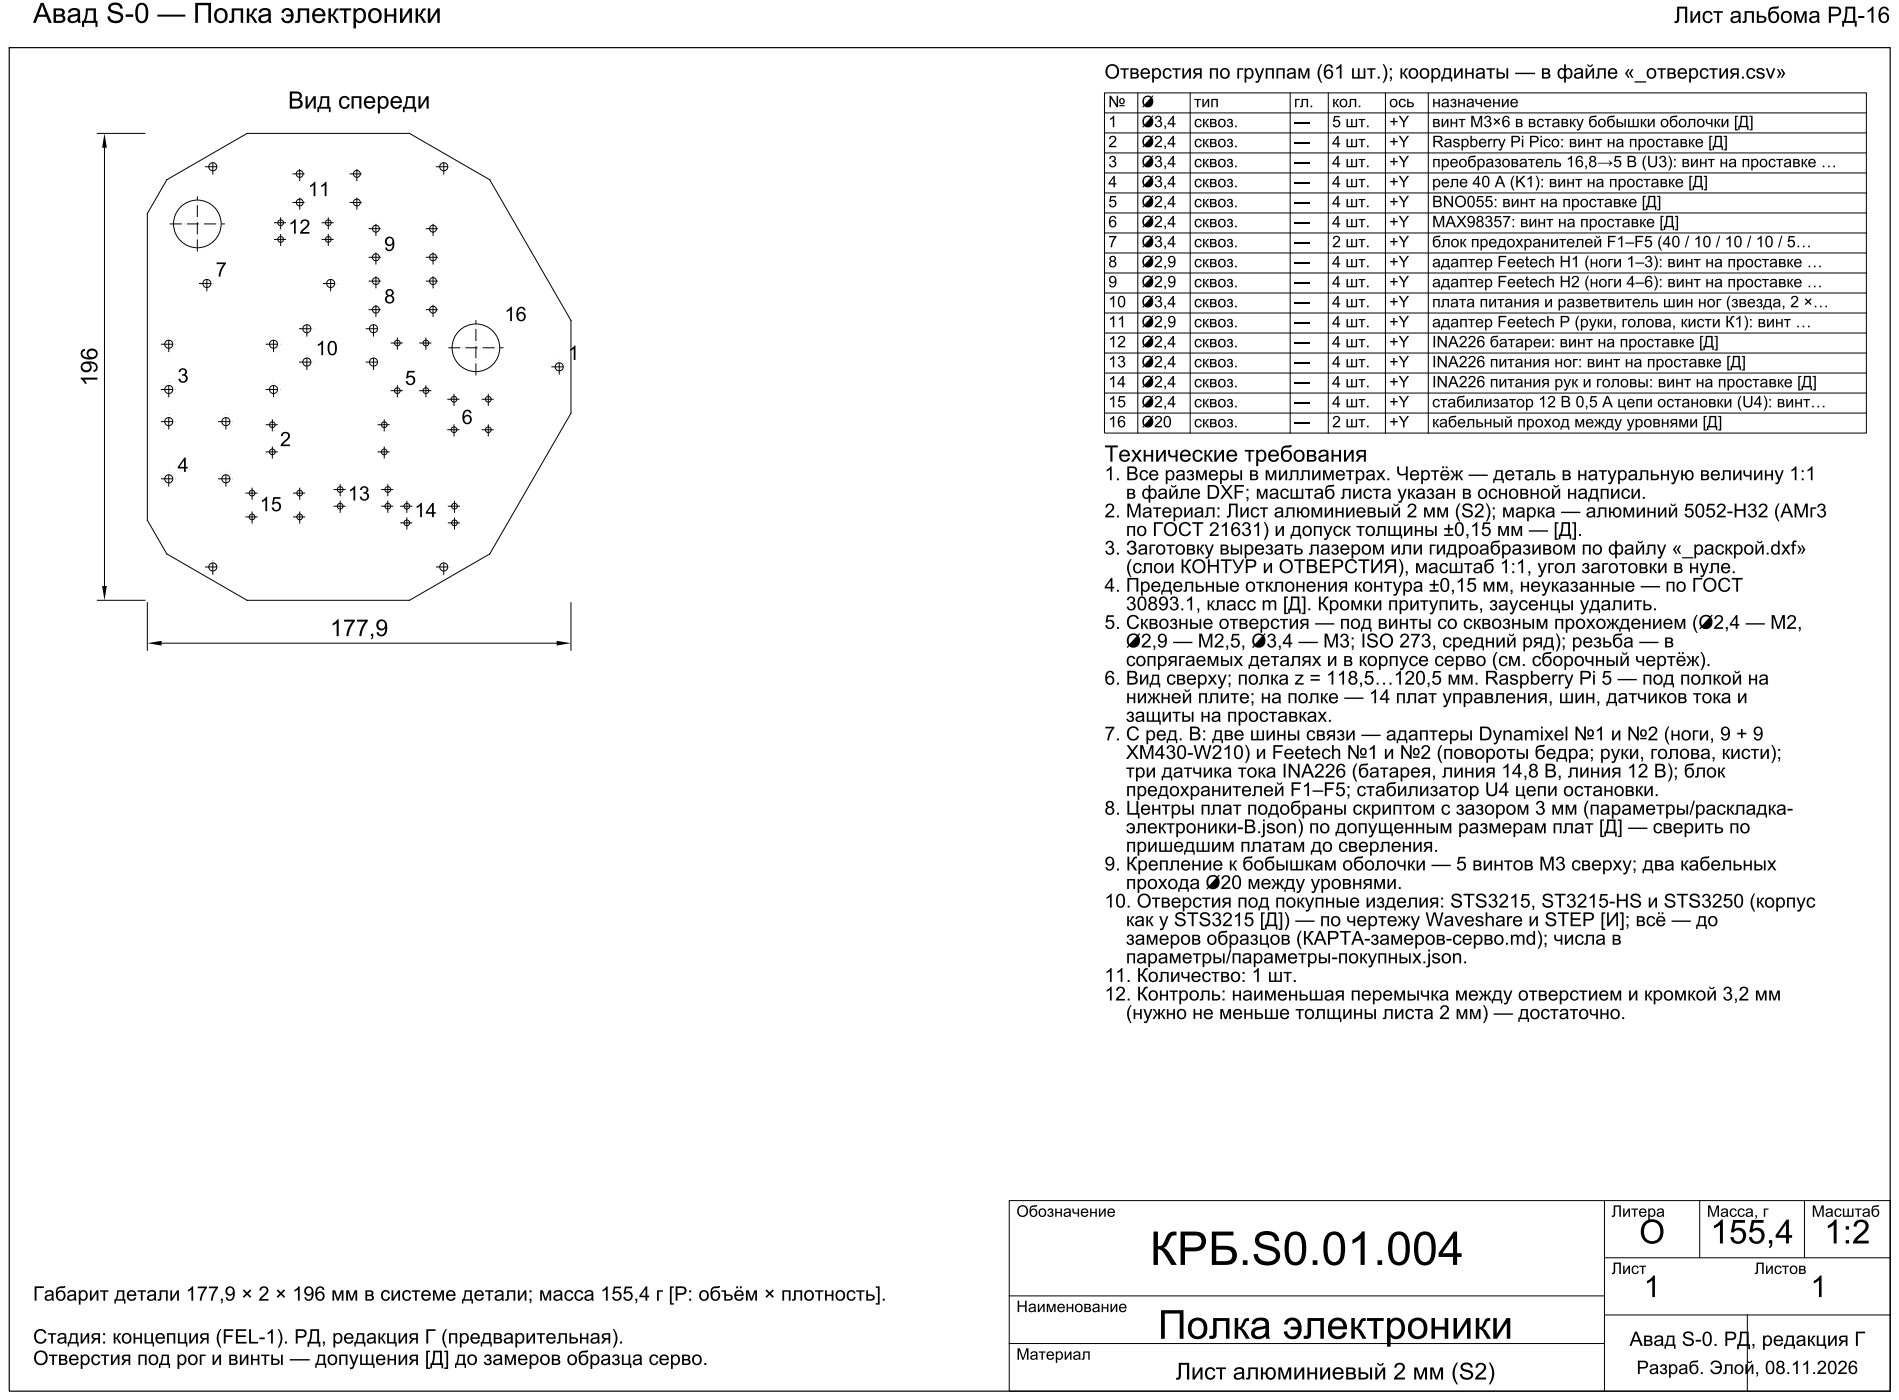
[picture p186: page 1]
