pilot443/avad-s0/parts/KRB.S0.01.005_razvertka.pdf

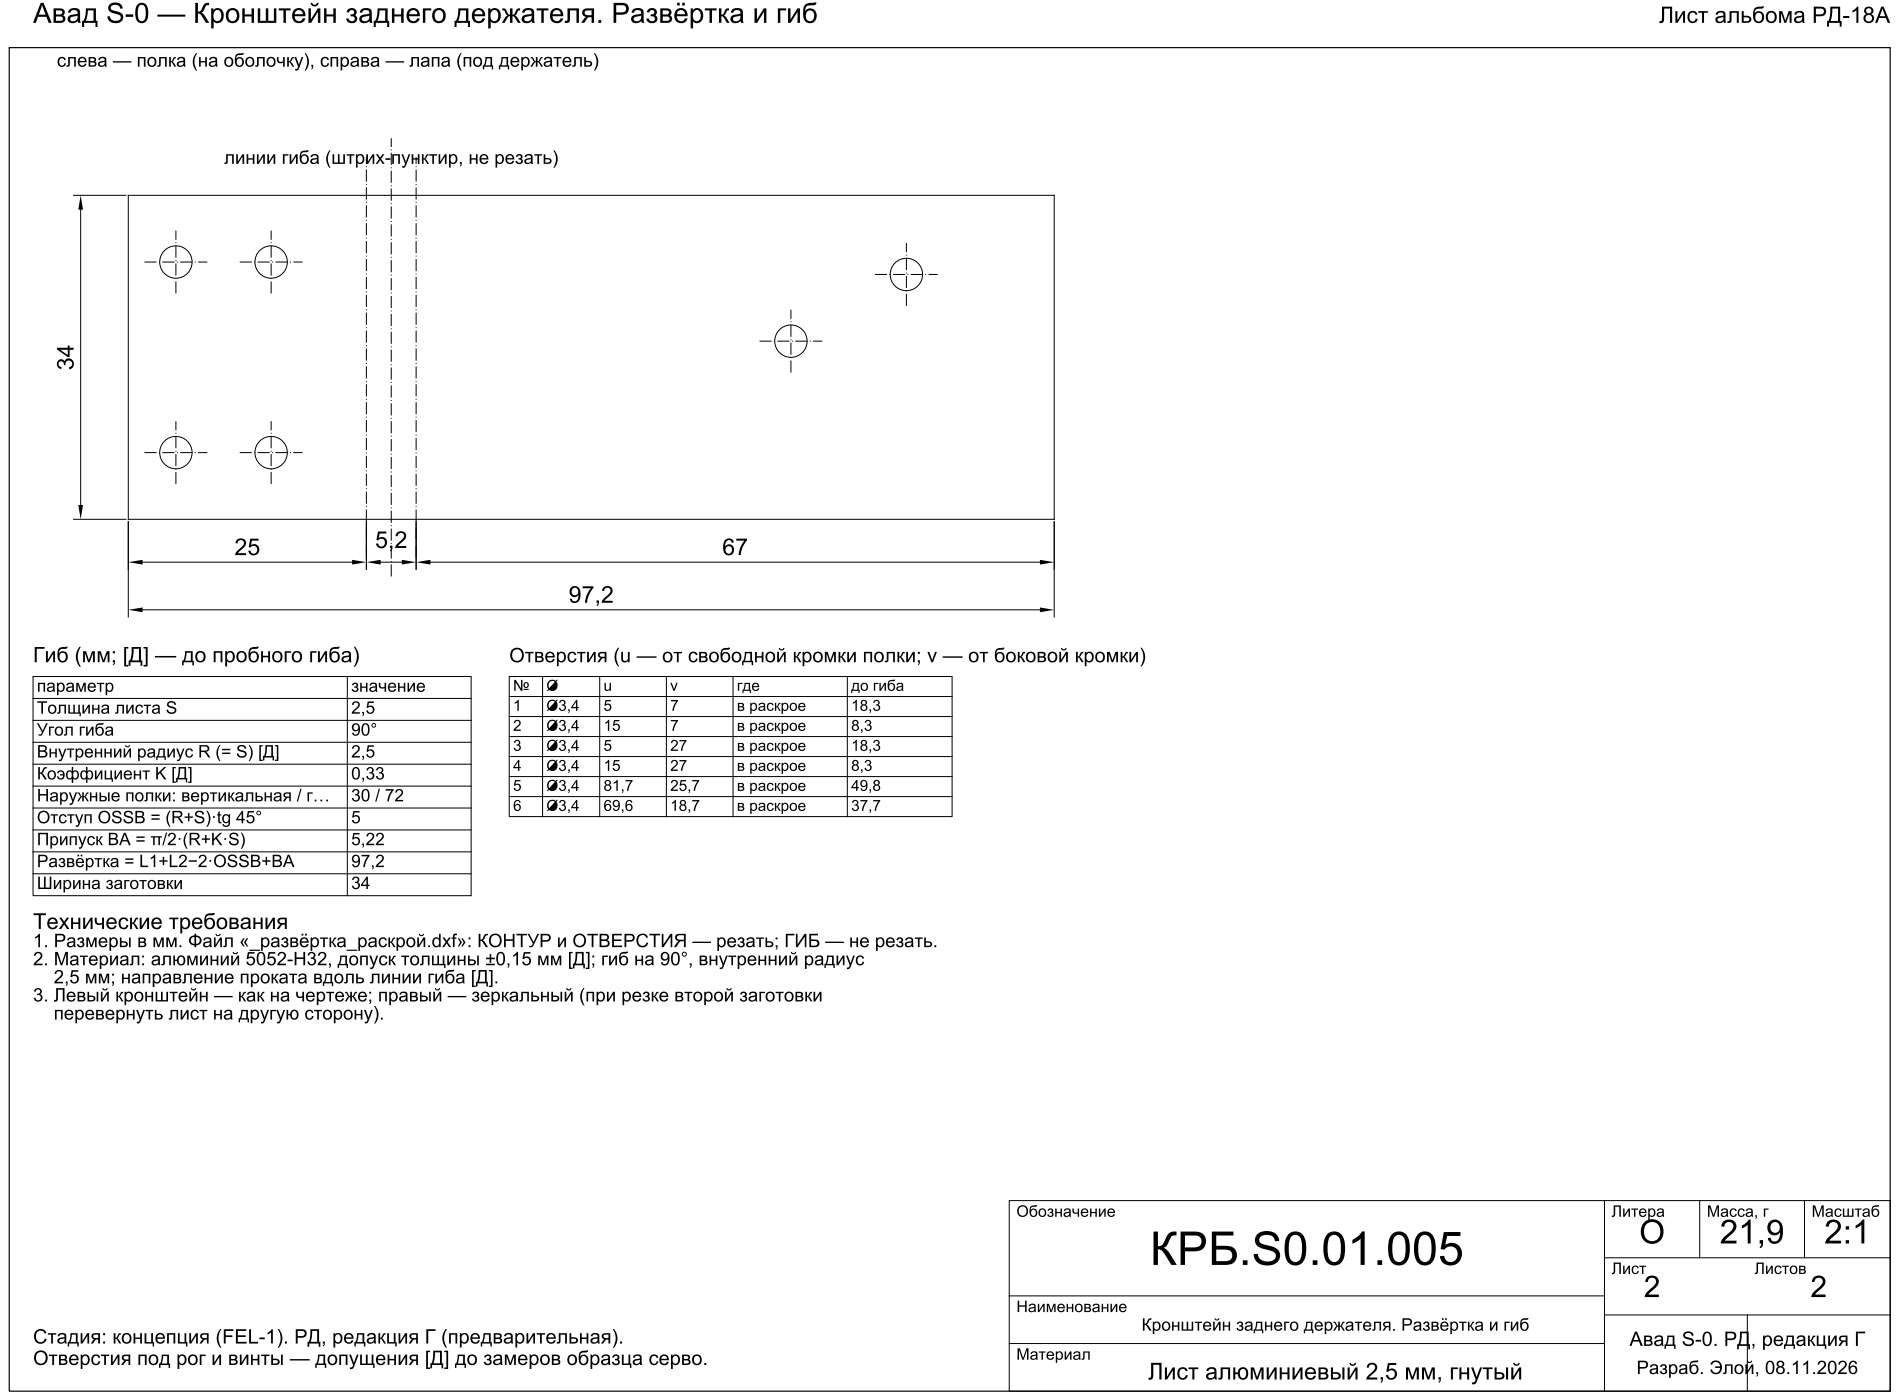
[picture p188: page 1]
