pilot443/avad-s0/parts/KRB.S0.02.001_ugolok-povorota-bedra.pdf

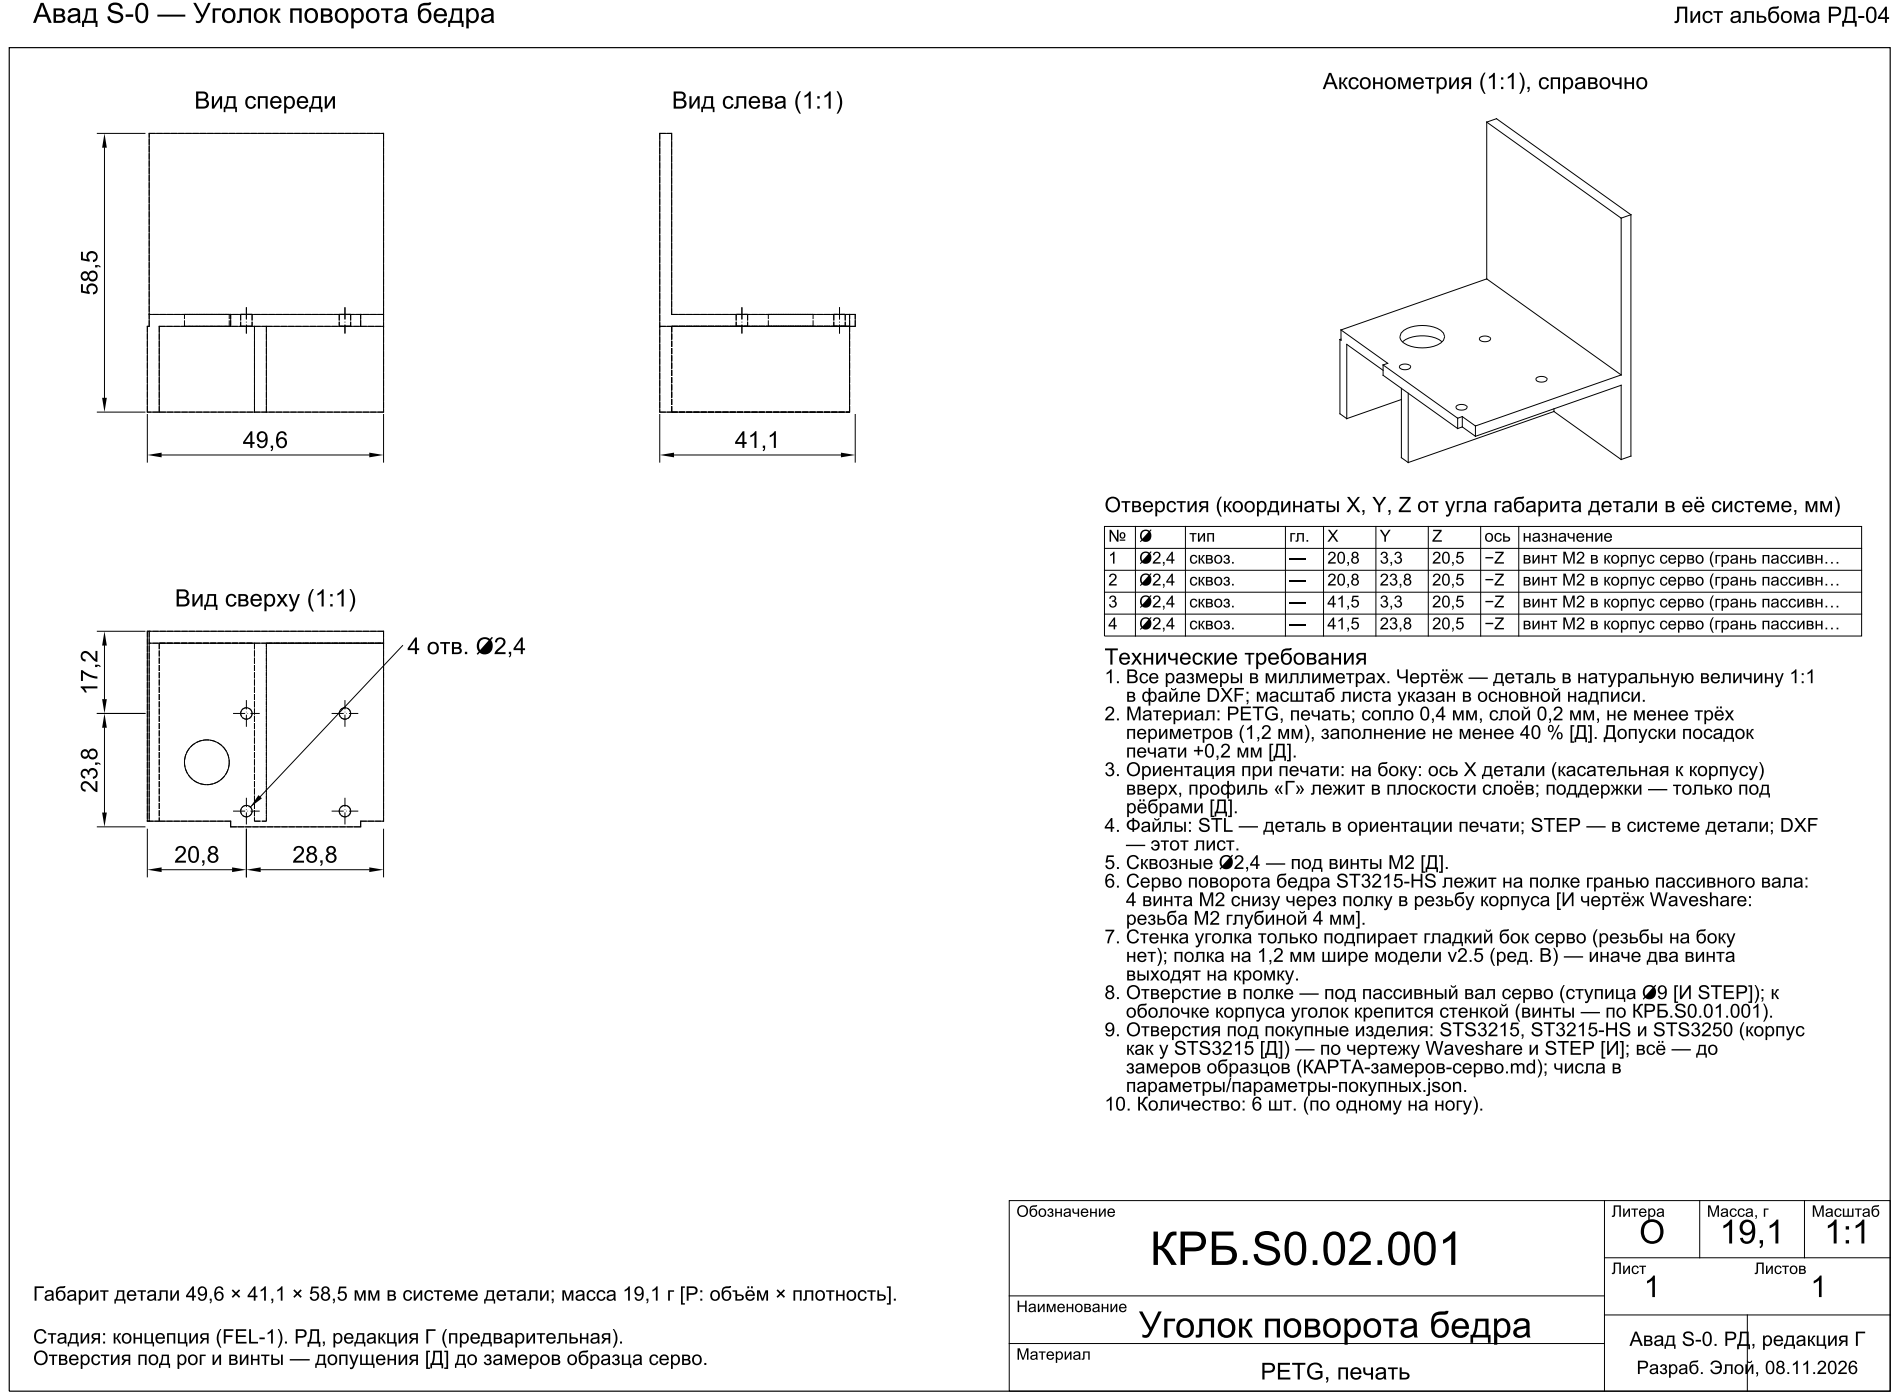
[picture p189: page 1]
