pilot443/avad-s0/parts/KRB.S0.02.002_razvertka.pdf

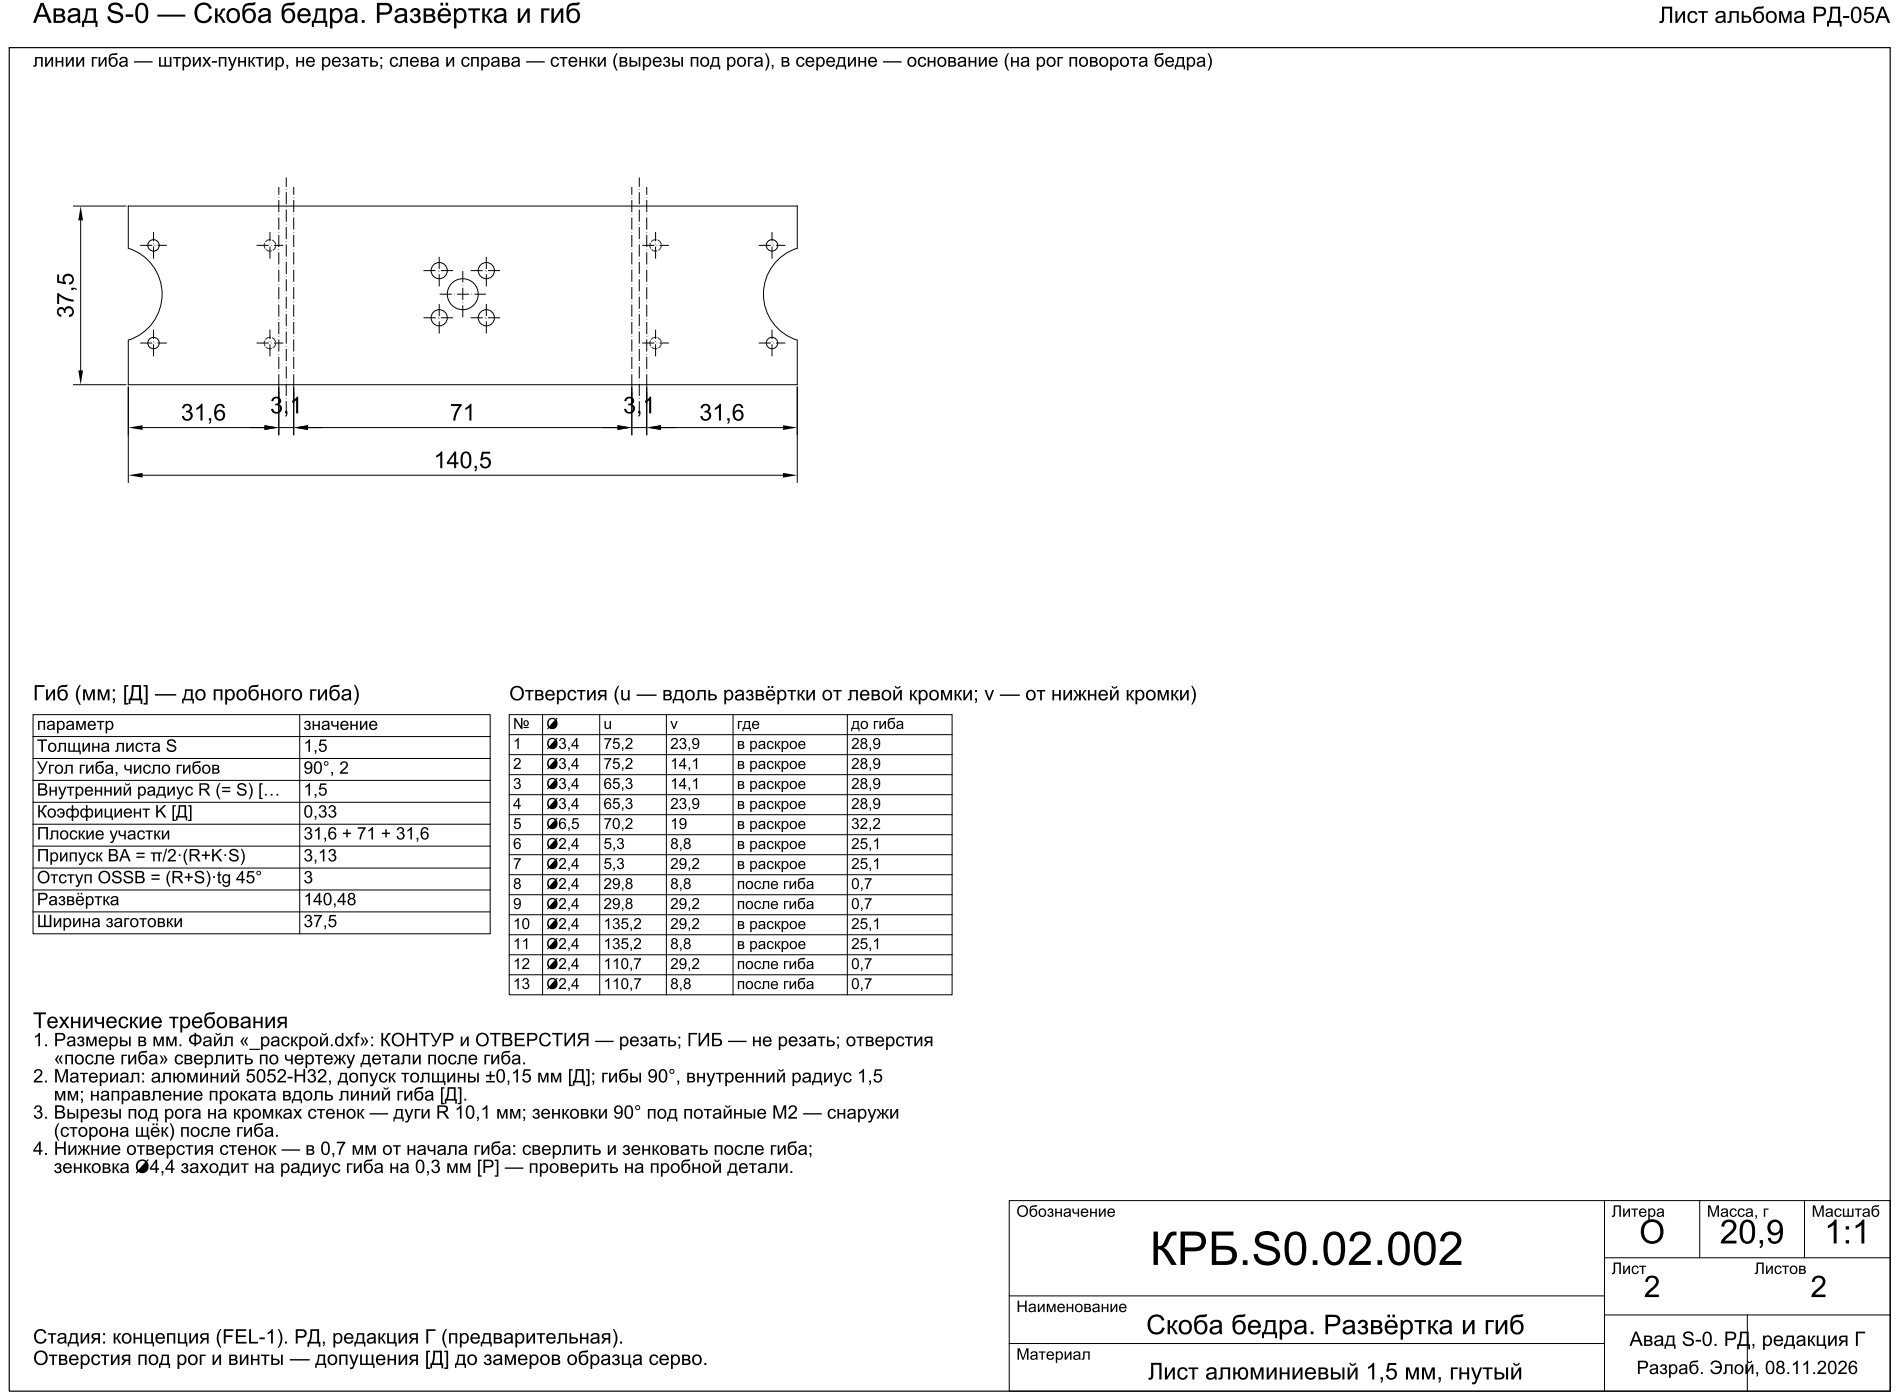
[picture p190: page 1]
