pilot443/avad-s0/parts/KRB.S0.02.002_skoba-bedra.pdf

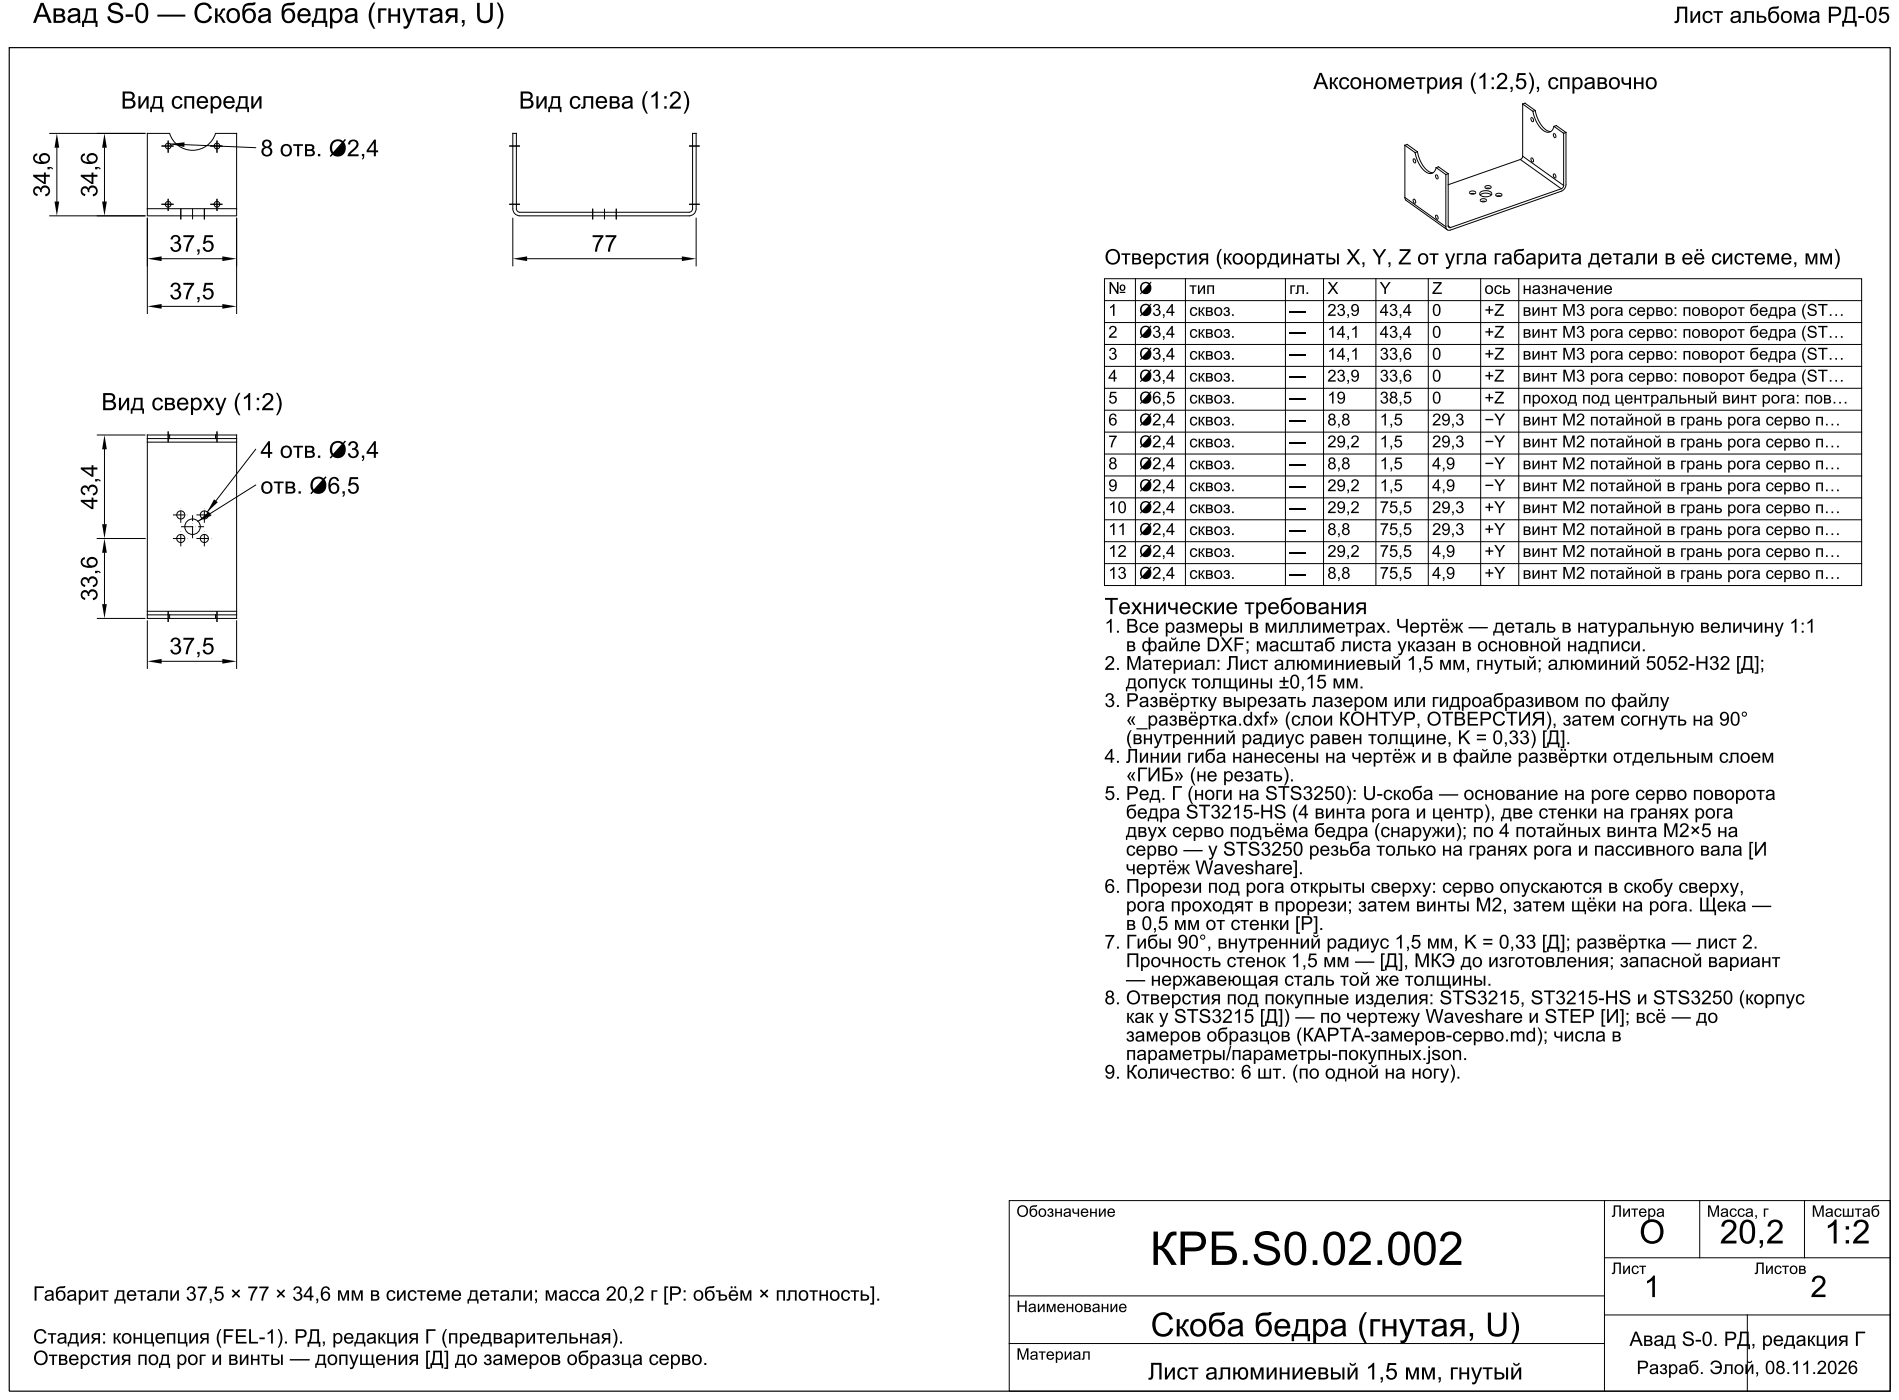
[picture p191: page 1]
