pilot443/avad-s0/parts/KRB.S0.02.003_shcheka-bedra.pdf

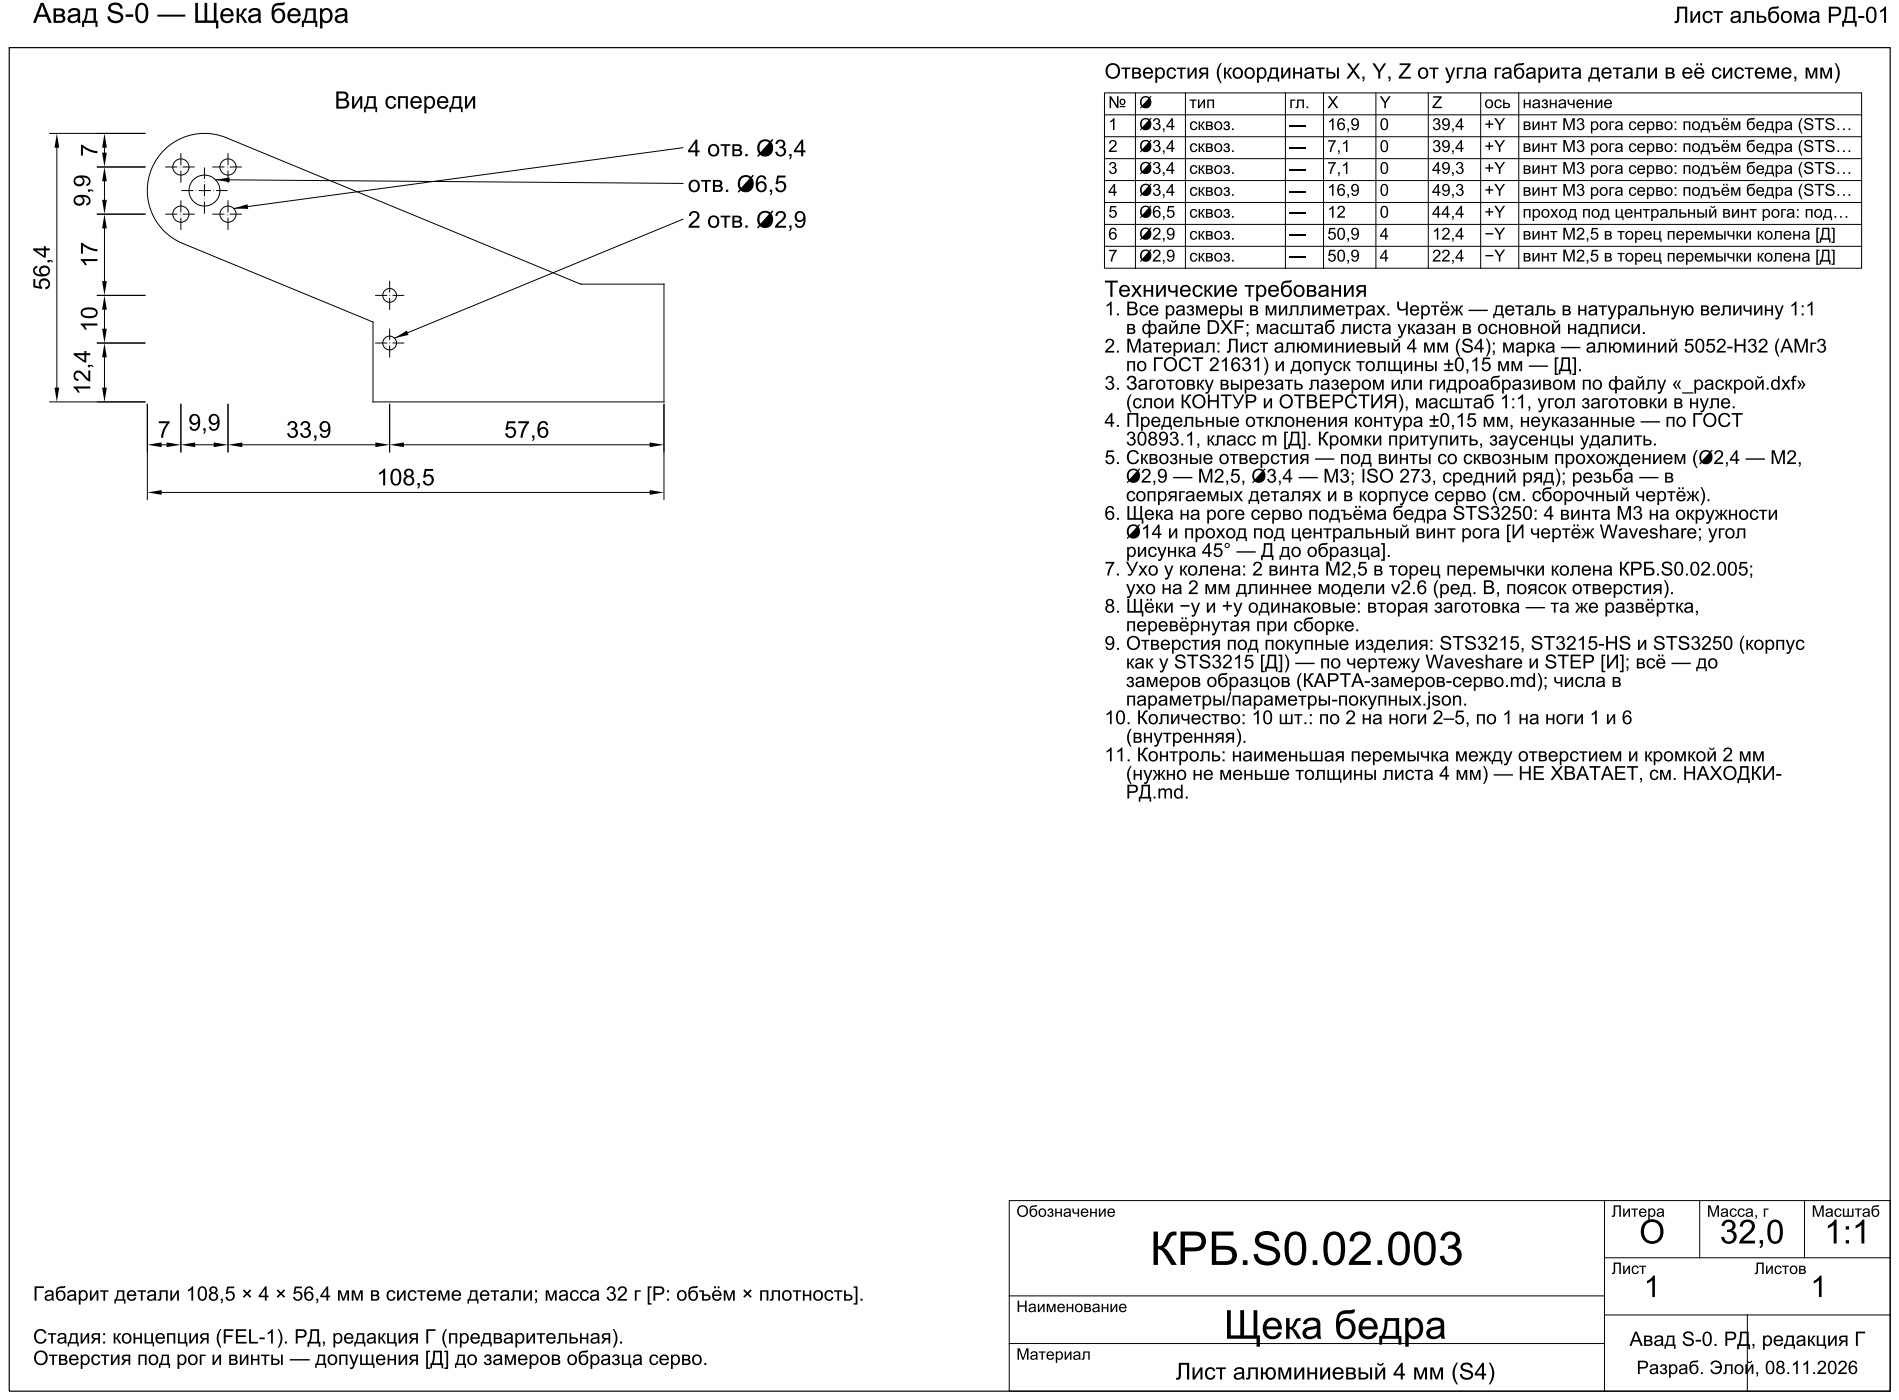
[picture p192: page 1]
