pilot443/avad-s0/parts/KRB.S0.02.004_shcheka-bedra-korotkaya.pdf

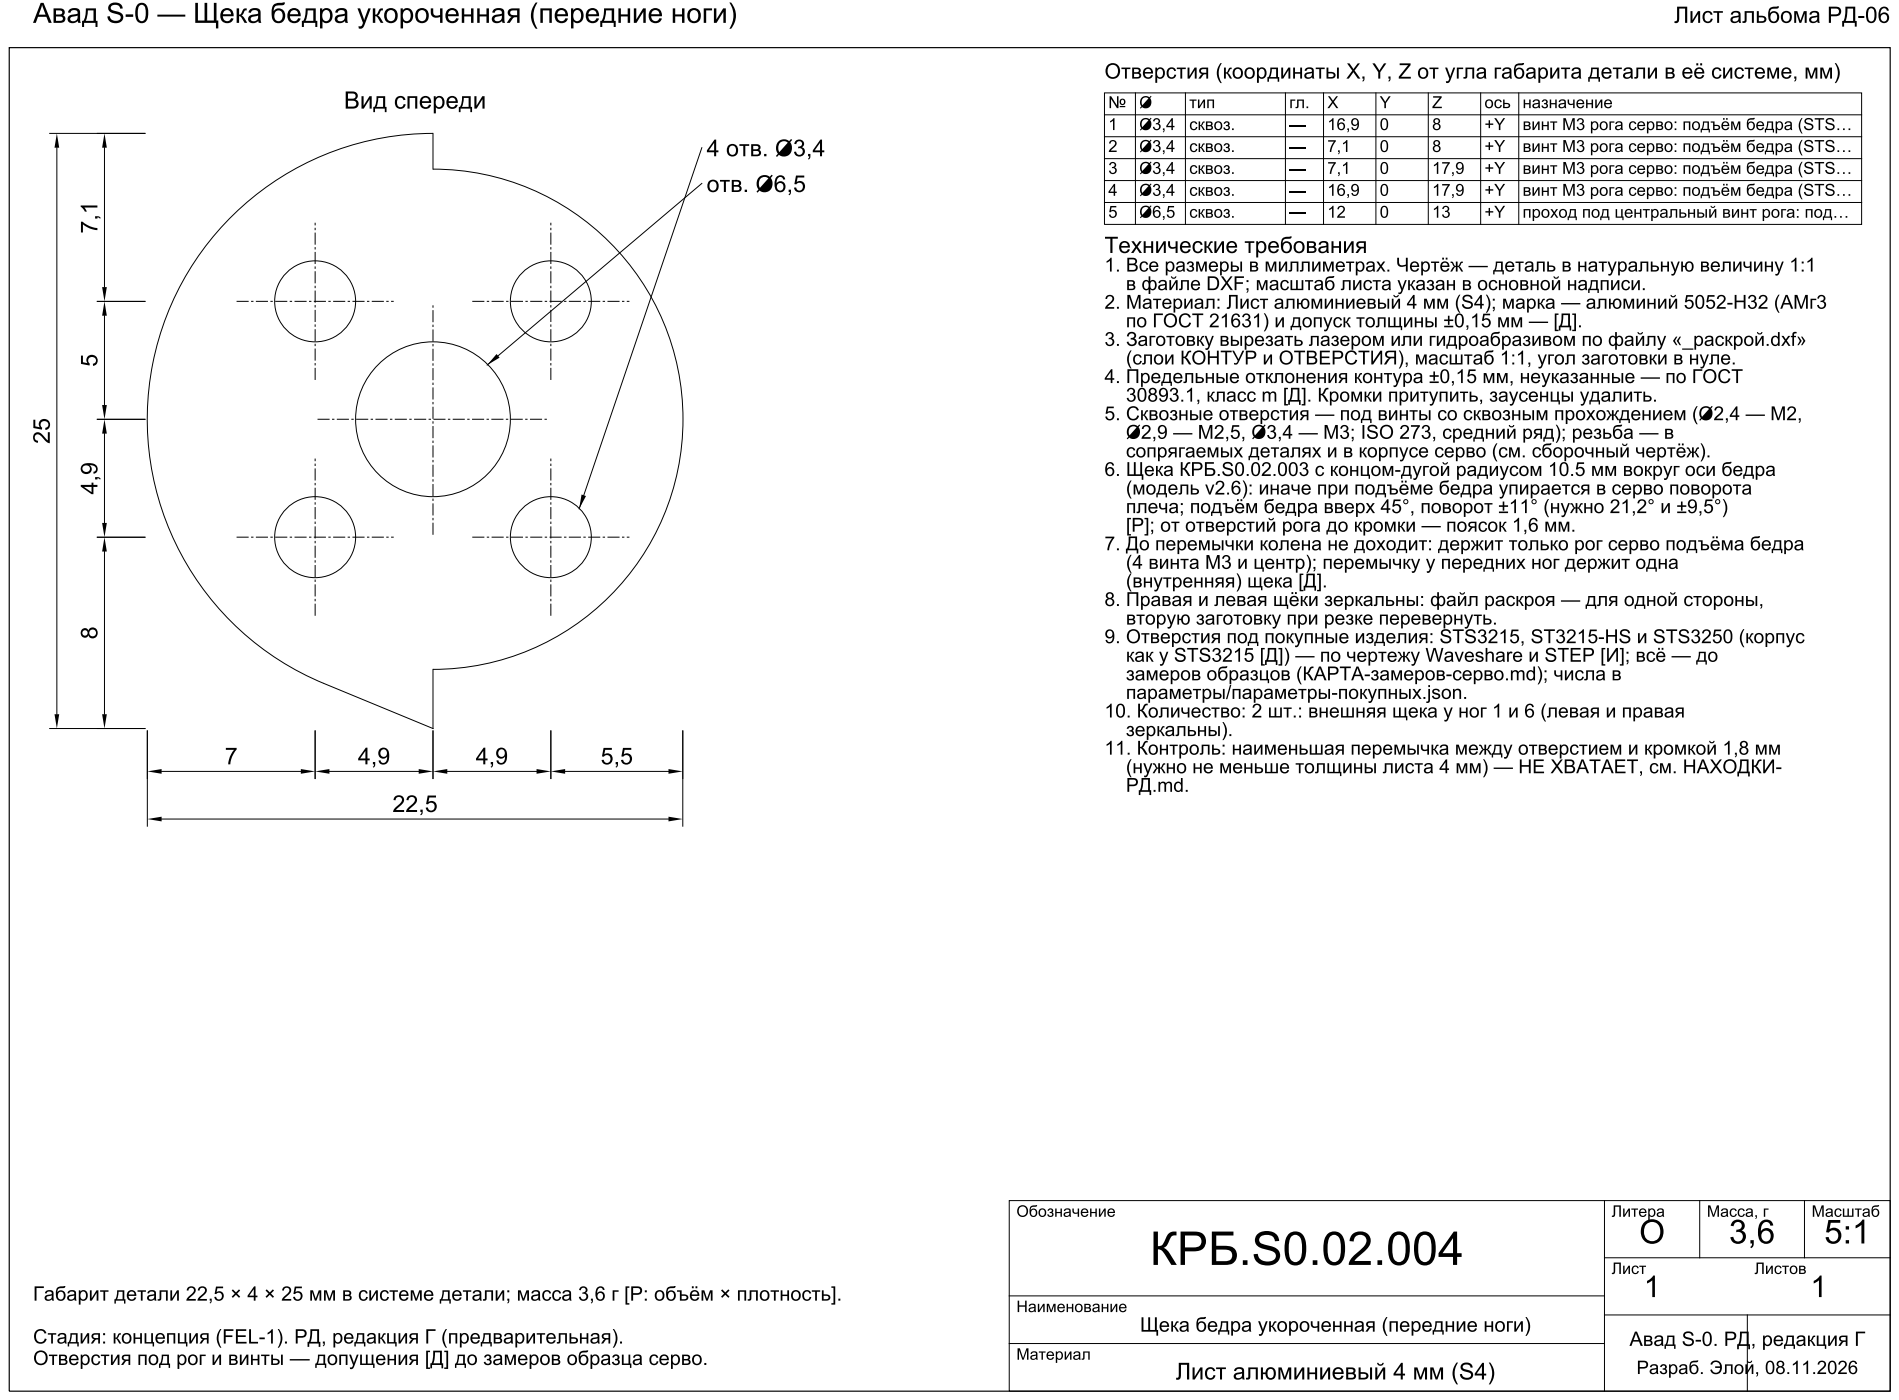
[picture p193: page 1]
