pilot443/avad-s0/parts/KRB.S0.02.005_peremychka-kolena.pdf

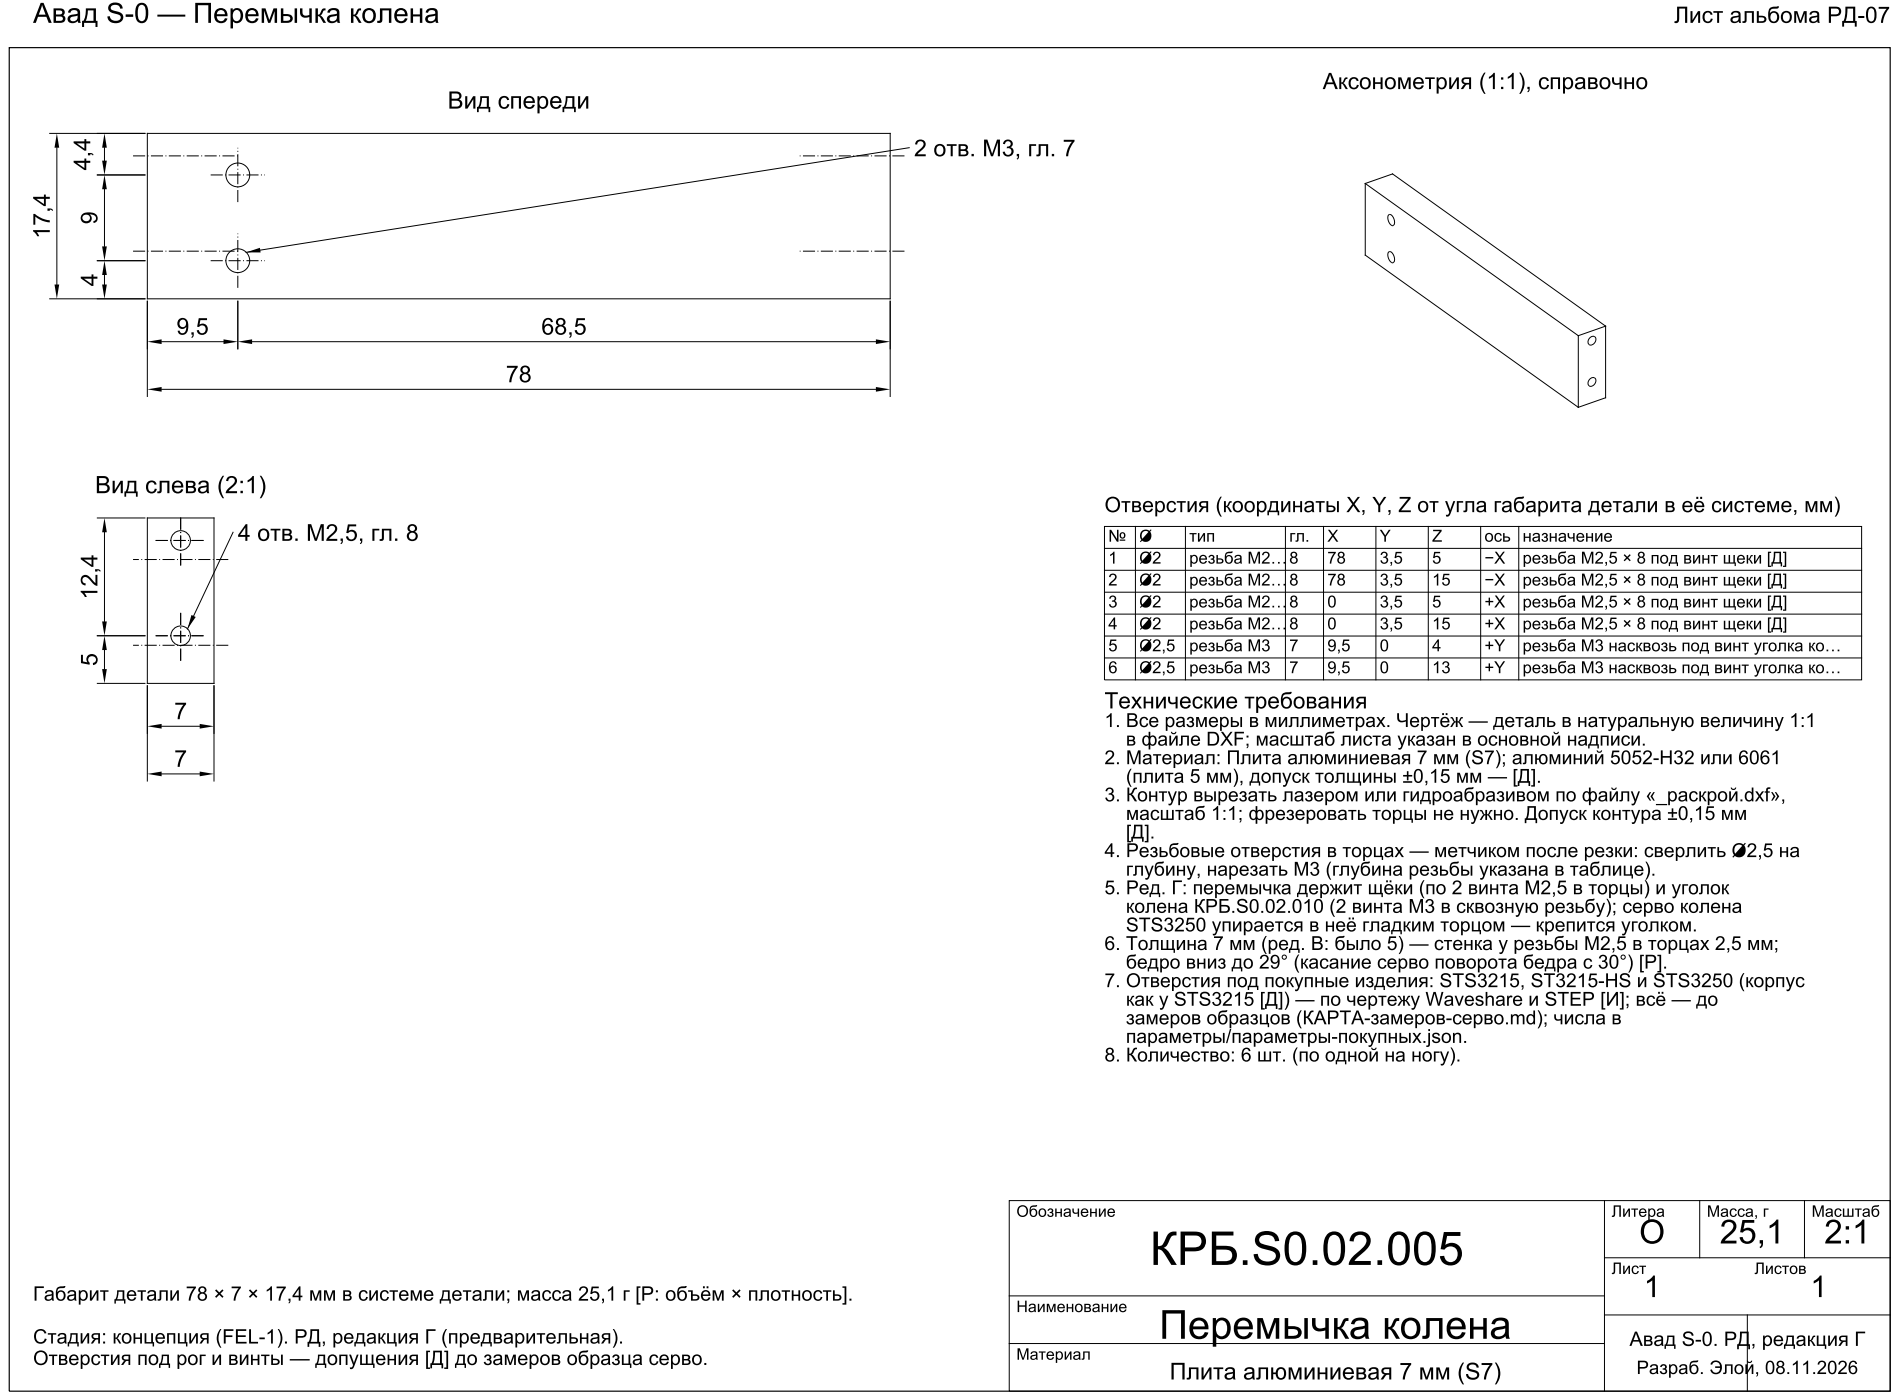
[picture p194: page 1]
