pilot443/avad-s0/parts/KRB.S0.02.006_golen.pdf

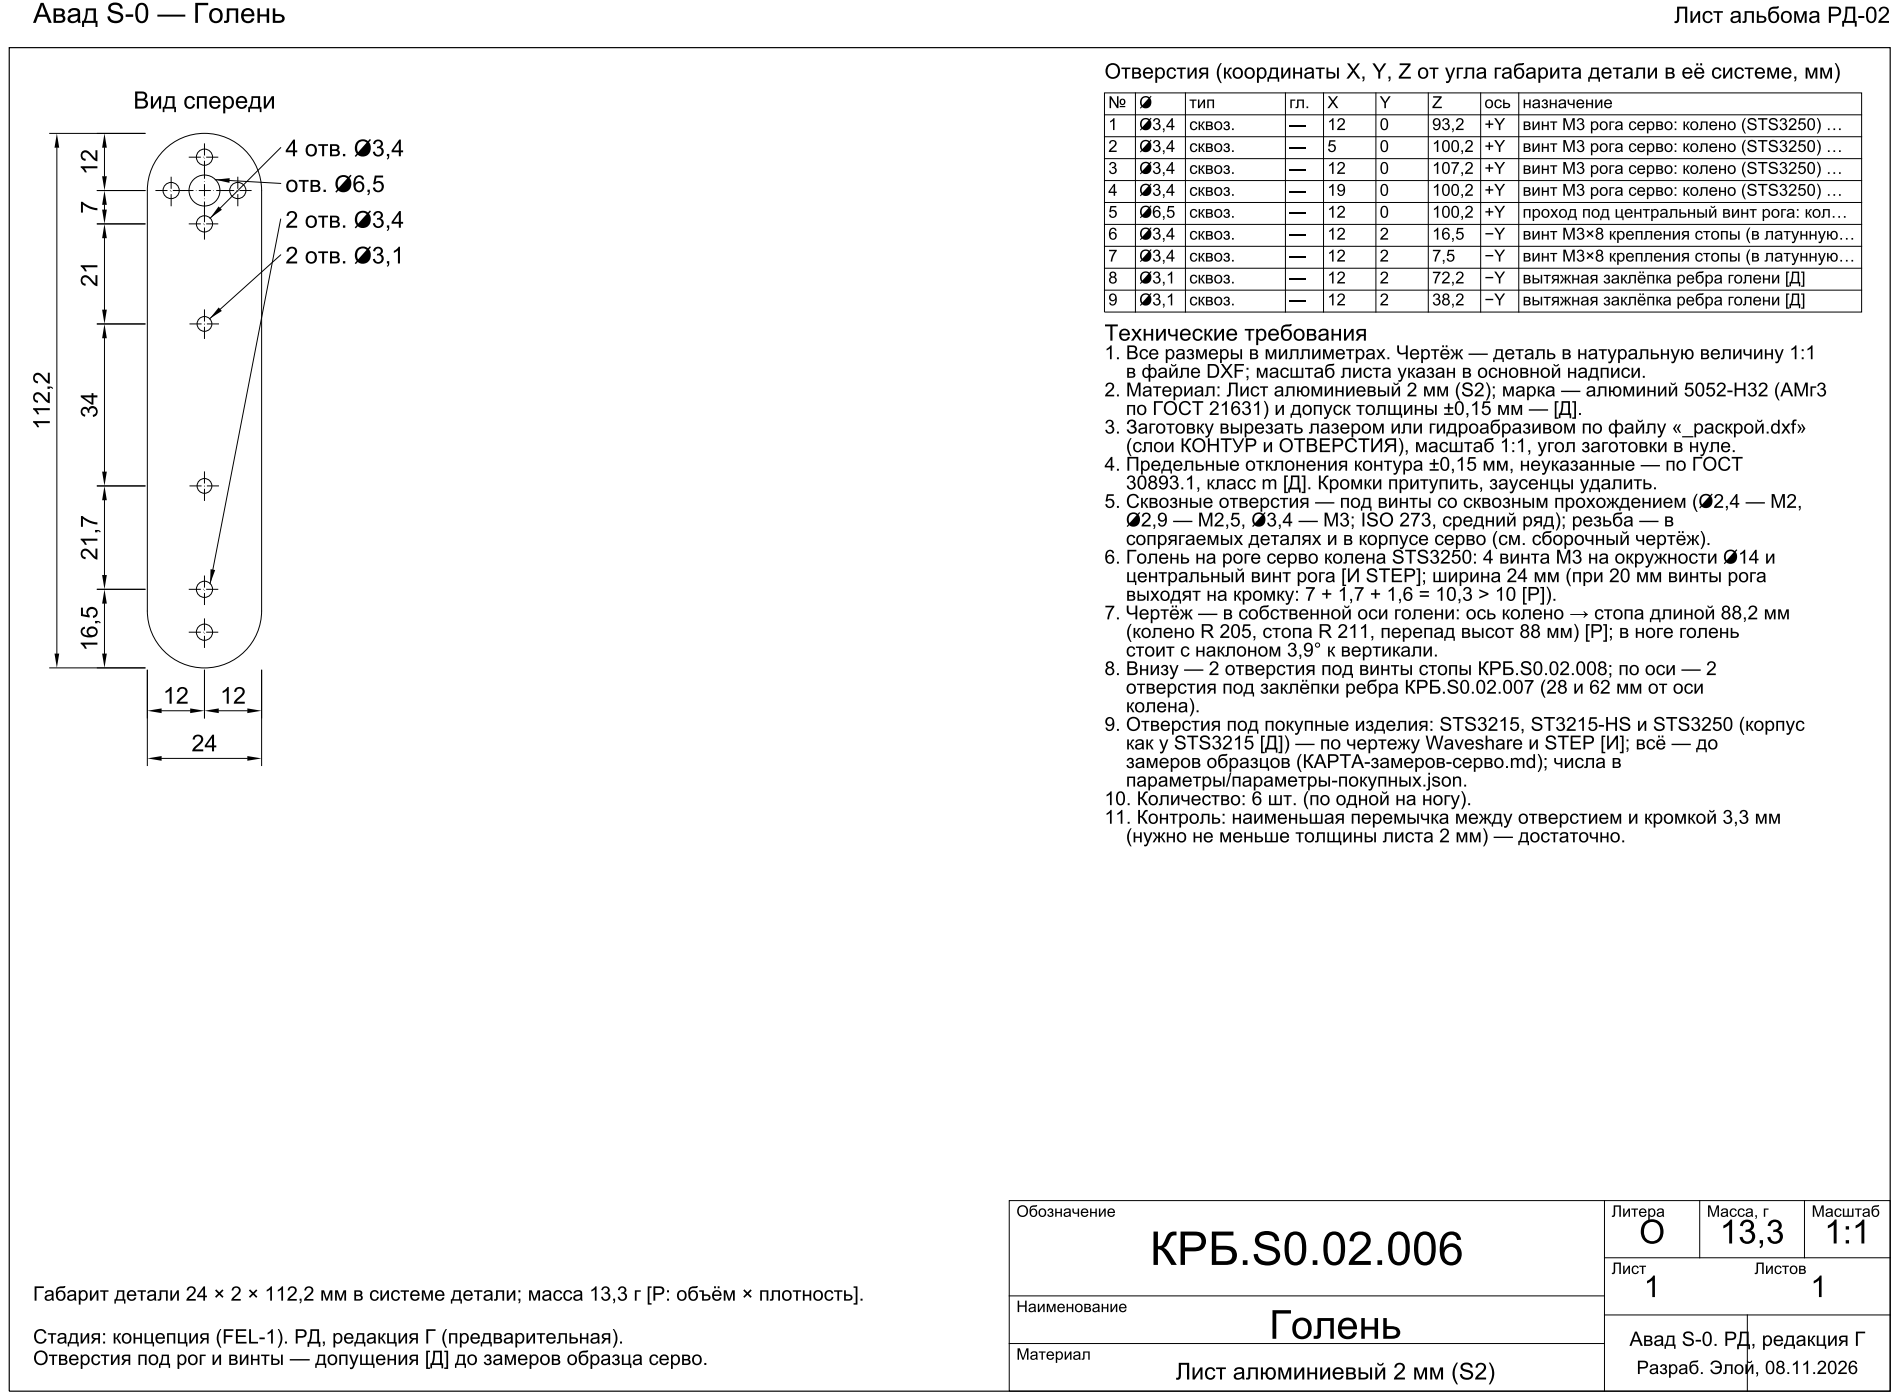
[picture p195: page 1]
