pilot443/avad-s0/parts/KRB.S0.02.007_rebro-goleni.pdf

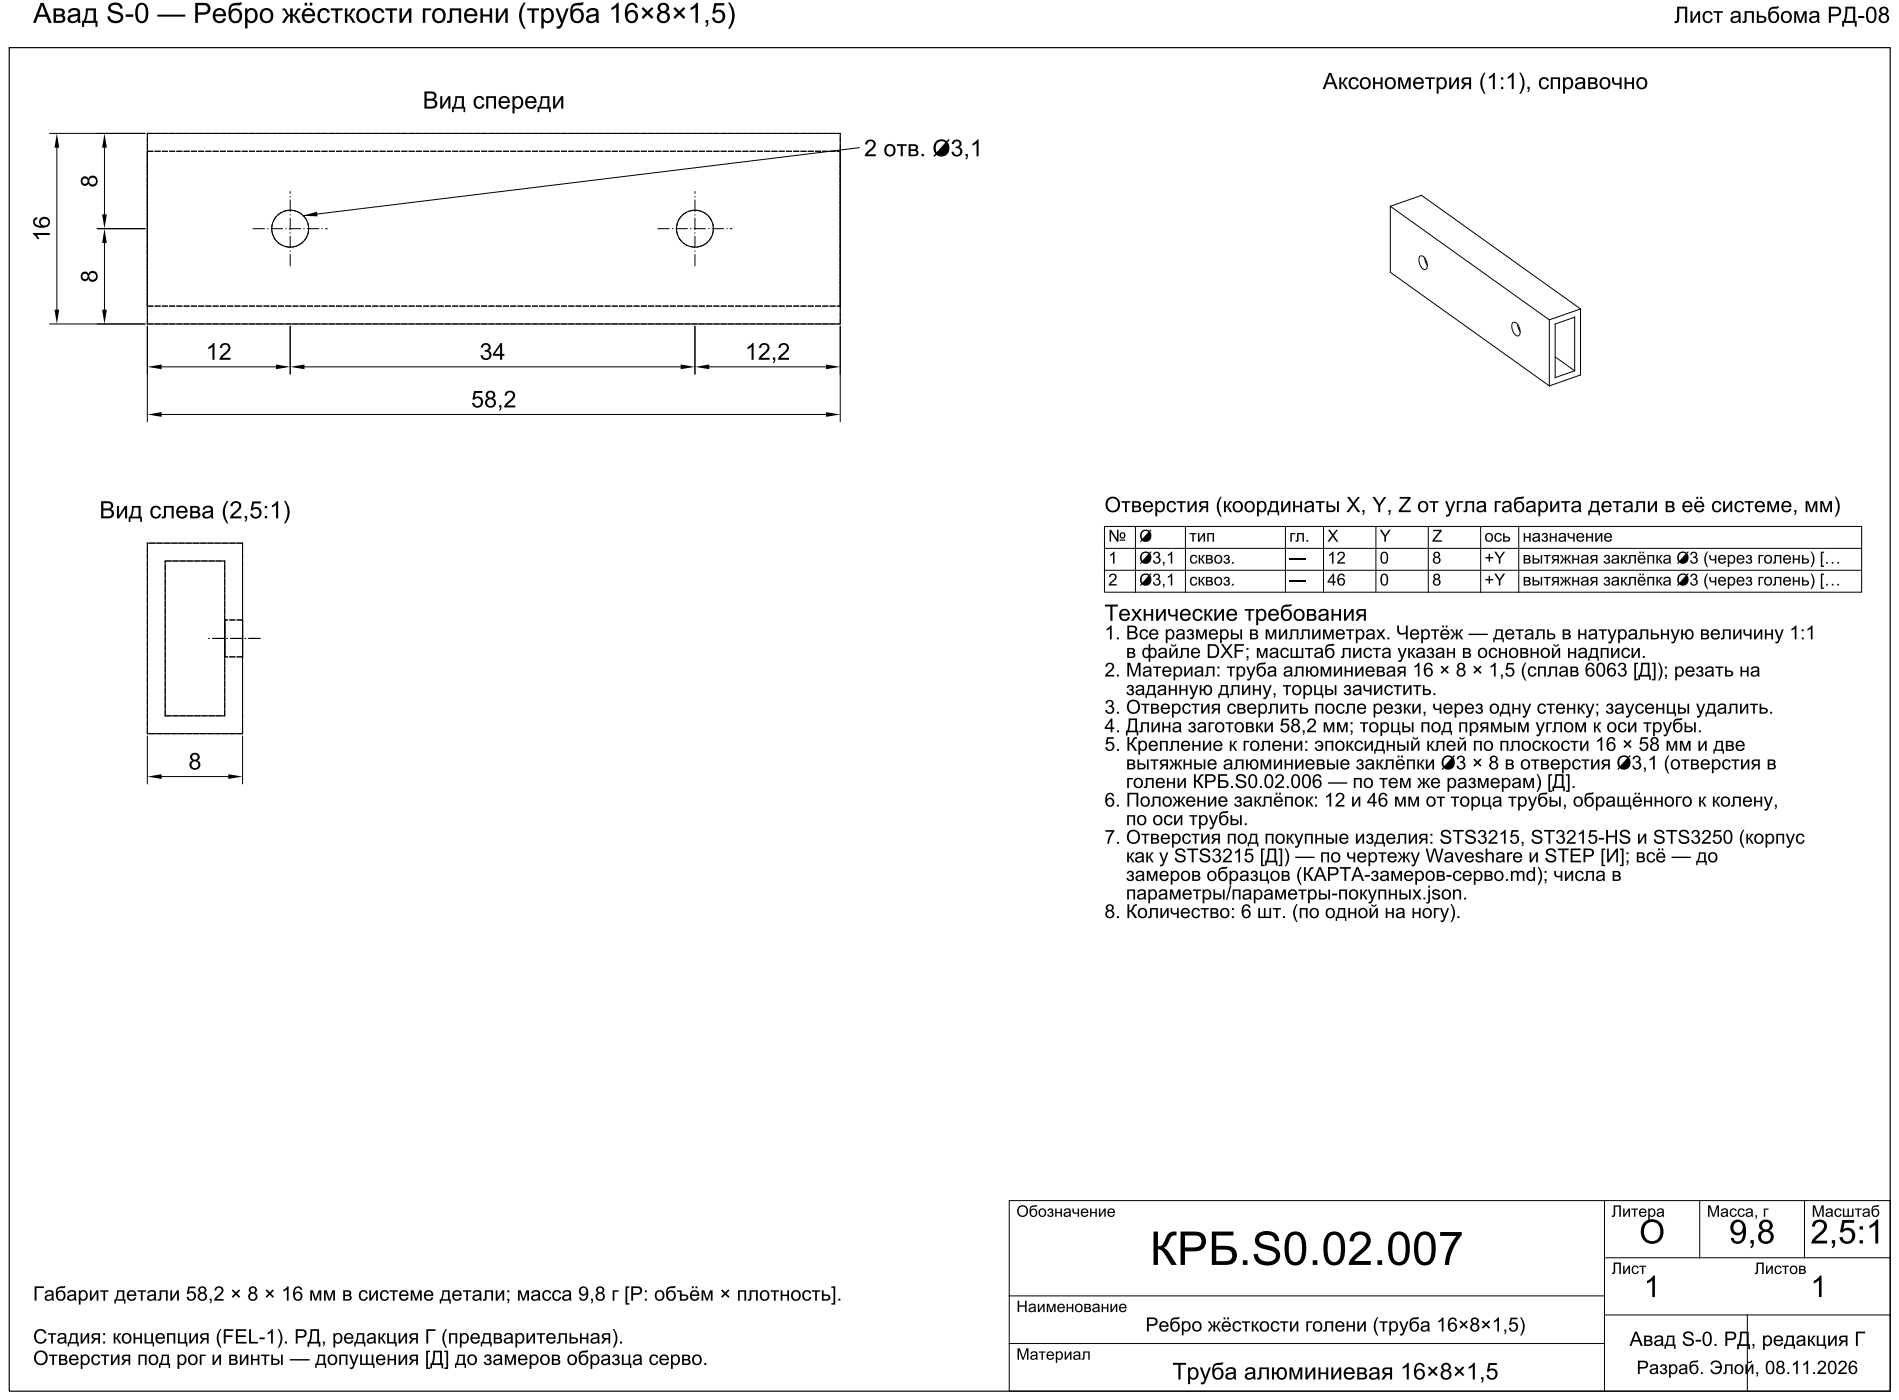
[picture p196: page 1]
