pilot443/avad-s0/parts/KRB.S0.02.008_stopa.pdf

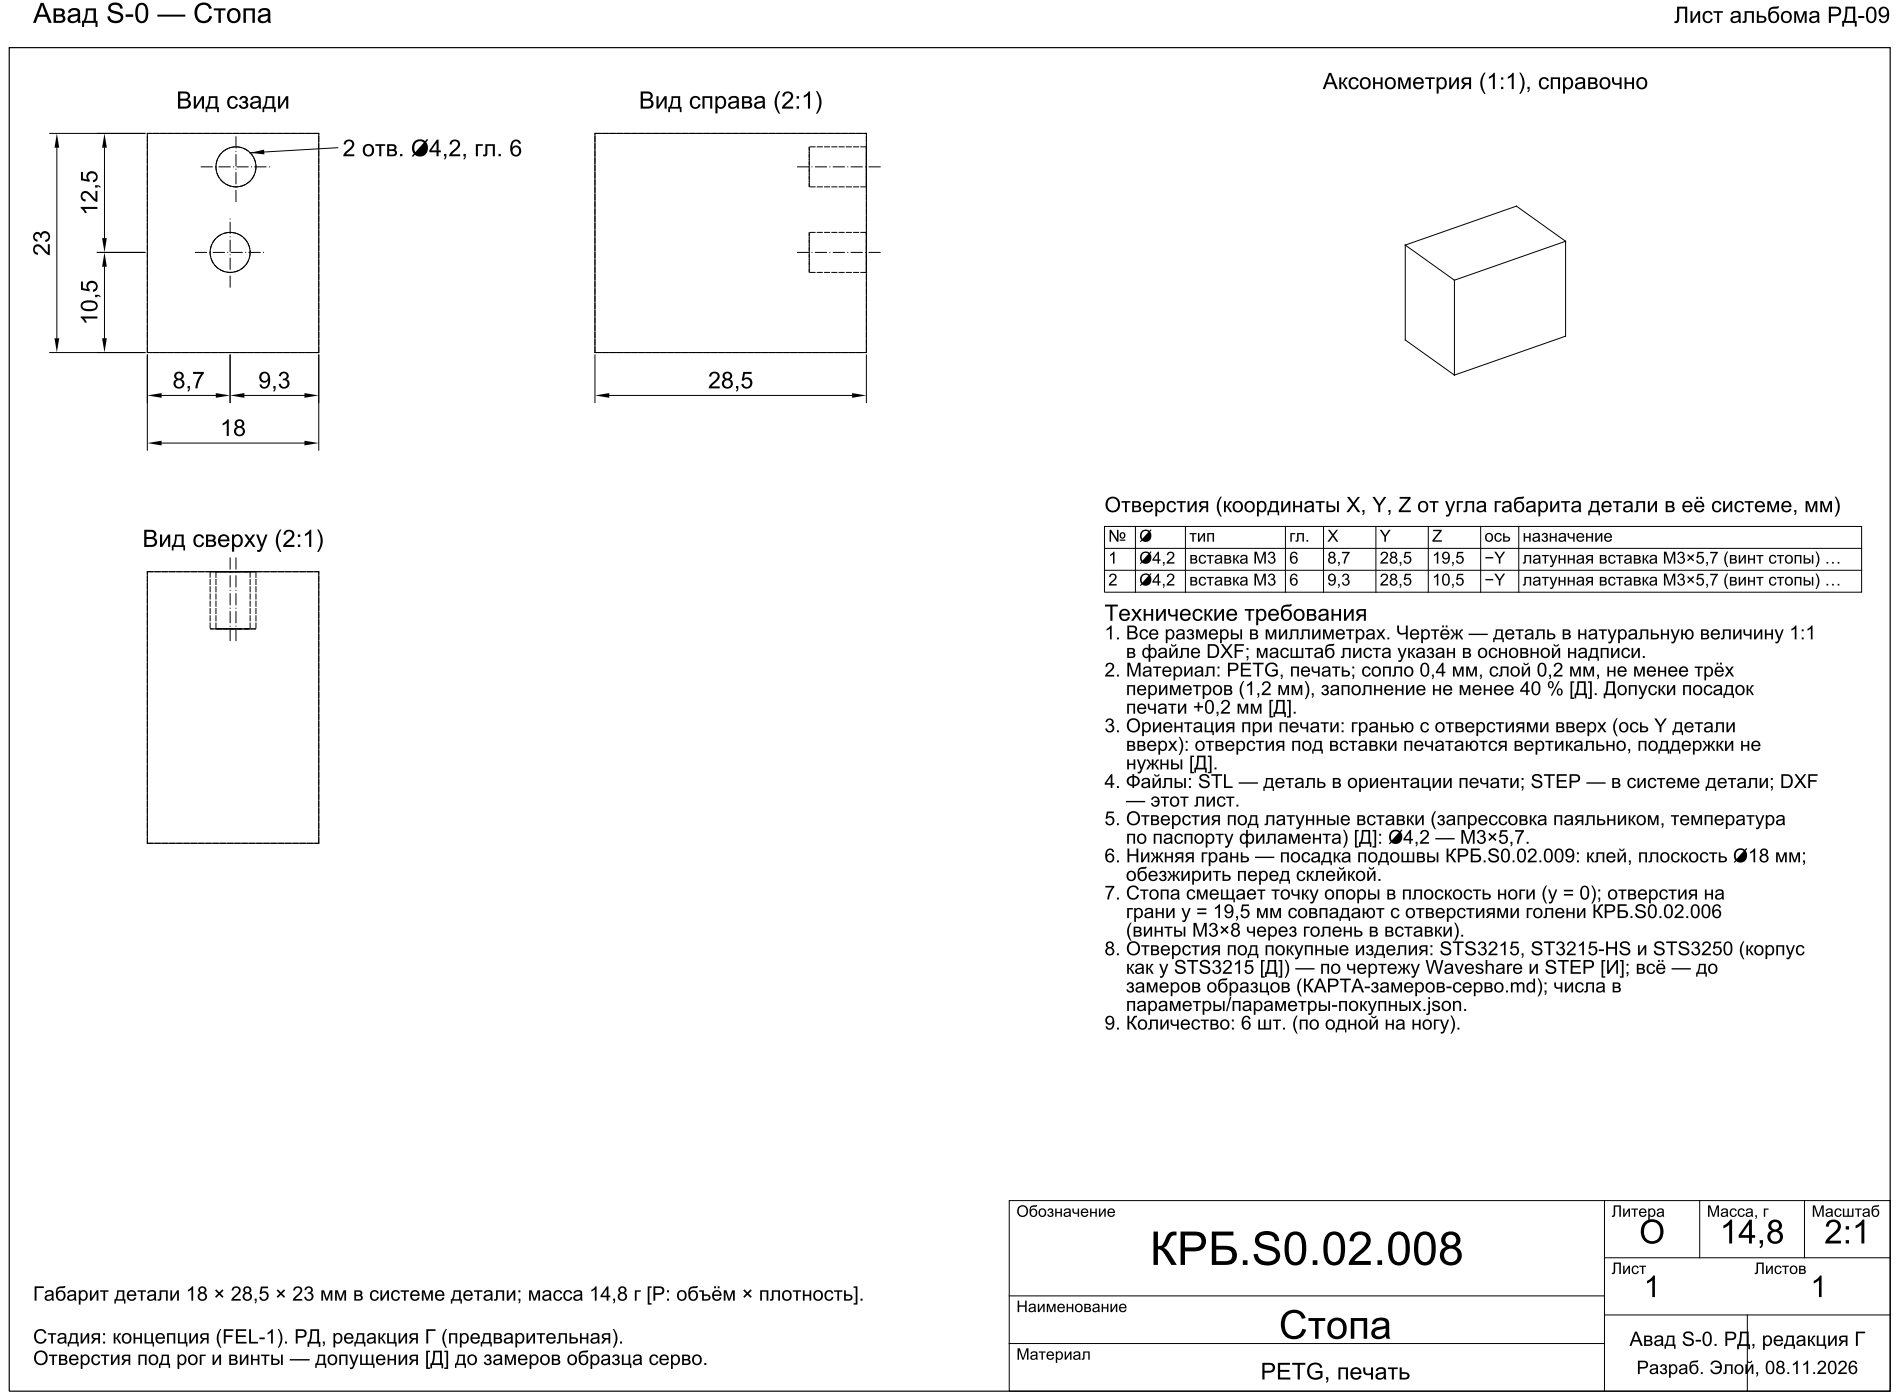
[picture p197: page 1]
