pilot443/avad-s0/parts/KRB.S0.02.009_podoshva.pdf

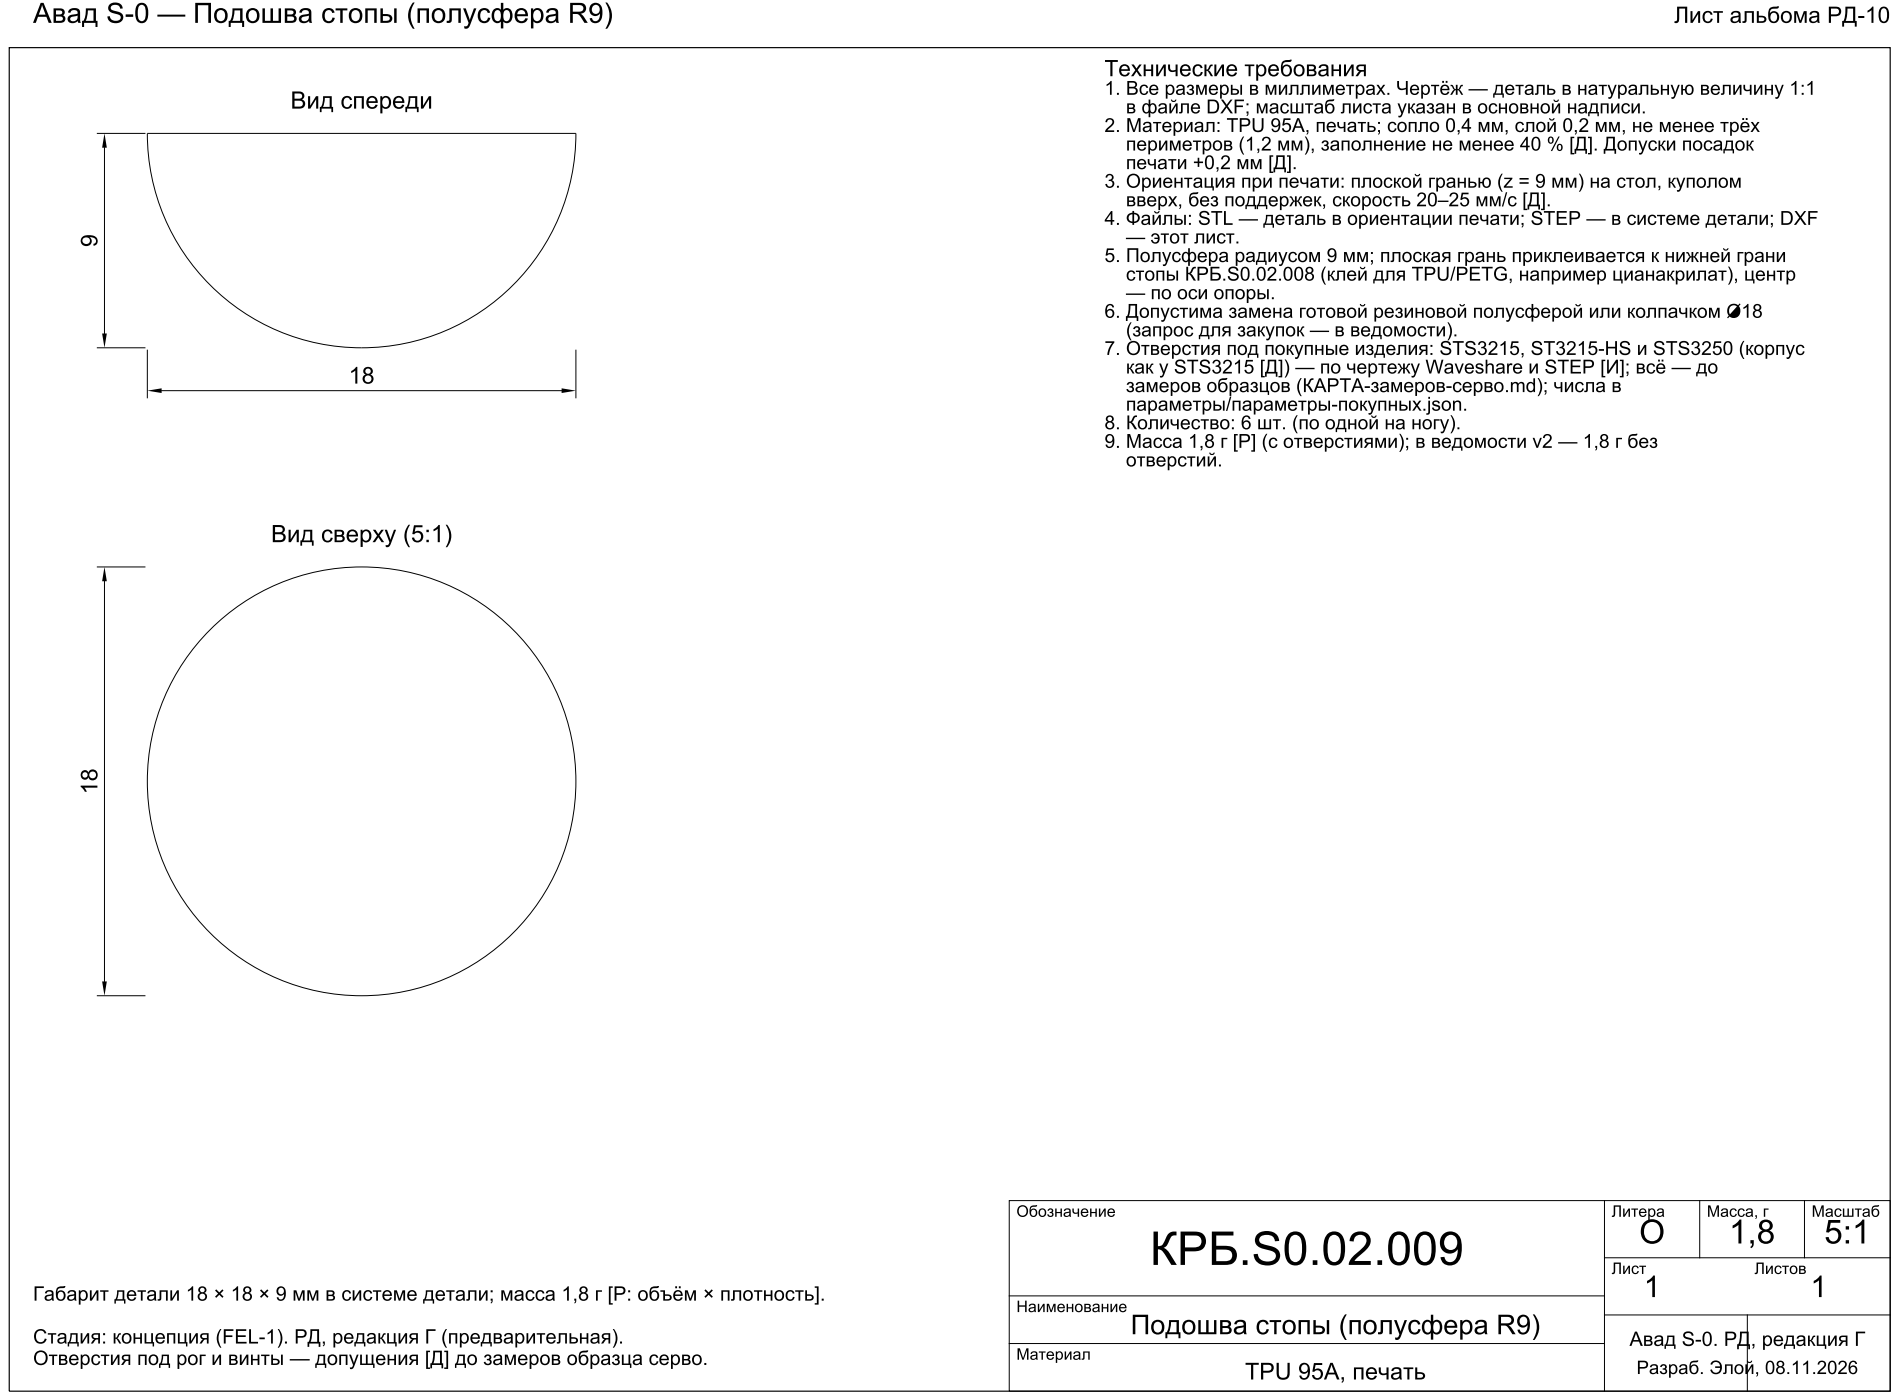
[picture p198: page 1]
