pilot443/avad-s0/parts/KRB.S0.02.010_razvertka.pdf

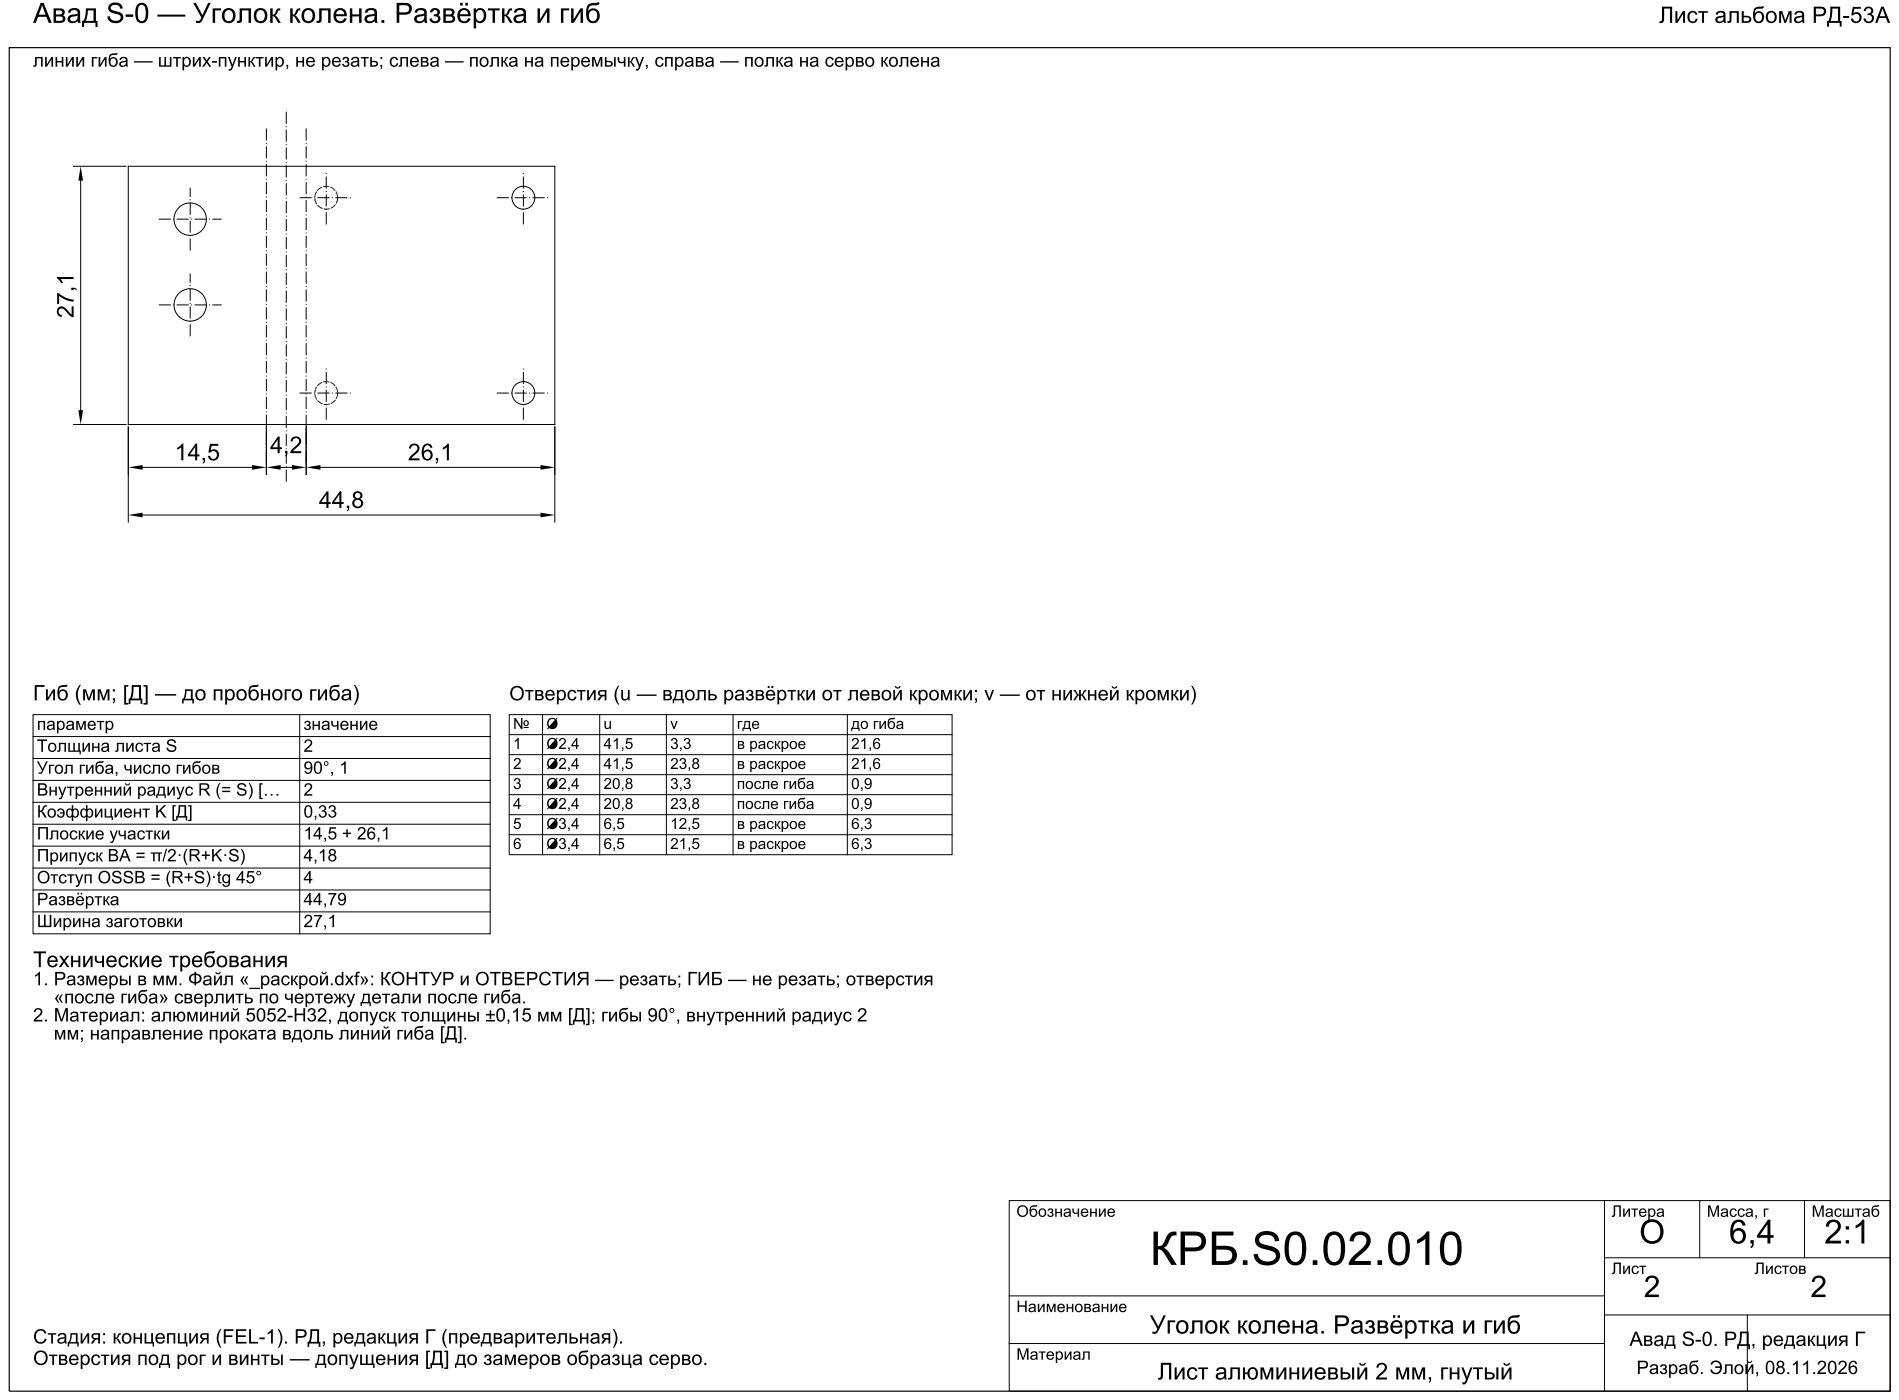
[picture p199: page 1]
