pilot443/avad-s0/parts/KRB.S0.02.010_ugolok-kolena.pdf

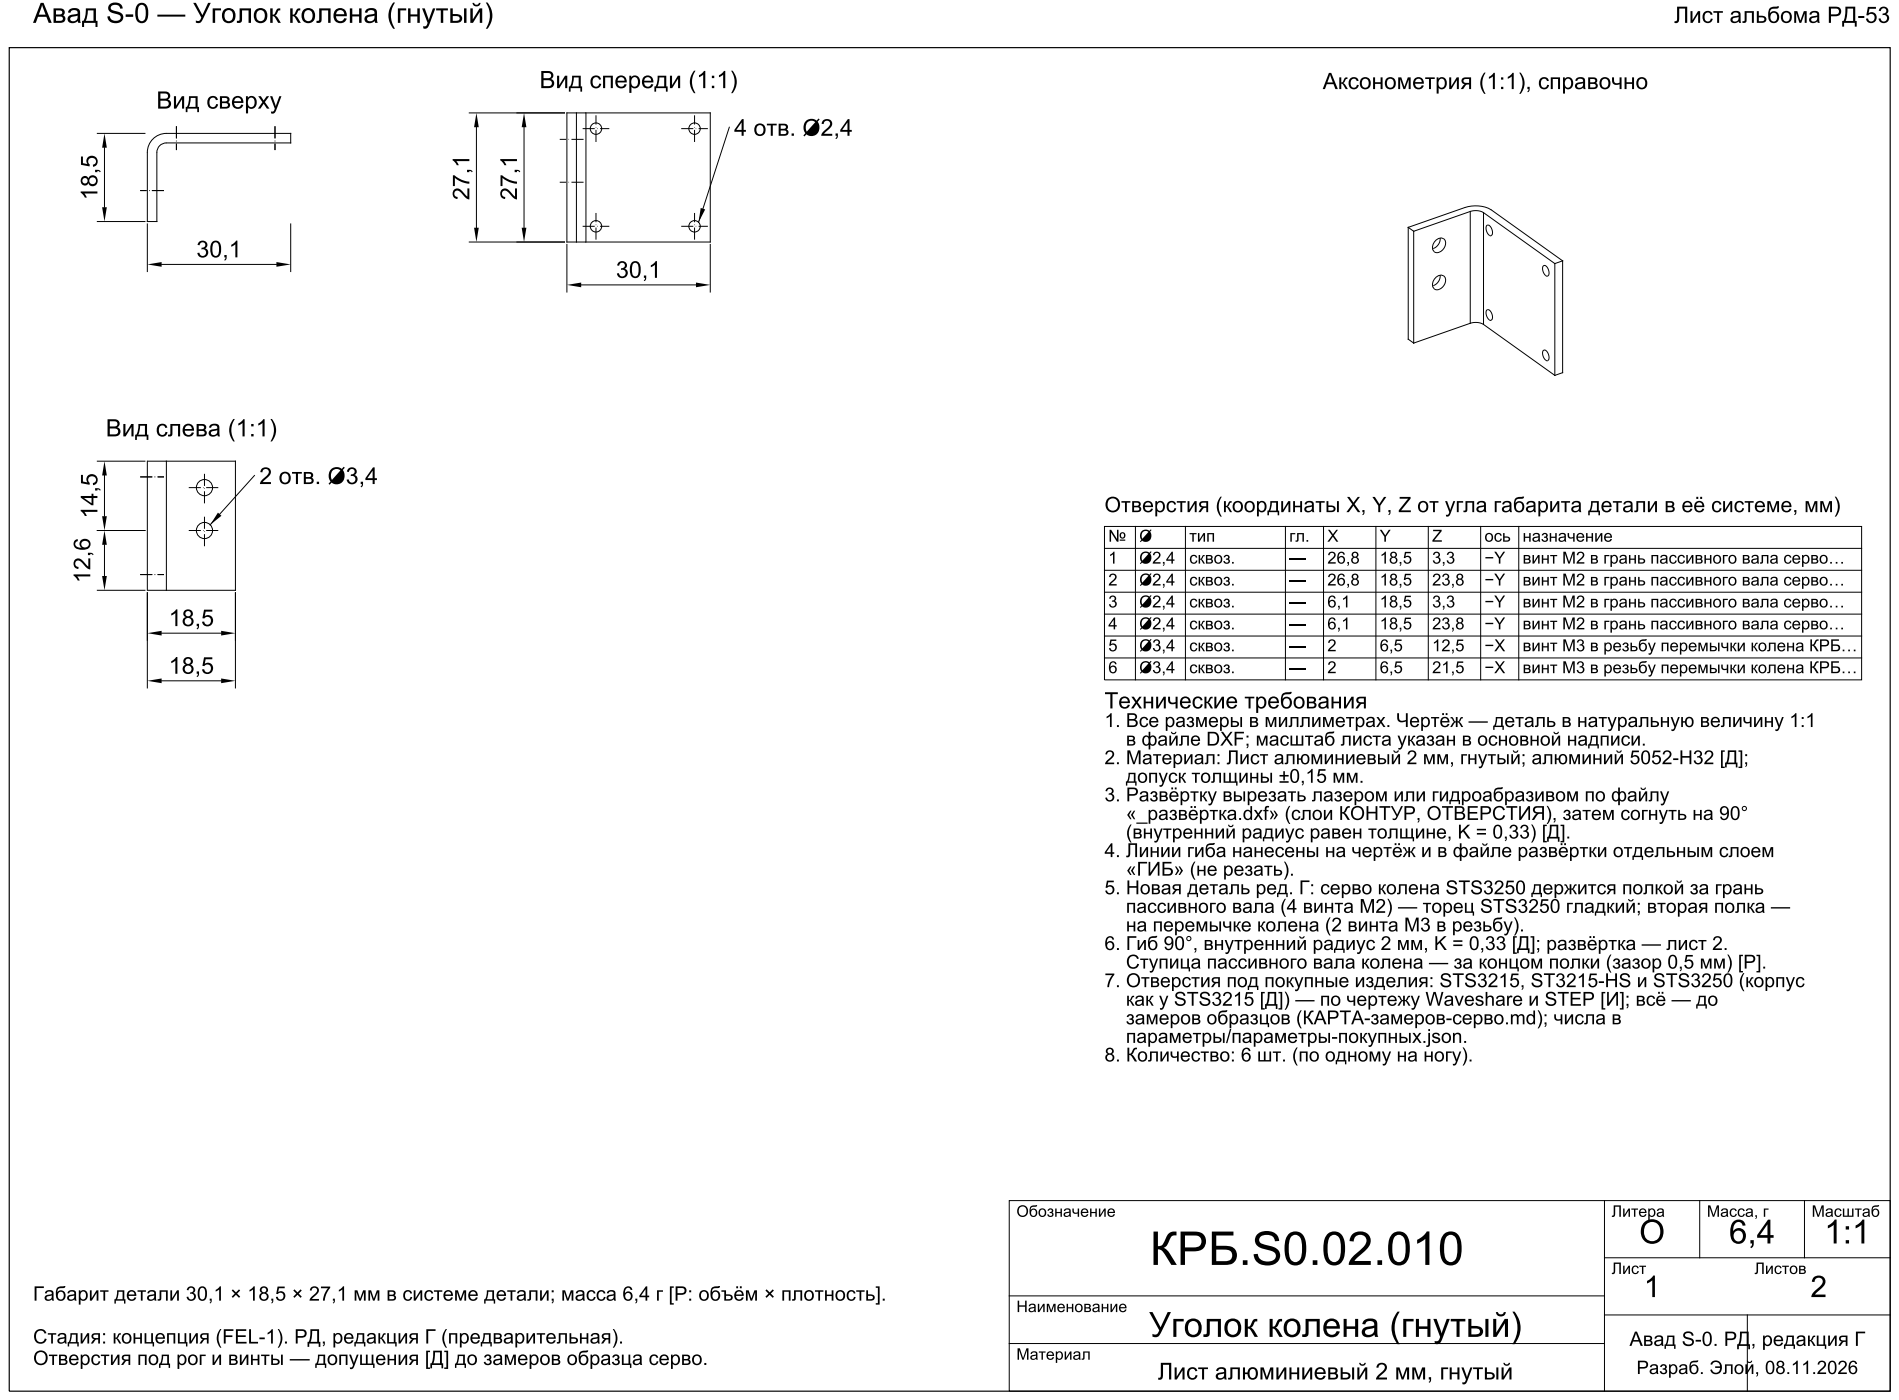
[picture p200: page 1]
