pilot443/avad-s0/parts/KRB.S0.03.001_ploshchadka-plecha.pdf

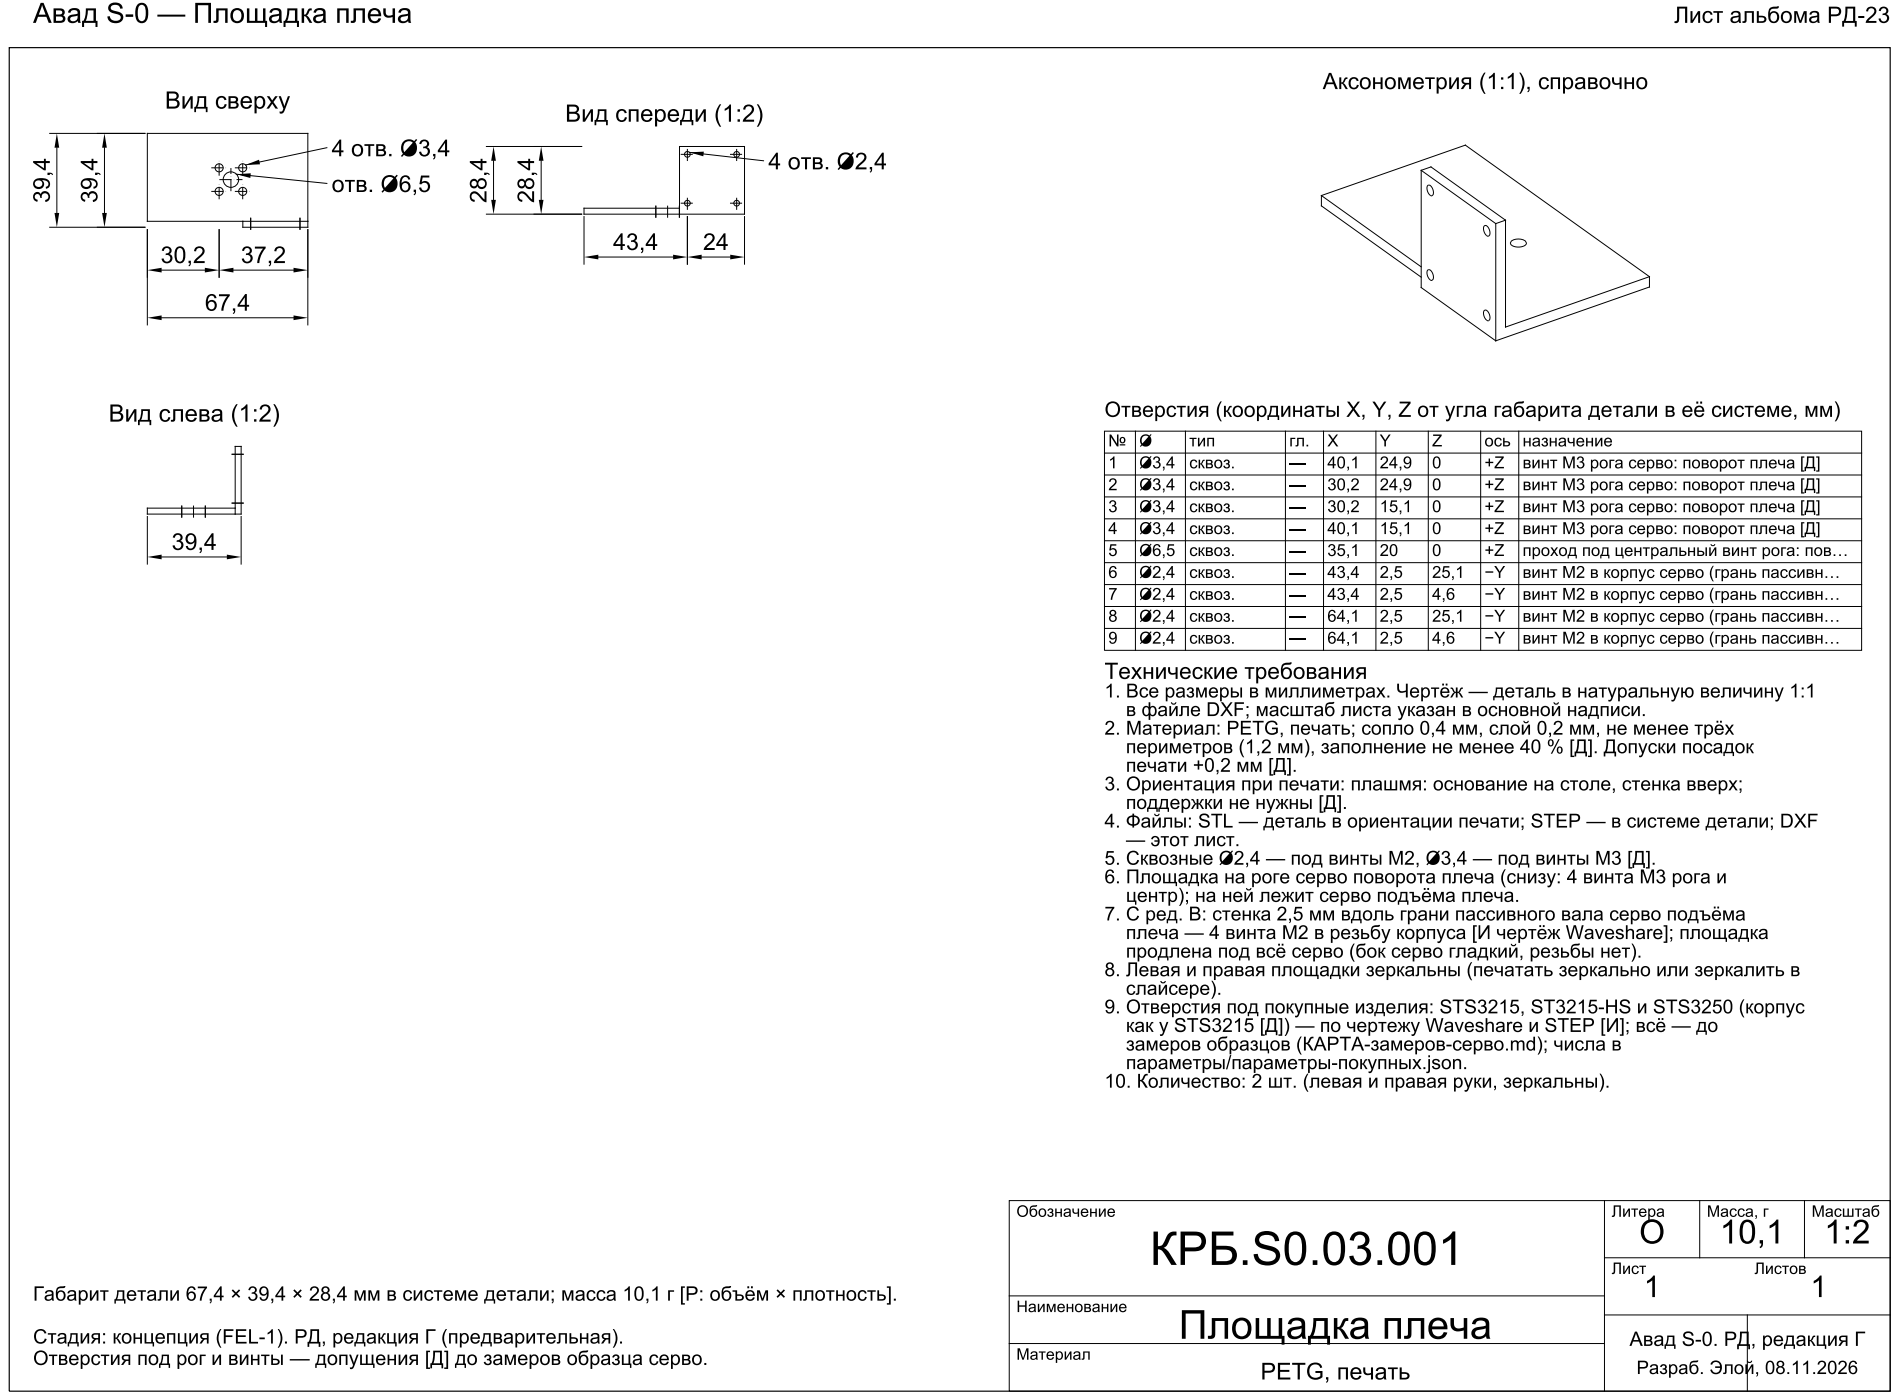
[picture p201: page 1]
