pilot443/avad-s0/parts/KRB.S0.03.002_zveno-plecha.pdf

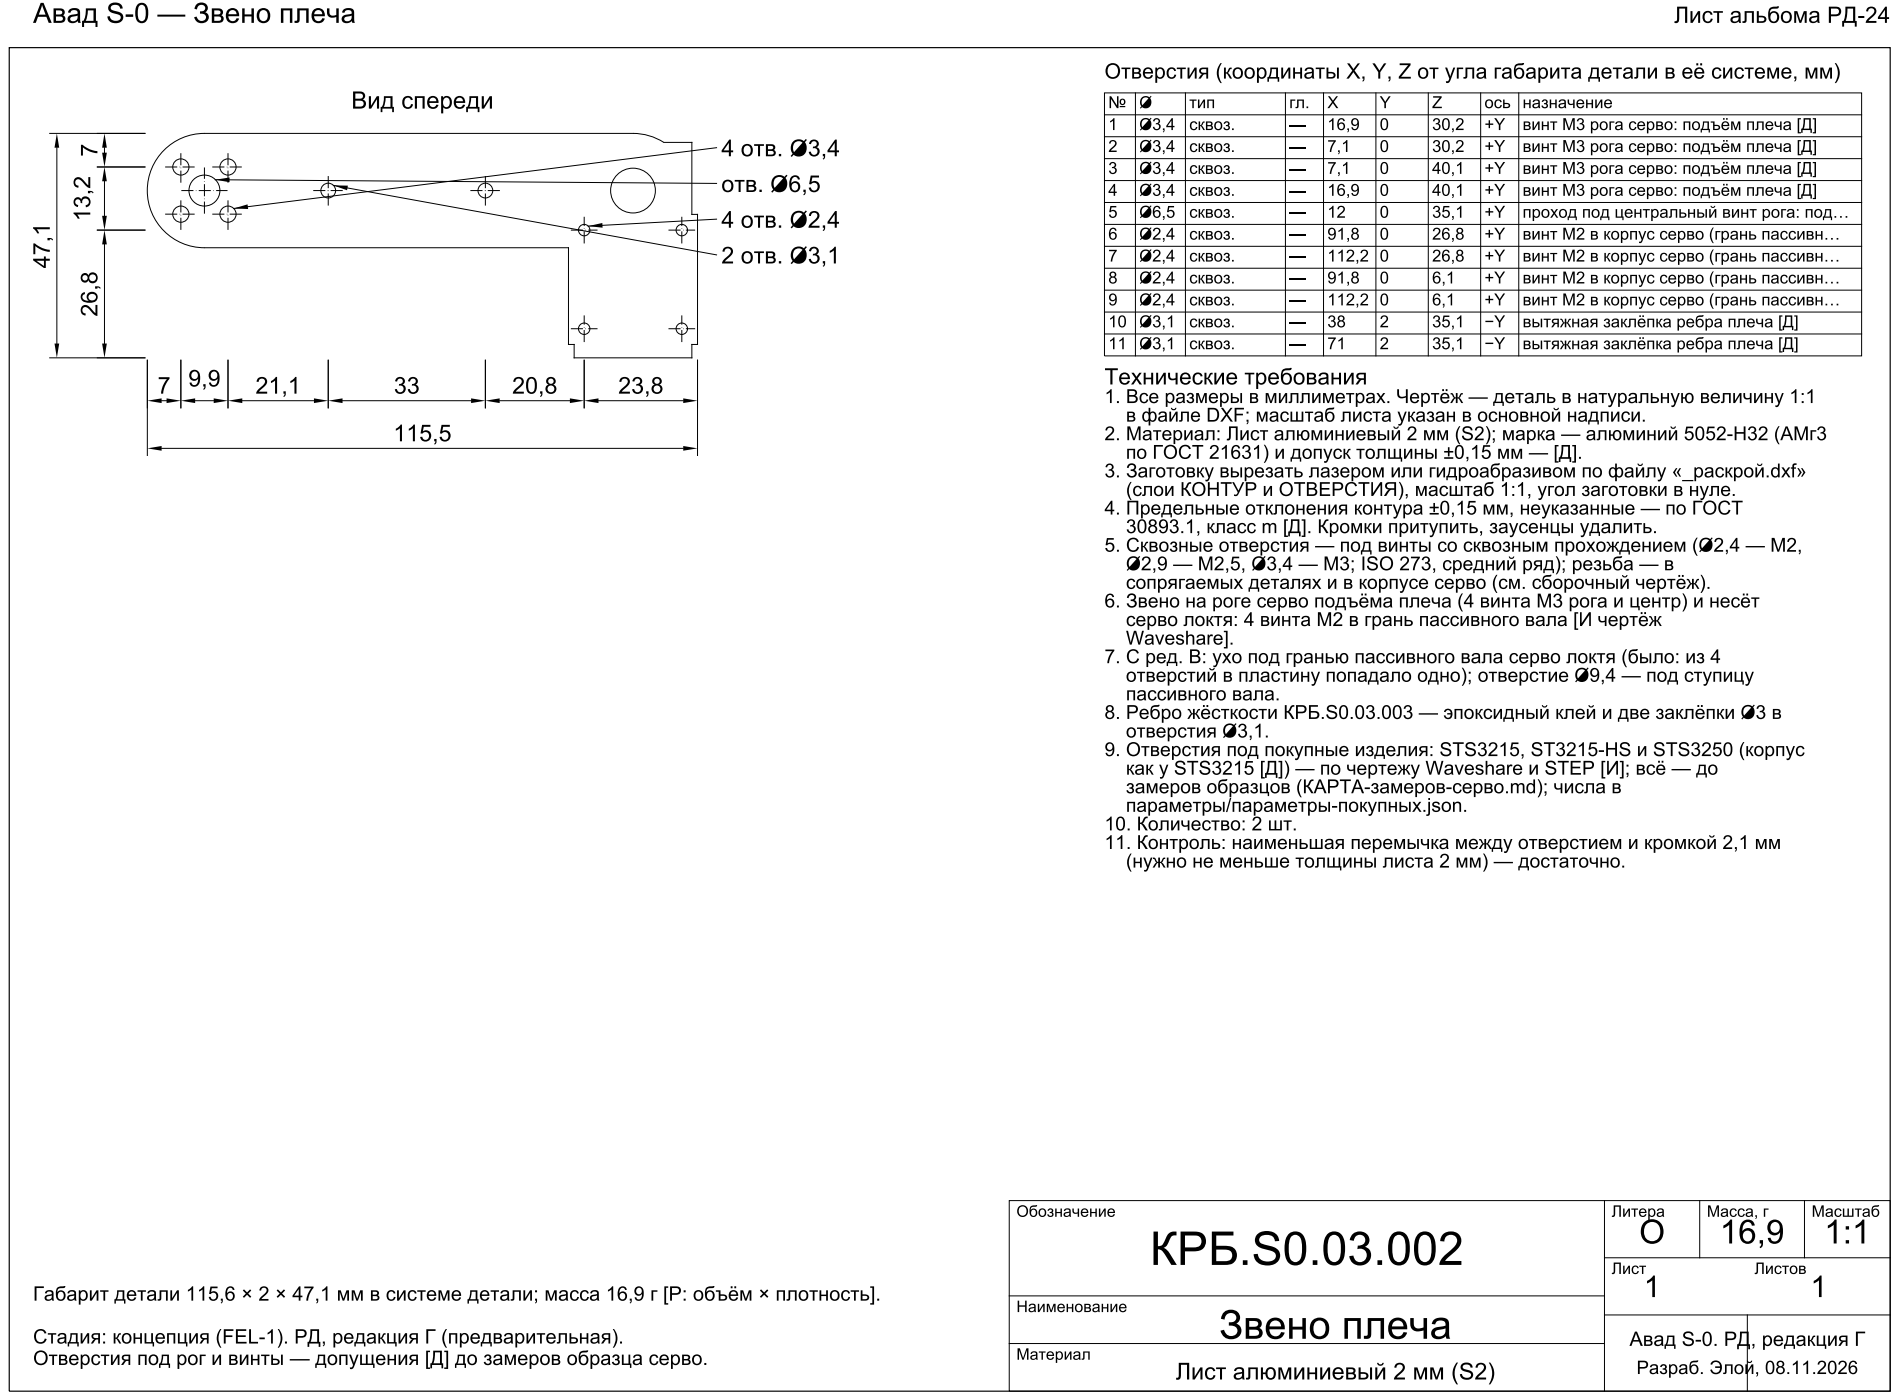
[picture p202: page 1]
