pilot443/avad-s0/parts/KRB.S0.03.003_rebro-plecha.pdf

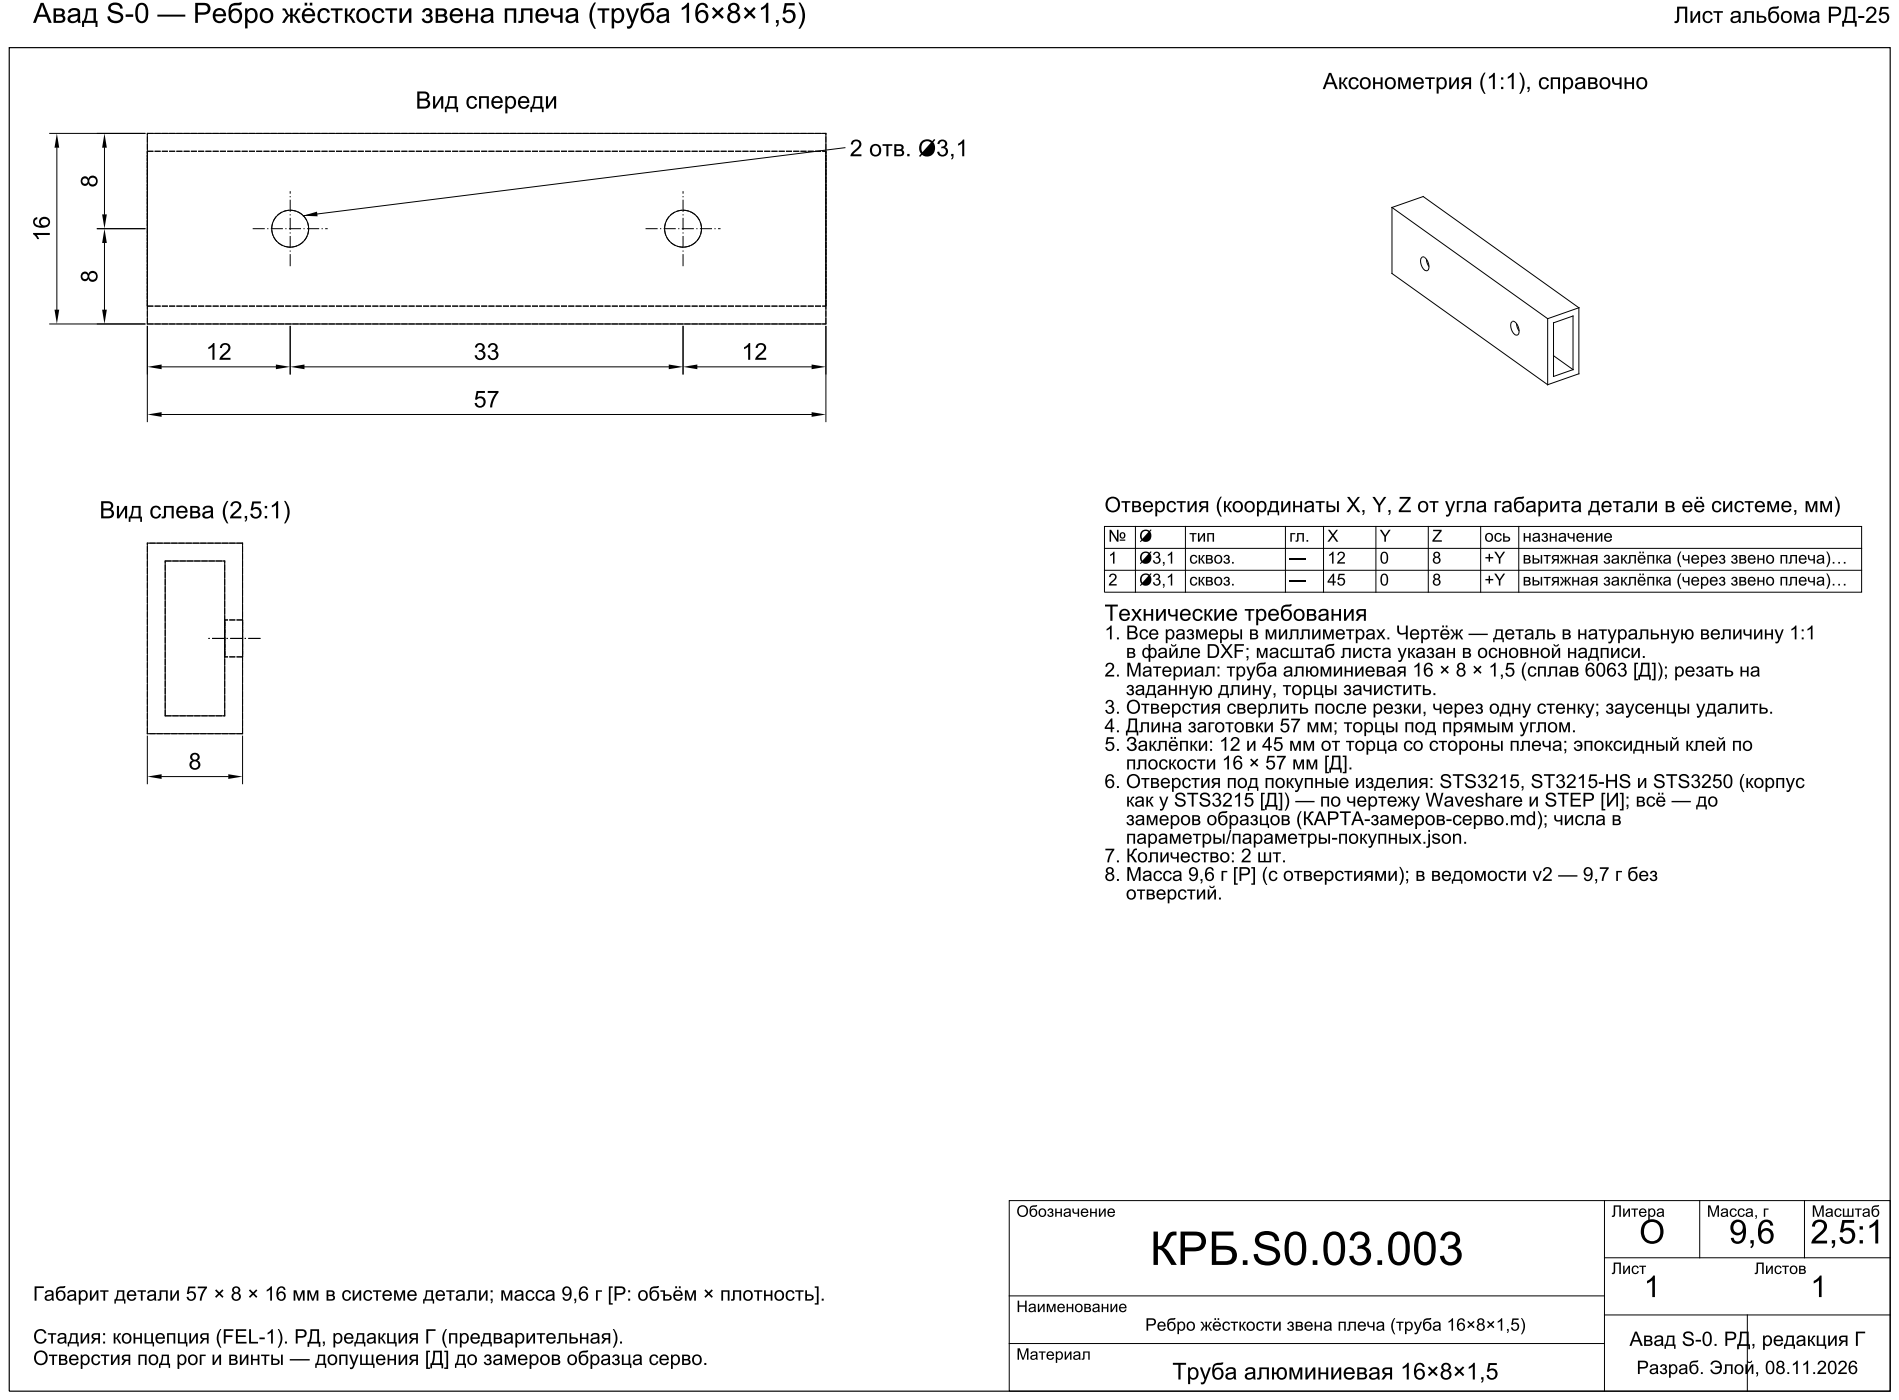
[picture p203: page 1]
