pilot443/avad-s0/parts/KRB.S0.03.004_zveno-predplechya.pdf

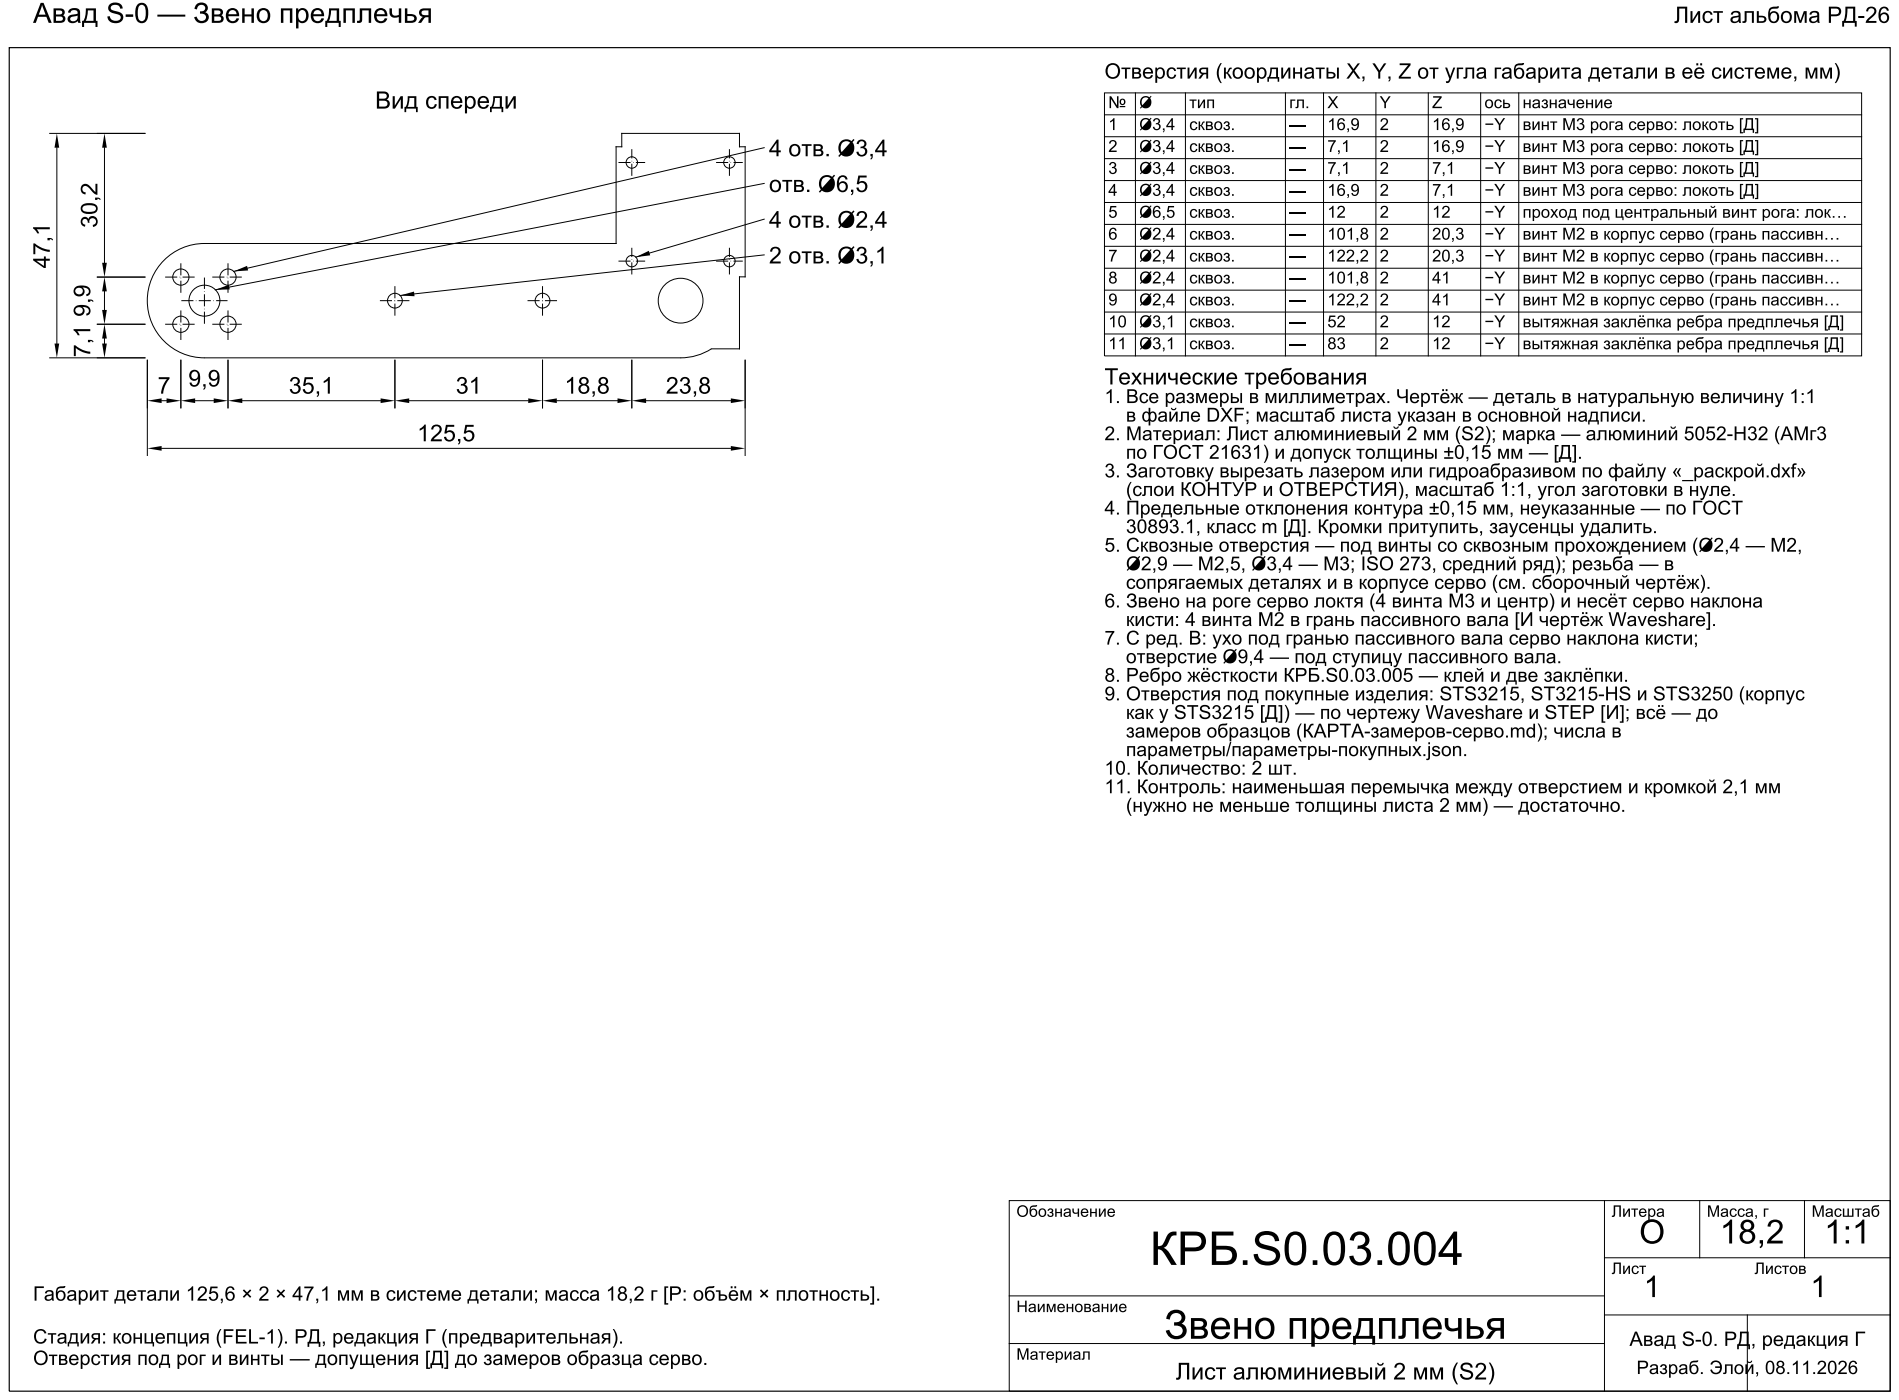
[picture p204: page 1]
