pilot443/avad-s0/parts/KRB.S0.03.005_rebro-predplechya.pdf

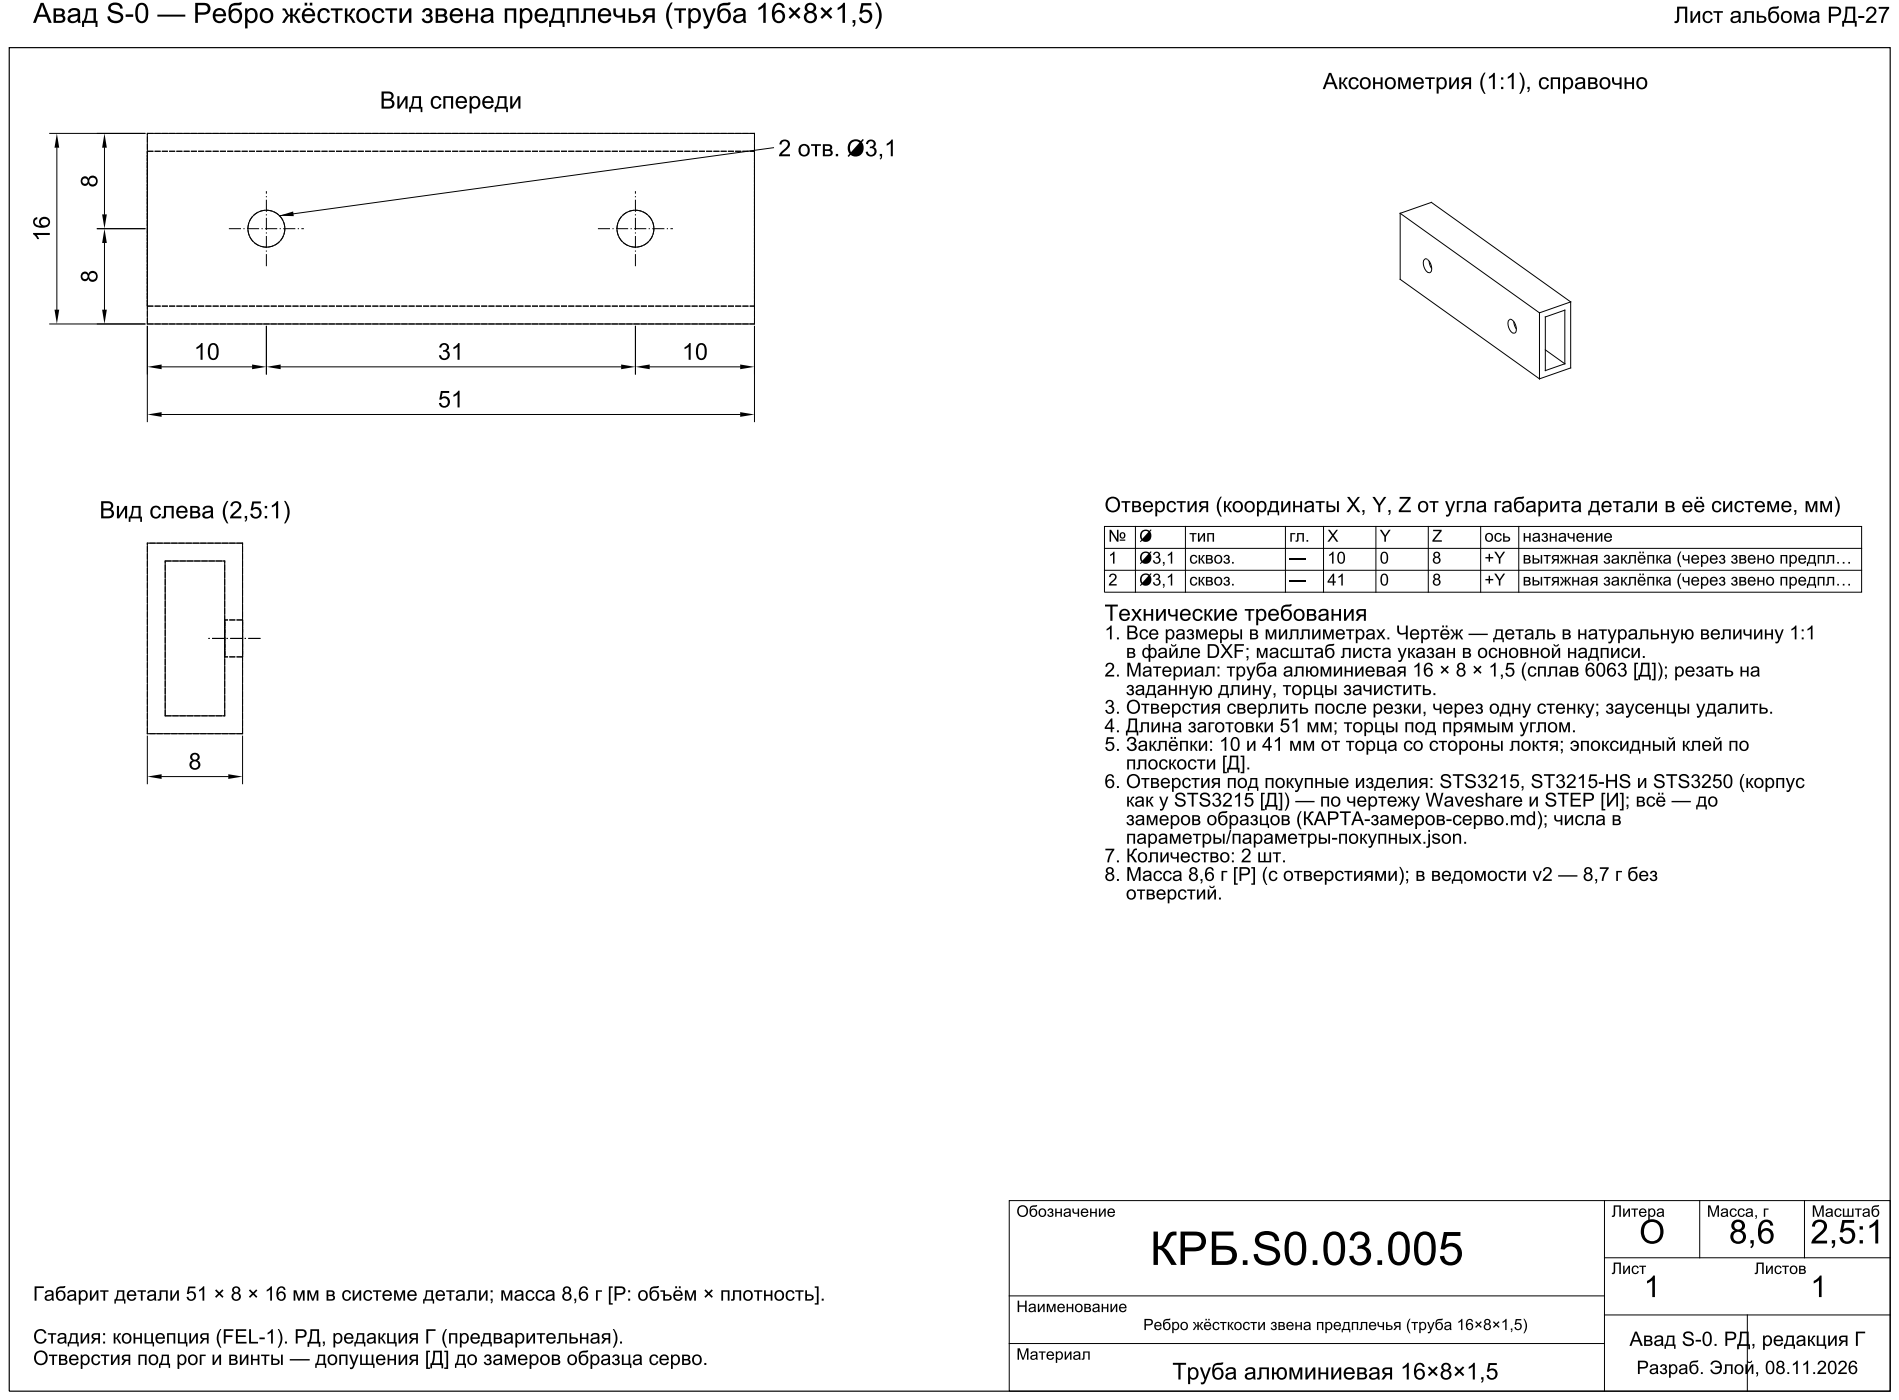
[picture p205: page 1]
