pilot443/avad-s0/parts/KRB.S0.03.010_stoika-plecha.pdf

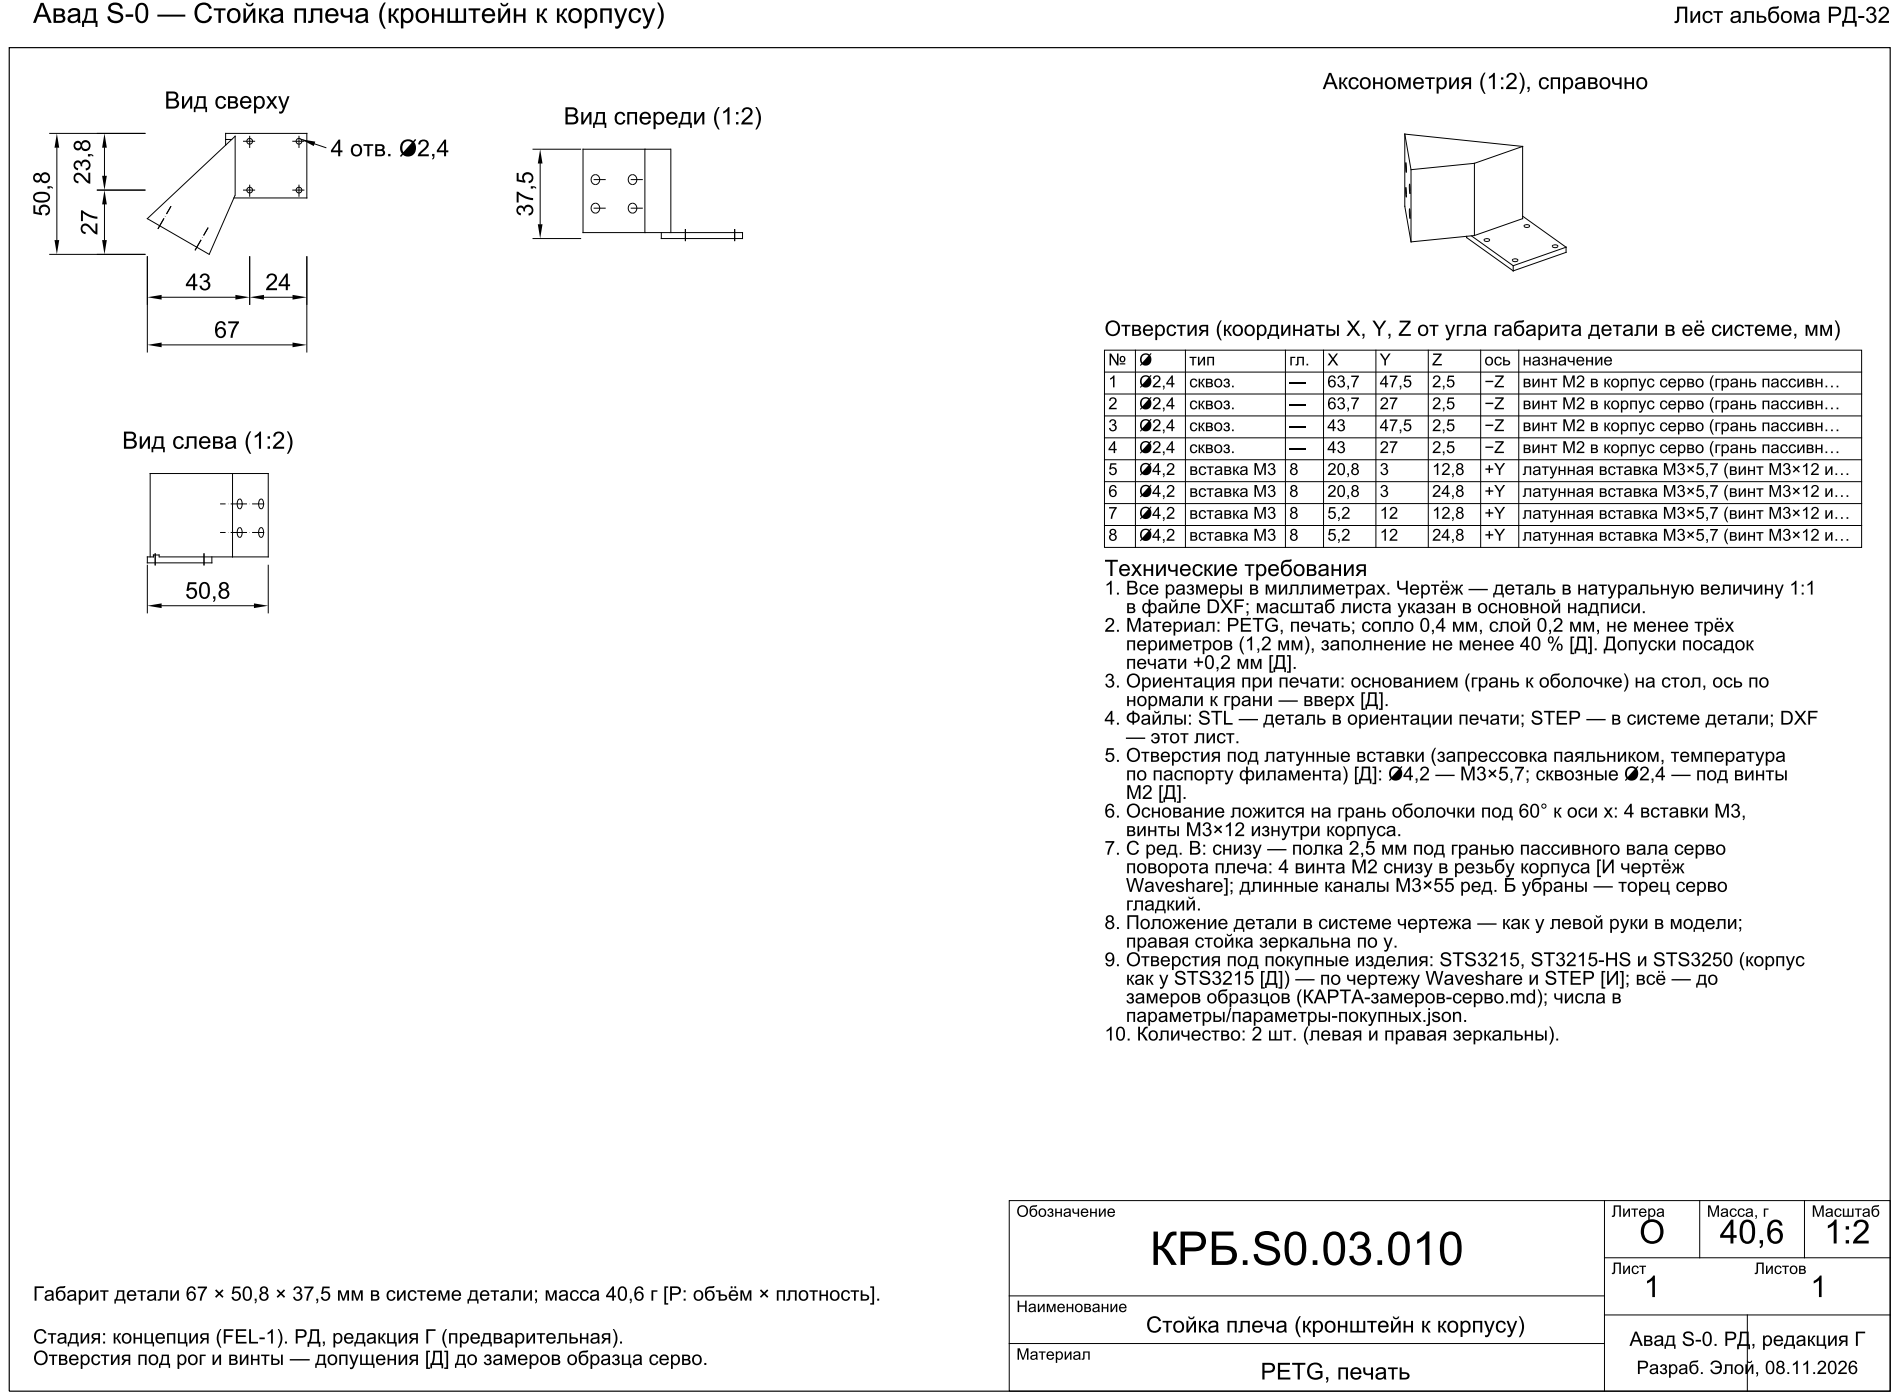
[picture p207: page 1]
