pilot443/avad-s0/parts/KRB.S0.03.011_ugolok-povorota-kisti.pdf

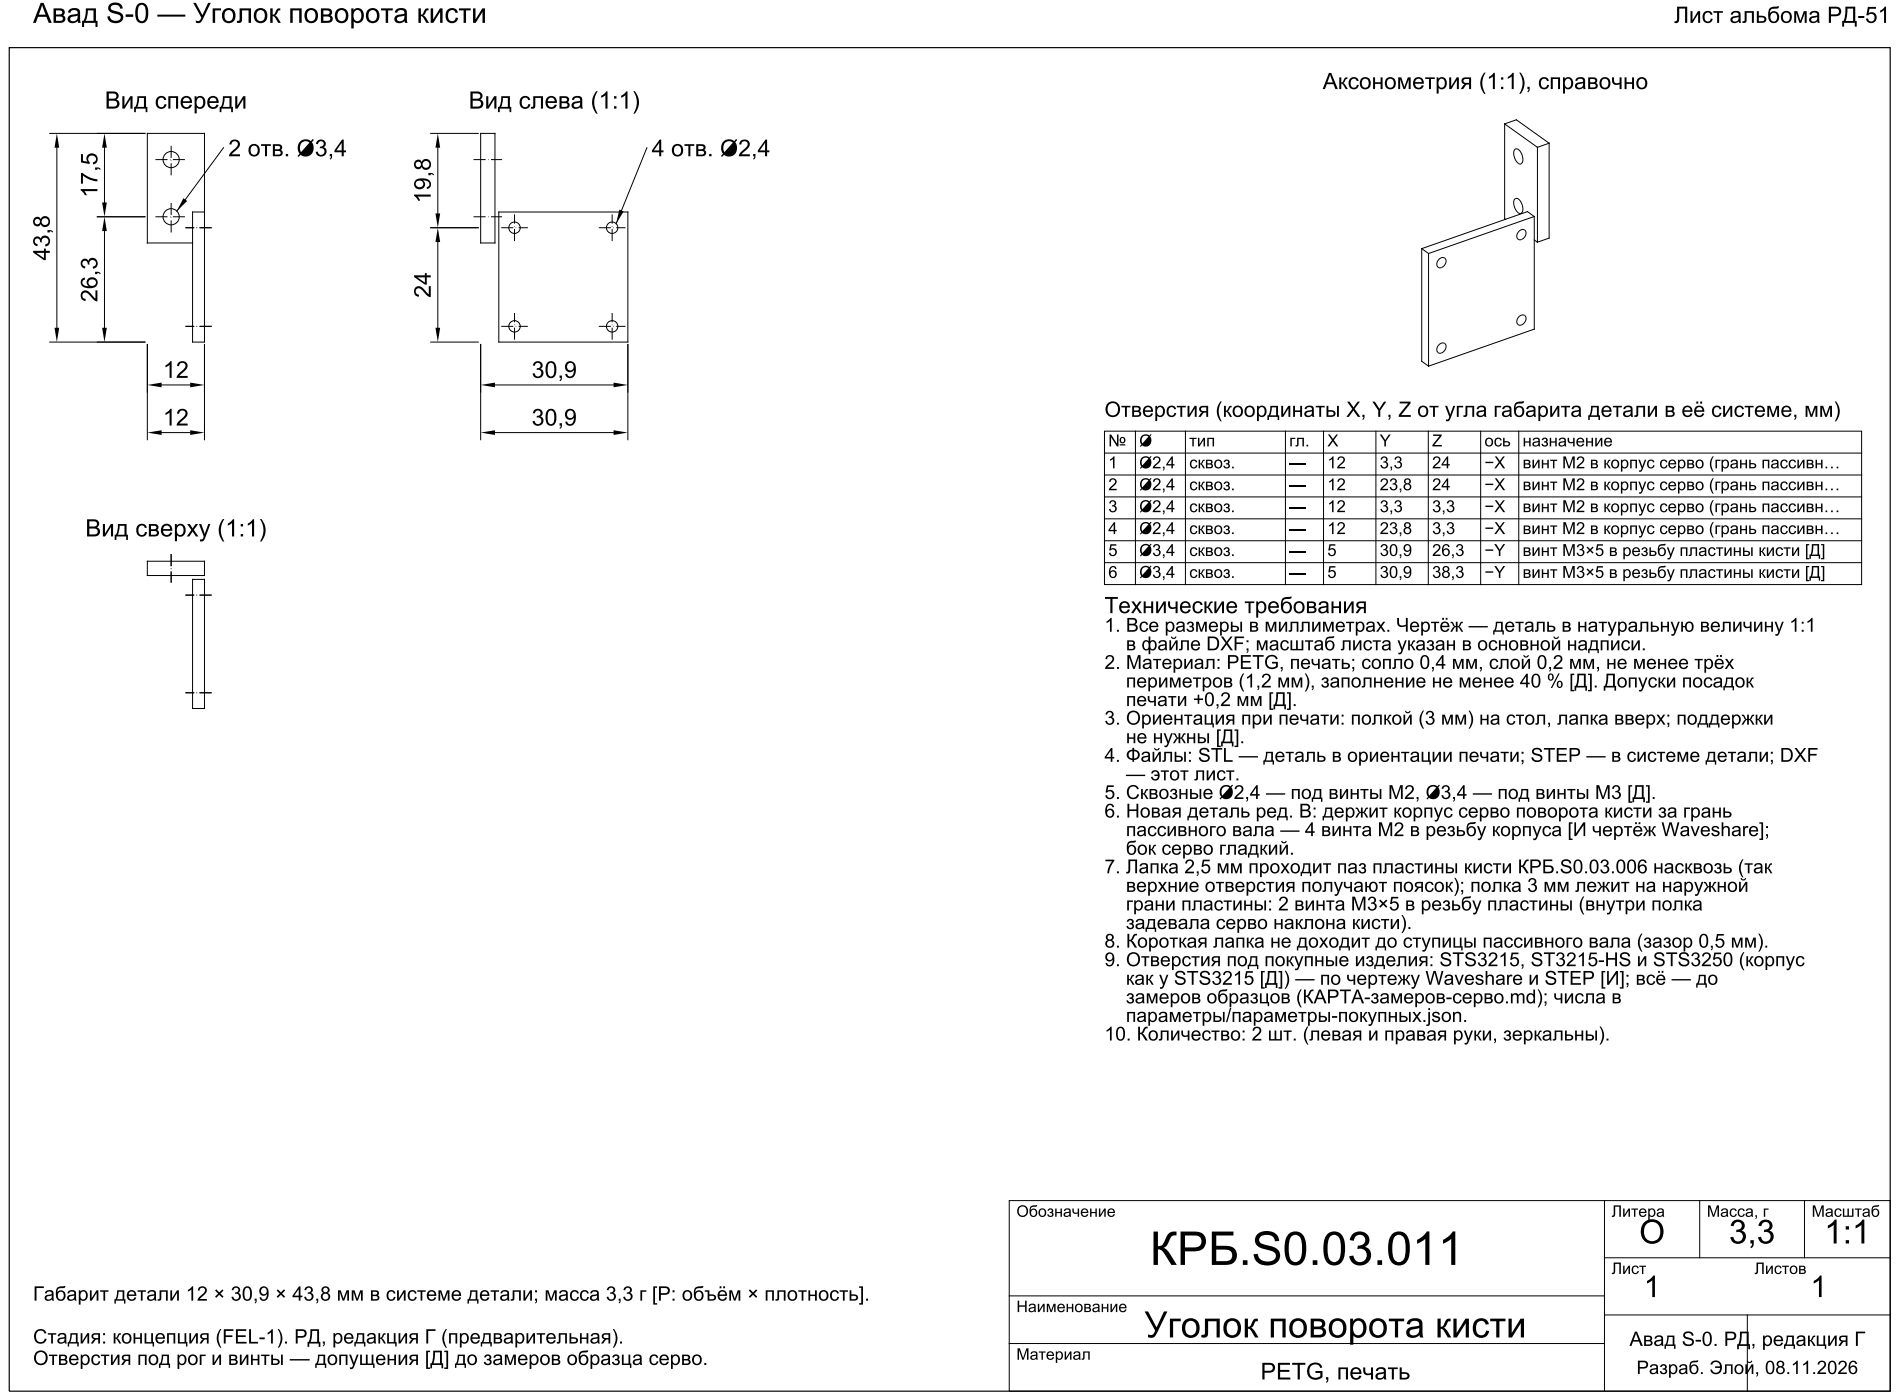
[picture p208: page 1]
