pilot443/avad-s0/parts/KRB.S0.04.001_kozhuh-golovy.pdf

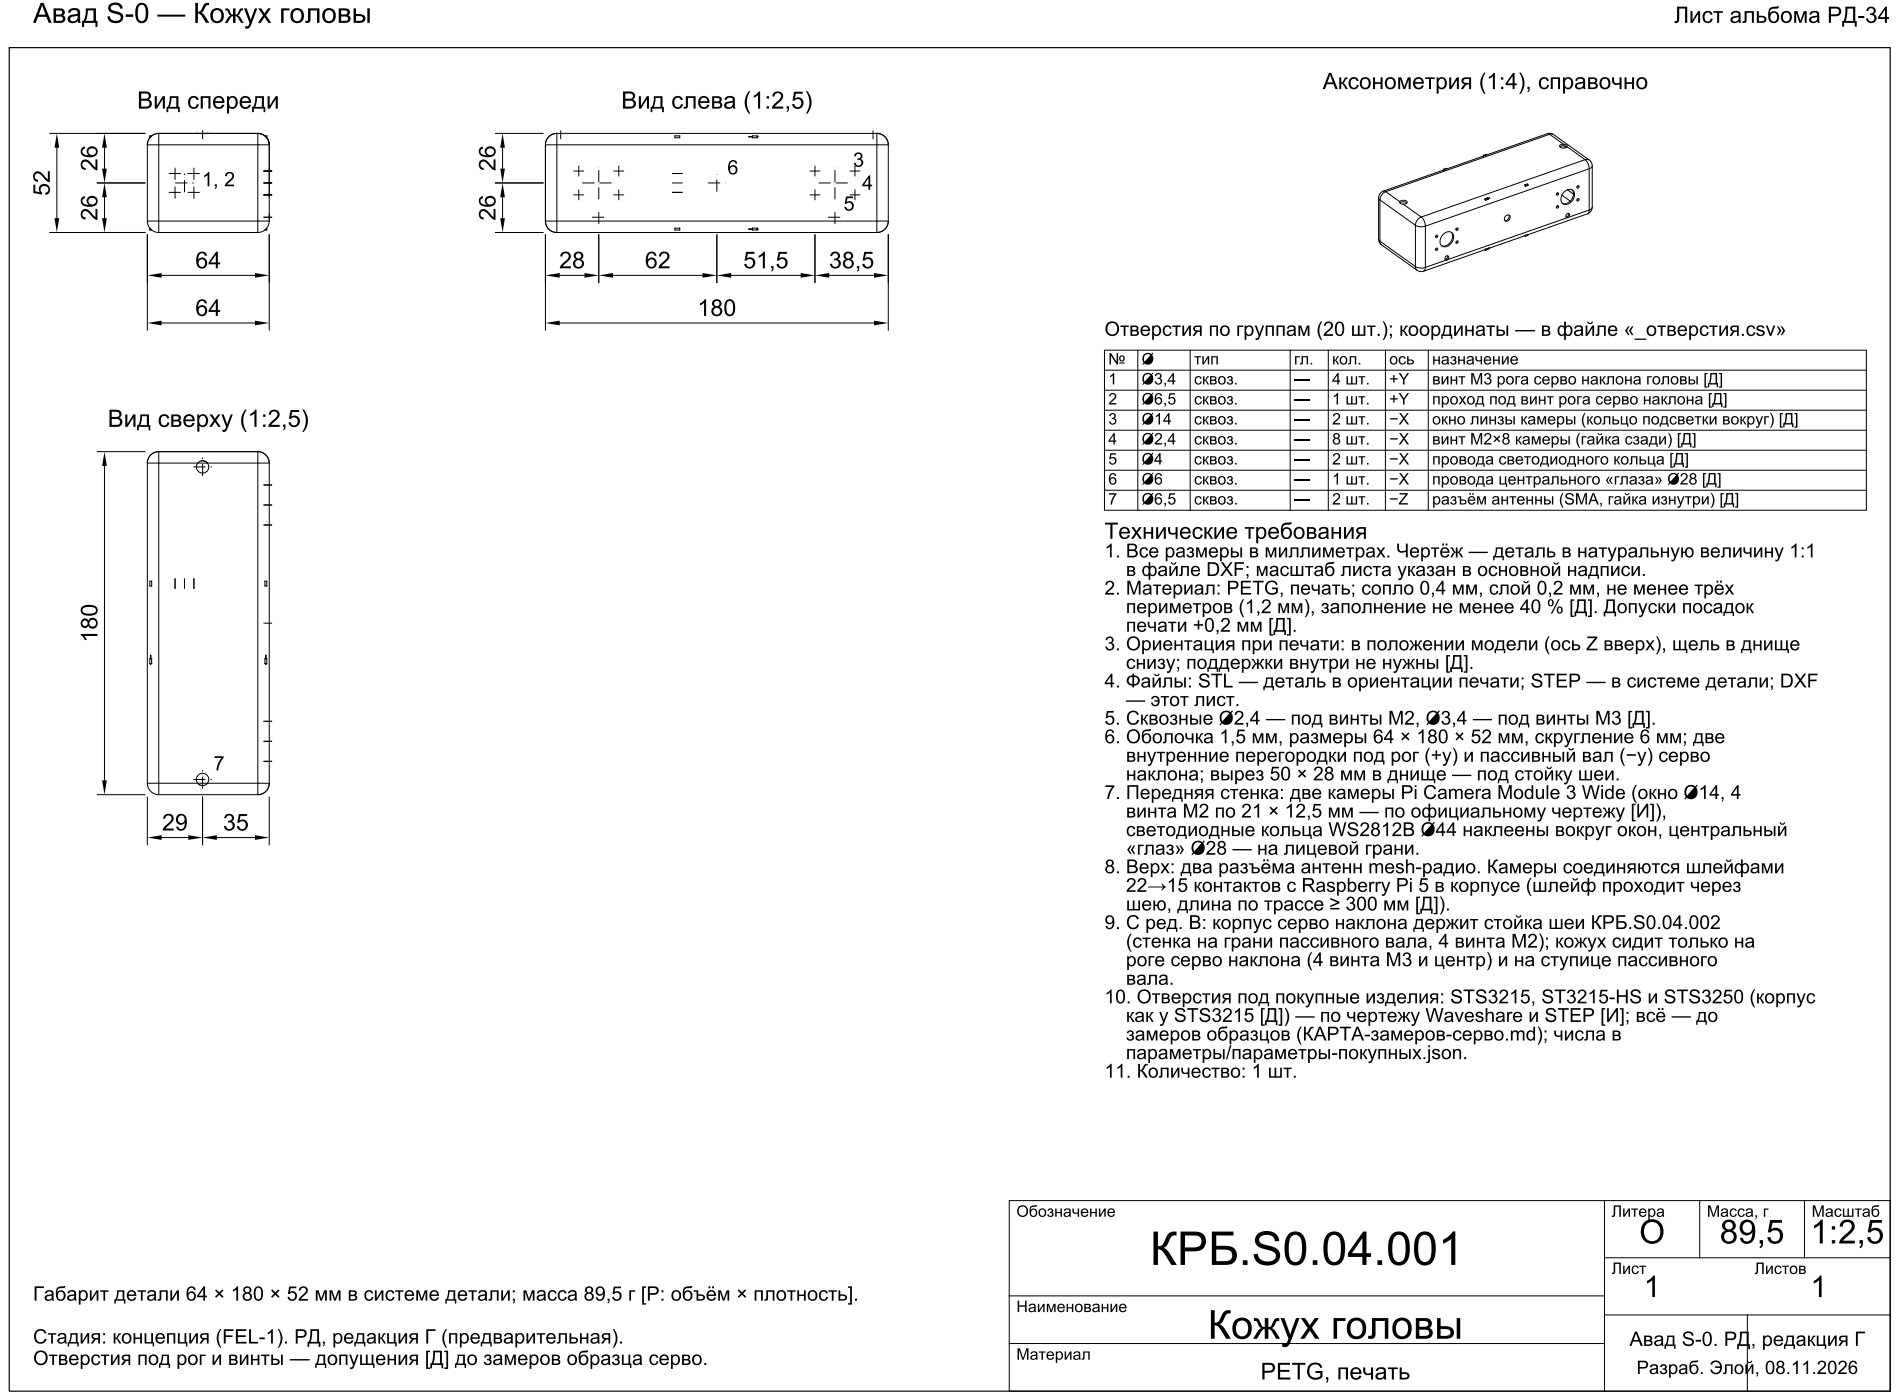
[picture p209: page 1]
