pilot443/avad-s0/parts/KRB.S0.04.002_stoika-shei.pdf

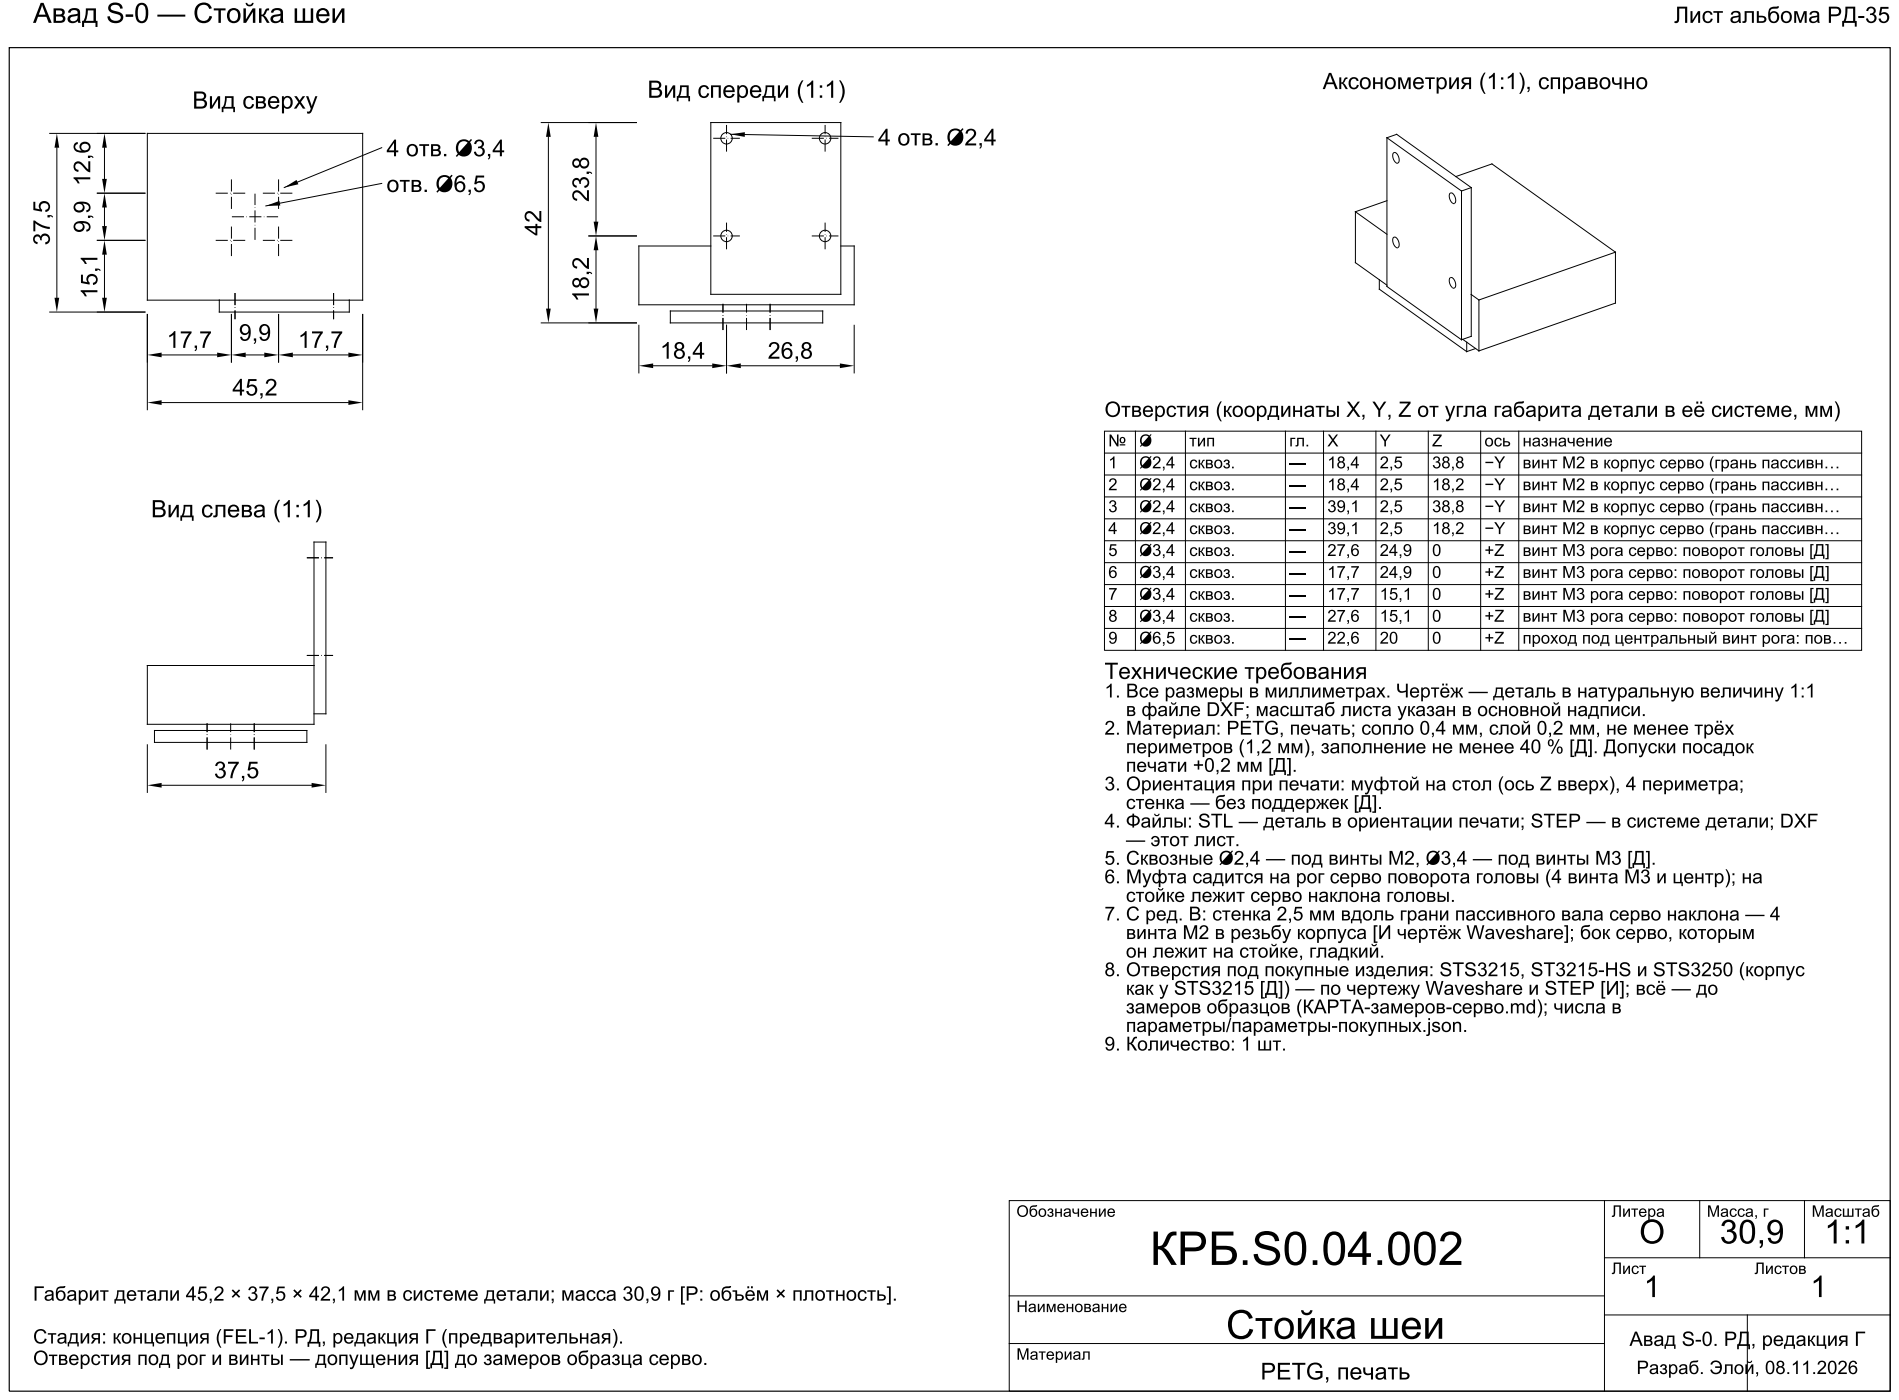
[picture p210: page 1]
