pilot443/avad-s0/parts/KRB.S0.05.001_konteiner.pdf

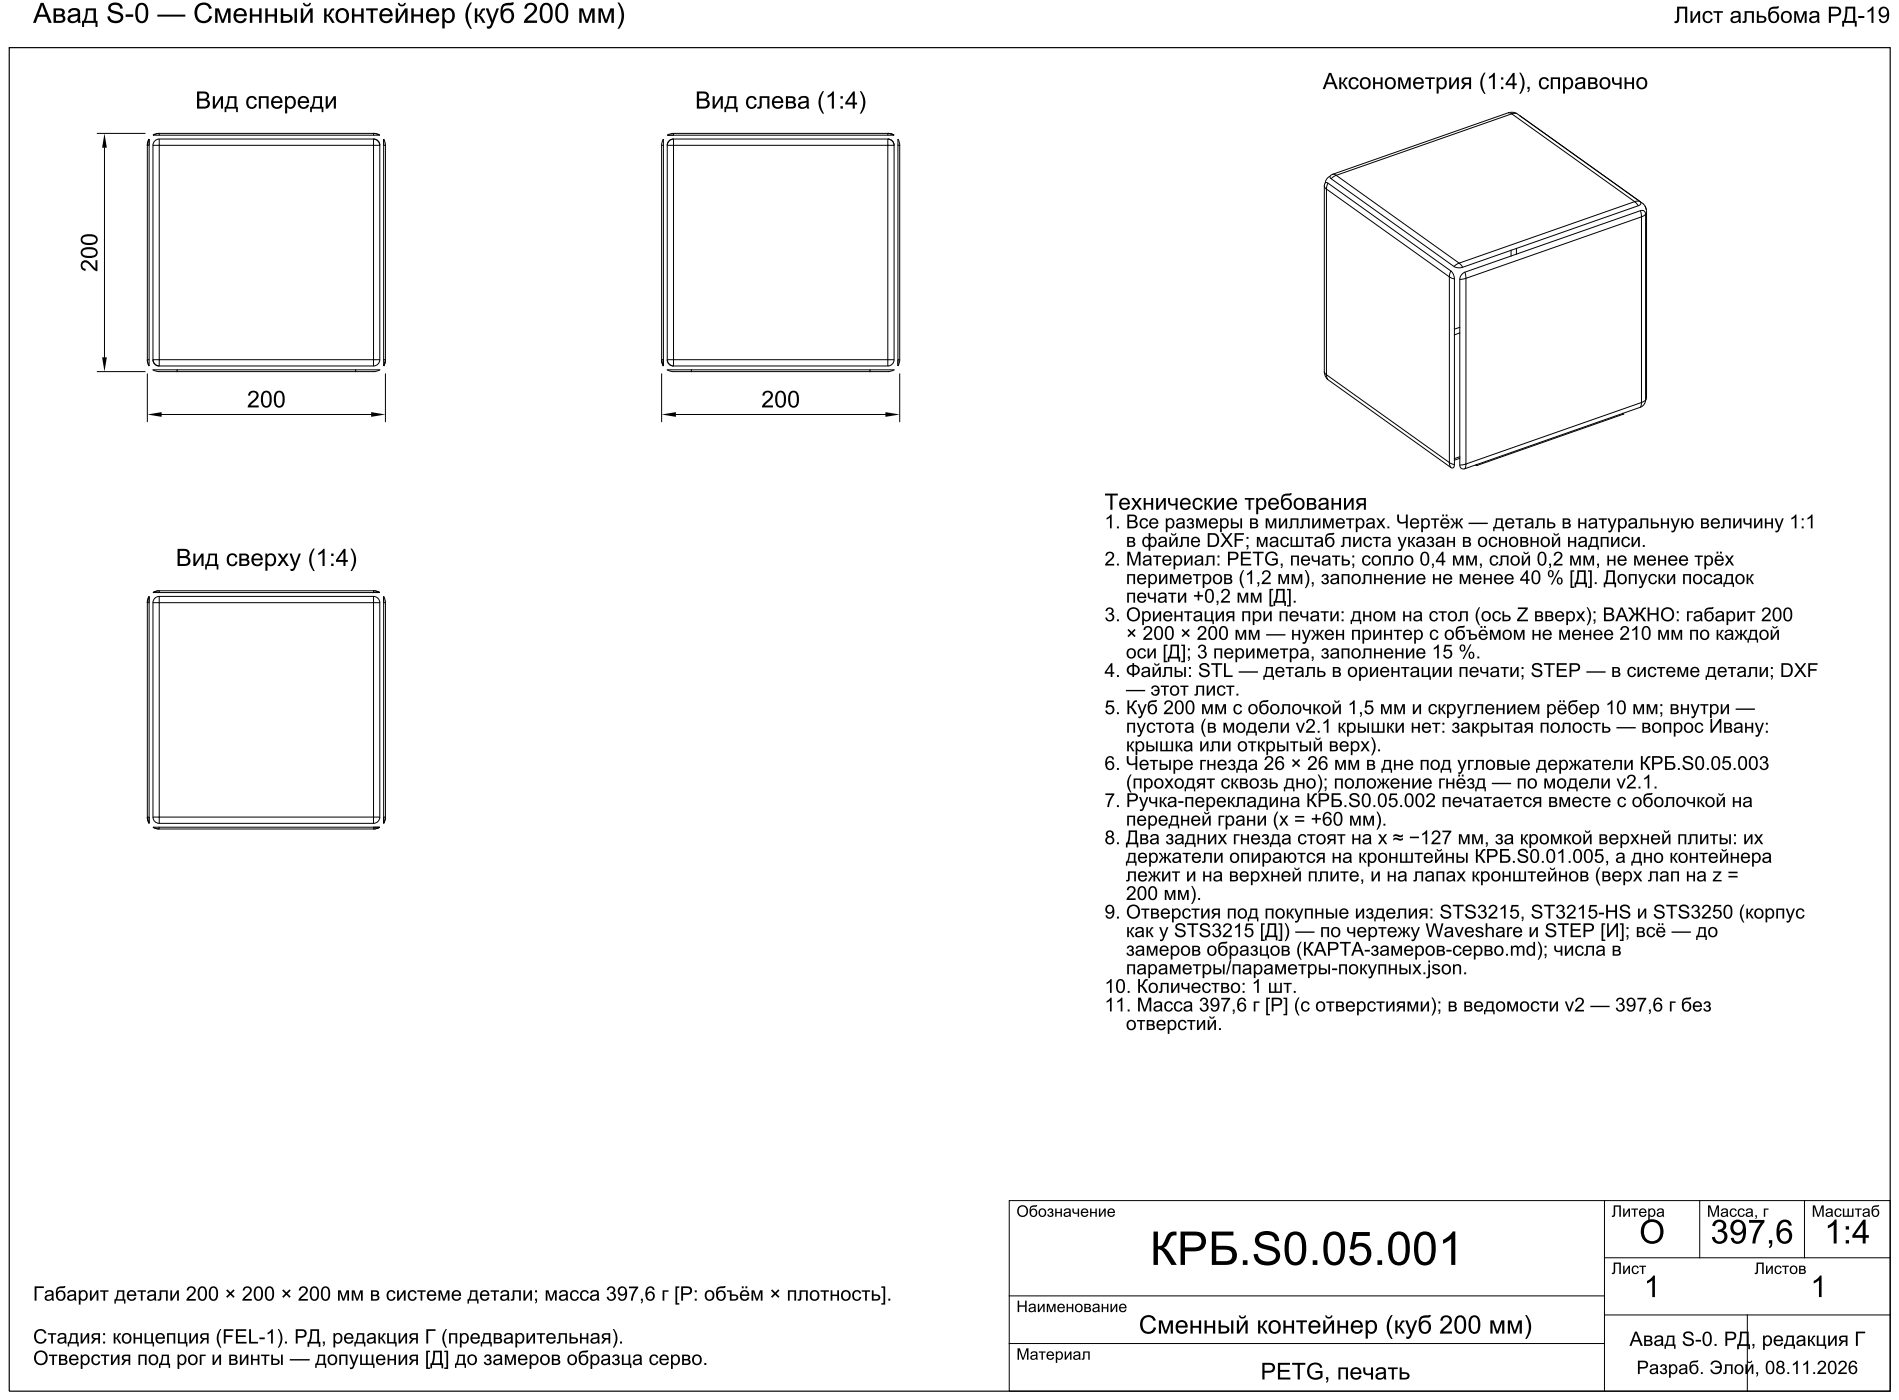
[picture p212: page 1]
