pilot443/avad-s0/parts/KRB.S0.05.002_ruchka.pdf

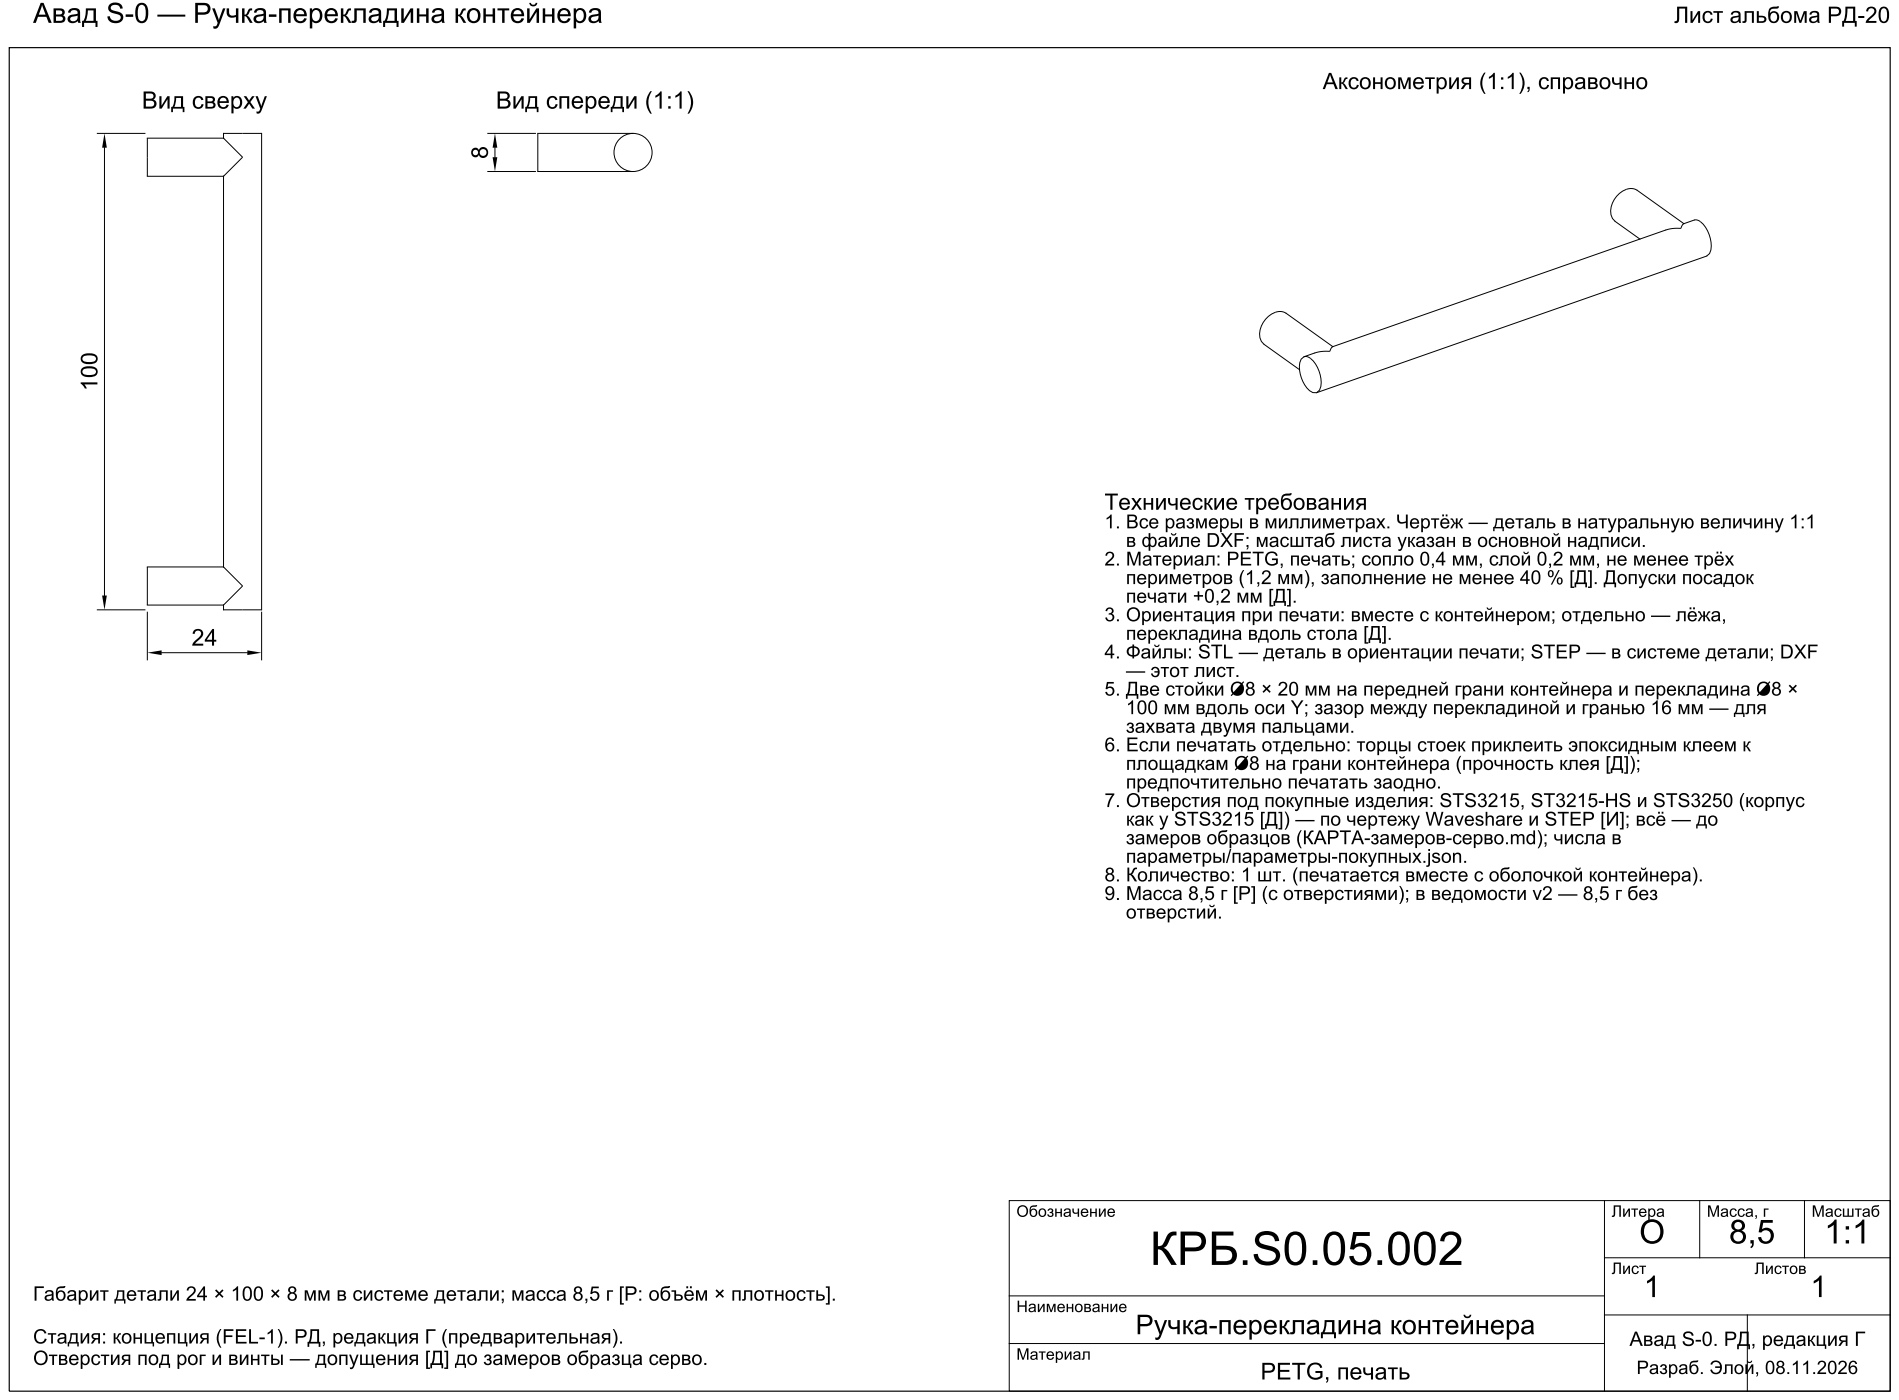
[picture p213: page 1]
