pilot443/avad-s0/parts/KRB.S0.05.003_derzhatel.pdf

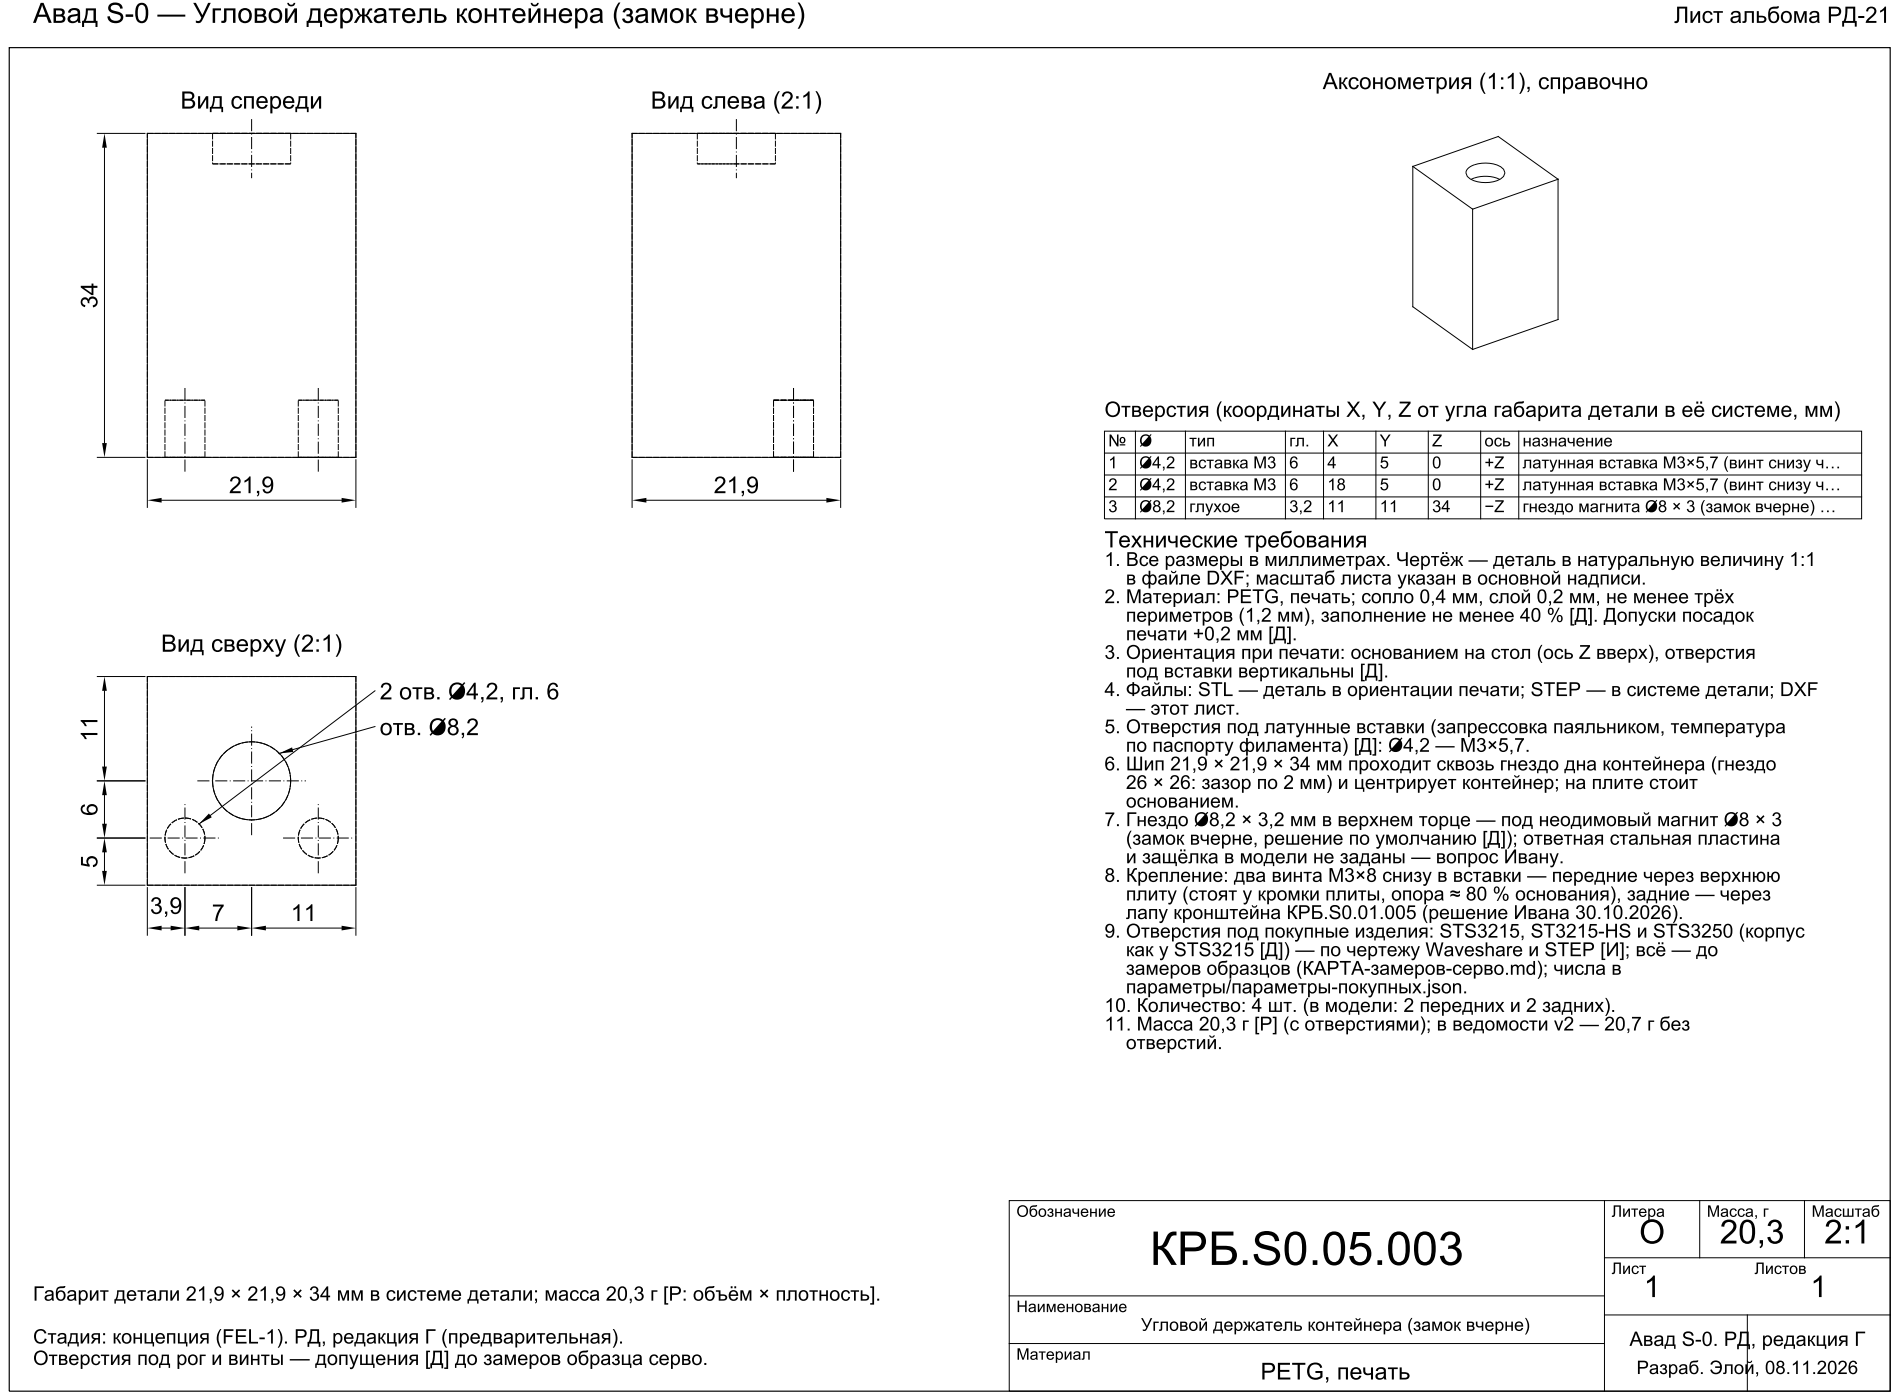
[picture p214: page 1]
