pilot443/avad-s0/parts/KRB.S0.06.001_lotok-batarei.pdf

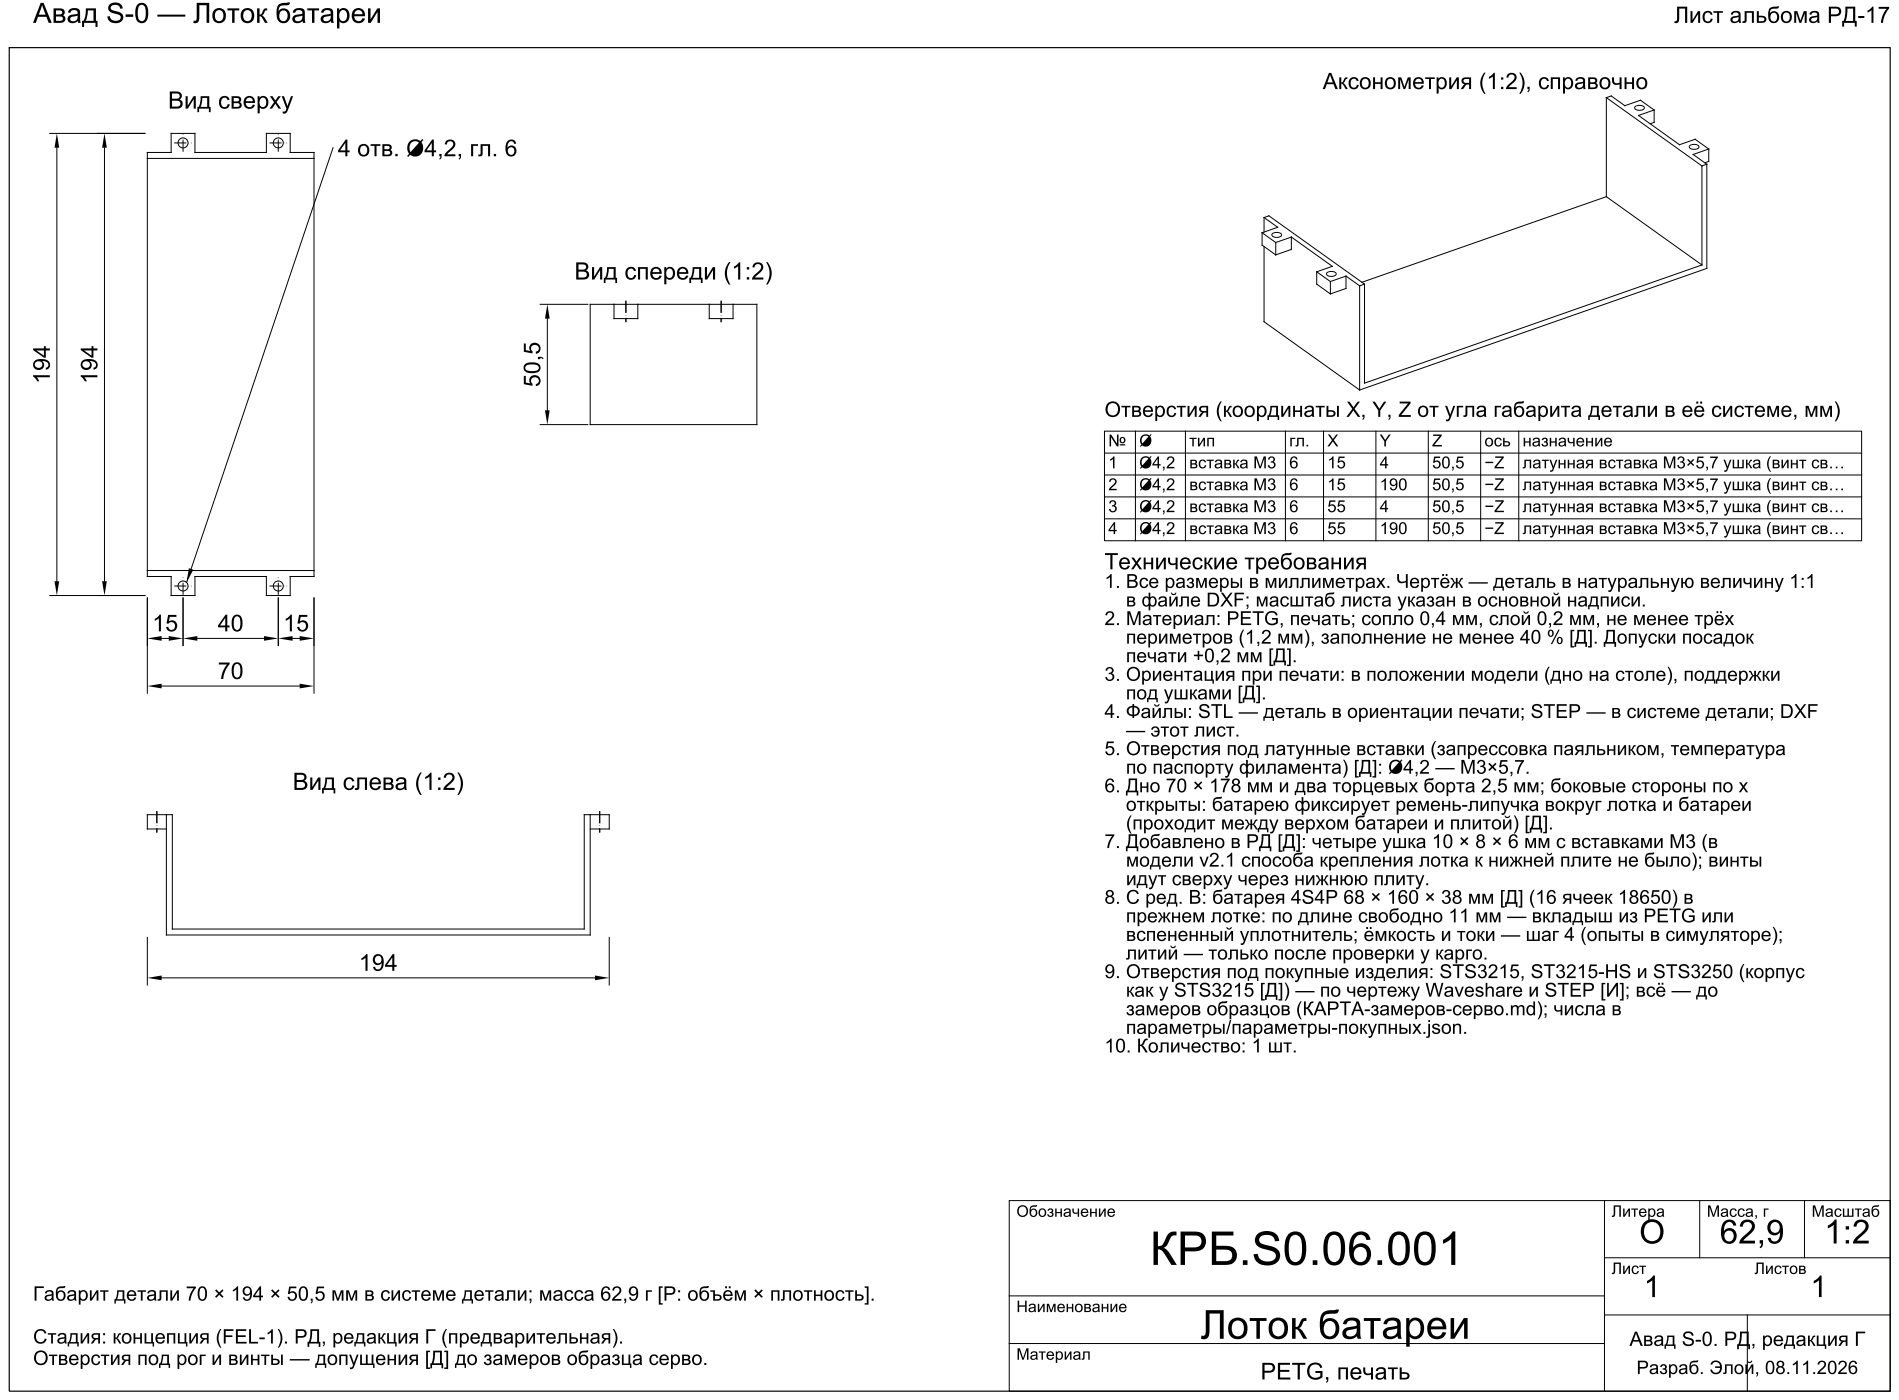
[picture p215: page 1]
