pilot443/avad-s0/purchased-parts/KRB.S0.90.001_servo-STS3215.pdf

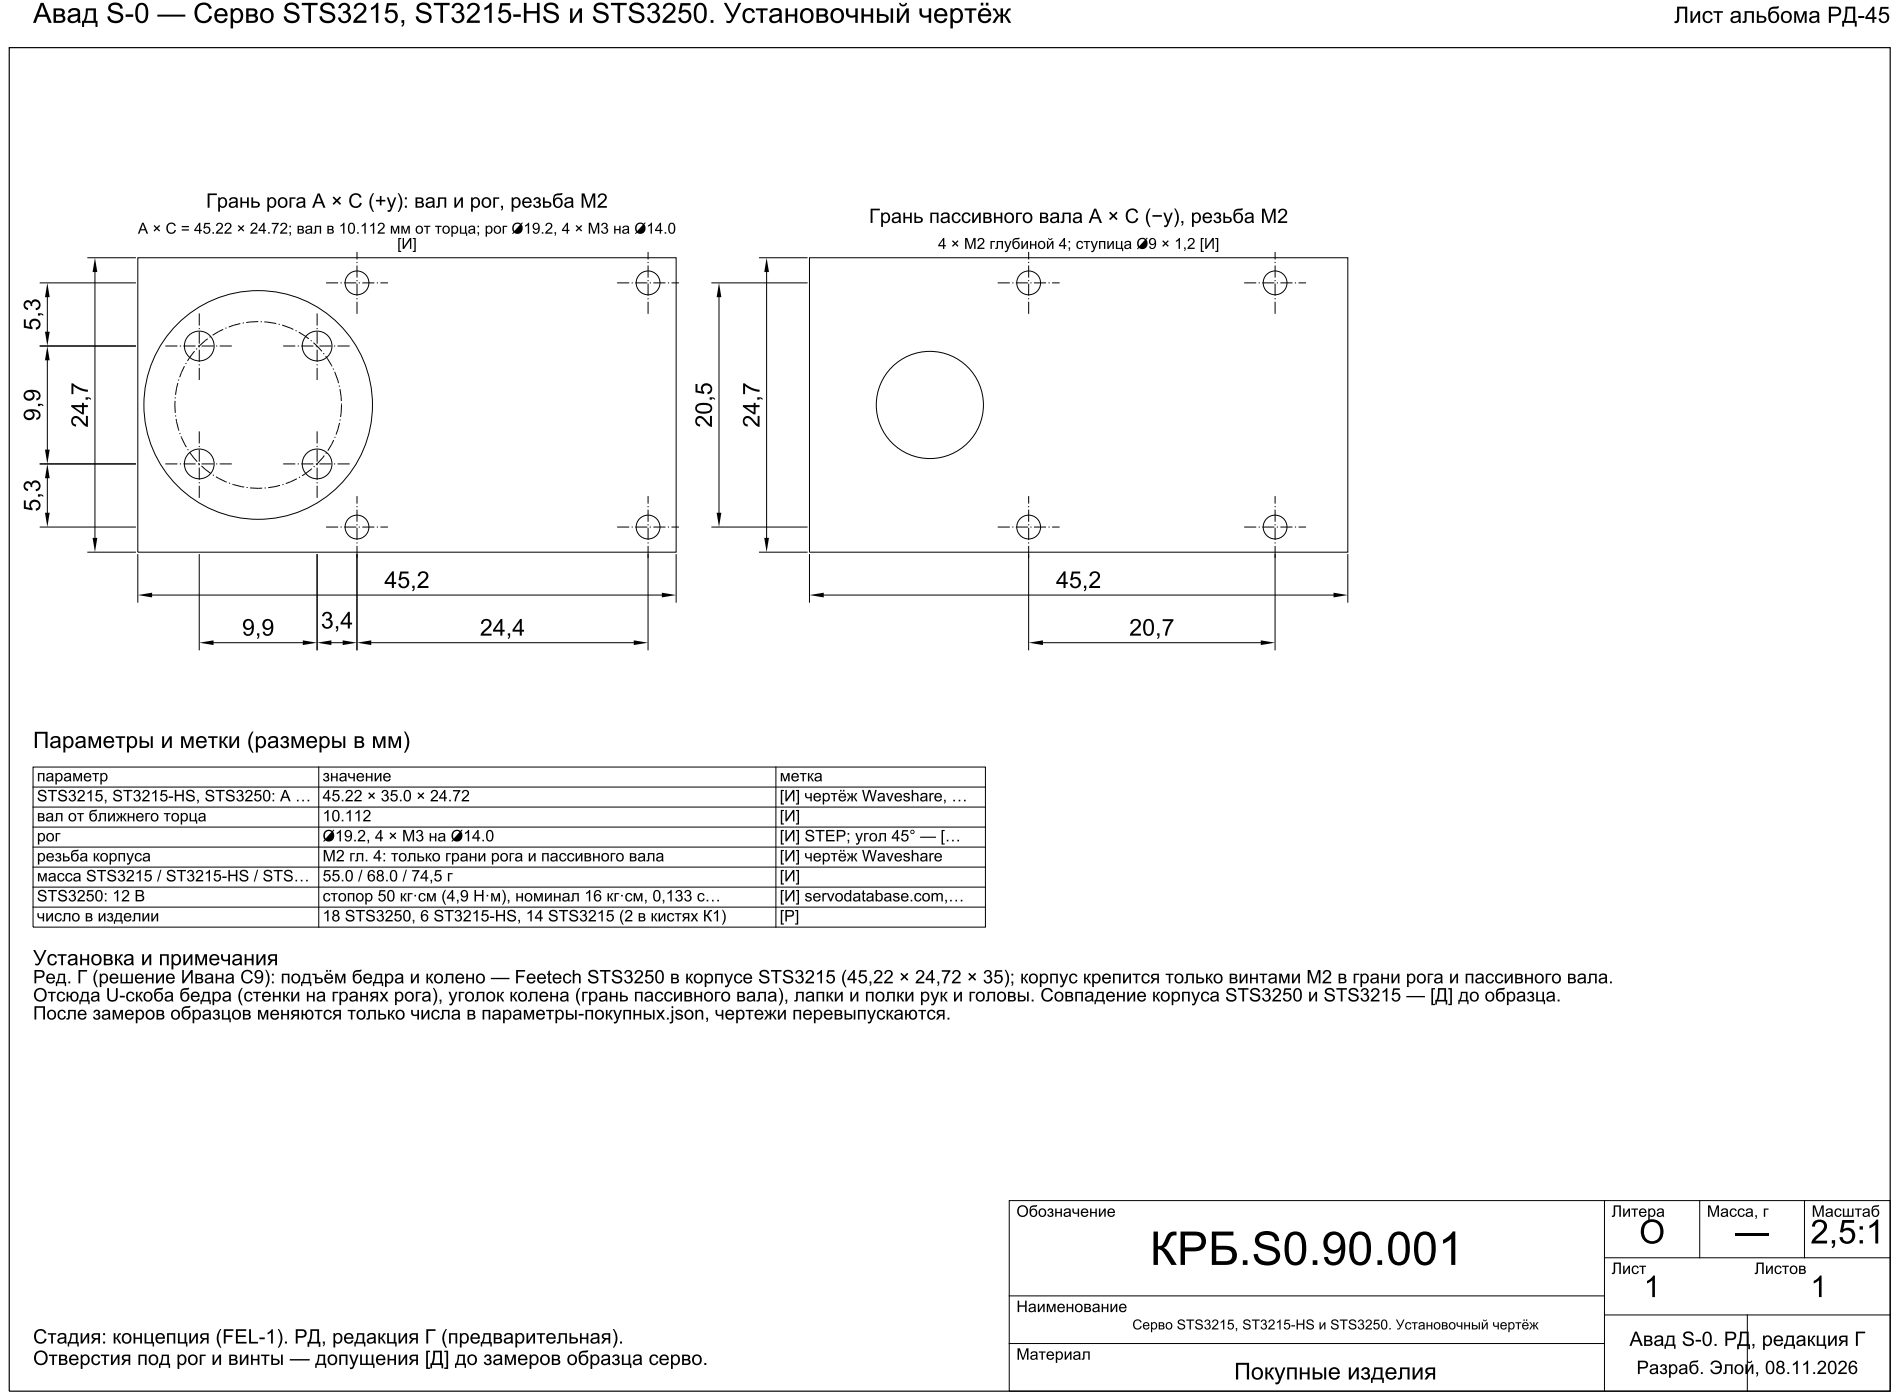
[picture p216: page 1]
