pilot443/avad-s0/purchased-parts/KRB.S0.90.002_batareya-lotok.pdf

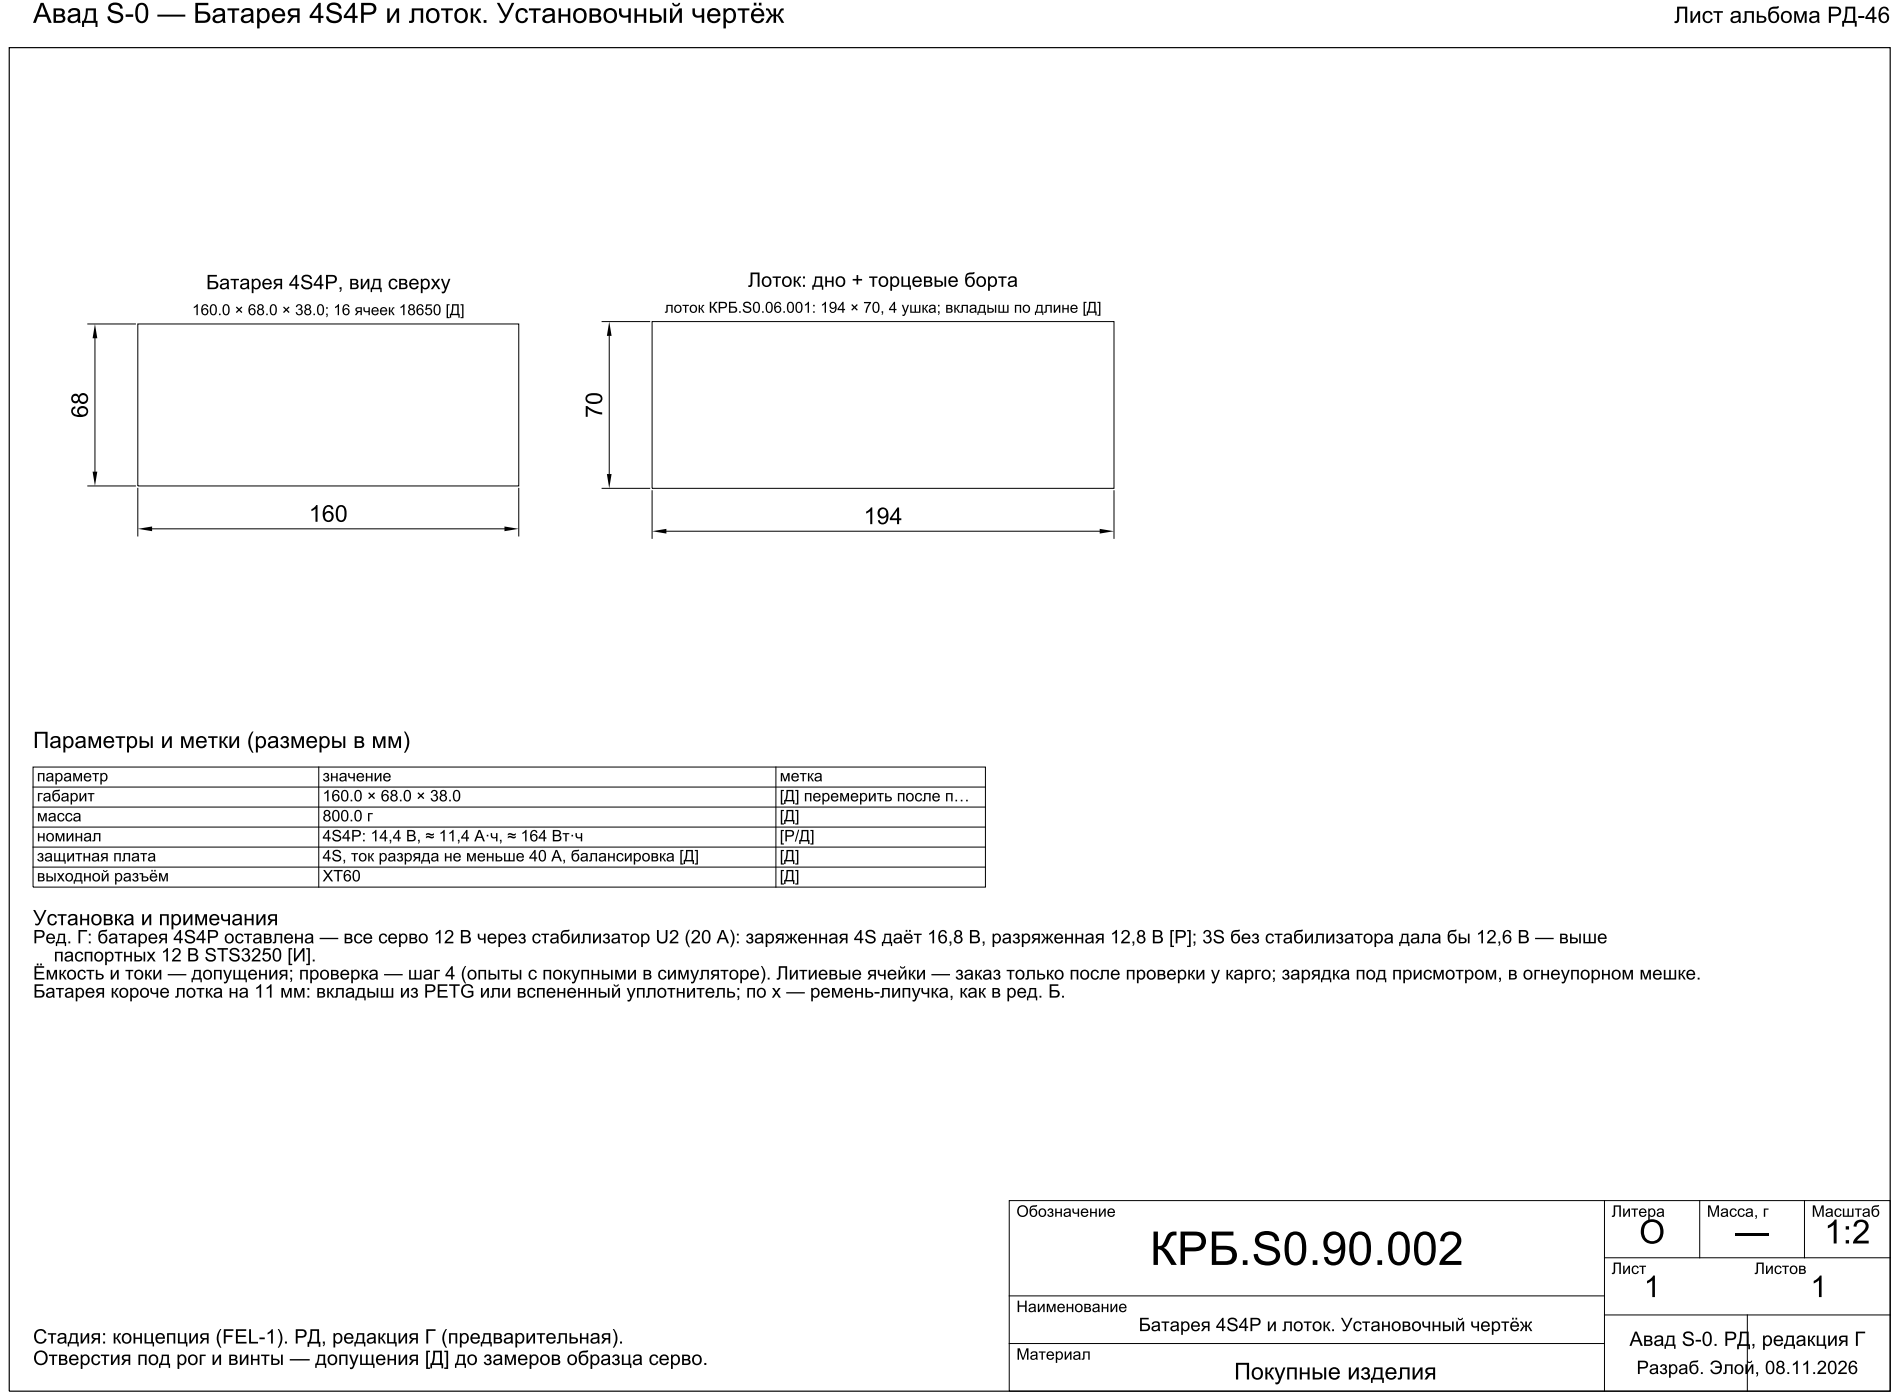
[picture p217: page 1]
