pilot443/avad-s0/purchased-parts/KRB.S0.90.003_pi5-pico.pdf

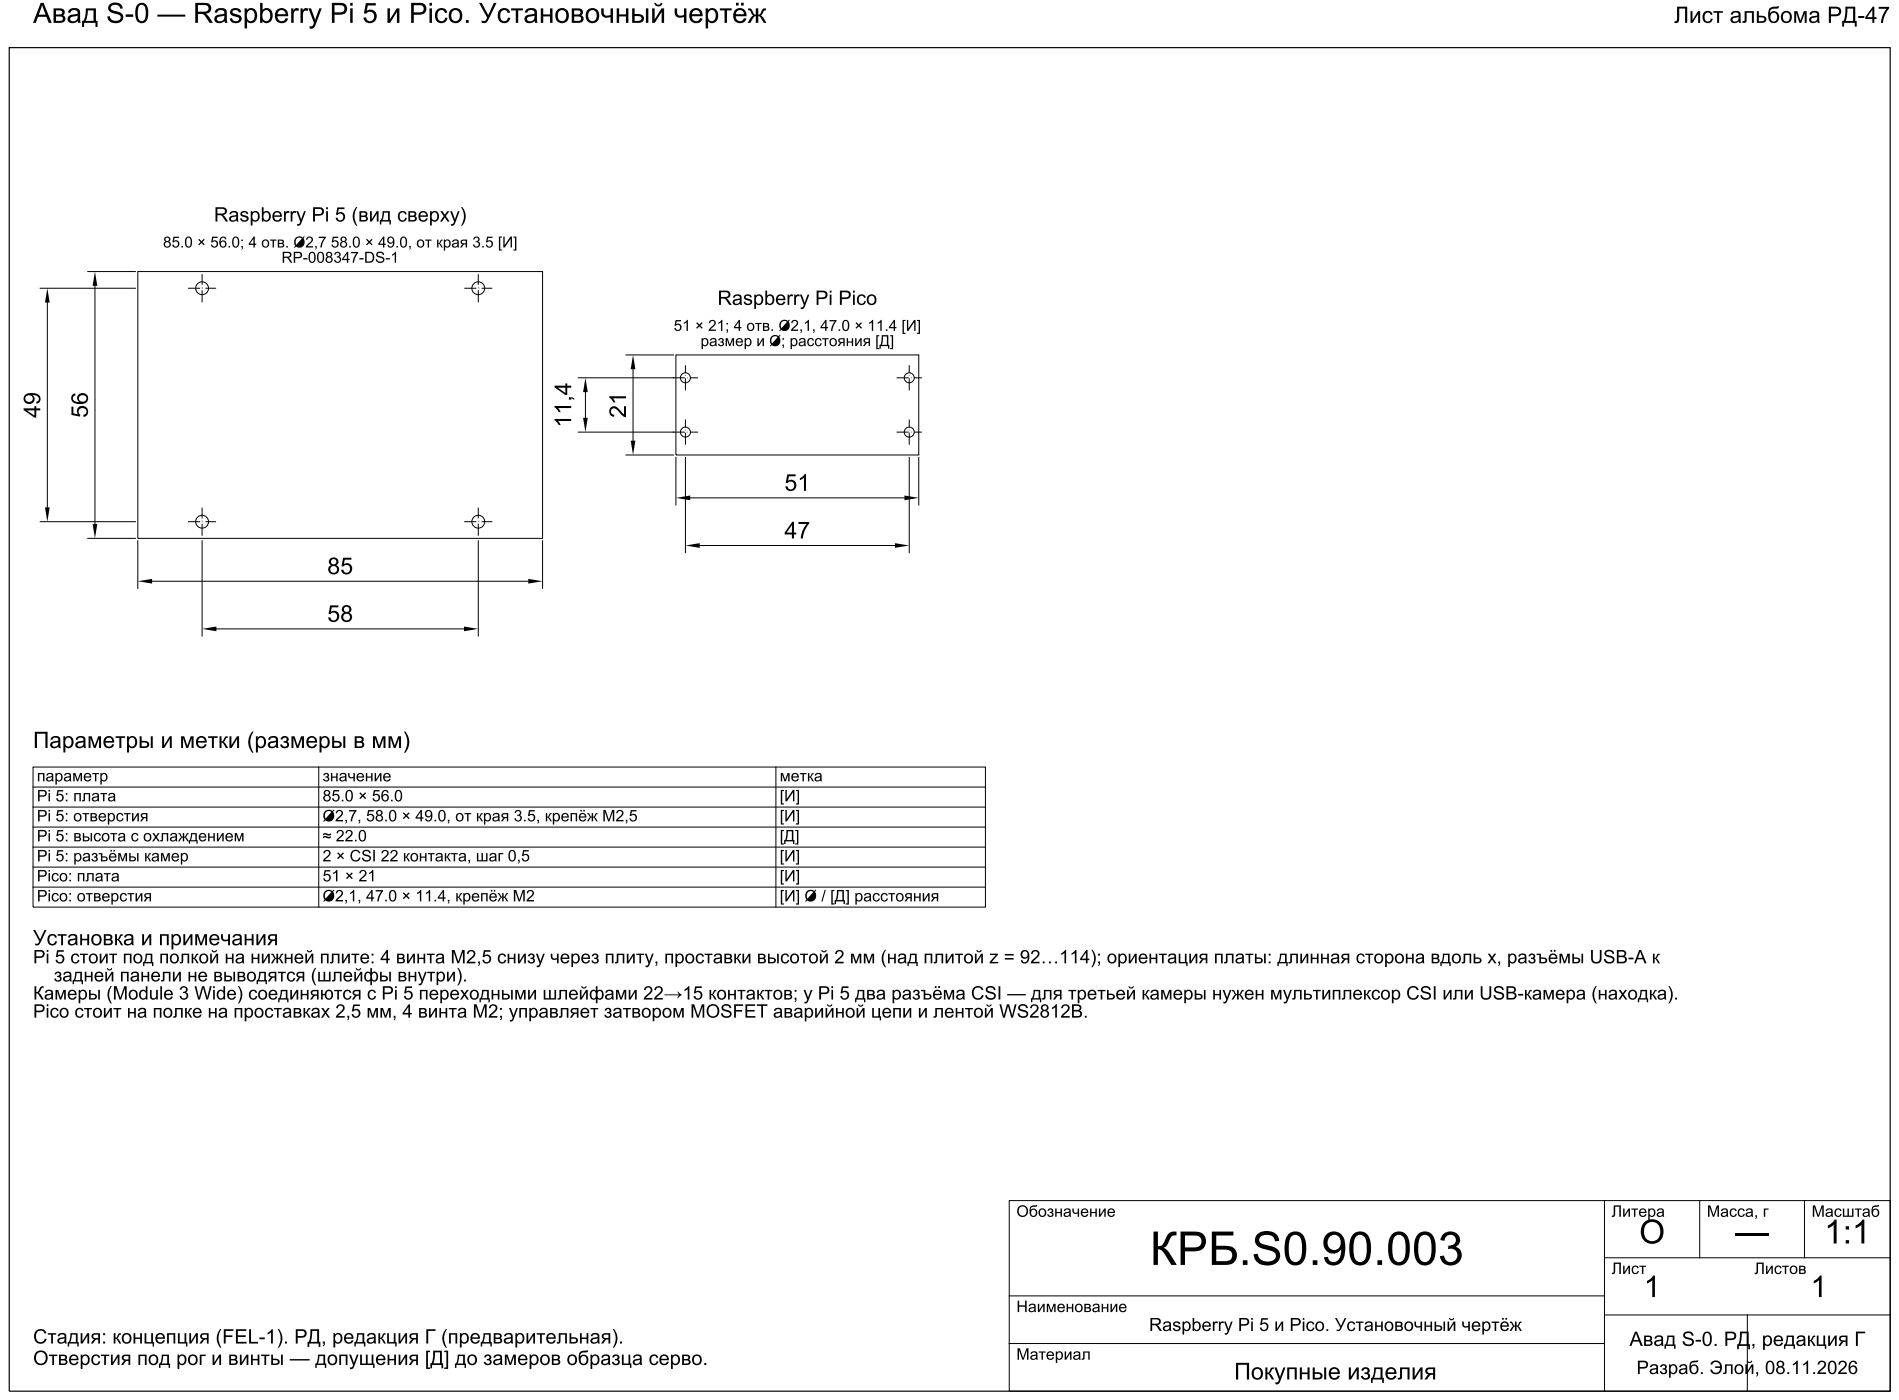
[picture p218: page 1]
