pilot443/avad-s0/purchased-parts/KRB.S0.90.004_kamera-koltsa.pdf

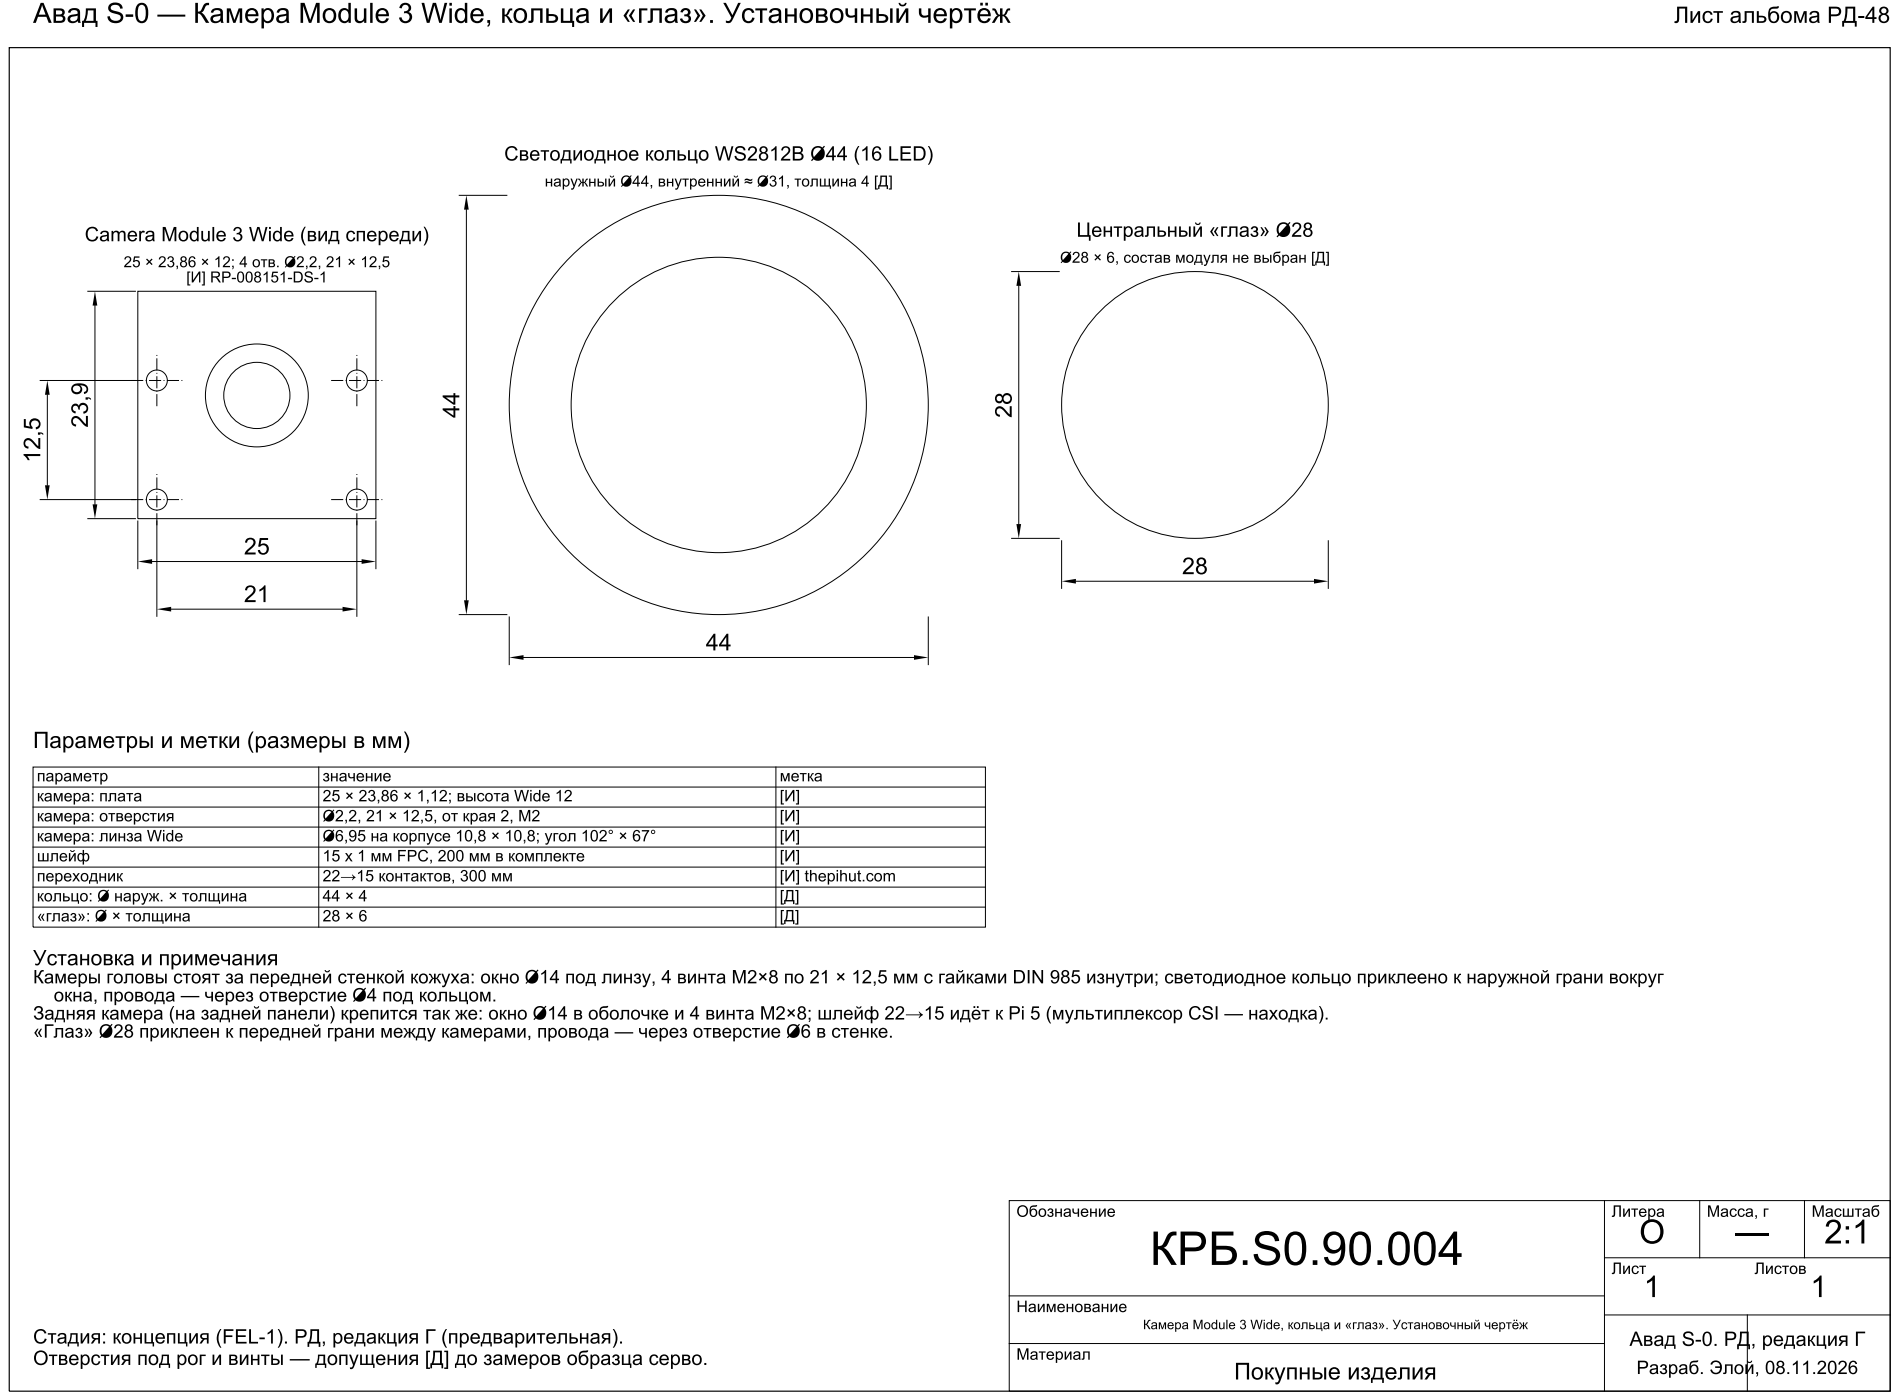
[picture p219: page 1]
