pilot443/avad-s0/purchased-parts/KRB.S0.90.005_datchiki-zvuk.pdf

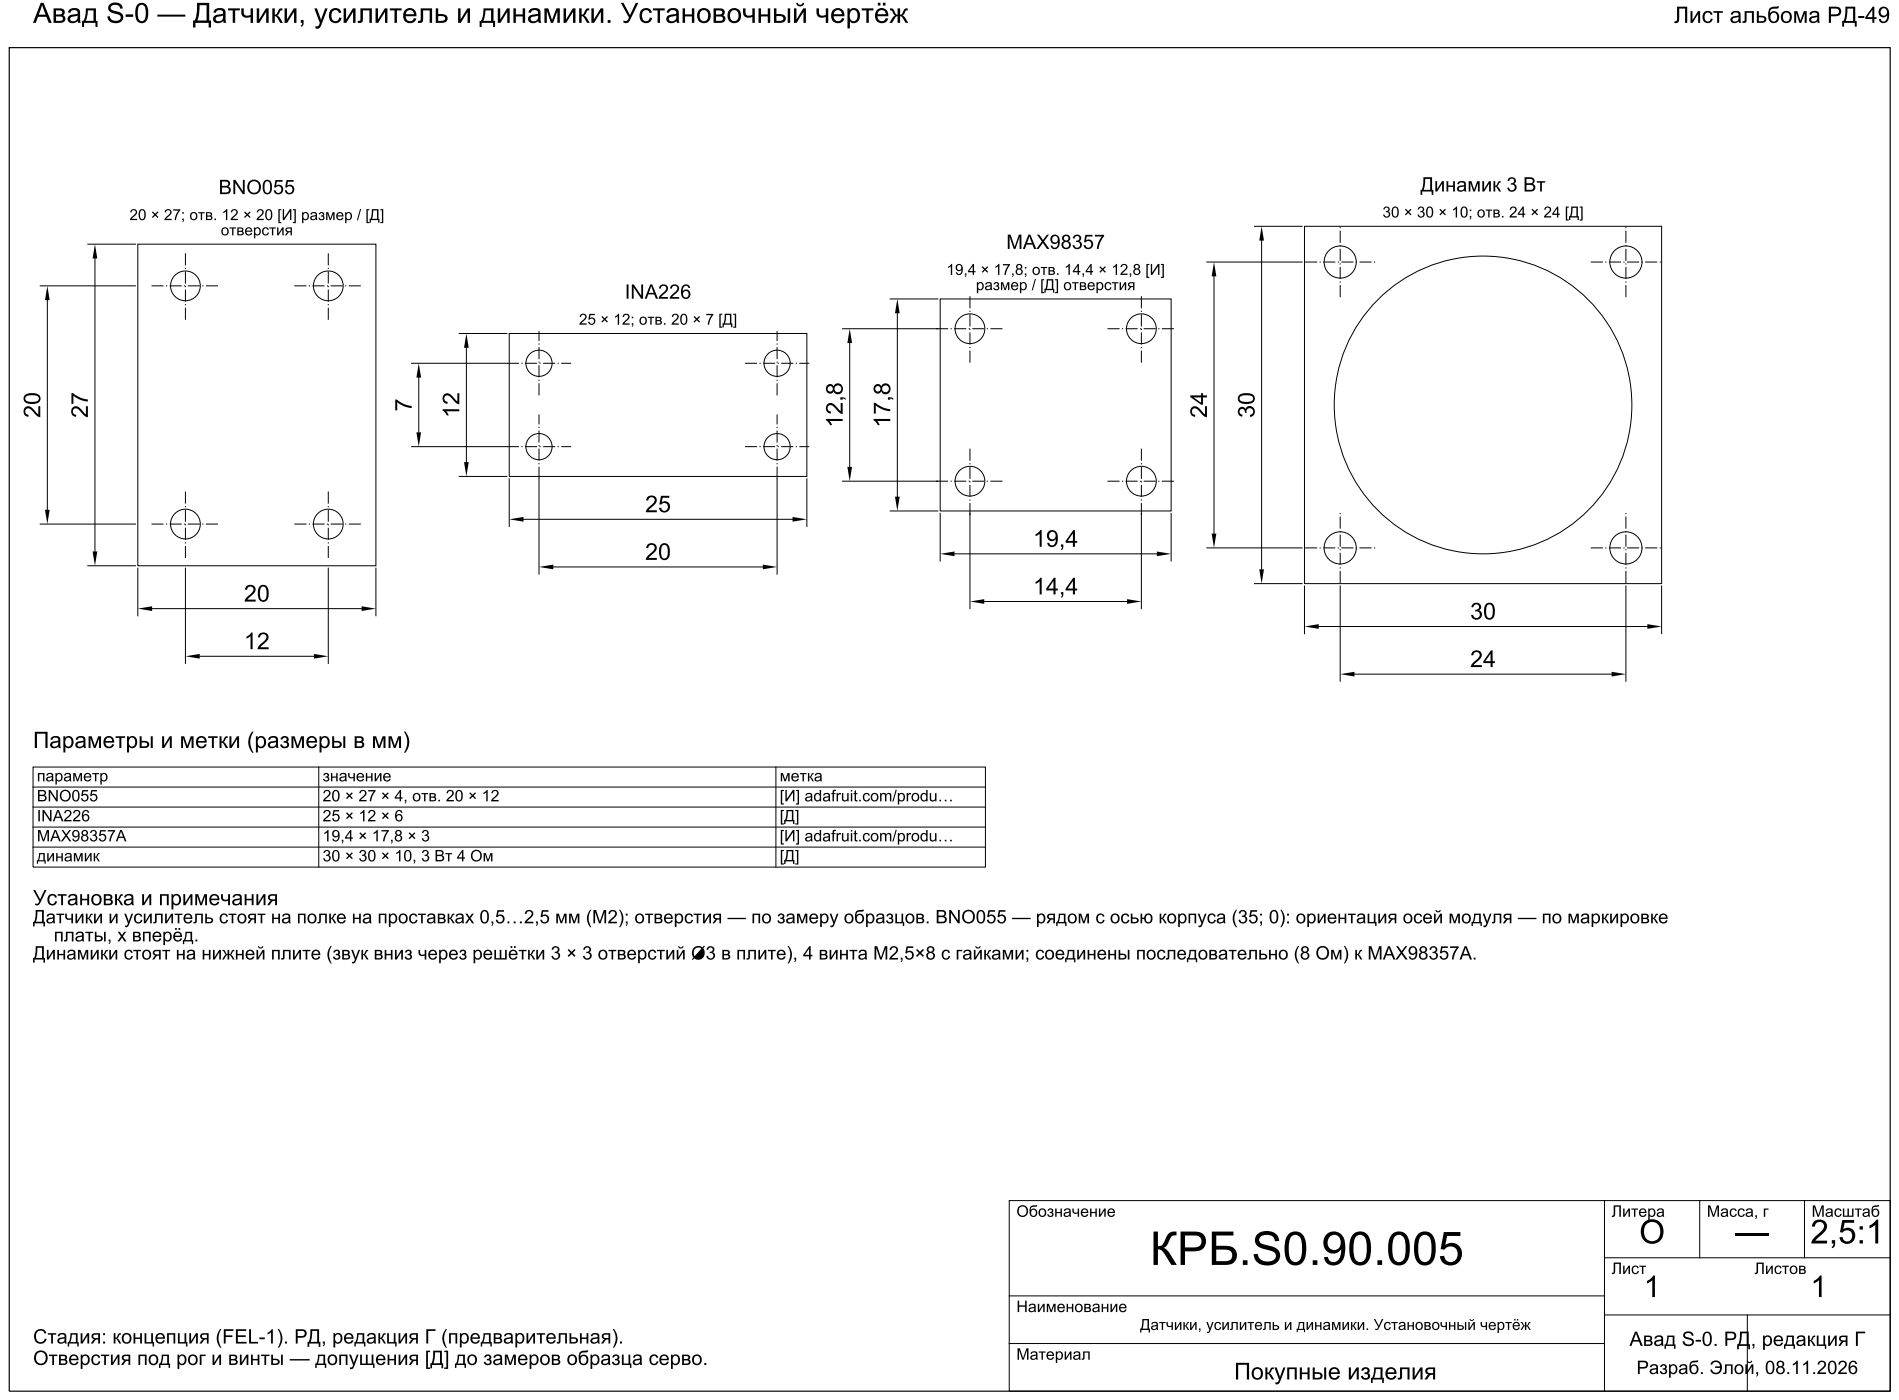
[picture p220: page 1]
