pilot443/avad-s0/purchased-parts/KRB.S0.90.006_pitanie-bezopasnost.pdf

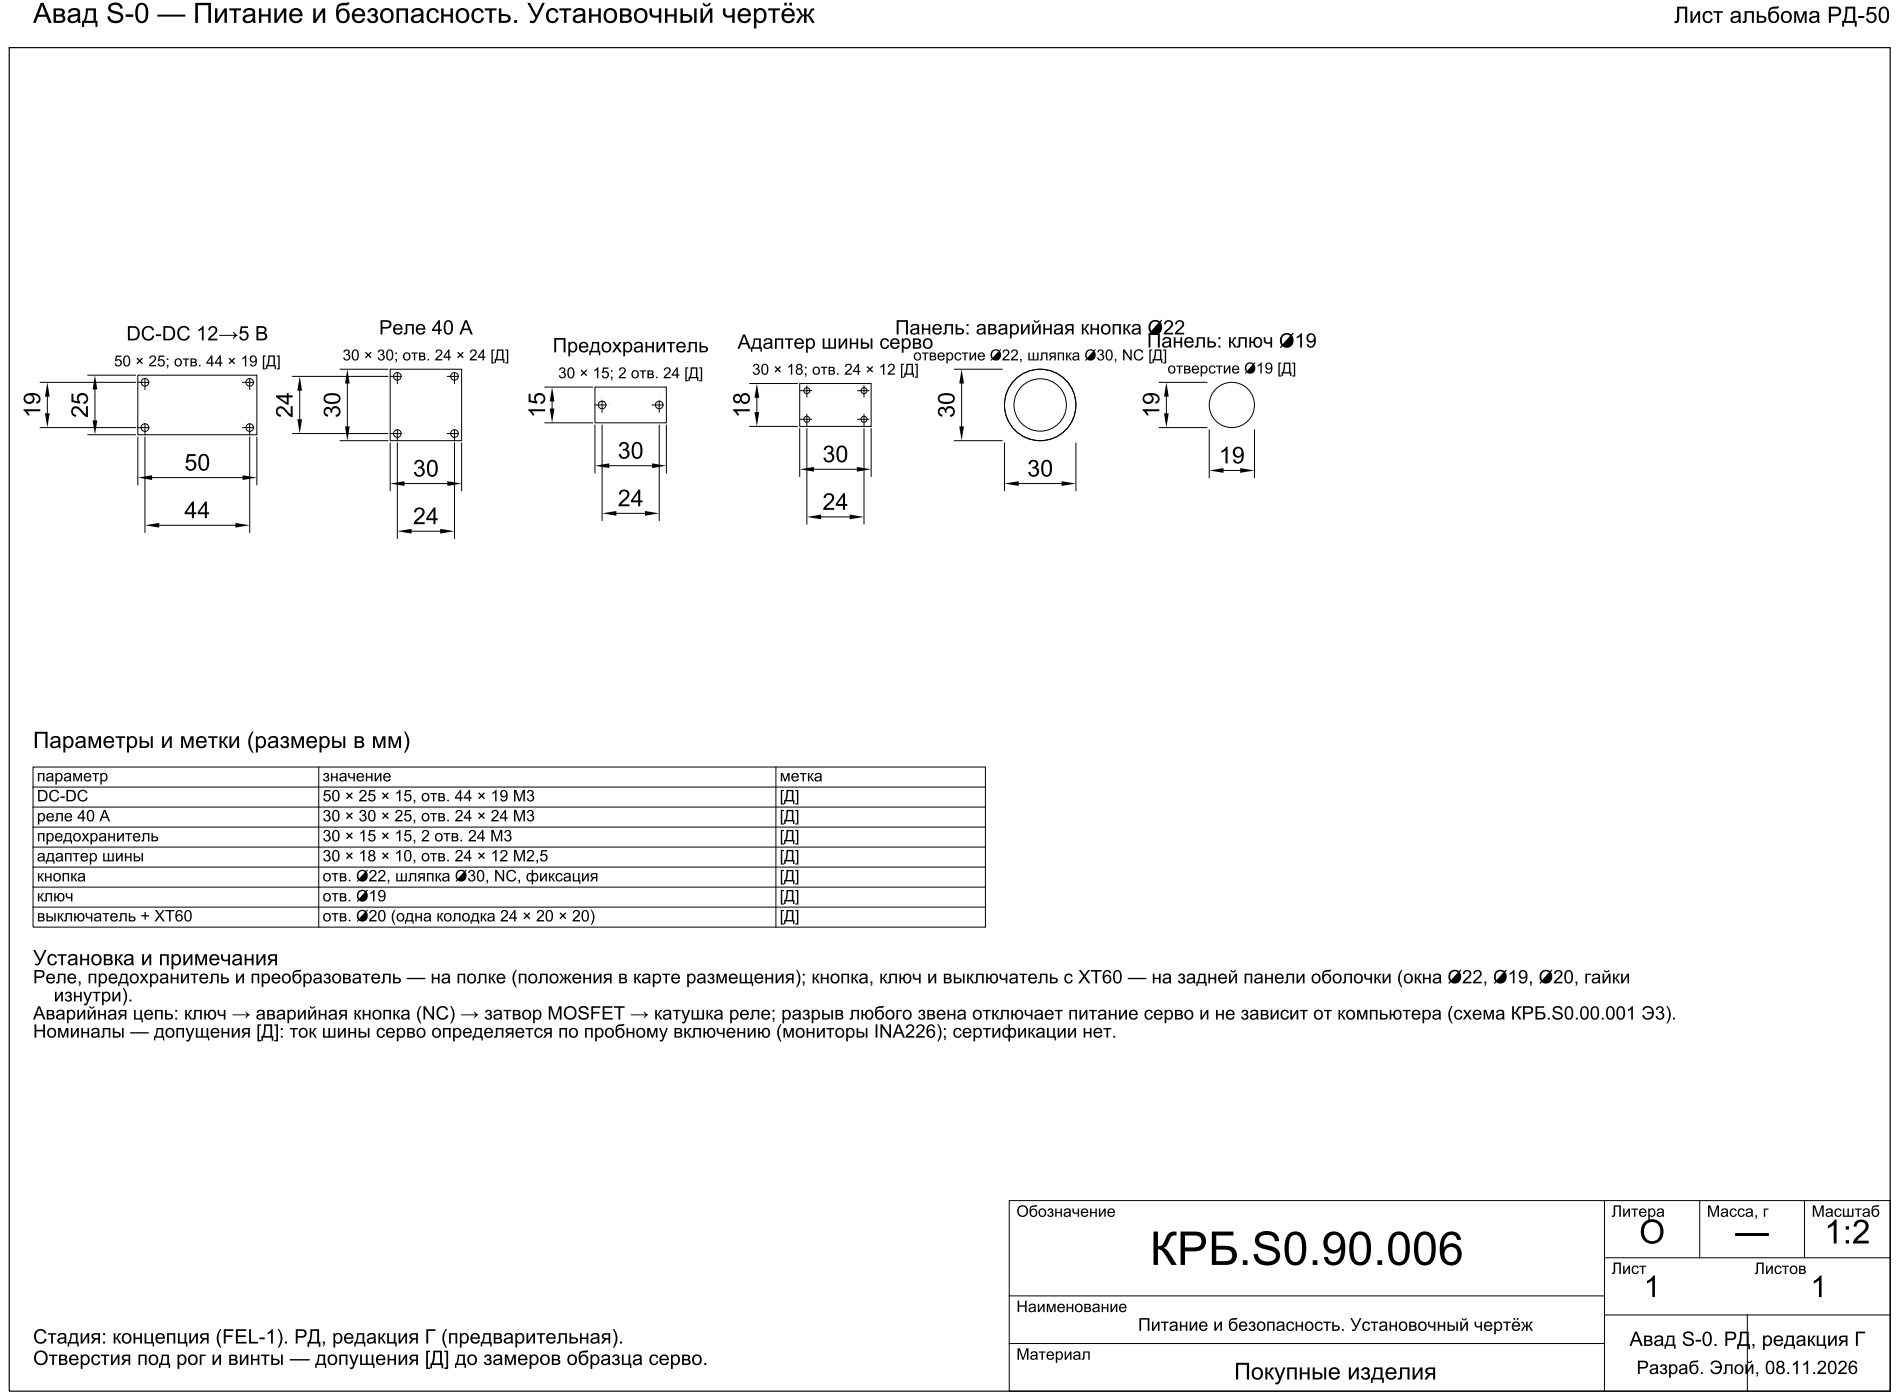
[picture p221: page 1]
