pilot443/avad-s0/wrist-tools/assemblies/KRB.S0.07.100_SB.pdf

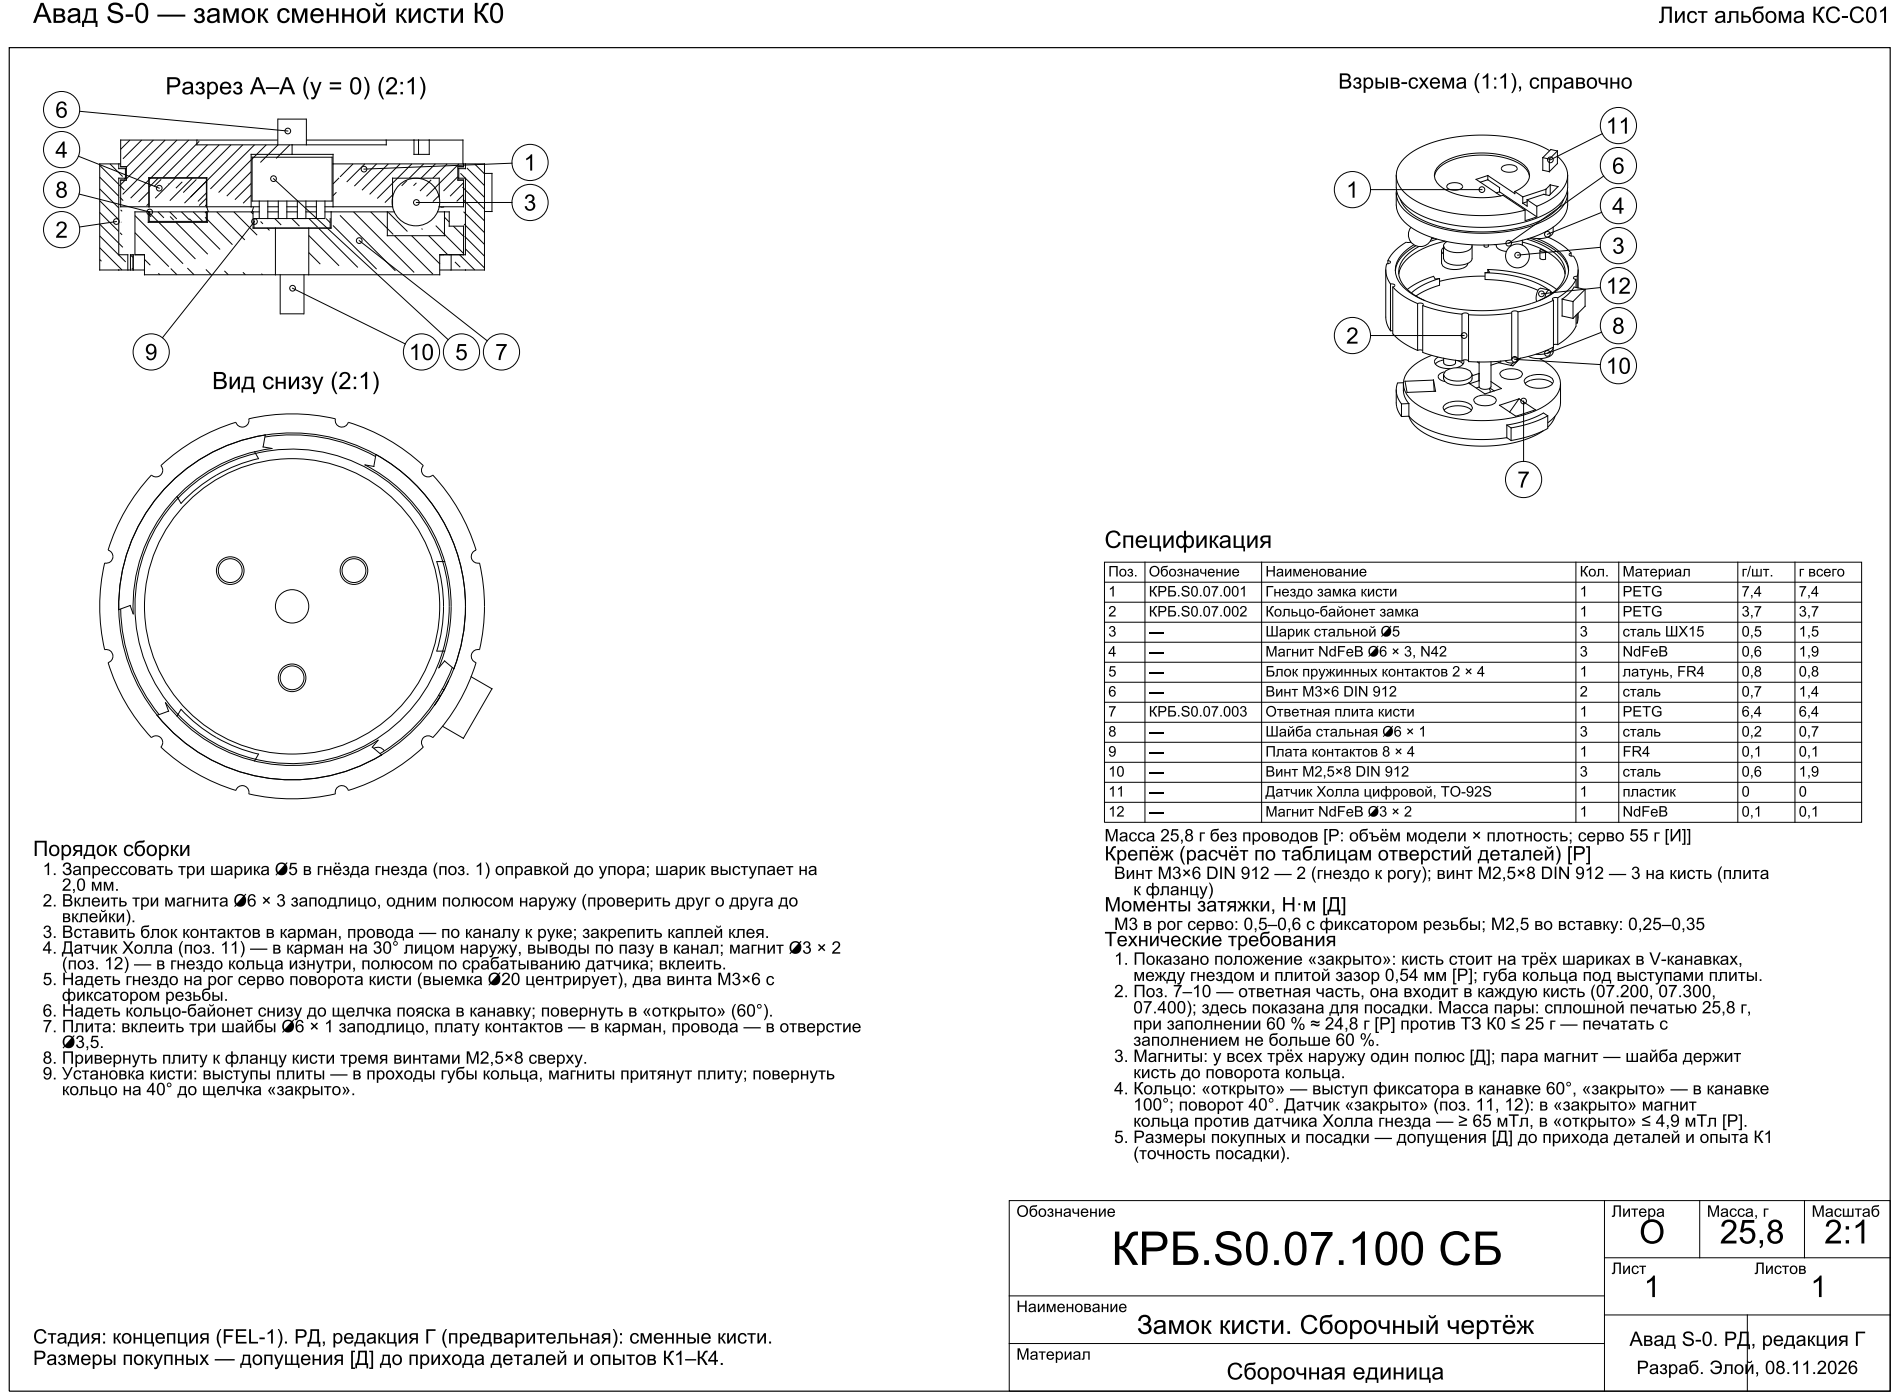
[picture p222: page 1]
