pilot443/avad-s0/wrist-tools/assemblies/KRB.S0.07.200_SB.pdf

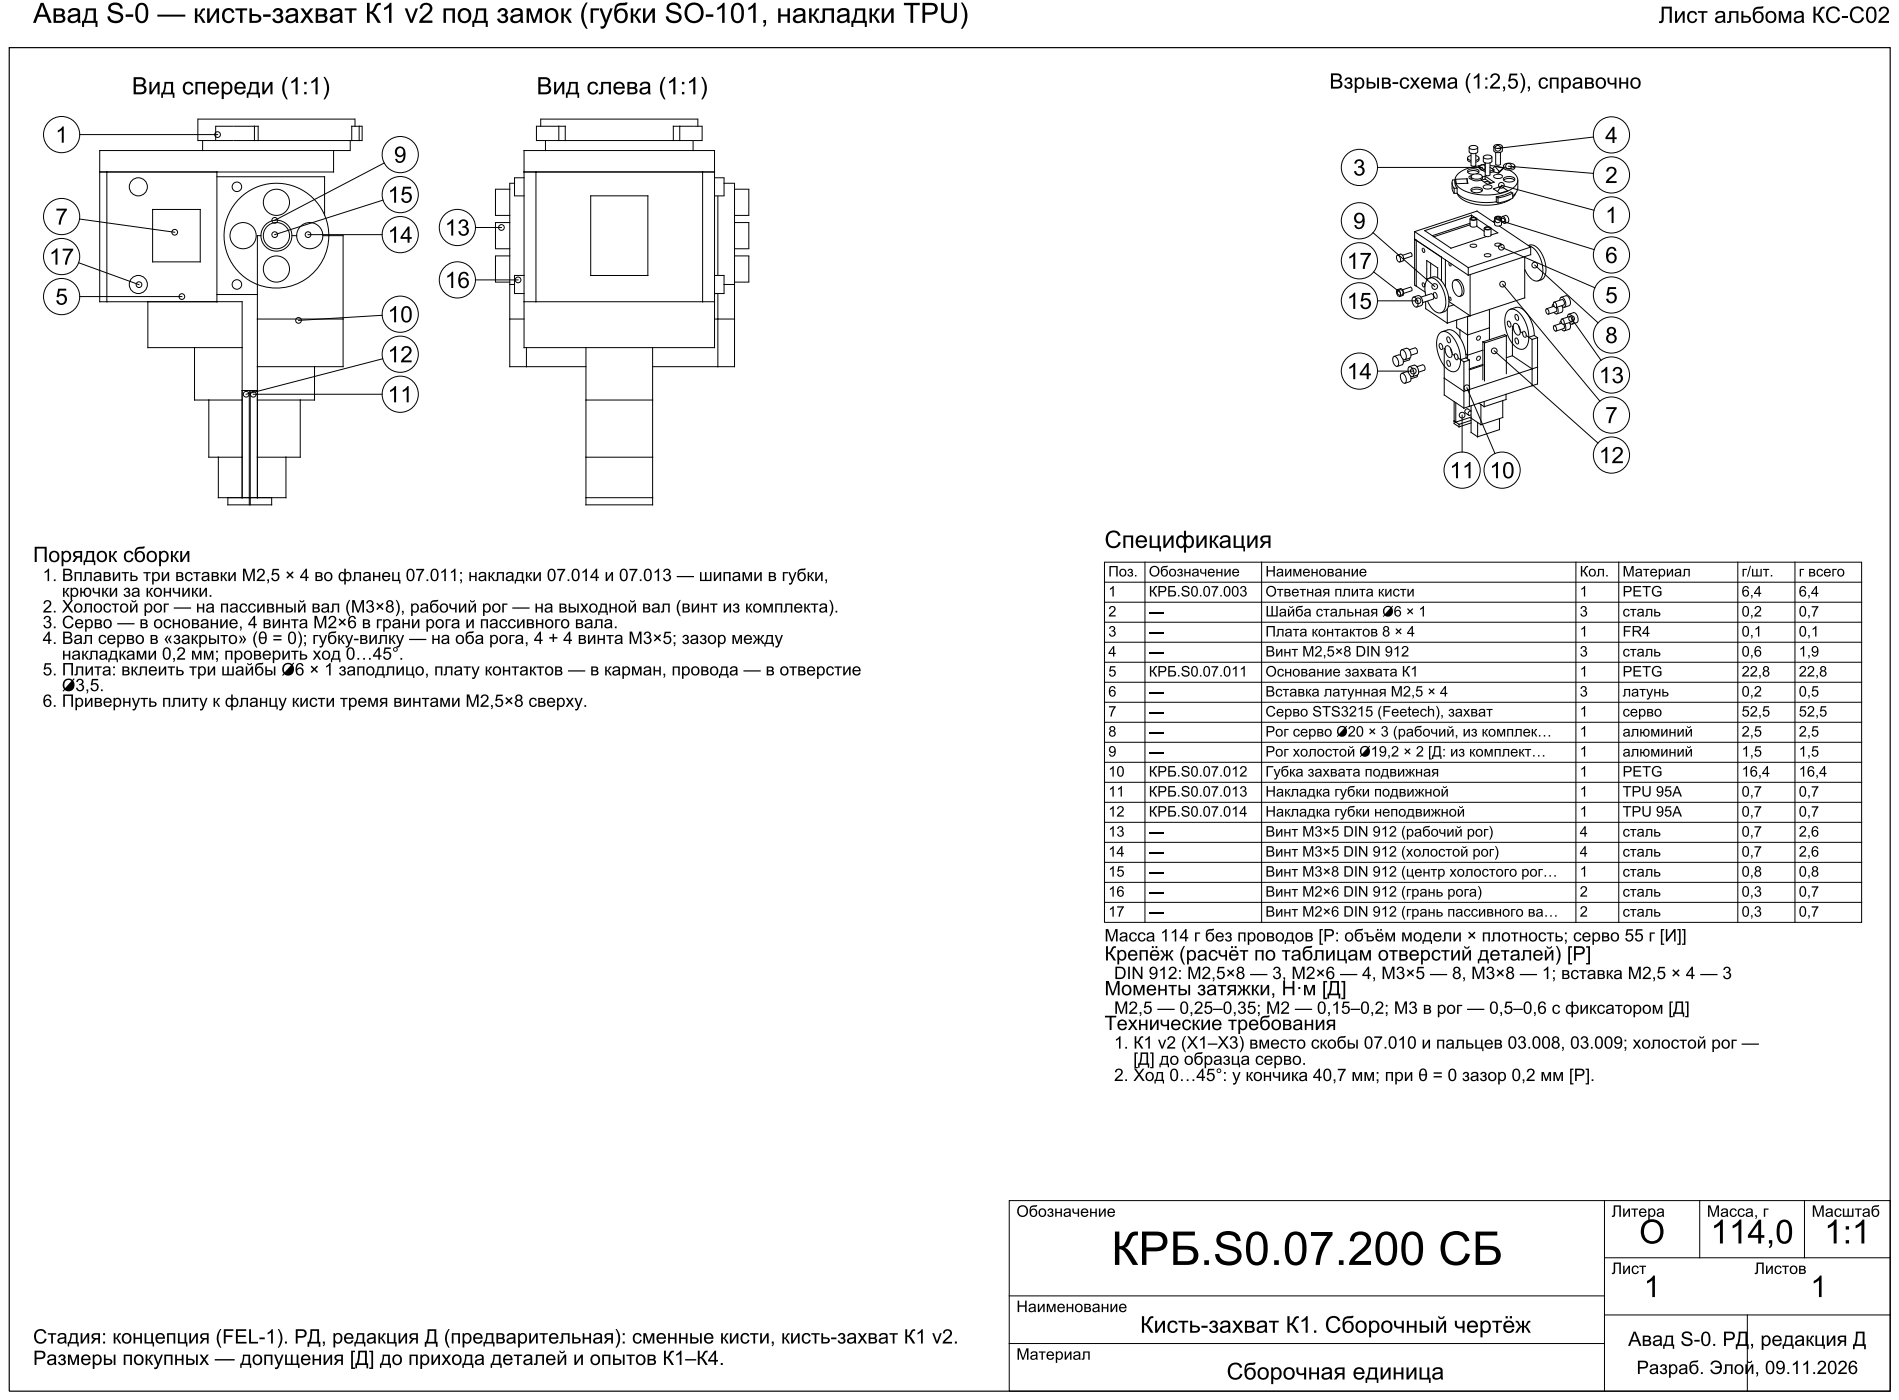
[picture p223: page 1]
