pilot443/avad-s0/wrist-tools/assemblies/KRB.S0.07.400_SB.pdf

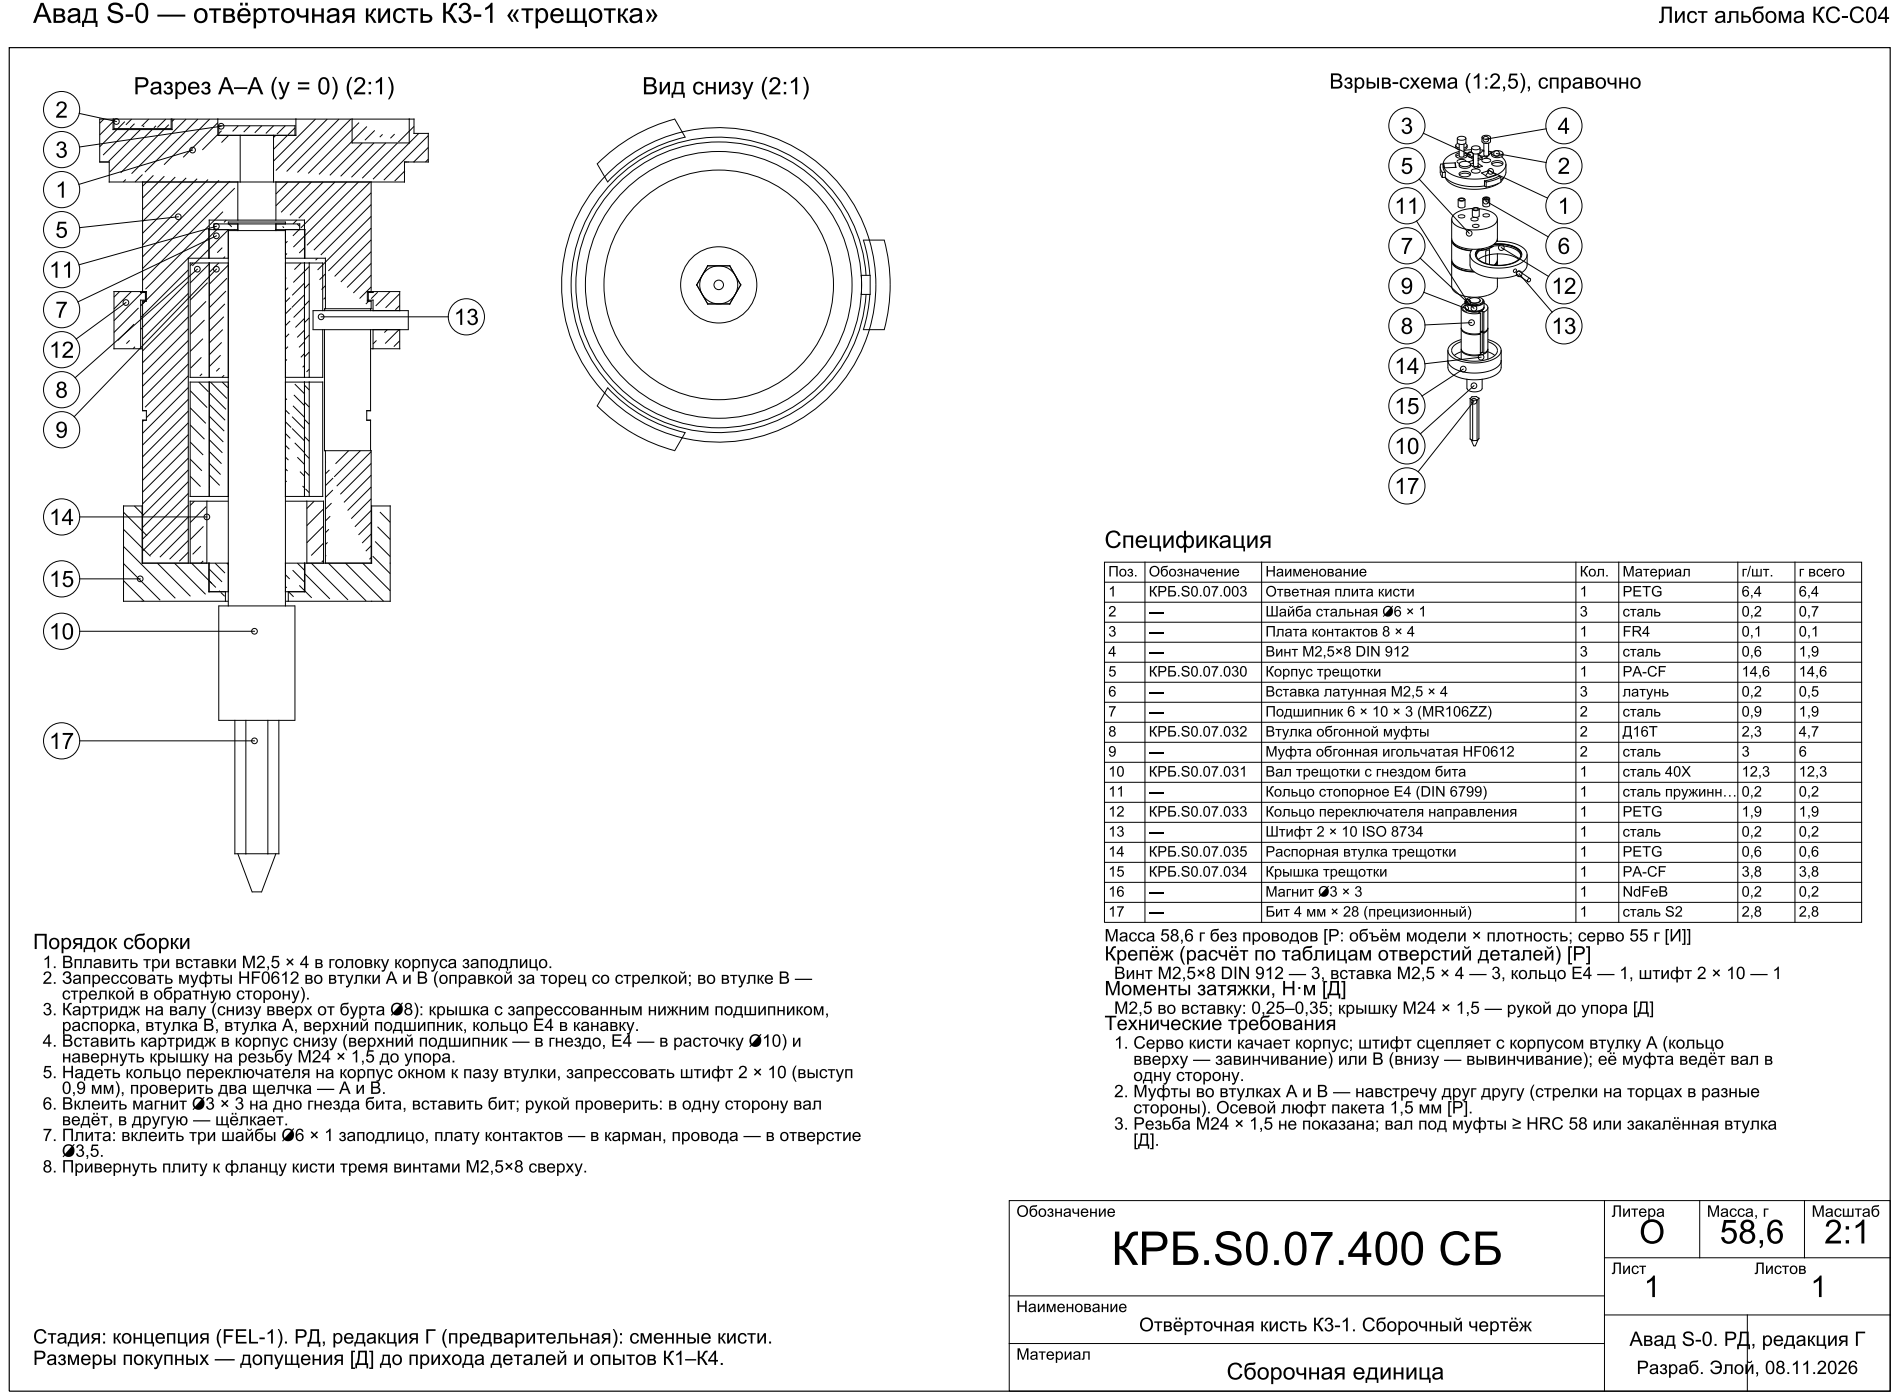
[picture p225: page 1]
