pilot443/avad-s0/docs/drawings-album-rev-G.pdf

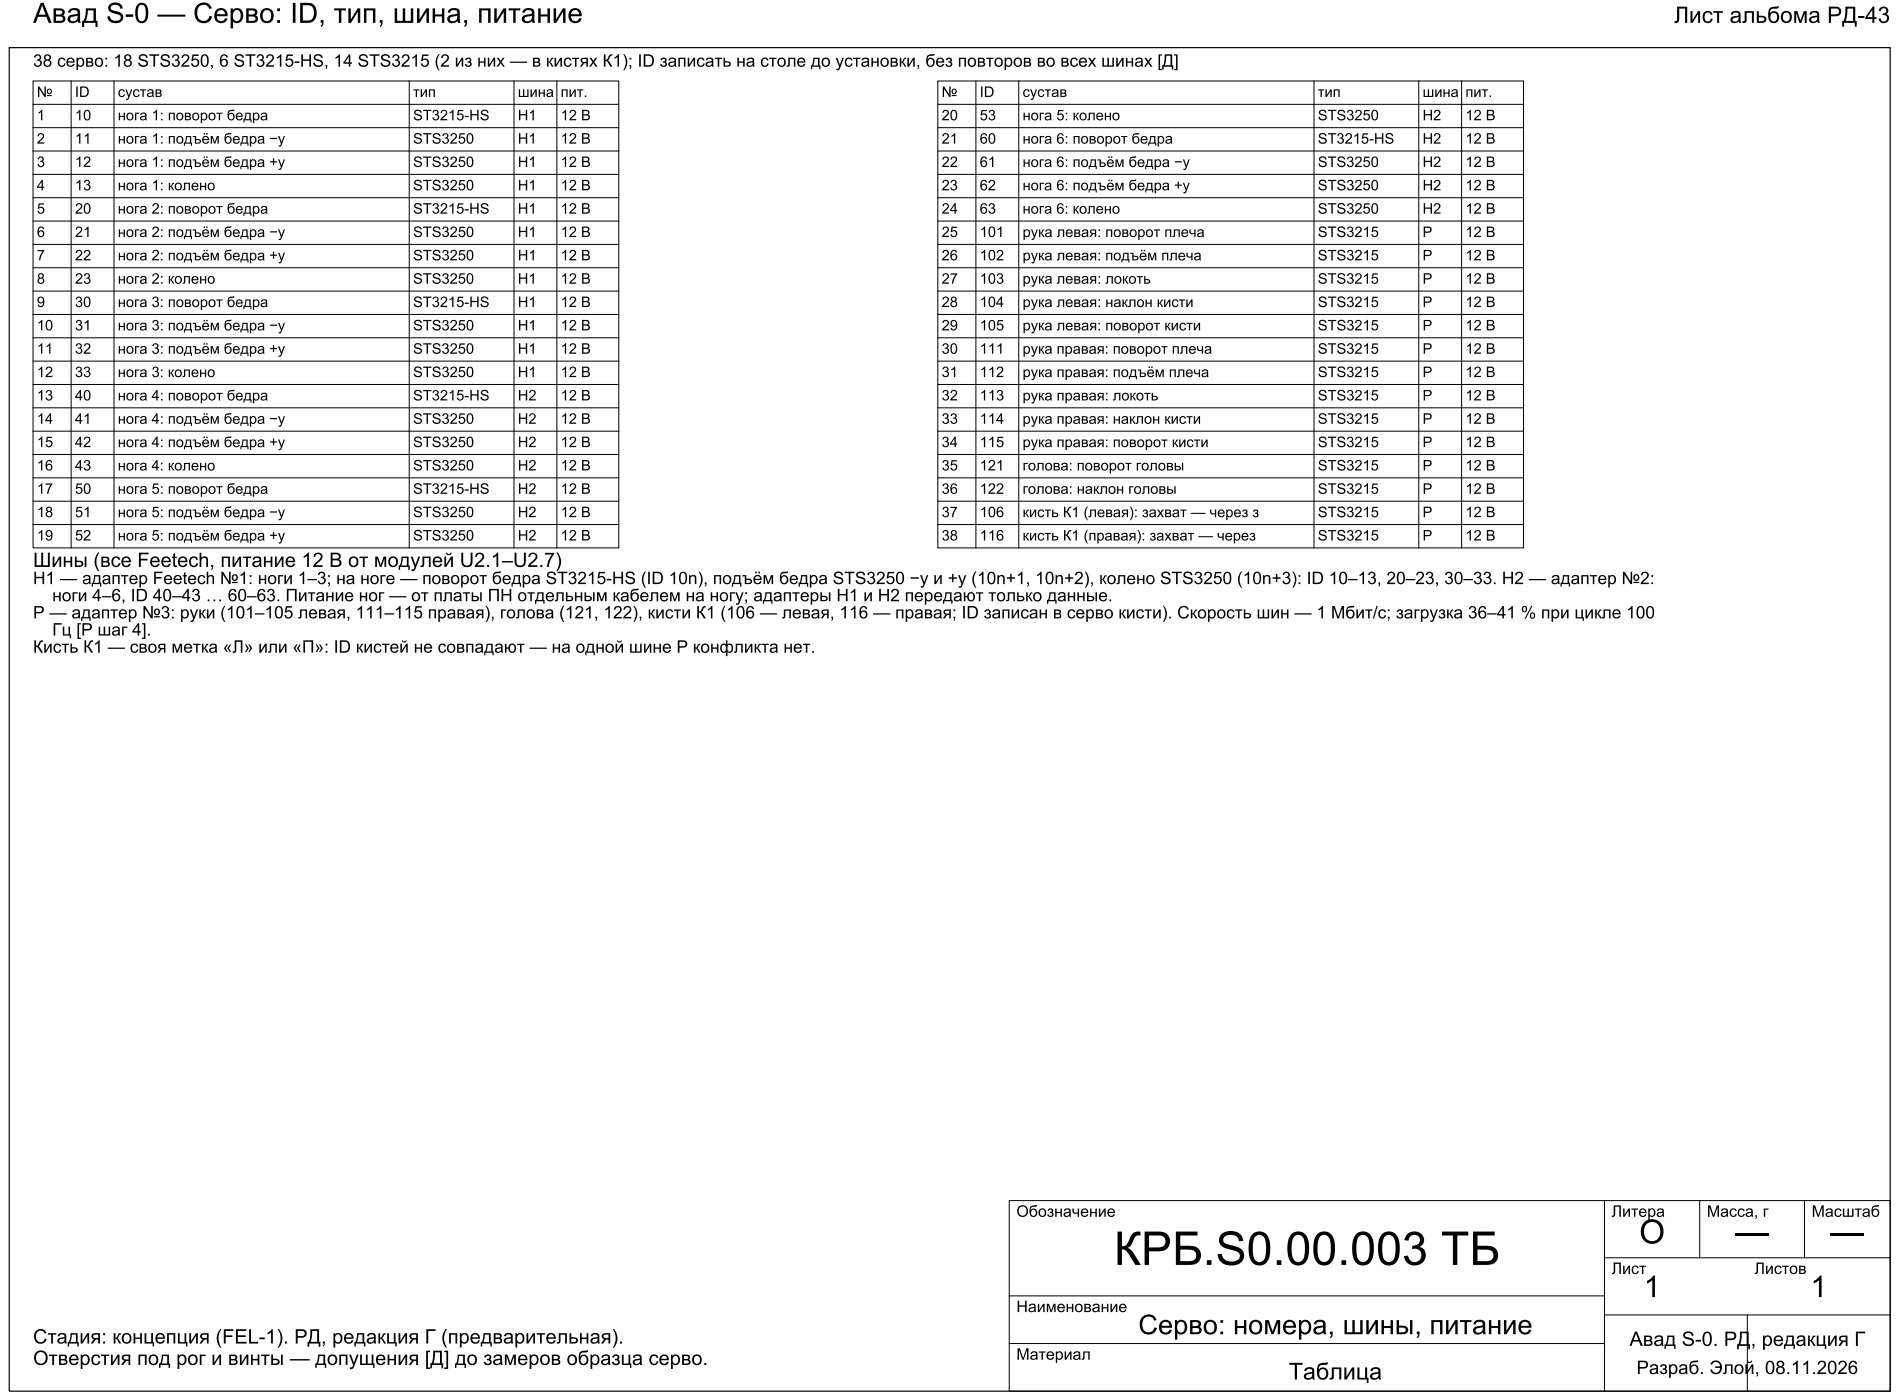
[picture p226: page 41]

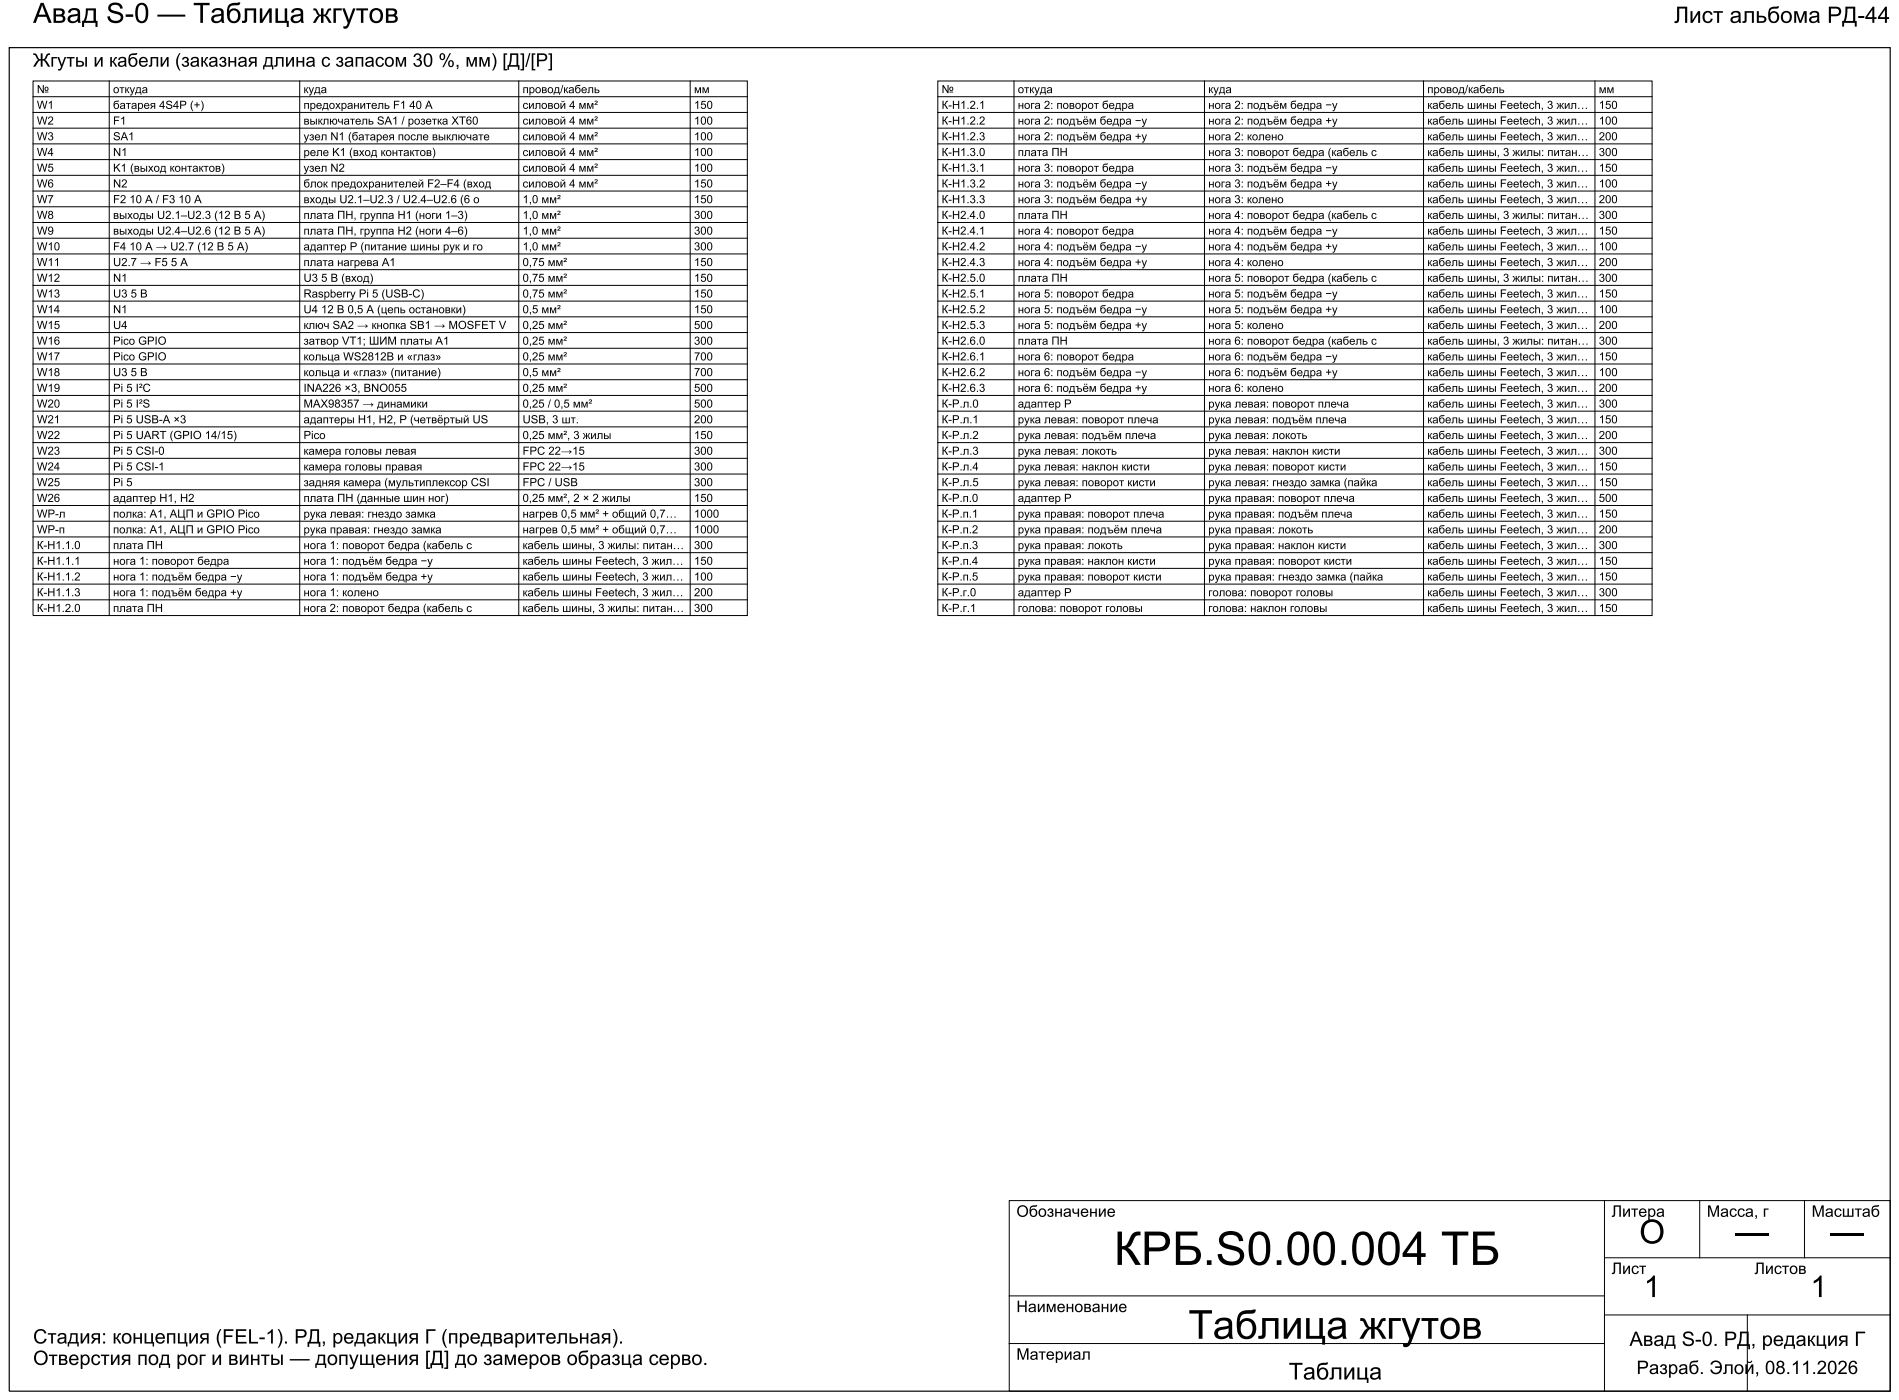
[picture p227: page 42]








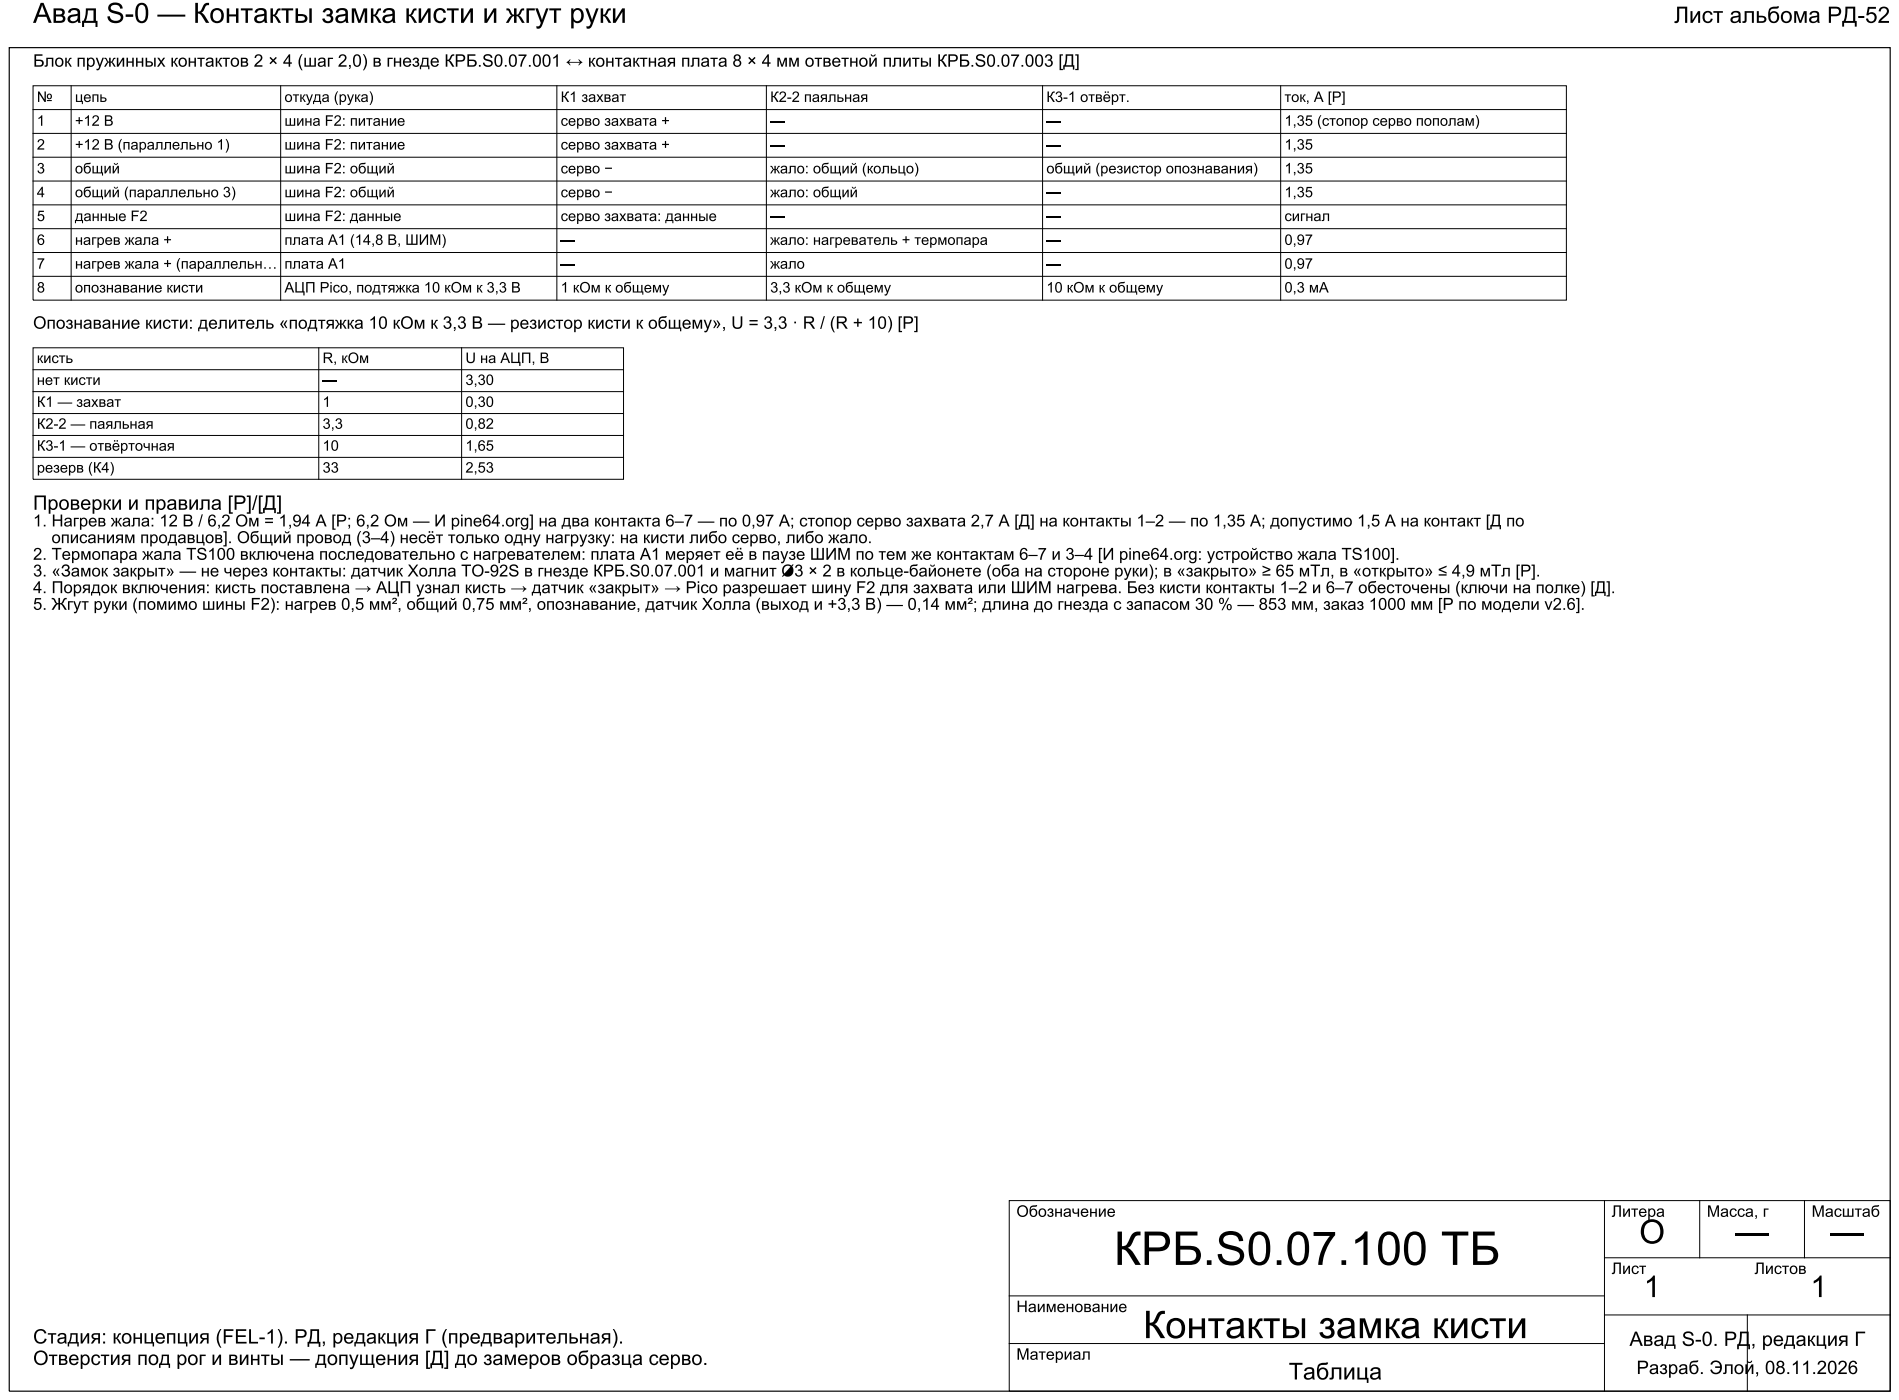
[picture p228: page 50]



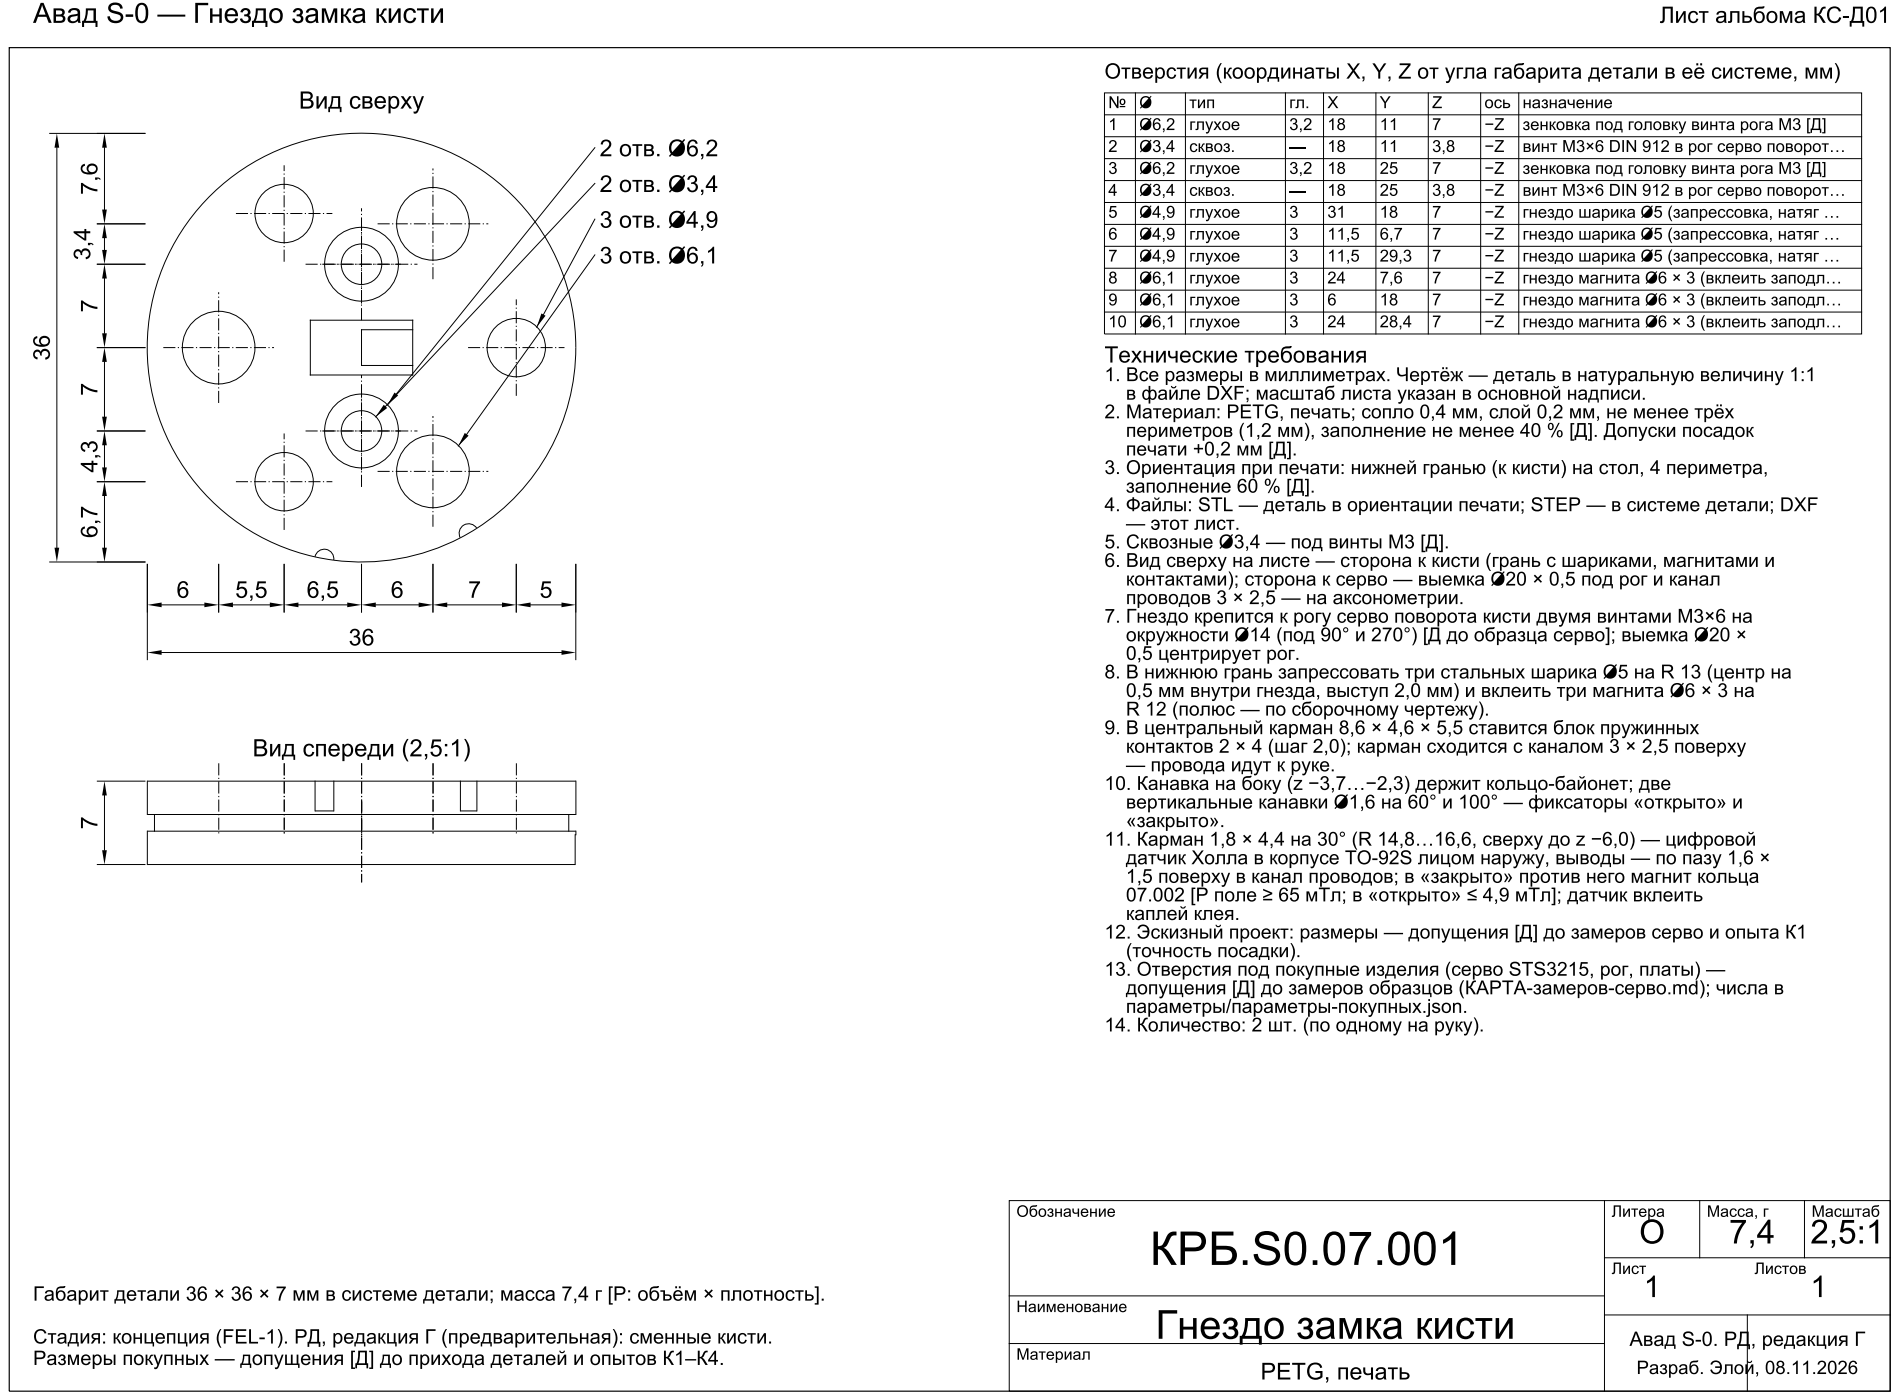
[picture p229: page 53]

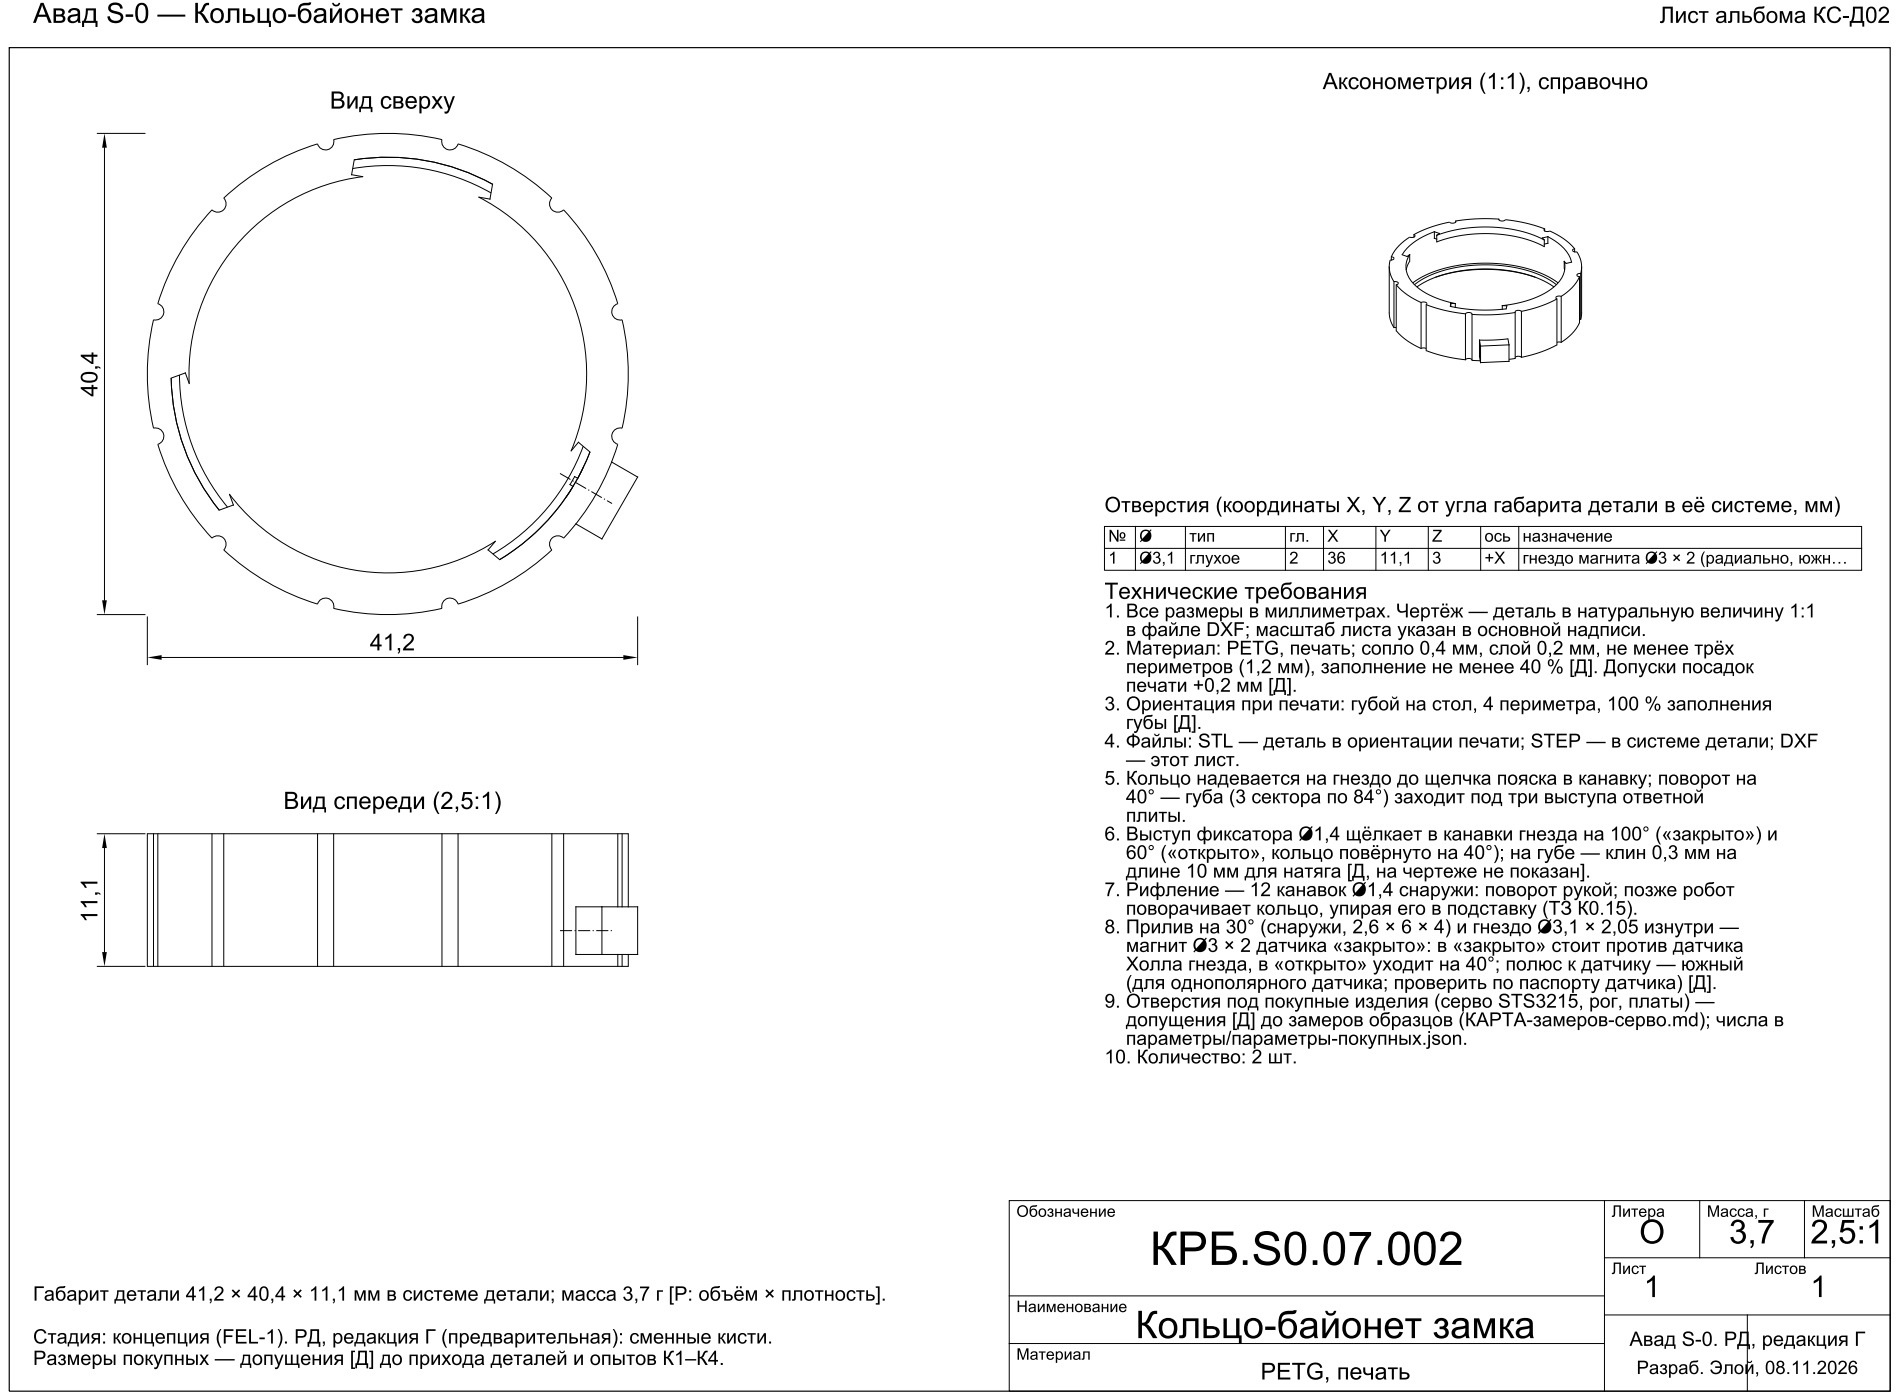
[picture p230: page 54]

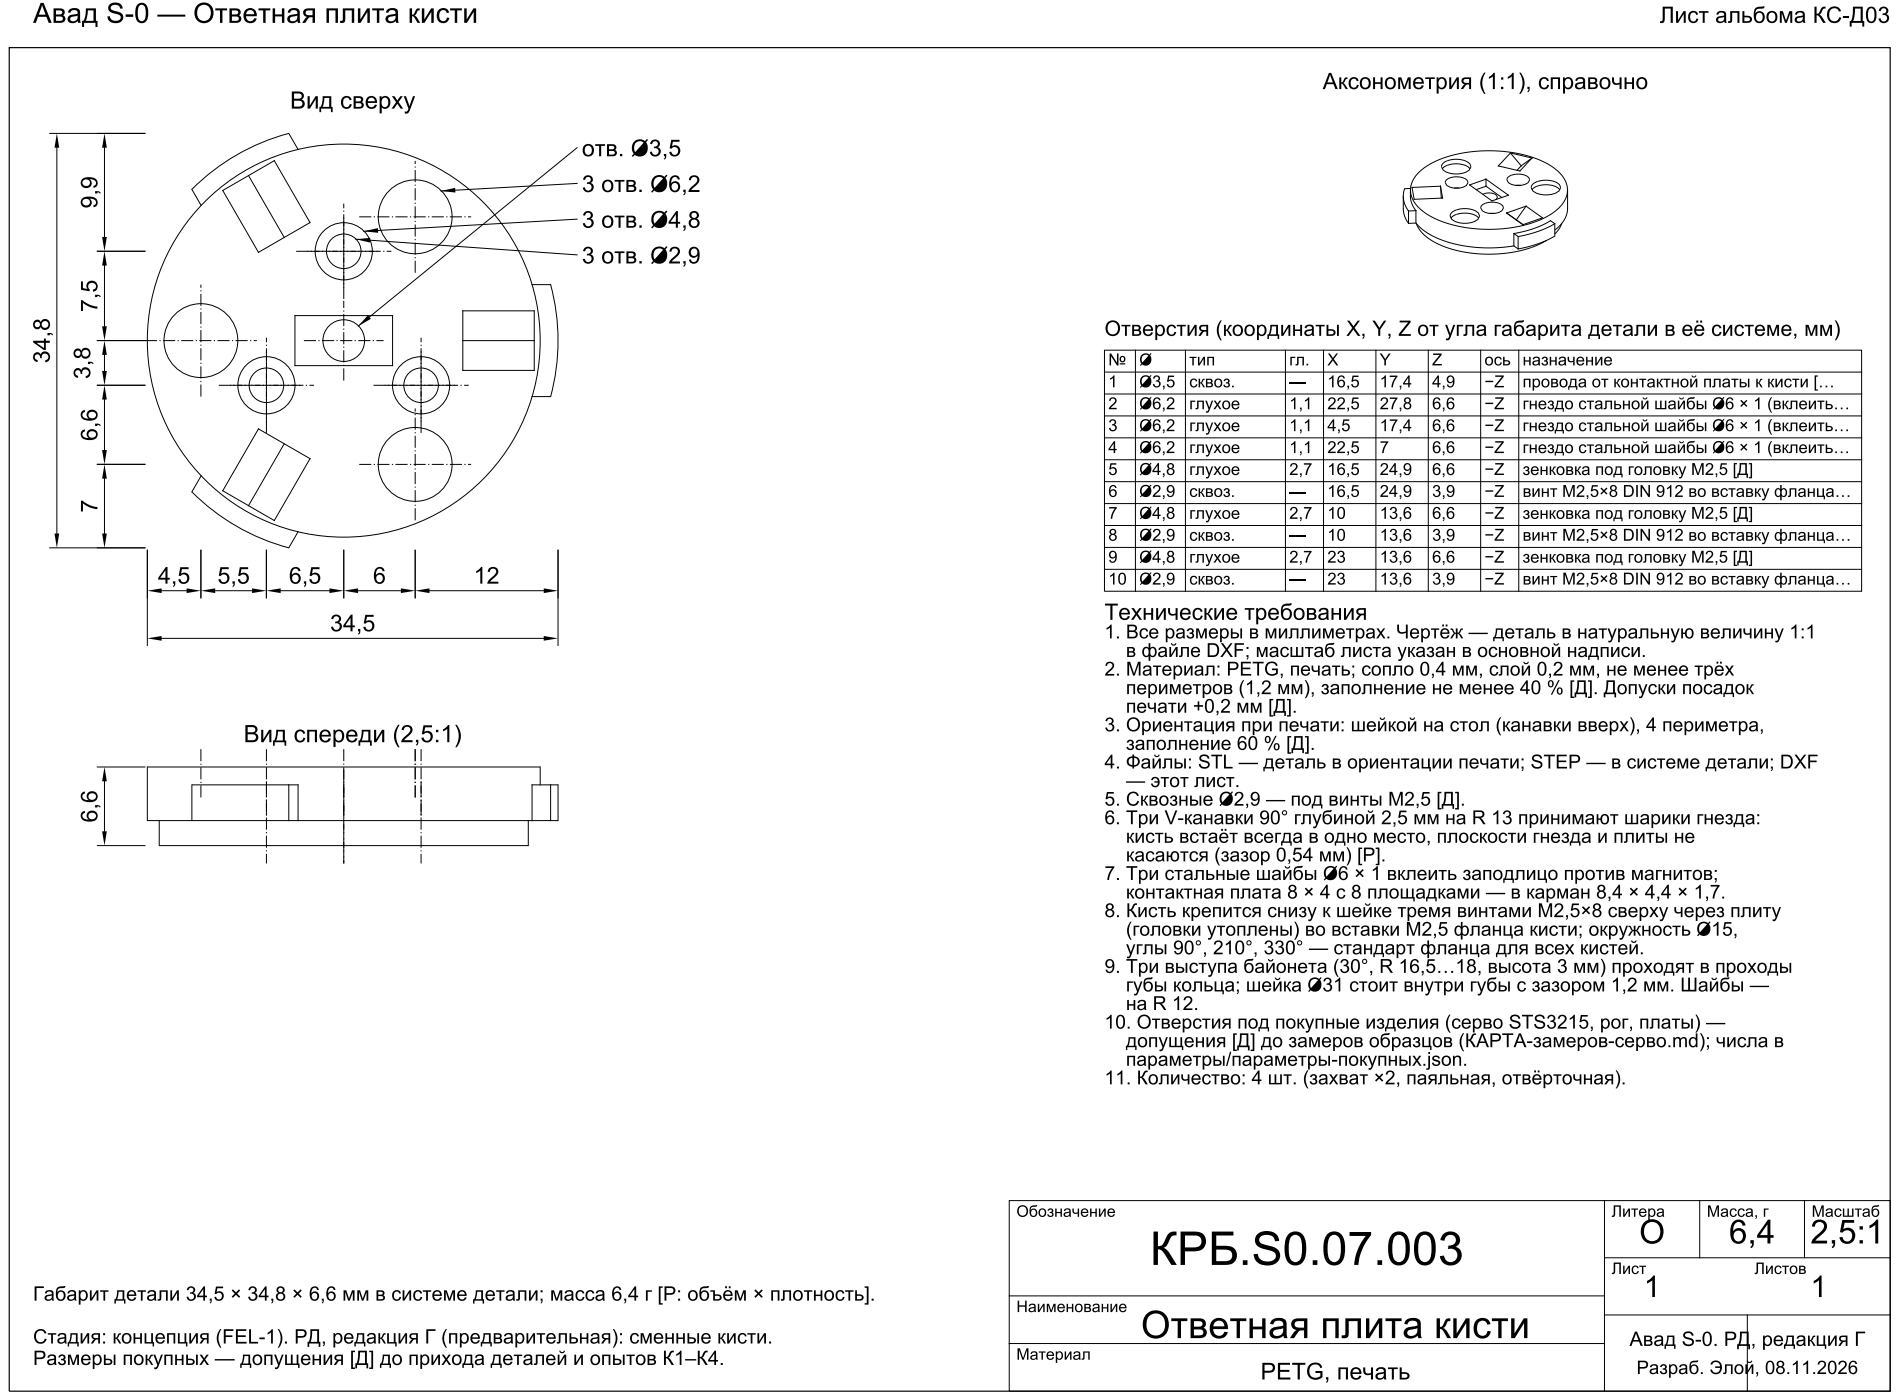
[picture p231: page 55]


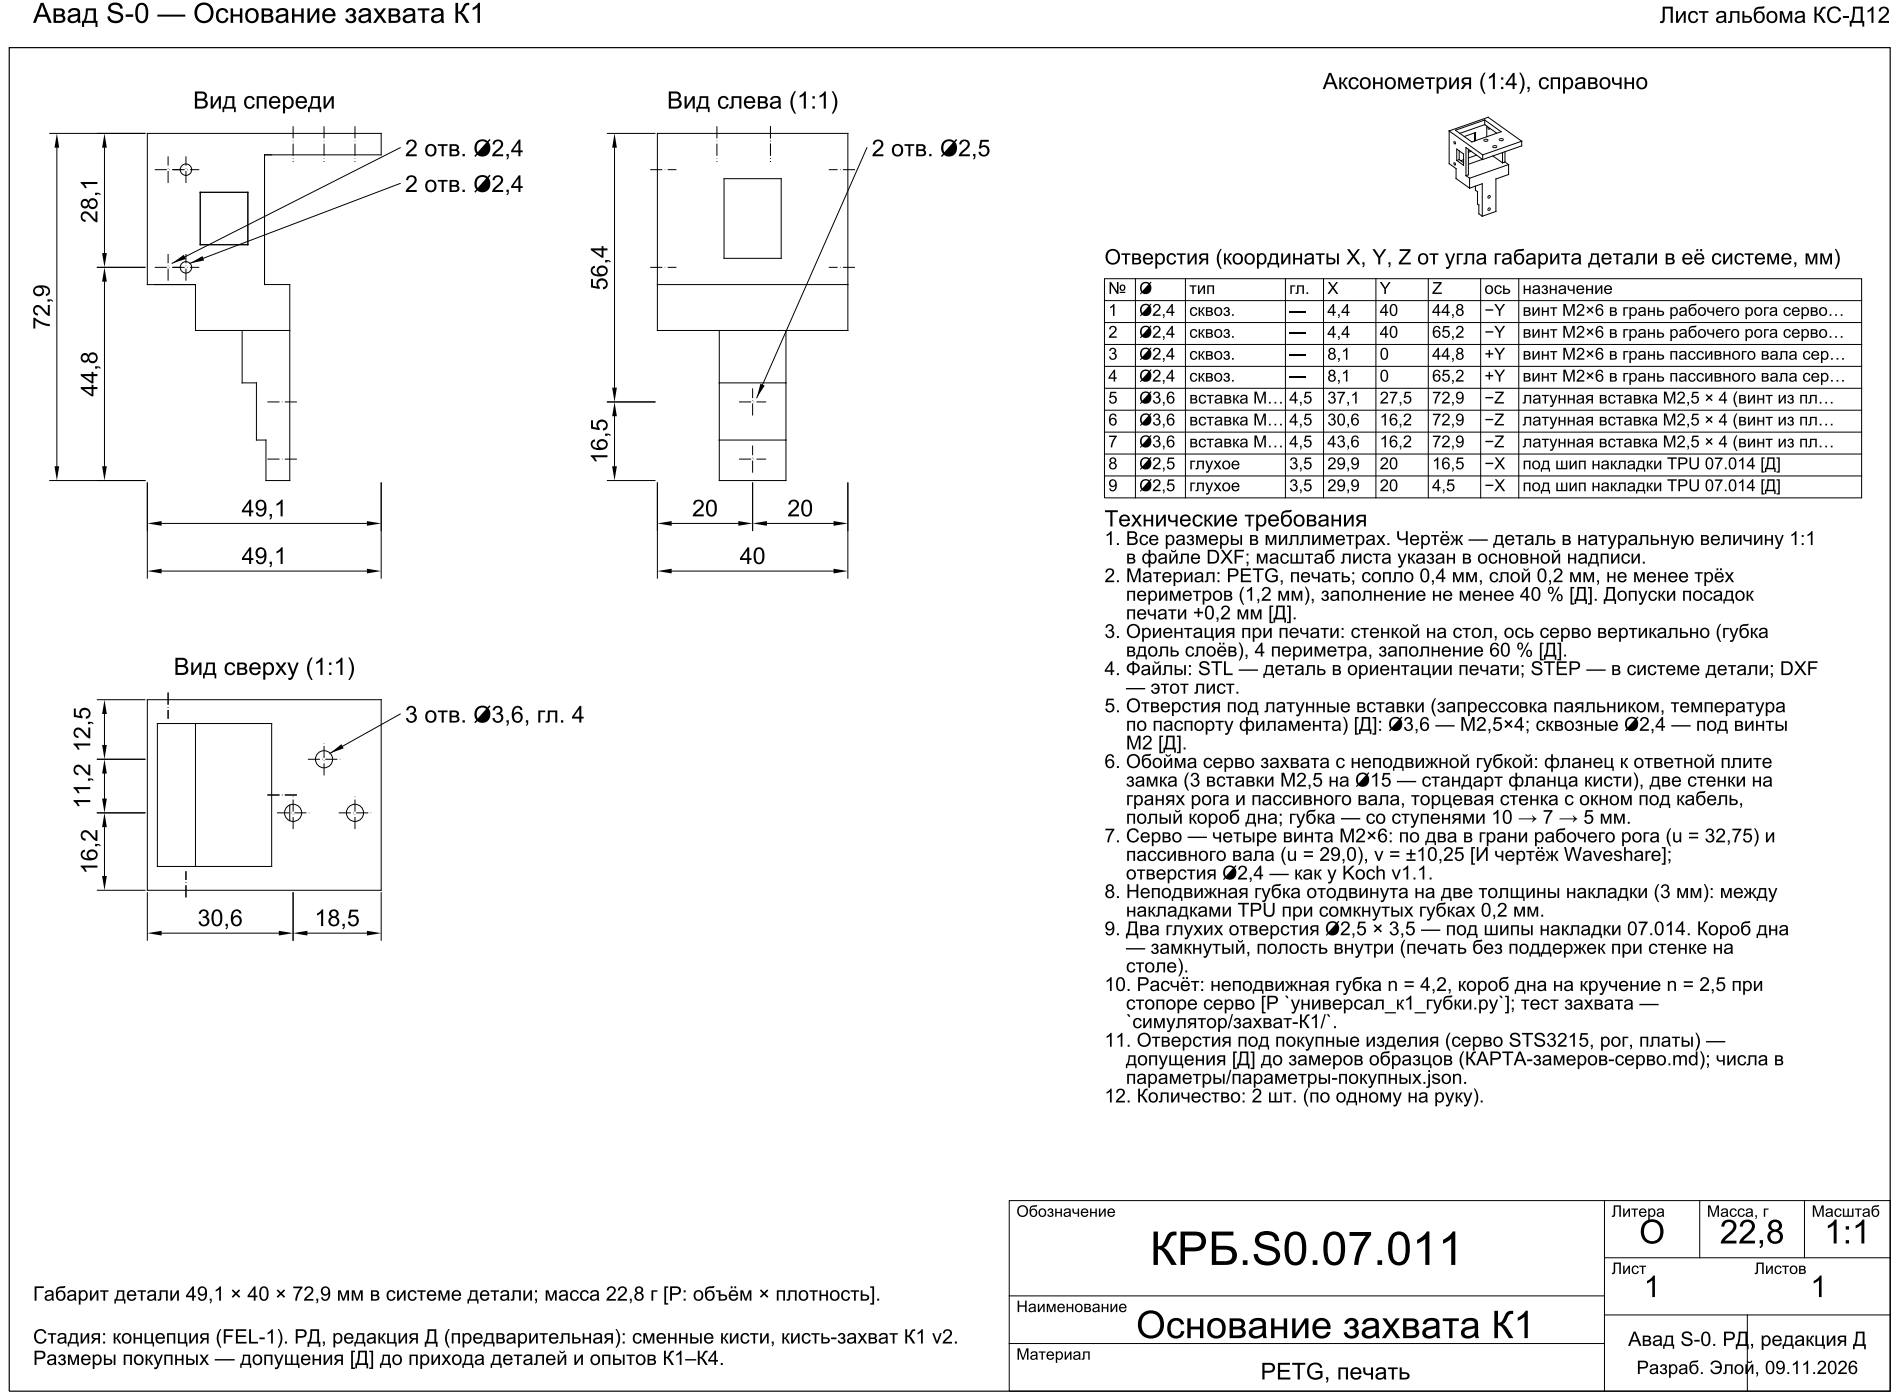
[picture p232: page 57]

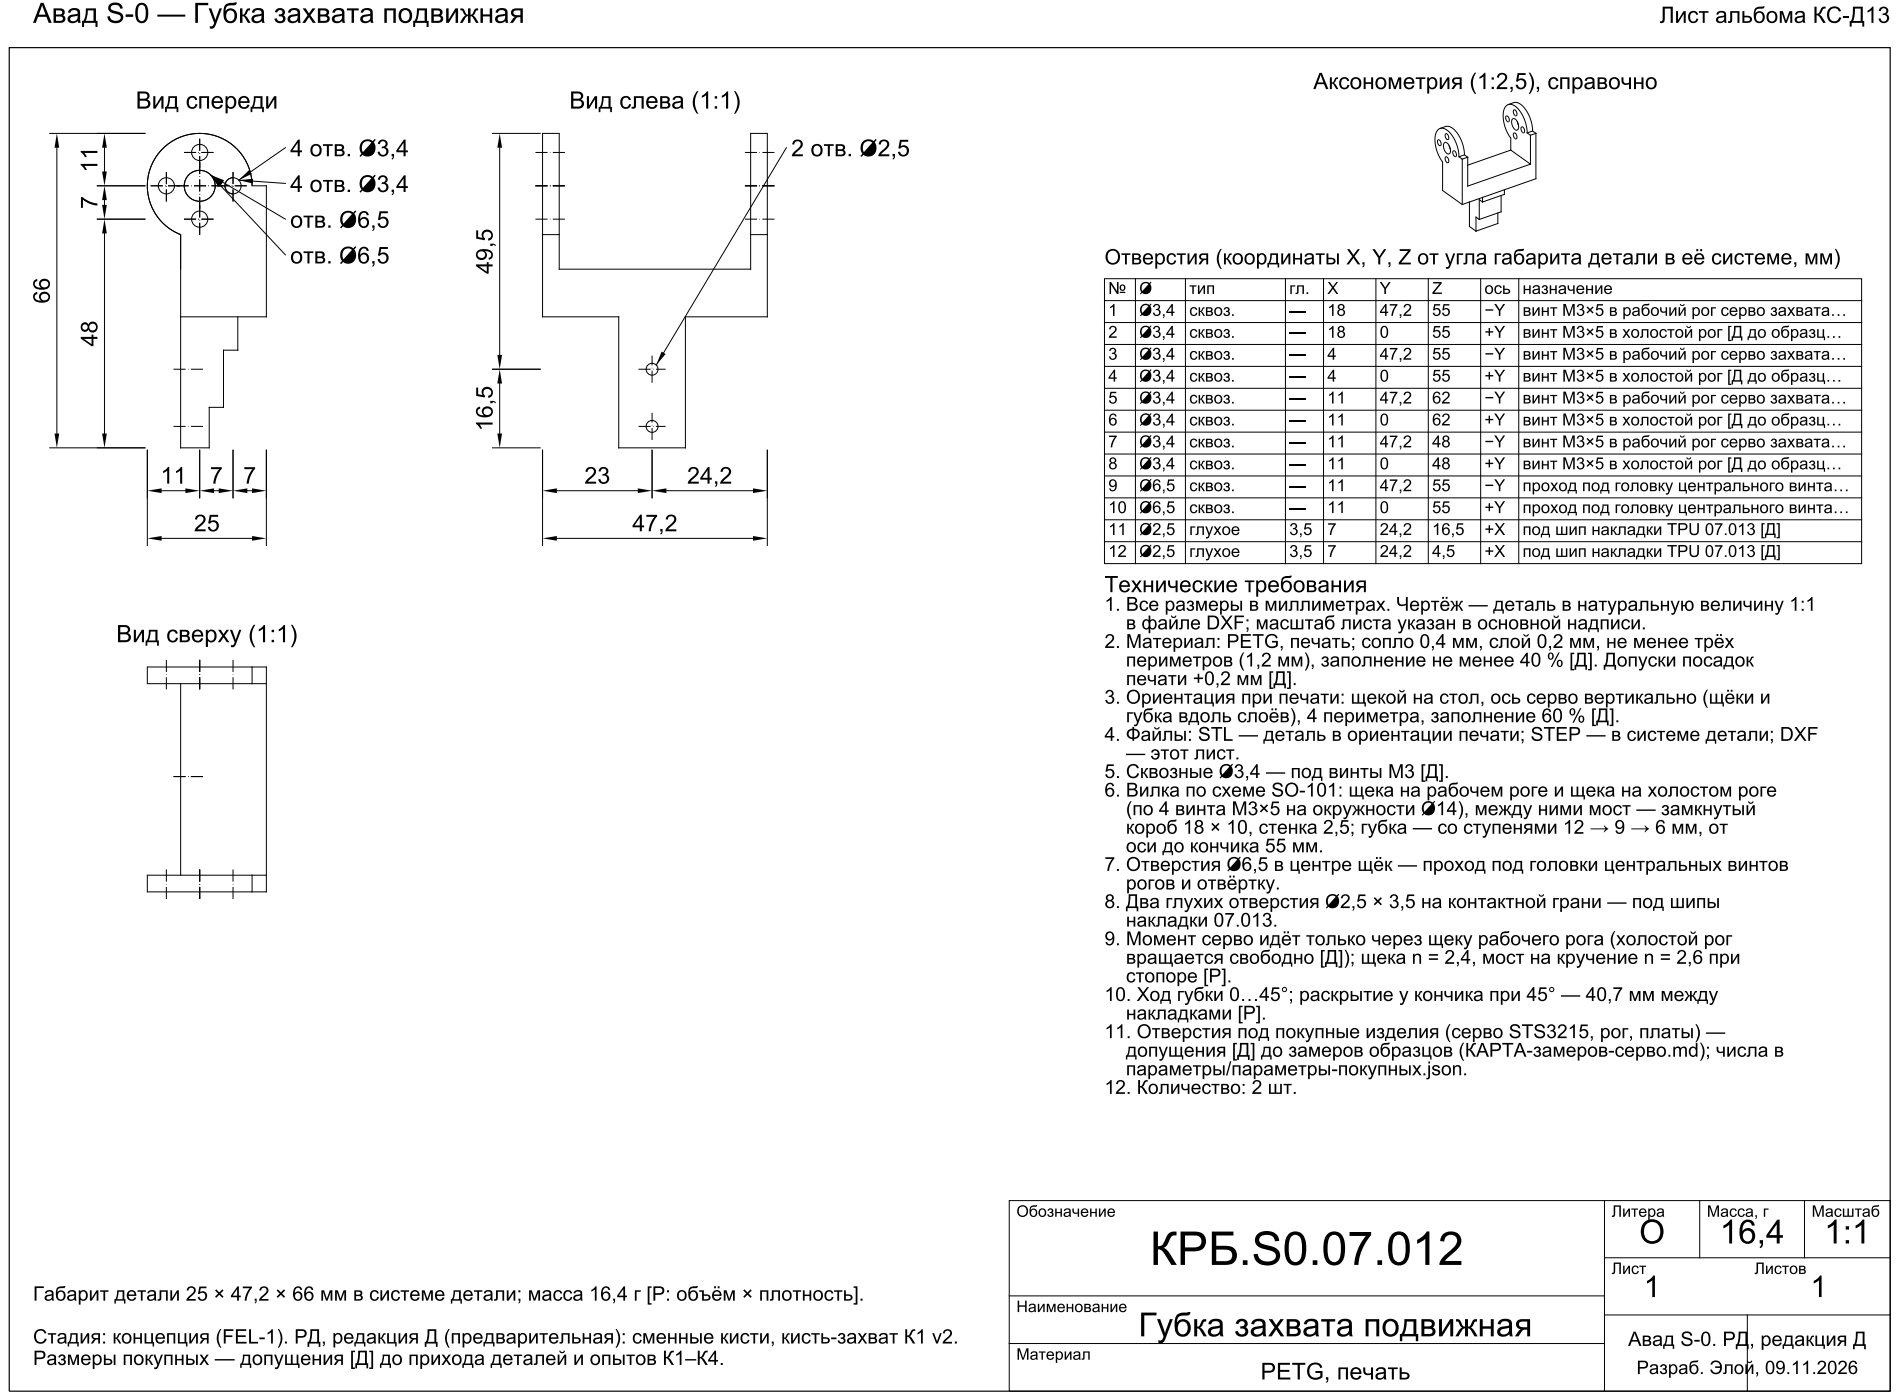
[picture p233: page 58]

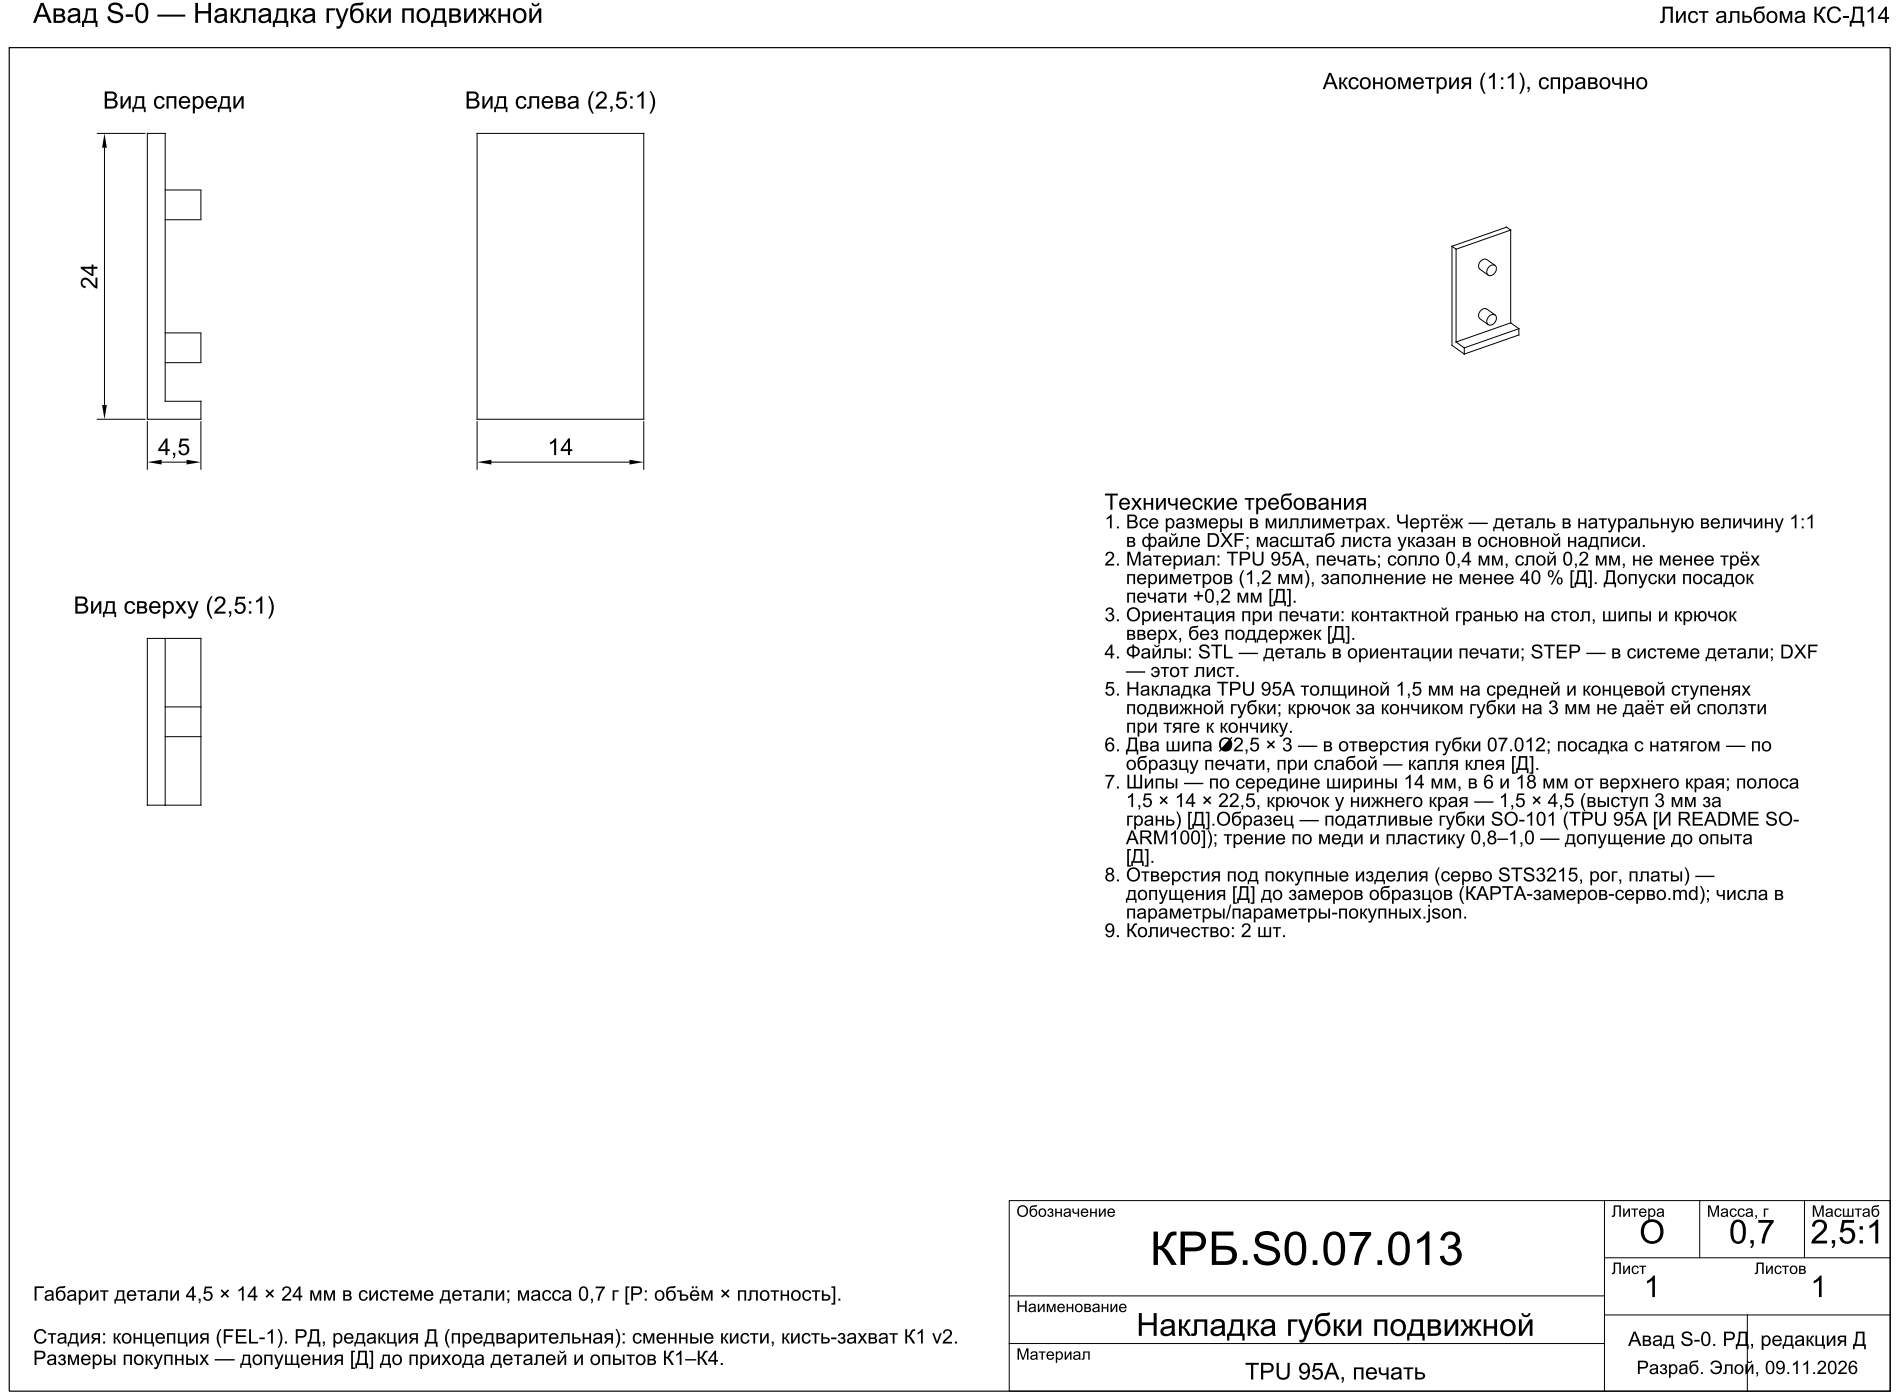
[picture p234: page 59]

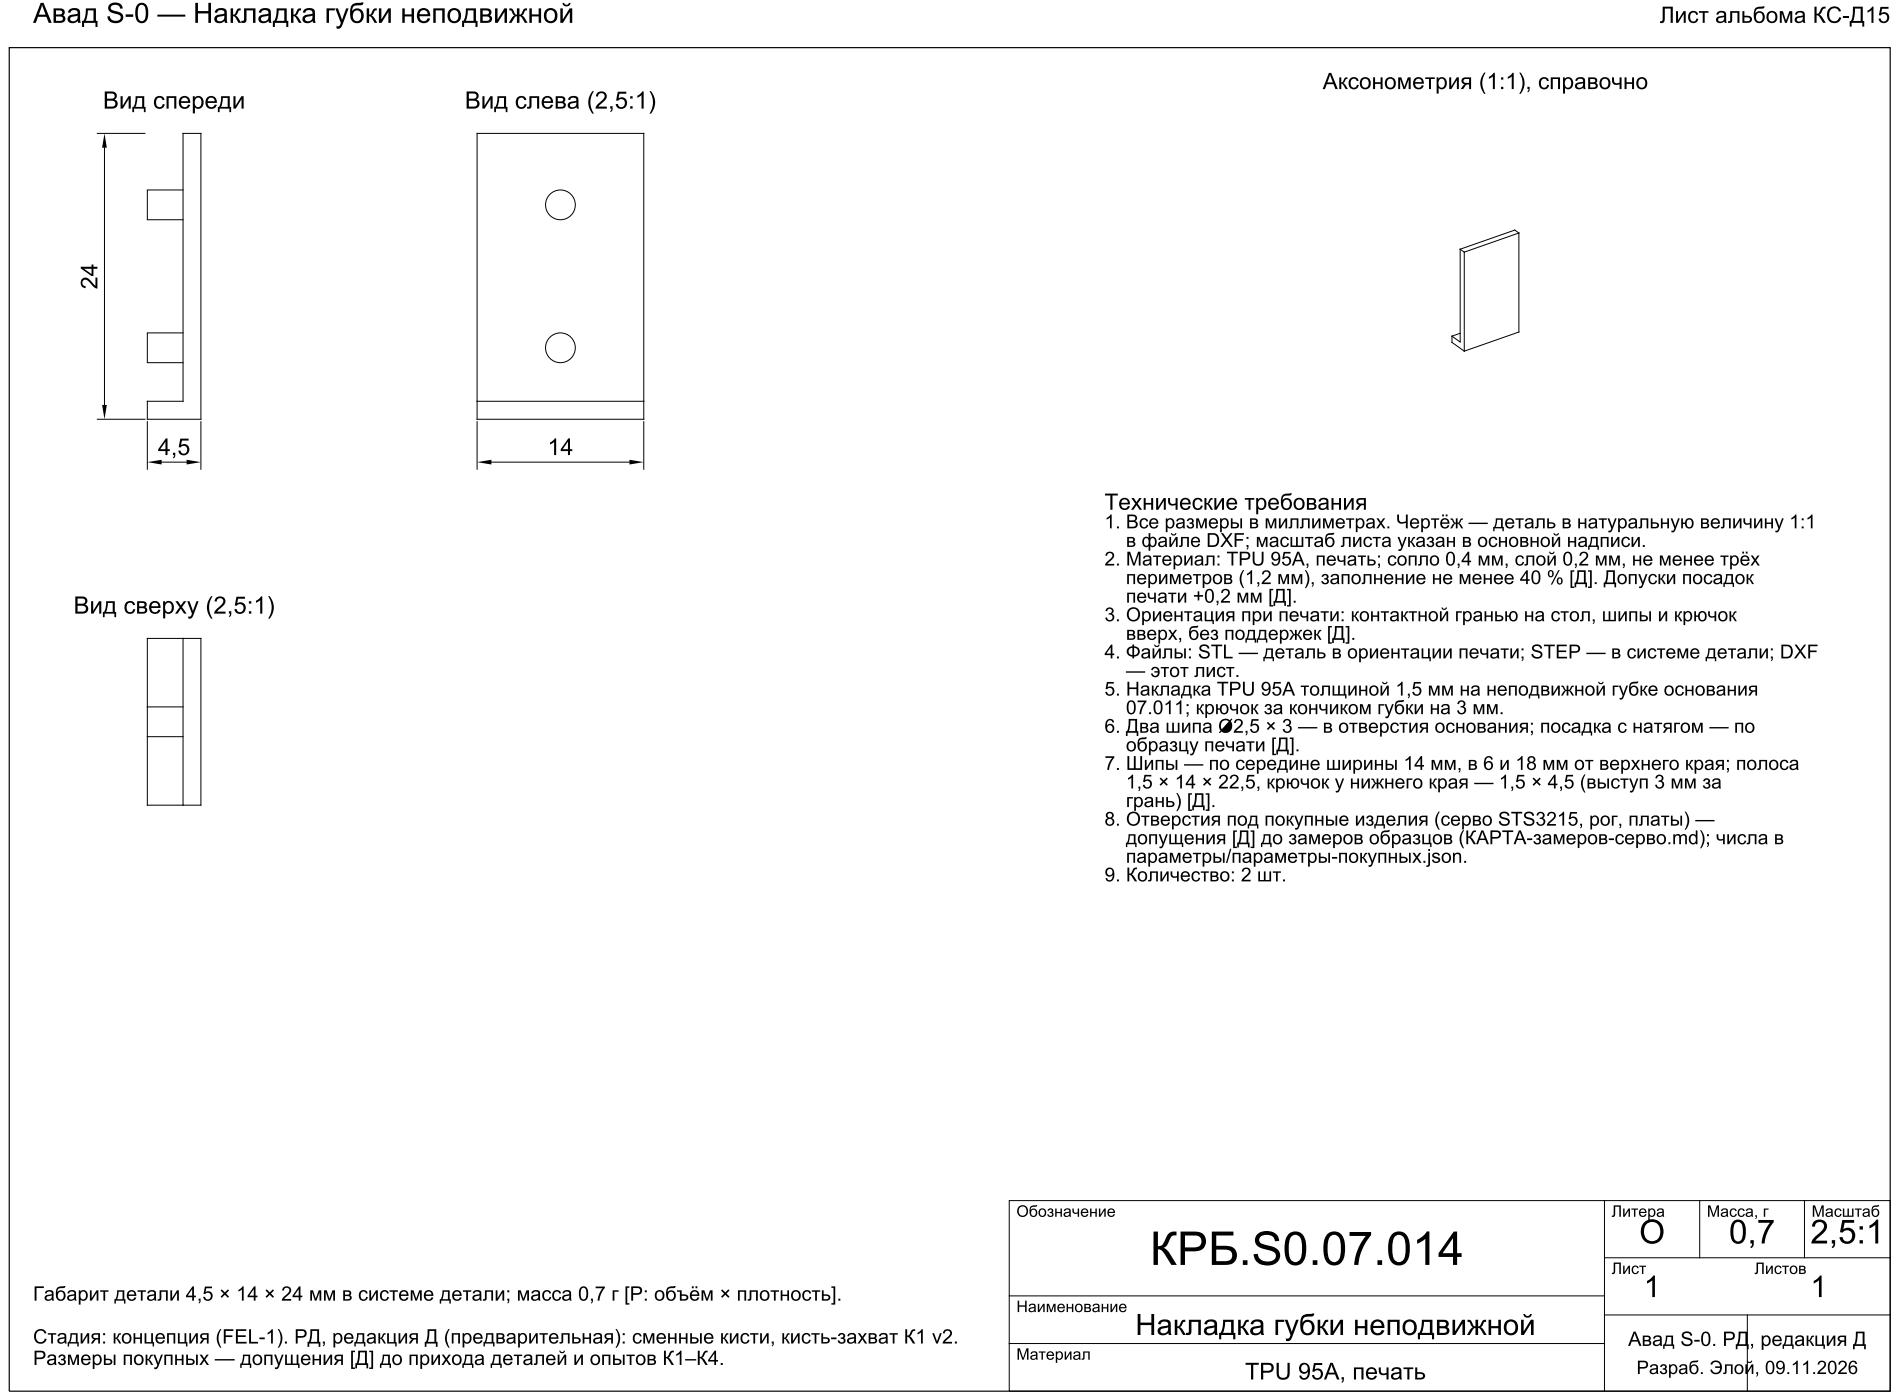
[picture p235: page 60]


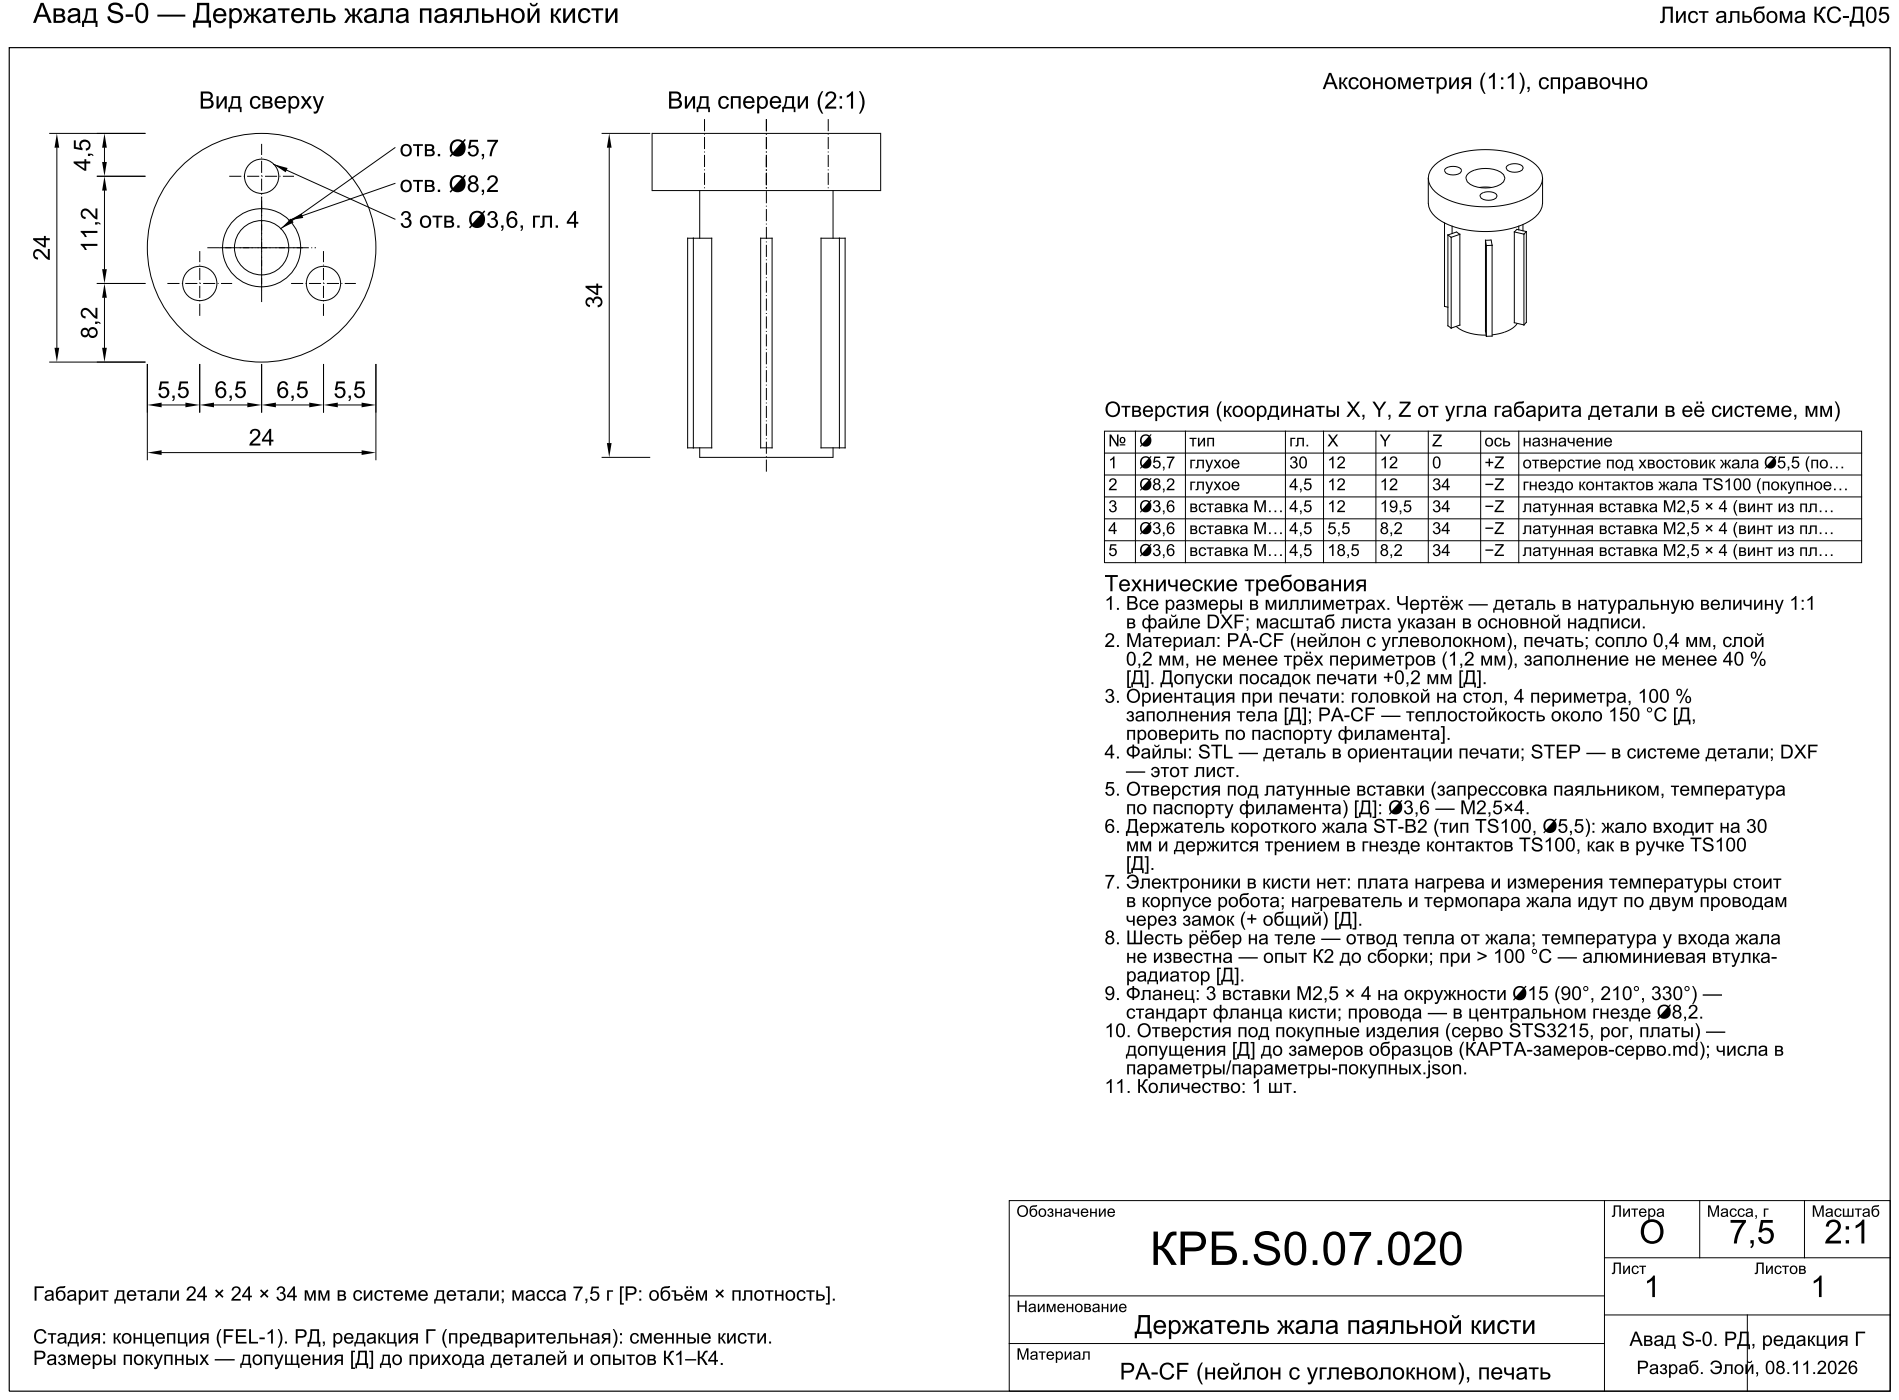
[picture p236: page 62]


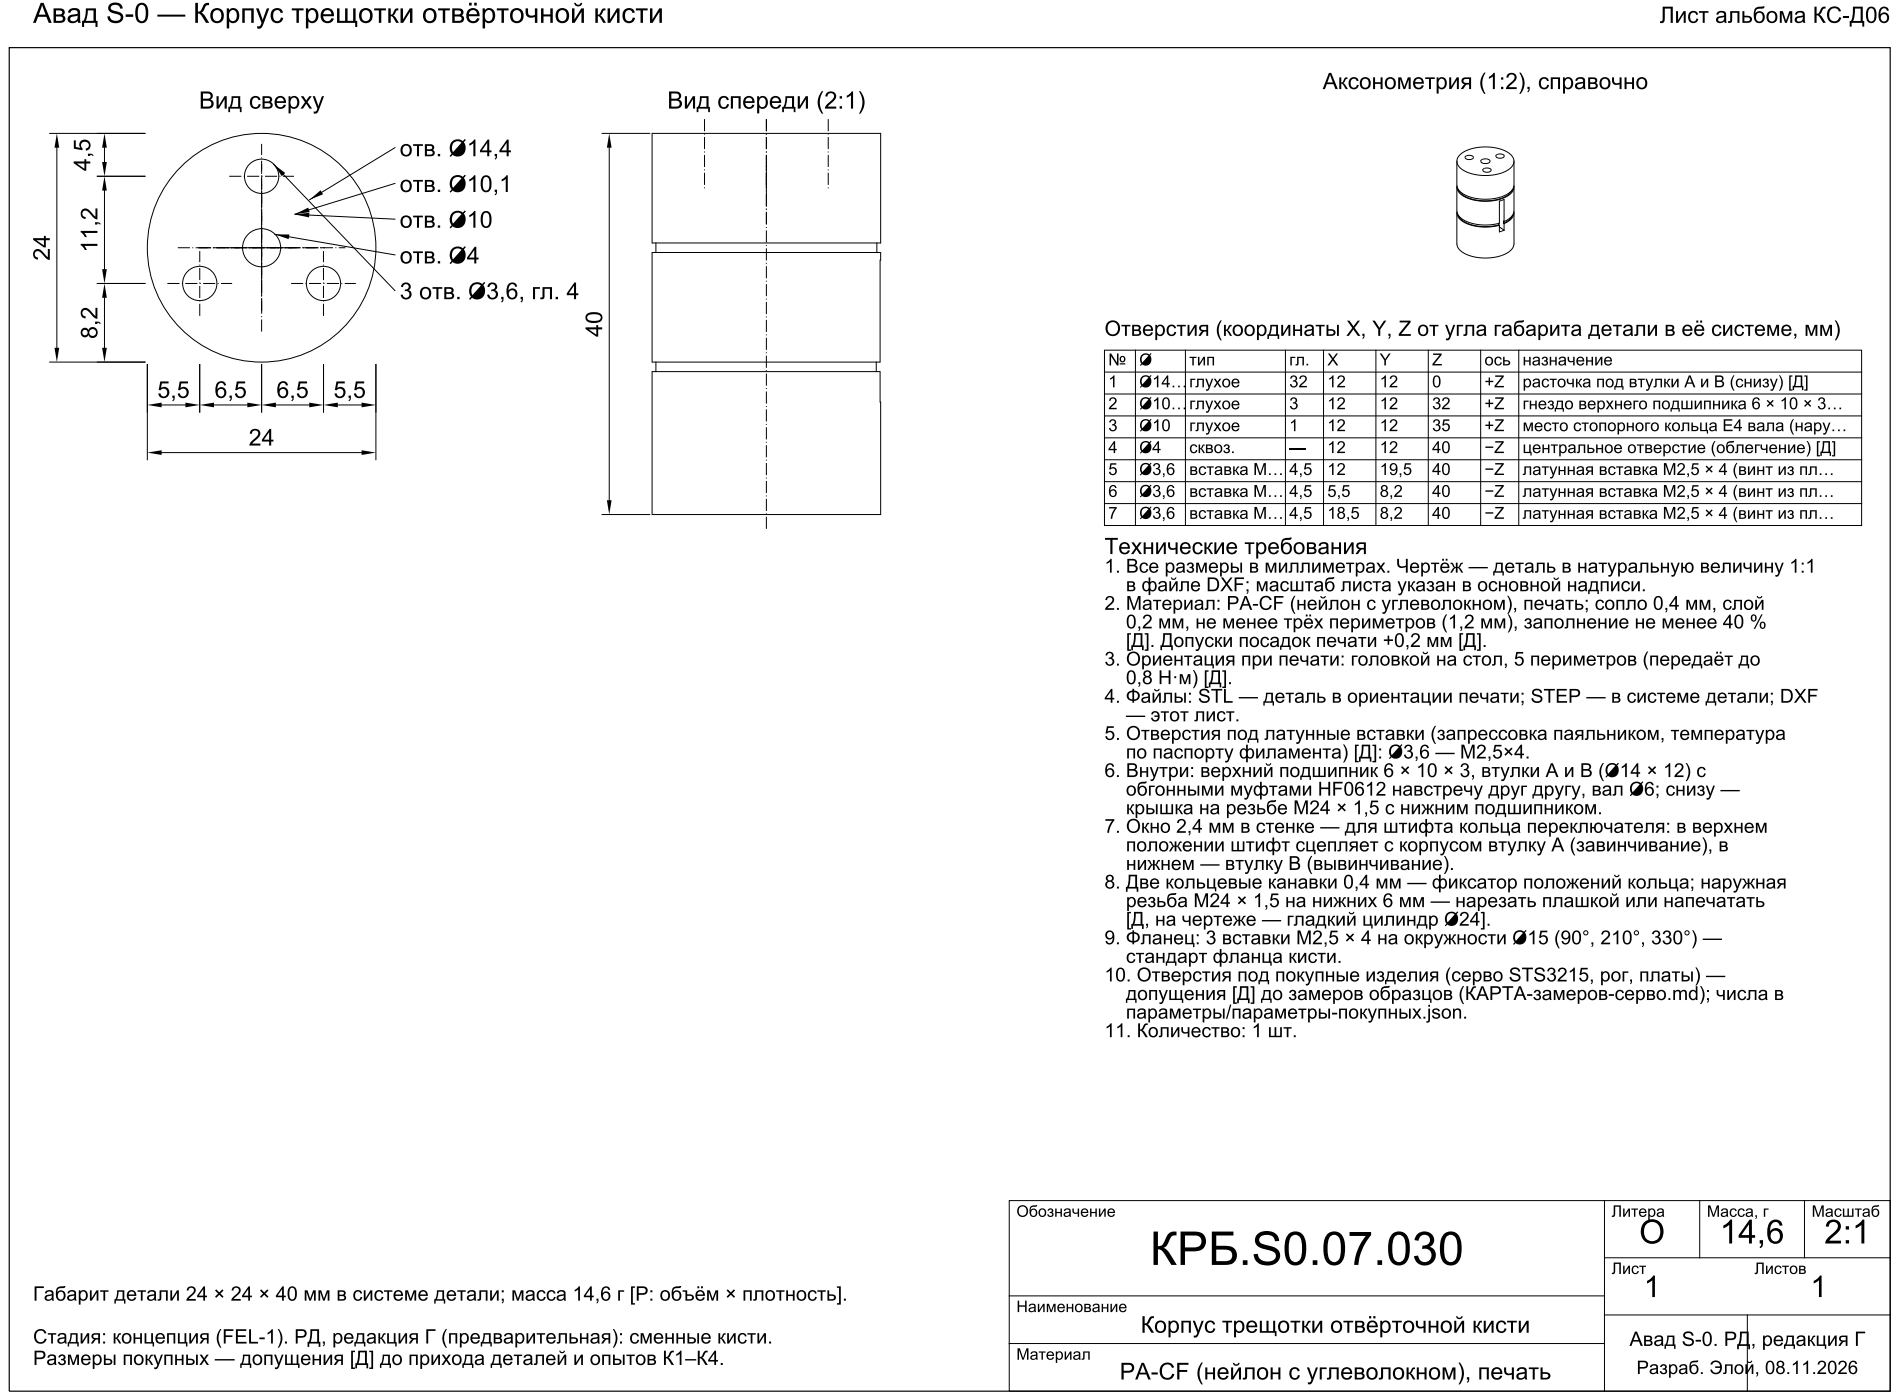
[picture p237: page 64]

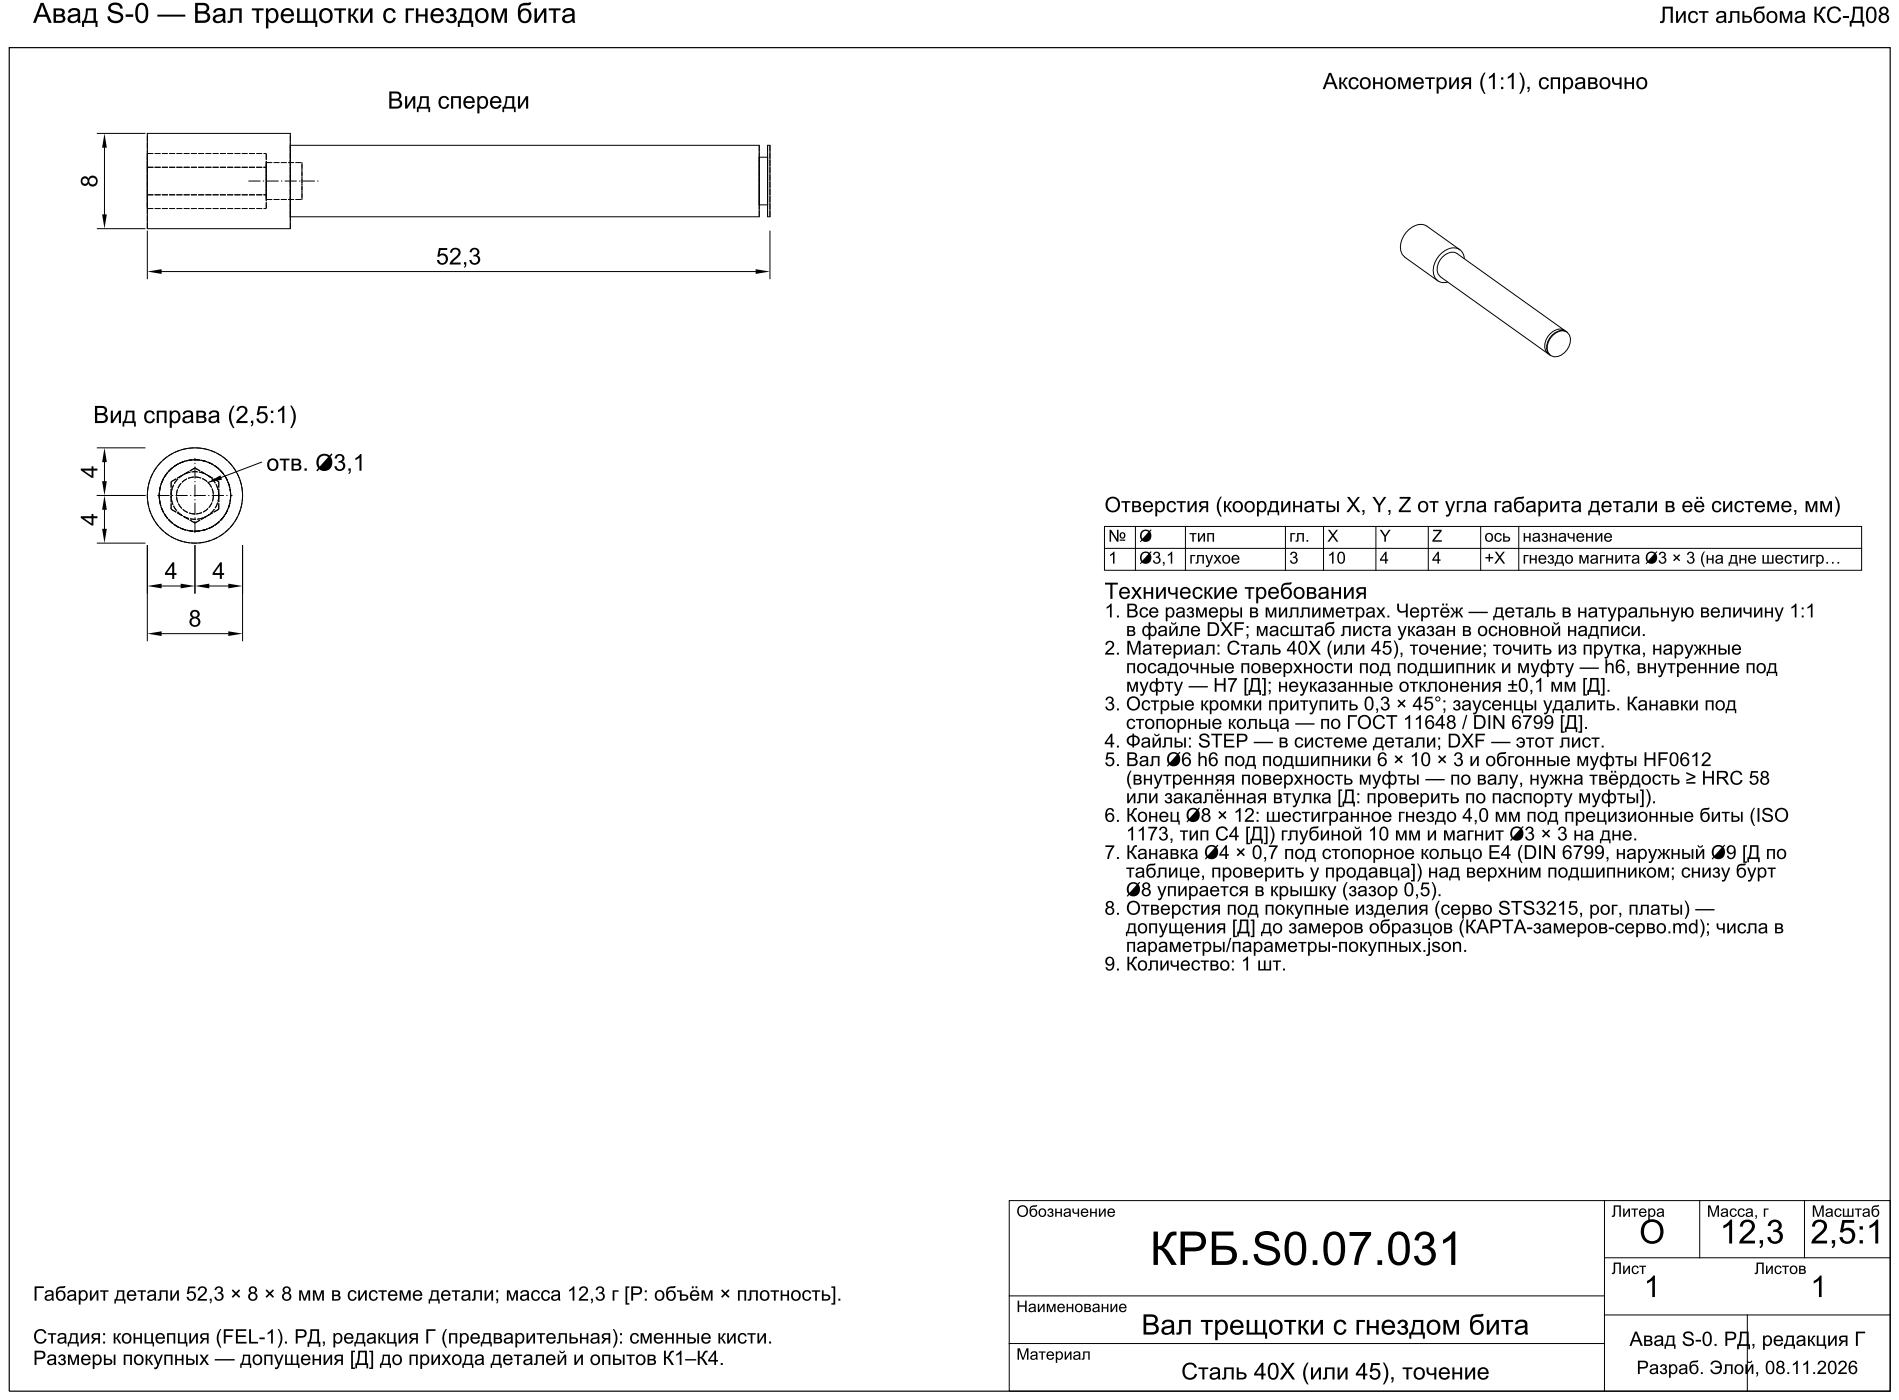
[picture p238: page 65]

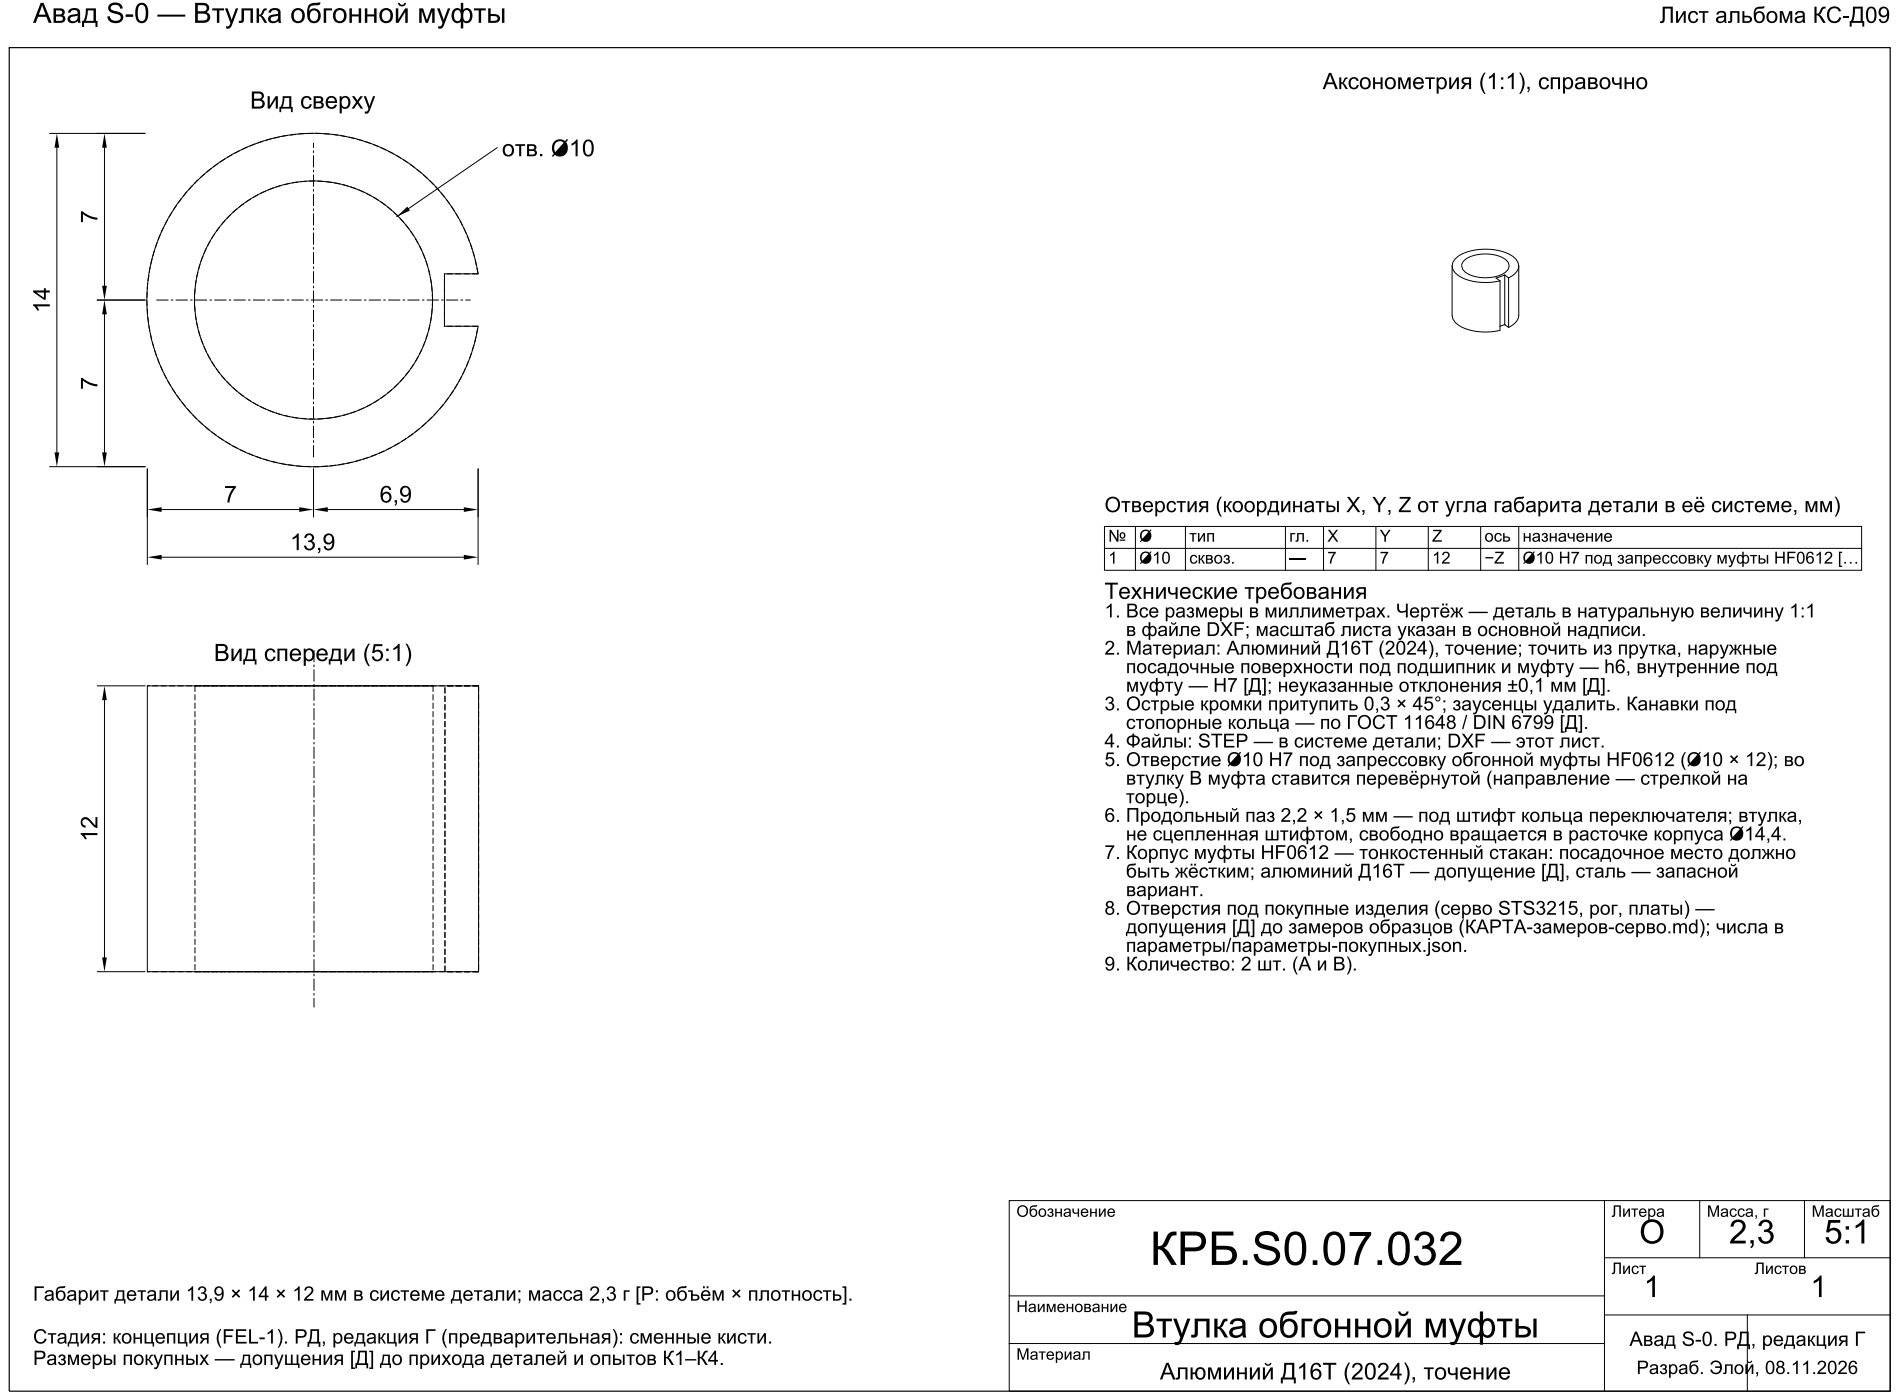
[picture p239: page 66]

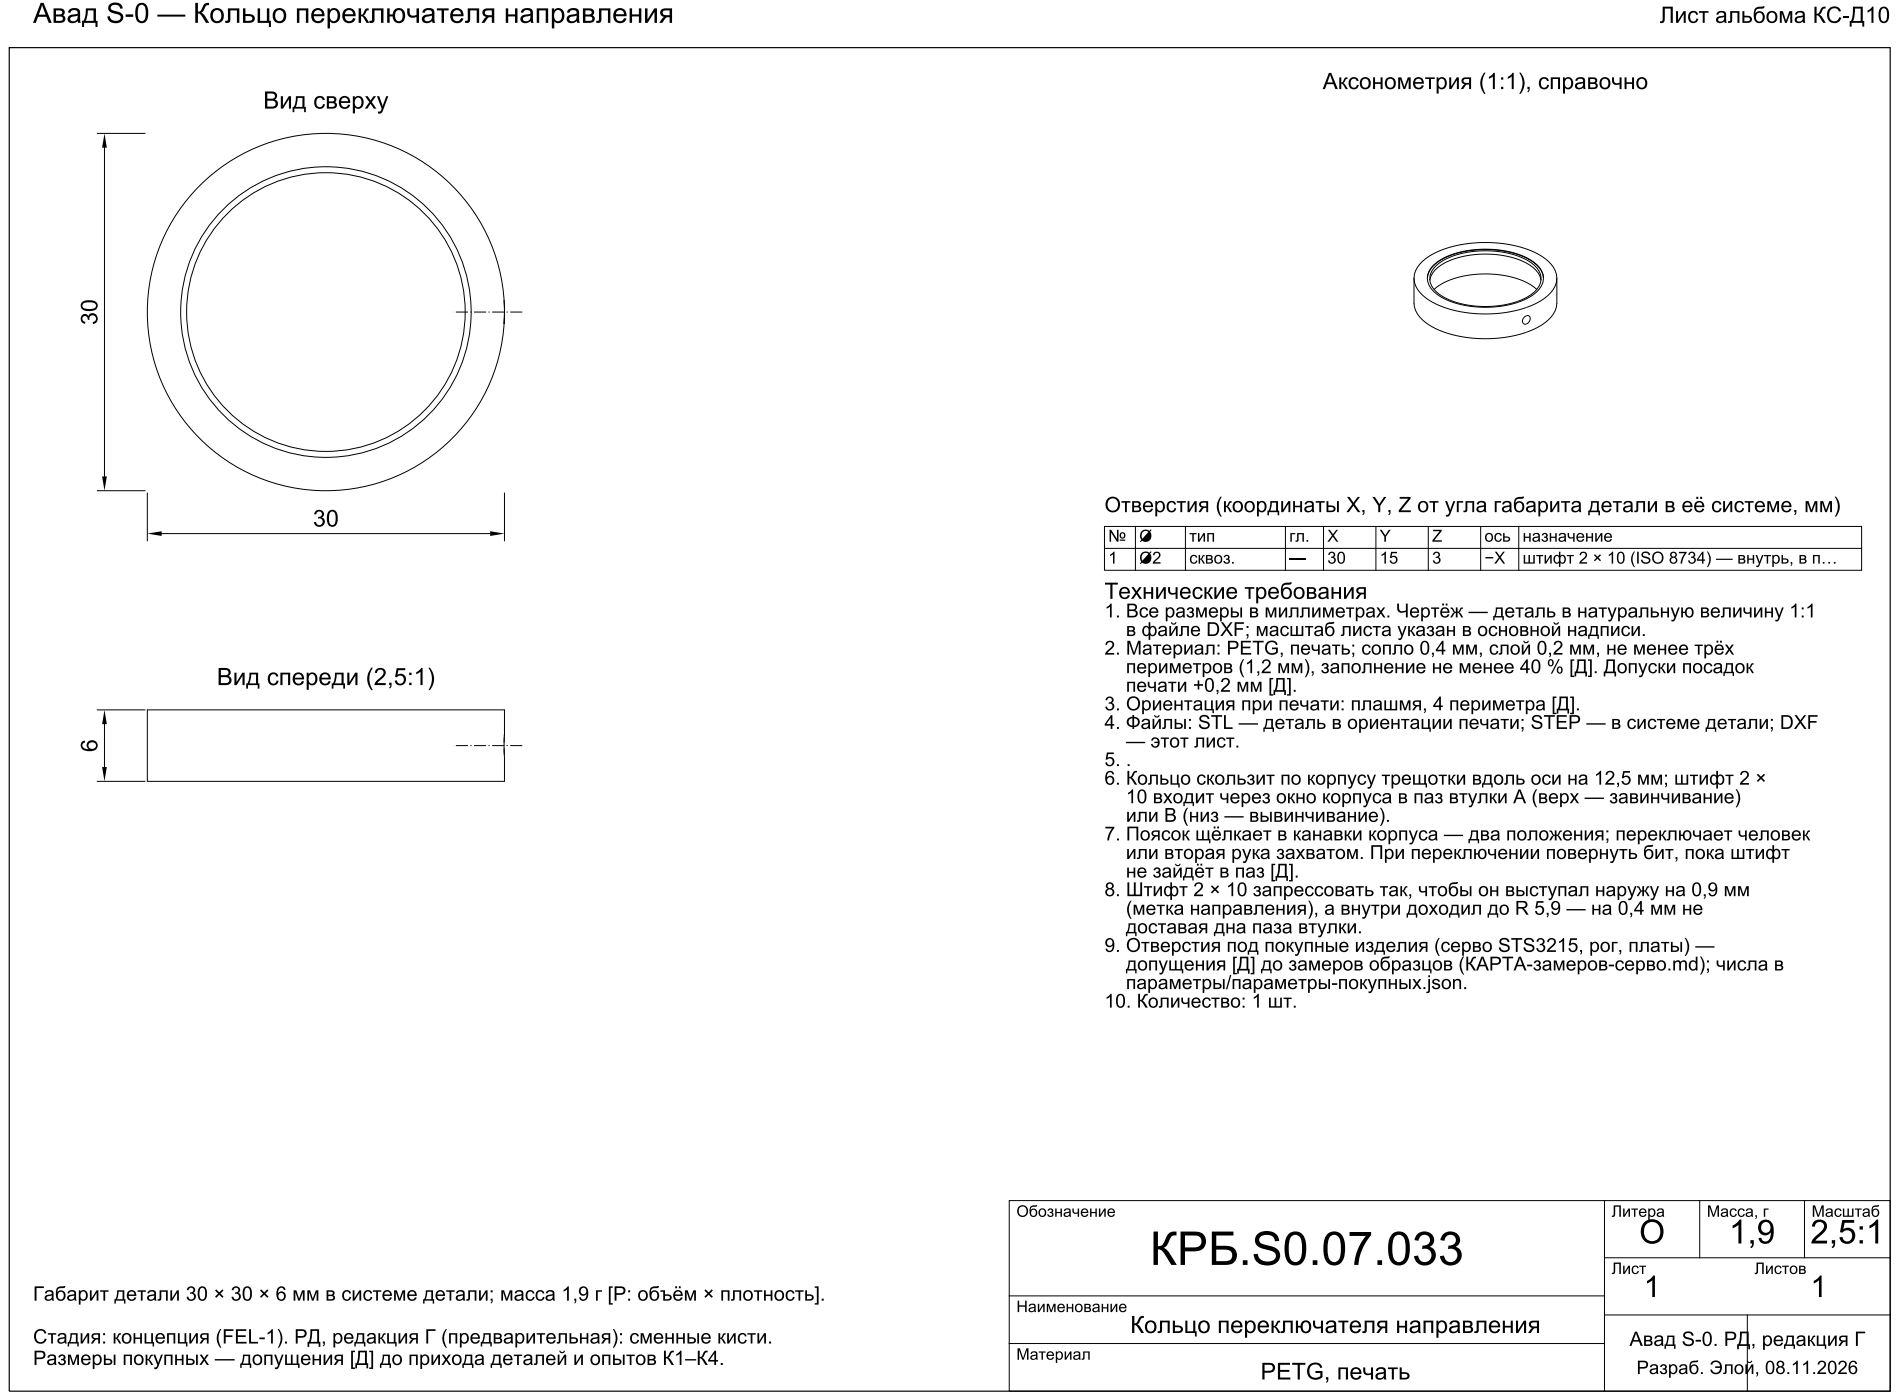
[picture p240: page 67]

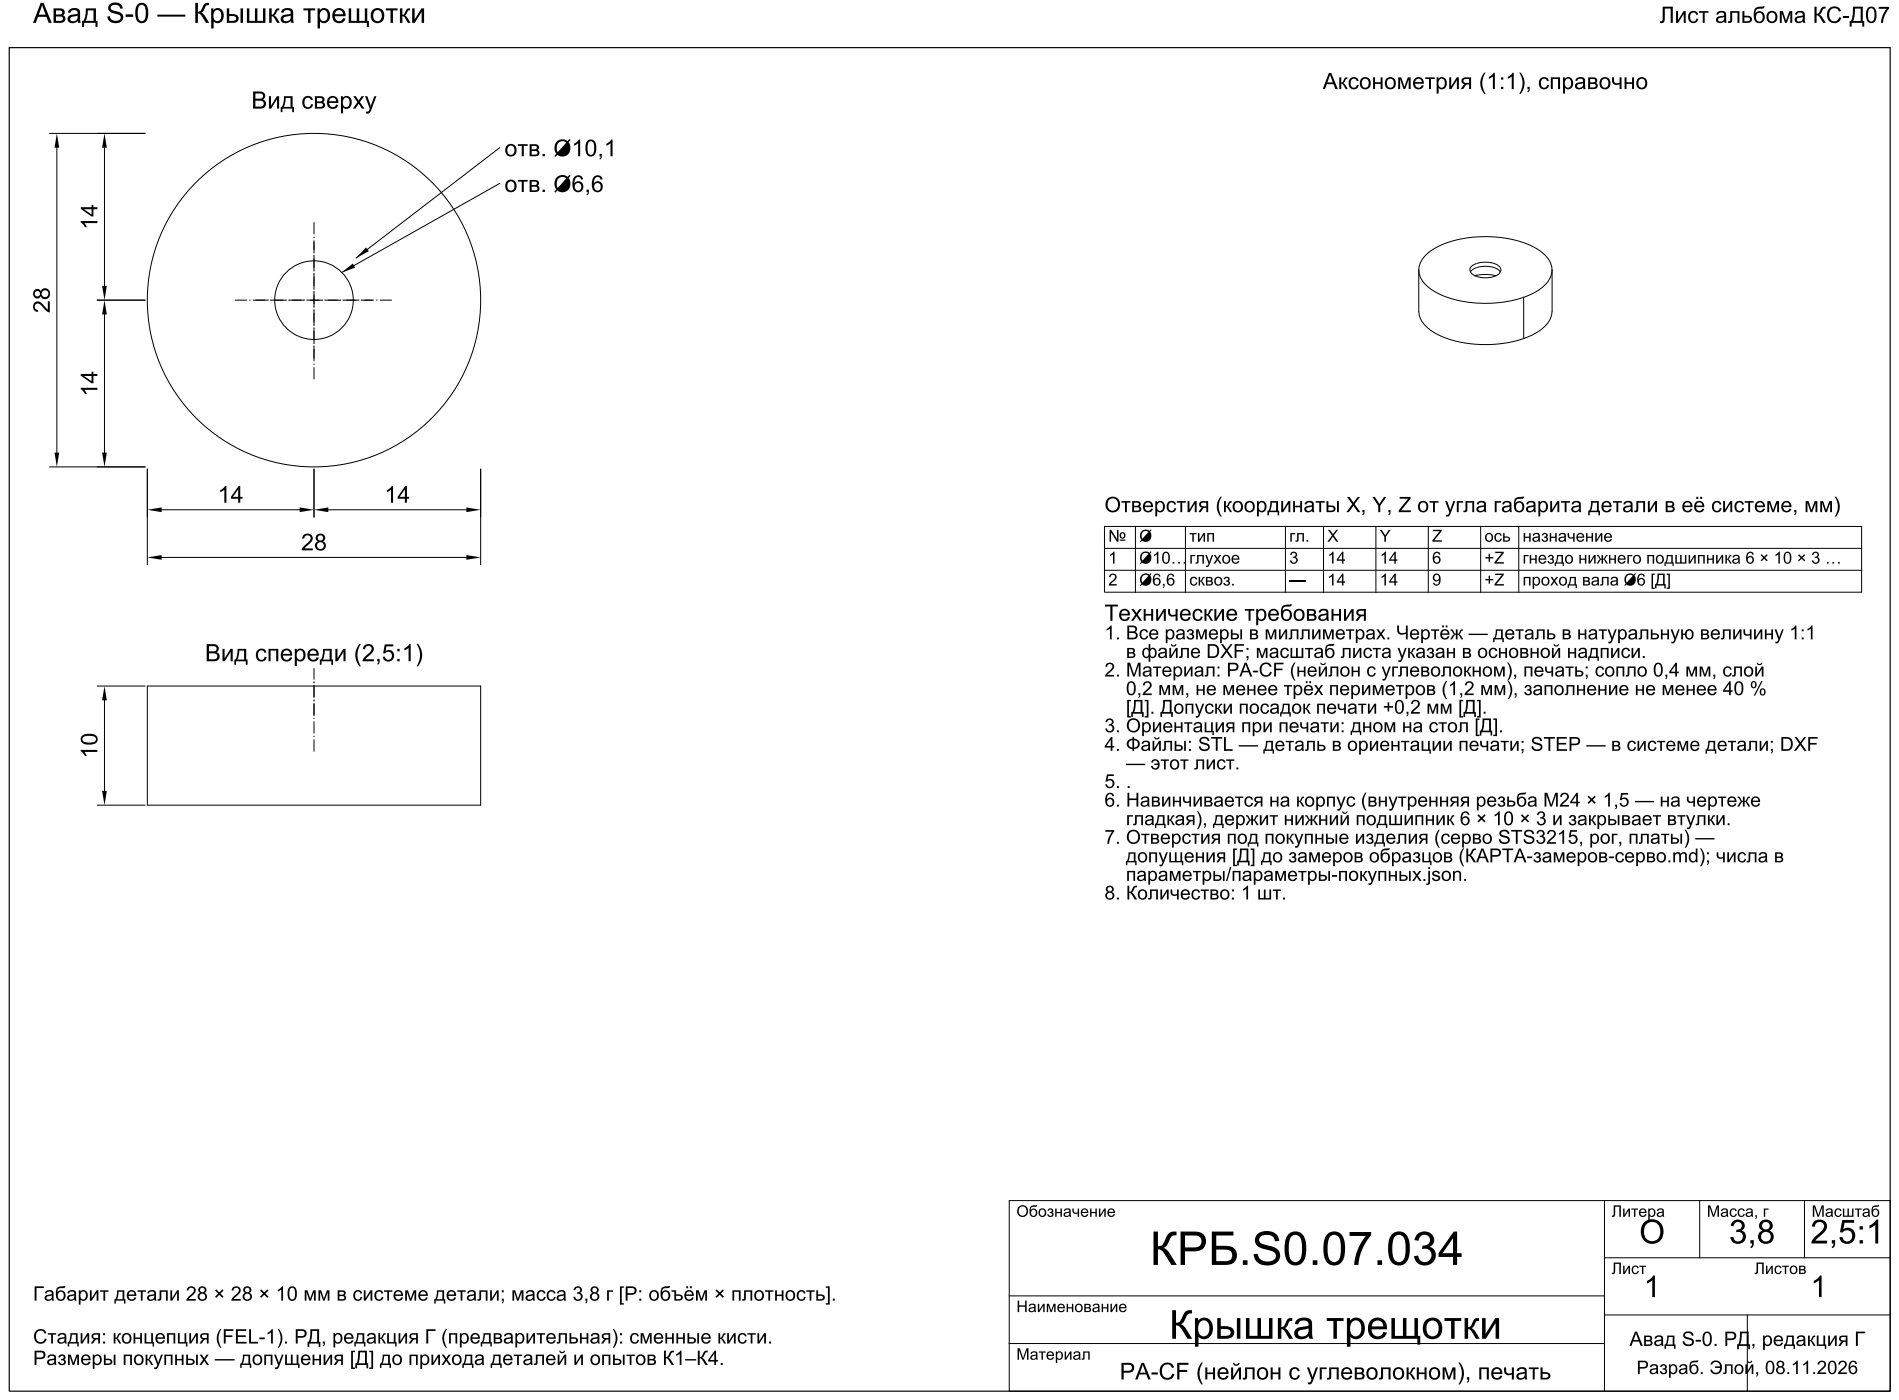
[picture p241: page 68]

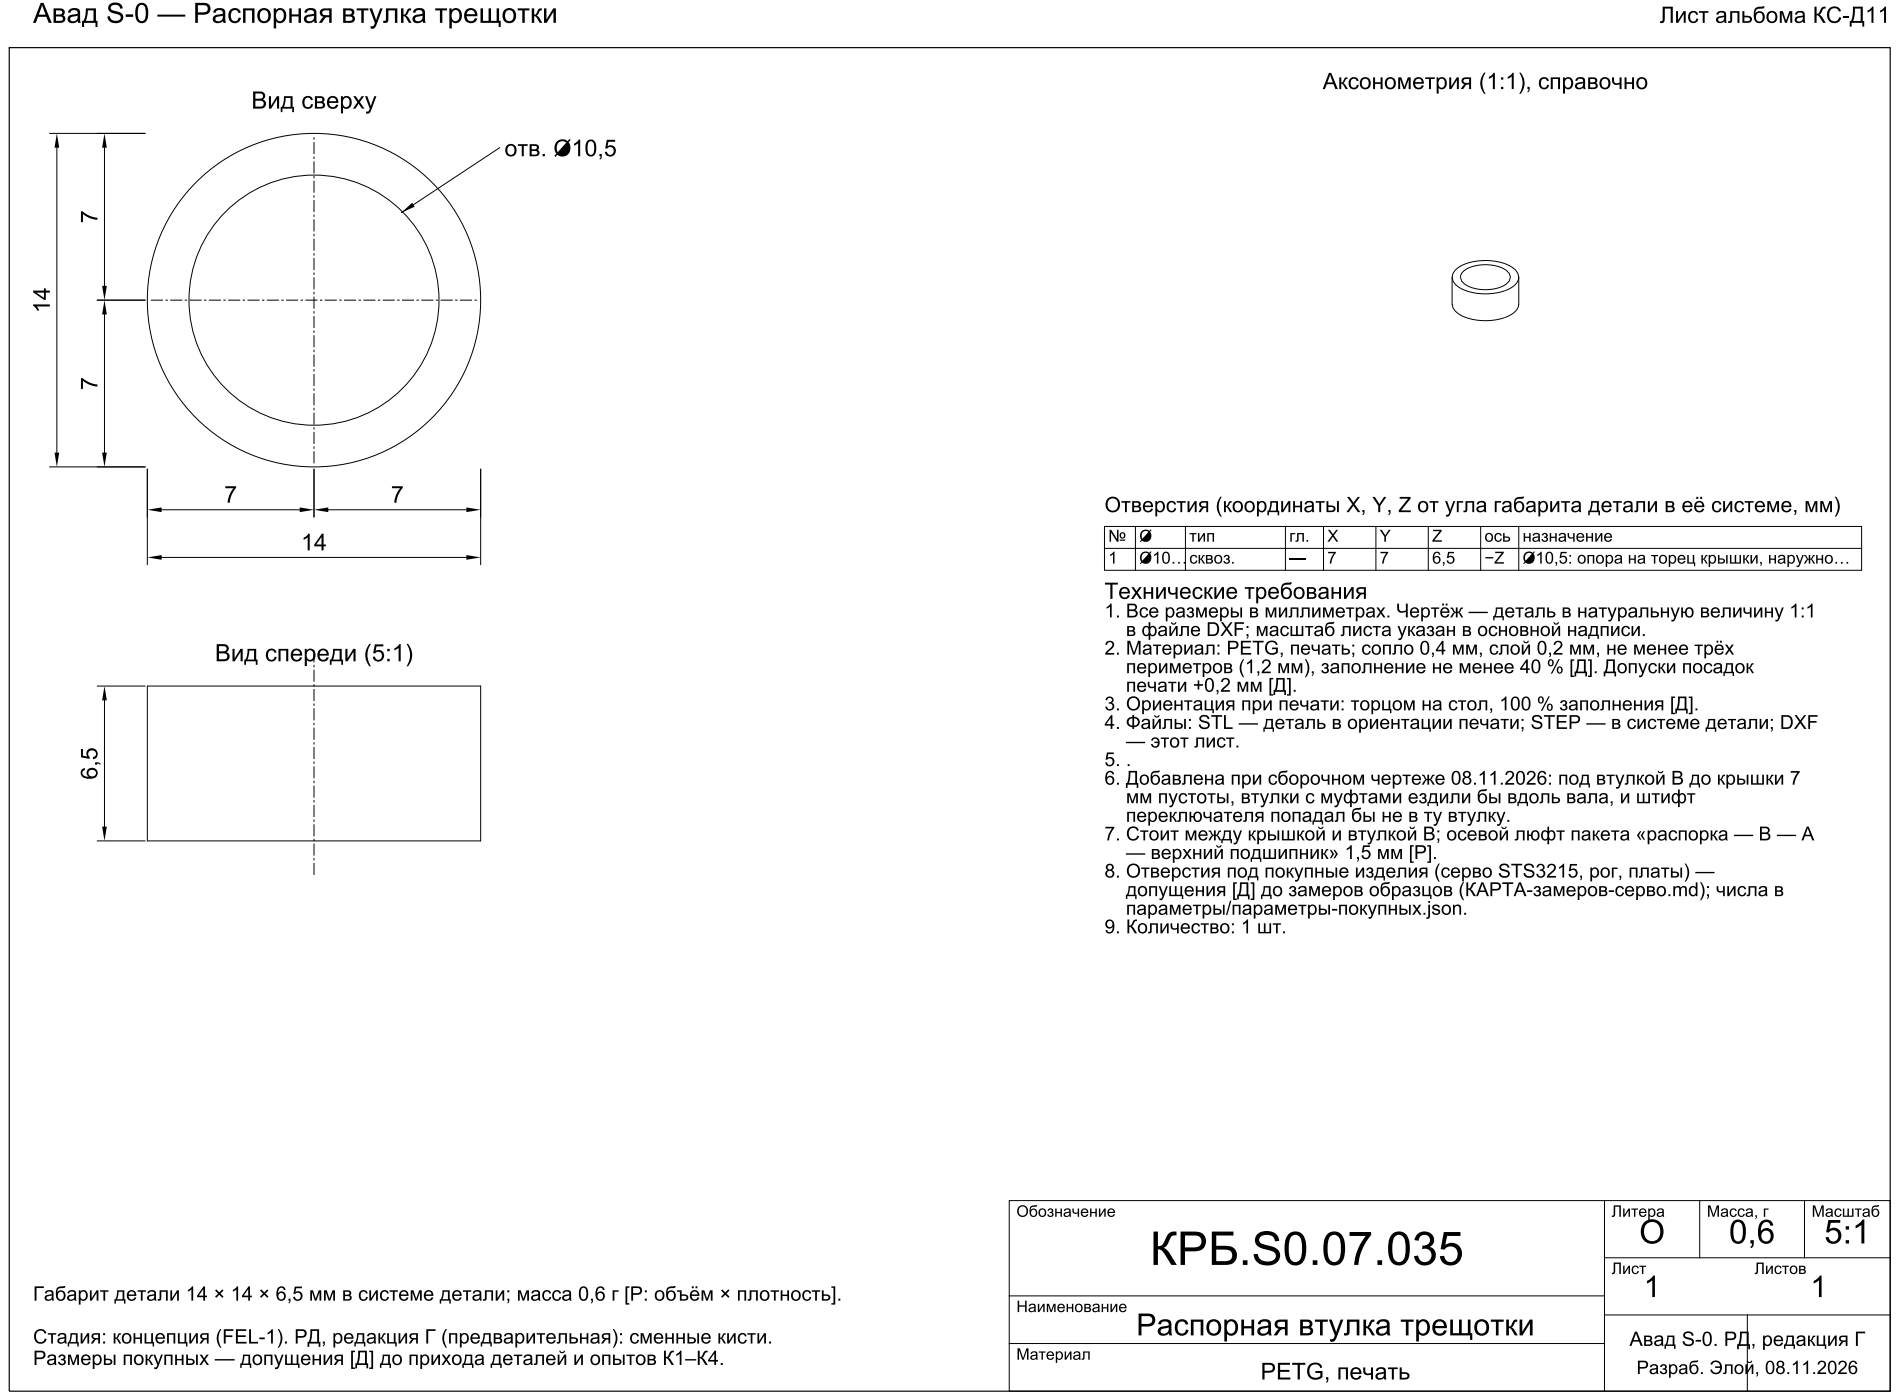
[picture p242: page 69]
