pilot443/avad-s0/(commit log)

2026-11-09 Avad S-0: first publication, drawings revision G
    Open learning prototype of a six-legged walking robot (concept stage,
    not yet built). Drawing album (69 sheets), parts (PDF, DXF, STEP, STL),
    assemblies, purchased-part drawings, wiring diagrams, wrist tools,
    bill of materials, assembly instruction and MuJoCo model v2.6.
    License: CC BY-NC-SA 4.0.
    [EL-01_electronics-layout.dxf, KRB.S0.00.000_SB.dxf, KRB.S0.00.000_SB.step, KRB.S0.01.000_SB.dxf, KRB.S0.01.000_SB.step, KRB.S0.01.001_obolochka.dxf, KRB.S0.01.001_obolochka.step, KRB.S0.01.001_obolochka.stl]
2026-11-09 Add browser 3D viewer (model v2.6, drawings revision G)
    viewer/: three.js viewer of the v2.6 model with 254 parts from the
    drawings - poses, walking (W/A/S/D), exploded view, part list.
    Decorative shell on top of the frame; no game assets. Root index.html
    redirects to the viewer for GitHub Pages.
    [purchase-list.csv]
2026-11-09 Gripper K1 (rev. D) and English README
    - README.md is now in English; the Russian version moved to README.ru.md
    - Wrist tools: gripper K1 rev. D (base, movable jaw, TPU pads) replaces the old gripper bracket and fingers
    - Drawing album rev. G: 70 sheets; bill of materials: 119 items
    - 3D viewer and MuJoCo model: v2.6 with gripper K1, 289 parts
    [EL-01_electronics-layout.dxf, KRB.S0.00.000_SB.dxf, KRB.S0.00.000_SB.step, KRB.S0.01.000_SB.dxf, KRB.S0.01.000_SB.step, KRB.S0.01.001_obolochka.dxf, KRB.S0.01.001_obolochka.step, KRB.S0.01.002_plita-nizhnyaya.dxf]
